samuelpoiraud/robot/_Hard/2014_IHM/led_boutons_ihm.JPG

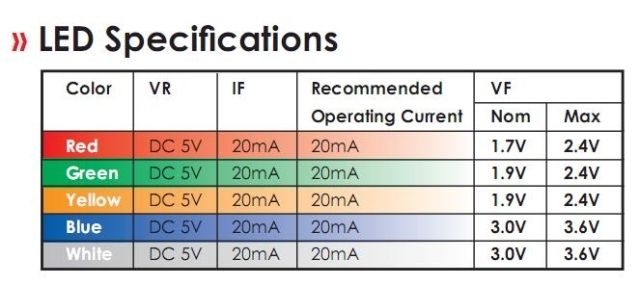
_Hard/2014_IHM/led_boutons_ihm.JPG
