samuelpoiraud/robot/_Hard/2011-2012/2012_CARTES_PDF/EMETTEUR_IR_US.PDF

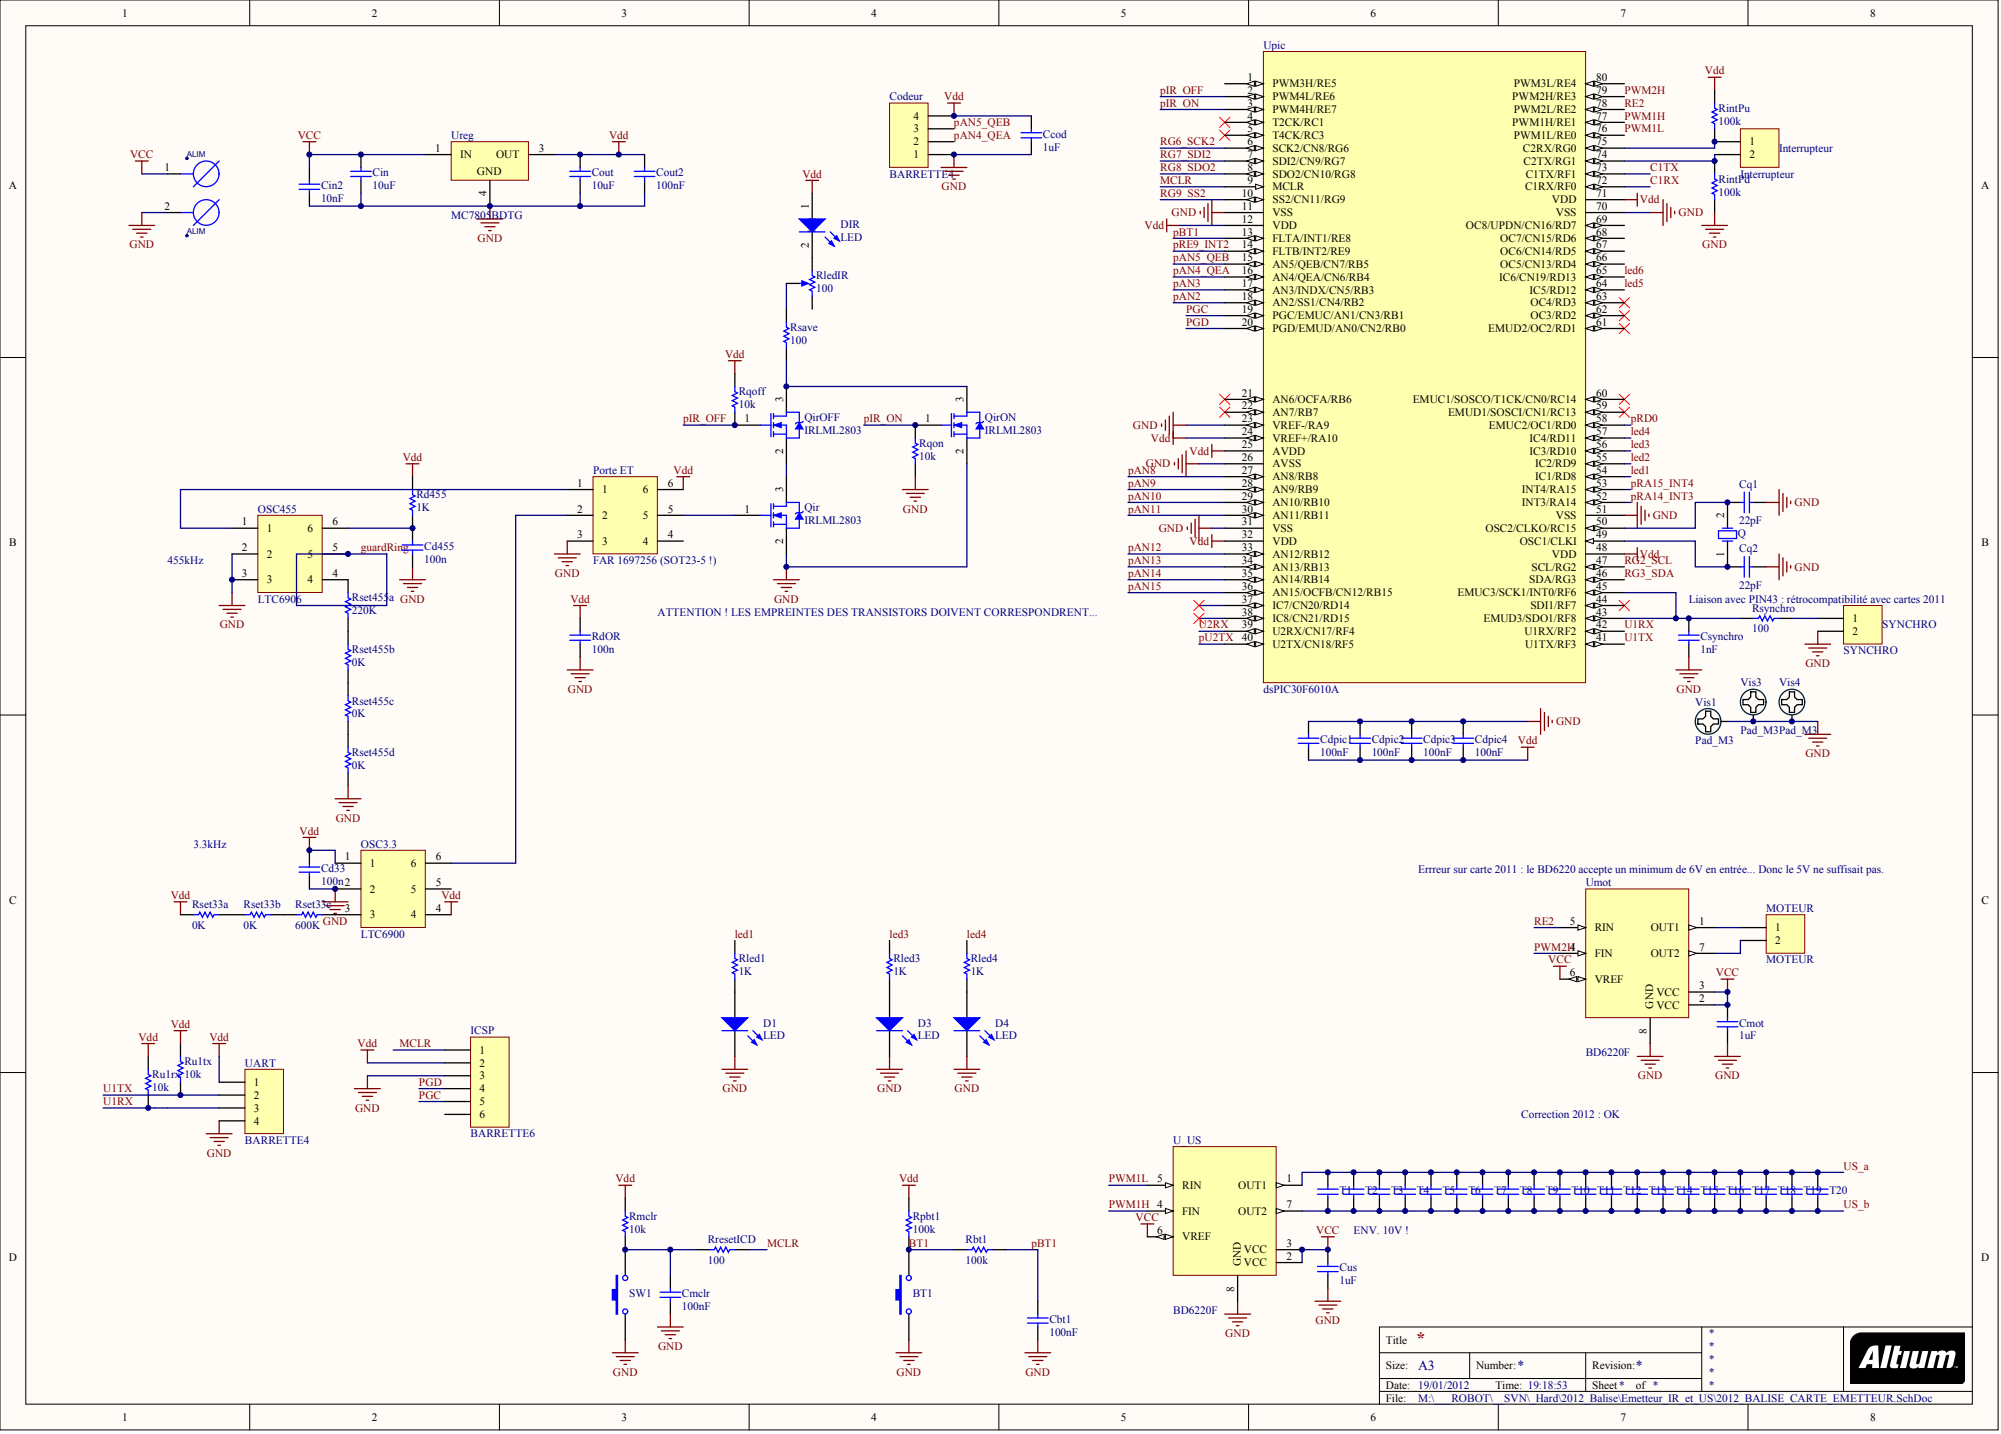
[picture p11: page 1]

Liaison avec PIN43 : rétrocompatibilité avec cartes 2011

ATTENTION ! LES EMPREINTES DES TRANSISTORS DOIVENT CORRESPONDRENT...

Errreur sur carte 2011 : le BD6220 accepte un minimum de 6V en entrée... Donc le 5V ne suffisait pas.

* Title | * * * * *

A3 Size: | * Number: | * Revision:

Date: 19/01/2012 Time: 19:18:53 | | Sheet * of *

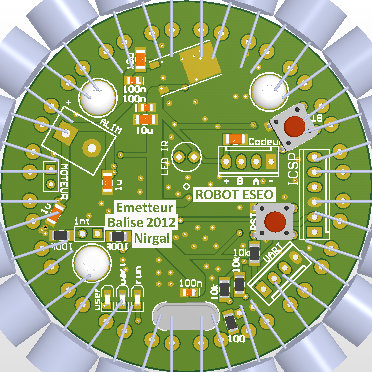
[picture p12: figure]
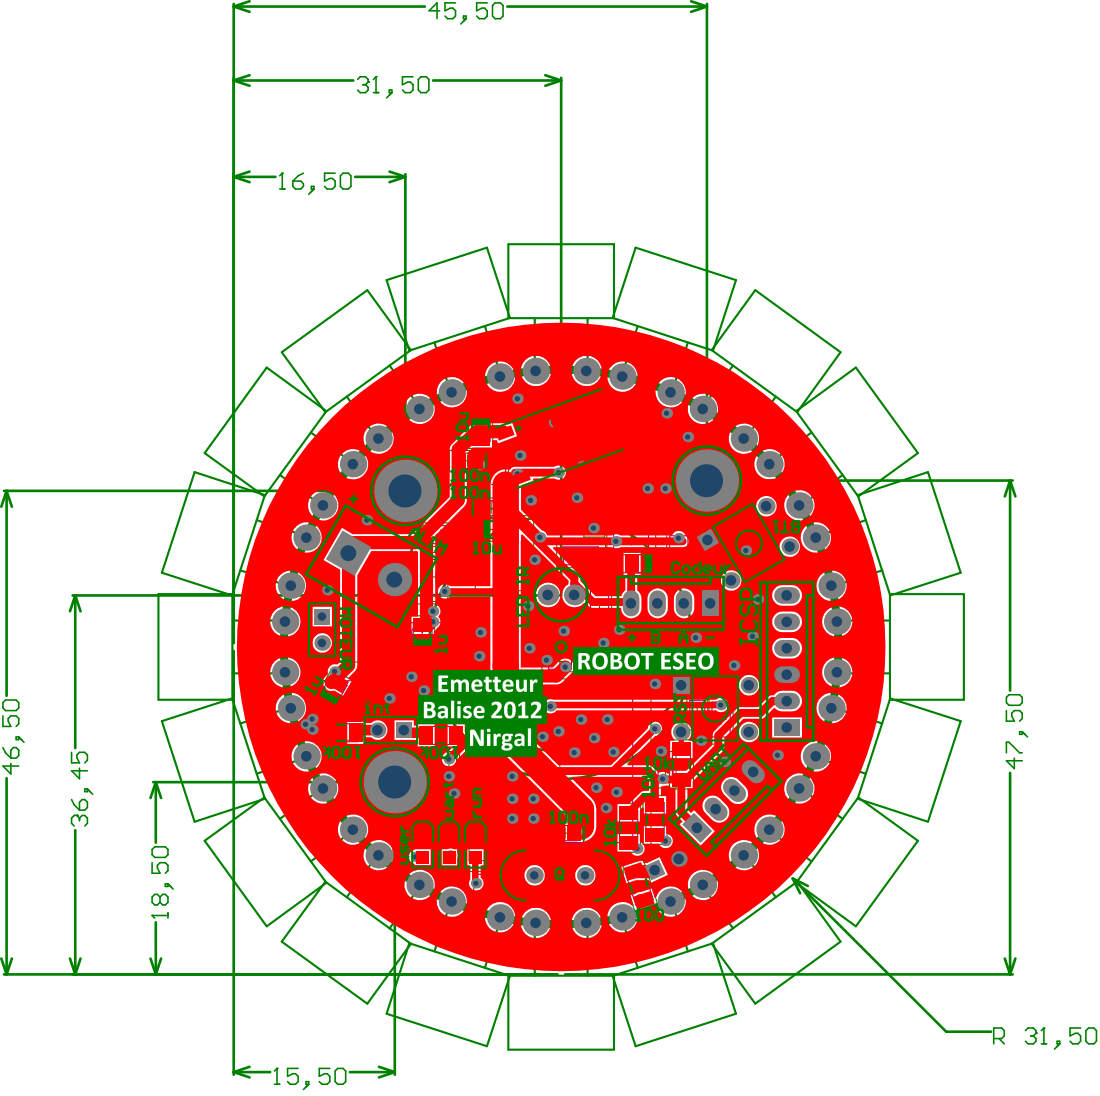
[picture p13: page 3]

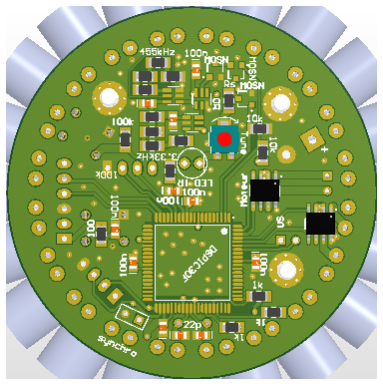
[picture p14: figure]
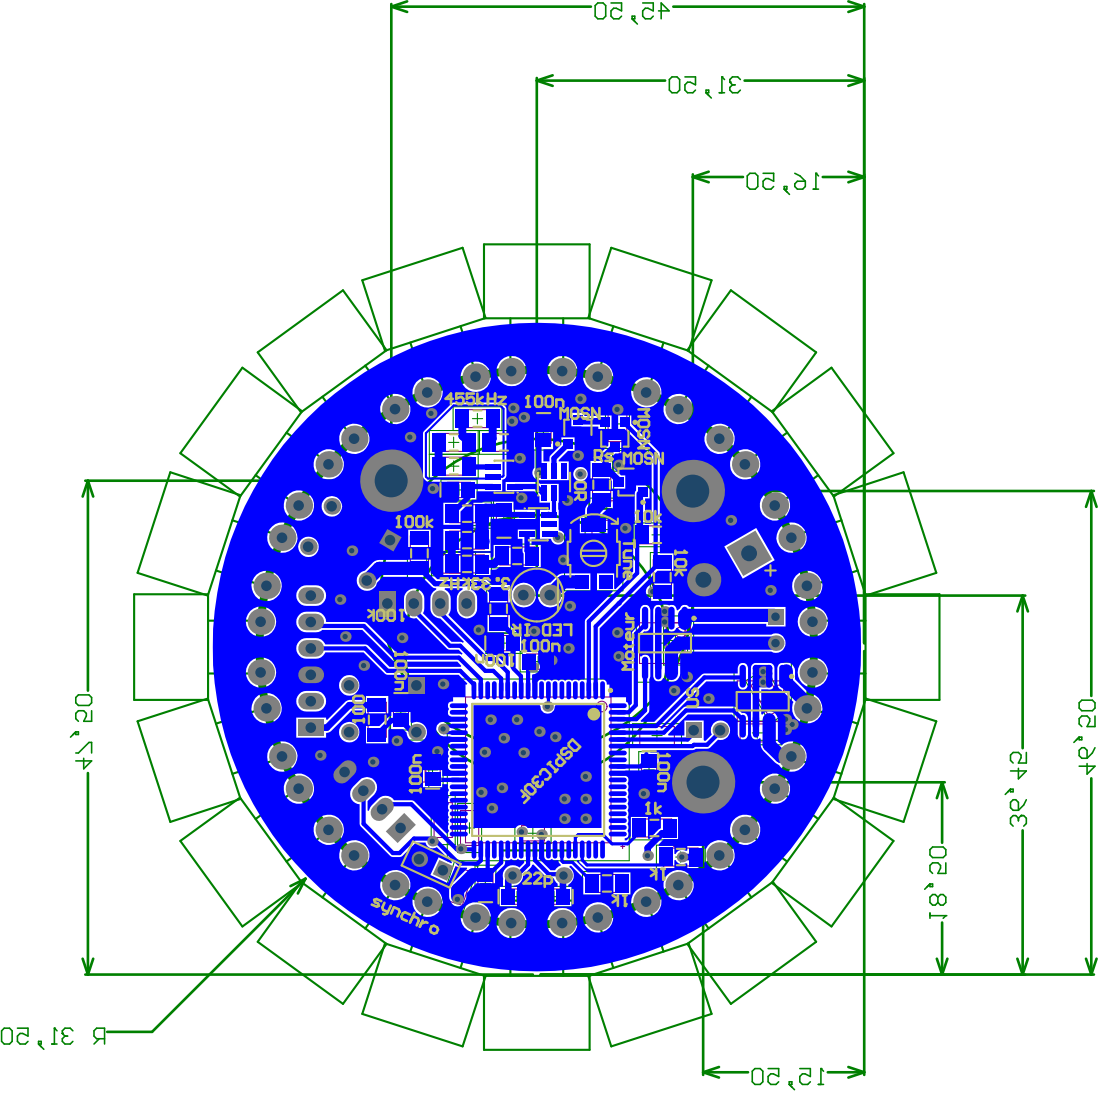
[picture p15: page 5]

Designator | Description | Comment | VALUE | Footprint | Quantity
ALIM | | ALIM | | BORNIER2 | 1
BT1, SW1 | Switch tactil 6mm x 6mm Vertical | SW_Pushbutton_6x6 mm_Vertical | | Switch 6x6 Vertical | 2
Cbt1, Cdpic1, Cdpic2, Cdpic3, Cdpic4, Cmclr, Cout2 | Capacitor | 100nF | | C0805_N | 7
Ccod, Cmot, Cus | Capacitor | 1uF | | C1206_N | 3
Cd33, Cd455, RdORCapacitor | | 100n | | C0805_N | 3
Cin, Cout | Capacitor | 10uF | | C1206_N | 2
Cin2 | Capacitor | 10nF | | C0805_N | 1
Codeur, UART | Header, 4-Pin | BARRETTE4 | | HE14_4 | 2
Cq1, Cq2 | Capacitor | 22pF | | C0805_N | 2
Csynchro | Capacitor | 1nF | | C0805_N | 1
D1, D3, D4 | Typical LED | LED | | LED_0805 | 3
DIR | Typical RED, GREEN, YELLOW, AMBER GaAs LED | LED | | LED5 | 1
ICSP | Header, 6-Pin | BARRETTE6 | | HE14_6 | 1
Interrupteur | Header, 2-Pin | Interrupteur | | HEADER2 | 1
MOTEUR | Header, 2-Pin | MOTEUR | | HEADER2 | 1
OSC3.3 | Header, 3-Pin, Dual row | LTC6900 | | SOT23-6 | 1
OSC455 | Header, 3-Pin, Dual row | LTC6906 | | SOT23-6 | 1
Porte ET | Header, 3-Pin, Dual row | FAR 1697256 (SOT23-5 !) | | SOT23-6 | 1
Q | Crystal Oscillator | QU | | HC49US | 1
Qir, QirOFF, QirON | HEXFET Power MOSFET | IRLML2803 | | SOT-23 | 3

Rbt1, RintPd, RintPu,

Q | Crystal Oscillator | QU | HC49US | 1
Qir, QirOFF, QirON | HEXFET Power MOSFET | IRLML2803 | SOT-23 | 3
Rbt1, RintPd, RintPu, Rpbt1 | Resistor | 100k | R1206_N | 4
Rd455, Rled1, Rled3, Rled4 | Resistor | 1K | R1206_N | 4
RledIR | Trimmer monotour, Bourns,serie 3314P | 100 | Trimmer_Bourns_331 4G | 1
Rmclr, Rqoff, Rqon, Ru1rx, Ru1tx | Resistor | 10k | R1206_N | 5
RresetICD, Rsave, Rsynchro | Resistor | 100 | R1206_N | 3
Rset33a, Rset33b, Rset455b, Rset455c, Rset455d | Resistor | 0K | R1206_N | 5
Rset33c | Resistor | 600K | R1206_N | 1
Rset455a | Resistor | 220K | R1206_N | 1
SYNCHRO | Header, 2-Pin | SYNCHRO | HEADER2 | 1
T1, T2, T3, T4, T5, T6, T7, T8, T9, T10, T11, T12, T13, T14, T15, T16, T17, T18, T19, T20 | Capacitor | 40kHz | MA40S4R/S Transducteur US - 3D haut de carte | 20
Upic | High-Performance, 16-bit Digital Signal Controllers | dsPIC30F6010A | TQFP80_N | 1
Ureg | Three-Terminal Positive Voltage Regulator | MC7805BDTG | 369A-13 | 1
U_US, Umot | H Bridge - 2A | BD6220F | SO8_N | 2
Vis1, Vis3, Vis4 | Vis M3 X6mm_TORXPad_M 3 | | M3x6mm | 3
