samuelpoiraud/robot/1_Propulsion/Documentation/UnivAngers_JDA_small.pdf

## Moulifal & Teflex : vainqueurs d’Eurobot 2013

Vincent Cueille¹,3

, Philippe Lucidarme¹,2,3
et toute l’equipe ´

1,3

1
IUT d’Angers, 4 boulevard Lavoisier, 49016 Angers - France 2LISA, Universite d’Angers, 62 avenue Notre Dame du Lac, 49000 Angers - France ´ 3Robot Campus, 36 rue Georges Crousil, 49000 Angers - France

philippe.lucidarme@univ-angers.fr

## Resume´

La coupe de France de robotique est une competition qualificative pour la finale internationale ´
Eurobot. Une particularite de ce concours r ´ | eside dans le fait que le r ´ | eglement change chaque ann ` | ee´
pour faciliter l’acces` a de nouvelles ` | equipes. Pour honorer les vingt ans de la coupe de France, ´
le theme 2013 ` | etait ”Happy Birthday”. Chaque ´ | equipe pouvait concevoir un ou deux robots qui ´
devaient eteindre des bougies, ouvrir des cadeaux, mettre des cerises sur le g ´ | ateau et construire ˆ
des pyramides de verres symbolisees respectivement par : des balles de tennis, des planchettes ´ | a`
basculer, des balles de ping-pong et des cylindres en plastique. Ce document illustre les capacites´
des deux robots conc¸us et fabriques par les ´ | etudiants de l’Universit ´ | e d’Angers : capacit ´ | es de ´
localisation et relocalisation (Filtre de Kalman etendu), capacit ´ | es de d ´ | eplacement (planification de ´
trajectoire par graphe de visibilite), capacit ´ | es strat ´ | egiques (choix de la meilleure action ´ | a r ` ealiser ´
en fonction du contexte) et capacites de coordination (collaboration entre les robots). ´

Mots-cles´ : robotique, Eurobot, filtres de Kalman etendus, localisation ´

## 1 Introduction

La coupe de France de robotique est une competition qualificative pour la finale internationale Eu- ´
robot. Nee en 1993 sous le nom de coupe E=m6, en lien avec l’ ´ | emission pr ´ | esent ´ | ee par Mac Lesguy, ´
elle devient tres vite une des plus prestigieuses comp ` | etitions de robotique en France et ´ | a l’ ` etranger. ´
Une particularite de ce concours est que le r ´ | eglement change chaque ann ` | ee pour permettre l’acc ´ | es`
a de nouvelles ` | equipes. Pour honorer les vingt ans de la comp ´ | etition, le th ´ | eme 2013 ` | etait ”Happy ´
Birthday”, chaque equipe pouvait concevoir un ou deux robots autonomes qui devaient r ´ | ealiser ´
differentes actions impos ´ | ees autour du th ´ | eme de l’anniversaire. L’universit ` | e d’Angers s’est en- ´
gagee dans cette comp ´ | etition au travers d’activit ´ | es propos ´ | ees dans le cadre du club robotique ´
(Robot Campus - association loi 1901 ). Bien qu’il s’agisse d’un projet pedagogique et dont la ´
vocation premiere n’est pas orient ` | ee vers la recherche, notre ´ | equipe est toujours soucieuse de pro- ´
poser des technologies innovantes. Convaincus de la necessit ´ | e de localiser les robots de fac¸on ´
absolue sur le terrain, nous avons mis en oeuvre un systeme de localisation par filtre de Kalman `
etendu. Notre objectif ´ | etait non seulement de prouver la faisabilit ´ | e d’un tel syst ´ | eme tout en respec- `
tant les contraintes imposees par le r ´ | eglement, mais aussi et surtout, de montrer que ce syst ´ | eme `
pouvait etre comp ˆ | etitif. ´
Le papier sera structure de la fac¸on suivante : la premi ´ | ere partie expliquera bri ` | evement le r ` | eglement ´
2013 et detaillera les points qui concernent la localisation. La seconde partie pr ´ | | | | esentera les ´
techniques utilisees classiquement pour la localisation au travers d’un historique technique de ´
la competition. Nous exposerons ensuite l’architecture des robots avant de d ´ | etailler notre syst ´ | eme `
de localisation.

## 2 Eurobot 2013

Pour feter les 20 ans de la coupe de France de robotique, le r ˆ | eglement de l’ ´ | edition 2013 est ´ | elabor ´ | e´
autour du theme ` | ”joyeux anniversaire”. Les matchs de 90 secondes se deroulent sur une aire de ´
jeu de 3x2m sur laquelle deux robots s’affrontent simultanement (figure 1). La comp ´ | etition se ´
deroule dans un esprit amical et sportif et les ´ | equipes d’arbitrage sont tr ´ | es attach ` | ees au respect de ´
l’adversaire; toute action visant a nuire au robot adverse est p ` | enalis ´ | ee. Il est notamment interdit de ´
percuter ou de bloquer l’adversaire. Chaque equipe peut concevoir un ou deux robots autonomes; ´
un robot principal dont le perim ´ | etre peut atteindre jusqu’ ` | a 1,4m et un robot secondaire avec un `
perim ´ | etre maximal de 0.8m pendant le match. Chaque robot se voit attribu ` | e une couleur (rouge ou ´
bleue) avant le debut du match qui d ´ | efiniera son c ´ | otˆ e de d ´ | epart et les ´ | elements de jeu avec lesquels ´
il devra interagir. Ces deux robots doivent se coordonner pour realiser un certain nombre d’actions ´ tout en evitant l’adversaire. ´

### 2.1 Actions

L’el´ ement principal du terrain est un g ´ | ateau de 0,5m de rayon. Sur ce dernier se trouvent 20 ˆ
bougies symbolisees par des balles de tennis mont ´ | ees sur des cylindres en PVC que les robots ´
doivent eteindre en enfonc¸ant la balle dans un tube. Chaque bougie rapporte 4 points ´ | a son ` | equipe. ´
Sur la longueur opposee au g ´ | ateau se trouvent des planches articul ˆ | ees que les robots doivent faire ´
basculer et qui symbolisent des cadeaux (4 points chacun). Les bougies et les cadeaux sont colores´ (rouges ou bleus) et seule l’equipe qui s’est vue attribuer leur couleur peut interagir avec ces ´ el´ ements. En revanche, au milieu du terrain se trouvent 12 verres et ces derniers appartiennent ´ aux deux equipes qui doivent en ramener un maximum dans leur camp. La position initiale des ´ verres est fixe et connue. Chaque verre rapporte 4 points mais un bonus important est accorde aux ´
equipes qui r ´ | eussissent ´ | a empiler les verres puisque le deuxi ` | eme verre de la pile compte double, le `
troisieme triple et ainsi de suite. La derni ` | ere action consiste ` | a ramasser des cerises, symbolis ` | ees ´
par des balles de ping-pong situees dans des assiettes et ´ | a les lancer dans un r ` | eceptacle situ ´ | e en ´
haut du gateau. Chaque cerise rapporte 2 points, mais le score des cerises peut ˆ | etre divis ˆ | e par deux ´
si l’equipe concern ´ | ee a lanc ´ | e une cerise de couleur noire dans son r ´ | eceptacle. A la fin du match un ´
bonus est accorde aux ´ | equipes qui r ´ | eussissent ´ | a gonfler un ballon dans les 10 secondes qui suivent `
la fin de l’epreuve. ´

### 2.2 Balises

Chaque annee les ´ | equipes sont autoris ´ | ees ´ | a placer des balises sur le terrain. La fabrication des `
balises est laissee au soin des ´ | equipes et il existe deux types de balises: fixes et adverses. ´
- Les balises fixes se placent sur des supports situes sur la largeur du terrain. Chaque ´ | equipe ´
peut placer au plus trois balises fixes : deux aux coins delimitant son aire de d ´ | epart et une ´
situee au milieu de la largeur de la zone adverse. Les balises doivent ´ | etre autonomes et ˆ
les dimensions ne doivent pas depasser un parall ´ | el´ epip ´ | ede de 80x80x160mm. Dans l’esprit `
des redacteurs du r ´ | eglement, ces balises servent ´ | a localiser les robots mais il arrive que leur `
utilisation soit detourn ´ | ee de fac¸on ing ´ | enieuse. ´
- Les balises adverses se trouvent sur les robots de l’equipe oppos ´ | ee. En effet, chaque robot ´
doit etre ˆ | equip ´ | e d’un support de balise situ ´ | e´ a 0,43m du sol qui sert ` | a placer le syst ` | eme `
conc¸u par l’equipe adverse. Chaque balise doit tenir dans un cube de 80mm de c ´ | otˆ e et ne ´
doit pas contenir d’el´ ements pouvant nuire au bon fonctionnement du robot sur lequel elle ´ est placee. ´

Cette presentation succinte du r ´ | eglement n’est pas exhaustive, pour plus de d ´ | etails le lecteur ´
est invite´ a se r ` | ef´ erer ´ | a [1]. `

## 3 Etat de l’art des systemes de localisation `

3.1 Systemes odom ` | etriques ´
Depuis 20 ans, la localisation est une des preoccupations majeures pour la plupart des ´ | equipes. Les ´
premieres ann ` | ees, la localisation n’ ´ | etait pas crutiale car les organisateurs pr ´ | evoyaient des ´ | el´ ements ´
aidant les robots a se situer sur la table, typiquement une ligne peinte sur le terrain. En 1997, le `
reglement a ` | evolu ´ | e et est apparue l’aire de jeu de 3x2m telle que nous la connaissons aujourd’hui ´
(figure 1).

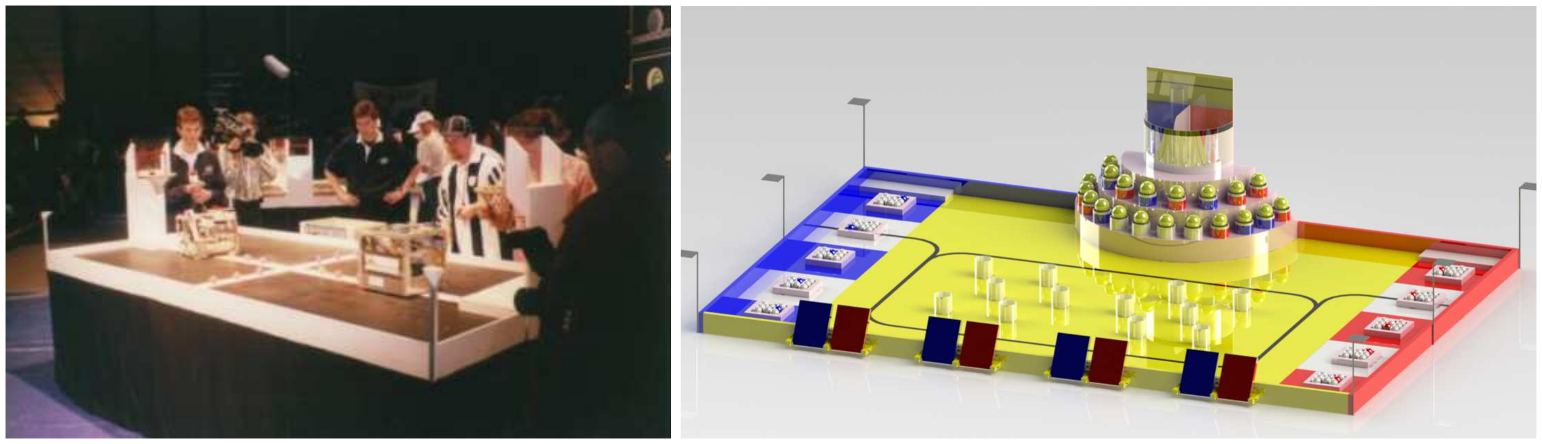
[picture p48: figure]

Figure 1: Aire de jeu de la coupe de France de robotique 1997 (a gauche, photo: Fribotte) et 2013 ` (a droite). `

De cette evolution est n ´ | ee l’importance de localiser pr ´ | ecis ´ | ement les robots. Les ´ | equipes ont ´
alors commence´ a utiliser des codeurs incr ` | ementaux mont ´ | es sur les arbres moteurs. En 1998, ´
l’equipe de l’IUT de Ville d’Avray optimise et exploite ´ | a la perfection ce syst ` | eme avec un robot `
particulierement rapide. En remportant haut la main cette ` | edition, ils apportent la preuve que la lo- ´
calisation est un el´ ement de performance d ´ | ecisif. L’utilisation de l’odom ´ | etrie va se g ´ | en´ eraliser les ´
annees suivantes au sein de la comp ´ | etition. Toutefois, la limitation principale de ce syst ´ | eme reste `
la derive et pour pallier ´ | a ce probl ` | eme, les robots se recallent sur les bordures pendant les matchs. `
Un deuxieme probl ` | eme inh ` | erent sont les glissements de roues lors de collisions entre robots qui ´
peuvent amener des erreurs de localisation. En 2001, l’equipe Minitech innove en utilisant pour ´
la premiere fois des roues incr ` | ementales ind ´ | ependantes des roues motrices. La figure 2 montre ´
un exemple de mise en oeuvre par l’equipe ´ | µART (Micro Alsace Robot Team). Sans resoudre les ´
problemes de d ` | erive inh ´ | erents ´ | a l’odom ` | etrie, ce syst ´ | eme permet de r ` | eduire de fac¸on significative ´
l’erreur de positionnement et immunise davantage la localisation vis a vis des collisions. Bien `
que les equipes aient fortement optimis ´ | e les syst ´ | emes odom ` | etriques, cette solution seule apparait ´
fragile vis a vis des al ` | eas qui peuvent survenir en cours de match. Aujourd’hui encore, il arrive ´
frequemment que des robots se perdent sur le terrain et, sans syst ´ | eme de localisation globale, ces `
robots n’ont aucune chance de se relocaliser.

### 3.2 Balises

En 1997, avec l’apparition de l’aire de jeu contemporaine, des supports de balises ont egalement ´
et´ e introduits dans le r ´ | eglement (visibles sur la figure 1). Beaucoup d’ ` | equipes ont tent ´ | e d’utiliser ´
ces supports pour localiser leurs robots, mais assez peu de systemes ont ` | et´ e finalis ´ | es. La difficult ´ | e´
principale reside dans la conception des balises et la fusion de donn ´ | ees avec l’odom ´ | etrie. Rares ´

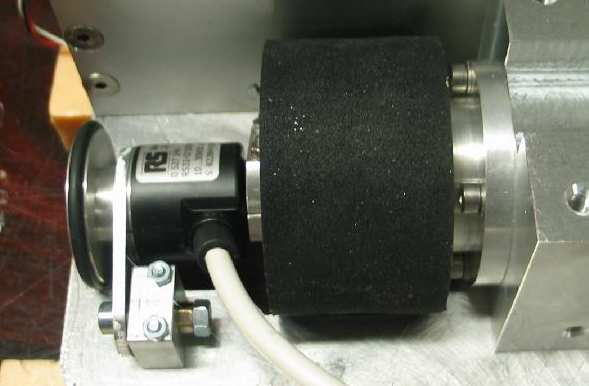
[picture p49: figure]

Figure 2: roue motrice associee´ a une roue incr ` | ementale ind ´ | ependante (photo: ´ | µart).
sont les equipes ayant r ´ | eussit ´ | a mettre au point les deux approches de fac¸on performante ([2] et `
[3]).

## 4 Architecture

Le reglement permet l’utilisation d’un ou deux robots mais augmenter le nombre de robots est ´
un avantage strategique et un gage de fiabilit ´ | e. Notre ´ | equipe a donc fabriqu ´ | e deux robots de ´
tailles differentes conform ´ | ement au r ´ | eglement. Le robot principal et le robot secondaire ont ` | et´ e´
respectivement baptises Moulifal et Teflex, un clin d’oeil aux c ´ | el´ ebres marques d’ ´ | electrom ´ | enager. ´
Les robots sont construits sur la base de chassis en aluminium conc¸us et fabriqu ˆ | es´ a l’universit ` | e´
d’Angers (figure 3). Le chassis ˆ | a roues diff ` | erentielles ne comporte pas de codeurs incr ´ | ementaux ´
independants et est motoris ´ | e gr ´ | ace ˆ | a deux ensembles codeurs, moteurs cc et r ` | educteurs. ´

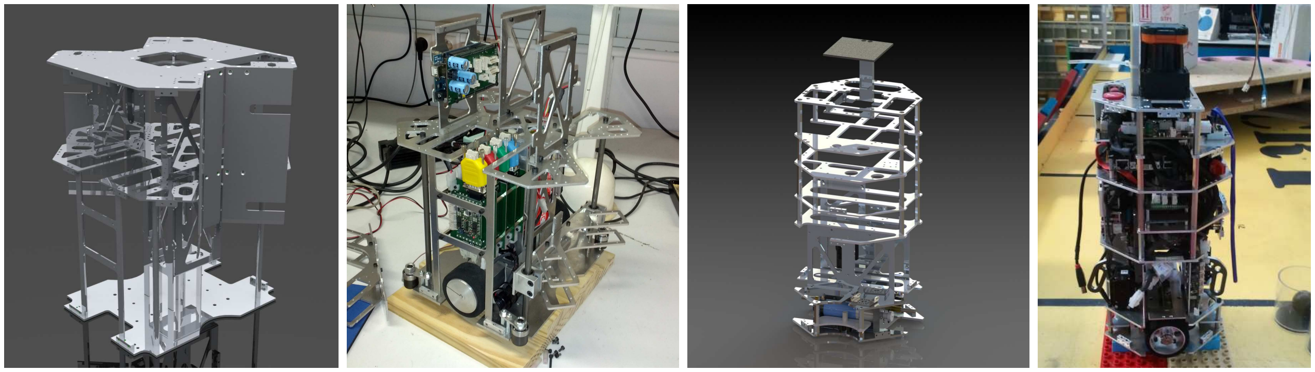
[picture p50: figure]

Figure 3: CAO des chassis et robots en cours d’assemblage (robot principal a gauche et robot ` secondaire a droite). `

Sur les cinq actions proposees par le r ´ | eglement, quatre peuvent ` | etre r ˆ | ealis ´ | ees par les robots : ´
empilage des verres, cadeaux, bougies et gonflage du ballon. Le lancer de balles de ping-pong a
et´ e jug ´ | e peu rentable vis ´ | a vis de la complexit ` | e et de l’encombrement d’un syst ´ | eme de ramassage, `
de tri et de tir.

### 4.1 Empilage des verres

Le robot principal possede deux pinces mont ` | ees sur des ascenseurs verticaux ( ´ | a l’avant et ` | a`
l’arriere) qui permettent de saisir les verres et de les monter dans un compartiment de maintien ` grace ˆ a deux volets. La figure 4 illustre la saisie et l’empilage des verres. `

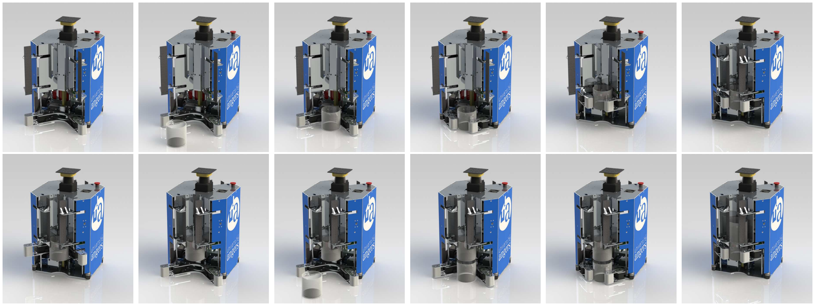
[picture p51: figure]

Figure 4: sequence de ramassage et empilage des verres. ´

### 4.2 Bougies et cadeaux

Le robot principal est equip ´ | e d’un bras ´ | a trois degr ` | es de libert ´ | e (figure 5) qui permet d’ ´ | eteindre les ´
bougies avec pour organe terminal un capteur de couleur. La sequence d’extinction est constitu ´ | ee´
de deux phases : une premiere phase durant laquelle le robot vient v ` | erifier la couleur de la bougie ´
et une seconde phase d’appui. Le bras peut egalement servir ´ | a l’ouverture des cadeaux. `

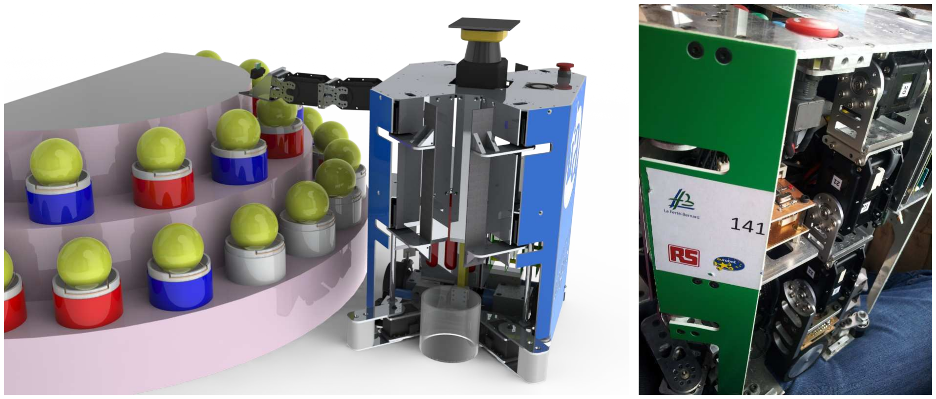
[picture p52: figure]

Figure 5: CAO du bras en action (a gauche) et vue de d ` | etail du bras rang ´ | e dans le robot ( ´ | a droite). `

### 4.3 Robot secondaire et communication

Afin de minimiser les temps de developpement, l’architecture du robot secondaire est fortement ´
inspiree de celle du robot principal. Etant donn ´ | e le faible encombrement autoris ´ | e par le r ´ | eglement, `
le robot secondaire n’est conc¸u que pour 3 actions. La principale est l’ouverture des cadeaux
grace ˆ | a un bras ` | a un degr ` | e de libert ´ | e. Le robot poss ´ | ede ` | egalement deux doigts, situ ´ | es´ a l’avant `
et a l’arri ` | ere, permettant la saisie d’un verre chacun. Enfin, une pompe ` | a palettes est utilis ` | ee´
pour gonfler le ballon en fin de match. Les deux robots communiquent via des modules XBee (protocole ZigBee IEEE 802.15.4). Les informations echang ´ ees sont : horodatage de la trame, ´

position courante du robot, identifiant de la strategie, couleur jou ´ | ee et ´ | etat des diff ´ | erentes actions ´
(cadeaux, bougies, etc).

### 4.4 Localisation et detection de l’adversaire ´

Sur chaque robot est monte un LIDAR Hokuyo UTM-30LX qui permet de d ´ | etecter la position des ´
balises a une fr ` | equence de 40Hz. Ces LIDAR renvoient aux PC l’angle, la distance et l’intensit ´ | e´
lumineuse. Les balises sont consituees d’un tube en PVC de 80mm de diam ´ | etre envelopp ` | e dans ´
une bande retro-r ´ | efl´ echissante. Cela permet en partie de faciliter la d ´ | etection des balises gr ´ | ace ˆ | a`
une intensite rec¸ue ´ | elev ´ | ee et de diminuer grandement le risque de fausses reconnaissances. La ´
detection et localisation de l’adversaire se fait ´ | egalement par le biais des LIDAR. La d ´ | etection de ´
l’adversaire a une double utilite : ´
- Elle permet, en amont des deplacements, de planifier une trajectoire libre de collision. La ´
planification est realis ´ | ee gr ´ | ace ˆ | a un graphe de visibilit ` | e introduit par T. Ozano-Perez and ´
M.A. Wesley en 1979 [7]. Un exemple de planification est present ´ | e sur la figure 6. Les ´
obstacles incluent des el´ ements fixes (g ´ | ateau, bordures et buffets) et mobiles (piles de verres, ˆ
robots adverses et robot secondaire). Il est a noter que les obstacles ins ` | er´ es dans le graphe ´
sont dilates du rayon du cercle englobant la projection verticale du robot afin de garantir ´ la faisabilite de la trajectoire. Une limitation de cette approche est l’absence d’adaptation ´ de la planification aux obstacles mobiles. Si un autre robot venait a croiser la trajectoire `
pendant le deplacement cette derni ´ | ere ne serait pas r ` | eajust ´ | ee, d’o ´ | u l’utilit ` | e d’une d ´ | etection ´
secondaire.
- Les robots sont equip ´ | es de capteurs de proximit ´ | e ultrasons plac ´ | es´ a l’avant et ` | a l’arri ` | ere. `
Ces capteurs permettent de detecter localement la pr ´ | | esence d’un obstacle et de stopper un ´
deplacement en cas de collision imminente. Une fois le robot ´ | a l’arr ` | et, une nouvelle trajec- ˆ
toire prenant en compte les modifications de l’environnement est planifiee. ´

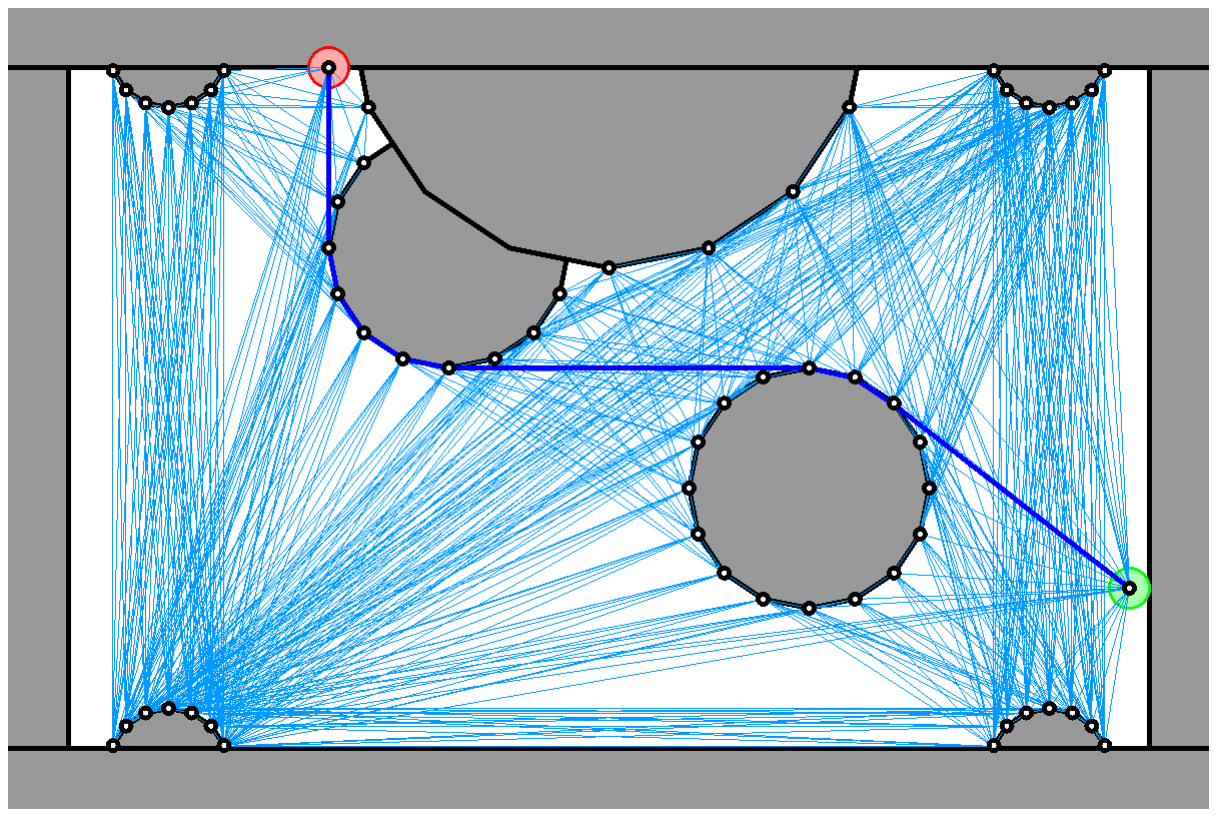
[picture p53: figure]

Figure 6: exemple de graphe de visibilite et trajectoire planifi ´ | ee associ ´ | ee. ´

### 4.5 Vue d’ensemble de l’architecture

L’el´ ement principal du robot est un PC embarqu ´ | e (processeur Atom Z530 1.6GHz ) qui g ´ | ere la `
localisation et les actions de haut niveau. Il dialogue via USB avec des cartes Arduino Mega (processeur ATmega 2560) qui pilotent les asservissements et les actions de plus bas niveau (gestion des ascenseurs, des bras, des commandes moteurs, etc). Les dialogues de bas niveaux se font via
differents bus (I ´ | 2C, RS232 et RS485). L’architecture est synthetis ´ ee sur la figure 7 et le tableau 1 ´
rassemble les ref´ erences des principaux ´ | el´ ements constitutifs de chaque robot. ´

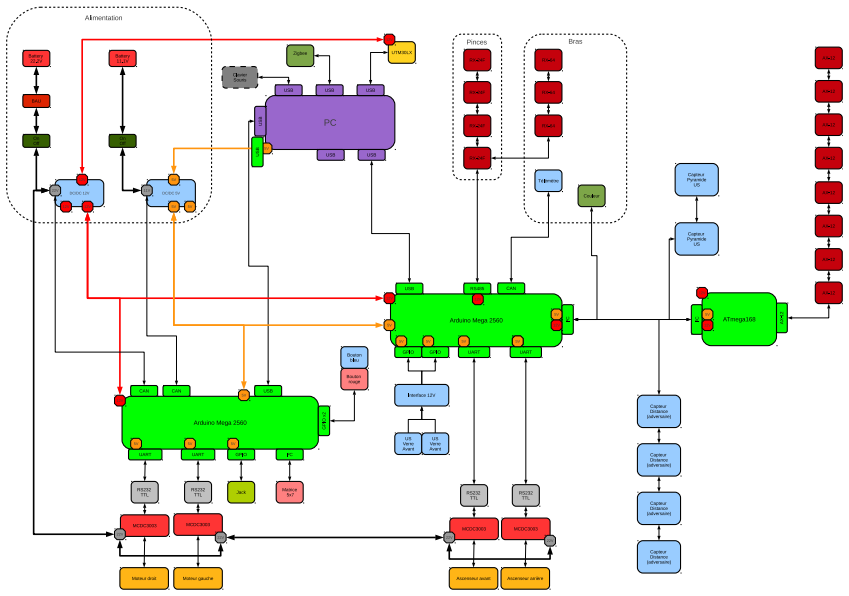
[picture p54: figure]

Figure 7: vue gen´ erale de l’architecture du robot Moulifal. ´

| Moulifal | Teflex
Moteur | Faulhaber 2657 012 CR | Faulhaber 2657 012 CR
Codeur | Faulhaber IE2-1024 | Faulhaber IE2-1024
Reducteur ´ | Faulhaber26/1S 14:1 | Faulhaber26/1S 3,71:1 + 3,57:1
PC embarque´ | Kontron pITX-SP | Kontron pITX-SP
Processeur principal | Intel Atom Z530 1.6GHz | Intel Atom Z530 1.6GHz
Systeme d’exploitation ` | Ubuntu minimal 12.04 LTS | Ubuntu minimal 12.04 LTS
Processeurs annexes | ATmega 2560 (x2) | ATmega 2560
Localisation | LIDAR Hokuyo UTM-30LX | LIDAR Hokuyo UTM-30LX
Batteries puissance | Robbe LiPo 6S 3300mAh | Robbe LiPo 6S 3300mAh
Batteries electronique ´ | Robbe LiPo 3S 3200mAh | Robbe LiPo 6S 3200mAh
Detecteur d’obstacles ´ | Robot-Electronics SRF235 (x4) | Robot-Electronics SRF235 (x2)
Detection des verres ´ | Schneider XXV18B1PAL2 | Schneider XXV18B1PAL2
Motorisation du bras | Dynamixel RX-64 (x3) | Dynamixel RX-64(x1)
Capteur de couleur | Hamamatsu (S6986) | -
Motorisation de la pince | Dynamixel RX-24F (x4) | -
Motorisation des volets | Dynamixel AX-12+ (x8) | -
Motorisation des doigts | - | Dynamixel RX-64(x2)
Gonflage du ballon | - | Pompe Thomas G12/07-N LC2
Table 1: specification des ´ | el´ ements constitutifs de chaque robots. ´

### 4.6 Architecture logicielle

L’ensemble des logiciels ont et´ e d ´ evelopp ´ | es sous Qt-Creator, y compris la programmation des ´
differents microcontr ´ | oleurs (ATmega168 et ATmega2560). Pour ces derniers un template Qt a ˆ | et´ e´
cre´e et s’appuie sur les librairies AVR-GCC et Arduino. L’application du PC est mono-processus ´
et composee de diff ´ | erentes machines ´ | a` etats qui supervisent les actions du robot. Il est ´ | a noter qu’au `
demarage du robot, le programme effectue une v ´ | erification de l’ensemble des ´ | el´ ements mat ´ | eriels ´
et logiciels (actionneurs, capteurs, bus de communication, espace memoire, etc). Si une erreur est ´
detect ´ | ee, l’op ´ | erateur en est inform ´ | e via un afficheur ´ | a LEDs et peut stopper l’initialisation du robot `

ou forcer le demarrage en acquitant l’erreur. Cette pr ´ | ecaution s’av ´ | ere ` | etre d’une double utilit ˆ | e.´
Bien sur elle permet de d ˆ | etecter une ´ | eventuelle d ´ | efaillance pendant la phase de pr ´ | eparation du ´
robot tout en evitant les erreurs de manipulation (typiquement un mauvais positionnement initial ´
du robot). Cette detection d’erreur permet ´ | egalement de diagnostiquer, en amont de la comp ´ | etition, ´
les problemes r ` | ecurrents qui sont g ´ | en´ eralement r ´ | ev´ elateurs d’un bug ou d’un d ´ | efaut mat ´ | eriel. ´

## 5 Filtre de Kalman etendu ´

L’innovation principale de ce projet reside dans l’utilisation d’un filtre de Kalman ´ | etendu pour lo- ´
caliser le robot. Le lecteur entendra evidemment le qualificatif novateur au sens de la comp ´ | etition ´
(exception faite de [4]) et non de l’etat de l’art puisque ce principe a ´ | et´ e propos ´ | e´ a la communaut ` | e´
il y a maintenant quelques dizaines d’annees ([5] et [6]). Cette section pr ´ | esente l’impl ´ | ementation ´
du filtre tel qu’il a et´ e utilis ´ | e pendant la comp ´ | etition. ´

### 5.1 Hypotheses et notations `

Voici les hypotheses et notations utilis ` | ees: ´
- Les parametres suivants sont suppos ` | es connus (ou estim ´ | es) et constants: ´ | e est la distance
entre le centre de chaque roue, rl est le rayon de la roue gauche, rr est le rayon de la roue droite et x

j
et y

j
sont les coordonnees de la balise ´ | j.
- La position initiale du robot est connue et notee´ X0.
- Le deplacement angulaire de chaque roue est mesurable. L’ ´ | equation 1 d ´ | efinie ´ | ∆qi
, le
deplacement angulaire ´ | elementaire de chaque roue. ´

∆qi =

∆qli
∆qri
(1)

ou:`

– ∆qli est le deplacement ´ | el´ ementaire de la roue gauche entre les instants ´ | i et i − 1,
– ∆qri est le deplacement ´ | el´ ementaire de la roue droite entre les instants ´ | i et i − 1.
- L’incertitude liee aux d ´ | eplacements du robot est suppos ´ | ee connue et constante. Elle est ´
definie par la matrice de covariance ´ | ΣU .

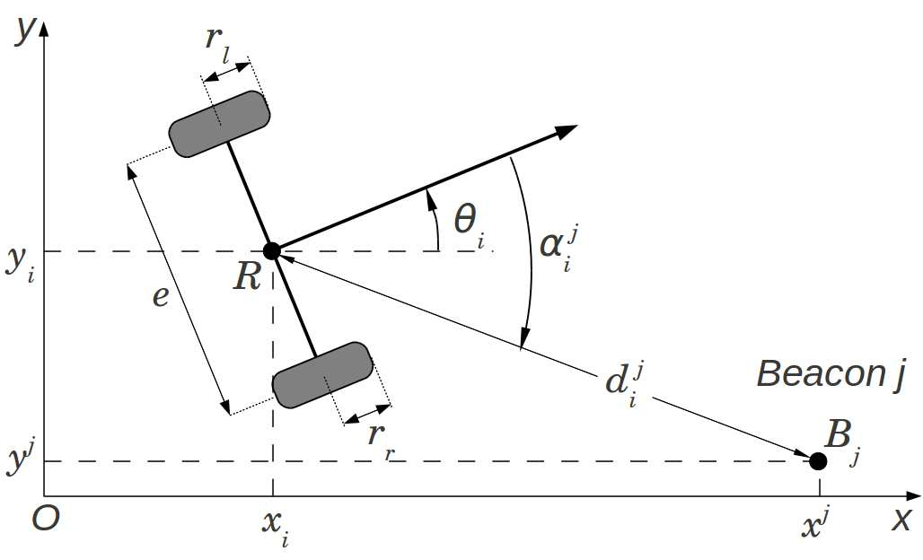
[picture p55: figure]

Figure 8: Modele du robot. `

- Le LIDAR permet d’obtenir d

j
et α

j qui sont respectivement la distance et l’angle relatifs a`
la balise j. L’incertitude liee´ a ces mesures est suppos ` | ee connue et constante. La matrice de ´
covariance associee est not ´ | ee´ Σ

b

### 5.2 Algorithme

L’etat du syst ´ | eme ` | a l’instant ` | i est donne par ´ | Xi =

xi
yi
θi

ou:`

- xi et yi sont les coordonnees cart ´ | esiennes du robot dans le r ´ | ef´ erentiel global centr ´ | e en ´ | O,
- θi est l’orientation du robot par rapport a l’axe x. `
L’algorithme 1 presente une vue d’ensemble de l’impl ´ | ementation du filtre. L’id ´ | ee ma ´ | ˆıtresse est la
mise a jour de l’ ` | etat du robot ´ | X grace ˆ | a l’odom ` | etrie (ligne 3) et du maintien de l’incertitude (ma- ´
trice de covariance P, etape 4) avant la prise en compte ´ | eventuelle des balises. Initialement, les ´
balises etaient consid ´ | er´ ees s ´ | equentiellement et individuellement, mais cette approche rendait dif- ´
ficile le reglage des matrices de covariance et induisait des oscillations dans l’ ´ | etat du robot. Nous ´
avons finalement concaten´ e les balises dans un unique vecteur, solution qui offre de meilleures ´
performances. Les etapes 5, 6, 7, 8 et 9 servent ´ | a la prise en compte de l’information li ` | ee aux ´
balises. L’etape 5 calcule l’innovation, c’est ´ | a dire la diff ` | erence entre l’information mesur ´ | ee et ´
l’information esper´ ee. L’ ´ | etape 6 calcule la covariance associ ´ | ee´ a l’innovation afin d’en d ` | eterminer ´
le gain de Kalman (etape 7). Le gain est une matrice (assimilable ´ | a un coefficient proportionnel `
dans le cas scalaire) permettant la fusion de donnees entre l’odom ´ | etrie et les balises. Finalement, ´
l’etat du robot et son incertitude associ ´ | ee sont mis ´ | a jour gr ` | ace au gain de Kalman pr ˆ | ec´ edemment ´
calcule ( ´ etapes 8 et 9). ´

Algorithm 1 Filtre de Kalman etendu ´
Require: ∆qi
, d

j
i

, α

j
i

, X0
1: X ← initial pose (X0).
2: for each time step i do
3: | Predict robot pose X via odometry
4: | Predict pose uncertainty P
5: | Compute innovation v for beacons
6: | Compute the innovation covariance S
7: | Compute the Kalman gain K
8: | Update state X with beacon j
9: | Update pose uncertainty P
10: end for

## 6 Conclusion et perspectives

L’objectif principal de notre projet etait de d ´ | emontrer la faisabilit ´ | e et la performance du syst ´ | eme `
de localisation ; objectif atteint puisque Moulifal et Teflex se sont hisses´ a la premi ` | ere place de la `
competition en r ´ | ealisant le doubl ´ | e national et international. Cette r ´ | eussite prouve donc que cette ´
solution est concurrentielle malgre sa jeunesse dans la comp ´ | etition. Elle pr ´ | esente bien s ´ | ur des ˆ
limitations tout en ouvrant un champ de persective interessant pour les ann ´ | ees futures. ´
La premiere limitation de ce syst ` | eme est le co ` | ut, la performance est fortement li ˆ | ee´ a la vitesse `
d’acquisition des balises qui impose des systemes on ` | ereux. La d ´ | emocratisation des LIDAR avec ´
l’apparition de systemes ` | a bas co ` | ut (robot aspirateur Neato) pourrait permettre la g ˆ | en´ eralisation ´
de ces systemes. `
La seconde limitation est la detection des balises, bien que ce point n’est pas ´ | et´ e abord ´ | e dans ce ´

document, il est essentiel au bon fonctionnement du filtre. Une balise peut etre masqu ˆ | ee ou mal ´
detect ´ | ee et une confusion avec le syst ´ | eme adverse est malheureusement possible. L’utilisation `
d’un test de coherence bas ´ | e sur la distance de Mahalanobis semble ´ | etre une piste int ˆ | eressante pour ´
diminuer le risque de fausse detection. ´
L’eventualit ´ | e d’un masquage prolong ´ | e des balises doit ´ | etre pris en compte et la d ˆ | erive du robot ´
peut etre diminu ˆ | ee en utilisant des codeurs incr ´ | ementaux ind ´ | ependants comme expos ´ | e dans l’ ´ | etat ´
de l’art, solution que nous n’avons pas retenue pour des raisons d’encombrement. Nous lui avons
pref´ er´ e un syst ´ | eme de relocalisation global qui, en cas de masquage prolong ` | e, force la position ´
du robot par triangulation des que les trois balises sont ` | a nouveau visibles. Ce syst ` | eme a ` | et´ e´
progamme peu de temps avant la comp ´ | etition et m ´ | eriterait diverses am ´ | eliorations. ´
La solution ultime reste l’utilisation d’un algoritmhe de SLAM (Simultaneous Localization and Mapping) qui permettrait de s’affranchir des balises en utilisant l’environnement naturel du robot.
L’universite d’Angers poss ´ | ede depuis 2011 la propri ` | et´ e intellectuelle d’un tel algorithme baptis ´ | e´
Slam-O-matic (cf. [8] pour plus de details). La tentation ´ | etait grande de l’utiliser d’autant qu’il ´
s’etait illustr ´ | e l’ann ´ | ee pr ´ | ec´ edente lors d’une autre comp ´ | etition (d ´ | efi CAROTTE). Le choix de ne ´
pas l’implementer est d ´ | uˆ a l’environnement fortement changeant de la comp ` | etition (arbitres qui ´
se deplacent autour de l’aire de jeu, autres robots mobiles et mouvements de foule). Au cours ´
des 22 matchs officiels que nous avons realis ´ | es, nous avons enregistr ´ | e toutes les donn ´ | ees brutes ´
des capteurs, dont les donnees LIDAR. Il nous est dor ´ | enavant ais ´ | e de simuler le comportement ´
de Slam-O-matic sur la base de donnees r ´ | eelles. Si le r ´ | esultat est concluant cette approche sera ´
peut-etre la cl ˆ | e d’une future victoire... ´

## References

[1] National Organizing Committees of the Eurobot, “Rules 2013 Eurobot”, http://www.planetesciences.org/robot/data/file/RulesEurbot2013.pdf, 2012.
[2] V. Durst, D. Hagel, J. Vander, M. Blaich, O. Bittel, “Designing an Omni-Directional Infrared Sensor and Beacon System for the Eurobot Competition”, Research and Education in Robotics - EUROBOT 2011, Communications in Computer and Information Science, Volume 161, pp 102-113, 2011.
[3] D. Obdrzalek, “Small autonomous robot localization system”, Research and Development (SCOReD), IEEE Student Conference on, pp 461-463, 2009.
[4] O. Bittel and M. Blaich, “Mobile Robot Localization Using Beacons and the Kalman Filter Technique for the Eurobot Competition”, Eurobot Conference’11, pp. 55-67, 2011.
[5] R. Chatila and J.-P Laumond, “Position Referencing and Consistent World Modeling for Mobile Robots”, in Proceedings of the IEEE International Conference on Robotics and Automation (ICRA), pp. 168-143, 1985.
[6] P. Bonnifait and G. Garcia, “Design and experimental validation of an odometric and goniometric localization system for outdoor robot vehicles”, IEEE Transactions on Robotics and Automation, Volume 14, Issue: 4, pp. 541-548, 1998.
[7] T. Ozano-Perez and M.A. Wesley, “An Algorithm for Planning Collision-Free Paths Among Polyhedral Obstacles”, Communications of ACM, Vol. 22, No.10, pp. 560-571, 1979.
[8] P. Lucidarme et S. Lagrange, “Slam-O-matic : SLAM algorithm based on global search of local minima”, Brevet FR1155625 depos ´ e le 24 juin 2011. ´
