samuelpoiraud/robot/_Hard/2015_CNC/draft2.pdf

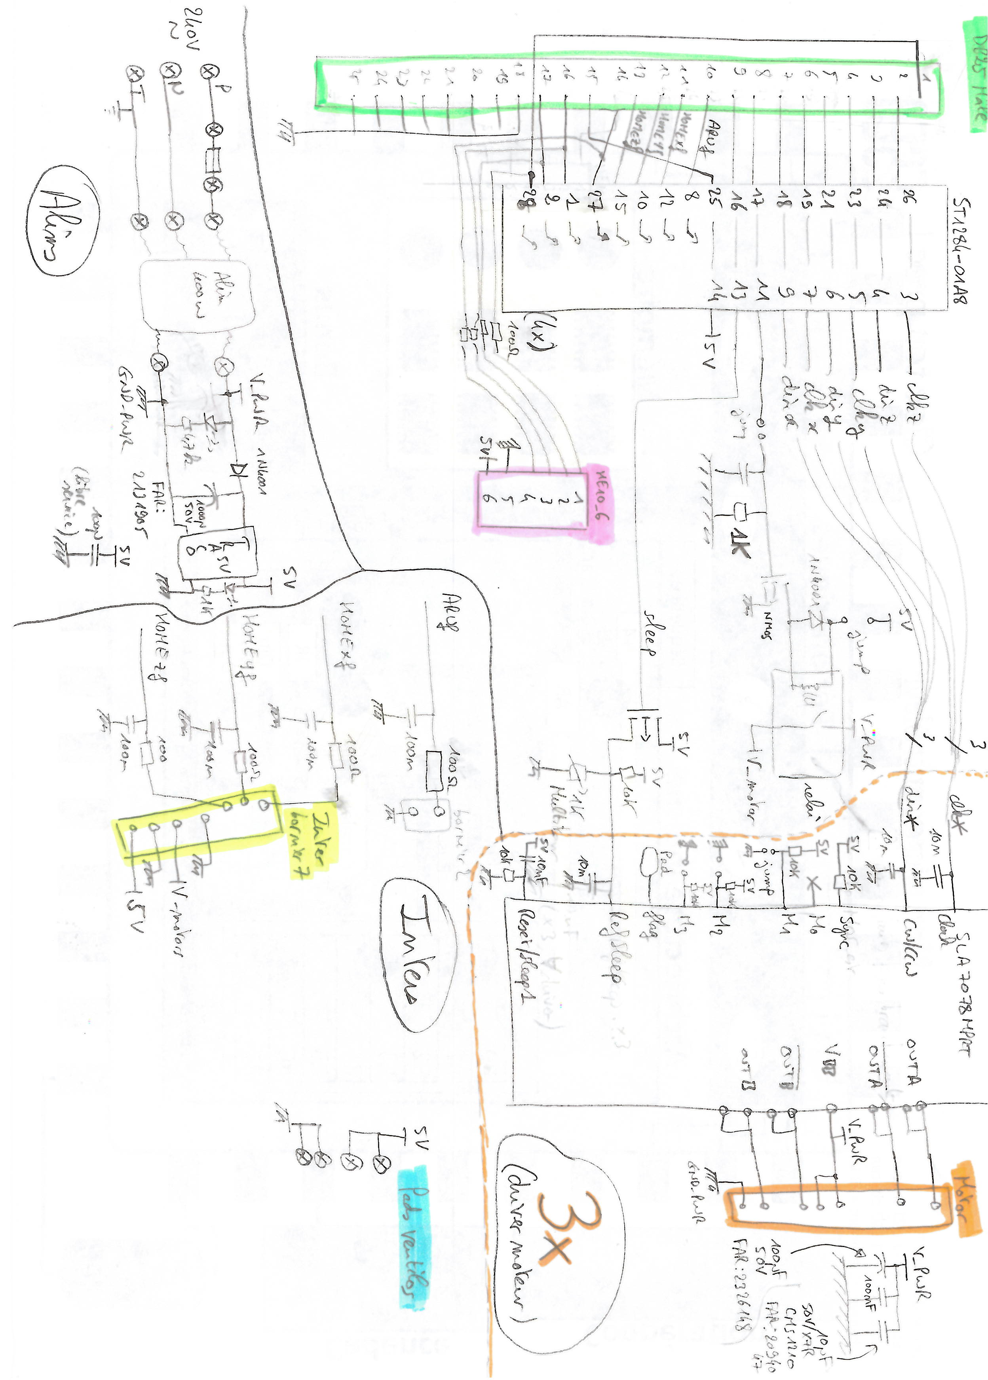
[picture p56: page 1]
