samuelpoiraud/robot/_Hard/2015_CNC/draft.pdf

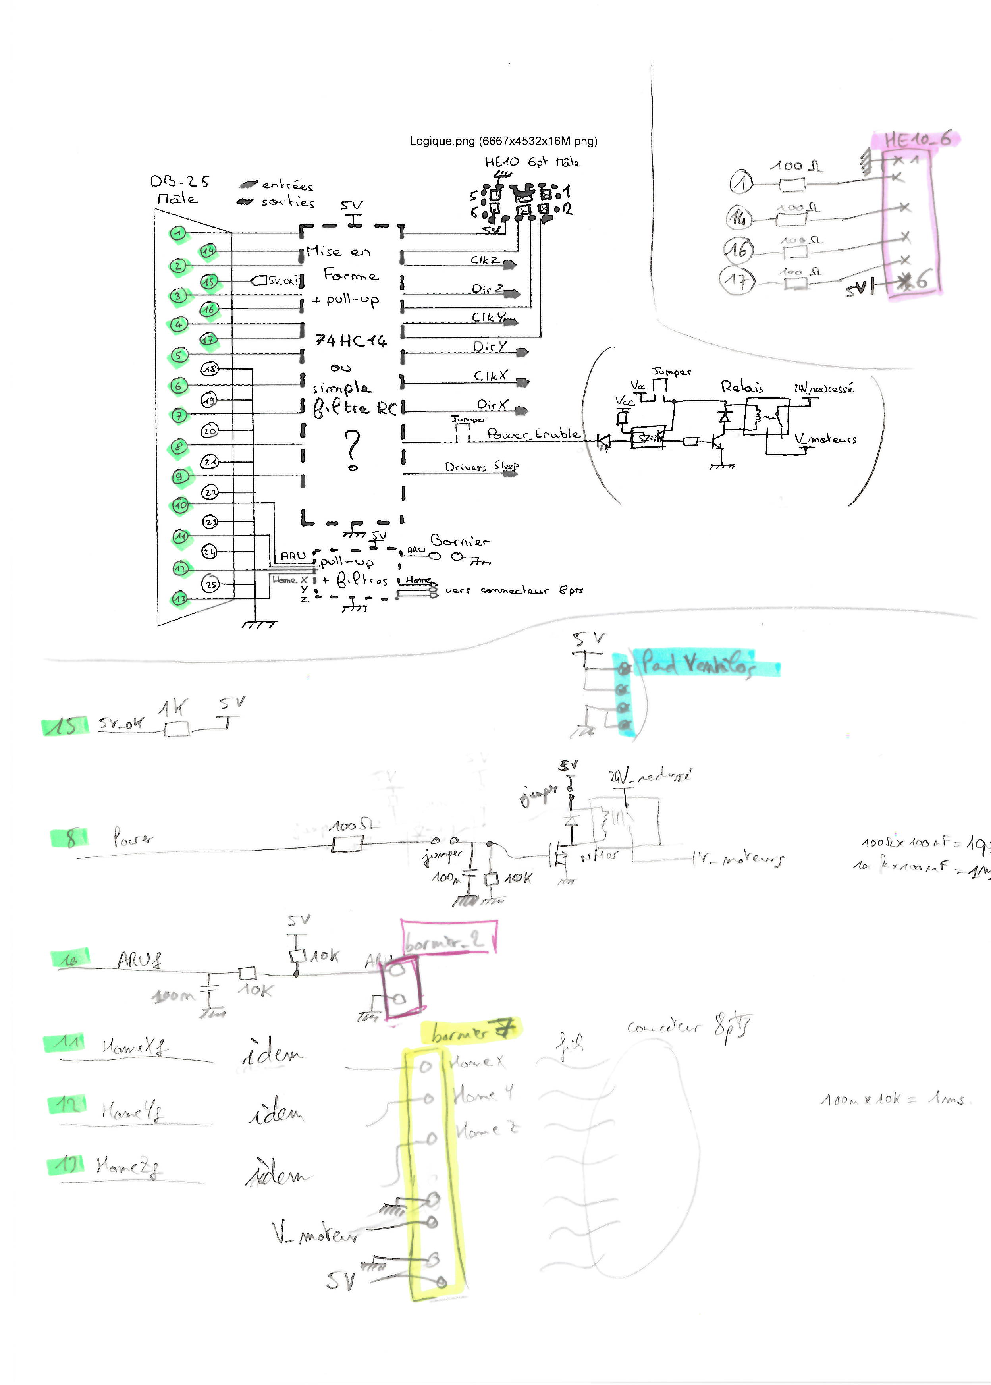
[picture p57: page 1]
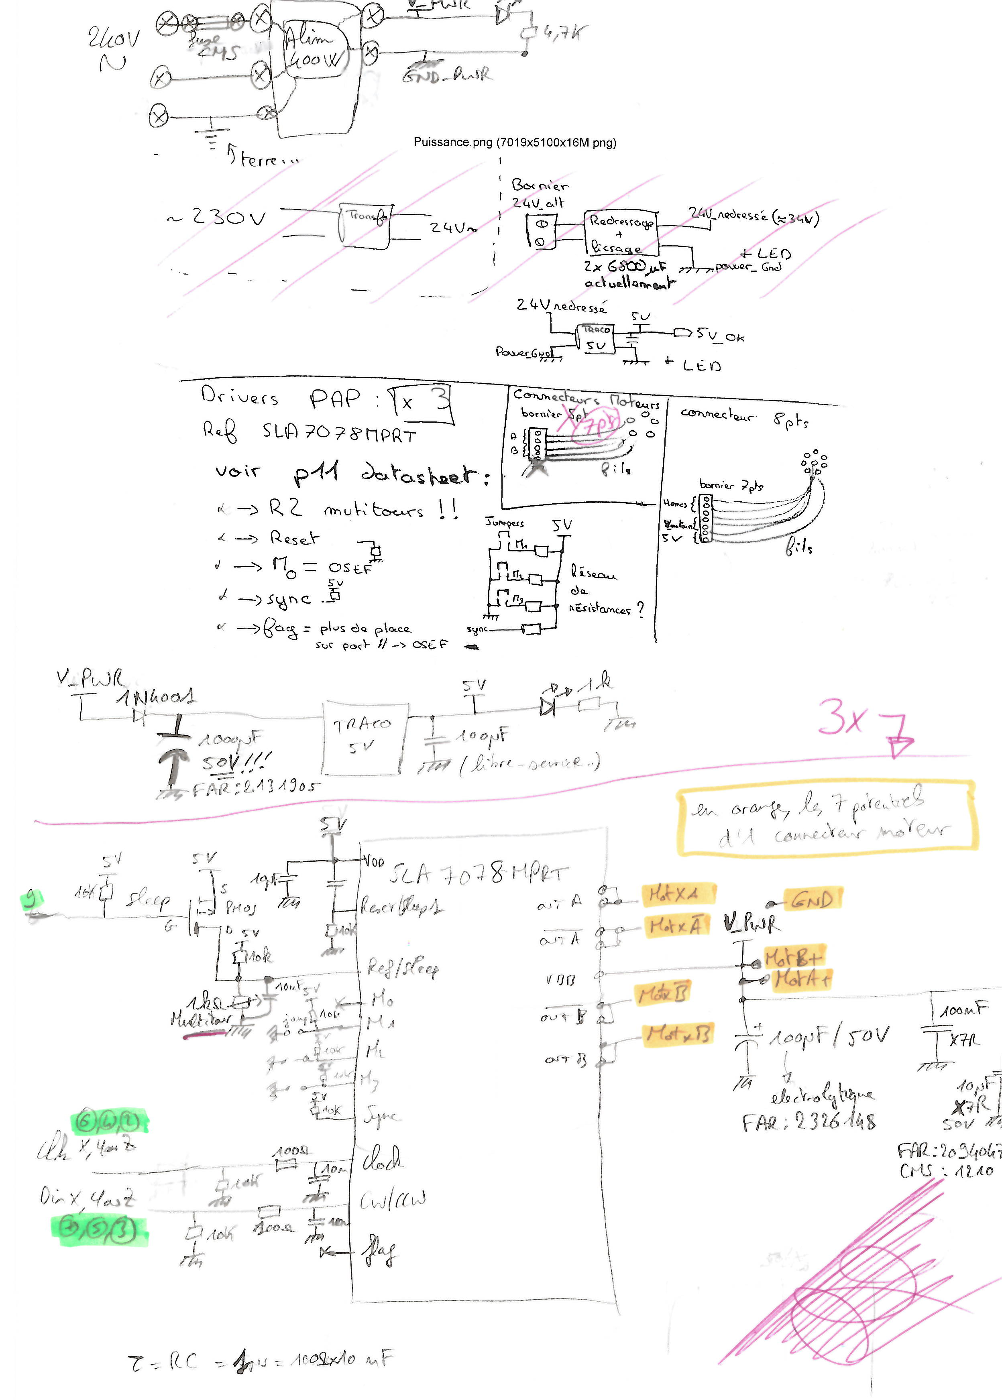
[picture p58: page 2]
