samuelpoiraud/robot/2_Strategie/Coquillages.png

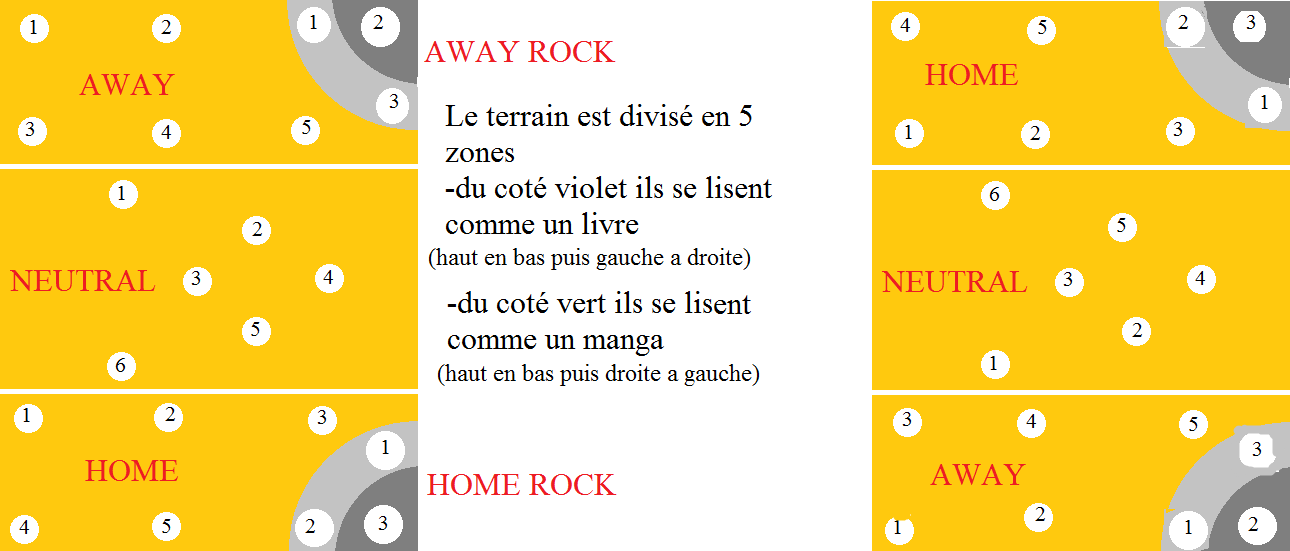
2_Strategie/Coquillages.png
