samuelpoiraud/robot/_Hard/2014_BallLauncher/SIMU.jpg

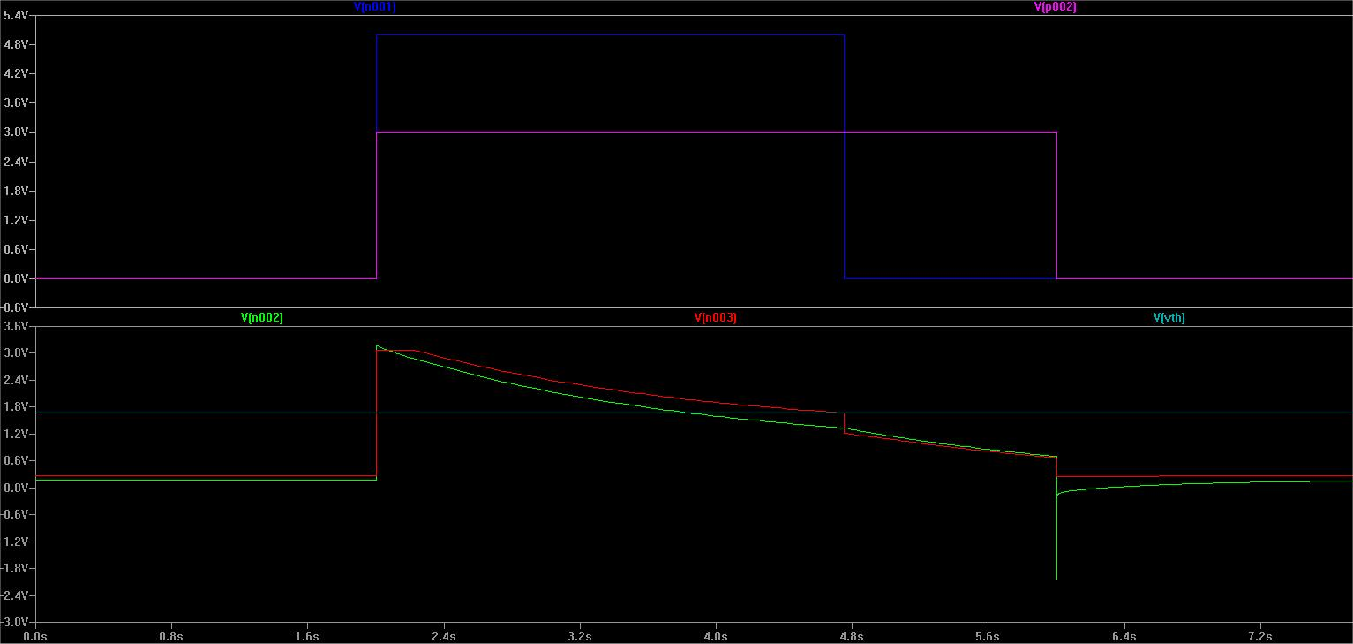
_Hard/2014_BallLauncher/SIMU.jpg
