samuelpoiraud/robot/_Hard/2014_IHM/boutons_ihm.JPG

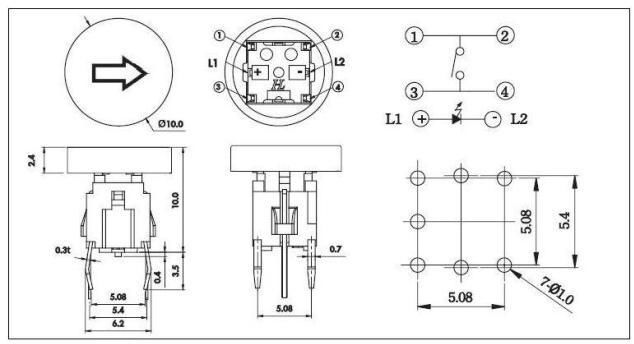
_Hard/2014_IHM/boutons_ihm.JPG
