samuelpoiraud/robot/_Hard/2017_IHM/LCD.jpg

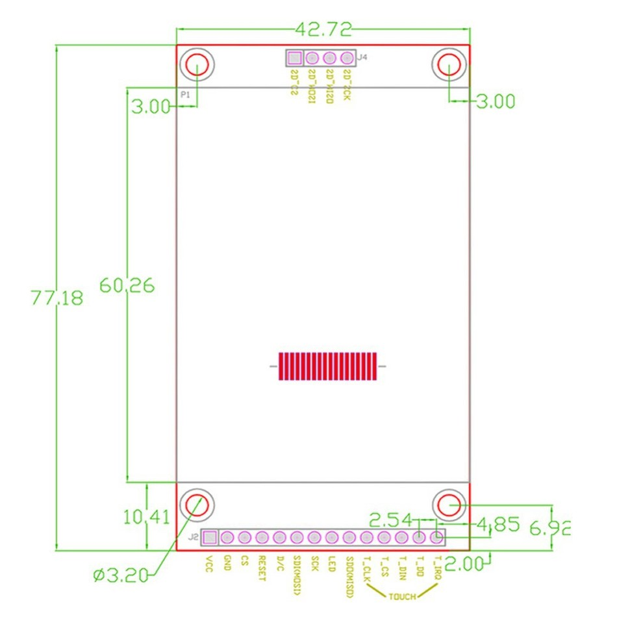
_Hard/2017_IHM/LCD.jpg
