samuelpoiraud/robot/STM32/pin_usages.xls

Sheet: 2015
Ce classeur est obsolète, RDV ICI :https://docs.google.com/spreadsheets/d/1XdfCNjssUiVZVjnLfN5fO102capX2MqjzbaMX7ZN5aw/edit
En rouge les sorties non changeable (en dur sur la stm32f4discovery), gris = changeable mais faut faire gaffe … |  |  |  |  |  |  |  |  |  | Format : x.pin = périph x, broche « pin »
Pin | I/O | Fonction | Periph sur la carte stm32f4discovery | Usage CHOISI | PROPULSION | ACTIONNEUR | STRATEGIE 2015 | IHM | BeaconEye | TIMER | UART | SPI | I2C | I2S | USB_HS | USB_FS | ADC | DAC | DCMI | ETH | CAN | FSMC | SDIO | Other
PA0 | I | GPIO | BTN.USER | BP 0 | BP Calibration |  | BP Run Match | BP Selftest | BP | 2.CH1 2.ETR 5.CH1 8.ETR | 2.CTS 4.TX |  |  |  |  |  | 123.IN0 |  |  | MII_CRS |  |  |  | WKUP
PA1 | I | QEI2 Pin B |  | Codeur2B | Codeur G pin B | Codeur2B |  | BP Calibration | BP laser | 2.CH2 5.CH2 | 2.RTS 4.RX |  |  |  |  |  | 123.IN1 |  |  | RMII_REF_CLK MII_RX_CLK
PA2 | O | UART2.TX |  | UART2 (xbee..) | U2TX | MAX485dif(RFU) | Xbee |  | Xbee | 2.CH3 5.CH3 9.CH1 | 2.TX |  |  |  |  |  | 123.IN2 |  |  | MDIO
PA3 | I | UART2.RX |  | UART2 (xbee..) | U2RX | MAX485dif(RFU) | Xbee | BP PrintMatch | Xbee | 2.CH4 5.CH4 9.CH2 | 2.RX |  |  |  | ULPI_D0 |  | 123.IN3 |  |  | MII_COL
PA4 | I | I2S | CS43L22.LRCK/AIN1x | (divers) | - | - | - | BP0 |  |  | 2.CK | 1.NSS 3.NSS |  | 3.WS | SOF |  | 12.IN4 | 1.OUT | HSYNC
PA5 | O | SPI | LIS302DL.SCL/SPC | (divers) | (LIS302DL) | MAX485dif(RFU) | Xbee reset / RF Reset | Mesure 12V Hokuyo | Xbee reset / RF Reset | 2.CH1 2.ETR 8.CHIN |  | 1.SCK |  |  | ULPI_CK |  | 12.IN5 | 2.OUT
PA6 | O | SPI | LIS302DL.SDO | (divers) | (LIS302DL) |  | RF Config | Mesure 24V psce |  | 1.BKIN 3.CH1 8.BKIN 13.CH1 |  | 1.MISO |  |  |  |  | 12.IN6 |  | PIXCLK
PA7 | I | SPI | LIS302DL.SDA/SDI/SDO | (divers) | (LIS302DL) | (ADC7) SW présence Filet |  | BP1 |  | 1.CH1N 3.CH2 8.CH1N 14.CH1 |  | 1.MOSI |  |  |  |  | 12.IN7 |  |  | MII_RX_DV RMII_CRC_DV
PA8 | O |  |  | Sens1 |  | Sens1 |  |  | Mosfet Lasers | 1.CH1 | 1.CK |  | 3.SCL |  |  | SOF |  |  |  |  |  |  |  | MCO1
PA9 | I | USB | USB.LED.GREEN / USB.VBUS | - | HOKUYO | - | CLE USB | BP2 | USB_VBUS | 1.CH2 | 1.TX |  | 3.SMBA |  |  | VBUS |  |  | D0
PA10 | I | USB | USB.ID | - | HOKUYO | - | CLE USB | BP3 | USB_ID | 1.CH3 | 1.RX |  |  |  |  | ID |  |  | D1
PA11 | I | USB | USB.DM | - | HOKUYO | - | CLE USB | BP4 | USB_DM | 1.CH4 | 1.CTS |  |  |  |  | DM |  |  |  |  | 1.RX
PA12 | I | USB | USB.DP | - | HOKUYO | - | CLE USB | BP5 | USB_DP | 1.ETR | 1.RTS |  |  |  |  | DP |  |  |  |  | 1.TX
PA13 |  | SWD | SWD.SWDIO | - | Port programmation |  |  | SWD.IO |  |  |  |  |  |  |  |  |  |  |  |  |  |  |  | SWDIO
PA14 |  | SWD | SWD.SWCLK | - |  |  |  | SWD.CLK |  |  |  |  |  |  |  |  |  |  |  |  |  |  |  | SWCLK
PA15 | I | QEI2 Pin A |  | Codeur2A | Codeur G pin A | Codeur2A |  |  |  | 2.CH1 2.ETR |  | 1.NSS 3.NSS |  | 3.WS |  |  |  |  |  |  |  |  |  | JTDI
PB0 | I |  |  | ADC 8 | (courant moteur G) | ADC 8 - fin course vérin sorti | Mesure 24V | SW LCD | ADC RFU | 1.CH2N 3.CH3 8.CH2N |  |  |  |  | ULPI_D1 |  | 12.IN8 |  |  | MII_RXD2
PB1 | I |  |  | ADC 9 | (courant moteur D) | ADC 9 - fin course vérin entré | Capteur | BP ok | ADC RFU | 1.CH3N 3.CH4 8.CH3N |  |  |  |  | ULPI_D2 INTN |  | 12.IN9 |  |  | MII_RXD3
PB2 | I |  |  | IT Externe | - | IT Externe.. |  | BP +
PB3 |  | SWD | SWD.SWO | - | Port programmation |  |  | SWD.SWO |  | 2.CH2 |  | 1.SCK 3.SCK |  | 3.CK |  |  |  |  |  |  |  |  |  | JTDO TRACESWO
PB4 | I | QEI1 Pin A |  | Codeur1A | Codeur D pin A | Codeur1A | Capteur TOR | BP - |  | 3.CH1 |  | 1.MISO 3.MISO |  | 3ext.SD |  |  |  |  |  |  |  |  |  | NJTRST
PB5 | I | QEI1 Pin B |  | Codeur1B | Codeur D pin B | Codeur1B | Capteur TOR | BP Set |  | 3.CH2 |  | 1.MOSI 3.MOSI | 1.SMBA | 3.SD | ULPI_D7 |  |  |  | D10 | PPS_OUT | 2.RX
PB6 | O | UART1.TX | CS43L22.SCL | UART1_TX | U1TX | U1TX | U1TX | U1TX | U1TX | 4.CH1 | 1.TX |  | 1.SCL |  |  | INTN |  |  | D5 |  | 2.TX
PB7 | I | UART1.RX |  | UART1_RX | U1RX | U1RX | U1RX | U1RX | U1RX | 4.CH2 | 1.RX |  | 1.SDA |  |  |  |  |  | VSYNC |  |  | NL
PB8 | O | I2C_SCL |  | I2C_SCL | I_AM_READY | I_AM_READY |  | I_AM_READY | LCD_I2C_SCL | 4.CH3 10.CH1 |  |  | 1.SCL |  |  | SCL |  |  | D6 | MII_TXD3 | 1.RX |  | D4
PB9 | O | I2C_SDA | CS43L22.SDA | I2C_SDA |  | BallLauncher1 | LCD RESET | LCD RESET | LCD_I2C_SDA | 4.CH4 11.CH1 |  | 2.NSS | 1.SDA | 2.WS |  | SDA |  |  | D7 |  | 1.TX |  | D5
PB10 | O | GPIO ? | MP45DT02.CLK | I2C2_SCL |  | BallLauncher2 | I2C RTC LCD | I2C LCD |  | 2.CH3 | 3.TX | 2.SCK | 2.SCL | 2.CK | ULPI_D3 SCL |  |  |  |  | MII_RX_ER
PB11 | O |  |  | I2C2_SDA |  | MAX485_Sens | I2C RTC LCD | I2C LCD |  | 2.CH4 | 3.RX |  | 2.SDA |  | ULPI_D4 SDA |  |  |  |  | MII_TX_EN RMII_TX_EN
PB12 | O |  |  | SPI2_CS | (évo possible: GYRO) | BallLauncher3 | SD | SPI |  | 1.BKIN | 3.CK | 2.NSS | 2.SMBA | 2.WS | ULPI_D5 ID |  |  |  |  | MII_TXD0 RMII_TXD0 | 2.RX
PB13 | O |  |  | SPI2_SCK | (évo possible: GYRO) | BallLauncher4 | SD | SPI |  | 1.CH1N | 3.CTS | 2.SCK |  | 2.CK | ULPI_D6 VBUS |  |  |  |  | MII_TXD1 RMII_TXD1 | 2.TX
PB14 | O |  |  | SPI2_MISO | (évo possible: GYRO) | BallLauncher5 | SD | SPI |  | 1.CH2N 8.CH2N 12.CH1 | 3.RTS | 2.MISO |  | 2ext.SD | DM
PB15 | O |  |  | SPI2_MOSI | (évo possible : GYRO) | BallLauncher6 | SD | SPI |  | 1.CH3N 8.CH3N 12.CH2 |  | 2.MOSI |  | 2.SD | DP
PC0 | I |  | USB.POWERON | - | - | - | - | Mesure 24V perm |  |  |  |  |  |  | ULPI_STP |  | 123.IN10
PC1 | I |  |  | ADC 11 | Capteurs C1 | ADC 11 - potar hauteur bras | Capteur | SW16 |  |  |  |  |  |  |  |  | 123.IN11 |  |  | MDC
PC2 | I |  |  | ADC 12 | Capteurs C2 | ADC 12 | Capteur | SW17 |  |  |  | 2.MISO |  | 2ext.SD | ULPI_DIR |  | 123.IN12 |  |  | MII_TXD2
PC3 | I | GPIO | MP45DT02.DOUT/AIN4x | (ADC 13) si néc. | (Capteurs C3) |  | Capteur | SW18 |  |  |  | 2.MOSI |  | 2.SD | ULPI_NXT |  | 123.IN13 |  |  | MII_TX_CLK
PC4 | I | GPIO |  | ADC 14 | Capteurs C4 | ADC 14 - hauteur bras (courant) | Capteur | BP RFU |  |  |  |  |  |  |  |  | 12.IN14 |  |  | MII_RXD0 RMII_RXD0
PC5 | I | GPIO |  | ADC 15 | Capteurs C5 | ADC 15 - POMPE (courant) |  | SW2 | SW COLOR |  |  |  |  |  |  |  | 12.IN15 |  |  | MII_RXD1 RMII_RXD1
PC6 | O | PWM1 |  | PWM1 |  | PWM1 - P_updown / G_Pompe |  | LED ok | LED COLOR Green | 3.CH1 8.CH1 | 6.TX |  |  | 2.MCK |  |  |  |  | D0 |  |  |  | D6
PC7 | O | I2S | CS43L22.MCLK | PWM2 |  | PWM2 - P_Labium / G_updown |  | LED set | LED COLOR Red | 3.CH2 8.CH2 | 6.RX |  |  | 3.MCK |  |  |  |  | D1 |  |  |  | D7
PC8 | O | PWM3 |  | PWM3 | Moteur Droite | PWM3 - P_Pompe_Arm | synchro balise | LED + | LED COLOR Blue | 3.CH3 8.CH3 | 6.CK |  |  |  |  |  |  |  | D2 |  |  |  | D0
PC9 | O | PWM4 |  | PWM4 | Moteur Gauche | PWM4 - P_Pompe_Small_Arm | buzzer | LED - | Buzzer | 3.CH4 8.CH4 |  |  | 3.SDA | 2.CKIN |  |  |  |  | D3 |  |  |  | D1 | MCO2
PC10 | O | I2S | CS43L22.SCLK | Sens2 |  | Sens2 |  |  | LED0 |  | 3.TX 4.TX | 3.SCK |  | 3.CK |  |  |  |  | D8 |  |  |  | D2
PC11 | O |  |  | Sens3 | Sens Moteur D | Sens3 |  |  | LED1 |  | 3.RX 4.RX | 3.MISO |  | 3ext.SD |  |  |  |  | D4 |  |  |  | D3
PC12 | O | I2S | CS43L22.SDIN | Sens4 | Sens Moteur G | Sens4 |  |  | LED2 |  | 3.CK 5.TX | 3.MOSI |  | 3.SD |  |  |  |  | D9 |  |  |  | CK
PC13 | I |  |  | WHO_AM_I | WHO_AM_I | WHO_AM_I | WHO_AM_I | WHO_AM_I | LCD_INT |  |  |  |  |  |  |  |  |  |  |  |  |  |  | RTC_AF1
PC14 |  |  | OSC32_IN (optionnal) | - |  |  |  |  |  |  |  |  |  |  |  |  |  |  |  |  |  |  |  | OSC32_IN
PC15 |  |  | OSC32_OUT (optionnal) | - |  |  |  |  |  |  |  |  |  |  |  |  |  |  |  |  |  |  |  | OSC32_OUT
PD0 | I |  |  | CAN_RX | CAN_RX | CAN_RX | CAN_RX | CAN_RX | LCD_D2 |  |  |  |  |  |  |  |  |  |  |  | 1.RX | D2
PD1 | O |  |  | CAN_TX | CAN_TX | CAN_TX | CAN_TX | CAN_TX | LCD_D3 |  |  |  |  |  |  |  |  |  |  |  | 1.TX | D3
PD2 | O |  |  | OUTPUT_divers |  | TOR - gache libération filet |  | LED COLOR Green |  | 3.ETR | 5.RX |  |  |  |  |  |  |  | D11 |  |  |  | CMD
PD3 | O |  |  | OUTPUT_divers |  | TOR |  | LED COLOR Red | LCD_RESET |  | 2.CTS |  |  |  |  |  |  |  |  |  |  | CLK
PD4 | O | GPIO | CS43L22.RESET | - | - | - |  | LED COLOR Blue | LCD_RD |  | 2.RTS |  |  |  |  |  |  |  |  |  |  | NOE
PD5 | O | USB | USB.LED.RED / USB.OVERCURRENT | - | - | - | - |  | LCD_WR |  | 2.TX |  |  |  |  |  |  |  |  |  |  | NWE
PD6 | I | GPIO |  | INTPUT_divers | Capteurs TOR D6 | (RFU) |  | SW COLOR |  |  | 2.RX |  |  |  |  |  |  |  |  |  |  | NWAIT
PD7 | I | GPIO |  | INTPUT_divers | Capteurs TOR D7 | (RFU) |  | BIROUTE | LCD_CS |  | 2.CK |  |  |  |  |  |  |  |  |  |  | NE1 NCE2
PD8 | O | GPIO |  | UART3_TX |  | MAX485_TX | COM RF TX |  | LCD_D13 |  | 3.TX |  |  |  |  |  |  |  |  |  |  | D13
PD9 | I | GPIO |  | UART3_RX |  | MAX485_RX | COM RF RX | (rfu) | LCD_D14 |  | 3.RX |  |  |  |  |  |  |  |  |  |  | D14
PD10 | O | GPIO |  | LED ERROR | LED ERROR | LED ERROR | LED ERROR | LED0 | LCD_D15 |  | 3.CK |  |  |  |  |  |  |  |  |  |  | D15
PD11 | O | GPIO |  | LED Selftest | LED SELFTEST | LED SELFTEST | LED SELFTEST | LED1 |  |  | 3.CTS |  |  |  |  |  |  |  |  |  |  | A16
PD12 | O | GPIO | LED.GREEN | LED RUN | LED RUN | LED RUN | LED RUN | LED2 |  | 4.CH1 | 3.RTS |  |  |  |  |  |  |  |  |  |  | A17
PD13 | O | GPIO | LED.ORANGE | LED CAN | LED CAN | LED CAN | LED CAN | LED3 |  | 4.CH2 |  |  |  |  |  |  |  |  |  |  |  | A18
PD14 | O | GPIO | LED.RED | LED UART | LED UART | LED UART | LED UART | LED4 | LCD_D0 | 4.CH3 |  |  |  |  |  |  |  |  |  |  |  | D0
PD15 | O | GPIO | LED.BLUE | LED USER | LED_USER | LED_USER | LED_USER | LED5 | LCD_D1 | 4.CH4 |  |  |  |  |  |  |  |  |  |  |  | D13
PE0 | I | GPIO | LIS302DL.INT1 | - | (LIS302DL) | - | - | SW0 |  | 4.ETR |  |  |  |  |  |  |  |  | D2 |  |  | NBL0
PE1 | I | GPIO | LIS302DL.INT2 | - | (LIS302DL) | - | - | SW1 |  |  |  |  |  |  |  |  |  |  | D3 |  |  | NBL1
PE2 | O | GPIO | LIS302DL.CS_I2C/SPI | - | Port programmation (optionnel?) |  |  |  |  |  |  |  |  |  |  |  |  |  |  | MII_TXD3 |  | A23 |  | TRACECLK
PE3 |  |  |  | - |  |  |  | SW3 | LCD_DC |  |  |  |  |  |  |  |  |  |  |  |  | A19 |  | TRACED0
PE4 |  |  |  | - |  |  |  | SW4 |  |  |  |  |  |  |  |  |  |  | D4 |  |  | A20 |  | TRACED1
PE5 | I |  |  | (QEI3A) |  |  |  | SW5 |  | 9.CH1 |  |  |  |  |  |  |  |  | D6 |  |  | A21 |  | TRACED2
PE6 | I |  |  | (QEI3B) |  |  |  | SW6 |  | 9.CH2 |  |  |  |  |  |  |  |  | D7 |  |  | A22 |  | TRACED3
PE7 | I | GPIO |  |  | RFU |  |  | SW7 | LCD_D4 | 1.ETR |  |  |  |  |  |  |  |  |  |  |  | D4
PE8 | I | GPIO |  |  | RFU |  | ACT_IS_READY | SW8 | LCD_D5 | 1.CH1N |  |  |  |  |  |  |  |  |  |  |  | D5
PE9 | I | GPIO |  |  | RFU |  | PROP_IS_READY | SW9 | LCD_D6 | 1.CH1 |  |  |  |  |  |  |  |  |  |  |  | D6
PE10 | I | GPIO |  |  | RFU | servo 0 | IHM_IS_READY | SW10 | LCD_D7 | 1.CH2N |  |  |  |  |  |  |  |  |  |  |  | D7
PE11 | I | GPIO |  |  | RFU | servo 1 |  | SW11 | LCD_D8 | 1.CH2 |  |  |  |  |  |  |  |  |  |  |  | D8
PE12 | I | GPIO |  |  |  | servo 2 |  | SW12 | LCD_D9 | 1.CH3N |  |  |  |  |  |  |  |  |  |  |  | D9
PE13 | I | GPIO |  |  |  | servo 3 |  | SW13 | LCD_D10 | 1.CH3 |  |  |  |  |  |  |  |  |  |  |  | D10
PE14 | I | GPIO |  |  |  | servo 4 |  | SW14 | LCD_D11 | 1.CH4 |  |  |  |  |  |  |  |  |  |  |  | D11
PE15 | I | GPIO |  |  |  | servo 5 |  | SW15 | LCD_D12 | 1.BKIN |  |  |  |  |  |  |  |  |  |  |  | D12
PH0 |  | OSC | OSC_IN | - | Oscillateur Quartz |  |  |  |  |  |  |  |  |  |  |  |  |  |  |  |  |  |  | OSC_IN
PH1 |  | OSC | OSC_OUT | - |  |  |  |  |  |  |  |  |  |  |  |  |  |  |  |  |  |  |  | OSC_OUT
 |  |  |  |  |  |  | GND
 |  |  |  |  |  |  | GND
 |  |  |  |  |  |  | 5V
 |  |  |  |  |  |  | 3V_Strat
 |  |  |  |  |  |  | BACKUP1
 |  |  |  |  |  | En Bleu : vers capteurs/act | En jaune : vers carte LCD
 |  |  |  |  |  |  | Connecteur 20 HE10 (nappe)
 |  |  |  |  |  | En Vert : vers carte balllauncher
 |  |  |  |  |  |  | En couleur comme ca
 |  |  |  |  |  |  | Connecteur 16 HE10 (nappe)
 |  |  |  |  |  |  | vers RF/Xbee/Balise
 |  |  |  |  |  |  | 5V (pr balise)
 |  |  |  |  |  |  | 3V (pr RF et Xbee)
 |  |  |  |  |  |  | GND
 |  |  |  |  |  |  | GND

Sheet: 2014
En rouge les sorties non changeable (en dur sur la stm32f4discovery), gris = changeable mais faut faire gaffe … |  |  |  |  |  |  |  | Format : x.pin = périph x, broche « pin »
Pin | I/O | Fonction | Periph sur la carte stm32f4discovery | Usage CHOISI | PROPULSION | ACTIONNEUR | STRATEGIE 2014 | TIMER | UART | SPI | I2C | I2S | USB_HS | USB_FS | ADC | DAC | DCMI | ETH | CAN | FSMC | SDIO | Other
PA0 | I | GPIO | BTN.USER | BP 0 | BP Calibration |  | BP Run Match | 2.CH1 2.ETR 5.CH1 8.ETR | 2.CTS 4.TX |  |  |  |  |  | 123.IN0 |  |  | MII_CRS |  |  |  | WKUP
PA1 | I | QEI2 Pin B |  | Codeur2B | Codeur G pin B | Codeur2B | SW Debug | 2.CH2 5.CH2 | 2.RTS 4.RX |  |  |  |  |  | 123.IN1 |  |  | RMII_REF_CLK MII_RX_CLK
PA2 | O | UART2.TX |  | UART2 (xbee..) | U2TX | MAX485dif(RFU) | Xbee/BT/U2TX | 2.CH3 5.CH3 9.CH1 | 2.TX |  |  |  |  |  | 123.IN2 |  |  | MDIO
PA3 | I | UART2.RX |  | UART2 (xbee..) | U2RX | MAX485dif(RFU) | Xbee/BT/U2RX | 2.CH4 5.CH4 9.CH2 | 2.RX |  |  |  | ULPI_D0 |  | 123.IN3 |  |  | MII_COL
PA4 | I | I2S | CS43L22.LRCK/AIN1x | (divers) | - | - | - |  | 2.CK | 1.NSS 3.NSS |  | 3.WS | SOF |  | 12.IN4 | 1.OUT | HSYNC
PA5 | O | SPI | LIS302DL.SCL/SPC | (divers) | (LIS302DL) | MAX485dif(RFU) | Xbee reset / RF Reset | 2.CH1 2.ETR 8.CHIN |  | 1.SCK |  |  | ULPI_CK |  | 12.IN5 | 2.OUT
PA6 | O | SPI | LIS302DL.SDO | (divers) | (LIS302DL) |  | RF Config | 1.BKIN 3.CH1 8.BKIN 13.CH1 |  | 1.MISO |  |  |  |  | 12.IN6 |  | PIXCLK
PA7 | I | SPI | LIS302DL.SDA/SDI/SDO | (divers) | (LIS302DL) | (ADC7) SW présence Filet | SW Verbose | 1.CH1N 3.CH2 8.CH1N 14.CH1 |  | 1.MOSI |  |  |  |  | 12.IN7 |  |  | MII_RX_DV RMII_CRC_DV
PA8 | O |  |  | Sens1 |  | Sens1 | LED_IHM_SET | 1.CH1 | 1.CK |  | 3.SCL |  |  | SOF |  |  |  |  |  |  |  | MCO1
PA9 | I | USB | USB.LED.GREEN / USB.VBUS | - | HOKUYO | - | CLE USB | 1.CH2 | 1.TX |  | 3.SMBA |  |  | VBUS |  |  | D0
PA10 | I | USB | USB.ID | - | HOKUYO | - | CLE USB | 1.CH3 | 1.RX |  |  |  |  | ID |  |  | D1
PA11 | I | USB | USB.DM | - | HOKUYO | - | CLE USB | 1.CH4 | 1.CTS |  |  |  |  | DM |  |  |  |  | 1.RX
PA12 | I | USB | USB.DP | - | HOKUYO | - | CLE USB | 1.ETR | 1.RTS |  |  |  |  | DP |  |  |  |  | 1.TX
PA13 |  | SWD | SWD.SWDIO | - | Port programmation |  |  |  |  |  |  |  |  |  |  |  |  |  |  |  |  | SWDIO
PA14 |  | SWD | SWD.SWCLK | - |  |  |  |  |  |  |  |  |  |  |  |  |  |  |  |  |  | SWCLK
PA15 | I | QEI2 Pin A |  | Codeur2A | Codeur G pin A | Codeur2A | BP Print Match | 2.CH1 2.ETR |  | 1.NSS 3.NSS |  | 3.WS |  |  |  |  |  |  |  |  |  | JTDI
PB0 | I |  |  | ADC 8 | (courant moteur G) | ADC 8 - fin course vérin sorti | Mesure 24V | 1.CH2N 3.CH3 8.CH2N |  |  |  |  | ULPI_D1 |  | 12.IN8 |  |  | MII_RXD2
PB1 | I |  |  | ADC 9 | (courant moteur D) | ADC 9 - fin course vérin entré | Capteur : SW Fresque 3 | 1.CH3N 3.CH4 8.CH3N |  |  |  |  | ULPI_D2 INTN |  | 12.IN9 |  |  | MII_RXD3
PB2 | I |  |  | IT Externe | - | IT Externe.. | Surveillance Alim
PB3 |  | SWD | SWD.SWO | - | Port programmation |  |  | 2.CH2 |  | 1.SCK 3.SCK |  | 3.CK |  |  |  |  |  |  |  |  |  | JTDO TRACESWO
PB4 | I | QEI1 Pin A |  | Codeur1A | Codeur D pin A | Codeur1A | SW Xbee ON/OFF | 3.CH1 |  | 1.MISO 3.MISO |  | 3ext.SD |  |  |  |  |  |  |  |  |  | NJTRST
PB5 | I | QEI1 Pin B |  | Codeur1B | Codeur D pin B | Codeur1B | SW Save ON/OFF | 3.CH2 |  | 1.MOSI 3.MOSI | 1.SMBA | 3.SD | ULPI_D7 |  |  |  | D10 | PPS_OUT | 2.RX
PB6 | O | UART1.TX | CS43L22.SCL | UART1_TX | U1TX | U1TX | U1TX | 4.CH1 | 1.TX |  | 1.SCL |  |  | INTN |  |  | D5 |  | 2.TX
PB7 | I | UART1.RX |  | UART1_RX | U1RX | U1RX | U1RX | 4.CH2 | 1.RX |  | 1.SDA |  |  |  |  |  | VSYNC |  |  | NL
PB8 | O | I2C_SCL |  | I2C_SCL |  |  |  | 4.CH3 10.CH1 |  |  | 1.SCL |  |  | SCL |  |  | D6 | MII_TXD3 | 1.RX |  | D4
PB9 | O | I2C_SDA | CS43L22.SDA | I2C_SDA |  | BallLauncher1 | LCD RESET | 4.CH4 11.CH1 |  | 2.NSS | 1.SDA | 2.WS |  | SDA |  |  | D7 |  | 1.TX |  | D5
PB10 | O | GPIO ? | MP45DT02.CLK | I2C2_SCL |  | BallLauncher2 | I2C RTC LCD | 2.CH3 | 3.TX | 2.SCK | 2.SCL | 2.CK | ULPI_D3 SCL |  |  |  |  | MII_RX_ER
PB11 | O |  |  | I2C2_SDA |  | MAX485_Sens | I2C RTC LCD | 2.CH4 | 3.RX |  | 2.SDA |  | ULPI_D4 SDA |  |  |  |  | MII_TX_EN RMII_TX_EN
PB12 | O |  |  | SPI2_CS | (évo possible: GYRO) | BallLauncher3 | SD | 1.BKIN | 3.CK | 2.NSS | 2.SMBA | 2.WS | ULPI_D5 ID |  |  |  |  | MII_TXD0 RMII_TXD0 | 2.RX
PB13 | O |  |  | SPI2_SCK | (évo possible: GYRO) | BallLauncher4 | SD | 1.CH1N | 3.CTS | 2.SCK |  | 2.CK | ULPI_D6 VBUS |  |  |  |  | MII_TXD1 RMII_TXD1 | 2.TX
PB14 | O |  |  | SPI2_MISO | (évo possible: GYRO) | BallLauncher5 | SD | 1.CH2N 8.CH2N 12.CH1 | 3.RTS | 2.MISO |  | 2ext.SD | DM
PB15 | O |  |  | SPI2_MOSI | (évo possible : GYRO) | BallLauncher6 | SD | 1.CH3N 8.CH3N 12.CH2 |  | 2.MOSI |  | 2.SD | DP
PC0 | O |  | USB.POWERON | - | - | - | - |  |  |  |  |  | ULPI_STP |  | 123.IN10
PC1 | I |  |  | ADC 11 | Capteurs DT10 sol | ADC 11 - potar hauteur bras | Capteur : SW Fresque 1 |  |  |  |  |  |  |  | 123.IN11 |  |  | MDC
PC2 | I |  |  | ADC 12 | Capteurs DTx0 nv1 | ADC 12 | Capteur : SW Fresque 2 |  |  | 2.MISO |  | 2ext.SD | ULPI_DIR |  | 123.IN12 |  |  | MII_TXD2
PC3 | I | GPIO | MP45DT02.DOUT/AIN4x | (ADC 13) si néc. | (Capteurs pr scan) |  | (ADC 13) - Présence feu WT100 |  |  | 2.MOSI |  | 2.SD | ULPI_NXT |  | 123.IN13 |  |  | MII_TX_CLK
PC4 | I | GPIO |  | ADC 14 | Capteurs DT10 nv2 | ADC 14 - hauteur bras (courant) | Capteur laser torche |  |  |  |  |  |  |  | 12.IN14 |  |  | MII_RXD0 RMII_RXD0
PC5 | I | GPIO |  | ADC 15 |  | ADC 15 - POMPE (courant) | BP SET |  |  |  |  |  |  |  | 12.IN15 |  |  | MII_RXD1 RMII_RXD1
PC6 | O | PWM1 |  | PWM1 |  | PWM1 - P_updown / G_Pompe | LED_Beacon_1_G | 3.CH1 8.CH1 | 6.TX |  |  | 2.MCK |  |  |  |  | D0 |  |  |  | D6
PC7 | O | I2S | CS43L22.MCLK | PWM2 |  | PWM2 - P_Labium / G_updown | LED_Beacon_1_R | 3.CH2 8.CH2 | 6.RX |  |  | 3.MCK |  |  |  |  | D1 |  |  |  | D7
PC8 | O | PWM3 |  | PWM3 | Moteur Droite | PWM3 - P_Pompe_Arm | synchro balise | 3.CH3 8.CH3 | 6.CK |  |  |  |  |  |  |  | D2 |  |  |  | D0
PC9 | O | PWM4 |  | PWM4 | Moteur Gauche | PWM4 - P_Pompe_Small_Arm | buzzer | 3.CH4 8.CH4 |  |  | 3.SDA | 2.CKIN |  |  |  |  | D3 |  |  |  | D1 | MCO2
PC10 | O | I2S | CS43L22.SCLK | Sens2 |  | Sens2 | LED_IHM_OK |  | 3.TX 4.TX | 3.SCK |  | 3.CK |  |  |  |  | D8 |  |  |  | D2
PC11 | O |  |  | Sens3 | Sens Moteur D | Sens3 | LED_IHM_+ |  | 3.RX 4.RX | 3.MISO |  | 3ext.SD |  |  |  |  | D4 |  |  |  | D3
PC12 | O | I2S | CS43L22.SDIN | Sens4 | Sens Moteur G | Sens4 | LED_IHM_- |  | 3.CK 5.TX | 3.MOSI |  | 3.SD |  |  |  |  | D9 |  |  |  | CK
PC13 | I |  |  | WHO_AM_I | WHO_AM_I | WHO_AM_I | WHO_AM_I |  |  |  |  |  |  |  |  |  |  |  |  |  |  | RTC_AF1
PC14 |  |  | OSC32_IN (optionnal) | - |  |  |  |  |  |  |  |  |  |  |  |  |  |  |  |  |  | OSC32_IN
PC15 |  |  | OSC32_OUT (optionnal) | - |  |  |  |  |  |  |  |  |  |  |  |  |  |  |  |  |  | OSC32_OUT
PD0 | I |  |  | CAN_RX | CAN_RX | CAN_RX | CAN_RX |  |  |  |  |  |  |  |  |  |  |  | 1.RX | D2
PD1 | O |  |  | CAN_TX | CAN_TX | CAN_TX | CAN_TX |  |  |  |  |  |  |  |  |  |  |  | 1.TX | D3
PD2 | O |  |  | OUTPUT_divers |  | TOR - gache libération filet | LED COLOR Green | 3.ETR | 5.RX |  |  |  |  |  |  |  | D11 |  |  |  | CMD
PD3 | O |  |  | OUTPUT_divers |  | TOR | LED COLOR Red |  | 2.CTS |  |  |  |  |  |  |  |  |  |  | CLK
PD4 | O | GPIO | CS43L22.RESET | - | - | - | LED COLOR Blue |  | 2.RTS |  |  |  |  |  |  |  |  |  |  | NOE
PD5 | O | USB | USB.LED.RED / USB.OVERCURRENT | - | - | - | - |  | 2.TX |  |  |  |  |  |  |  |  |  |  | NWE
PD6 | I | GPIO |  | INTPUT_divers |  | (RFU) | SW COLOR |  | 2.RX |  |  |  |  |  |  |  |  |  |  | NWAIT
PD7 | I | GPIO |  | INTPUT_divers |  | (RFU) | Biroute |  | 2.CK |  |  |  |  |  |  |  |  |  |  | NE1 NCE2
PD8 | O | GPIO |  | UART3_TX |  | MAX485_TX | COM RF TX |  | 3.TX |  |  |  |  |  |  |  |  |  |  | D13
PD9 | I | GPIO |  | UART3_RX |  | MAX485_RX | COM RF RX |  | 3.RX |  |  |  |  |  |  |  |  |  |  | D14
PD10 | O | GPIO |  | LED ERROR | LED ERROR | LED ERROR | LED ERROR |  | 3.CK |  |  |  |  |  |  |  |  |  |  | D15
PD11 | O | GPIO |  | LED Selftest | LED SELFTEST | LED SELFTEST | LED SELFTEST |  | 3.CTS |  |  |  |  |  |  |  |  |  |  | A16
PD12 | O | GPIO | LED.GREEN | LED RUN | LED RUN | LED RUN | LED RUN | 4.CH1 | 3.RTS |  |  |  |  |  |  |  |  |  |  | A17
PD13 | O | GPIO | LED.ORANGE | LED CAN | LED CAN | LED CAN | LED CAN | 4.CH2 |  |  |  |  |  |  |  |  |  |  |  | A18
PD14 | O | GPIO | LED.RED | LED UART | LED UART | LED UART | LED UART | 4.CH3 |  |  |  |  |  |  |  |  |  |  |  | D0
PD15 | O | GPIO | LED.BLUE | LED USER | LED_USER | LED_USER | LED_USER | 4.CH4 |  |  |  |  |  |  |  |  |  |  |  | D13
PE0 | I | GPIO | LIS302DL.INT1 | - | (LIS302DL) | - | - | 4.ETR |  |  |  |  |  |  |  |  | D2 |  |  | NBL0
PE1 | I | GPIO | LIS302DL.INT2 | - | (LIS302DL) | - | - |  |  |  |  |  |  |  |  |  | D3 |  |  | NBL1
PE2 | O | GPIO | LIS302DL.CS_I2C/SPI | - | Port programmation (optionnel?) |  |  |  |  |  |  |  |  |  |  |  |  | MII_TXD3 |  | A23 |  | TRACECLK
PE3 |  |  |  | - |  |  |  |  |  |  |  |  |  |  |  |  |  |  |  | A19 |  | TRACED0
PE4 |  |  |  | - |  |  |  |  |  |  |  |  |  |  |  |  | D4 |  |  | A20 |  | TRACED1
PE5 | I |  |  | (QEI3A) |  |  |  | 9.CH1 |  |  |  |  |  |  |  |  | D6 |  |  | A21 |  | TRACED2
PE6 | I |  |  | (QEI3B) |  |  |  | 9.CH2 |  |  |  |  |  |  |  |  | D7 |  |  | A22 |  | TRACED3
PE7 | I | GPIO |  | SWITCH 0 | SW 0 - RFU | SW divers | SW LCD | 1.ETR |  |  |  |  |  |  |  |  |  |  |  | D4
PE8 | I | GPIO |  | SWITCH 1 | SW 1 - RFU | SW divers | SW EVIT | 1.CH1N |  |  |  |  |  |  |  |  |  |  |  | D5
PE9 | I | GPIO |  | SWITCH 2 | SW 2 - RFU | SW divers | SW STRAT | 1.CH1 |  |  |  |  |  |  |  |  |  |  |  | D6
PE10 | I | GPIO |  | SWITCH 3 |  | SW divers | SW STRAT | 1.CH2N |  |  |  |  |  |  |  |  |  |  |  | D7
PE11 | I | GPIO |  | SWITCH 4 |  | SW divers | SW STRAT | 1.CH2 |  |  |  |  |  |  |  |  |  |  |  | D8
PE12 | I | GPIO |  | BP 1 | BP Calibration | BP Test ACT | BP Selftest | 1.CH3N |  |  |  |  |  |  |  |  |  |  |  | D9
PE13 | I | GPIO |  | BP 2 |  | BP Test ACT | BP MenuLCD OK | 1.CH3 |  |  |  |  |  |  |  |  |  |  |  | D10
PE14 | I | GPIO |  | BP 3 |  | BP Test ACT | BP Menu LCD + | 1.CH4 |  |  |  |  |  |  |  |  |  |  |  | D11
PE15 | I | GPIO |  | BP 4 |  | BP Test ACT | BP Menu LCD - | 1.BKIN |  |  |  |  |  |  |  |  |  |  |  | D12
PH0 |  | OSC | OSC_IN | - | Oscillateur Quartz |  |  |  |  |  |  |  |  |  |  |  |  |  |  |  |  | OSC_IN
PH1 |  | OSC | OSC_OUT | - |  |  |  |  |  |  |  |  |  |  |  |  |  |  |  |  |  | OSC_OUT
 |  |  |  |  |  |  | GND
 |  |  |  |  |  |  | GND
 |  |  |  |  |  |  | 5V
 |  |  |  |  |  |  | 3V_Strat
 |  |  |  |  |  |  | BACKUP1
 |  |  |  |  |  | En Bleu : vers capteurs/act | En jaune : vers carte LCD
 |  |  |  |  |  |  | Connecteur 20 HE10 (nappe)
 |  |  |  |  |  | En Vert : vers carte balllauncher
 |  |  |  |  |  |  | En couleur comme ca
 |  |  |  |  |  |  | Connecteur 16 HE10 (nappe)
 |  |  |  |  |  |  | vers RF/Xbee/Balise
 |  |  |  |  |  |  | 5V (pr balise)
 |  |  |  |  |  |  | 3V (pr RF et Xbee)
 |  |  |  |  |  |  | GND
 |  |  |  |  |  |  | GND

Sheet: SELFTEST
Carte | Fonctionnalités | Nom du test | Vérifié pendant le selftest | Nécessite vérification utilisateur | Description | Test codé
PROPULSION | Switchs | PROP_SWITCHS |  | Commuter tout les SW | printf de l'état des switchs à chaque changement | 100%
 | BP bleu… | PROP_BP_SELFTEST |  | Appui sur BP bleu de la carte | déclenche le selftest de la propulsion | 100%
 | BP Calibration | PROP_BP_CALIBRATION |  | Appui sur Bouton Calibration | déclenche la calibration | 100%
 | LEDs | PROP_LEDS | X | Regarder les leds pdt selftest | toutes les leds clignotent ponctuellement pendant le selftest, selon leur rôle… | 100%
 | Codeurs, Moteurs | PROP_ASSERV | X |  | Une trajectoire simple suffit à prouver que les moteurs et les roues codeuses sont correctement reliés. | 100%
 | Hokuyo | PROP_HOKUYO | X |  | vérification qu'on obtient bien des infos du capteur | 90%
 | WHO_AM_I | PROP_WHO_AM_I | X |  | printf de who am i et renvoi au selftest pr vérif cohérence | 100%
ACTIONNEUR | SWITCHS / BP | ACT_SWITCHS_BP |  | Commuter tout les SW | printf de l'état des switchs à chaque changement | 0%
 | LEDs | ACT_LEDS | X | Regarder les leds pdt selftest | clignotent pendant le selftest | 0%
 | Balllauncher | ACT_BALLLAUNCHER |  | Lors d'un match, vérifier lancements des balles | Vérification faite en match.. Aucun autre moyen simple. | 0%
 | Bus 485 | ACT_AX12 | X |  | pilotage de tout les AX12 + compte rendu -> strat | 0%
 | Bus 485 diff | ACT_RX24 | X |  | pilotage de tout les RX24 + compte rendu -> strat | 0%
 | Moteurs… | ACT_MOTORS | X |  | Selon le robot, test de tout les actionneurs asservis / de la pompe dans les deux sens | 0%
 | WHO_AM_I | ACT_WHO_AM_I | X |  | printf de who am i et renvoi au selftest pr vérif cohérence | 100%
 | Capteurs | ACT_SENSORS | X |  | Se poser la question pour chaque robot.. Certains capteurs peuvent êtres stimulés par un mouvement du bras ??? | 0%
STRATEGIE | BP Run Match | STR_BP_RUN_MATCH |  | Appuyer sur bouton run match | le match se lance | 100%
 | SW + Leds Color | STR_COLOR |  | Actionner le switch color | vérifier impact sur les leds color | 100%
 | SW Debug | STR_SWITCHS |  | Actionner tout les switchs + vérifier fonctionnalités logicielles associées | printf de chaque changement de switch + bien vérifier le comportement de chaque fonctionnalités logicielle associée | 100%
 | SW Verbose |  |  |  |  | 100%
 | SW Xbee |  |  |  |  | 100%
 | SW Save |  |  |  |  | 100%
 | SW LCD |  |  |  |  | 100%
 | SW Evit |  |  |  |  | 100%
 | SW STRAT 1,2,3 |  |  |  |  | 100%
 | BP Selftest | STR_SELFTEST |  | Appuyez sur selftest | Le selftest se lance sur appui… | 100%
 | LCD, Leds/BP IHM | STR_BP_IHM |  | Appuyer sur les boutons IHM | Navigation dans le menu OK… Clignotement des leds pendant les appuis | 90%
 | LEDs Strategie | STR_LEDS | X | Regarder les leds pdt selftest | LEDs clignotent pendant le selftest | 100%
 | CAN | STR_CAN | X |  | ping/pong sur les cartes act et prop | 100%
 | SD Card | STR_SD | X |  | Ecriture d'un fichier selftest.txt. | 100%
 | RTC | STR_RTC | X | Vérifier date et heure | printf de l'état de la com' avec la RTC + rémontée au selftest en cas d'erreur d'accès | 100%
 | BP Print Match | STR_PRINT_MATCH |  | Appui sur Bouton Print Match | vérifier que le match est dépilé | 100%
 | Xbee | STR_XBEE |  | Allumer robot ami | En présence du robot ami, avant le début du match, la led color ne clignote plus… | 100%
 | RF + LED Beacon | STR_RF |  | Vérifier LED_Beacon_1_G quand tous les robots et toutes les balises sont allumées | LED BEACON rouge / vert sur FDP, vert quand le robot reçoit les paquets RF de tous les autres modules (autre robot + 2 balises émettrices). Le code selftest peut savoir lui même si c'est ok ou pas | 90%
 | Buzzer | STR_BUZZER | X | Vérifier le buzzer pendant le selftest | 4 bips au début, N bips à la fin, N étant le nombre d'erreurs rencontrées ! | 100%
 | Mesure 24V | STR_MEASURE24 | X | Vérifier l'état de la batterie | Afficher le résultat de la mesure 24V + remontée au selftest si trop faible | 100%
 | Who am I | STR_WHO_AM_I | X | Vérifier le who am i | Afficher le who am i + vérifier cohérence avec autres cartes | 100%
 | Biroute | STR_BIROUTE | X | Lancer un match avec Biroute | Vérifier que la biroute est présente. | 100%
 | Synchro balise | STR_BEACON | X | Regarder led beacon | Vérifier le retour de la carte balise | 0%

Sheet: FILTRES
Pin | ACTIONNEUR | Rsérie | Cplle | RpUp | RpDwn
PA0 |  |  |  |  |  | Non inscrit sur le FdP
PA1 | Codeur2B | 1k | 100p | - | -
PA2 | MAX485dif(RFU) | - | - | - | -
PA3 | MAX485dif(RFU) | - | - | - | -
PA4 | - | - | - | - | -
PA5 | MAX485dif(RFU) | - | - | - | -
PA6 |  | - | - | - | -
PA7 | (ADC7) SW présence Filet | cf commentaire onglet pins_usages
PA8 | Sens1 | - | - | - | -
PA9 | - | - | - | - | -
PA10 | - | - | - | - | -
PA11 | - | - | - | - | -
PA12 | - | - | - | - | -
PA13 |  | - | - | - | -
PA14 |  | - | - | - | -
PA15 | Codeur2A | 1k | 100p | - | -
PB0 | ADC 8 - fin course vérin sorti | 10k | 100n | 10k | -
PB1 | ADC 9 - fin course vérin entré | 10k | 100n | 10k | -
PB2 | IT Externe.. | - | - | - | -
PB3 |  | - | - | - | -
PB4 | Codeur1A | 1k | 100p | - | -
PB5 | Codeur1B | 1k | 100p | - | -
PB6 | U1TX | - | - | - | -
PB7 | U1RX | - | - | - | -
PB8 |  | - | - | - | -
PB9 | BallLauncher1 | - | - | - | 10k
PB10 | BallLauncher2 | - | - | - | 10k
PB11 | MAX485_Sens | - | - | - | -
PB12 | BallLauncher3 | - | - | - | 10k
PB13 | BallLauncher4 | - | - | - | 10k
PB14 | BallLauncher5 | - | - | - | 10k
PB15 | BallLauncher6 | - | - | - | 10k
PC0 | - | - | - | - | -
PC1 | ADC 11 - potar hauteur bras | 100 | 10n | - | -
PC2 | ADC 12
PC3 | (ADC 13) - Présence feu WT100 | 10k | 100n | - | 150
PC4 | ADC 14 - hauteur bras (courant) | 10k | 100n | - | -
PC5 | ADC 15 - POMPE (courant) | 10k | 100n | - | -
PC6 | PWM1 - P_updown / G_Pompe | - | - | - | -
PC7 | PWM2 - P_Labium / G_updown | - | - | - | -
PC8 | PWM3 - P_Pompe_Arm | - | - | - | -
PC9 | PWM4 - P_Pompe_Small_Arm | - | - | - | -
PC10 | Sens2 | - | - | - | -
PC11 | Sens3 | - | - | - | -
PC12 | Sens4 | - | - | - | -
PC13 | WHO_AM_I | - | - | 10 | 10
PC14 |  | - | - | - | -
PC15 |  | - | - | - | -
PD0 | CAN_RX | - | - | - | -
PD1 | CAN_TX | - | - | - | -
PD2 | TOR - gache libération filet | - | - | - | -
PD3 | TOR | - | - | - | -
PD4 | - | - | - | - | -
PD5 | - | - | - | - | -
PD6 | (RFU) | - | - | - | -
PD7 | (RFU) | - | - | - | -
PD8 | MAX485_TX | - | - | - | -
PD9 | MAX485_RX | - | - | - | -
PD10 | LED ERROR | - | - | - | -
PD11 | LED SELFTEST | - | - | - | -
PD12 | LED RUN | - | - | - | -
PD13 | LED CAN | - | - | - | -
PD14 | LED UART | - | - | - | -
PD15 | LED_USER | - | - | - | -
PE0 | - | - | - | - | -
PE1 | - | - | - | - | -
PE2 |  | - | - | - | -
PE3 |  | - | - | - | -
PE4 |  | - | - | - | -
PE5 |  | - | - | - | -
PE6 |  | - | - | - | -
PE7 | SW divers | 1k | 100n | 100k | -
PE8 | SW divers | 1k | 100n | 100k | -
PE9 | SW divers | 1k | 100n | 100k | -
PE10 | SW divers | 1k | 100n | 100k | -
PE11 | SW divers | 1k | 100n | 100k | -
PE12 | BP Test ACT | 1k | 100n | 100k | -
PE13 | BP Test ACT | 1k | 100n | 100k | -
PE14 | BP Test ACT | 1k | 100n | 100k | -
PE15 | BP Test ACT | 1k | 100n | 100k | -
PH0 |  | - | - | - | -
PH1 |  | - | - | - | -
