samuelpoiraud/robot/1_Propulsion/Convertisseur d'unité de propulsion.xlsx

Vert valeur à compléter
Bleue valeur automatique
Section | Description | Valeur | Unité
Codeur | Diamètre de la roue codeuse | 60 | mm
 | Nombre d'impulsion par tour | 1024 | pulse/tr
 | Distance entre les roues codeuses | 124 | mm
 | Résolution du codeur (quadrature) | 4096 | pulse/tr
 | Précision | 0.046 | mm
 | Odométrie coefficient translation | 0x0BC7 | mm.16.4096/impulsion/5ms
 | Odométrie coefficient rotation | 0x00018526 | rad.16.4096.1024/impulsions/5ms
Moteur | Vitesse nominal moteur | 9690 | tr/min
 | Couple nominal | 30.4 | mNm
 | Courant nominal | 1.5 | A
 | Couple de démarrage | 325 | mNm
 | Courant de démarrage | 15.6 | A
 | Constante de couple | 20.8 | mNm/A
 | Constante de vitesse | 460 | tr/min/V
 | Pente vitesse couple | 34 | tr/min/mNm
Réducteur | Réduction | 19
 | Vitesse maximum nominal | 8000 | tr/min
 | Vitesse maximum intermitente | 12000 | tr/min
 | Couple permanent max admissible | 2.25 | Nm
Vitesse & Couple | Accélération | 192 | mm.4096/5ms/5ms
 | Vitesse (Strat) | 244 | mm.4096/128/5ms
 | Vitesse (Prop) | 31232 | mm.4096/5ms
 | Diamètre roue | 72 | mm
 | Masse robot | 15 | Kg
 | Réduction moteur | 19
 | Vitesse robot | 1.525 | m/s
 | Accélération robot | 1.875 | m/s²
 | VitesseAngulaireRoue | 404.5188137 | tr/min
 | VitesseAngulaireMoteur | 7685.85746 | tr/min
 | Force moteur | 28.125 | N
 | Couple par roue | 0.5062 | Nm
 | Couple par moteur | 0.0266 | Nm
