samuelpoiraud/robot/_Hard/_PORTS.xls

Sheet: 2013_Tiny_Krusty
CARTE | SUP |  |  |  |  |  | STRAT |  |  |  |  |  | ACT |  |  |  |  |  | PROP |  |  |  |  |  | BALISE MERE
PORT | I/O | Rsérie | Cplle | Rtir | Krusty | Tiny | I/O | Rsérie | Cplle | Rtir | Krusty | Tiny | I/O | Rsérie | Cplle | Rtir | Krusty | Tiny | I/O | Rsérie | Cplle | Rtir | Krusty | Tiny | I/O | Rsérie | Cplle | Rtir | Usage
RD0 ou IC8 | - |  |  |  | - |  | - |  |  |  | X |  | O |  |  |  | - | - | - |  |  |  | - |  | - |  |  |  | -
RA15_INT3 | O | 100 | - | - | Reset Xbee |  | - | - | - | - | X |  | I |  |  |  | - | - | - | - | - | - | - |  | I | 100 | 100n | - | IR B3
RA14_INT4 | - | - | - | - | - |  | - | - | - | - | X |  | I |  |  |  | - | - | - | - | - | - | - |  | I |  |  | - | -
RG2_SCL | IO |  |  | - | SCL I2C RTC |  | - |  |  | - | X |  | - |  |  | - | - | - | - |  |  | - | - |  | O |  |  | - | ResetXBee
RG3_SDA | IO |  |  | - | SDA I2C RTC |  | - |  |  | - | X |  | - |  |  | - | - | - | - |  |  | - | - |  | - |  |  | - | -
RE0 | I |  |  |  | Xbee ON/OFF |  | - |  |  |  | choix Strat (haut = 0 !) (inter de gauche) |  | O |  |  |  | sens 1 - ascenseur G | sens 1 - (réserve bras) | O |  |  |  | Sens1 |  | O |  |  |  | Synchro1
PWM1H/RE1 | I |  |  |  | eeprom on/off |  | - |  |  |  | choix Strat (haut = 0 !) (inter du milieu) |  | O |  |  |  | pwm1 - ascenseur G | pwm1 - (réserve bras) | O |  |  |  | PWM1 |  | I |  |  |  | -
RE2 | - |  |  |  | - |  | - |  |  |  | choix Strat (haut = 0 !) (inter de droite) |  | O |  |  |  | sens2 - ascenseur D | - | O |  |  |  | Sens2 |  | O |  |  |  | Synchro2
PWM2H/RE3 | - |  |  |  | - |  | - |  |  |  | Evitement (off = 0, on = 1) |  | O |  |  |  | pwm2 - ascenseur D | - | O |  |  |  | PWM2 |  | I |  |  |  | -
RE4 | - |  |  |  | - | - | - |  |  |  | Couleur (bleu = 0, rouge = 1) |  | O |  |  |  | sens3 - rotat° assiette | - | I |  |  |  | - |  | O |  |  |  | Synchro3
PWM3H/RE5 | I |  |  |  | 10k vers GND | 10k vers RE7 | I |  |  |  | 10k vers GND | 10k vers RE7 | O |  |  |  | pwm3 - rotat° assiette | - | I |  |  |  | 10k vers GND | 10k vers RE7 | I |  |  |  | -
RE6 | - |  |  |  | - |  | - |  |  |  | ??? Inter horizontal du bas… (0 à gauche) |  | O |  |  |  | sens4 - lanceur | - | I |  |  |  | - |  | O |  |  |  | Synchro4
PWM4H/RE7 | O |  |  |  | - | 10k vers RE5 | O |  |  |  | - | 10k vers RE5 | O |  |  |  | pwm4 - lanceur | - | O |  |  |  | - | 10k vers RE5 | I |  |  |  | -
RG6_SCK2 | O |  |  |  | SCK SPI EEPROM |  | O |  |  |  | Leds bleu |  | - |  |  |  | (TOR1) réserve pr lanceur si utilisation du bras qui irait sur PWM4 ! | TOR1 : Gonfleur | O |  |  |  | CPLD_RESET |  | O |  |  |  | Led prés. BM
RG7_SDI2 | I |  |  |  | SDI SPI EEPROM |  | O |  |  |  | Leds rouge |  | - |  |  |  | X |  | O |  |  |  | CPLD_COM1 |  | O |  |  |  | Led prés B1
RG8_SDO2 | O |  |  |  | SDO SPI EEPROM |  | I |  |  |  | Biroute |  | O |  |  |  | MAX485_sens |  | O |  |  |  | CPLD_COM2 |  | O |  |  |  | Led prés B2
RG9_SS2 | O |  |  |  | SS SPI EEPROM |  | - |  |  |  | X |  | O |  |  |  | RemoteServo |  | O |  |  |  | CPLD_COM3 |  | O |  |  |  | Led BatLow
RE8_INT1 | O | 100 | - | - | WP eeprom |  | - | - | - | - | X | X | I | 10k | 10nF | 100k | 5V effet Hall lanceur | 24V color tt DIG Red | I | 10k | 1nF | 100k | Codeur 1 A |  | I | 100 | 100n | - | IR B1
RE9_INT2 | O | 100 | - | - | hold eeprom |  | - | - | - | - | X | X | I | 10k | 10nF | 100k | 5V barrière laser | 24V color tt DIG Blue | I | 10k | 1nF | 100k | Codeur 1 B |  | I | 100 | 100n | - | IR B2
RB5_QEB | O | 100 | - | - | led prop ko |  | I | 10k | 100n | 100k | 24V : verre G WT100 |  | I |  |  |  |  |  | I | 10k | 1nF | 100k | Codeur 2 A |  | I | - | - | - | -
RB4_QEA | O | 100 | - | - | led prop ok |  | I | - | - | - | X | X | I |  |  |  |  |  | I | 10k | 1nF | 100k | Codeur 2 B |  | I | - | - | - | -
RB3 | - | - | - | - | - |  | I | 10k | 100n | 100k | 24V : verre D WT100 |  | I | 10k | 100nF | - | 5V potar asc G | (potar bras haut) | I | 10k | 1uF | - | SondeCrt1 |  | I | - | - | - | -
RB2 | - | - | - | - | - |  | I | - | - | - | X | X | I | 10k | 100nF | - | 5V potar asc D | 24V tritronic + ANA | I | 10k | 1uF | - | SondeCrt2 |  | I | 10k | 1uF | - | MesureVBat
RB15 | O | 100 | - | - | led act ok |  | I | 10k | 100n | 100k | 24V DT10 verres à distance | (réserve 24V DT10) | I | - | - | - | X | X | I | 100 | 1nF | 100k | CPLD_OUT_0 |  | I | - | - | - | -
RB14 | O | 100 | - | - | led act ko |  | I | - | - | - | X | X | I | - | - | - | X | X | I | 100 | 1nF | 100k | CPLD_OUT_1 |  | I | - | - | - | -
RB13 | O | 100 | - | - | led strat ok |  | I | 10k | 100n | 100k | 24V DT50 cadeau + bougies | (réserve 24V DT10) | I | 10k | 100nF | 100k | CS84-N3612 : Q3 | tritronics color ANA Red | I | 100 | 1nF | 100k | CPLD_OUT_2 |  | I | - | - | - | -
RB12 | O | 100 | - | - | led strat ko |  | I | - | - | - | X | X | I | 10k | 100nF | 100k | CS84-N3612 : Q2 | tritronics color ANA Blue | I | 100 | 1nF | 100k | CPLD_OUT_3 |  | I | - | - | - | -
RB11 | O | 100 | - | - | led balise ok |  | I | - | - | - | X | X | I | - | - | - | X | X | I | 100 | 1nF | 100k | CPLD_OUT_4 |  | I | - | - | - | -
RB10 | O | 100 | - | - | led balise ko |  | I | - | - | - | X | X | I | - | - | - | X | X | I | 100 | 1nF | 100k | CPLD_OUT_5 |  | I | - | - | - | -
RB9 | O | 100 | - | - | led robot ok |  | I | - | - | - | I/O |  | I | 10k | 100nF | - | 5V potar rotat° assiette | Sick color Blue | I | 100 | 1nF | 100k | CPLD_OUT_6 |  | I | - | - | - | -
RB8 | O | 100 | - | - | led robot ko |  | I | - | - | - | X | X | I | 10k | 100nF | 100k | CS84-N3612 : Q1 + 24V | 24V Sick color Red | I | 100 | 1nF | 100k | CPLD_OUT_7 |  | I | - | - | - | -
RU2RX | I |  |  | - | U2R/Xbee/BT |  | I |  |  | - | UART2RX |  | I |  |  | - | MAX485_RX | MAX485_RX |  |  |  | - | - |  |  |  |  | 100k | Xbee
RU2TX | O |  |  | - | U2T/Xbee/BT |  | O |  |  | - | UART2TX |  | O |  |  | - | MAX485_TX | MAX485_TX |  |  |  | - | - |  |  |  |  | 100k | Xbee
RG0 (IT1) | I |  |  |  |  | VERBOSE U1 | I |  |  |  |  |  | I |  |  |  |  |  | I |  |  |  |  |  | I
RG1 (IT2) | I |  |  |  |  | DEBUG | I |  |  |  |  |  | I |  |  |  |  |  | I |  |  |  |  |  | I
RD4 (BP1) | I | 100k | 100n | 100k |  | run selftest | I | 100k | 100n | 100k | run calibration |  | I | 100k | 100n | 100k | vidage cerises | bras bas posit° haute/bougie | I | 100k | 100n | 100k |  | run calibration | I | 100k | 100n | 100k
RD5 (BP2) | I | 100k | 100n | 100k |  | send match | I | 100k | 100n | 100k | run match |  | I | 100k | 100n | 100k | préhension assiette | verre G | I | 100k | 100n | 100k |  |  | I | 100k | 100n | 100k
RD6 (BP3) | I | 100k | 100n | 100k |  |  | I | 100k | 100n | 100k |  |  | I | 100k | 100n | 100k | test ascenseur G | verre D | I | 100k | 100n | 100k |  |  | I | 100k | 100n | 100k
RD7 (BP4) | I | 100k | 100n | 100k |  |  | I | 100k | 100n | 100k |  |  | I | 100k | 100n | 100k | test ascenseur D | gonfleur 10sec (ON/OFF) | I | 100k | 100n | 100k |  |  | I | 100k | 100n | 100k
RD8 (LED RUN) | O | 1k |  |  |  |  | O | 1k |  |  |  |  | O | 1k |  |  |  |  | O | 1k |  |  |  |  | O | 1k
RD9 (LED CAN) | O | 1k |  |  |  | can rx | O | 1k |  |  |  | can rx | O | 1k |  |  |  | can rx | O | 1k |  |  |  | can rx | O | 1k
RD10 (LED UART) | O | 1k |  |  |  | uart rx | O | 1k |  |  |  | uart rx | O | 1k |  |  |  | uart rx | O | 1k |  |  |  | uart rx | O | 1k
RD11 (LED USER) | O | 1k |  |  |  |  | O | 1k |  |  |  |  | O | 1k |  |  |  |  | O | 1k |  |  |  |  | O | 1k
RD12 (LED USER2) | O | 1k |  |  |  |  | O | 1k |  |  |  |  | O | 1k |  |  |  |  | O | 1k |  |  |  |  | O | 1k
RD13 (LED ERROR) | O | 1k |  |  |  |  | O | 1k |  |  |  |  | O | 1k |  |  |  |  | O | 1k |  |  |  |  | O | 1k
 |  |  |  |  |  |  |  |  |  |  | Disponible sur FDP
 |  |  |  |  |  |  |  |  |  |  | carte Actioneur
 |  |  |  |  |  |  |  |  |  |  | 4 moteurs
 |  |  |  |  |  |  |  |  |  |  | 2 codeurs
 |  |  |  |  |  |  |  |  |  |  | 1 pilotage servos
 |  |  |  |  |  |  |  |  |  |  | 4 ports I/O (24V ou 5V) |  |  | Tritronics CW-2 (config NPN, xyY)
 |  |  |  |  |  |  |  |  |  |  | 1 sortie TOR 24V |  |  | couleur fil |  |  | signal capteur | Port du dsPIC
 |  |  |  |  |  |  |  |  |  |  | 1 port input capture |  |  | Black |  |  | CH1 (Rouge numérique) | RE8_INT1 (pullup 100k sur la carte)
 |  |  |  |  |  |  |  |  |  |  |  |  |  | White |  |  | CH2 (Bleu numérique) | RE9_INT2 (pullup 100k sur la carte)
 |  |  |  |  |  |  |  |  |  |  |  |  |  | Red/White |  |  | Analog x (rouge) | RB13 (pas de tirage, sortie 0-5V)
 |  |  |  |  |  |  |  |  |  |  | carte Stratégie |  |  | Green/white |  |  | Analog y (vert) | RB12 (pas de tirage, sortie 0-5V)
 |  |  |  |  |  |  |  |  |  |  | 1 UART2 |  |  | Blue/white |  |  | Analog Y (VERT) | RB2 (pas de tirage, sortie 0-5V)
 |  |  |  |  |  |  |  |  |  |  | 5 ports I/O (24V ou 5V) |  |  | Brown |  |  | 24V
 |  |  |  |  |  |  |  |  |  |  |  |  |  | Blue |  |  | 0V
 |  |  |  |  |  |  |  |  |  |  |  |  |  | SICK CS84-N3612 (config NPN, Q1, Q2, Q3)
 |  |  |  |  |  |  |  |  |  |  |  |  |  | couleur fil |  |  | signal capteur | Port du dsPIC
 |  |  |  |  |  |  |  |  |  |  |  |  |  | 2 – Marron |  |  | 24V | 24V
 |  |  |  |  |  |  |  |  |  |  |  |  |  | 3 – Vert |  |  | Q1 | RB8 (pull up 100k, tirage)
 |  |  |  |  |  |  |  |  |  |  |  |  |  | 4 – Blanc |  |  | Q2 | RB12 (pull up)
 |  |  |  |  |  |  |  |  |  |  |  |  |  | 6 – Noir |  |  | Q3 | RB13 (pull up)
 |  |  |  |  |  |  |  |  |  |  |  |  |  | 7 – Bleu |  |  | 0V | GND

Sheet: 2012_Shark
CARTE | SUP |  |  |  |  | ACT |  |  |  |  | STRAT |  |  |  |  | PROP |  |  |  |  | BALISE MERE
PORT | I/O | Rsérie | Cplle | Rtir | Usage | I/O | Rsérie | Cplle | Rtir | Usage | I/O | Rsérie | Cplle | Rtir | Usage | I/O | Rsérie | Cplle | Rtir | Usage | I/O | Rsérie | Cplle | Rtir | Usage
RD0 | - |  |  |  | - | O |  |  |  | I/O | - |  |  |  | - | - |  |  |  | - | - |  |  |  | -
RA15_INT3 | - | - | - | - | - | I | 100k | 100nF | 100k | SW_ASC_ARR | - | - | - | - | - | - | - | - | - | - | I | 100 | 100n | - | IR B3
RA14_INT4 | - | - | - | - | - | I | 100k | 100nF | 100k | SW_ASC_AV | - | - | - | - | - | - | - | - | - | - | I |  |  | - | -
RG2_SCL | - |  |  | - | - | - |  |  | - | - | - |  |  | - | - | - |  |  | - | - | O |  |  | - | ResetXBee
RG3_SDA | - |  |  | - | - | - |  |  | - | - | - |  |  | - | - | - |  |  | - | - | - |  |  | - | -
RE0 | - |  |  |  | - | O |  |  |  | Sens1 | - |  |  |  | - | O |  |  |  | Sens1 | O |  |  |  | Synchro1
PWM1H/RE1 | - |  |  |  | - | O |  |  |  | PWM1 | - |  |  |  | - | O |  |  |  | PWM1 | I |  |  |  | -
RE2 | - |  |  |  | - | O |  |  |  | Sens2 | - |  |  |  | - | O |  |  |  | Sens2 | O |  |  |  | Synchro2
PWM2H/RE3 | - |  |  |  | - | O |  |  |  | PWM2 | - |  |  |  | - | O |  |  |  | PWM2 | I |  |  |  | -
RE4 | - |  |  |  | - | O |  |  |  | Sens3 | - |  |  |  | - | I |  |  |  | - | O |  |  |  | Synchro3
PWM3H/RE5 | - |  |  |  | - | O |  |  |  | PWM3 | - |  |  |  | - | I |  |  |  | - | I |  |  |  | -
RE6 | - |  |  |  | - | O |  |  |  | Sens4 | - |  |  |  | - | I |  |  |  | - | O |  |  |  | Synchro4
PWM4H/RE7 | - |  |  |  | - | O |  |  |  | PWM4 | - |  |  |  | - | I |  |  |  | - | I |  |  |  | -
RG6_SCK2 | - |  |  |  | - | - |  |  |  | tor1 | O |  |  |  | Leds bleu | O |  |  |  | CPLD_RESET | O |  |  |  | Led prés. BM
RG7_SDI2 | - |  |  |  | - | - |  |  |  | tor2 | O |  |  |  | Leds rouge | O |  |  |  | CPLD_COM1 | O |  |  |  | Led prés B1
RG8_SDO2 | - |  |  |  | - | O |  |  |  | MAX485_sens | I |  |  |  | Biroute | O |  |  |  | CPLD_COM2 | O |  |  |  | Led prés B2
RG9_SS2 | - |  |  |  | - | O |  |  |  | RemoteServo | - |  |  |  | - | O |  |  |  | CPLD_COM3 | O |  |  |  | Led BatLow
RE8_INT1 | O | 100 | - | - | WP eeprom | I | 10k | 1nF | 100k | COD_ASC_AV_A | - | - | - | - | - | I | 10k | 1nF | 100k | C1A | I | 100 | 100n | - | IR B1
RE9_INT2 | O | 100 | - | - | hold eeprom | I | 10k | 1nF | 100k | COD_ASC_AV_B | - | - | - | - | - | I | 10k | 1nF | 100k | C1B | I | 100 | 100n | - | IR B2
RB5_QEB | O | 100 | - | - | led prop ko | I | 10k | 1nF | 100k | COD_ASC_ARR_B | I | 10k | 100n | 100k | Sick DT50 G | I | 10k | 1nF | 100k | C2A | I | - | - | - | -
RB4_QEA | O | 100 | - | - | led prop ok | I | 10k | 1nF | 100k | COD_ASC_ARR_A | I | 10k | 100n | 100k | Sick DT50 D | I | 10k | 1nF | 100k | C2B | I | - | - | - | -
RB3 | - | - | - | - | - | I | 100k | 100nF | 100k | SW_PINCE_ARR | I | 10k | 100n | 100k | Sick DT10 | I | 10k | 1uF | - | SondeCrt1 | I | - | - | - | -
RB2 | - | - | - | - | - | I | 100k | 100nF | 100k | SW_PINCE_AV | I | 10k | 100n | 100k | Sick DT10 | I | 10k | 1uF | - | SondeCrt2 | I | 10k | 1uF | - | MesureVBat
RB15 | O | 100 | - | - | led act ok | I | 100k | 100nF | 100k | SHARP_ARR_D | I | TODO | TODO | TODO | I/O | I | 100 | 1nF | 100k | CPLD_OUT_0 | I | - | - | - | -
RB14 | O | 100 | - | - | led act ko | I | 100k | 100nF | 100k | SHARP_ARR_G | I | TODO | TODO | TODO | I/O | I | 100 | 1nF | 100k | CPLD_OUT_1 | I | - | - | - | -
RB13 | O | 100 | - | - | led strat ok | I | 100k | 100nF | 100k | SONDE_PINCE_AV | I | TODO | TODO | TODO | I/O | I | 100 | 1nF | 100k | CPLD_OUT_2 | I | - | - | - | -
RB12 | O | 100 | - | - | led strat ko | I | 100k | 100nF | 100k | SONDE_PINCE_ARR | I | TODO | TODO | TODO | I/O | I | 100 | 1nF | 100k | CPLD_OUT_3 | I | - | - | - | -
RB11 | O | 100 | - | - | led balise ok | I | 100k | 100nF | 100k | SHARP_AV_G | I | TODO | TODO | TODO | I/O | I | 100 | 1nF | 100k | CPLD_OUT_4 | I | - | - | - | -
RB10 | O | 100 | - | - | led balise ko | I | 100k | 100nF | 100k | SHARP_AV_D | I | TODO | TODO | TODO | I/O | I | 100 | 1nF | 100k | CPLD_OUT_5 | I | - | - | - | -
RB9 | O | 100 | - | - | led robot ok | I | 10k | 100nF | 100k | POTAR_AV | I | TODO | TODO | TODO | I/O | I | 100 | 1nF | 100k | CPLD_OUT_6 | I | - | - | - | -
RB8 | O | 100 | - | - | led robot ko | I | 10k | 100nF | 100k | POTAR_ARR | I | TODO | TODO | TODO | I/O | I | 100 | 1nF | 100k | CPLD_OUT_7 | I | - | - | - | -
RU2RX | I |  |  | - | UART2RX | I |  |  | - | MAX485_RX | I |  |  | - | UART2RX |  |  |  | - | - |  |  |  | 100k | Xbee
RU2TX | O |  |  | - | UART2TX | O |  |  | - | MAX485_TX | O |  |  | - | UART2TX |  |  |  | - | - |  |  |  | 100k | Xbee

Sheet: 2011_CheckNorris
CARTE | SUP |  |  |  |  | ACT |  |  |  |  | STRAT |  |  |  |  | PROP
PORT | I/O | Rsérie | Cplle | Rtir | Usage | I/O | Rsérie | Cplle | Rtir | Usage | I/O | Rsérie | Cplle | Rtir | Usage | I/O | Rsérie | Cplle | Rtir | Usage
RD0 | - |  |  |  | - | O |  |  |  | I/O | - |  |  |  | - | - |  |  |  | -
RA15_INT3 | - | - | - | - | - | I | 100k | 100nF | 100k | SW_ASC_ARR | - | - | - | - | - | - | - | - | - | -
RA14_INT4 | - | - | - | - | - | I | 100k | 100nF | 100k | SW_ASC_AV | - | - | - | - | - | - | - | - | - | -
RG2_SCL | - |  |  | - | - | - |  |  | - | - | - |  |  | - | - | - |  |  | - | -
RG3_SDA | - |  |  | - | - | - |  |  | - | - | - |  |  | - | - | - |  |  | - | -
RE0 | - |  |  |  | - | O |  |  |  | Sens1 | - |  |  |  | - | O |  |  |  | Sens1
PWM1H/RE1 | - |  |  |  | - | O |  |  |  | PWM1 | - |  |  |  | - | O |  |  |  | PWM1
RE2 | - |  |  |  | - | O |  |  |  | Sens2 | - |  |  |  | - | O |  |  |  | Sens2
PWM2H/RE3 | - |  |  |  | - | O |  |  |  | PWM2 | - |  |  |  | - | O |  |  |  | PWM2
RE4 | - |  |  |  | - | O |  |  |  | Sens3 | - |  |  |  | - | I |  |  |  | -
PWM3H/RE5 | - |  |  |  | - | O |  |  |  | PWM3 | - |  |  |  | - | I |  |  |  | -
RE6 | - |  |  |  | - | O |  |  |  | Sens4 | - |  |  |  | - | I |  |  |  | -
PWM4H/RE7 | - |  |  |  | - | O |  |  |  | PWM4 | - |  |  |  | - | I |  |  |  | -
RG6_SCK2 | - |  |  |  | - | - |  |  |  | tor1 | O |  |  |  | Leds bleu | O |  |  |  | CPLD_RESET
RG7_SDI2 | - |  |  |  | - | - |  |  |  | tor2 | O |  |  |  | Leds rouge | O |  |  |  | CPLD_COM1
RG8_SDO2 | - |  |  |  | - | O |  |  |  | MAX485_sens | I |  |  |  | Biroute | O |  |  |  | CPLD_COM2
RG9_SS2 | - |  |  |  | - | O |  |  |  | RemoteServo | - |  |  |  | - | O |  |  |  | CPLD_COM3
RE8_INT1 | O | 100 | - | - | WP eeprom | I | 10k | 1nF | 100k | COD_ASC_AV_A | - | - | - | - | - | I | 10k | 1nF | 100k | C1A
RE9_INT2 | O | 100 | - | - | hold eeprom | I | 10k | 1nF | 100k | COD_ASC_AV_B | - | - | - | - | - | I | 10k | 1nF | 100k | C1B
RB5_QEB | O | 100 | - | - | led prop ko | I | 10k | 1nF | 100k | COD_ASC_ARR_B | I | 10k | 100n | 100k | Sick DT50 G | I | 10k | 1nF | 100k | C2A
RB4_QEA | O | 100 | - | - | led prop ok | I | 10k | 1nF | 100k | COD_ASC_ARR_A | I | 10k | 100n | 100k | Sick DT50 D | I | 10k | 1nF | 100k | C2B
RB3 | - | - | - | - | - | I | 100k | 100nF | 100k | SW_PINCE_ARR | I | 10k | 100n | 100k | Sick DT10 | I | 10k | 1uF | - | SondeCrt1
RB2 | - | - | - | - | - | I | 100k | 100nF | 100k | SW_PINCE_AV | I | 10k | 100n | 100k | Sick DT10 | I | 10k | 1uF | - | SondeCrt2
RB15 | O | 100 | - | - | led act ok | I | 100k | 100nF | 100k | SHARP_ARR_D | I | TODO | TODO | TODO | I/O | I | 100 | 1nF | 100k | CPLD_OUT_0
RB14 | O | 100 | - | - | led act ko | I | 100k | 100nF | 100k | SHARP_ARR_G | I | TODO | TODO | TODO | I/O | I | 100 | 1nF | 100k | CPLD_OUT_1
RB13 | O | 100 | - | - | led strat ok | I | 100k | 100nF | 100k | SONDE_PINCE_AV | I | TODO | TODO | TODO | I/O | I | 100 | 1nF | 100k | CPLD_OUT_2
RB12 | O | 100 | - | - | led strat ko | I | 100k | 100nF | 100k | SONDE_PINCE_ARR | I | TODO | TODO | TODO | I/O | I | 100 | 1nF | 100k | CPLD_OUT_3
RB11 | O | 100 | - | - | led balise ok | I | 100k | 100nF | 100k | SHARP_AV_G | I | TODO | TODO | TODO | I/O | I | 100 | 1nF | 100k | CPLD_OUT_4
RB10 | O | 100 | - | - | led balise ko | I | 100k | 100nF | 100k | SHARP_AV_D | I | TODO | TODO | TODO | I/O | I | 100 | 1nF | 100k | CPLD_OUT_5
RB9 | O | 100 | - | - | led robot ok | I | 10k | 100nF | 100k | POTAR_AV | I | TODO | TODO | TODO | I/O | I | 100 | 1nF | 100k | CPLD_OUT_6
RB8 | O | 100 | - | - | led robot ko | I | 10k | 100nF | 100k | POTAR_ARR | I | TODO | TODO | TODO | I/O | I | 100 | 1nF | 100k | CPLD_OUT_7
RU2RX | I |  |  | - | UART2RX | I |  |  | - | MAX485_RX | I |  |  | - | UART2RX |  |  |  | - | -
RU2TX | O |  |  | - | UART2TX | O |  |  | - | MAX485_TX | O |  |  | - | UART2TX |  |  |  | - | -
