samuelpoiraud/robot/_Hard/2012_Balise/Emetteur_IR_et_US/transducteur.STEP

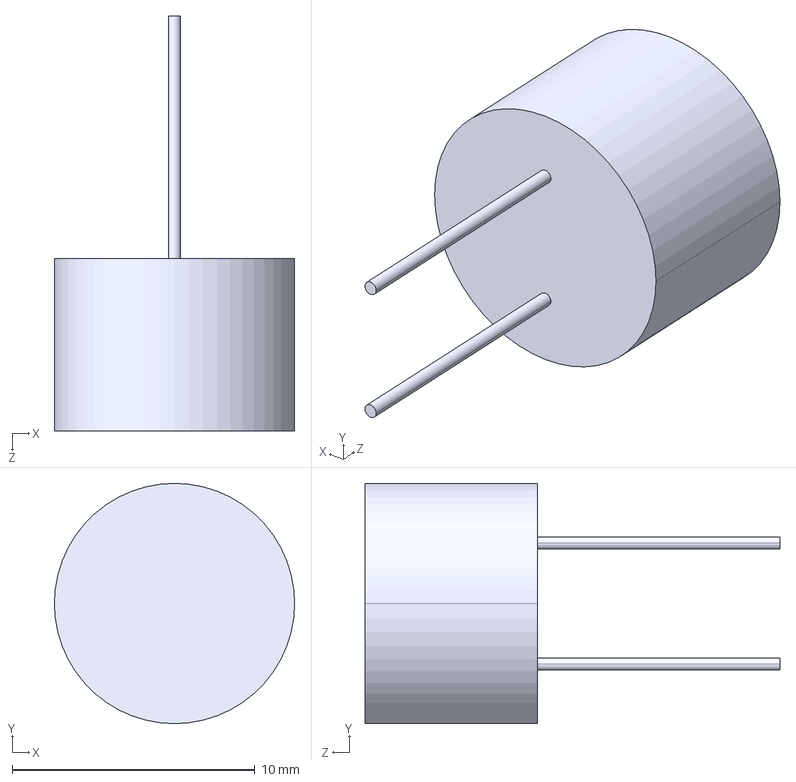
[picture p63: CAD file, 2013-01-31]
_Hard/2012_Balise/Emetteur_IR_et_US/transducteur.STEP
9.90 x 9.90 x 17.1 mm
