samuelpoiraud/robot/_Hard/2015_AX12DUPLICATOR/2015_AX12DUPLICATOR.step

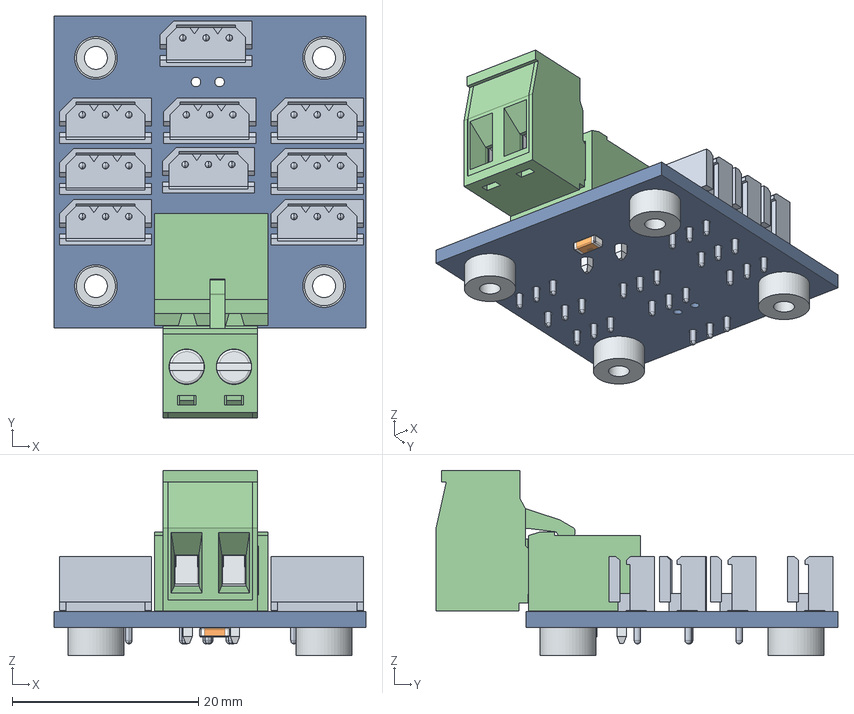
[picture p64: CAD file, 2016-11-25]
_Hard/2015_AX12DUPLICATOR/2015_AX12DUPLICATOR.step
33.5 x 43.2 x 19.9 mm
Board
WURTH_entretoises_cms_9774030360 x 4
1206_SMD_Capacitor
6913405000xx_CAGE x 2
6913405000xx_PIN x 2
6913405000xx_VISSE x 2
691340500002_CAPOT
6913135100xx_PIN x 2
Molex_Male_AX12 x 9
