samuelpoiraud/robot/_Hard/2016_Beacon/Pack 7.2V - 800mAh.STEP

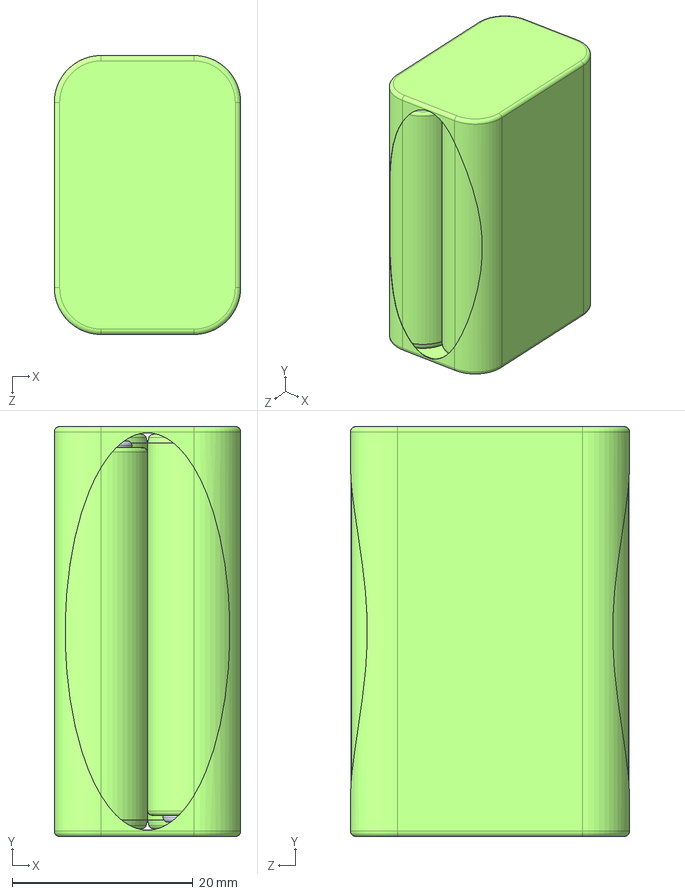
[picture p65: CAD file, 2015-06-17]
_Hard/2016_Beacon/Pack 7.2V - 800mAh.STEP
20.7 x 45.4 x 30.9 mm
Elément seul x 6
Gaine
