samuelpoiraud/robot/_Hard/2017_CHECK UP LED/2017_CHECK UP LED.step

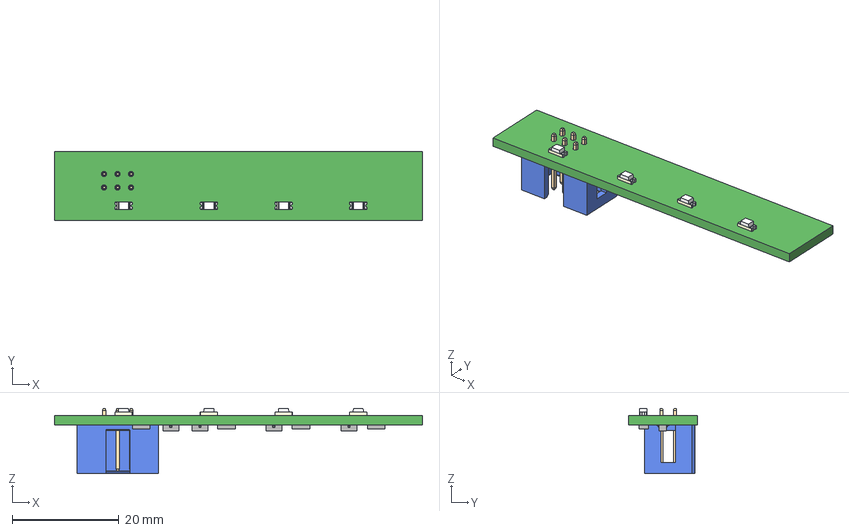
[picture p66: CAD file, 2016-12-15]
_Hard/2017_CHECK UP LED/2017_CHECK UP LED.step
69.0 x 13.0 x 12.2 mm
Board
R1206_2 x 4
Extruded x 8
LED1206CLAIRE x 4
SW3dPS-3-lead_sot23-3 x 4
he10-6_male_droit_bas_profil
