samuelpoiraud/robot/_Hard/_Libraries_Docs/Librairies_Altium_ROBOT/STEP/PontEnH_VNH5180A-E.STEP

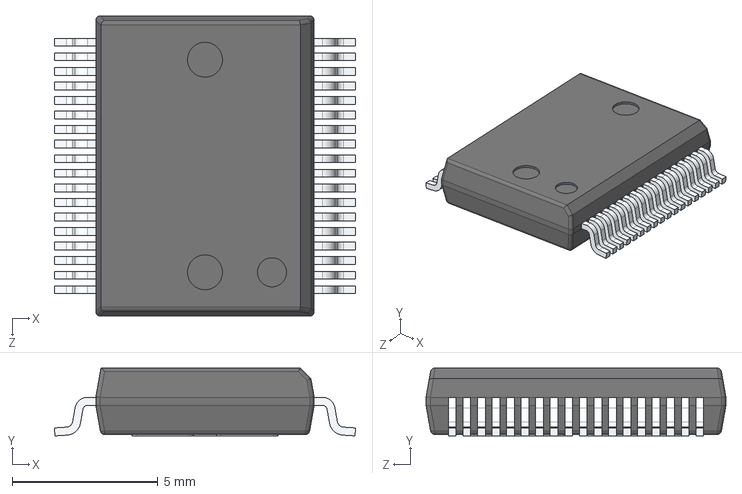
[picture p67: CAD file, 2017-01-10]
_Hard/_Libraries_Docs/Librairies_Altium_ROBOT/STEP/PontEnH_VNH5180A-E.STEP
10.3 x 2.33 x 10.3 mm
