samuelpoiraud/robot/_Hard/2016_Beacon/Moteur + Codeur.STEP

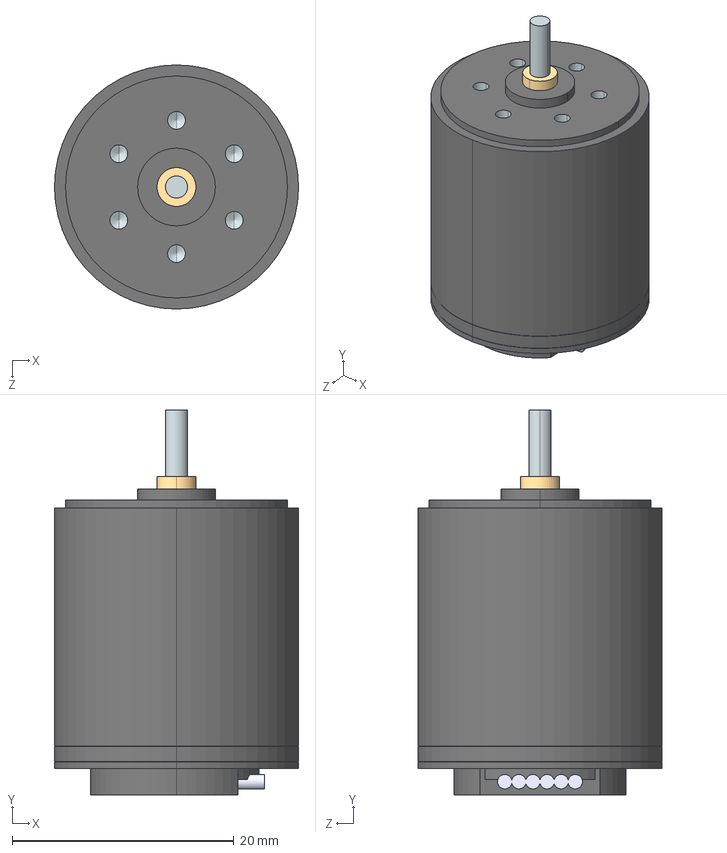
[picture p68: CAD file, 2015-06-03]
_Hard/2016_Beacon/Moteur + Codeur.STEP
22.0 x 34.7 x 22.0 mm
Moteur_2224USR
Codeur_IE2-64
