samuelpoiraud/robot/_Hard/_Libraries_Docs/Librairies_Altium_ROBOT/STEP/2.4_TFT_TOUCH.STEP

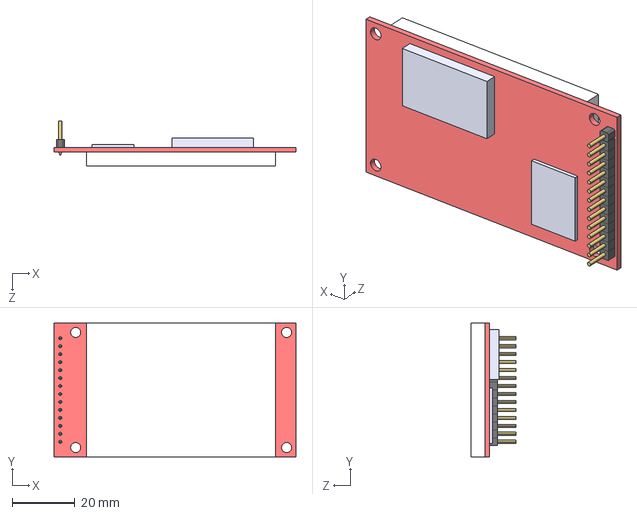
[picture p69: CAD file, 2016-09-12]
_Hard/_Libraries_Docs/Librairies_Altium_ROBOT/STEP/2.4_TFT_TOUCH.STEP
77.2 x 42.7 x 14.5 mm
