samuelpoiraud/robot/_Hard/_Libraries_Docs/Librairies_Altium_ROBOT/STEP/TO-247H.STEP

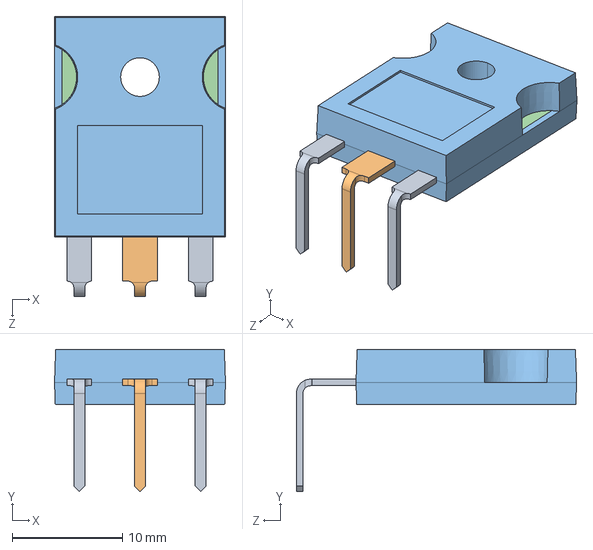
[picture p70: CAD file, 2015-11-04]
_Hard/_Libraries_Docs/Librairies_Altium_ROBOT/STEP/TO-247H.STEP
15.5 x 12.9 x 25.4 mm
