samuelpoiraud/robot/_Hard/_Libraries_Docs/Librairies_Altium_ROBOT/STEP/Radiocrafts_433MHz.STEP

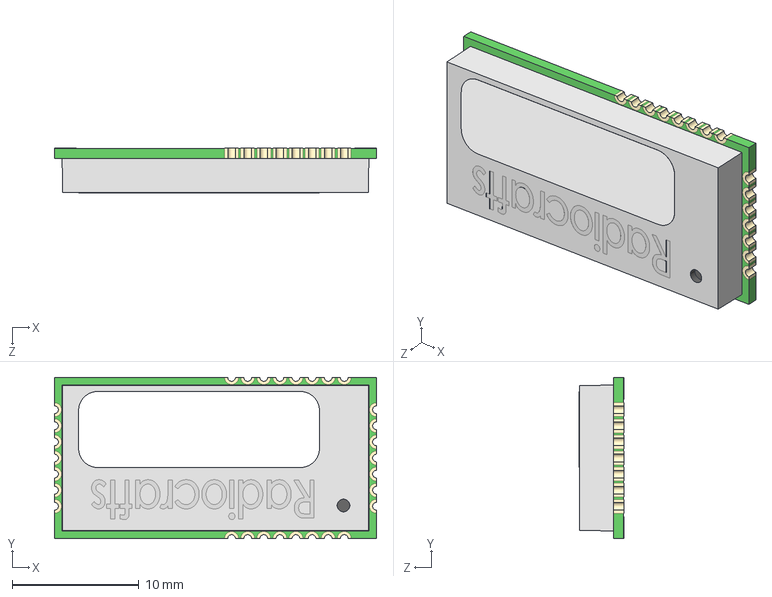
[picture p71: CAD file, 2015-06-18]
_Hard/_Libraries_Docs/Librairies_Altium_ROBOT/STEP/Radiocrafts_433MHz.STEP
25.4 x 12.7 x 3.51 mm
