samuelpoiraud/robot/_Hard/_Libraries_Docs/Librairies_Altium_ROBOT/STEP/WURTH_entretoises_cms_10mm_9774100360.stp

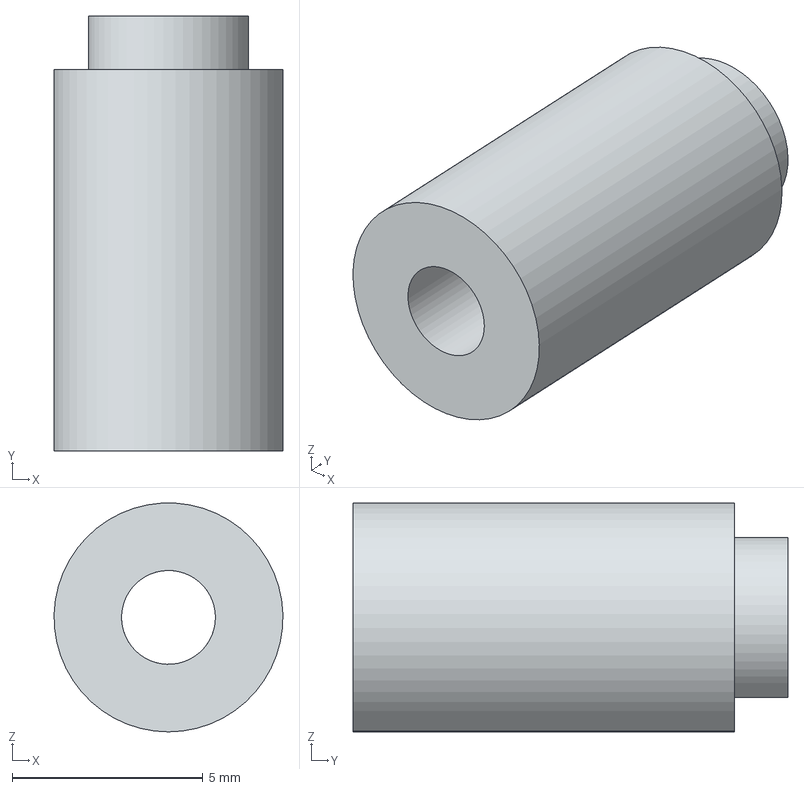
[picture p72: CAD file, 2015-06-15]
_Hard/_Libraries_Docs/Librairies_Altium_ROBOT/STEP/WURTH_entretoises_cms_10mm_9774100360.stp
6.00 x 11.4 x 5.99 mm
