samuelpoiraud/robot/_Hard/_Libraries_Docs/Librairies_Altium_ROBOT/STEP/Caps.STEP

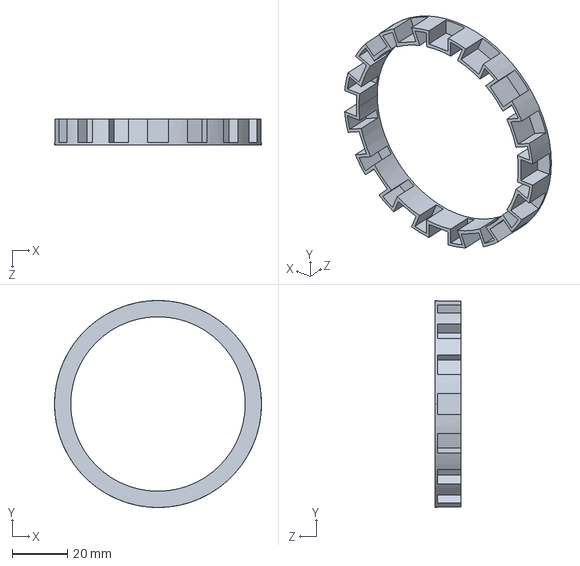
[picture p73: CAD file, 2015-06-15]
_Hard/_Libraries_Docs/Librairies_Altium_ROBOT/STEP/Caps.STEP
75.0 x 75.0 x 9.30 mm
