samuelpoiraud/robot/_Hard/_Libraries_Docs/Librairies_Altium_ROBOT/STEP/Antenne_433MHz.STEP

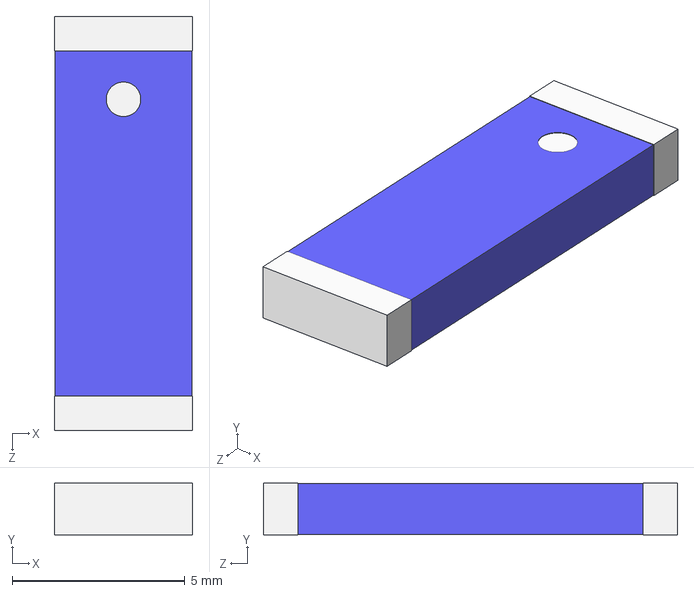
[picture p74: CAD file, 2015-06-15]
_Hard/_Libraries_Docs/Librairies_Altium_ROBOT/STEP/Antenne_433MHz.STEP
4.00 x 1.50 x 12.0 mm
