samuelpoiraud/robot/_Hard/_Libraries_Docs/Librairies_Altium_ROBOT/STEP/TSOP.STEP

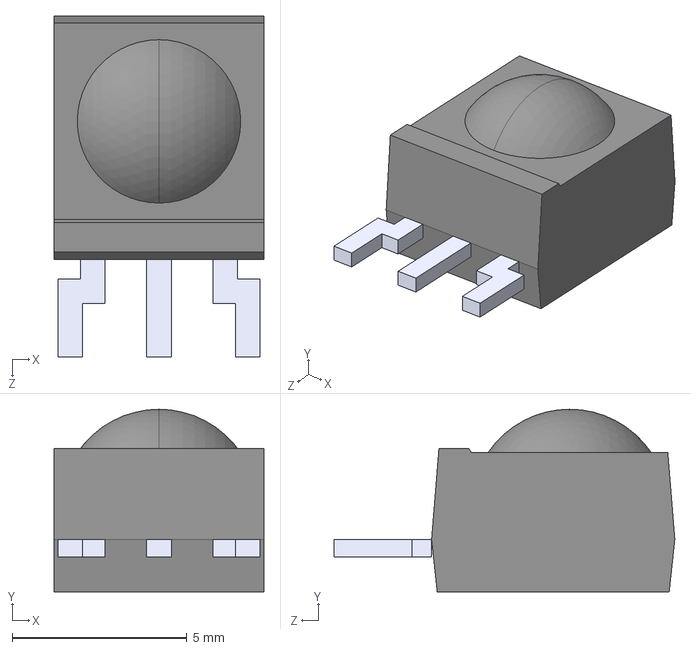
[picture p75: CAD file, 2015-06-04]
_Hard/_Libraries_Docs/Librairies_Altium_ROBOT/STEP/TSOP.STEP
6.00 x 5.22 x 9.73 mm
