samuelpoiraud/robot/_Hard/_Libraries_Docs/Librairies_Altium_ROBOT/STEP/WURTH_LED_side_view_WL-SMSW_1204.stp

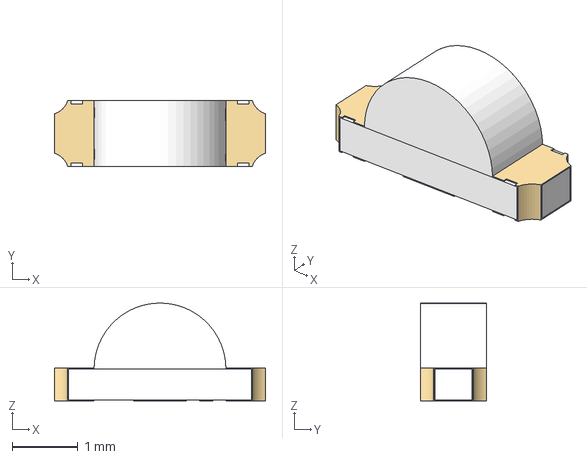
[picture p76: CAD file, 2015-05-26]
_Hard/_Libraries_Docs/Librairies_Altium_ROBOT/STEP/WURTH_LED_side_view_WL-SMSW_1204.stp
3.20 x 1.00 x 1.48 mm
