samuelpoiraud/robot/_Hard/_Libraries_Docs/Librairies_Altium_ROBOT/STEP/WURTH_DB25_male_618025231221.stp

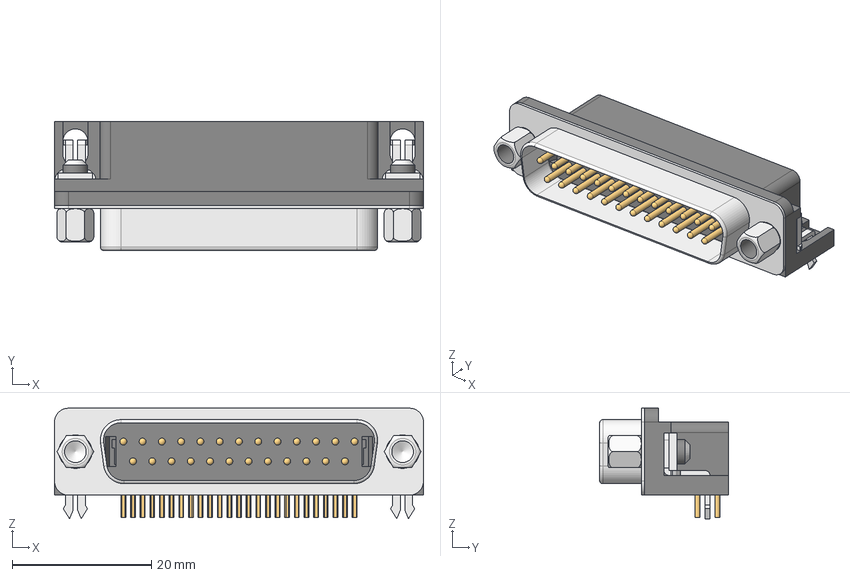
[picture p77: CAD file, 2015-05-26]
_Hard/_Libraries_Docs/Librairies_Altium_ROBOT/STEP/WURTH_DB25_male_618025231221.stp
53.0 x 18.5 x 15.9 mm
6180xx2xxx21_PIN_COURTE x 12
6180xx2xxx21_PIN_LONGUE x 13
6180xx2xxx21_CLIP x 2
6180xx231221_SERRAGE x 2
6180252xxx21 x 2
6180252xx221_ARRIERE
6180xx2xx221_VISSE x 2
