samuelpoiraud/robot/_Hard/_Libraries_Docs/Librairies_Altium_ROBOT/STEP/WURTH_DB25_femelle_618025231121.stp

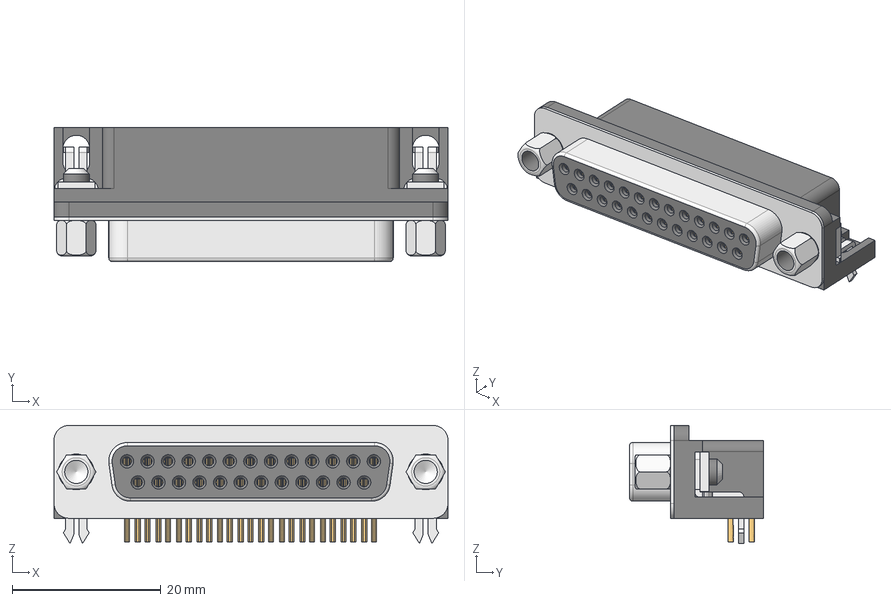
[picture p78: CAD file, 2015-05-26]
_Hard/_Libraries_Docs/Librairies_Altium_ROBOT/STEP/WURTH_DB25_femelle_618025231121.stp
53.0 x 18.1 x 15.9 mm
6180xx2xxx21_CLIP x 2
6180xx231221_SERRAGE x 2
6180xx2xx221_VISSE x 2
6180xx2xxx21_PIN _COURTE x 12
6180xx2xxx21_PIN _LONGUE x 13
6180252xxx21 x 2
6180252xx221_ARRIERE
