samuelpoiraud/robot/_Hard/_Libraries_Docs/Librairies_Altium_ROBOT/STEP/WURTH_8V_male_3.5mm_691321100008.stp

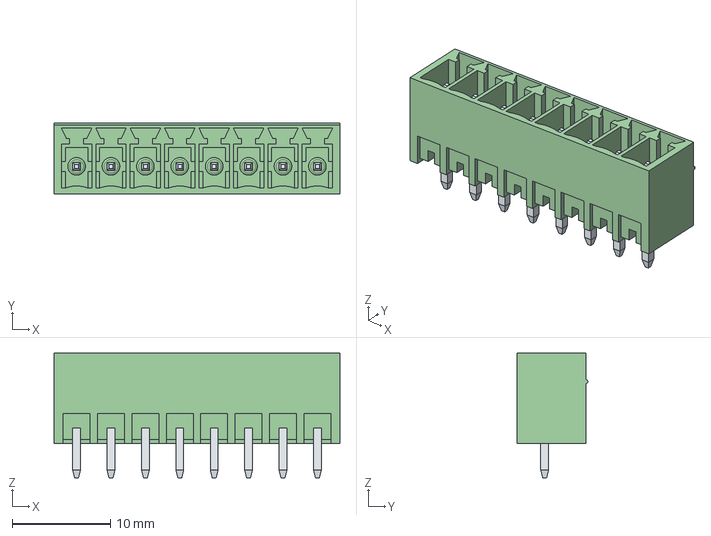
[picture p79: CAD file, 2014-10-07]
_Hard/_Libraries_Docs/Librairies_Altium_ROBOT/STEP/WURTH_8V_male_3.5mm_691321100008.stp
29.1 x 7.20 x 12.7 mm
6913211000xx_PIN x 8
