samuelpoiraud/robot/_Hard/_Libraries_Docs/Librairies_Altium_ROBOT/STEP/WURTH_8V_femelle_3.5mm_691363110008.stp

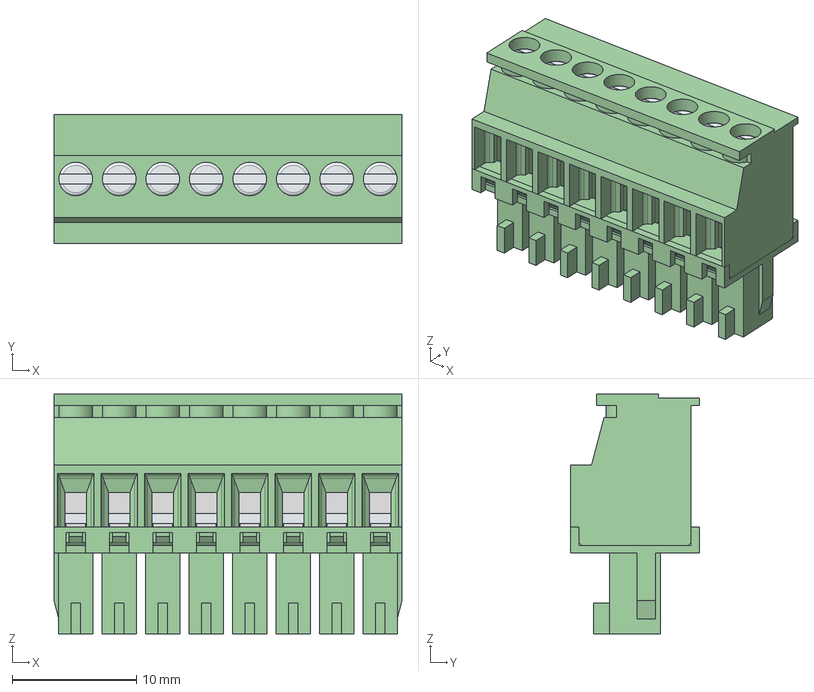
[picture p80: CAD file, 2014-10-07]
_Hard/_Libraries_Docs/Librairies_Altium_ROBOT/STEP/WURTH_8V_femelle_3.5mm_691363110008.stp
28.0 x 10.4 x 19.3 mm
6913631100xx_Cage x 8
6913631100xx_VIS x 8
6913631100xx x 8
691367110008_Bas
