samuelpoiraud/robot/_Hard/_Libraries_Docs/Librairies_Altium_ROBOT/STEP/WURTH_8V_male_3.5mm_coude_691322110008.stp

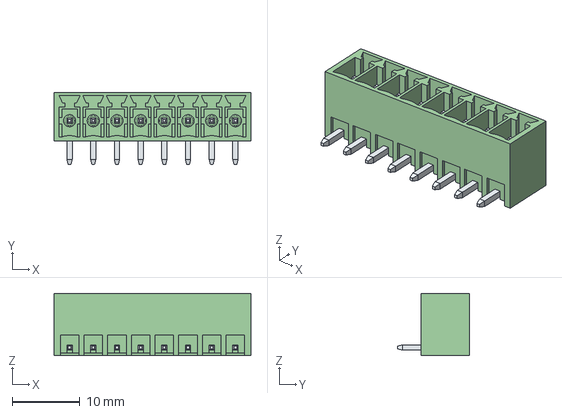
[picture p81: CAD file, 2014-10-07]
_Hard/_Libraries_Docs/Librairies_Altium_ROBOT/STEP/WURTH_8V_male_3.5mm_coude_691322110008.stp
29.1 x 10.7 x 9.20 mm
6913221100xx_PIN x 8
