samuelpoiraud/robot/_Hard/_Libraries_Docs/Librairies_Altium_ROBOT/STEP/USB_micro_coudé.STEP

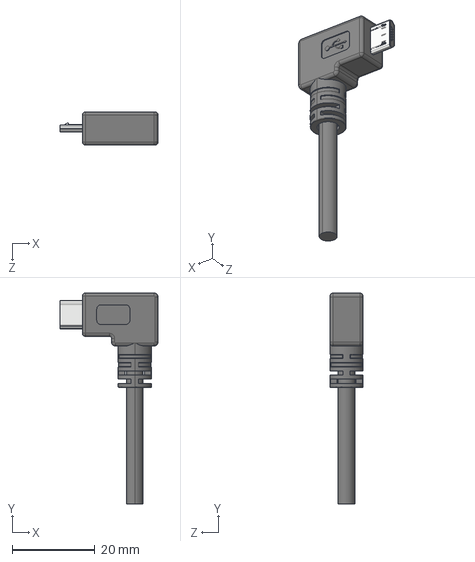
[picture p82: CAD file, 2014-09-21]
_Hard/_Libraries_Docs/Librairies_Altium_ROBOT/STEP/USB_micro_coudé.STEP
23.7 x 50.9 x 8.00 mm
