samuelpoiraud/robot/_Hard/_Libraries_Docs/Librairies_Altium_ROBOT/STEP/USB3105-30-A_revE.STEP

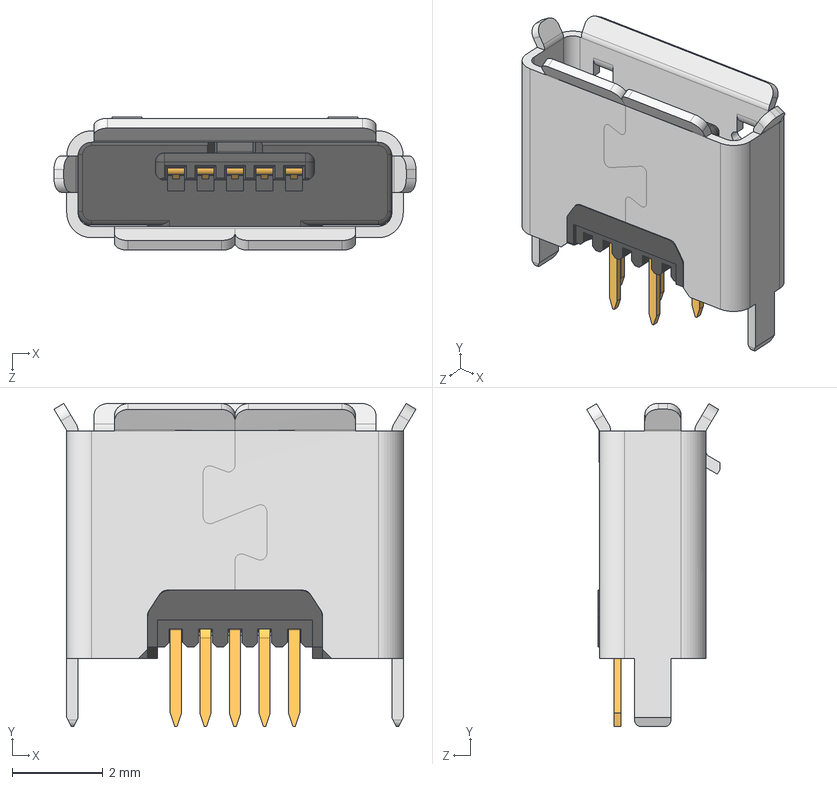
[picture p84: CAD file, 2014-09-21]
_Hard/_Libraries_Docs/Librairies_Altium_ROBOT/STEP/USB3105-30-A_revE.STEP
7.96 x 7.11 x 2.94 mm
HSG-1_A_DFKGJ
MICRO_TER
MICRO_TER_1
MICRO_TER_2
MICRO_TER_L
MICRO_TER_L_1
MICRO_USB_SHELL_A1_A_DFKGJ
