samuelpoiraud/robot/_Hard/_Libraries_Docs/Librairies_Altium_ROBOT/STEP/WURTH_3V_femelle_3.5mm_691363110003.stp

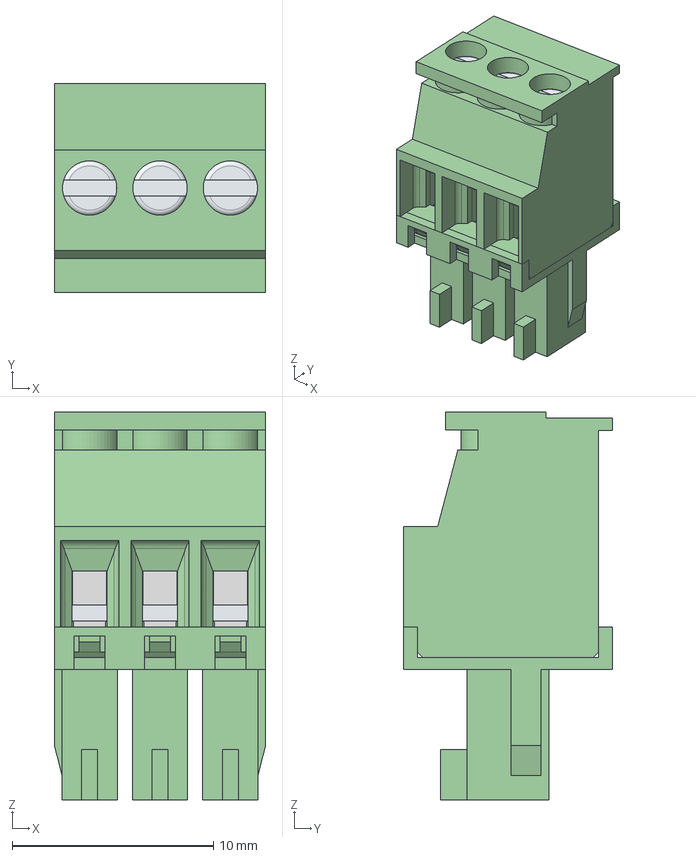
[picture p85: CAD file, 2014-09-21]
_Hard/_Libraries_Docs/Librairies_Altium_ROBOT/STEP/WURTH_3V_femelle_3.5mm_691363110003.stp
10.5 x 10.4 x 19.3 mm
6913631100xx_Cage x 3
6913631100xx_VIS x 3
6913631100xx x 3
691367110003_Bas
