samuelpoiraud/robot/_Hard/_Libraries_Docs/Librairies_Altium_ROBOT/STEP/WURTH_4V_male_3.5mm_691321100004.stp

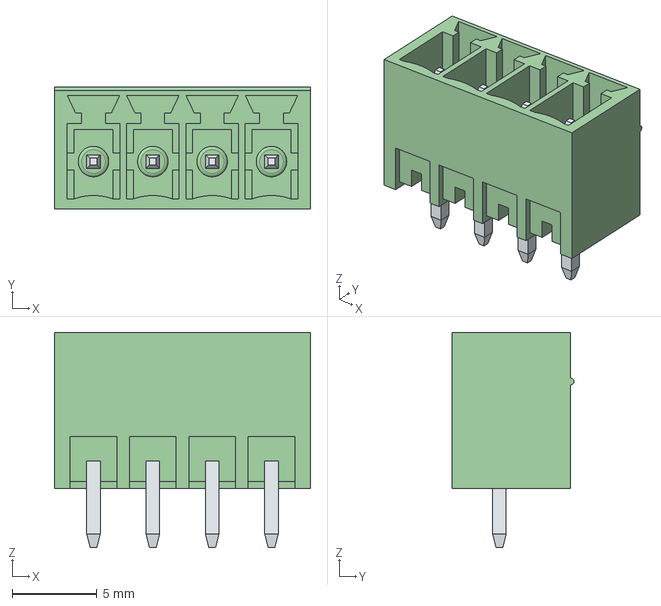
[picture p86: CAD file, 2014-09-21]
_Hard/_Libraries_Docs/Librairies_Altium_ROBOT/STEP/WURTH_4V_male_3.5mm_691321100004.stp
15.1 x 7.20 x 12.7 mm
6913211000xx_PIN x 4
