samuelpoiraud/robot/_Hard/_Libraries_Docs/Librairies_Altium_ROBOT/STEP/WURTH_2V_male_5.08mm_691311500102.stp

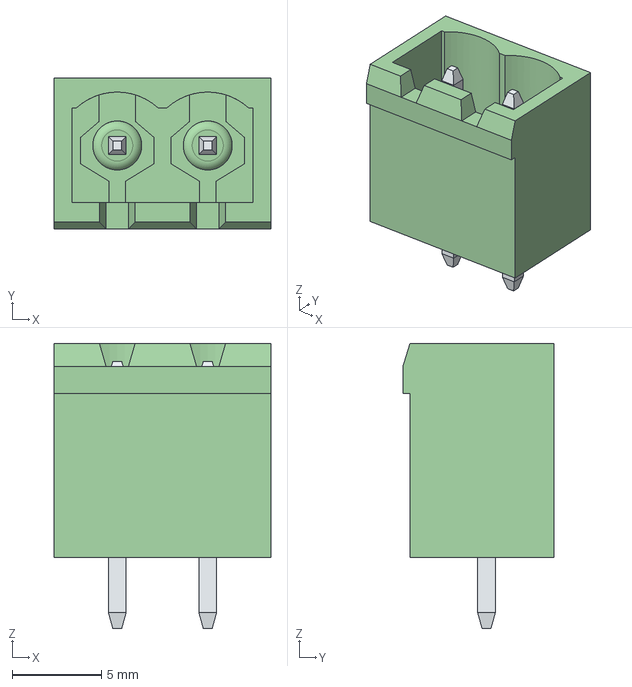
[picture p87: CAD file, 2014-09-21]
_Hard/_Libraries_Docs/Librairies_Altium_ROBOT/STEP/WURTH_2V_male_5.08mm_691311500102.stp
12.2 x 8.50 x 16.0 mm
6913115001xx_PIN x 2
