samuelpoiraud/robot/_Hard/_Libraries_Docs/Librairies_Altium_ROBOT/STEP/WURTH_4V_femelle_3.5mm_691363110004.stp

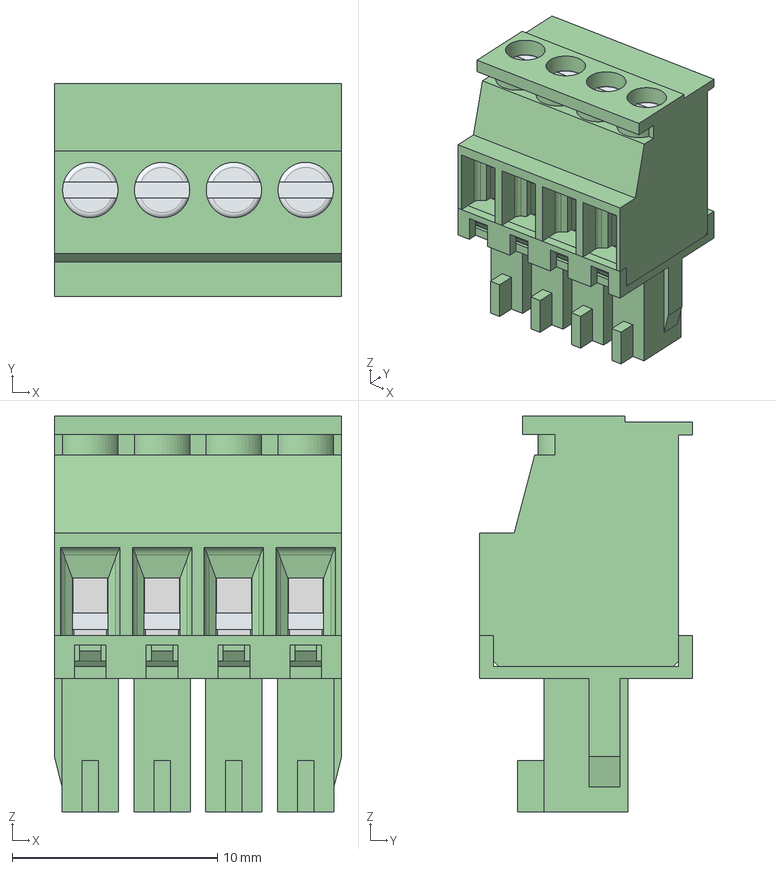
[picture p88: CAD file, 2014-09-21]
_Hard/_Libraries_Docs/Librairies_Altium_ROBOT/STEP/WURTH_4V_femelle_3.5mm_691363110004.stp
14.0 x 10.4 x 19.3 mm
6913631100xx_Cage x 4
6913631100xx_VIS x 4
6913631100xx x 4
691367110004_Bas
