samuelpoiraud/robot/_Hard/_Libraries_Docs/Librairies_Altium_ROBOT/STEP/WURTH_2V_femelle_5.08mm_691352510002.stp

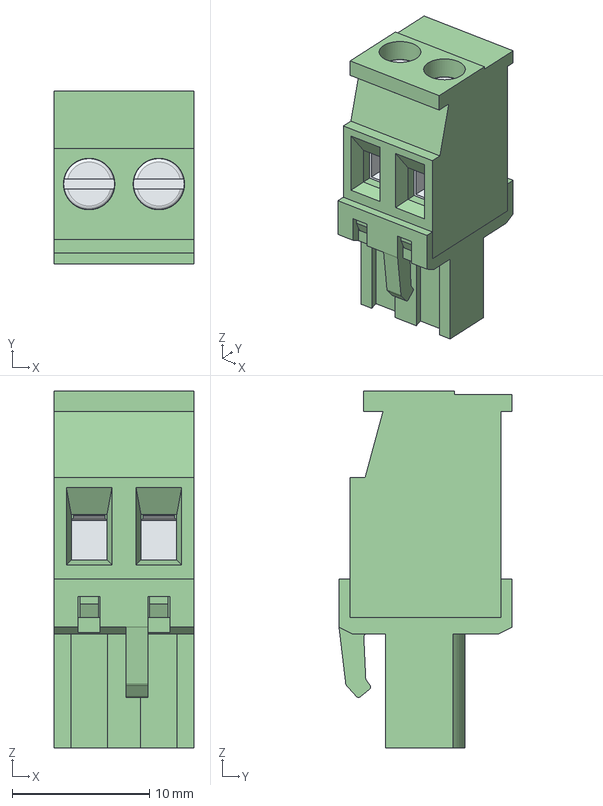
[picture p89: CAD file, 2014-09-21]
_Hard/_Libraries_Docs/Librairies_Altium_ROBOT/STEP/WURTH_2V_femelle_5.08mm_691352510002.stp
10.2 x 12.6 x 26.0 mm
6913525100xx_CAGE x 2
6913525100xx x 2
691343510002_BAS
6913525100xx_VIS x 2
