samuelpoiraud/robot/_Hard/_Libraries_Docs/Librairies_Altium_ROBOT/STEP/WURTH_6V_male_3.5mm_691322110006.stp

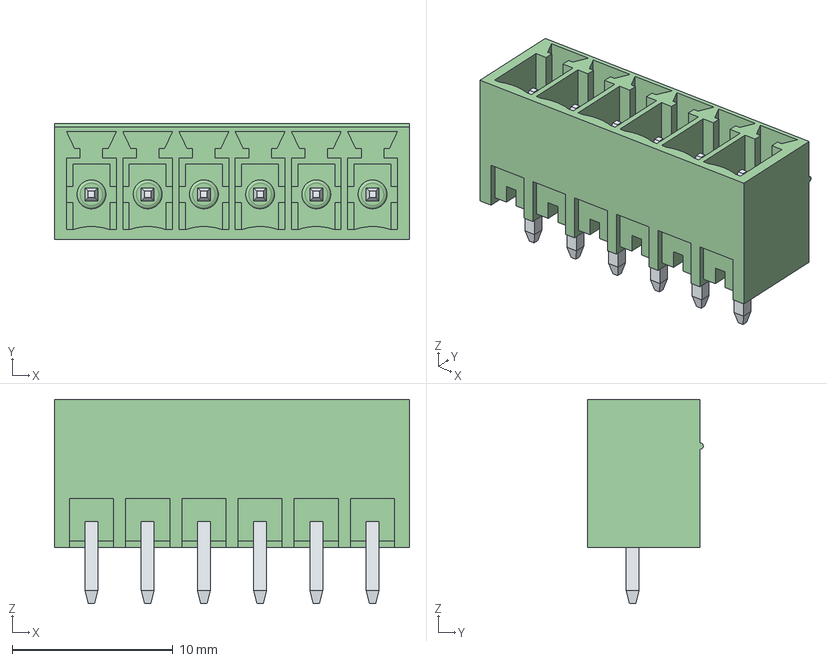
[picture p90: CAD file, 2014-09-21]
_Hard/_Libraries_Docs/Librairies_Altium_ROBOT/STEP/WURTH_6V_male_3.5mm_691322110006.stp
22.1 x 7.20 x 12.7 mm
6913211000xx_PIN x 6
