samuelpoiraud/robot/_Hard/_Libraries_Docs/Librairies_Altium_ROBOT/STEP/WURTH_2V_femelle_3.5mm_691363110002.stp

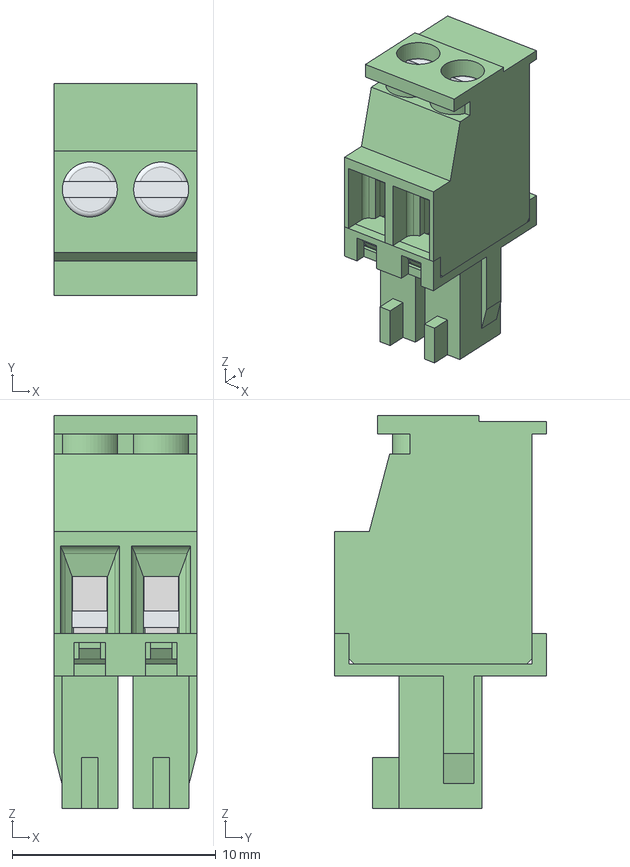
[picture p91: CAD file, 2014-09-21]
_Hard/_Libraries_Docs/Librairies_Altium_ROBOT/STEP/WURTH_2V_femelle_3.5mm_691363110002.stp
7.00 x 10.4 x 19.3 mm
6913631100xx_Cage x 2
6913631100xx_VIS x 2
6913631100xx x 2
691367110002_Bas
