samuelpoiraud/robot/_Hard/_Libraries_Docs/Librairies_Altium_ROBOT/STEP/WURTH_entretoises_cms_9774030360.stp

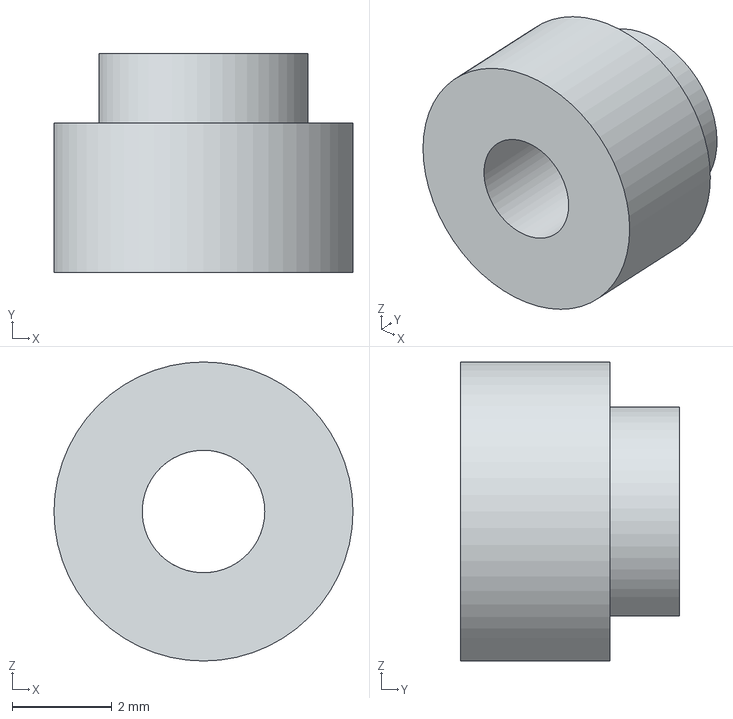
[picture p92: CAD file, 2014-09-21]
_Hard/_Libraries_Docs/Librairies_Altium_ROBOT/STEP/WURTH_entretoises_cms_9774030360.stp
6.00 x 4.40 x 6.00 mm
