samuelpoiraud/robot/_Hard/_Libraries_Docs/Librairies_Altium_ROBOT/STEP/WURTH_6V_femelle_3.5mm_691363110006.stp

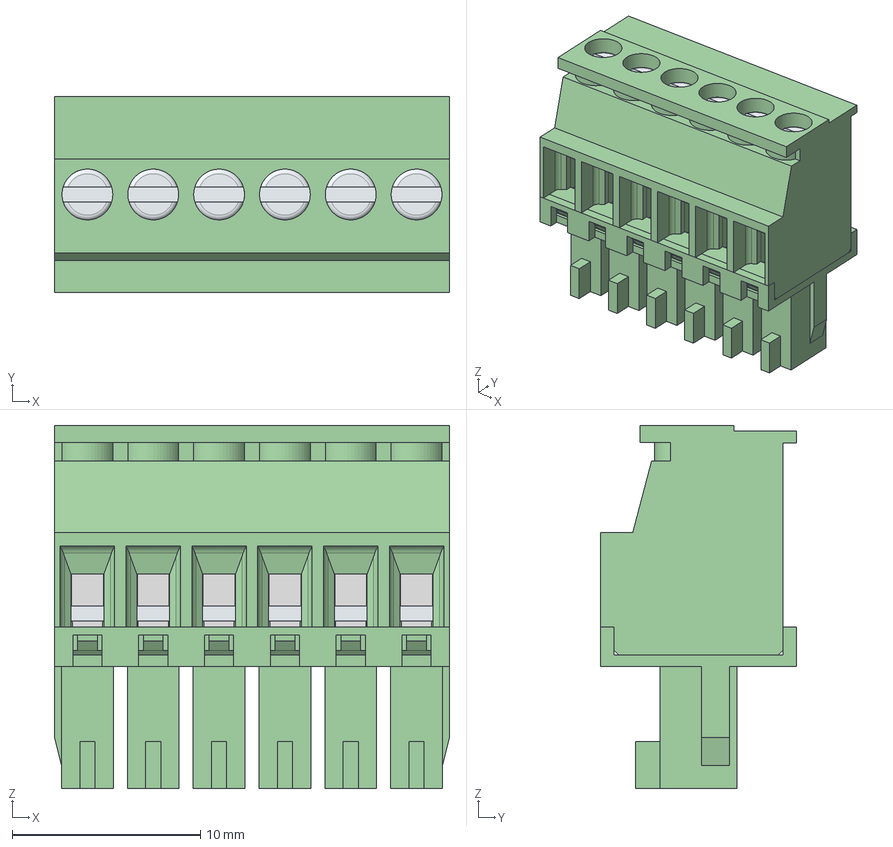
[picture p93: CAD file, 2014-09-21]
_Hard/_Libraries_Docs/Librairies_Altium_ROBOT/STEP/WURTH_6V_femelle_3.5mm_691363110006.stp
21.0 x 10.4 x 19.3 mm
6913631100xx_Cage x 6
6913631100xx_VIS x 6
6913631100xx x 6
691367110006_Bas
