samuelpoiraud/robot/_Hard/_Libraries_Docs/Librairies_Altium_ROBOT/STEP/WURTH_3V_male_3.5mm_691321100003.stp

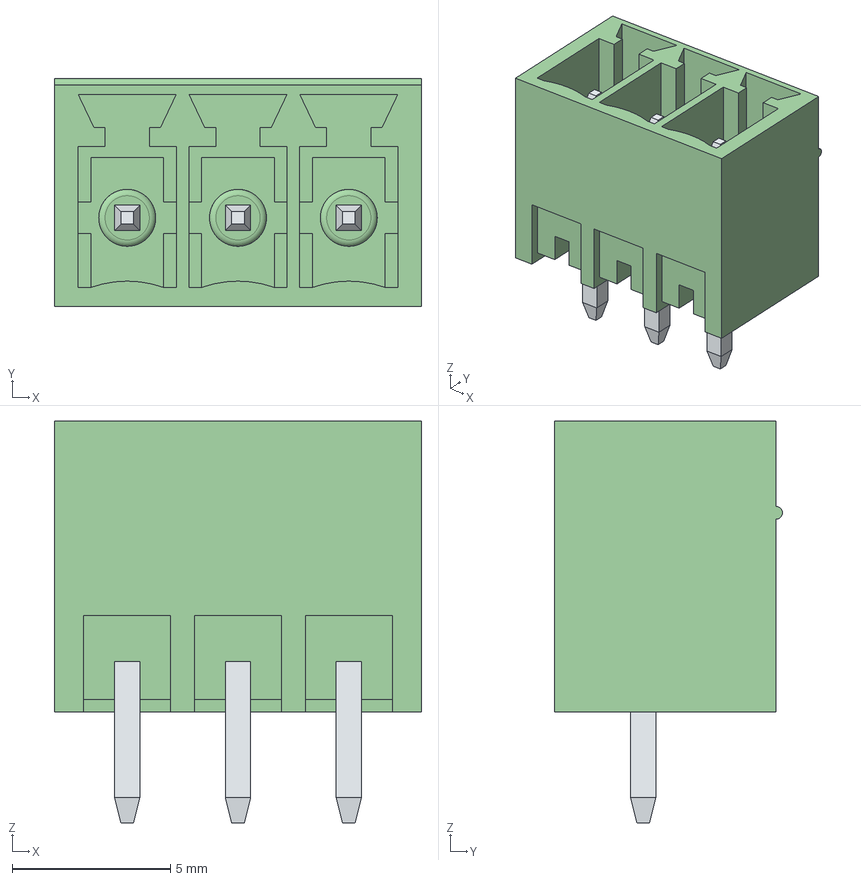
[picture p94: CAD file, 2014-09-21]
_Hard/_Libraries_Docs/Librairies_Altium_ROBOT/STEP/WURTH_3V_male_3.5mm_691321100003.stp
11.6 x 7.20 x 12.7 mm
6913211000xx_PIN x 3
