samuelpoiraud/robot/_Hard/_Libraries_Docs/Librairies_Altium_ROBOT/STEP/WURTH_5V_male_3.5mm_691321100005.stp

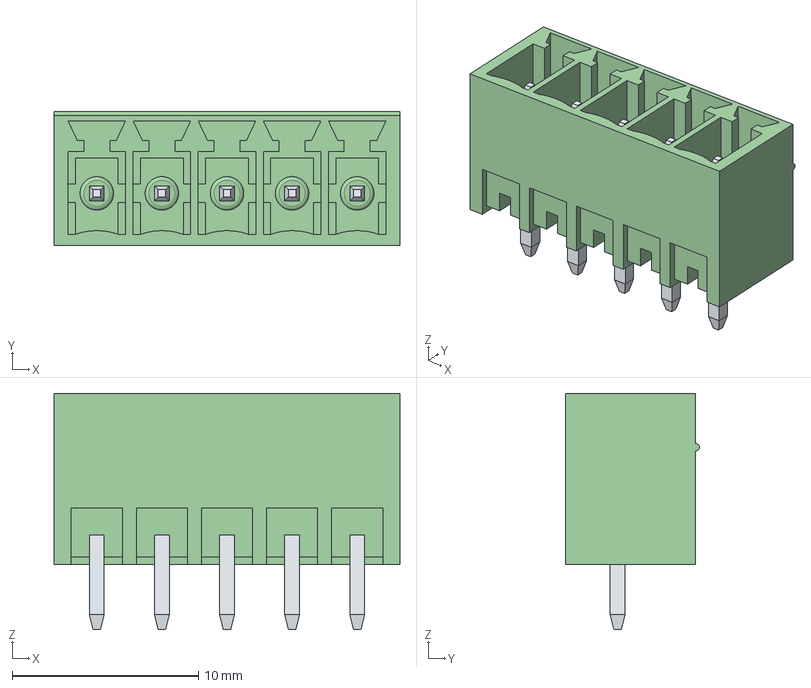
[picture p95: CAD file, 2014-07-23]
_Hard/_Libraries_Docs/Librairies_Altium_ROBOT/STEP/WURTH_5V_male_3.5mm_691321100005.stp
18.6 x 7.20 x 12.7 mm
6913211000xx_PIN x 5
