samuelpoiraud/robot/_Hard/_Libraries_Docs/Librairies_Altium_ROBOT/STEP/Fourche Optique Biroute OPB815WZ.STEP

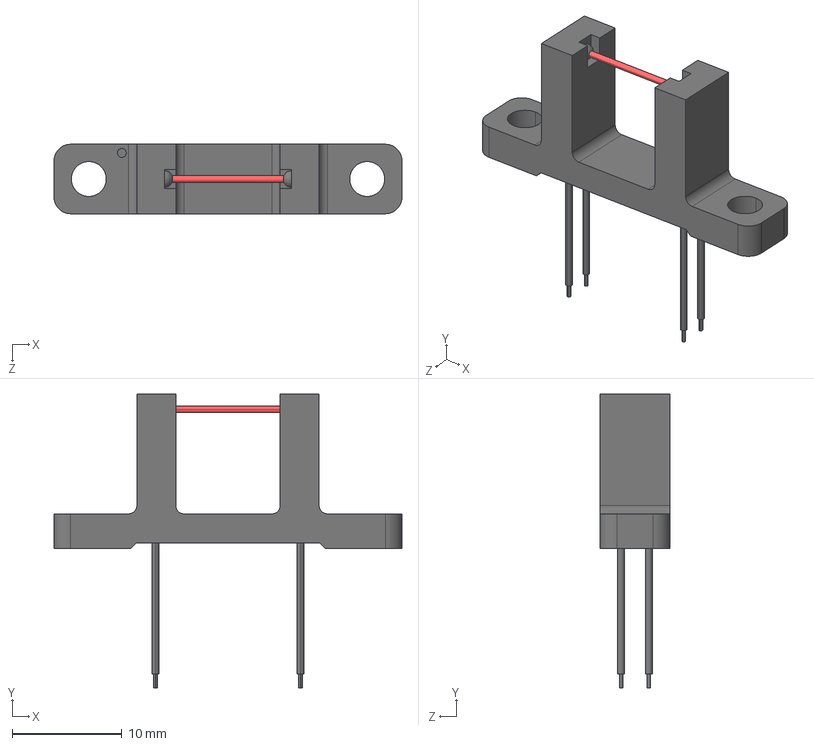
[picture p96: CAD file, 2014-07-23]
_Hard/_Libraries_Docs/Librairies_Altium_ROBOT/STEP/Fourche Optique Biroute OPB815WZ.STEP
31.8 x 26.8 x 6.35 mm
