samuelpoiraud/robot/_Hard/_Libraries_Docs/Librairies_Altium_ROBOT/STEP/WURTH_5V_femelle_cable_0_691361100005.stp

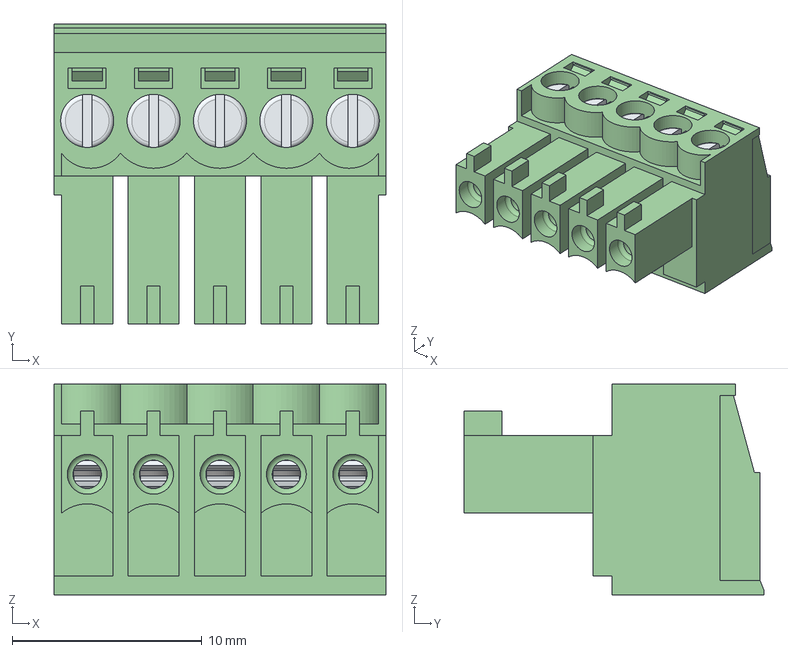
[picture p97: CAD file, 2014-07-23]
_Hard/_Libraries_Docs/Librairies_Altium_ROBOT/STEP/WURTH_5V_femelle_cable_0_691361100005.stp
17.5 x 15.8 x 11.1 mm
6913611000xx_CAGE x 5
6913611000xx_VIS x 5
6913611000xx_PIN x 5
691364100005_M
