samuelpoiraud/robot/_Hard/_Libraries_Docs/Librairies_Altium_ROBOT/STEP/WURTH_5V_femelle_cable_90_691363110005.stp

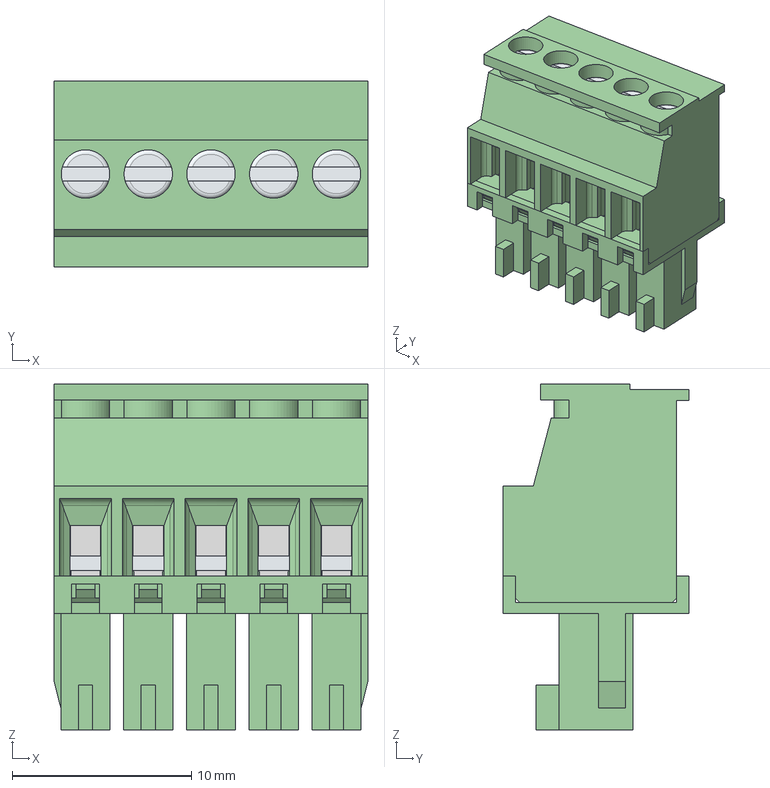
[picture p98: CAD file, 2014-07-23]
_Hard/_Libraries_Docs/Librairies_Altium_ROBOT/STEP/WURTH_5V_femelle_cable_90_691363110005.stp
17.5 x 10.4 x 19.3 mm
6913631100xx_Cage x 5
6913631100xx_VIS x 5
6913631100xx x 5
691367110005_Bas
