samuelpoiraud/robot/_Hard/_Libraries_Docs/Librairies_Altium_ROBOT/STEP/switch SPDT - 11x6x5.STEP

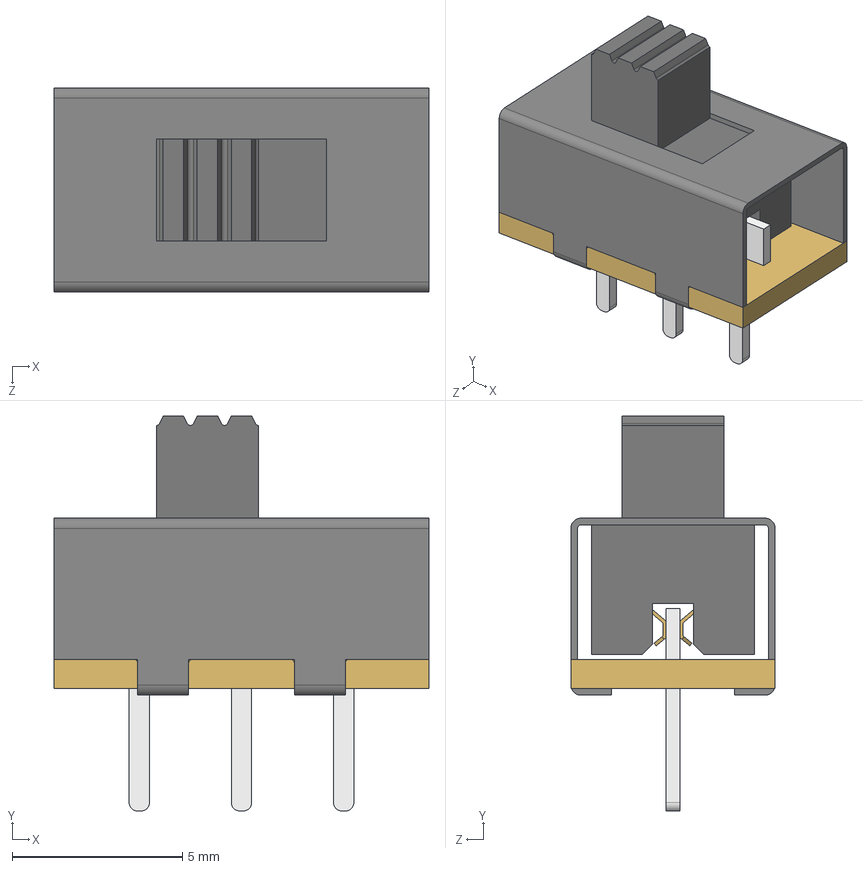
[picture p99: CAD file, 2014-07-22]
_Hard/_Libraries_Docs/Librairies_Altium_ROBOT/STEP/switch SPDT - 11x6x5.STEP
11.0 x 11.6 x 6.00 mm
Pin_1 x 3
slider_1
PCB_1
Metal_1
Contact_1
