samuelpoiraud/robot/_Hard/_Libraries_Docs/Librairies_Altium_ROBOT/STEP/Connecteur Chargeur.STEP

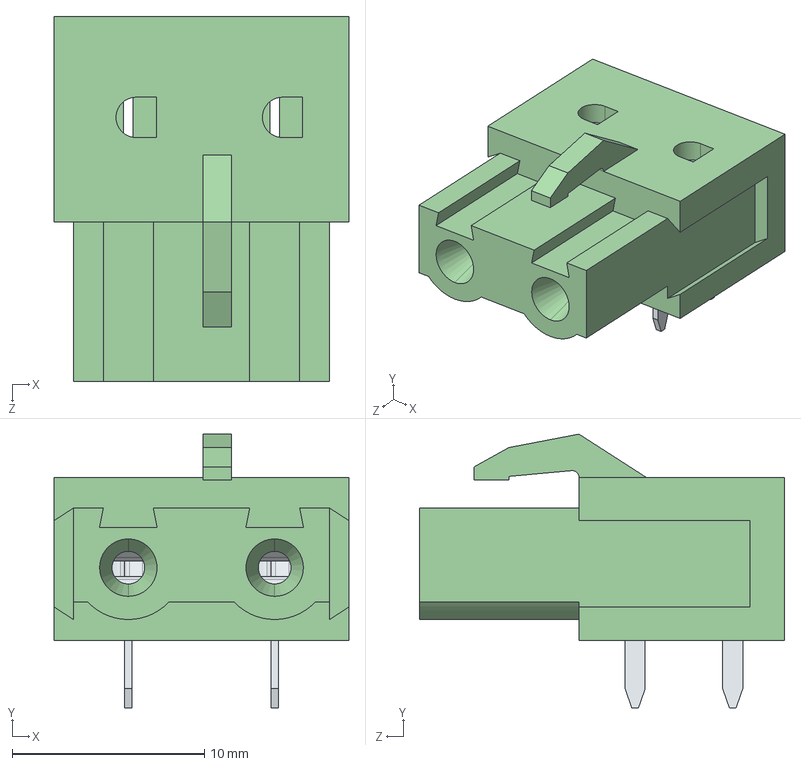
[picture p100: CAD file, 2014-07-15]
_Hard/_Libraries_Docs/Librairies_Altium_ROBOT/STEP/Connecteur Chargeur.STEP
15.3 x 14.2 x 19.0 mm
