samuelpoiraud/robot/_Hard/_Libraries_Docs/Librairies_Altium_ROBOT/STEP/Embase XLR.STEP

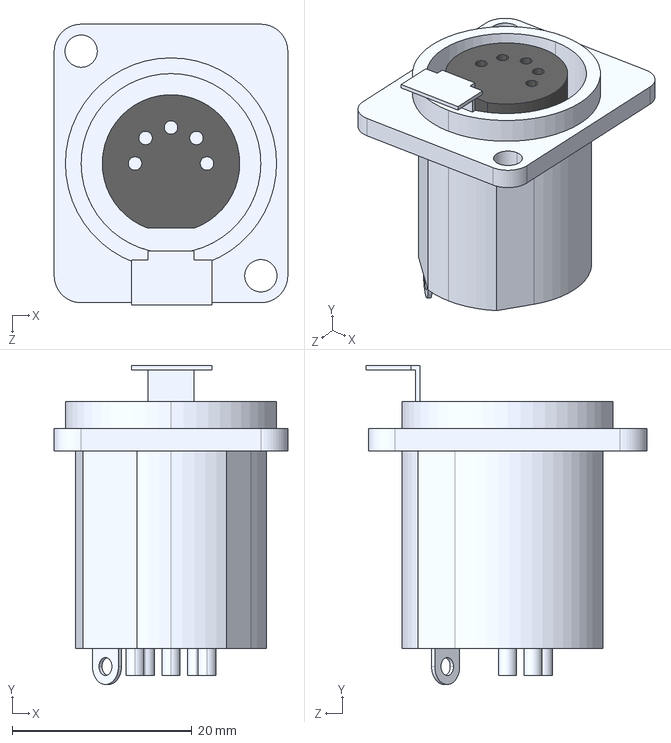
[picture p101: CAD file, 2014-07-15]
_Hard/_Libraries_Docs/Librairies_Altium_ROBOT/STEP/Embase XLR.STEP
26.0 x 35.5 x 31.2 mm
