samuelpoiraud/robot/_Hard/_Libraries_Docs/Librairies_Altium_ROBOT/STEP/WURTH_2V_7.62_MALE_COUDE.stp

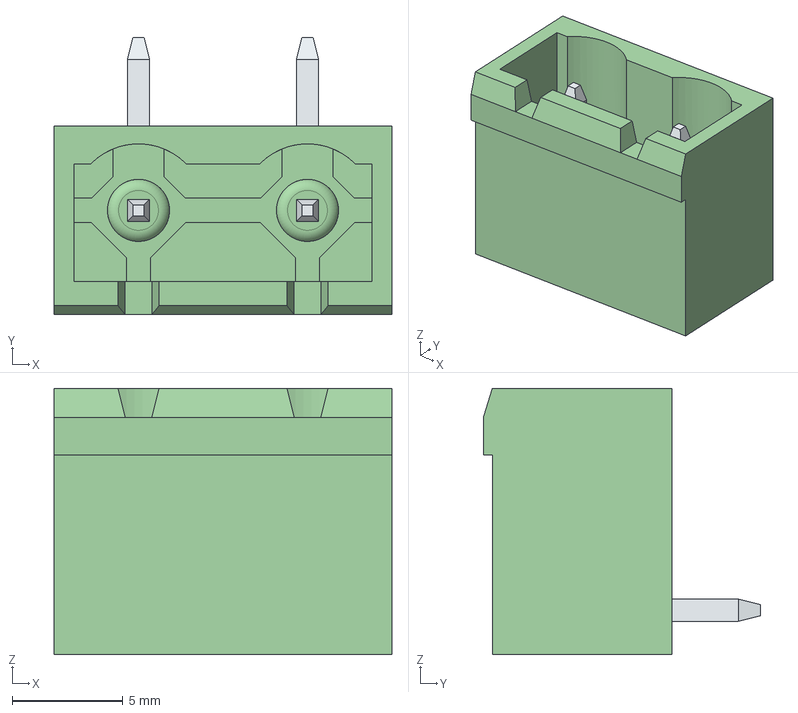
[picture p102: CAD file, 2014-07-15]
_Hard/_Libraries_Docs/Librairies_Altium_ROBOT/STEP/WURTH_2V_7.62_MALE_COUDE.stp
15.2 x 12.5 x 12.0 mm
6913134100xx_PIN x 2
