samuelpoiraud/robot/_Hard/_Libraries_Docs/Librairies_Altium_ROBOT/STEP/WURTH_2V_5.08_FEMALE_VERTICAL_691351500002.stp

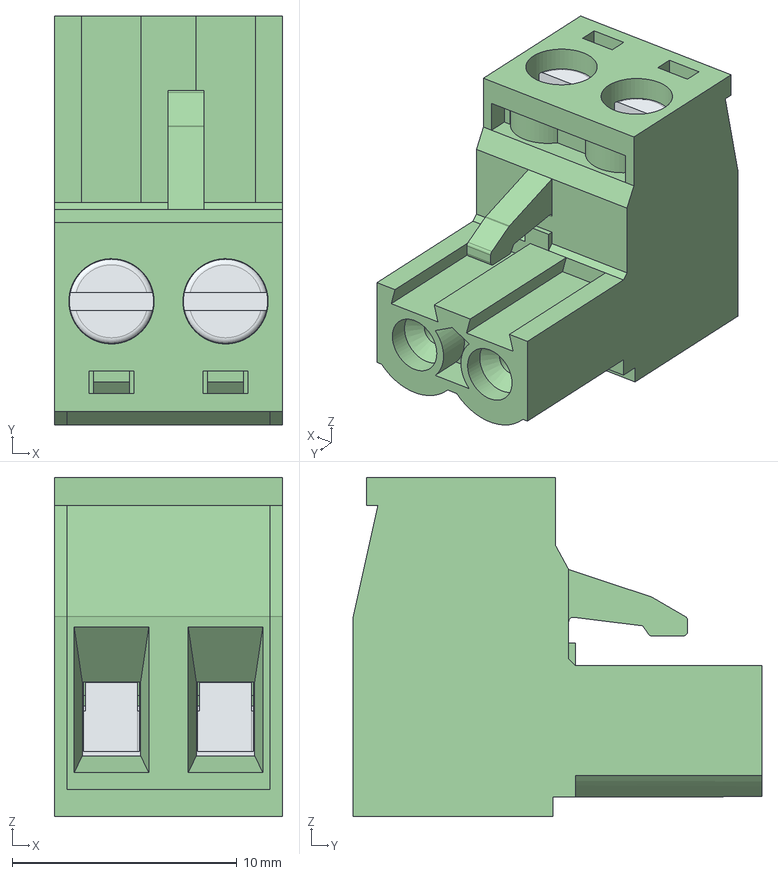
[picture p103: CAD file, 2014-07-15]
_Hard/_Libraries_Docs/Librairies_Altium_ROBOT/STEP/WURTH_2V_5.08_FEMALE_VERTICAL_691351500002.stp
10.2 x 18.2 x 15.1 mm
6913405000xx_CAGE x 2
6913405000xx_PIN x 2
6913405000xx_VISSE x 2
691340500002_CAPOT
