samuelpoiraud/robot/_Hard/_Libraries_Docs/Librairies_Altium_ROBOT/STEP/ARU.STEP

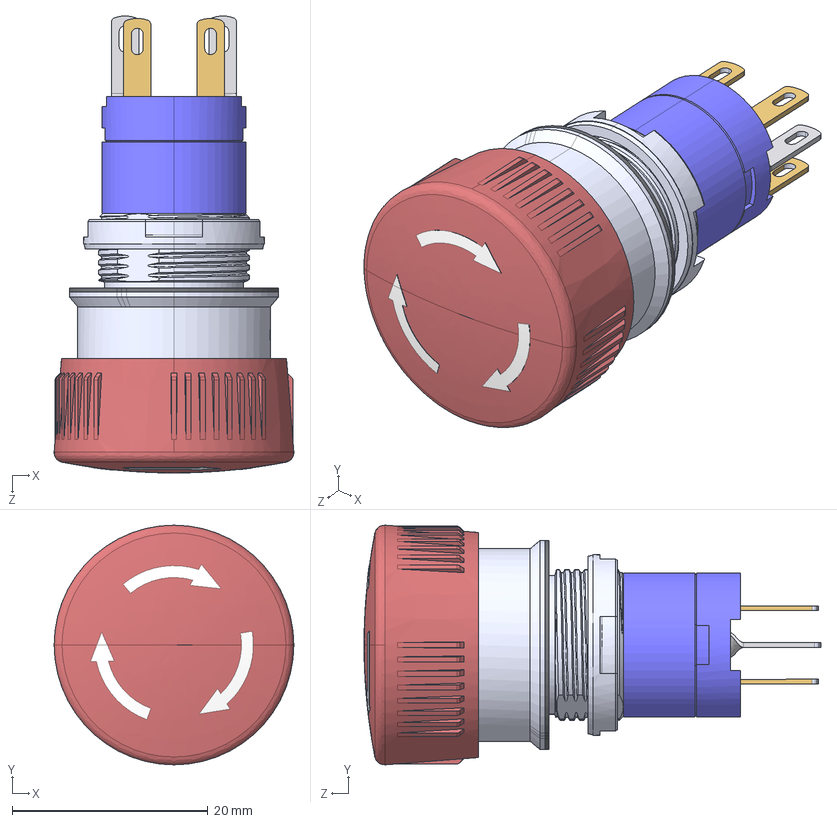
[picture p104: CAD file, 2014-07-15]
_Hard/_Libraries_Docs/Librairies_Altium_ROBOT/STEP/ARU.STEP
24.5 x 24.5 x 46.7 mm
Bouton Sécurité - Tiny
Ecrou
