samuelpoiraud/robot/_Hard/_Libraries_Docs/Librairies_Altium_ROBOT/STEP/Inter ON-OFF.STEP

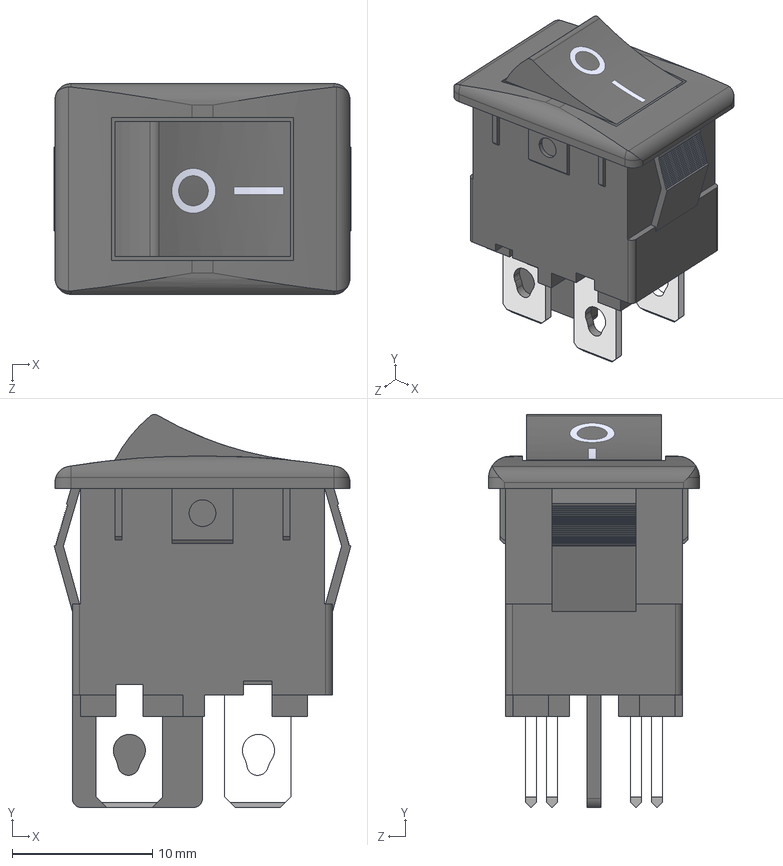
[picture p105: CAD file, 2014-07-15]
_Hard/_Libraries_Docs/Librairies_Altium_ROBOT/STEP/Inter ON-OFF.STEP
21.1 x 28.0 x 15.0 mm
