samuelpoiraud/robot/_Hard/_Libraries_Docs/Librairies_Altium_ROBOT/STEP/WURTH_2V_5.08_MALE_HORIZONTAL.stp

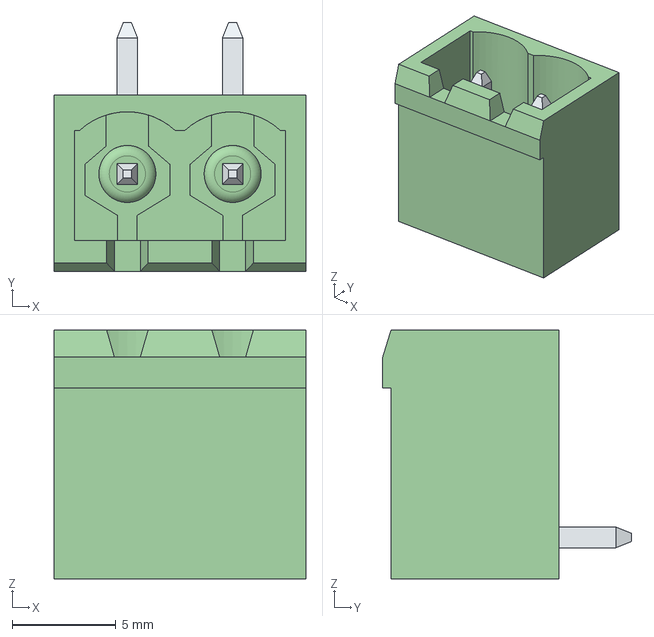
[picture p106: CAD file, 2014-07-15]
_Hard/_Libraries_Docs/Librairies_Altium_ROBOT/STEP/WURTH_2V_5.08_MALE_HORIZONTAL.stp
12.2 x 12.0 x 12.0 mm
6913135100xx_PIN x 2
