samuelpoiraud/robot/_Hard/_Libraries_Docs/Librairies_Altium_ROBOT/STEP/UTM-30LX.STEP

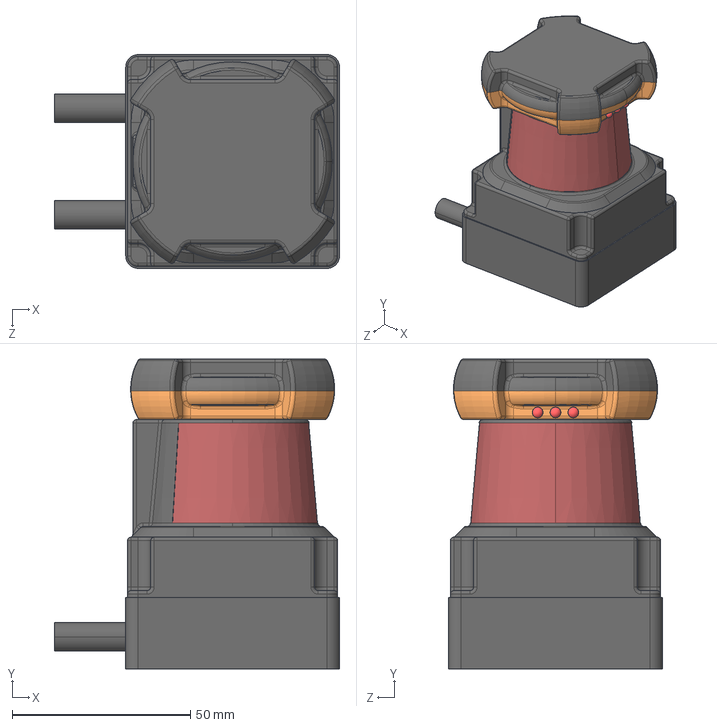
[picture p107: CAD file, 2014-07-15]
_Hard/_Libraries_Docs/Librairies_Altium_ROBOT/STEP/UTM-30LX.STEP
80.0 x 87.0 x 60.0 mm
