samuelpoiraud/robot/_Hard/_Libraries_Docs/Librairies_Altium_ROBOT/STEP/WURTH_BORNIER_VIS_2V_5.08.stp

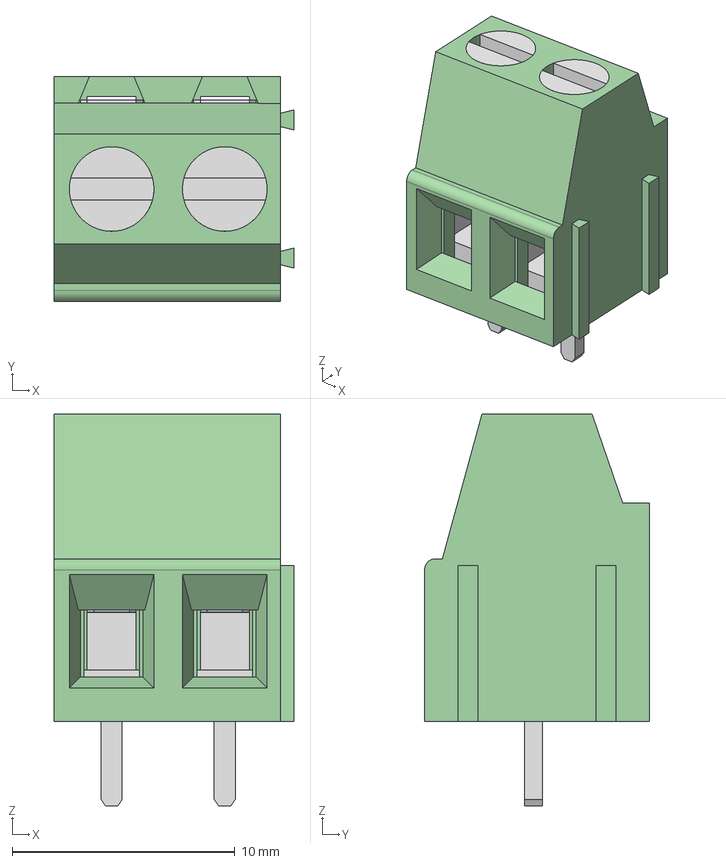
[picture p109: CAD file, 2014-07-02]
_Hard/_Libraries_Docs/Librairies_Altium_ROBOT/STEP/WURTH_BORNIER_VIS_2V_5.08.stp
10.8 x 10.1 x 17.6 mm
6912165100xx_MASS x 2
6912165100xx_PIN x 2
6912165100xx_VIS x 2
