samuelpoiraud/robot/_Hard/_Libraries_Docs/Librairies_Altium_ROBOT/STEP/WURTH_RJ12_HalfShieldedTabDown_615006143421.stp

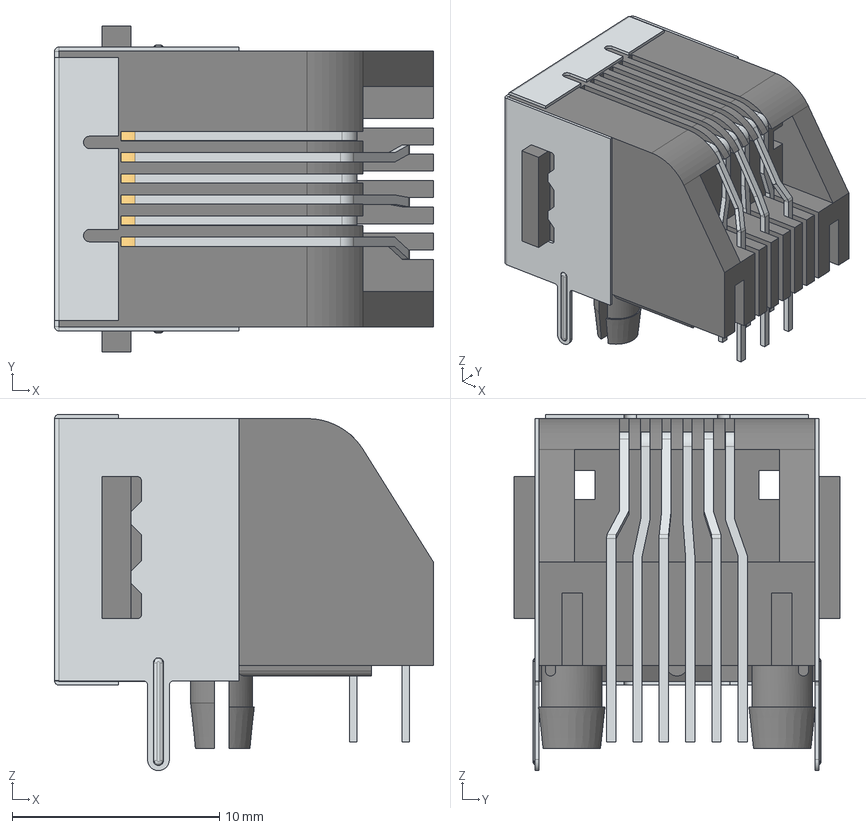
[picture p110: CAD file, 2014-07-02]
_Hard/_Libraries_Docs/Librairies_Altium_ROBOT/STEP/WURTH_RJ12_HalfShieldedTabDown_615006143421.stp
18.3 x 15.8 x 17.2 mm
houssing
Shielding
pin6
pin1
pin2
pin3
pin4
pin5
