samuelpoiraud/robot/_Hard/_Libraries_Docs/Librairies_Altium_ROBOT/STEP/WURTH_RJ12_0°_615006144121.stp

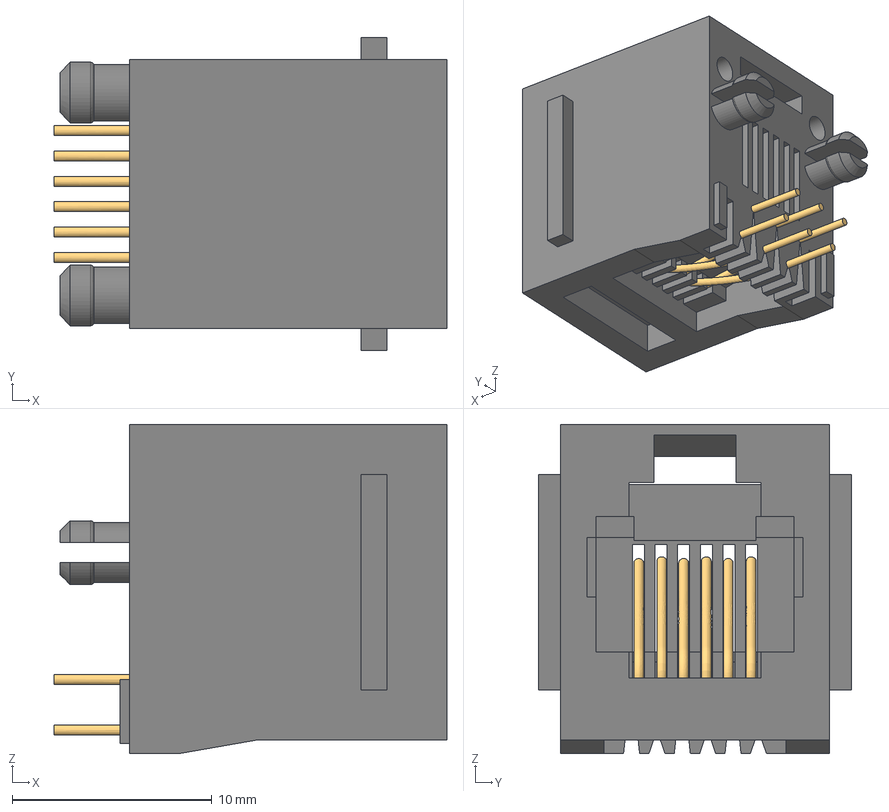
[picture p111: CAD file, 2014-07-02]
_Hard/_Libraries_Docs/Librairies_Altium_ROBOT/STEP/WURTH_RJ12_0°_615006144121.stp
19.7 x 15.7 x 16.5 mm
houssing
pin1
pin3
pin5
pin2
pin4
pin6
