samuelpoiraud/robot/_Hard/_Libraries_Docs/Librairies_Altium_ROBOT/STEP/PHOENIX_2V_7.62_FEMALE_FILS_691348400002.stp

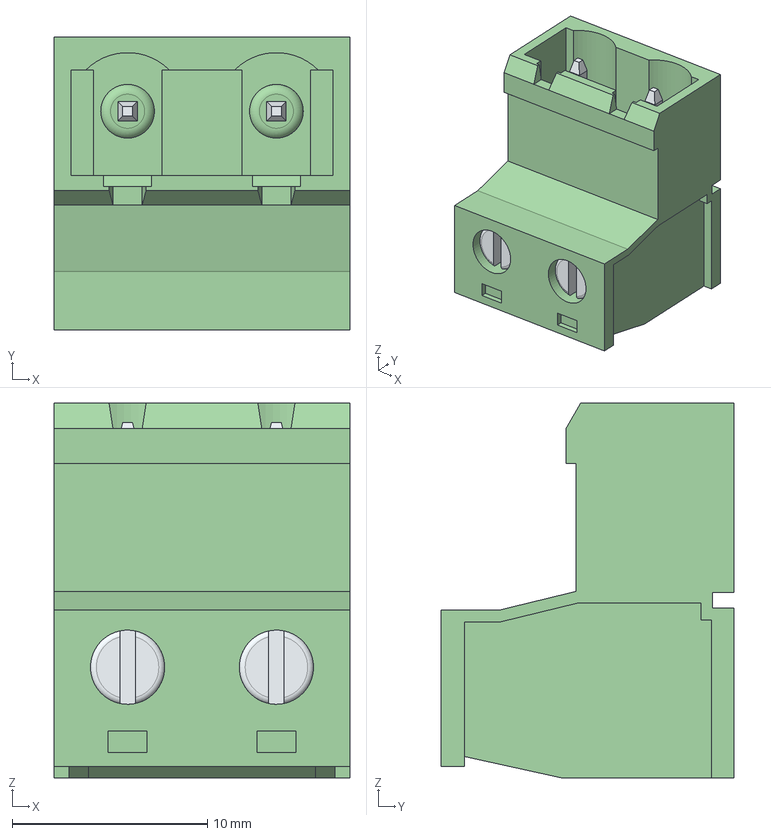
[picture p112: CAD file, 2013-12-03]
_Hard/_Libraries_Docs/Librairies_Altium_ROBOT/STEP/PHOENIX_2V_7.62_FEMALE_FILS_691348400002.stp
15.1 x 15.0 x 19.2 mm
691348400002_CAPOT
6913484000xx_PIN x 2
6913484000xx_CAGE x 2
6913484000xx_VISSE x 2
