samuelpoiraud/robot/_Hard/_Libraries_Docs/Librairies_Altium_ROBOT/STEP/7.62_reverse_gender_691307400002.stp

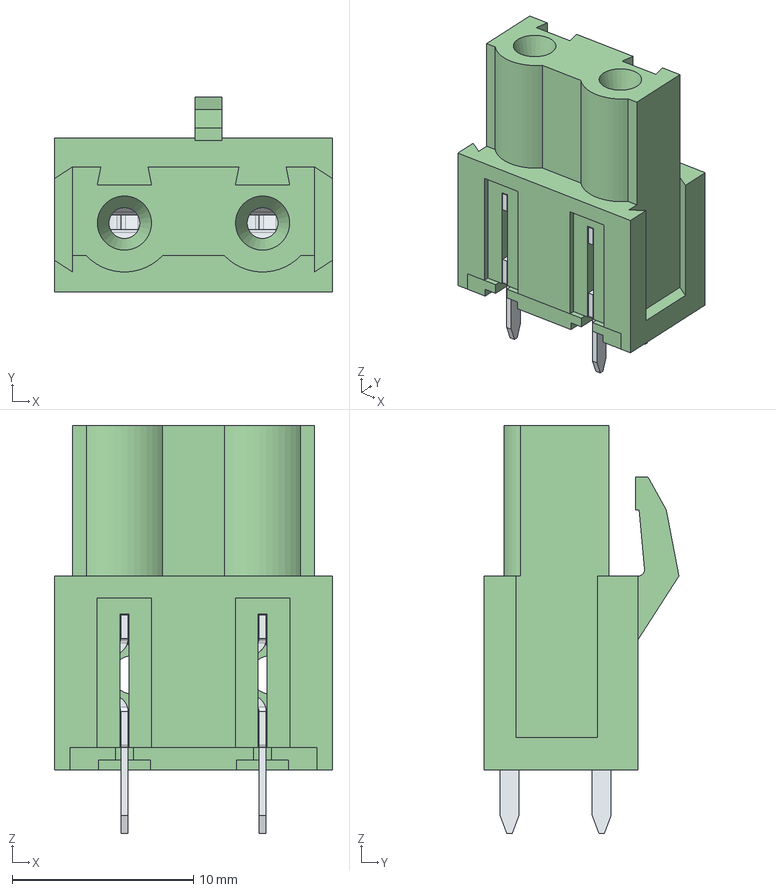
[picture p113: CAD file, 2013-12-03]
_Hard/_Libraries_Docs/Librairies_Altium_ROBOT/STEP/7.62_reverse_gender_691307400002.stp
15.3 x 10.8 x 22.5 mm
6913074000xx_PIN x 2
691309410002_CAPOT
