samuelpoiraud/robot/_Hard/_Libraries_Docs/Librairies_Altium_ROBOT/STEP/PHOENIX_2V_7.62_MALE_1728853.stp

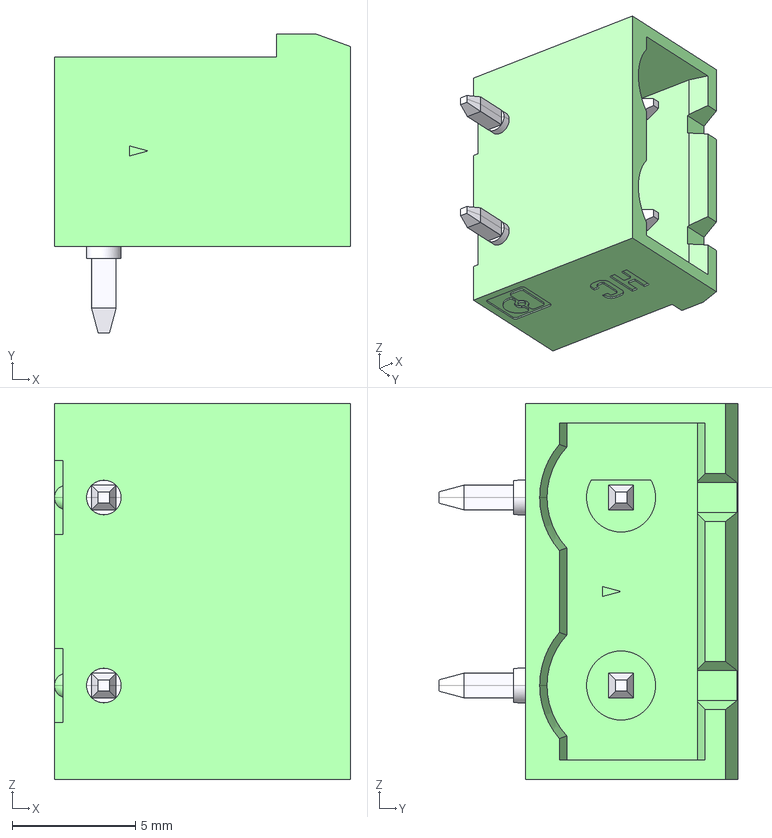
[picture p114: CAD file, 2013-12-03]
_Hard/_Libraries_Docs/Librairies_Altium_ROBOT/STEP/PHOENIX_2V_7.62_MALE_1728853.stp
12.0 x 12.1 x 15.2 mm
