samuelpoiraud/robot/_Hard/_Libraries_Docs/Librairies_Altium_ROBOT/STEP/PHOENIX_2V_7.62_FEMALE_691351400002.stp

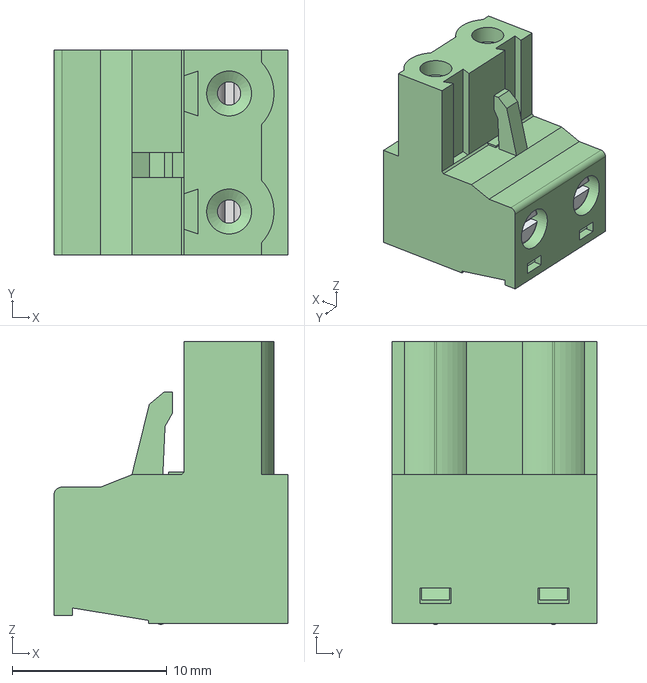
[picture p115: CAD file, 2013-12-03]
_Hard/_Libraries_Docs/Librairies_Altium_ROBOT/STEP/PHOENIX_2V_7.62_FEMALE_691351400002.stp
15.1 x 13.2 x 18.3 mm
