samuelpoiraud/robot/_Hard/_Libraries_Docs/Librairies_Altium_ROBOT/STEP/MOLEX_miniSD_header_5027740891.stp

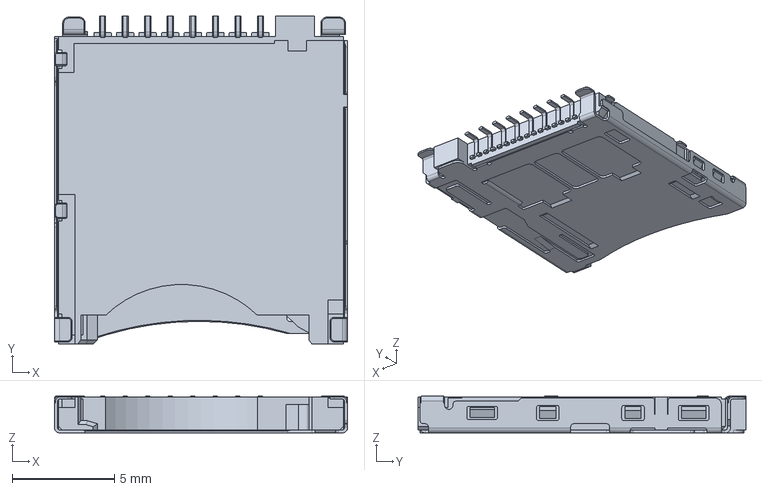
[picture p116: CAD file, 2013-11-04]
_Hard/_Libraries_Docs/Librairies_Altium_ROBOT/STEP/MOLEX_miniSD_header_5027740891.stp
14.3 x 16.0 x 1.80 mm
