samuelpoiraud/robot/_Hard/_Libraries_Docs/Librairies_Altium_ROBOT/STEP/PHOENIX_3V_3.81_FEMALE_1803581.stp

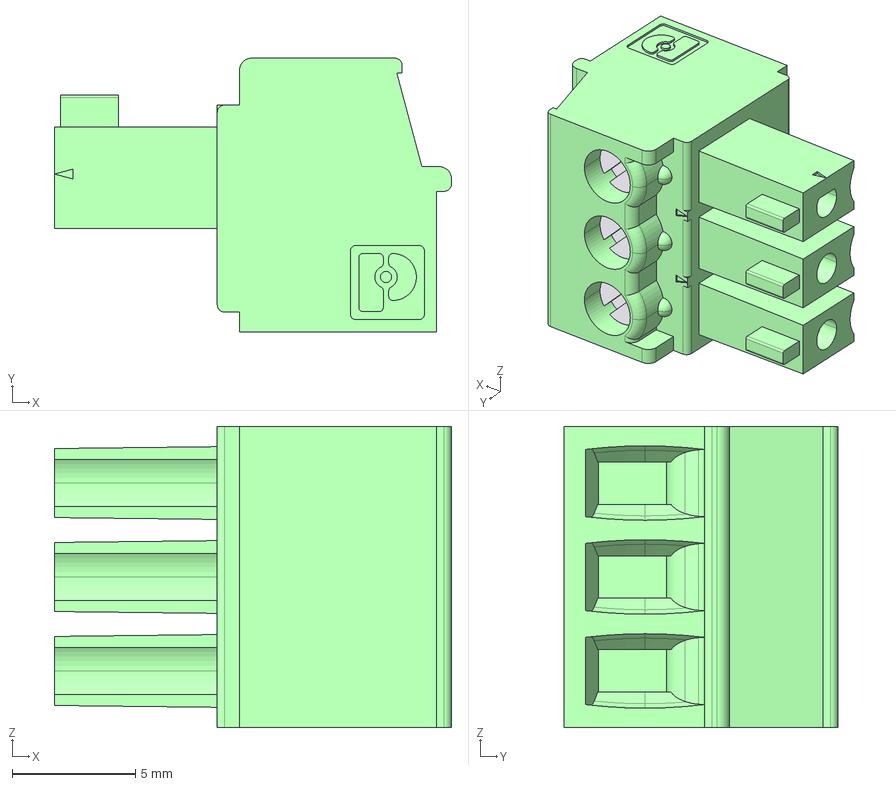
[picture p117: CAD file, 2013-11-04]
_Hard/_Libraries_Docs/Librairies_Altium_ROBOT/STEP/PHOENIX_3V_3.81_FEMALE_1803581.stp
16.1 x 11.1 x 12.2 mm
