samuelpoiraud/robot/_Hard/_Libraries_Docs/Librairies_Altium_ROBOT/STEP/PHOENIX_4V_3.81_FEMALE_1803594.stp

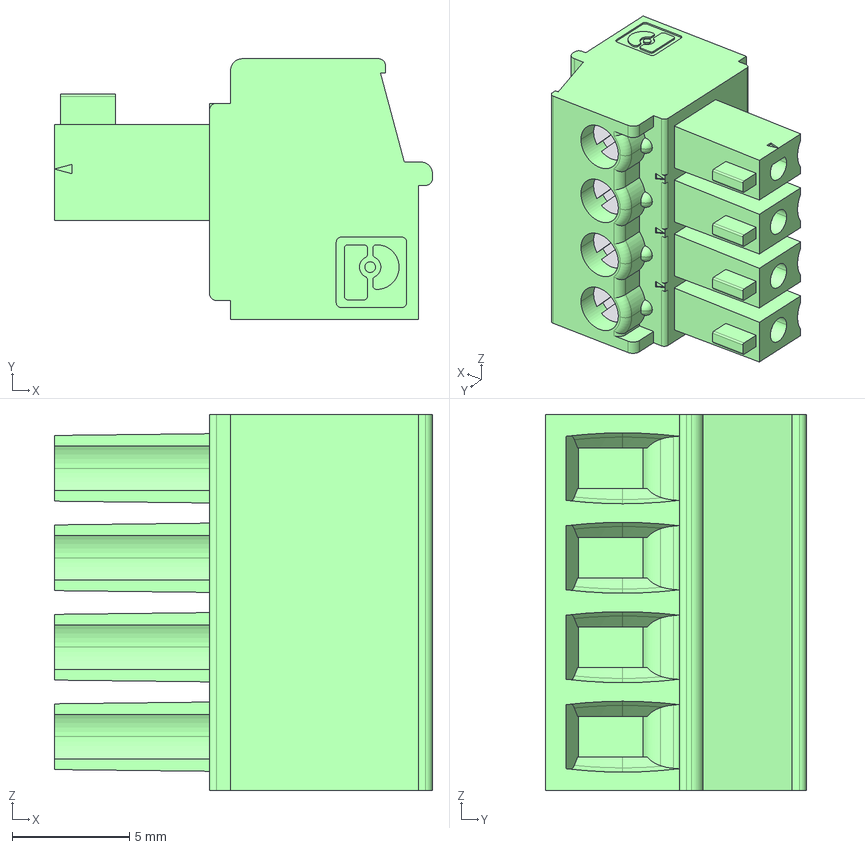
[picture p118: CAD file, 2013-11-04]
_Hard/_Libraries_Docs/Librairies_Altium_ROBOT/STEP/PHOENIX_4V_3.81_FEMALE_1803594.stp
16.1 x 11.1 x 16.0 mm
