samuelpoiraud/robot/_Hard/_Libraries_Docs/Librairies_Altium_ROBOT/STEP/PHOENIX_5V_3.81_FEMALE_1803604.stp

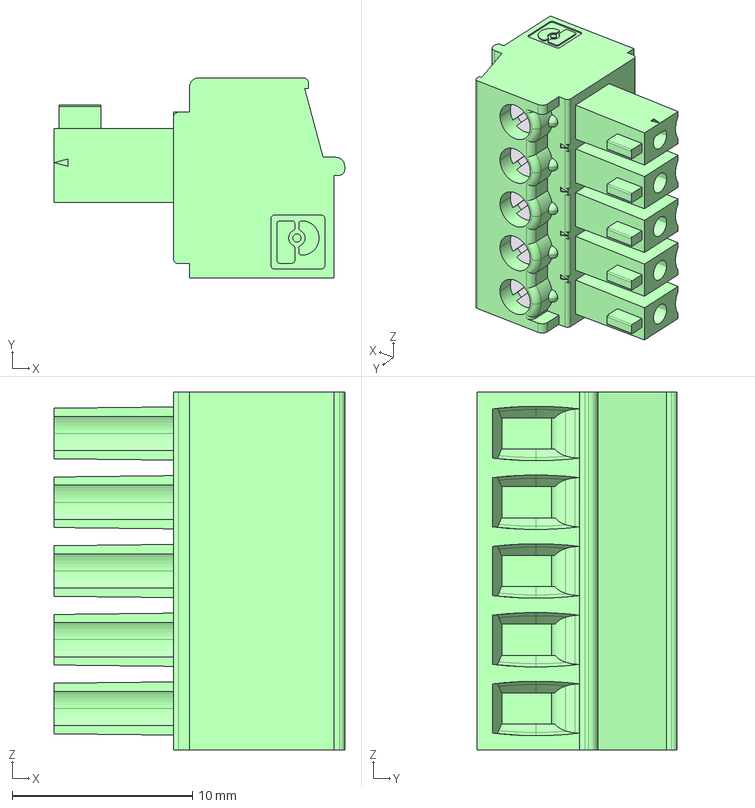
[picture p119: CAD file, 2013-11-04]
_Hard/_Libraries_Docs/Librairies_Altium_ROBOT/STEP/PHOENIX_5V_3.81_FEMALE_1803604.stp
16.1 x 11.1 x 19.8 mm
