samuelpoiraud/robot/_Hard/_Libraries_Docs/Librairies_Altium_ROBOT/STEP/PHOENIX_4V_3.81_MALE_1803442.stp

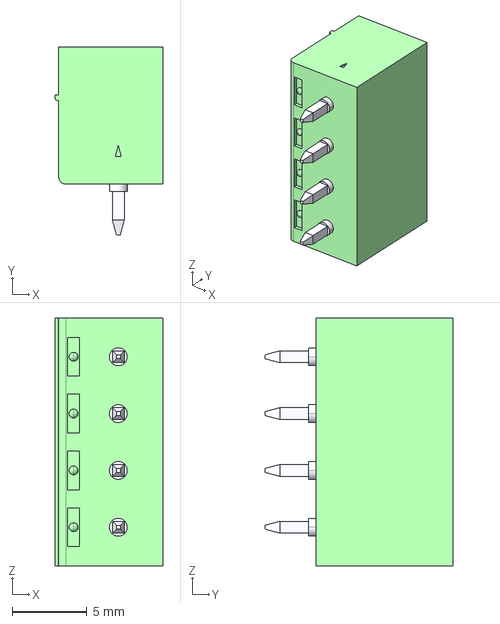
[picture p120: CAD file, 2013-11-04]
_Hard/_Libraries_Docs/Librairies_Altium_ROBOT/STEP/PHOENIX_4V_3.81_MALE_1803442.stp
7.25 x 12.6 x 16.6 mm
