samuelpoiraud/robot/_Hard/_Libraries_Docs/Librairies_Altium_ROBOT/STEP/PHOENIX_2V_5.08_MALE_1755736.stp

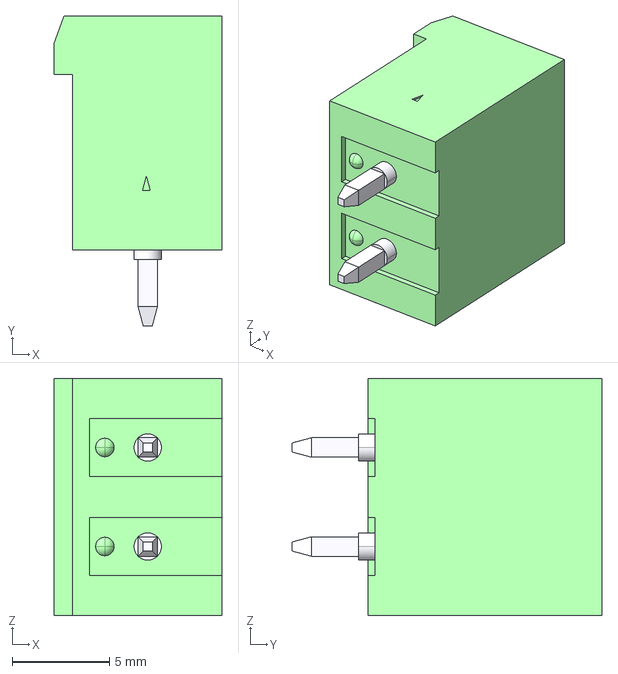
[picture p121: CAD file, 2013-11-04]
_Hard/_Libraries_Docs/Librairies_Altium_ROBOT/STEP/PHOENIX_2V_5.08_MALE_1755736.stp
8.60 x 15.9 x 12.2 mm
