samuelpoiraud/robot/_Hard/_Libraries_Docs/Librairies_Altium_ROBOT/STEP/PHOENIX_2V_5.08_FEMALE_1757019.stp

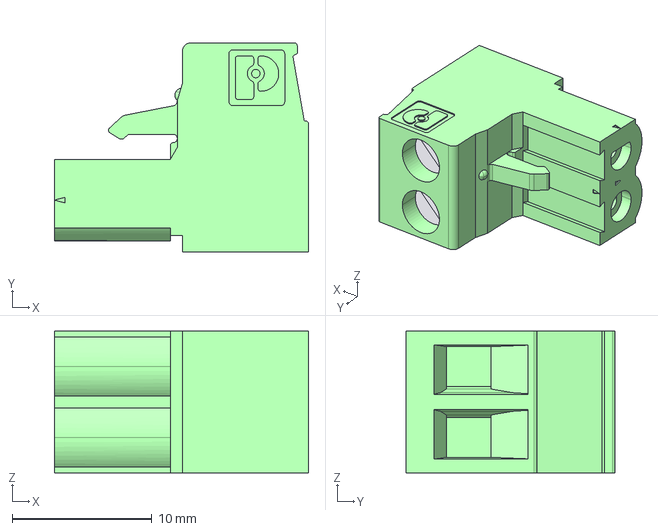
[picture p122: CAD file, 2013-11-04]
_Hard/_Libraries_Docs/Librairies_Altium_ROBOT/STEP/PHOENIX_2V_5.08_FEMALE_1757019.stp
18.2 x 15.0 x 10.2 mm
