samuelpoiraud/robot/_Hard/_Libraries_Docs/Librairies_Altium_ROBOT/STEP/PHOENIX_5V_3.81_MALE_1803455.stp

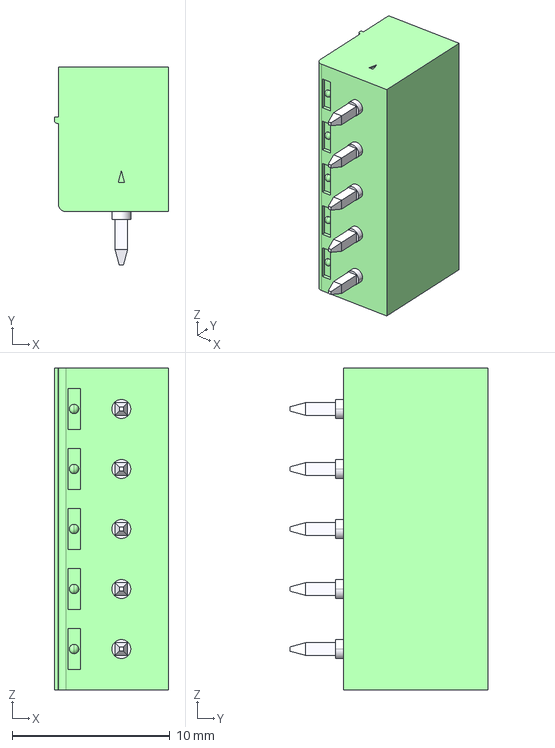
[picture p123: CAD file, 2013-11-04]
_Hard/_Libraries_Docs/Librairies_Altium_ROBOT/STEP/PHOENIX_5V_3.81_MALE_1803455.stp
7.25 x 12.6 x 20.4 mm
