samuelpoiraud/robot/_Hard/_Libraries_Docs/Librairies_Altium_ROBOT/STEP/PHOENIX_3V_3.81_MALE_1803439.stp

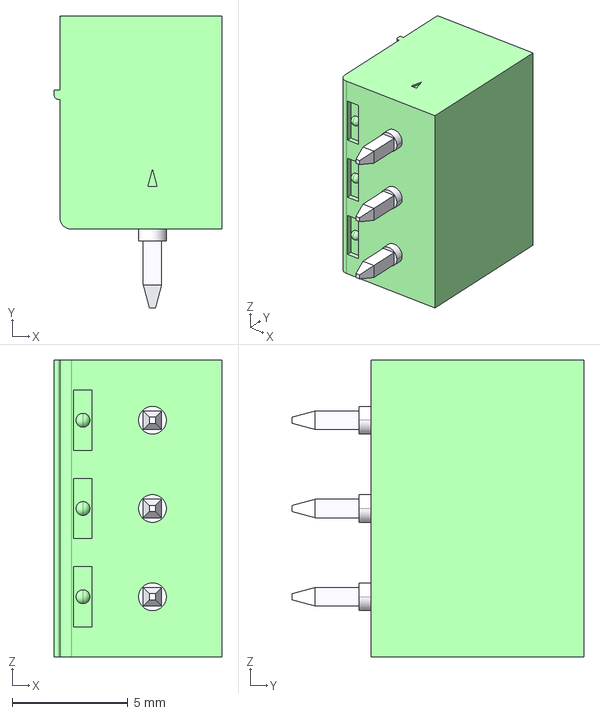
[picture p124: CAD file, 2013-11-04]
_Hard/_Libraries_Docs/Librairies_Altium_ROBOT/STEP/PHOENIX_3V_3.81_MALE_1803439.stp
7.25 x 12.6 x 12.8 mm
