samuelpoiraud/robot/_Hard/_Libraries_Docs/Librairies_Altium_ROBOT/STEP/LED_SMD.step

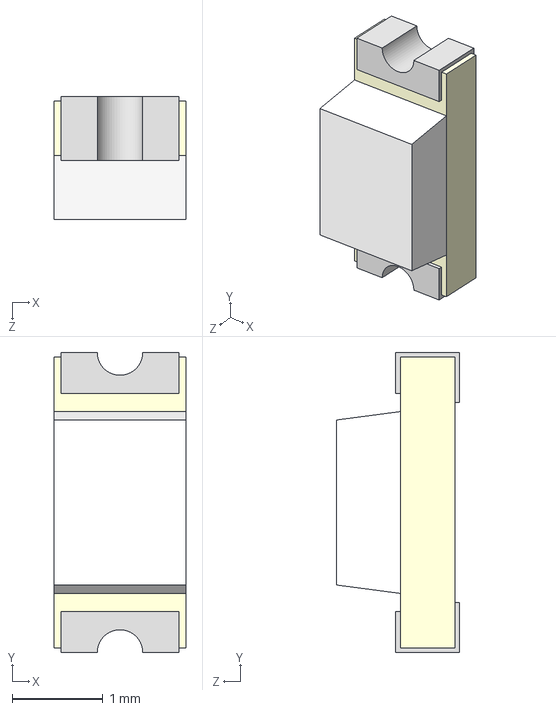
[picture p125: CAD file, 2013-01-31]
_Hard/_Libraries_Docs/Librairies_Altium_ROBOT/STEP/LED_SMD.step
1.45 x 3.30 x 1.35 mm
