samuelpoiraud/robot/_Hard/_Libraries_Docs/Librairies_Altium_ROBOT/STEP/Tantale.step

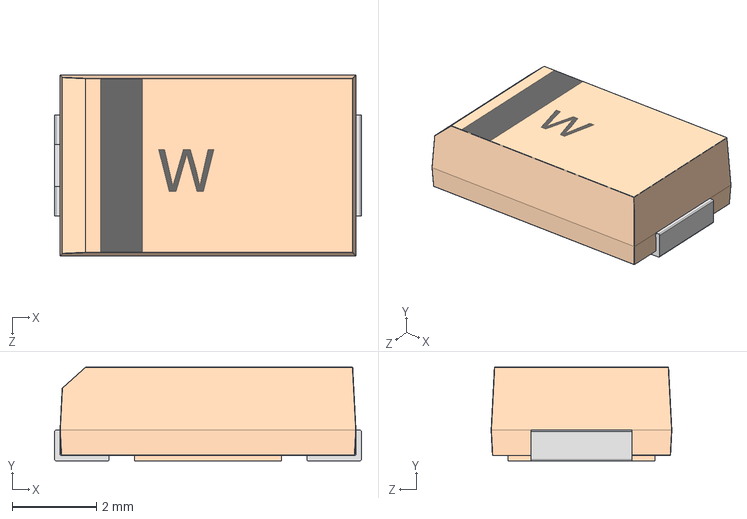
[picture p126: CAD file, 2013-01-31]
_Hard/_Libraries_Docs/Librairies_Altium_ROBOT/STEP/Tantale.step
7.30 x 2.23 x 4.30 mm
