samuelpoiraud/robot/_Hard/_Libraries_Docs/Librairies_Altium_ROBOT/STEP/0805 SMD Resistor.step

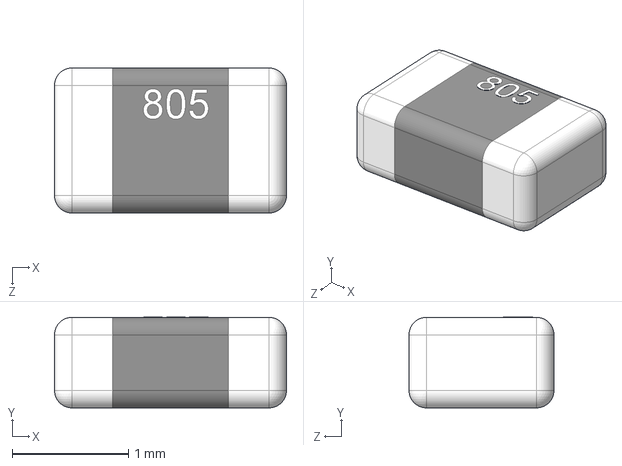
[picture p127: CAD file, 2013-01-31]
_Hard/_Libraries_Docs/Librairies_Altium_ROBOT/STEP/0805 SMD Resistor.step
2.00 x 0.782 x 1.25 mm
