samuelpoiraud/robot/_Hard/_Libraries_Docs/Librairies_Altium_ROBOT/STEP/Quartz_SMD.step

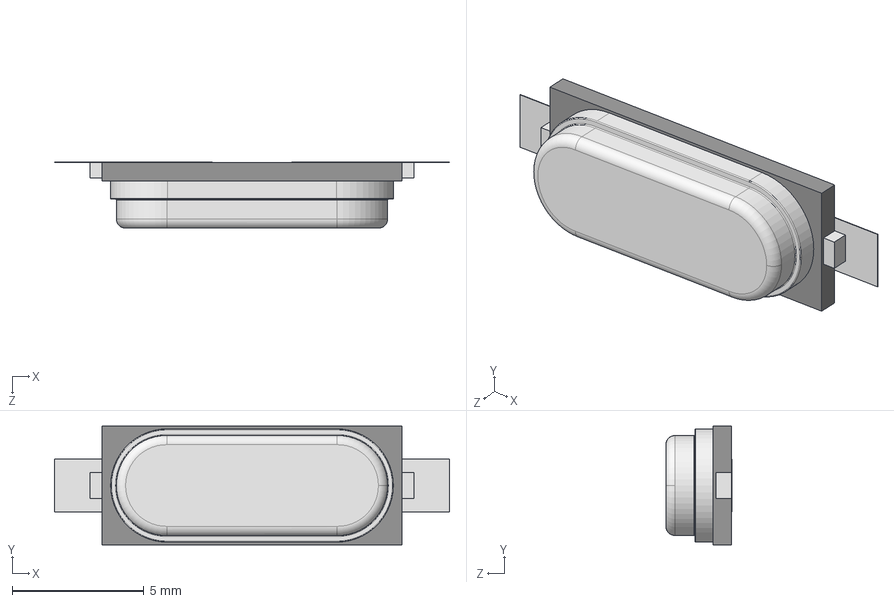
[picture p128: CAD file, 2013-01-31]
_Hard/_Libraries_Docs/Librairies_Altium_ROBOT/STEP/Quartz_SMD.step
15.0 x 4.50 x 2.52 mm
