samuelpoiraud/robot/_Hard/_Libraries_Docs/Librairies_Altium_ROBOT/STEP/TO263-3.STEP

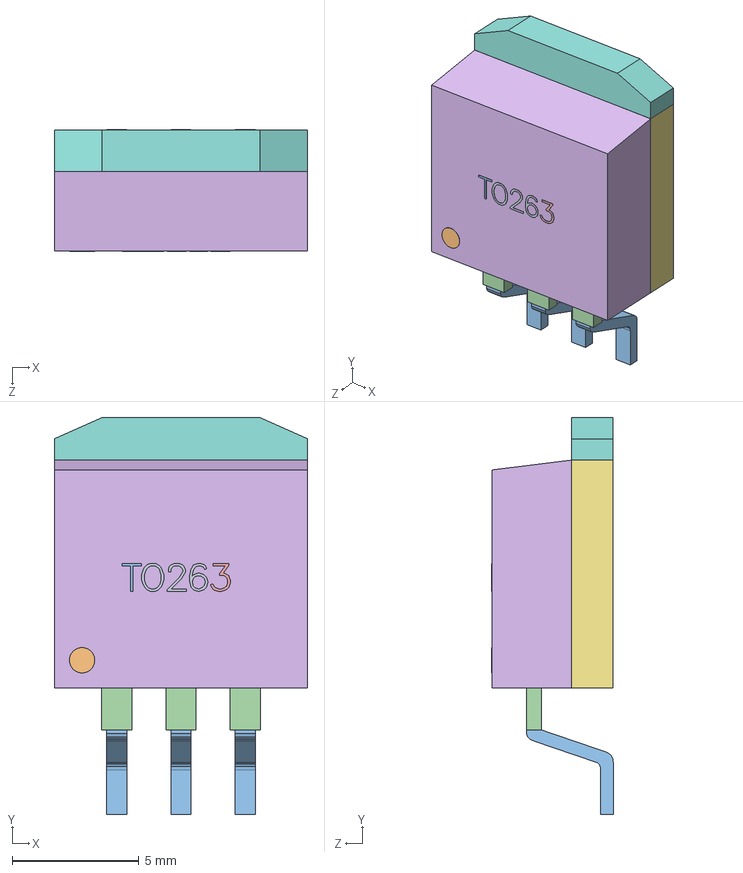
[picture p129: CAD file, 2013-01-31]
_Hard/_Libraries_Docs/Librairies_Altium_ROBOT/STEP/TO263-3.STEP
10.0 x 15.7 x 4.80 mm
SW3dPS-TO263-3_Board7
SW3dPS-TO263-3_Board6 x 3
SW3dPS-TO263-3_Extruded13 x 3
SW3dPS-TO263-3_Extruded19
SW3dPS-TO263-3_Extruded14 x 3
SW3dPS-TO263-3_Extruded17
SW3dPS-TO263-3_Board5
SW3dPS-TO263-3_Board8
SW3dPS-TO263-3_Extruded18
SW3dPS-TO263-3_Extruded15
SW3dPS-TO263-3_Extruded12
SW3dPS-TO263-3_Board9
SW3dPS-TO263-3_Extruded16
SW3dPS-TO263-3_Extruded10
SW3dPS-TO263-3_Cylinder1
SW3dPS-TO263-3_Extruded11
