samuelpoiraud/robot/_Hard/_Libraries_Docs/Librairies_Altium_ROBOT/STEP/Connecteur_HE10.STEP

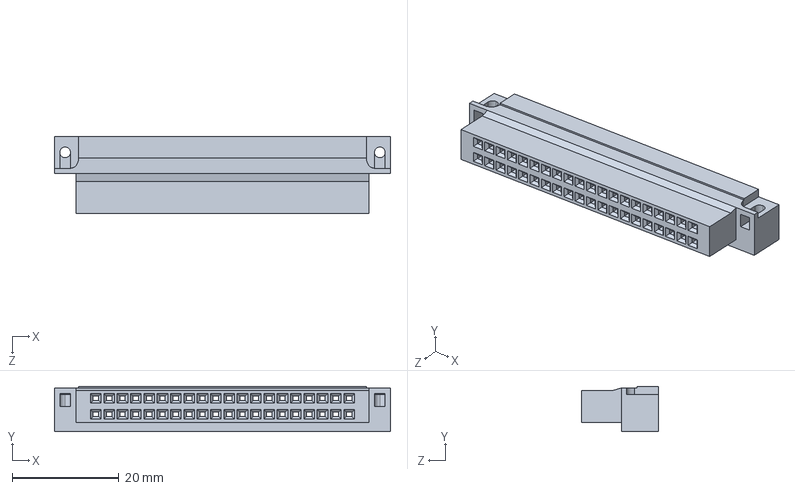
[picture p130: CAD file, 2013-01-31]
_Hard/_Libraries_Docs/Librairies_Altium_ROBOT/STEP/Connecteur_HE10.STEP
63.0 x 8.50 x 14.5 mm
