samuelpoiraud/robot/_Hard/_Libraries_Docs/Librairies_Altium_ROBOT/STEP/Relais.STEP

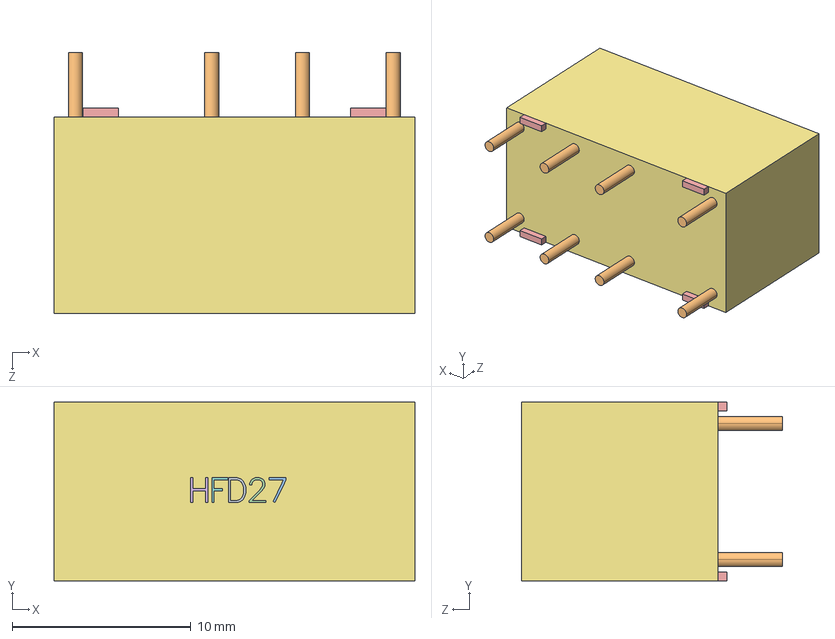
[picture p131: CAD file, 2013-01-31]
_Hard/_Libraries_Docs/Librairies_Altium_ROBOT/STEP/Relais.STEP
20.2 x 10.0 x 14.6 mm
SW3dPS-HFD27_Cylinder1 x 8
SW3dPS-HFD27_Extruded7
SW3dPS-HFD27_Extruded12
SW3dPS-HFD27_Extruded10 x 4
SW3dPS-HFD27_Extruded8
SW3dPS-HFD27_Extruded13
SW3dPS-HFD27_Extruded9
SW3dPS-HFD27_Extruded11
SW3dPS-HFD27_Board1
