samuelpoiraud/robot/_Hard/_Libraries_Docs/Librairies_Altium_ROBOT/STEP/Jumper_embase.step

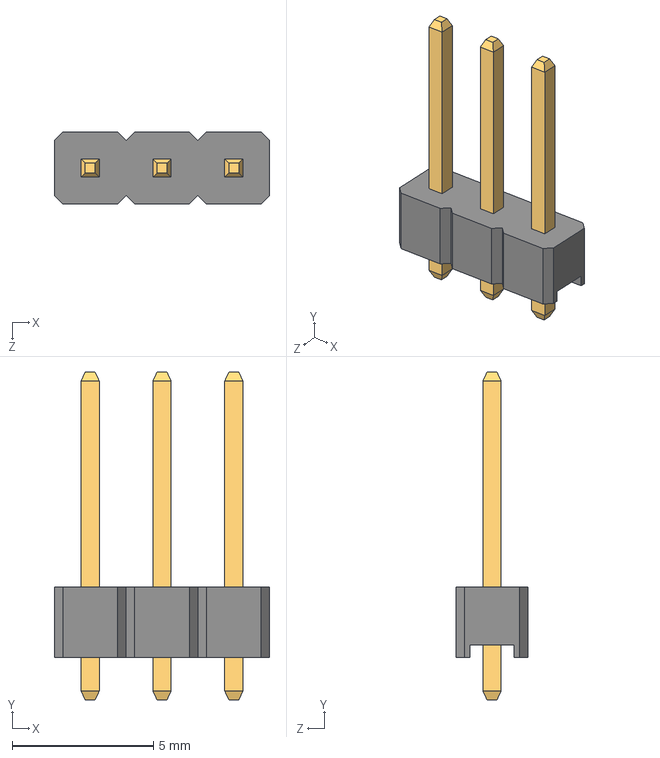
[picture p133: CAD file, 2013-01-31]
_Hard/_Libraries_Docs/Librairies_Altium_ROBOT/STEP/Jumper_embase.step
7.62 x 11.6 x 2.54 mm
