samuelpoiraud/robot/_Hard/_Libraries_Docs/Librairies_Altium_ROBOT/STEP/Tantalum_B.step

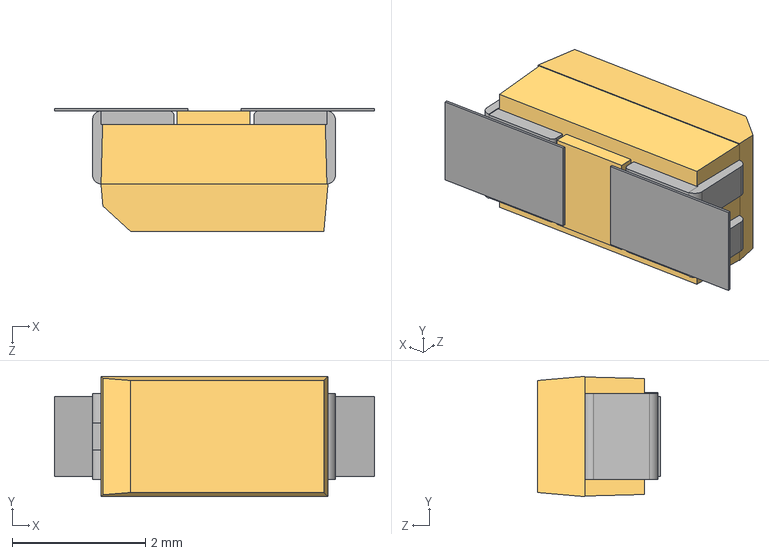
[picture p136: CAD file, 2013-01-31]
_Hard/_Libraries_Docs/Librairies_Altium_ROBOT/STEP/Tantalum_B.step
4.80 x 1.80 x 1.84 mm
