samuelpoiraud/robot/_Hard/_Libraries_Docs/Librairies_Altium_ROBOT/STEP/Connecteur_Alim_7V.STEP

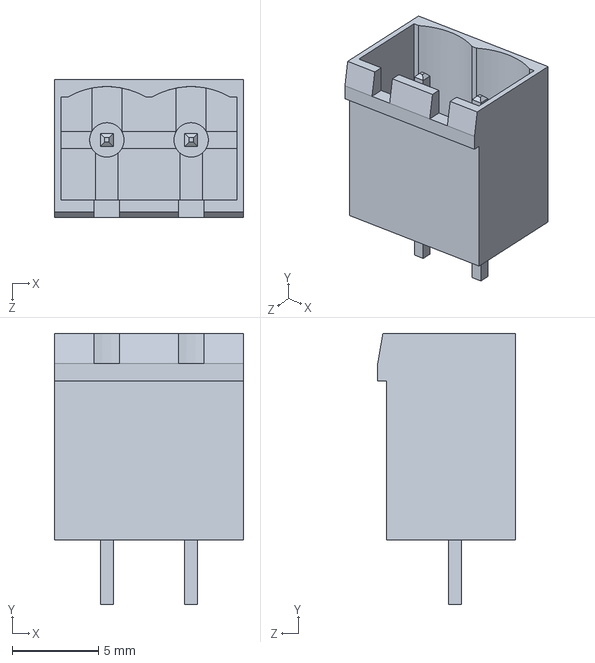
[picture p138: CAD file, 2013-01-31]
_Hard/_Libraries_Docs/Librairies_Altium_ROBOT/STEP/Connecteur_Alim_7V.STEP
11.0 x 15.8 x 8.00 mm
