samuelpoiraud/robot/_Hard/_Libraries_Docs/Librairies_Altium_ROBOT/STEP/USB_Mini_B_SMD.step

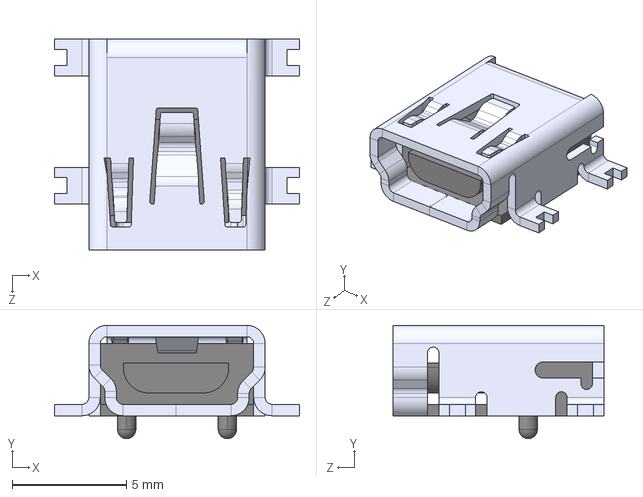
[picture p139: CAD file, 2013-01-31]
_Hard/_Libraries_Docs/Librairies_Altium_ROBOT/STEP/USB_Mini_B_SMD.step
10.7 x 4.95 x 9.20 mm
