samuelpoiraud/robot/_Hard/_Libraries_Docs/Librairies_Altium_ROBOT/STEP/SWITCH8.step

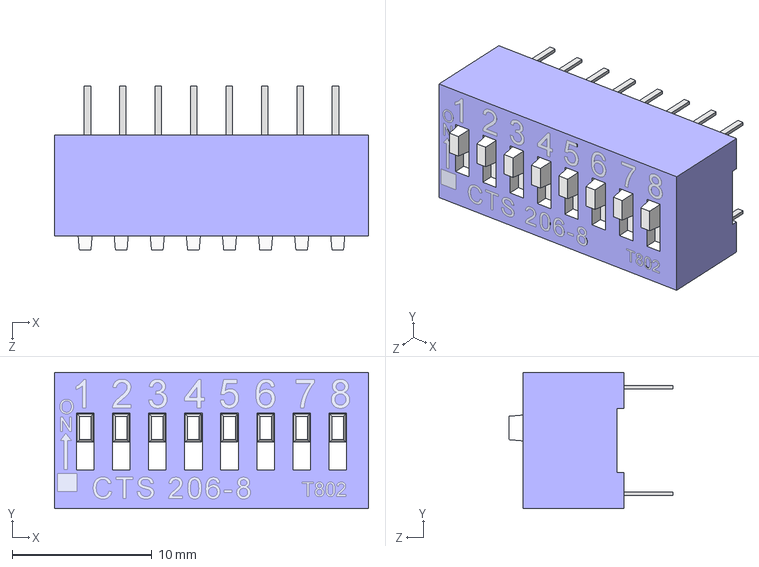
[picture p140: CAD file, 2013-01-31]
_Hard/_Libraries_Docs/Librairies_Altium_ROBOT/STEP/SWITCH8.step
22.5 x 9.78 x 11.8 mm
