samuelpoiraud/robot/_Hard/_Libraries_Docs/Librairies_Altium_ROBOT/STEP/diode_smd_rect.step

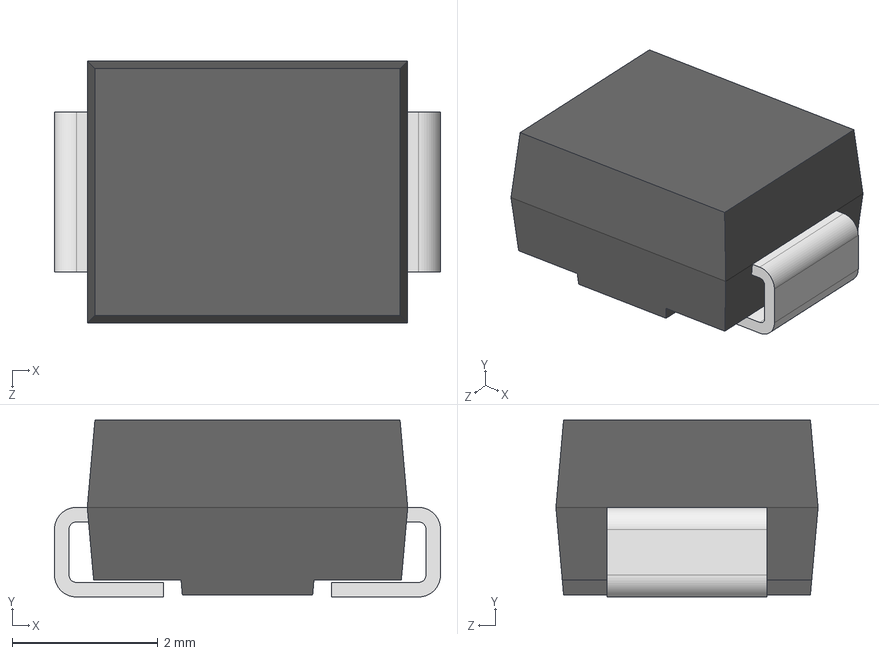
[picture p144: CAD file, 2013-01-31]
_Hard/_Libraries_Docs/Librairies_Altium_ROBOT/STEP/diode_smd_rect.step
5.30 x 2.43 x 3.60 mm
