samuelpoiraud/robot/_Hard/_Libraries_Docs/Librairies_Altium_ROBOT/STEP/1206 SMD Capacitor.step

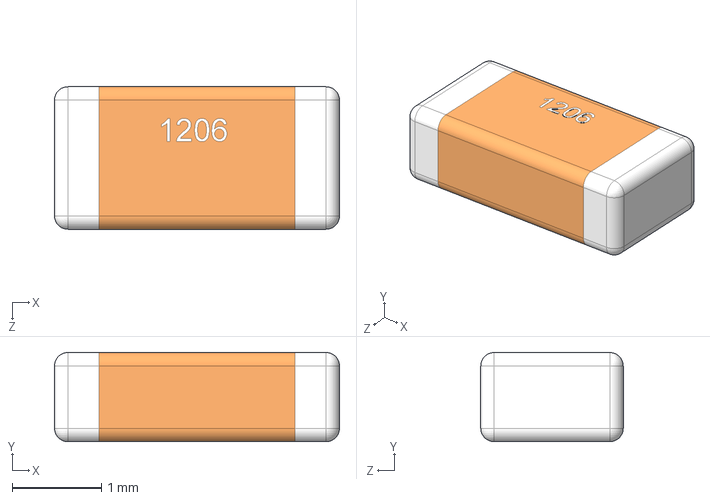
[picture p145: CAD file, 2013-01-31]
_Hard/_Libraries_Docs/Librairies_Altium_ROBOT/STEP/1206 SMD Capacitor.step
3.20 x 1.00 x 1.60 mm
