samuelpoiraud/robot/_Hard/_Libraries_Docs/Librairies_Altium_ROBOT/STEP/USB_Mini_B.step

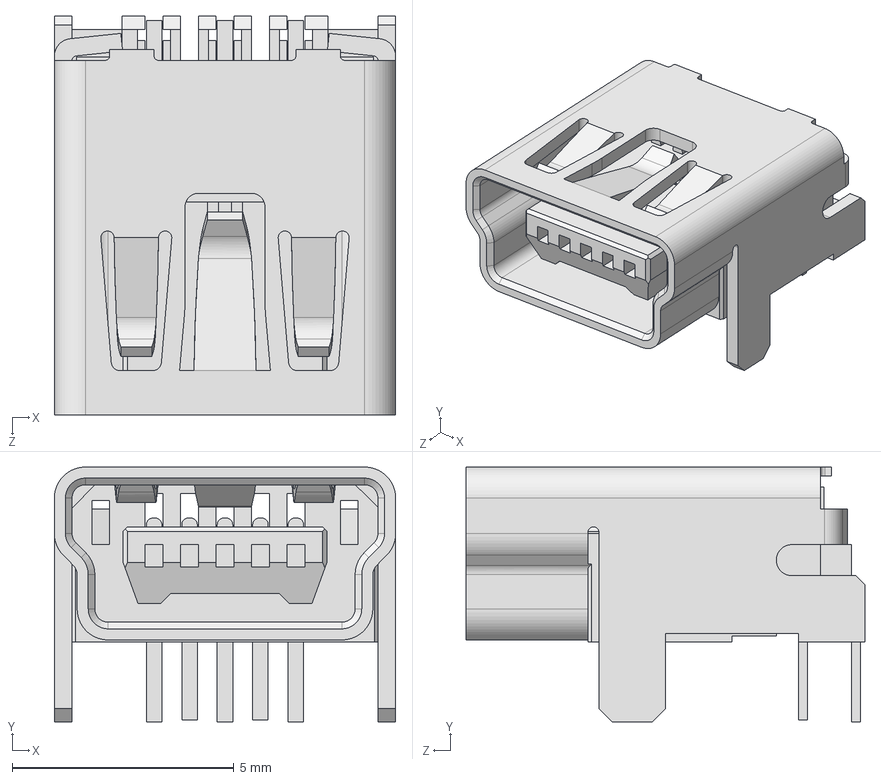
[picture p148: CAD file, 2013-01-31]
_Hard/_Libraries_Docs/Librairies_Altium_ROBOT/STEP/USB_Mini_B.step
7.70 x 5.75 x 9.00 mm
