samuelpoiraud/robot/_Hard/_Libraries_Docs/Librairies_Altium_ROBOT/STEP/Header_20_Box.step

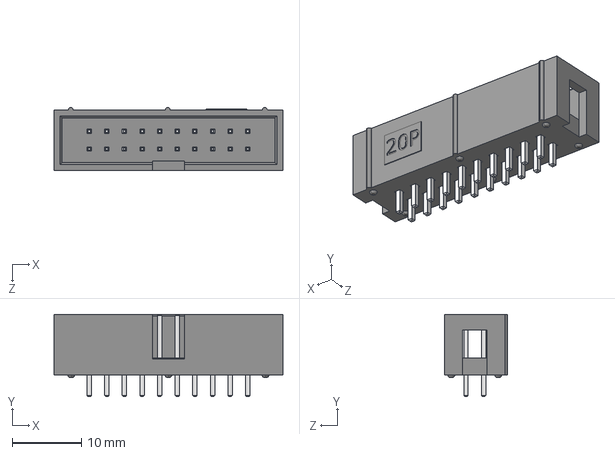
[picture p149: CAD file, 2013-01-31]
_Hard/_Libraries_Docs/Librairies_Altium_ROBOT/STEP/Header_20_Box.step
33.0 x 11.8 x 9.10 mm
