samuelpoiraud/robot/_Hard/_Libraries_Docs/Librairies_Altium_ROBOT/STEP/Touche_KSA.STEP

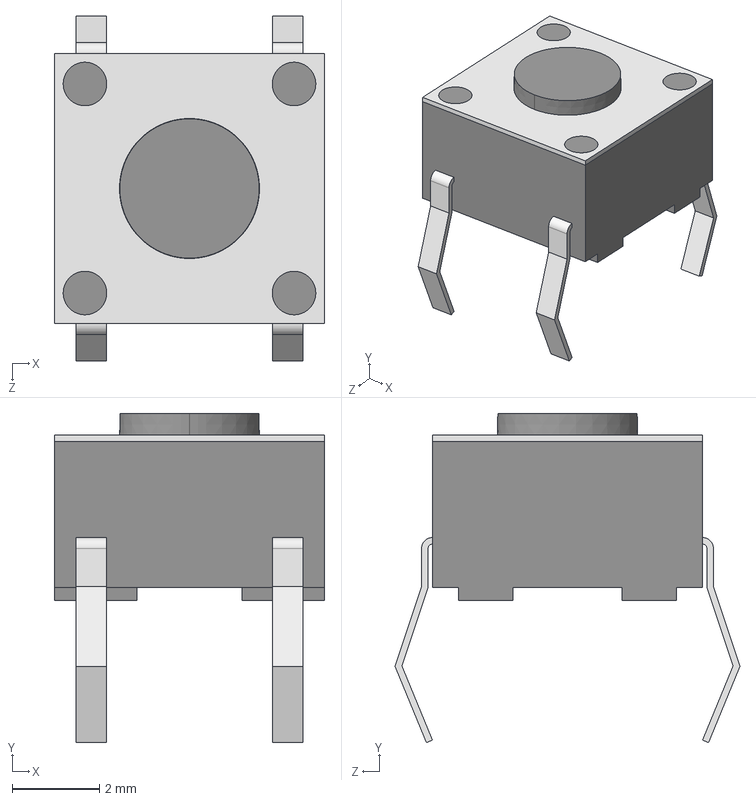
[picture p150: CAD file, 2013-01-31]
_Hard/_Libraries_Docs/Librairies_Altium_ROBOT/STEP/Touche_KSA.STEP
6.20 x 7.56 x 7.92 mm
