samuelpoiraud/robot/_Hard/_Libraries_Docs/Librairies_Altium_ROBOT/STEP/SMD_diode.step

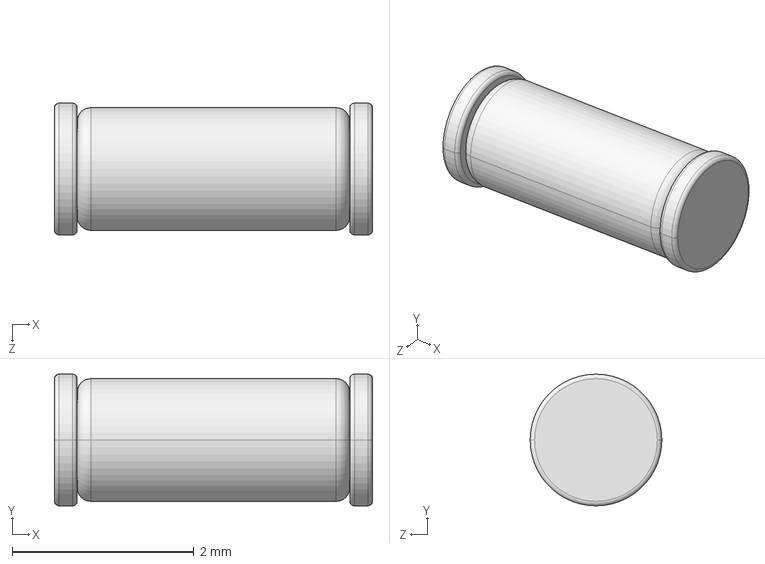
[picture p152: CAD file, 2013-01-31]
_Hard/_Libraries_Docs/Librairies_Altium_ROBOT/STEP/SMD_diode.step
3.50 x 1.45 x 1.45 mm
