samuelpoiraud/robot/_Hard/_Libraries_Docs/Librairies_Altium_ROBOT/STEP/DIPSWITCH2.step

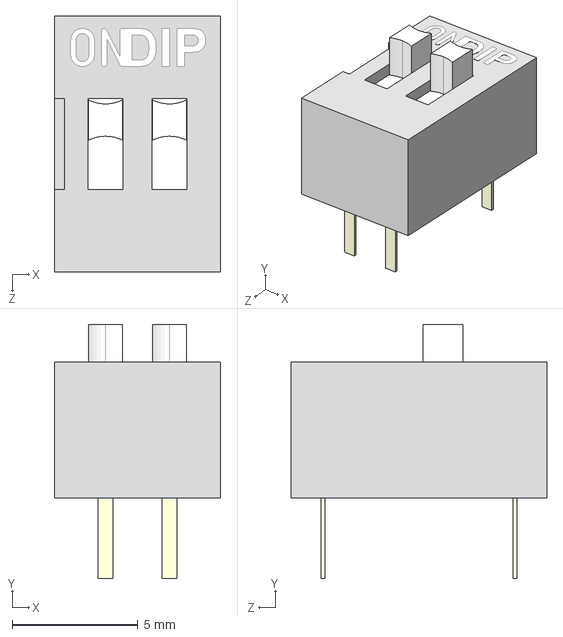
[picture p153: CAD file, 2013-01-31]
_Hard/_Libraries_Docs/Librairies_Altium_ROBOT/STEP/DIPSWITCH2.step
6.60 x 10.1 x 10.2 mm
