samuelpoiraud/robot/_Hard/_Libraries_Docs/Librairies_Altium_ROBOT/STEP/shielded_inductor.STEP

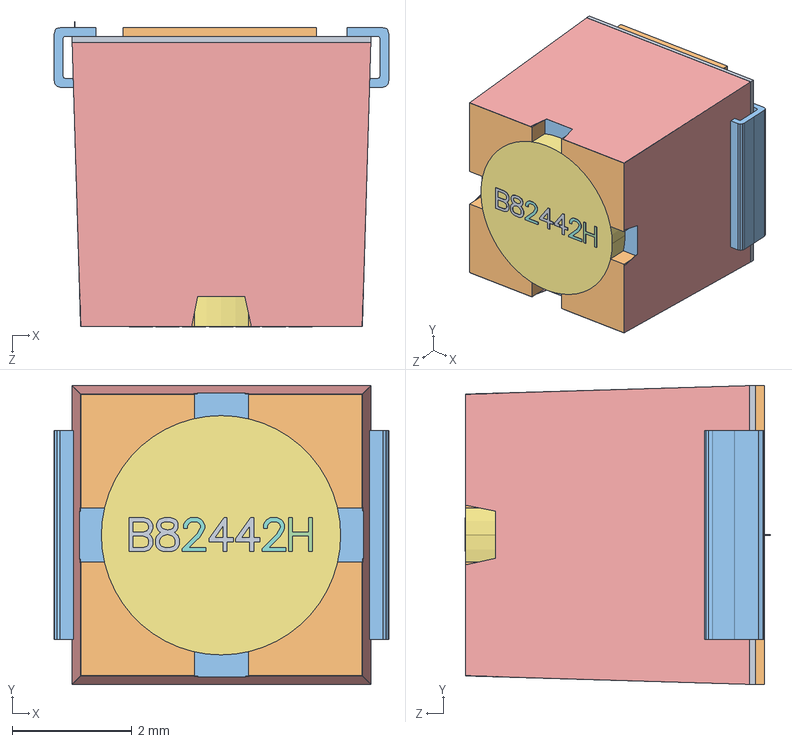
[picture p158: CAD file, 2013-01-31]
_Hard/_Libraries_Docs/Librairies_Altium_ROBOT/STEP/shielded_inductor.STEP
5.60 x 5.00 x 5.11 mm
SW3dPS-B82442H_Extruded17
SW3dPS-B82442H_Extruded14 x 4
SW3dPS-B82442H_Extruded19 x 2
SW3dPS-B82442H_Extruded21
SW3dPS-B82442H_Extruded20
SW3dPS-B82442H_Extruded15
SW3dPS-B82442H_Extruded16 x 4
SW3dPS-B82442H_Board3 x 4
SW3dPS-B82442H_Cylinder1
SW3dPS-B82442H_Extruded13 x 2
SW3dPS-B82442H_Extruded12
SW3dPS-B82442H_Extruded22
SW3dPS-B82442H_Board4
SW3dPS-B82442H_Extruded23
SW3dPS-B82442H_Extruded18
SW3dPS-B82442H_Board5
