samuelpoiraud/robot/_Hard/_Libraries_Docs/Librairies_Altium_ROBOT/STEP/Bouton poussoir.STEP

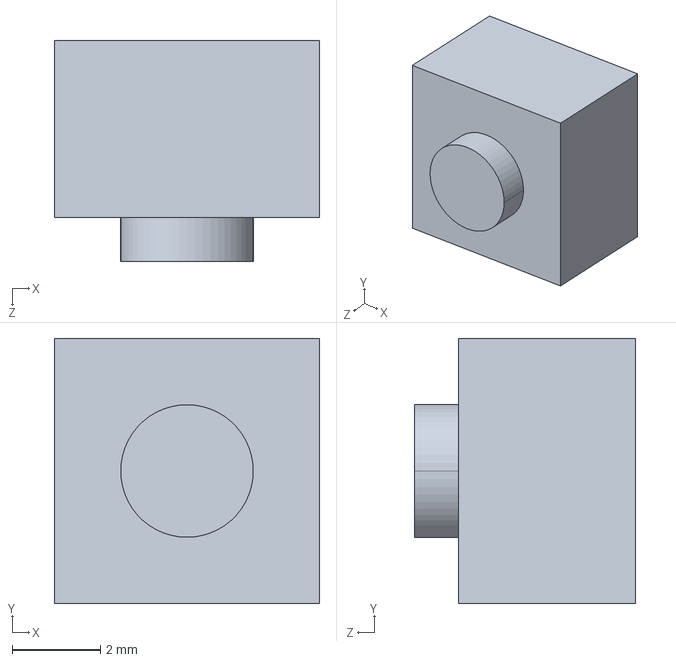
[picture p159: CAD file, 2013-01-31]
_Hard/_Libraries_Docs/Librairies_Altium_ROBOT/STEP/Bouton poussoir.STEP
6.00 x 6.00 x 5.00 mm
