samuelpoiraud/robot/_Hard/_Libraries_Docs/Librairies_Altium_ROBOT/STEP/SOT-23-6.step

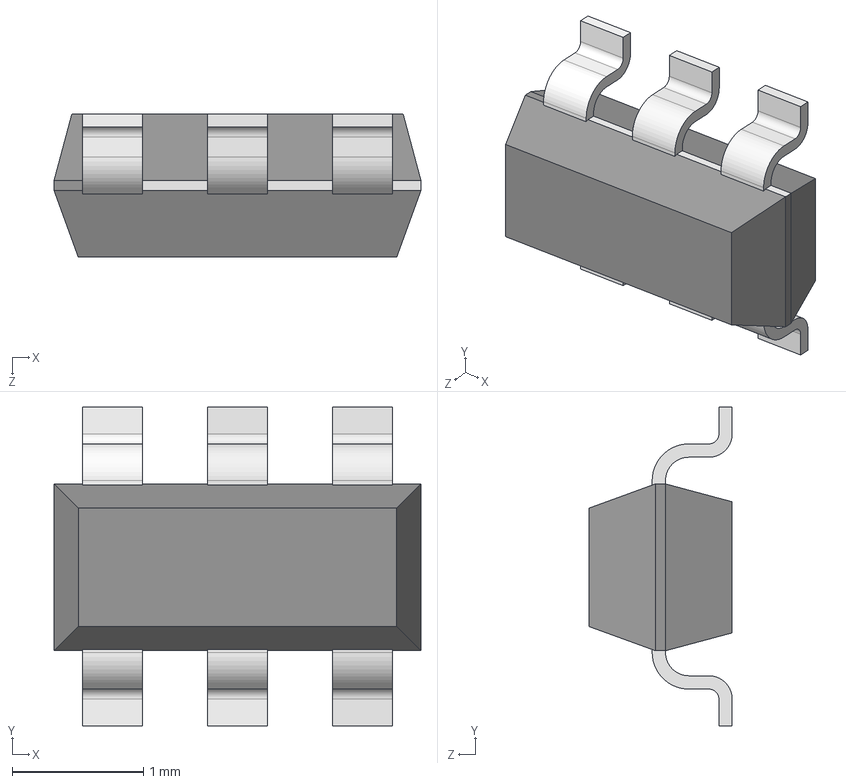
[picture p160: CAD file, 2013-01-31]
_Hard/_Libraries_Docs/Librairies_Altium_ROBOT/STEP/SOT-23-6.step
2.79 x 2.43 x 1.09 mm
