samuelpoiraud/robot/_Hard/_Libraries_Docs/Librairies_Altium_ROBOT/STEP/RJ12.STEP

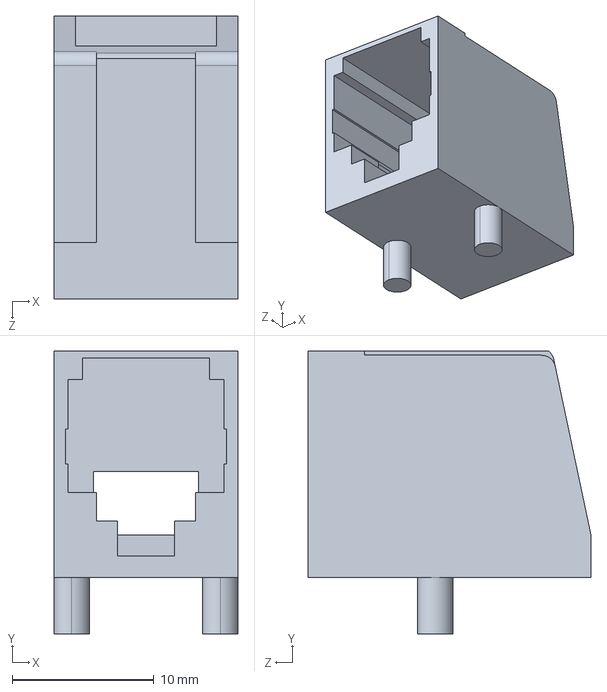
[picture p161: CAD file, 2013-01-31]
_Hard/_Libraries_Docs/Librairies_Altium_ROBOT/STEP/RJ12.STEP
13.0 x 20.0 x 20.0 mm
