samuelpoiraud/robot/(list of files, cad)

Other CAD files:
_Hard/_Libraries_Docs/Librairies_Altium_ROBOT/STEP/0805 SMD Capacitor.step
_Hard/_Libraries_Docs/Librairies_Altium_ROBOT/STEP/1206 SMD Resistor.step
_Hard/_Libraries_Docs/Librairies_Altium_ROBOT/STEP/TO-247H.SLDPRT
