samuelpoiraud/robot/_Hard/2017_IHM/2017_IHM.PDF

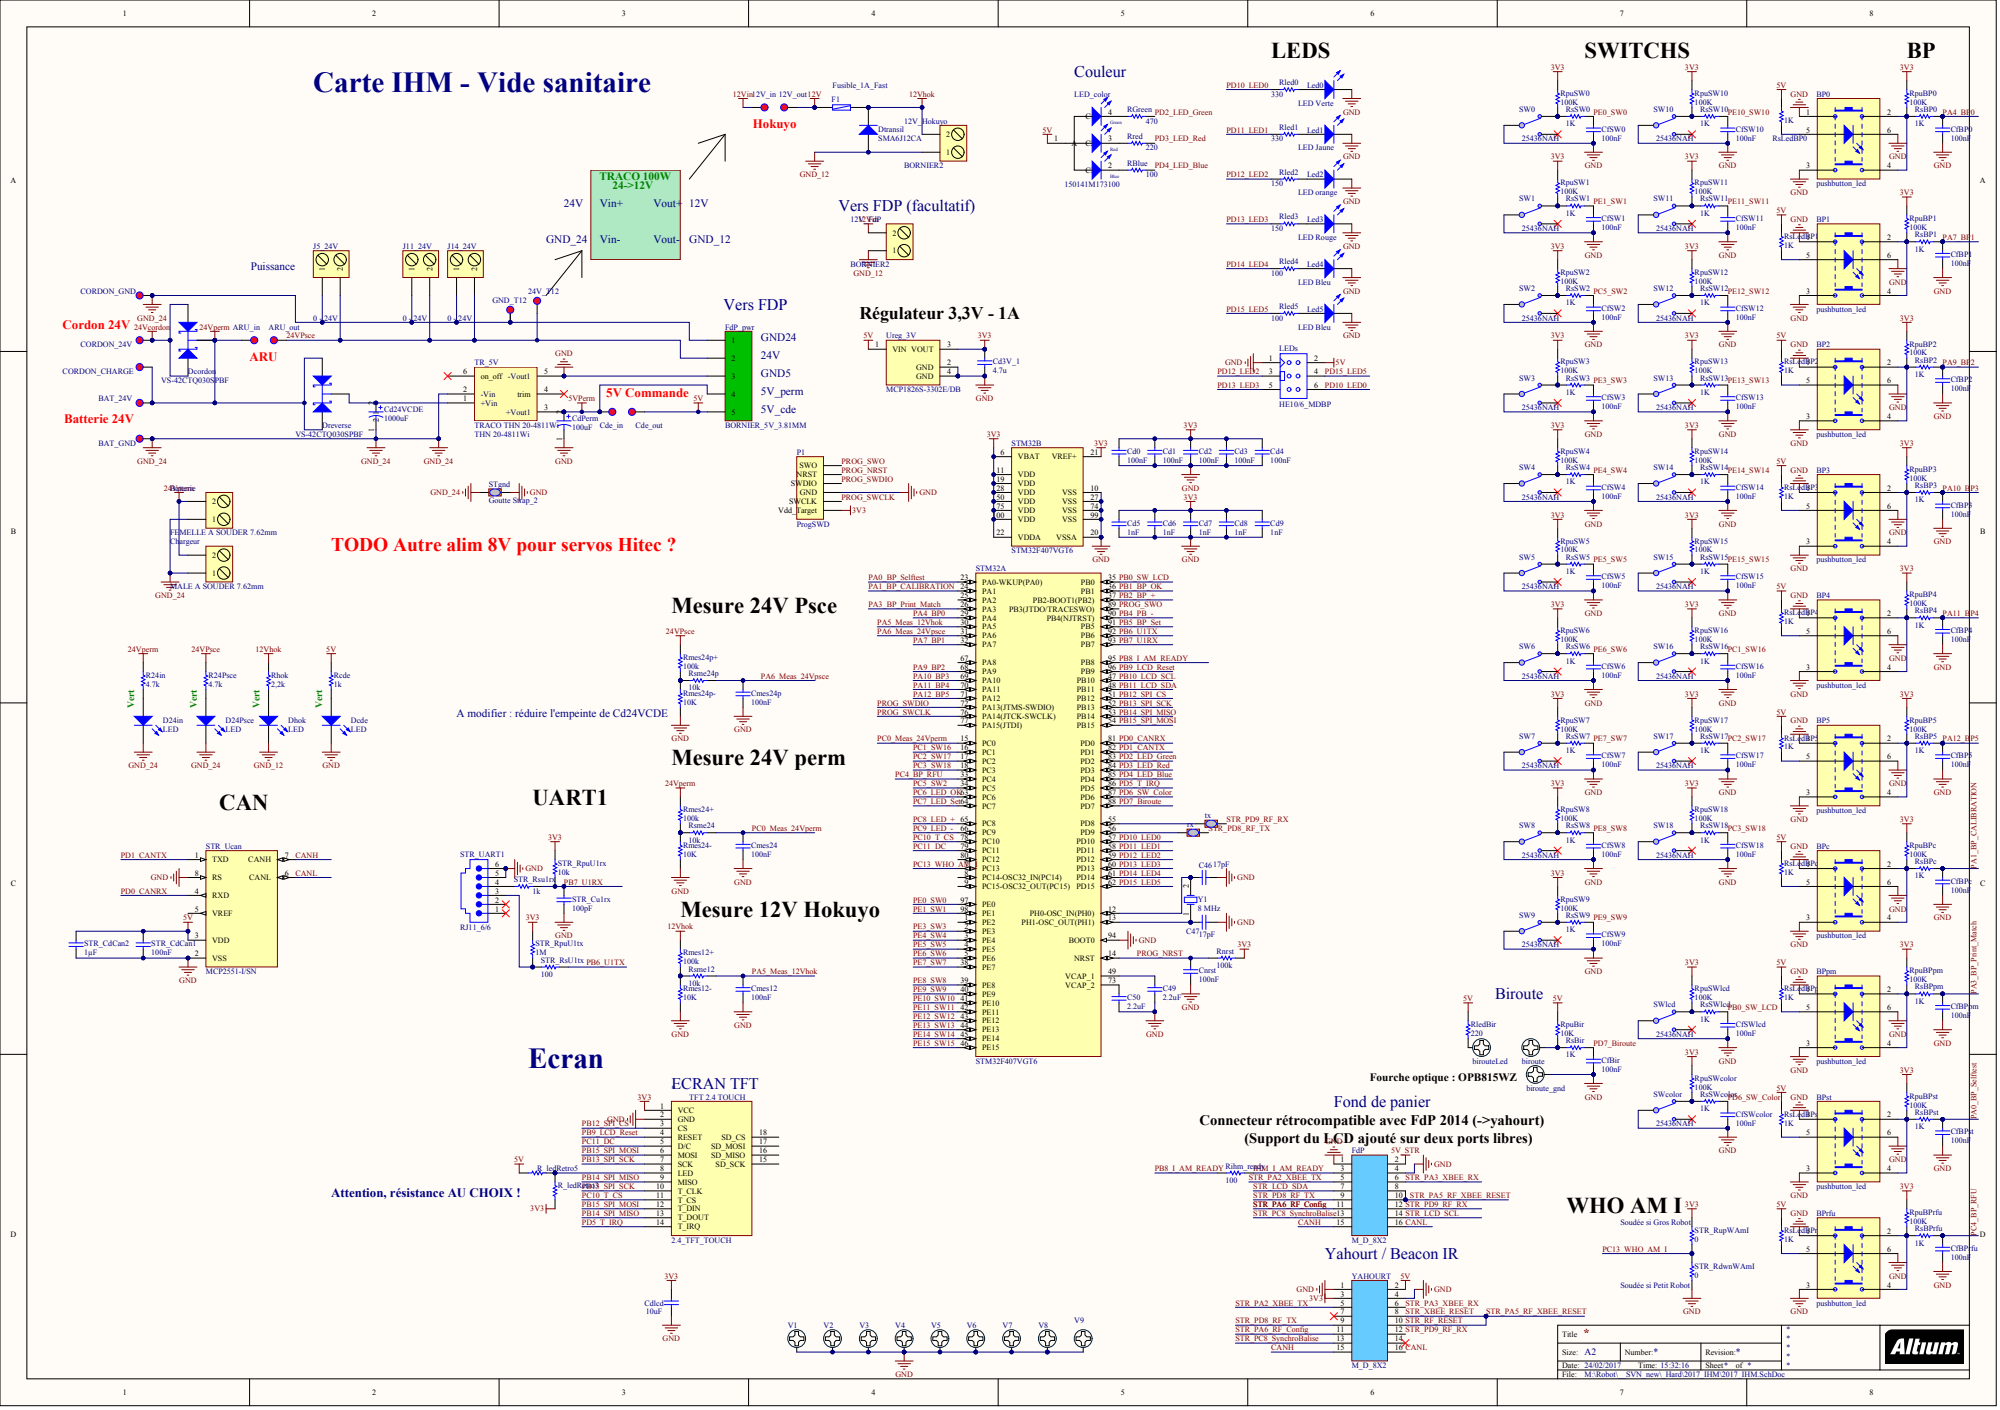
[picture p190: page 1]

Carte IHM - Vide sanitaire

TODO Autre alim 8V pour servos Hitec ?

A modifier : réduire l'empeinte de Cd24VCDE

Connecteur rétrocompatible avec FdP 2014 (->yahourt)

(Support du LCD ajouté sur deux ports libres)

Attention, résistance AU CHOIX !

Soudée si Gros Robot

Soudée si Petit Robot

Title * | * * * * *

Size: A2 | Number: * | Revision: *
Date: 24/02/2017 Time: 15:32:16 | | Sheet * of *

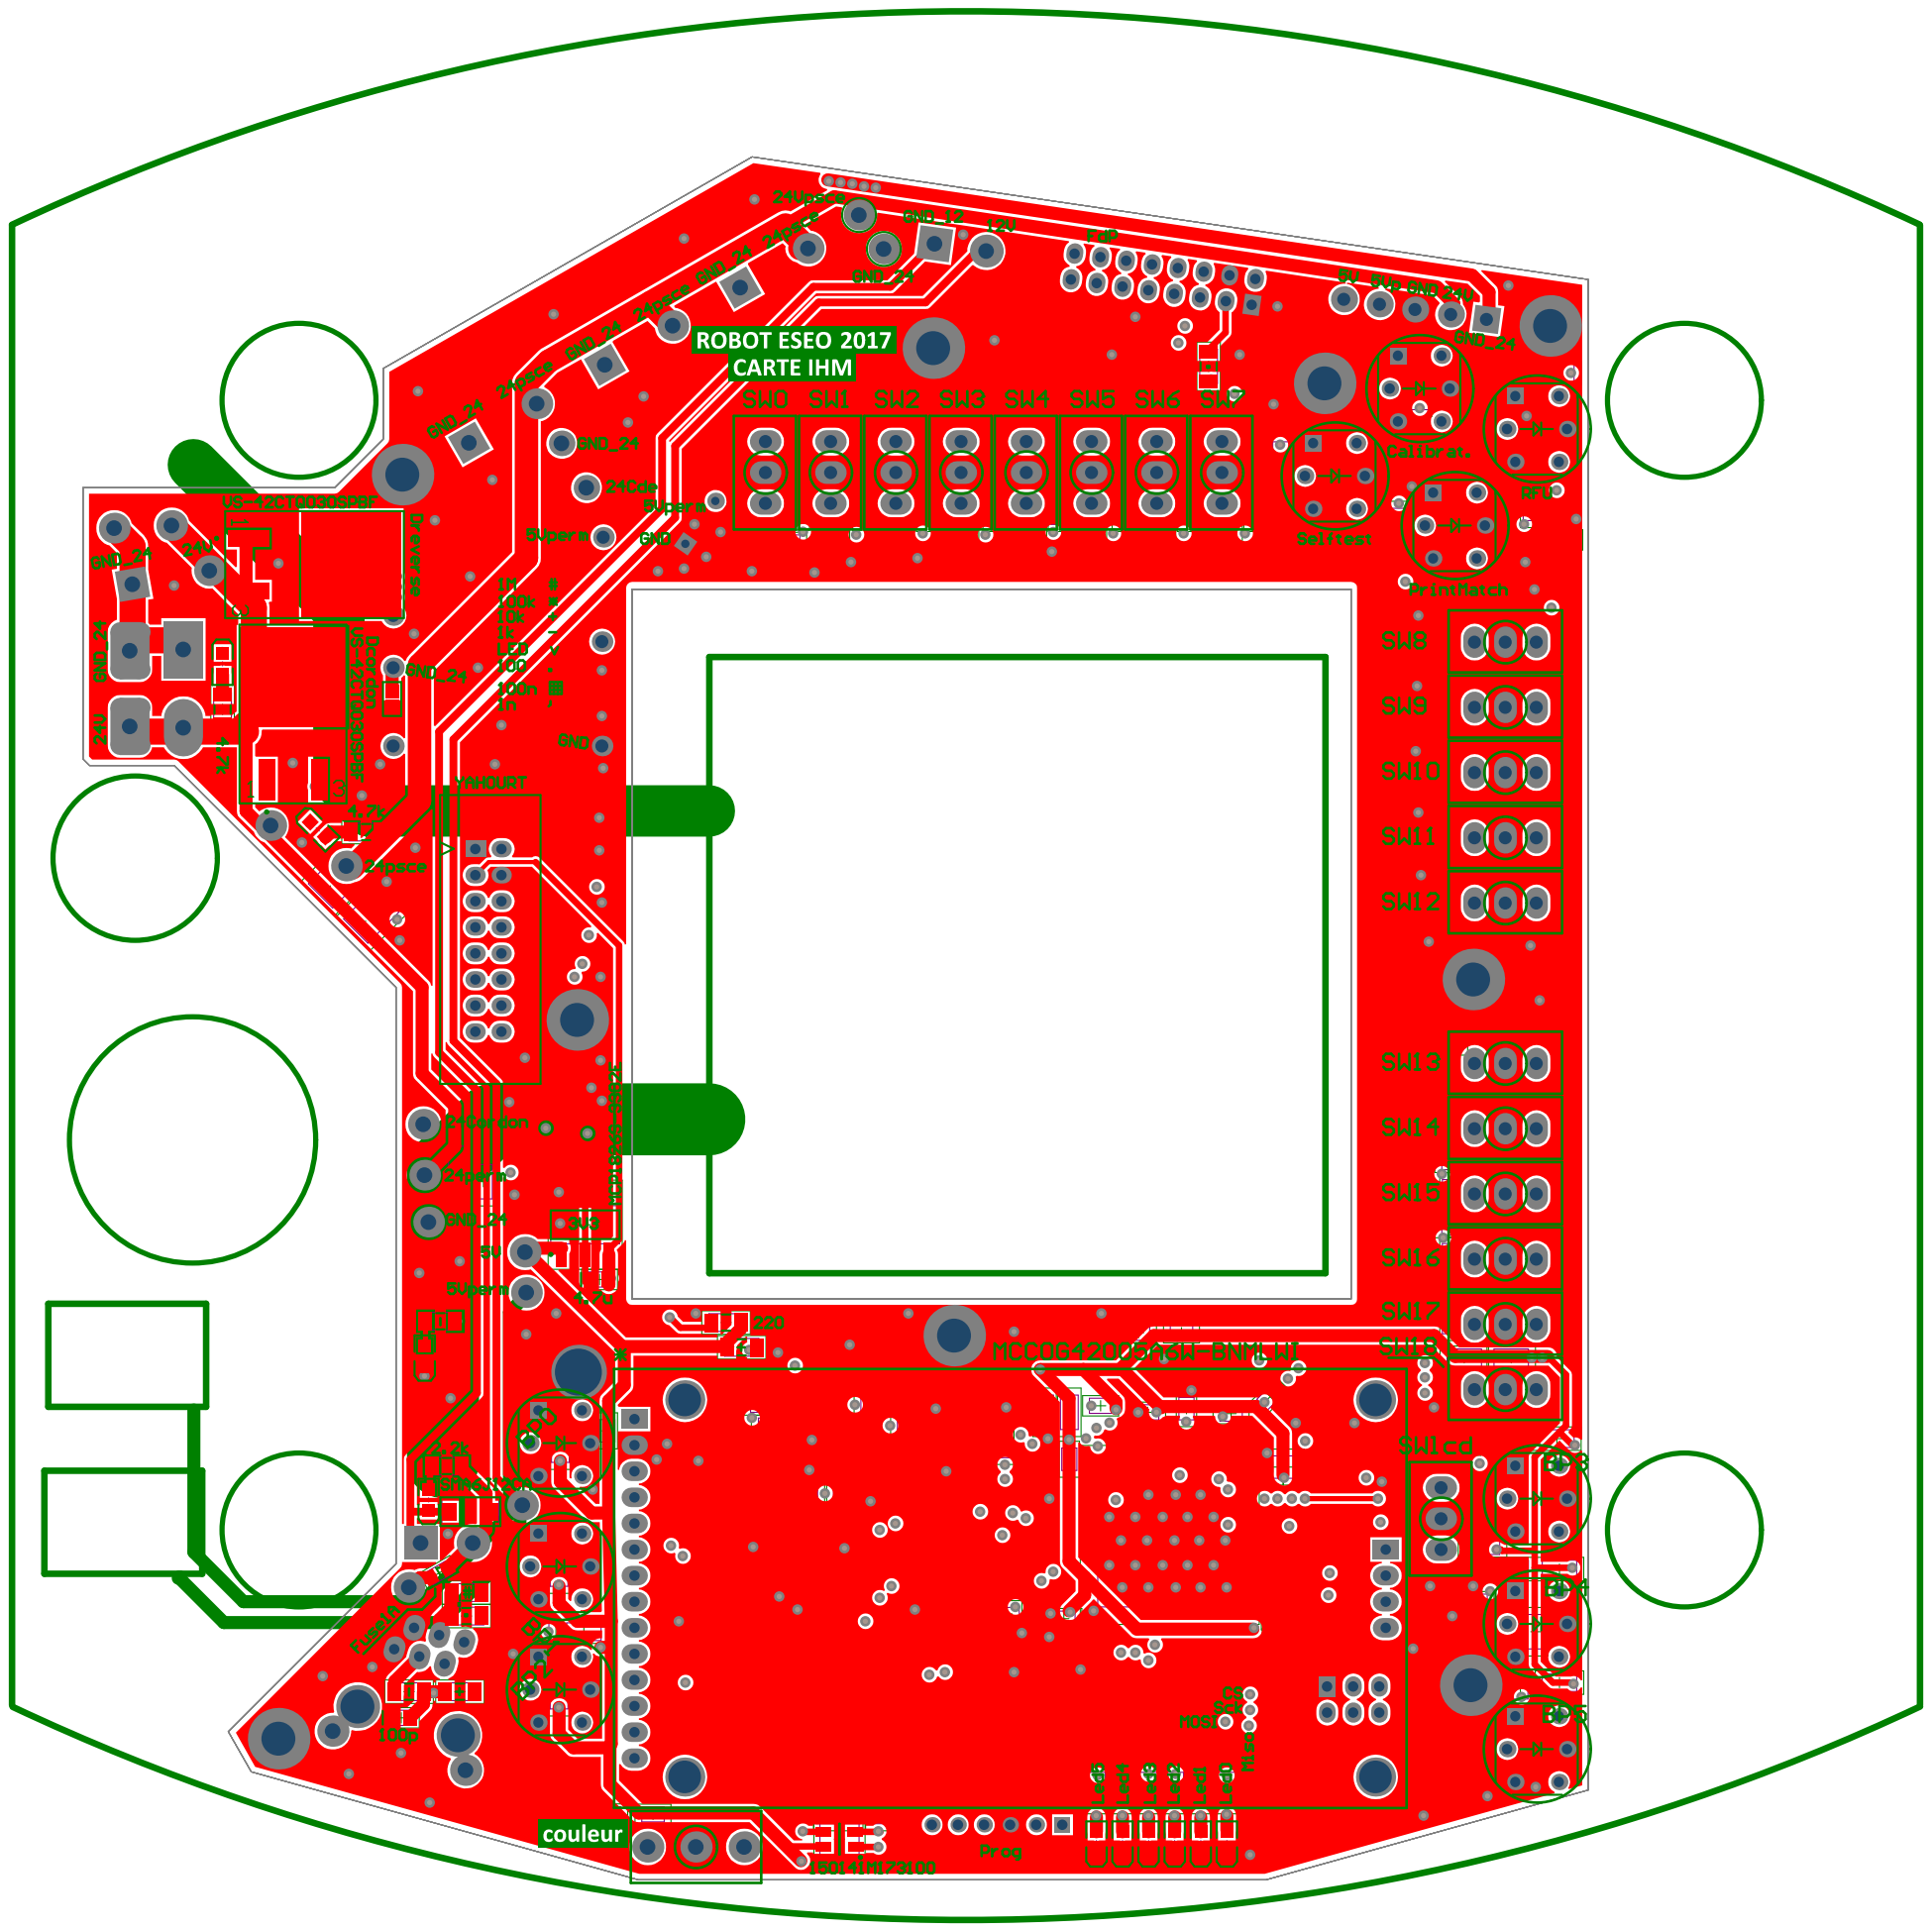
[picture p191: page 2]

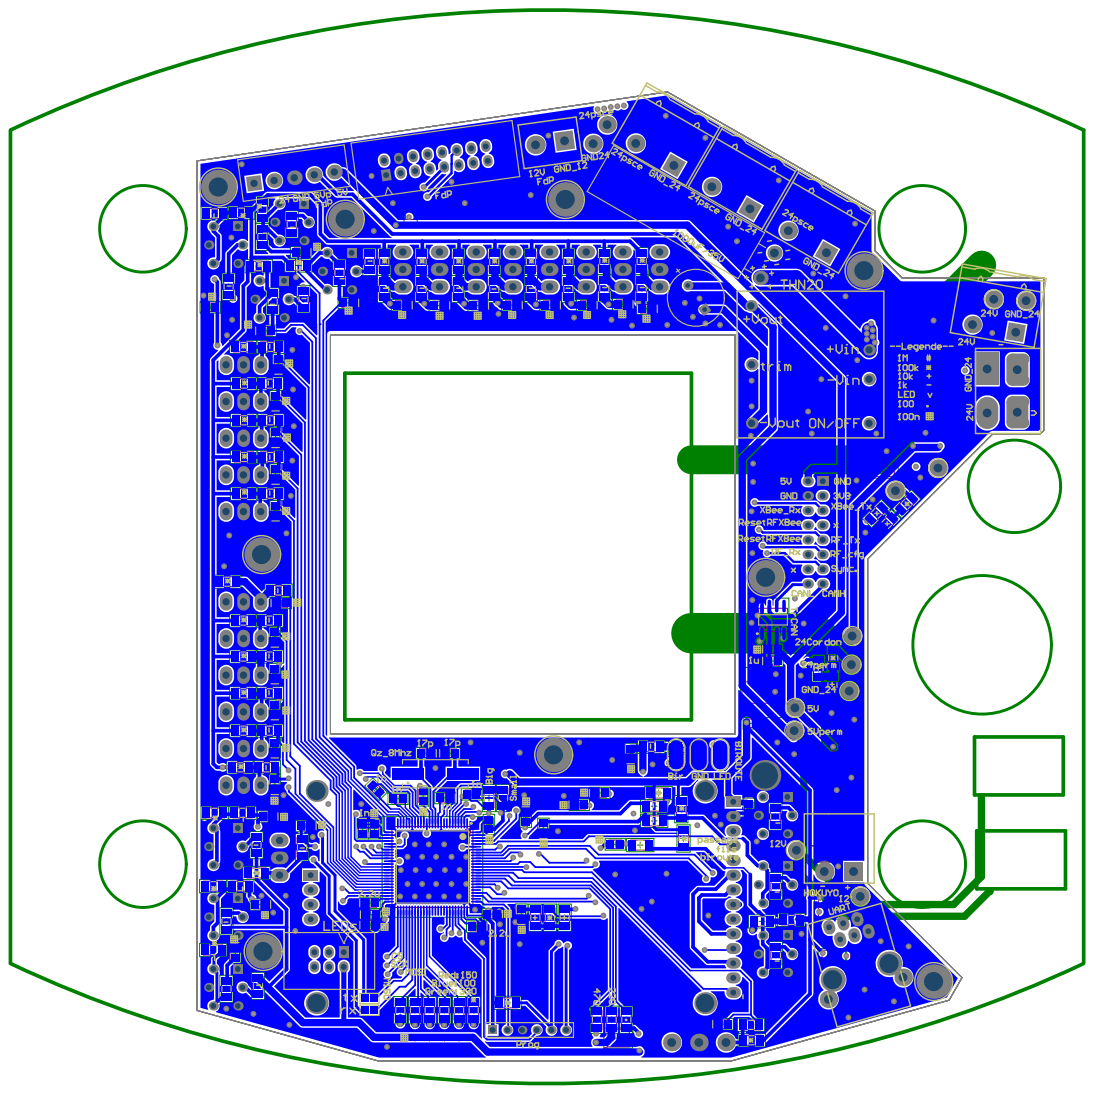
[picture p192: page 3]

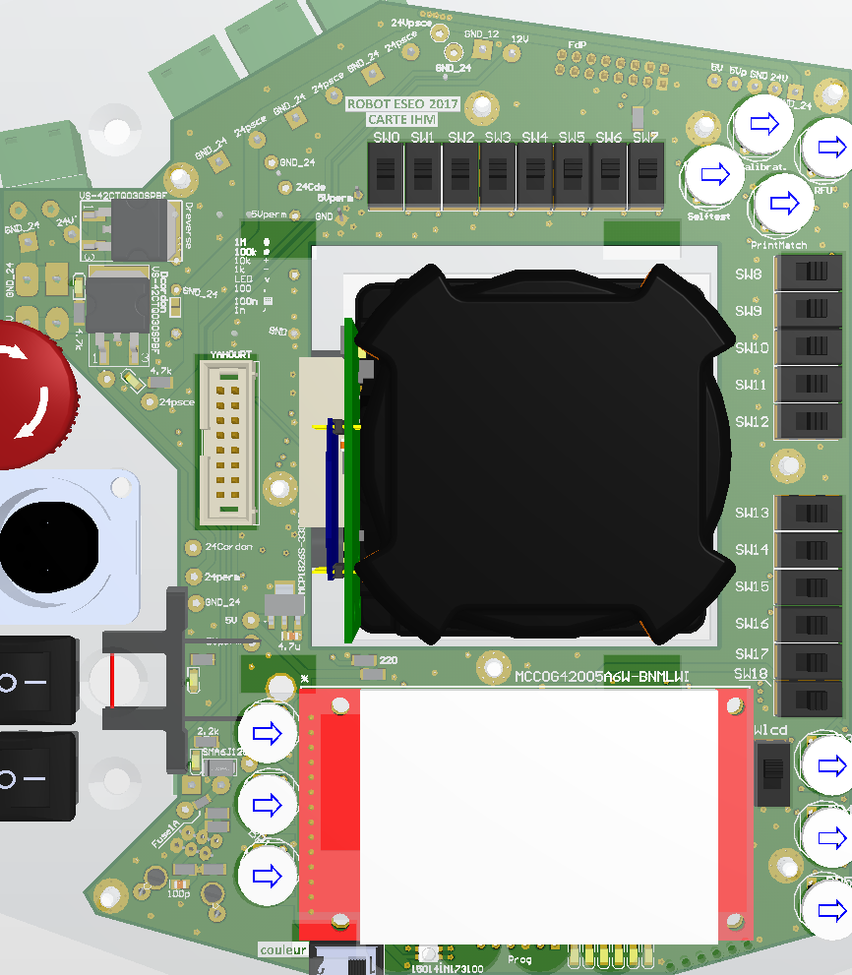
[picture p193: page 4]

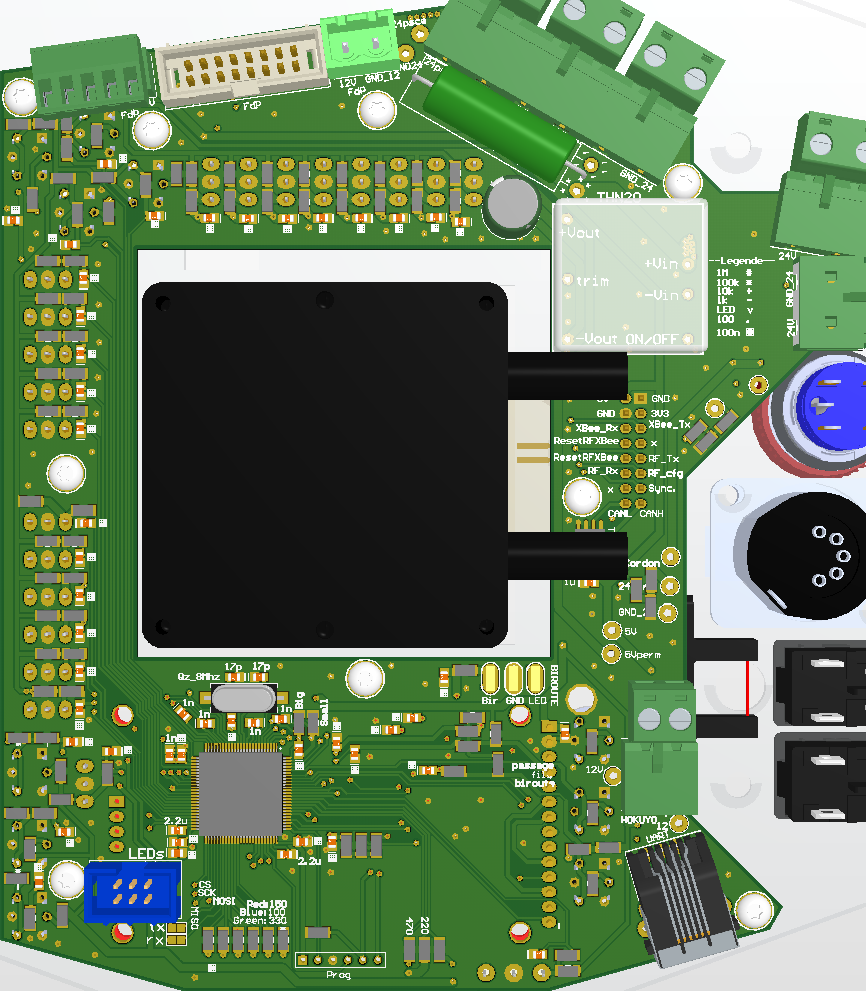
[picture p194: page 5]

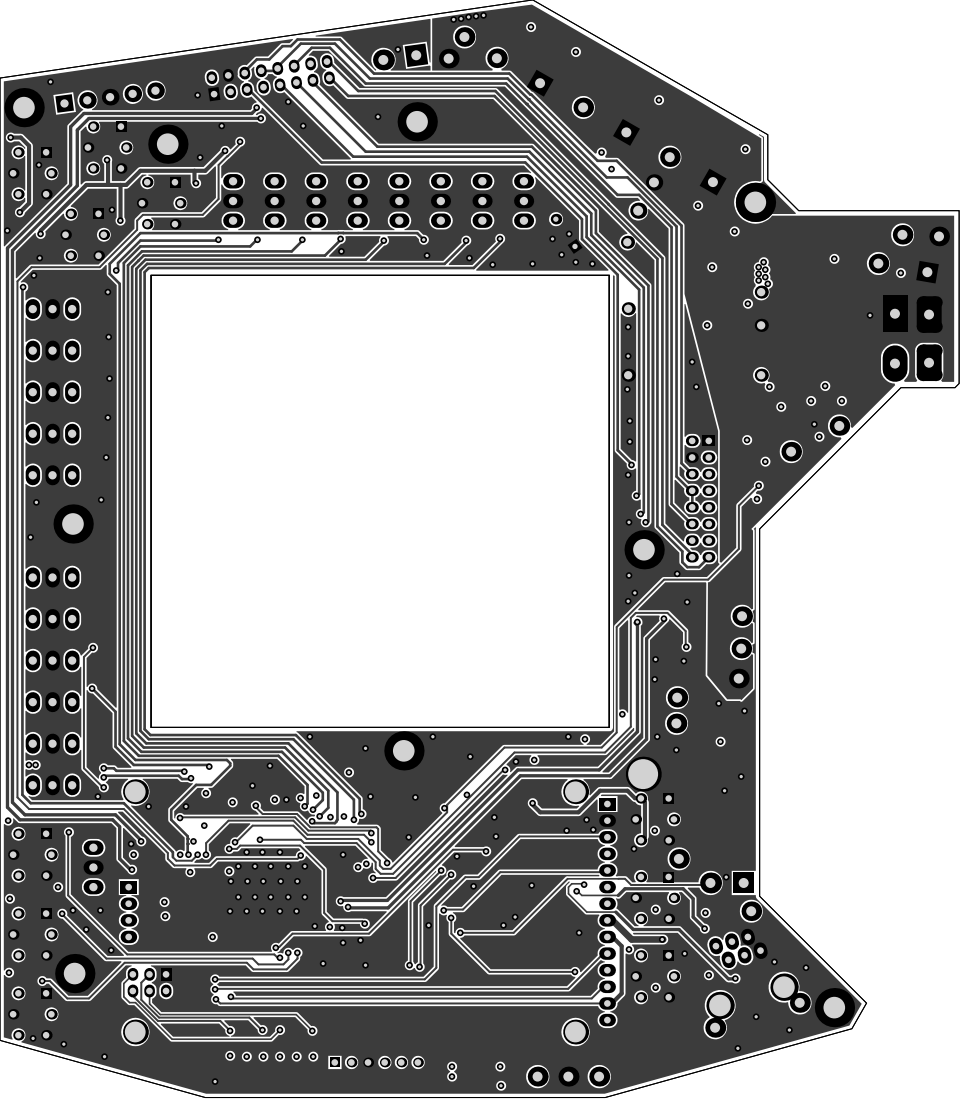
[picture p195: page 6]

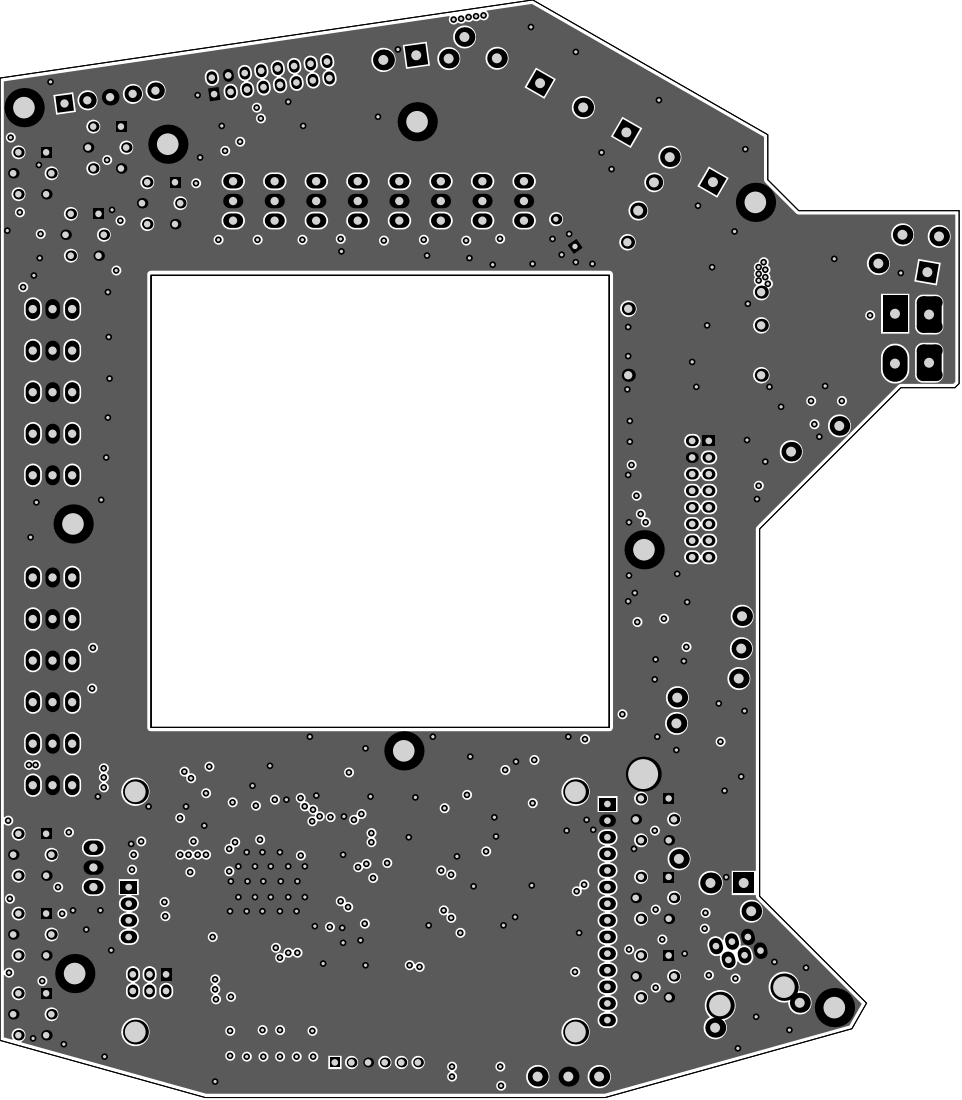
[picture p196: page 7]
