samuelpoiraud/robot/_Hard/2016_Beacon/2016_AdvBeacon.PDF

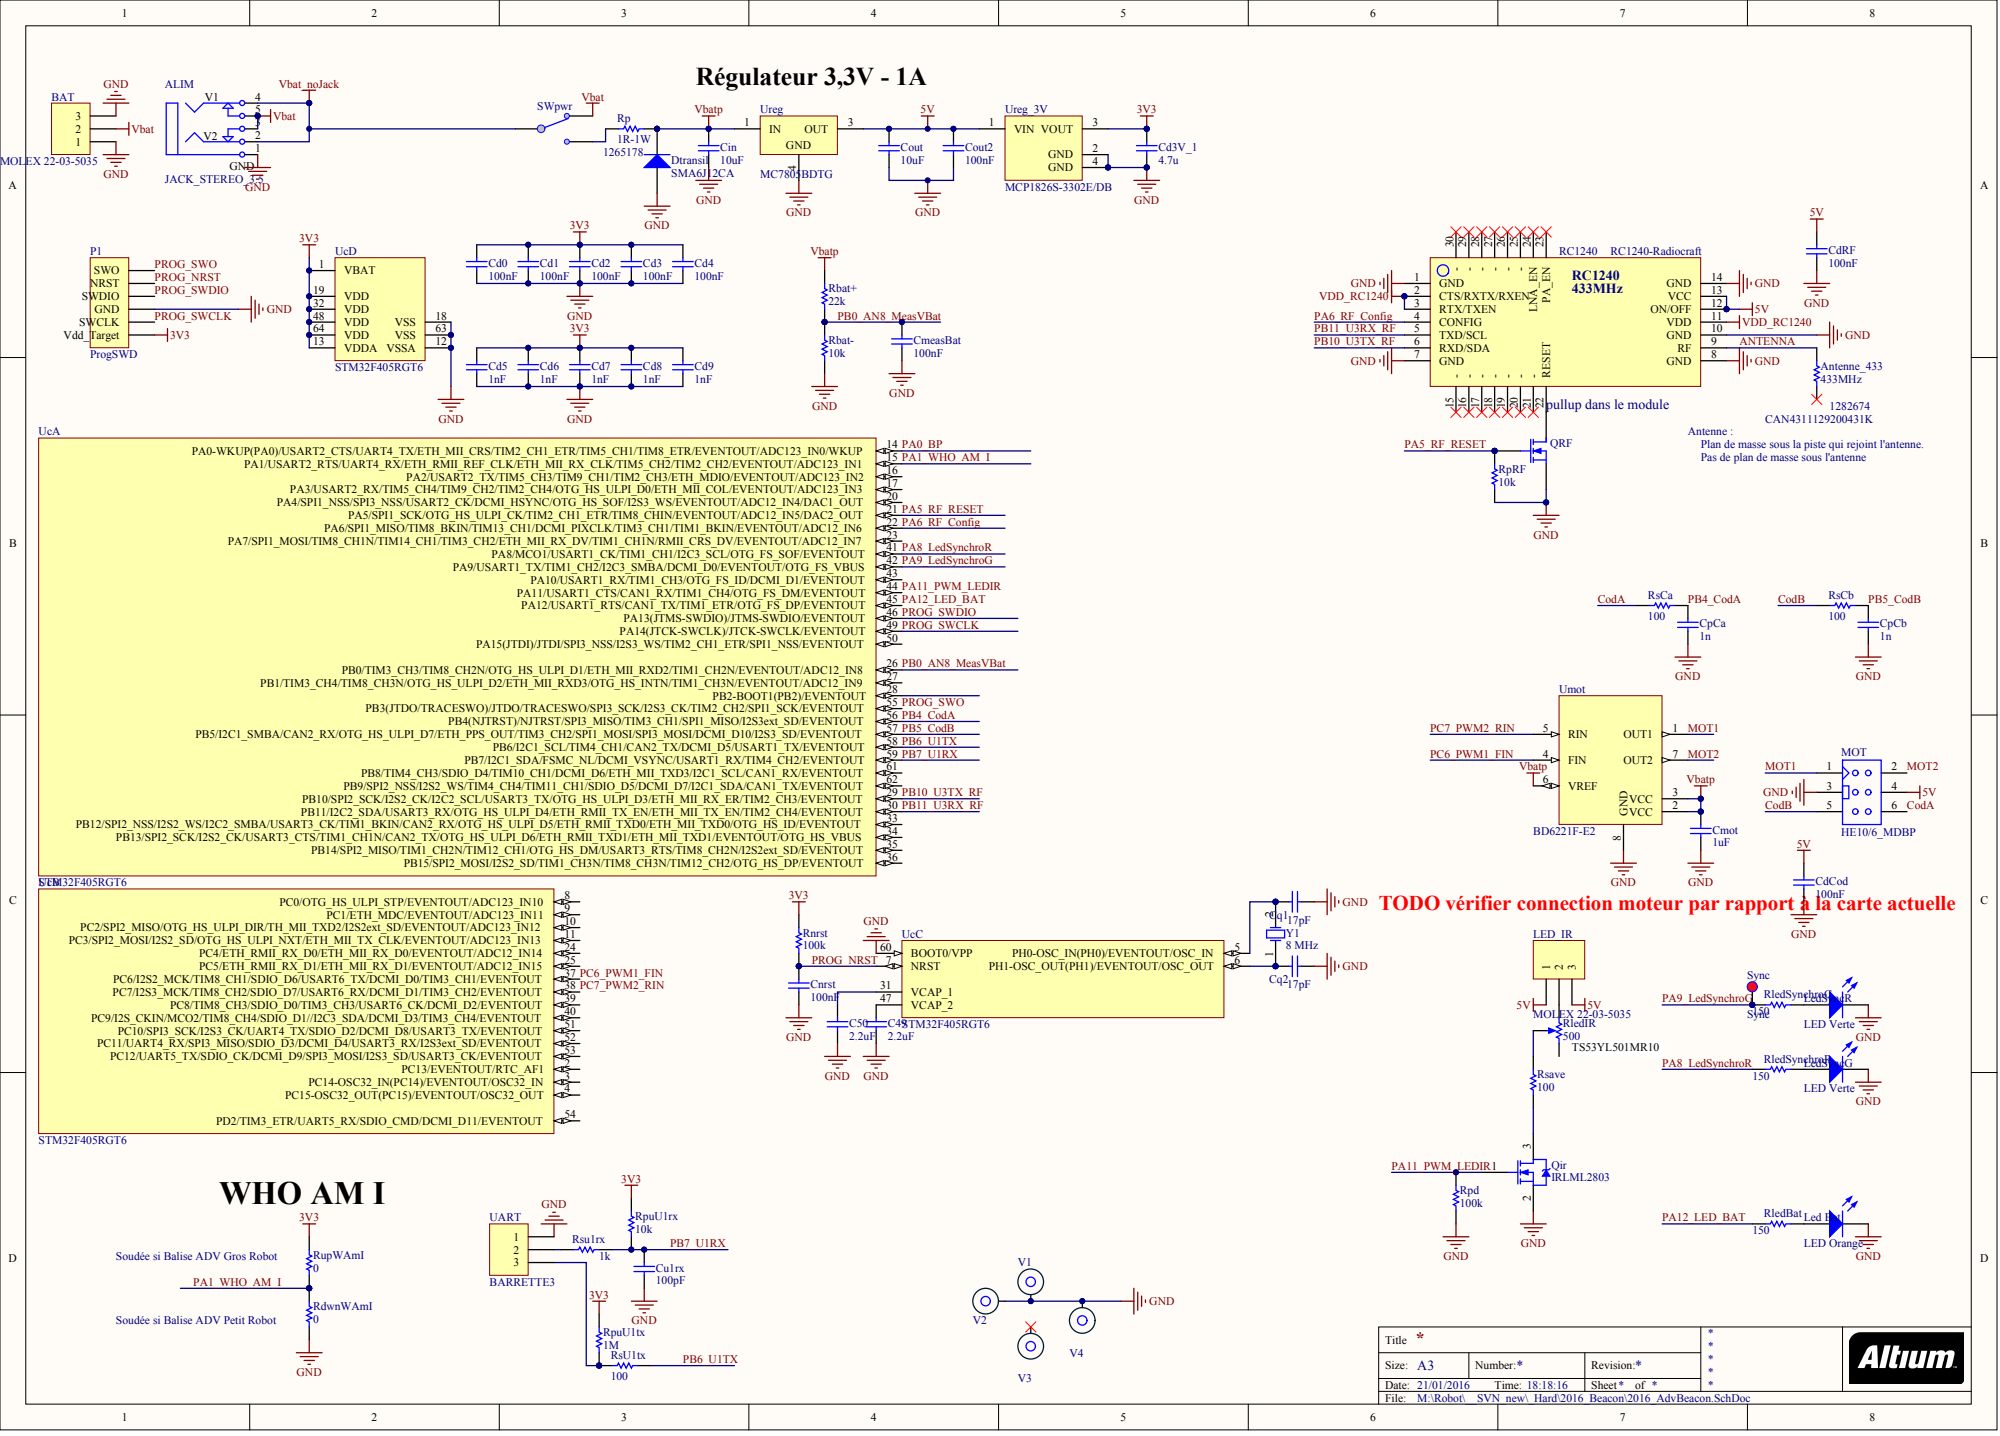
[picture p197: page 1]

pullup dans le module

Antenne :
Plan de masse sous la piste qui rejoint l'antenne.
Pas de plan de masse sous l'antenne

TODO vérifier connection moteur par rapport à la carte actuelle

LedSyncG LED Verte LedSyncR LED Verte

Led Bat LED Orang

Soudée si Balise ADV Gros Robot

Soudée si Balise ADV Petit Robot

Title * | **** *

Size: A3 | Number: * | Revision: *
Date: 21/01/2016 Time: 18:18:16 | | Sheet * of *

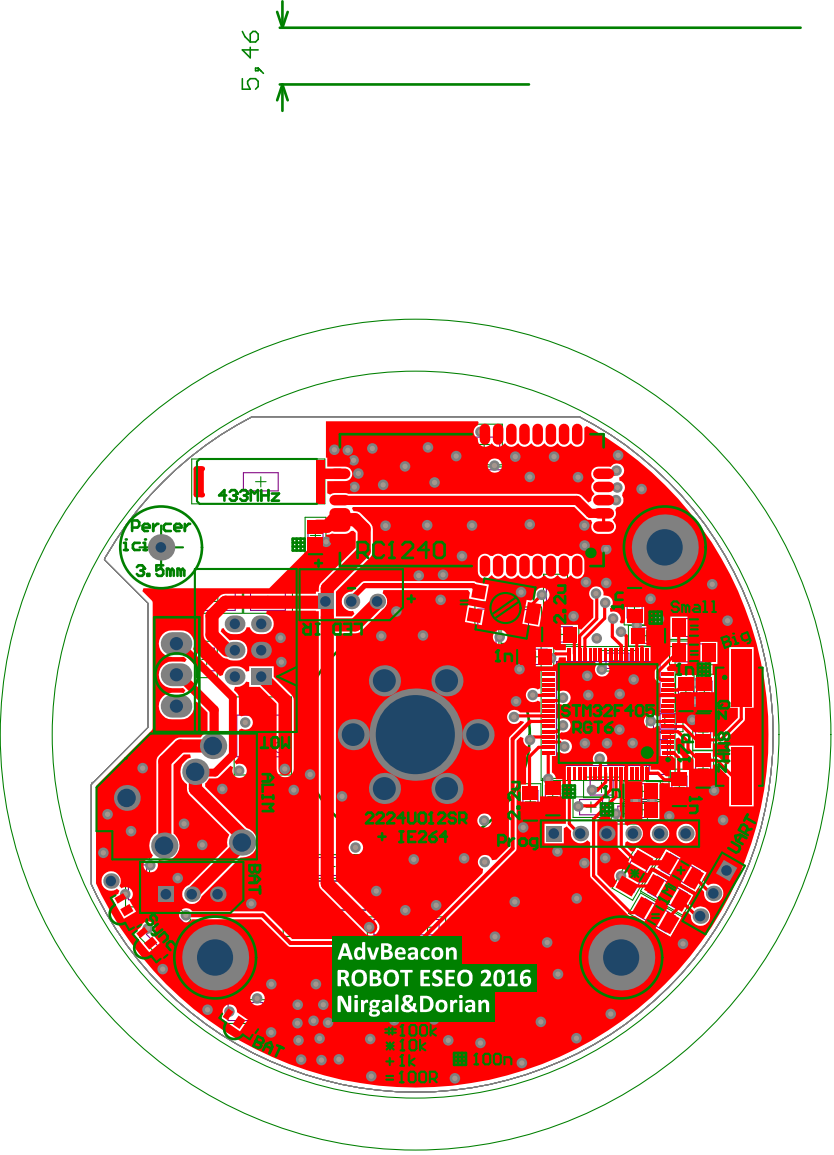
[picture p198: page 2]

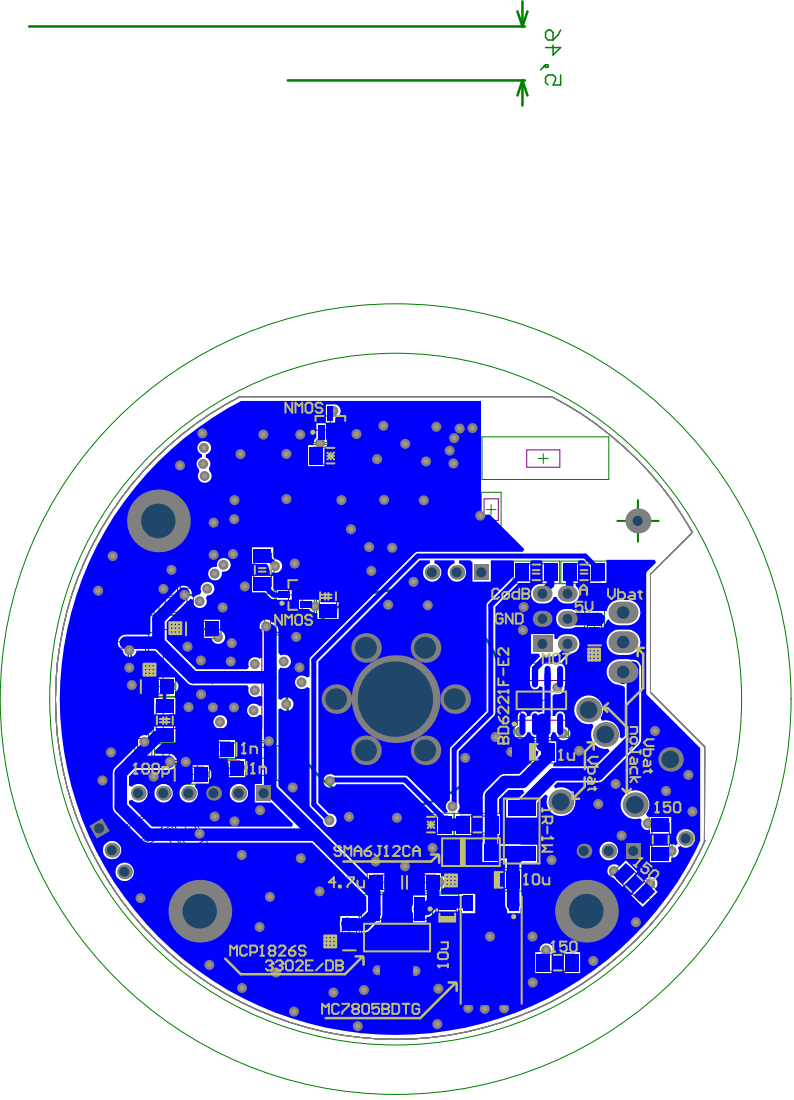
[picture p199: page 3]

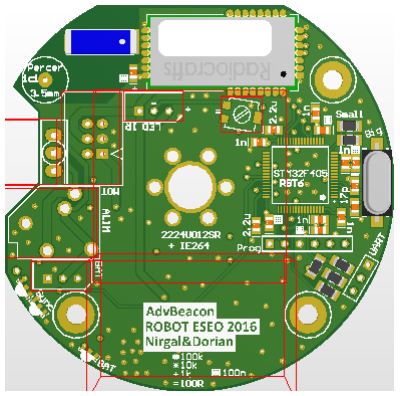
[picture p200: figure]

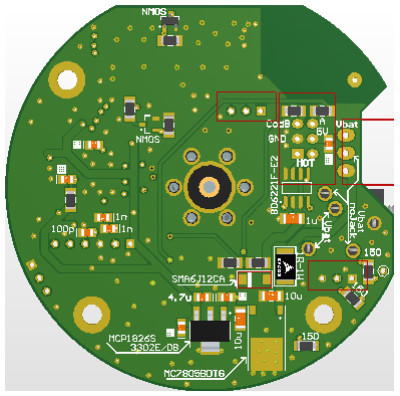
[picture p201: figure]
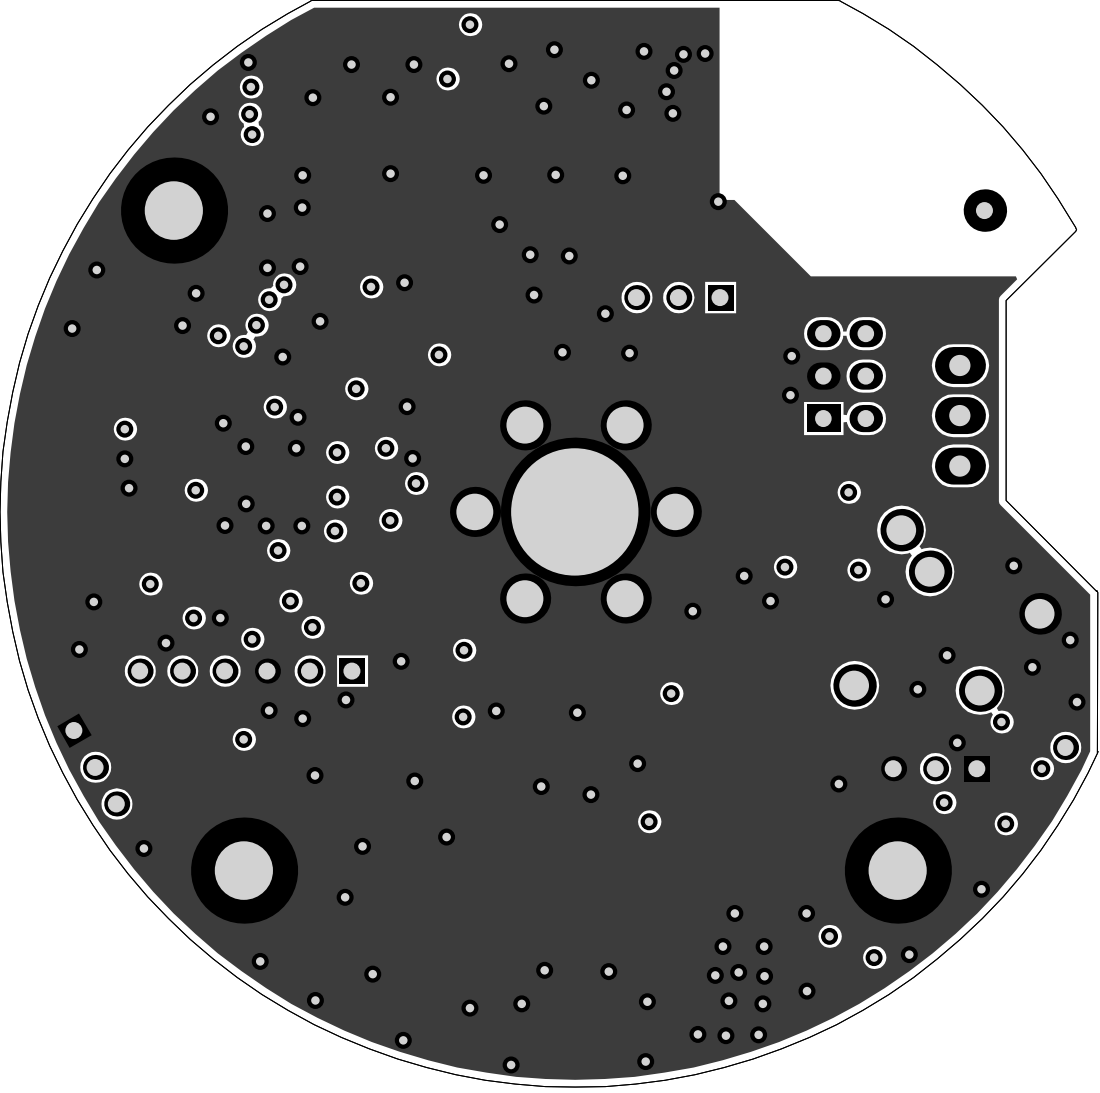
[picture p202: page 6]

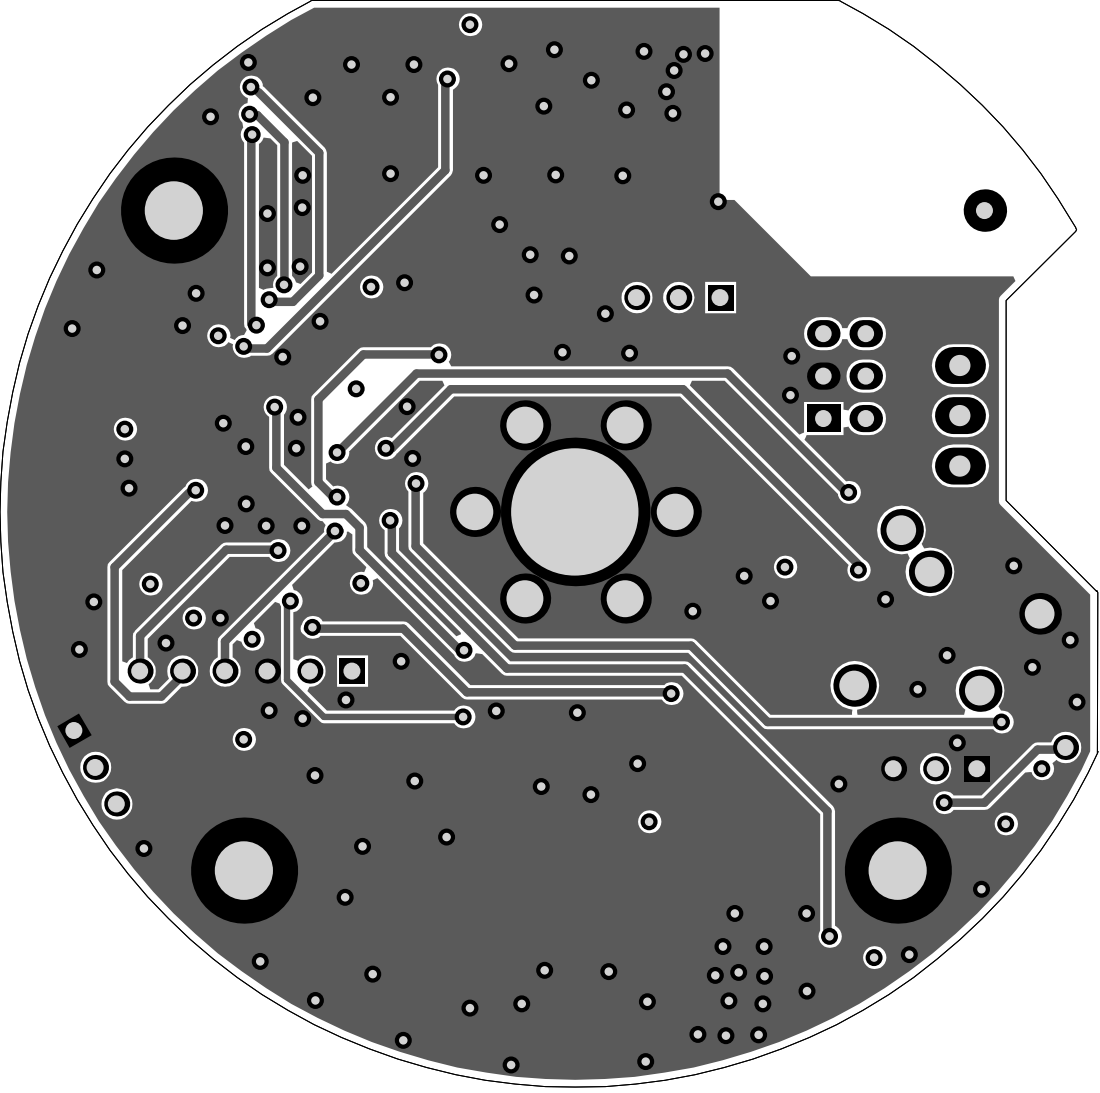
[picture p203: page 7]
