samuelpoiraud/robot/_Hard/2016_BeaconIR_YahourtPhone/2016_BeaconIR_YahourtPhone.PDF

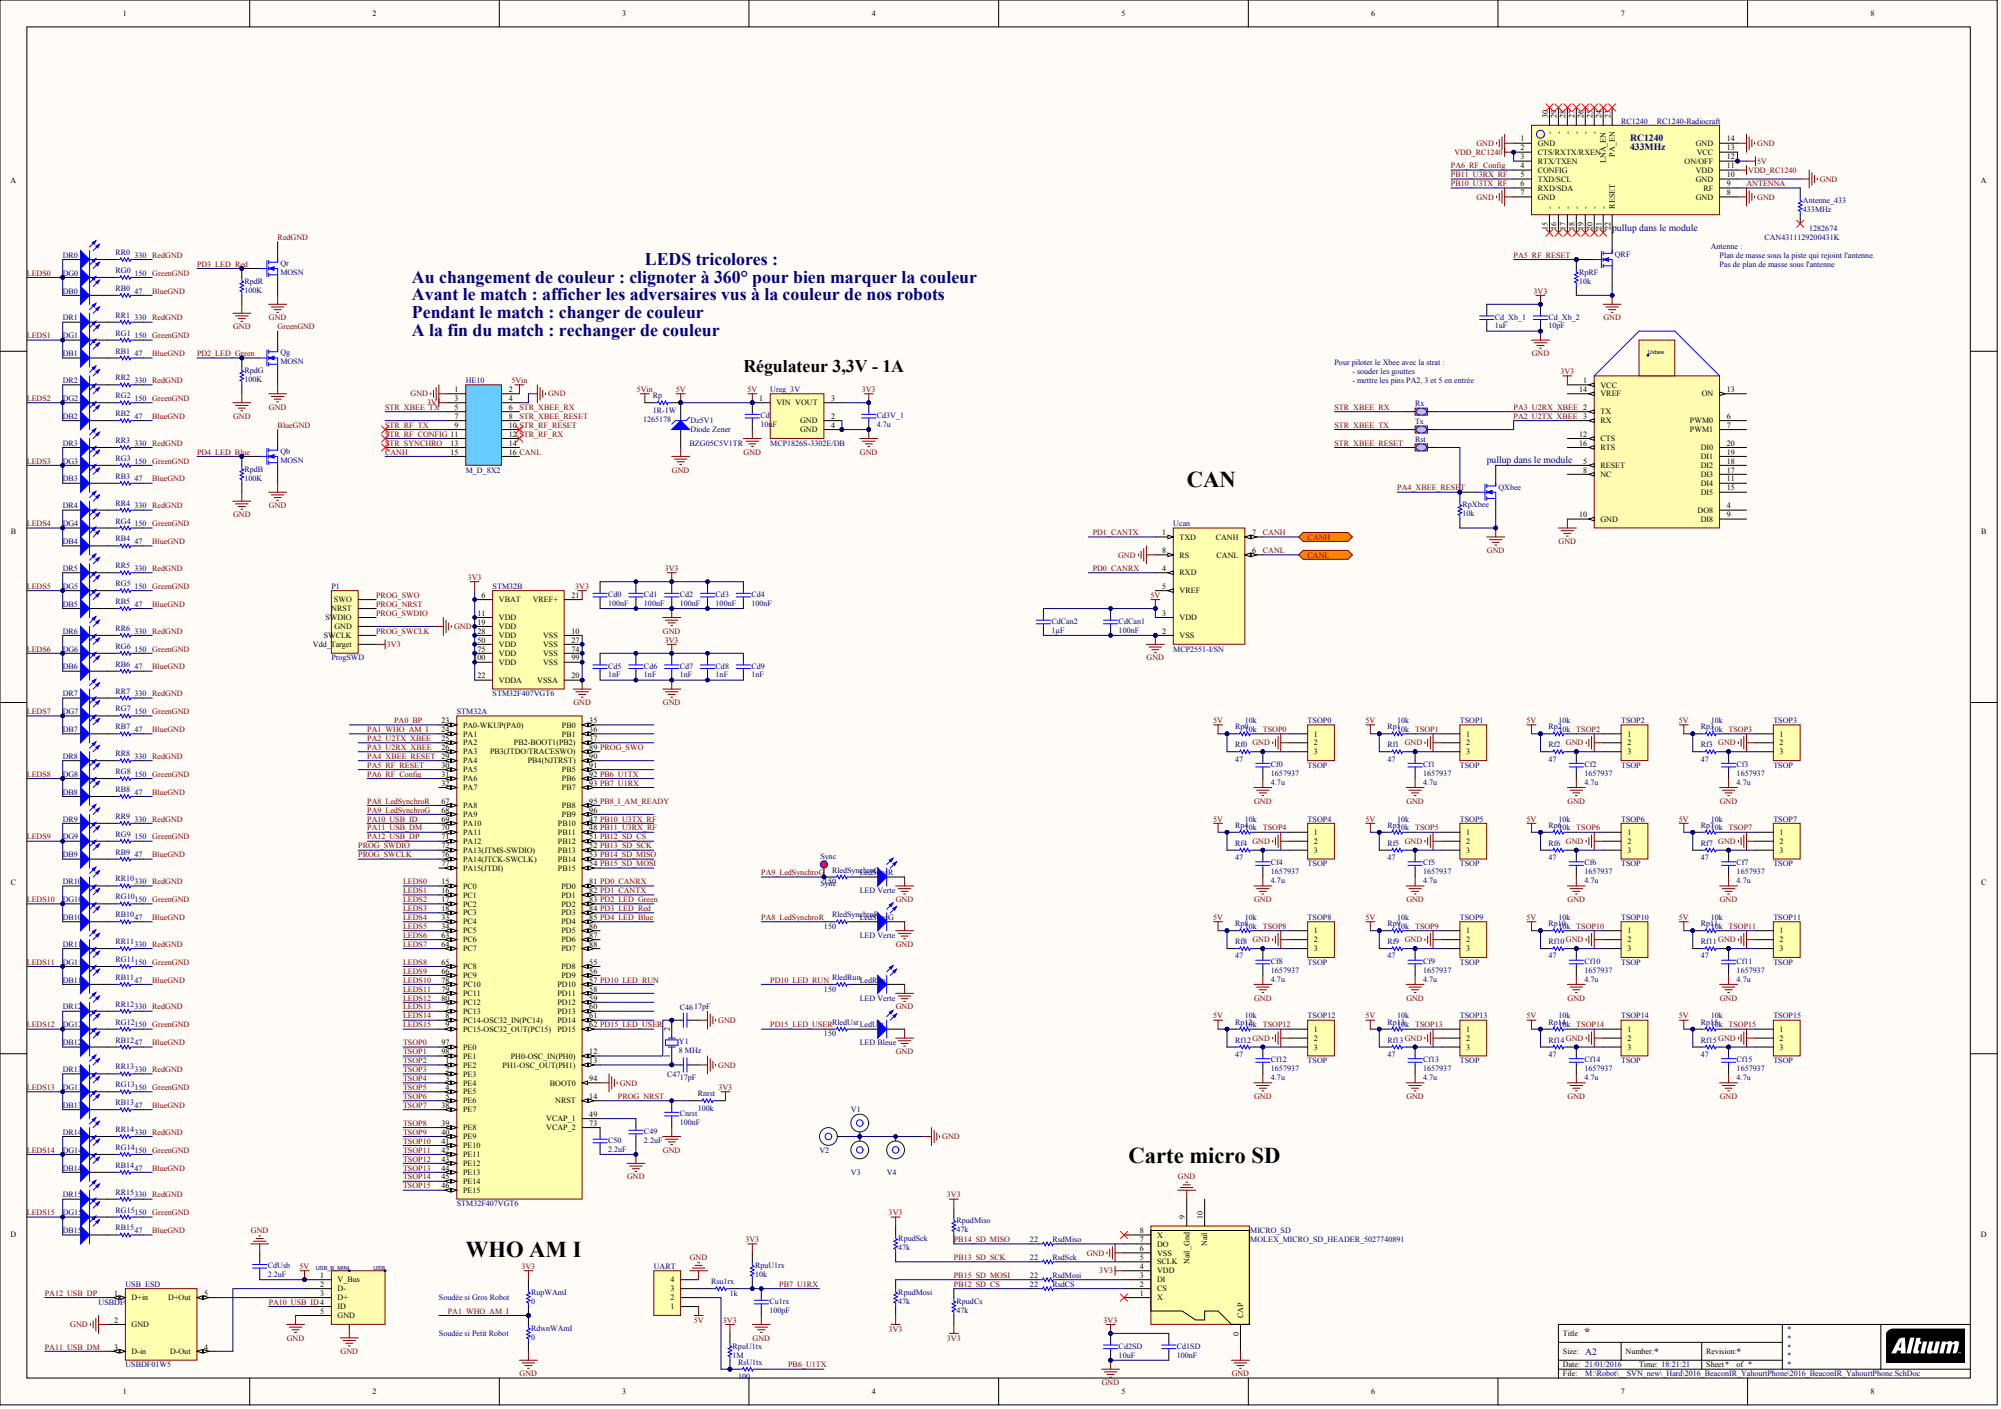
[picture p204: page 1]

pullup dans le module

Antenne :
Plan de masse sous la piste qui rejoint l'antenne.
Pas de plan de masse sous l'antenne

Au changement de couleur : clignoter à 360° pour bien marquer la couleur
Avant le match : afficher les adversaires vus à la couleur de nos robots
Pendant le match : changer de couleur
A la fin du match : rechanger de couleur

Pour piloter le Xbee avec la strat : - souder les gouttes - mettre les pins PA2, 3 et 5 en entrée

LedSyncG LED Verte LedSyncR LED Verte

Soudée si Gros Robot
PA1_WHO_AM_I

Soudée si Petit Robot

Title * | **** *

Size: A2 | Number: * | Revision: *
Date: 21/01/2016 Time: 18:21:21 | | Sheet * of *

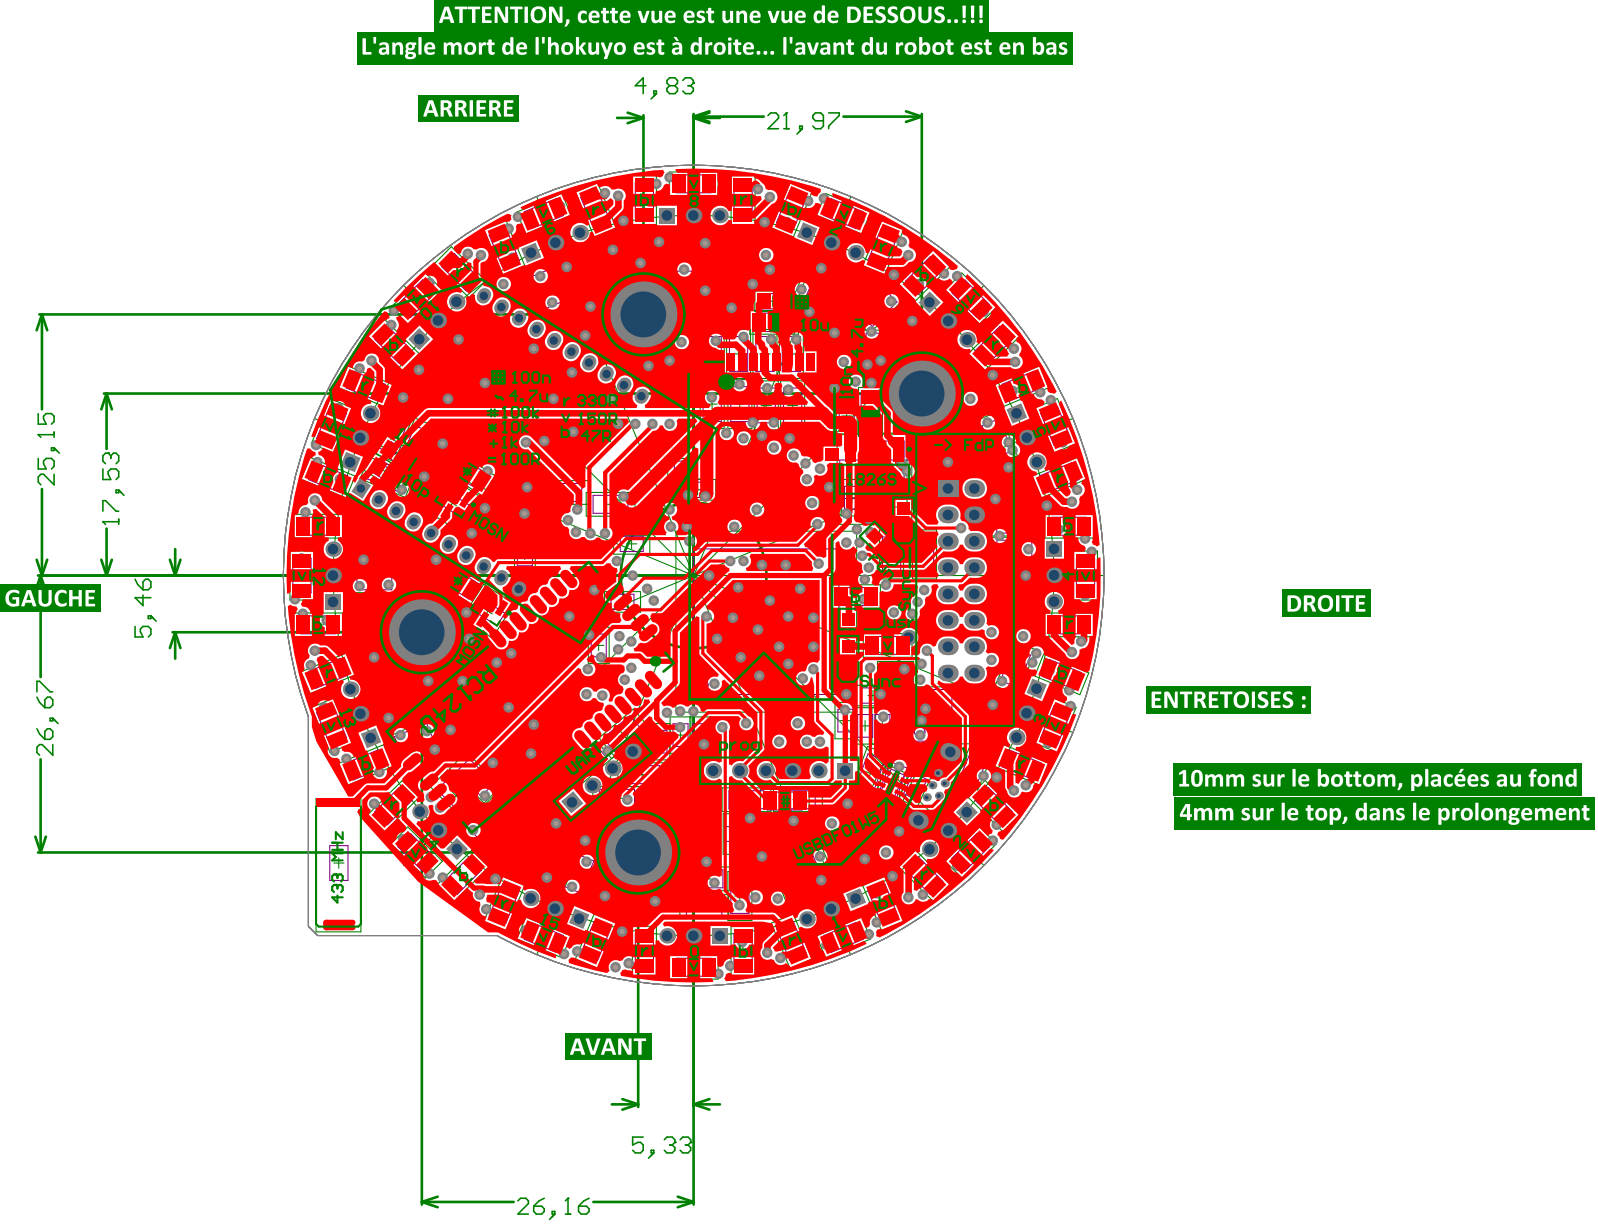
[picture p205: page 2]

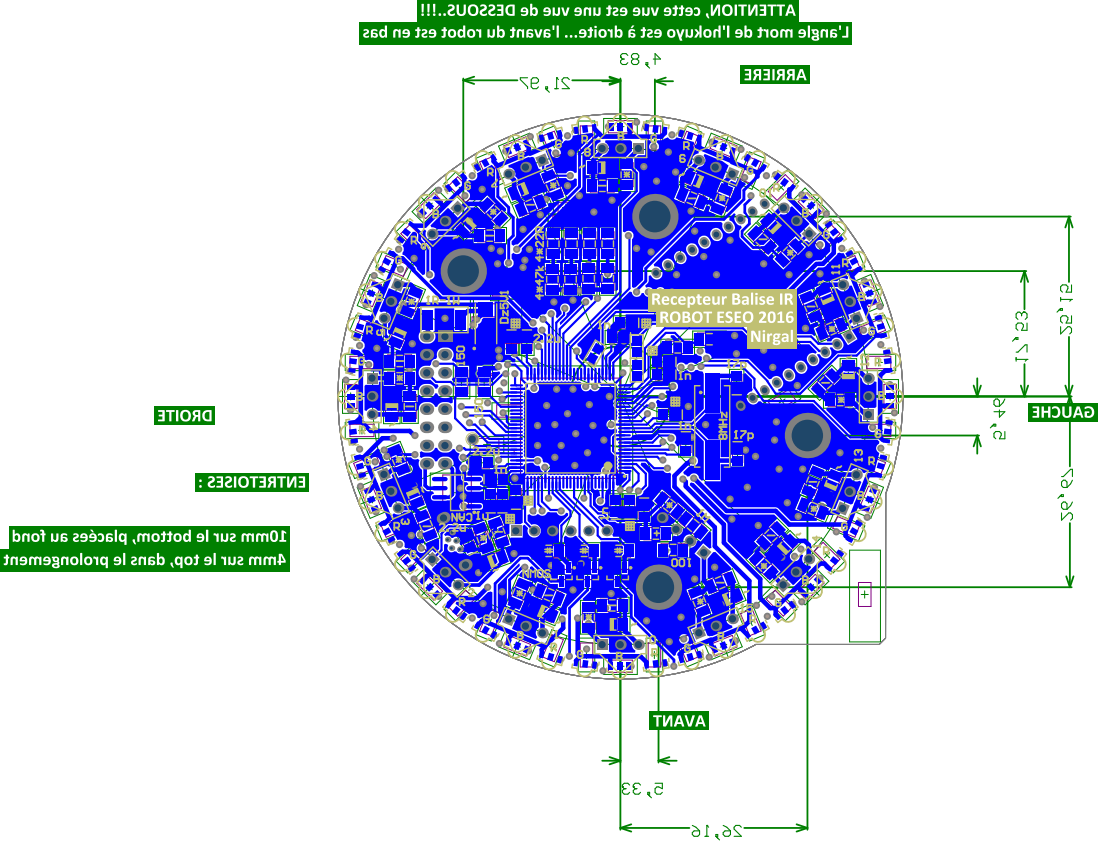
[picture p206: page 3]

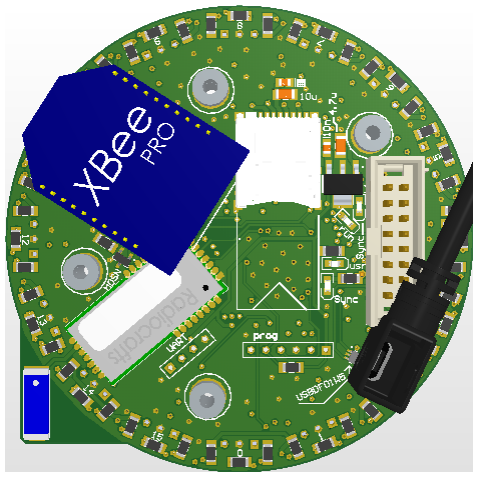
[picture p207: figure]

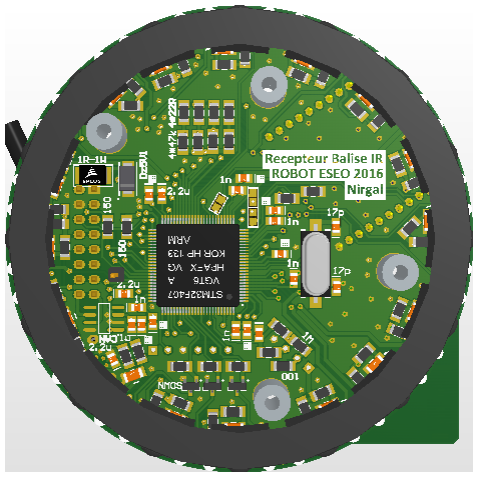
[picture p208: figure]
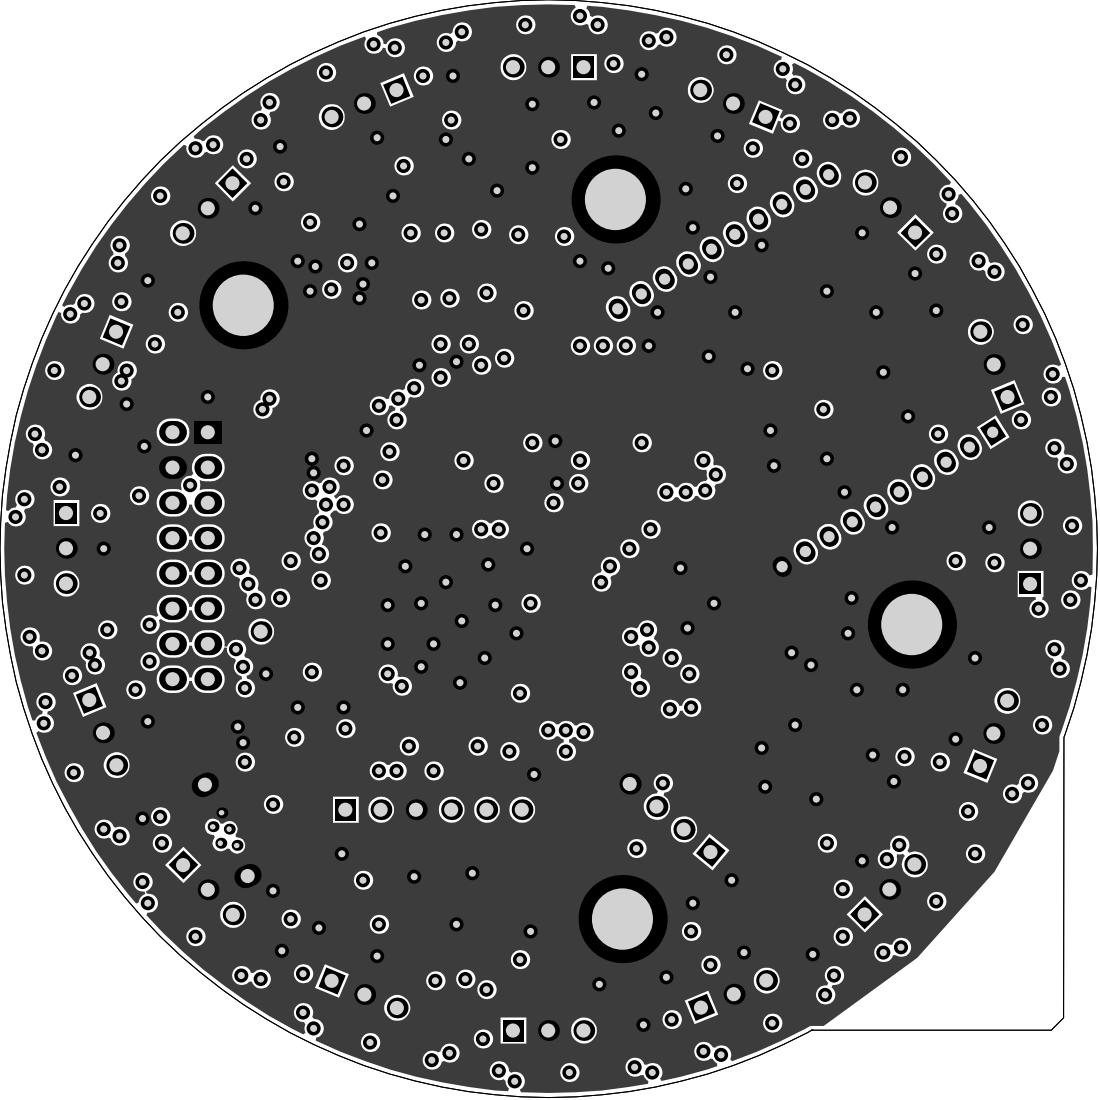
[picture p209: page 6]

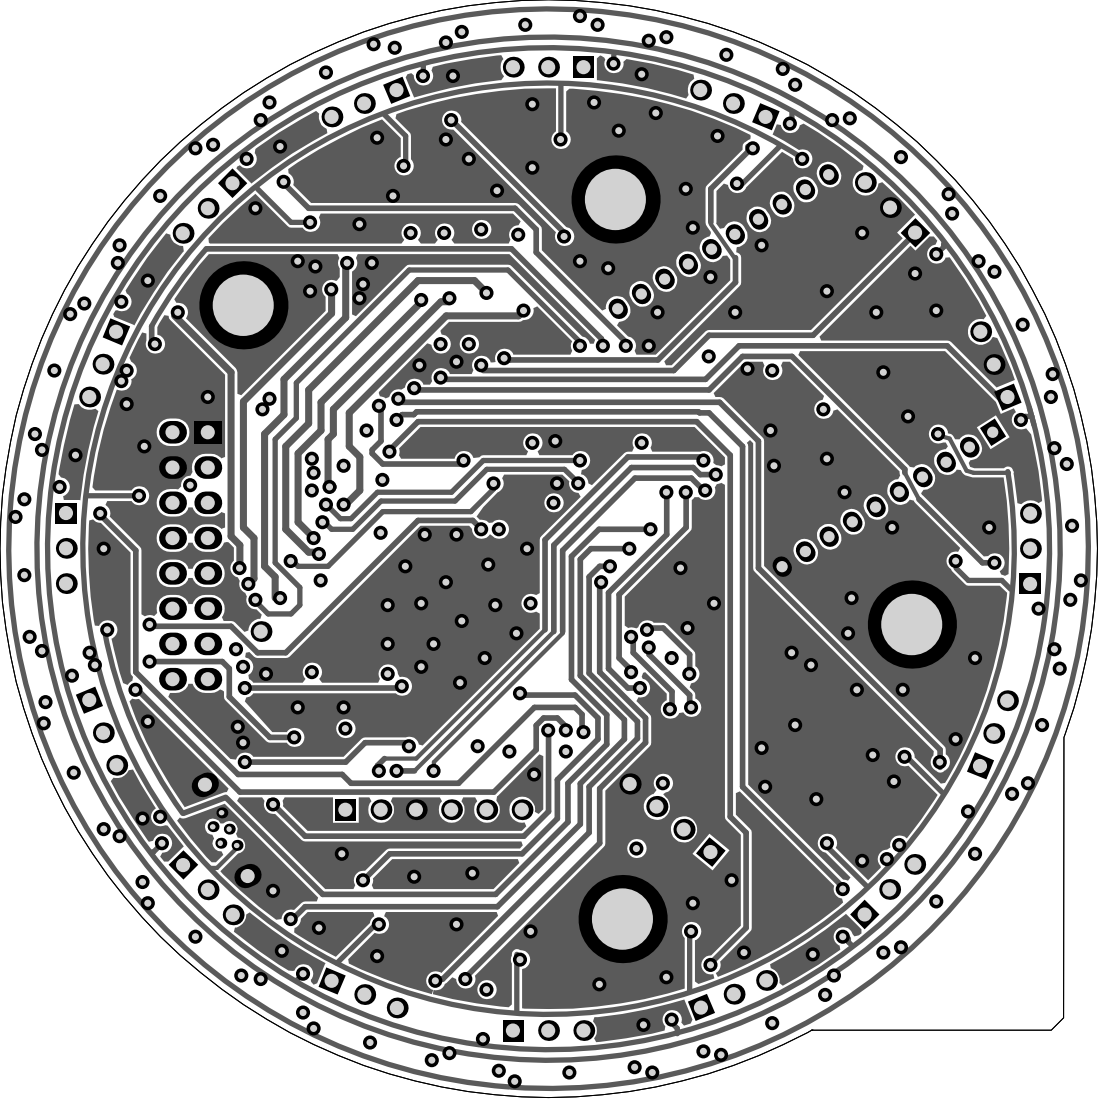
[picture p210: page 7]
