samuelpoiraud/robot/_Hard/2015_AlimBeaconEye/2015_AlimBeaconEye.PDF

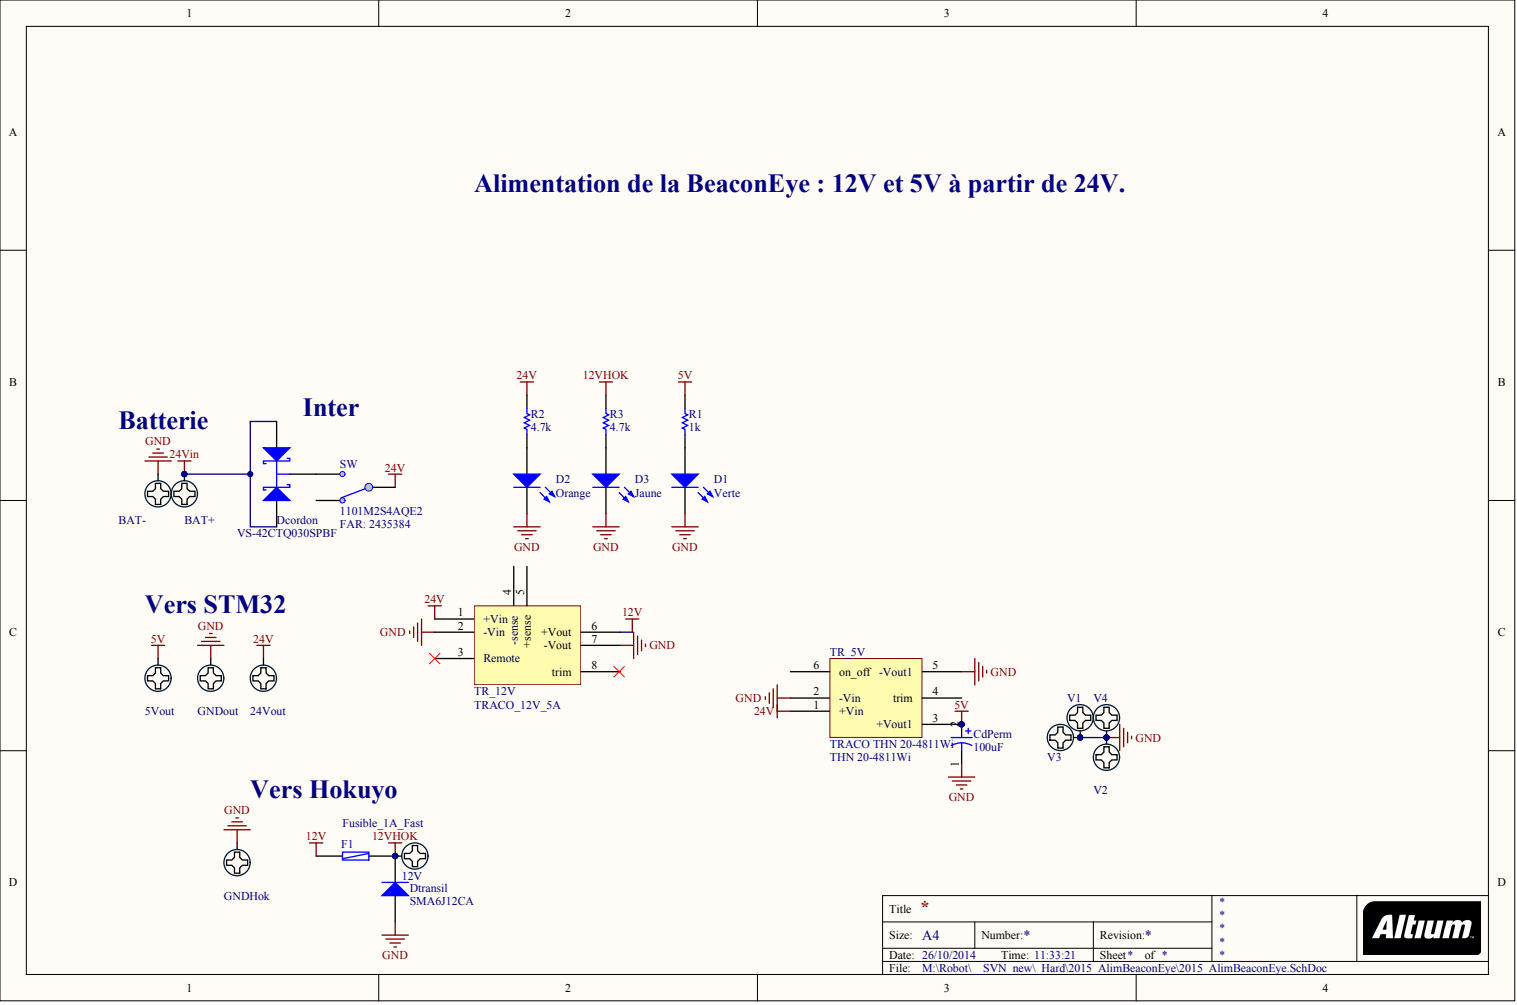
[picture p211: page 1]

Alimentation de la BeaconEye : 12V et 5V à partir de 24V.

* Title | * * * * *

Size: A4 | Number: * | Revision: *
Date: 26/10/2014 Time: 11:33:21 | | Sheet * of *

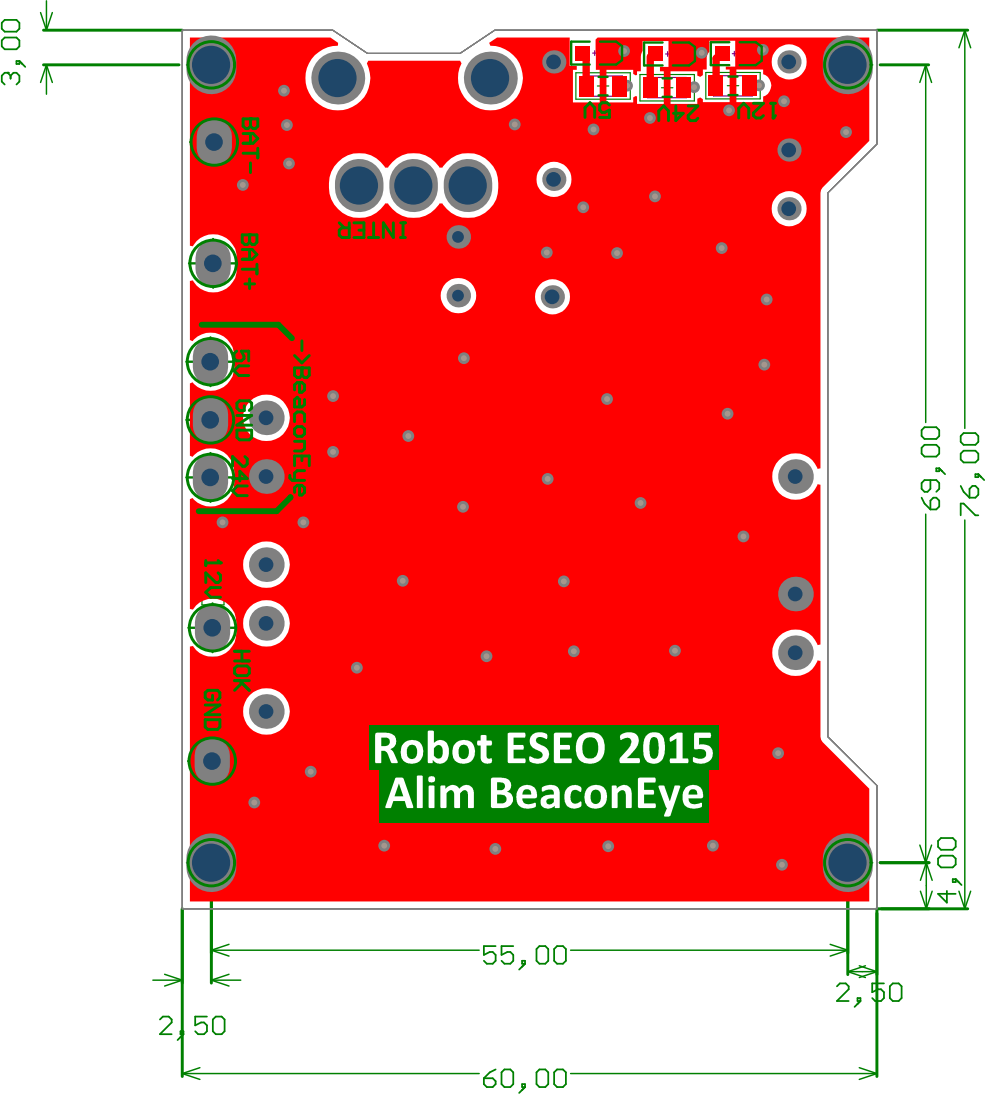
[picture p212: page 2]

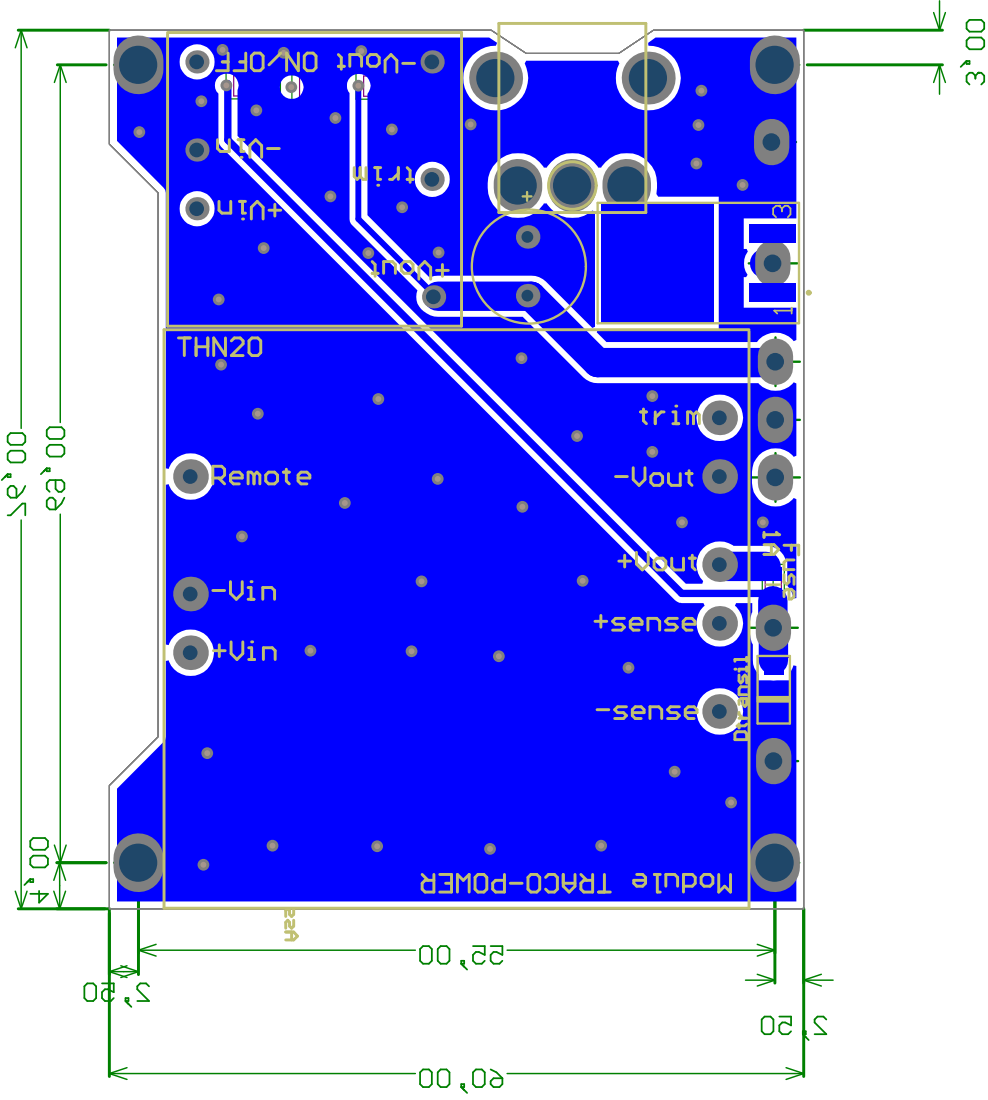
[picture p213: page 3]

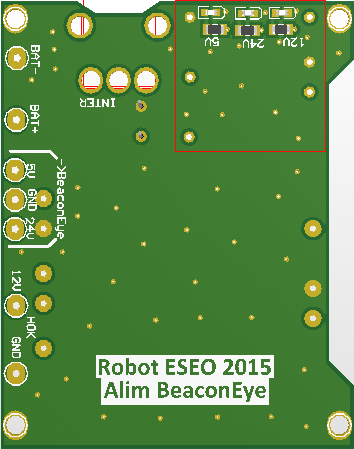
[picture p214: figure]

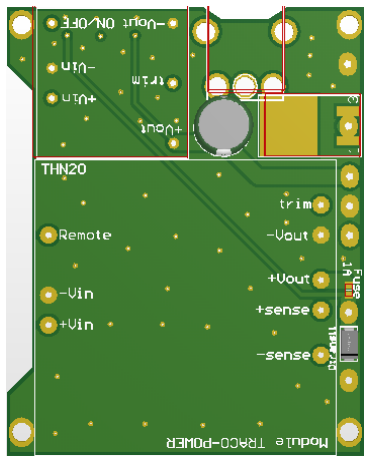
[picture p215: figure]
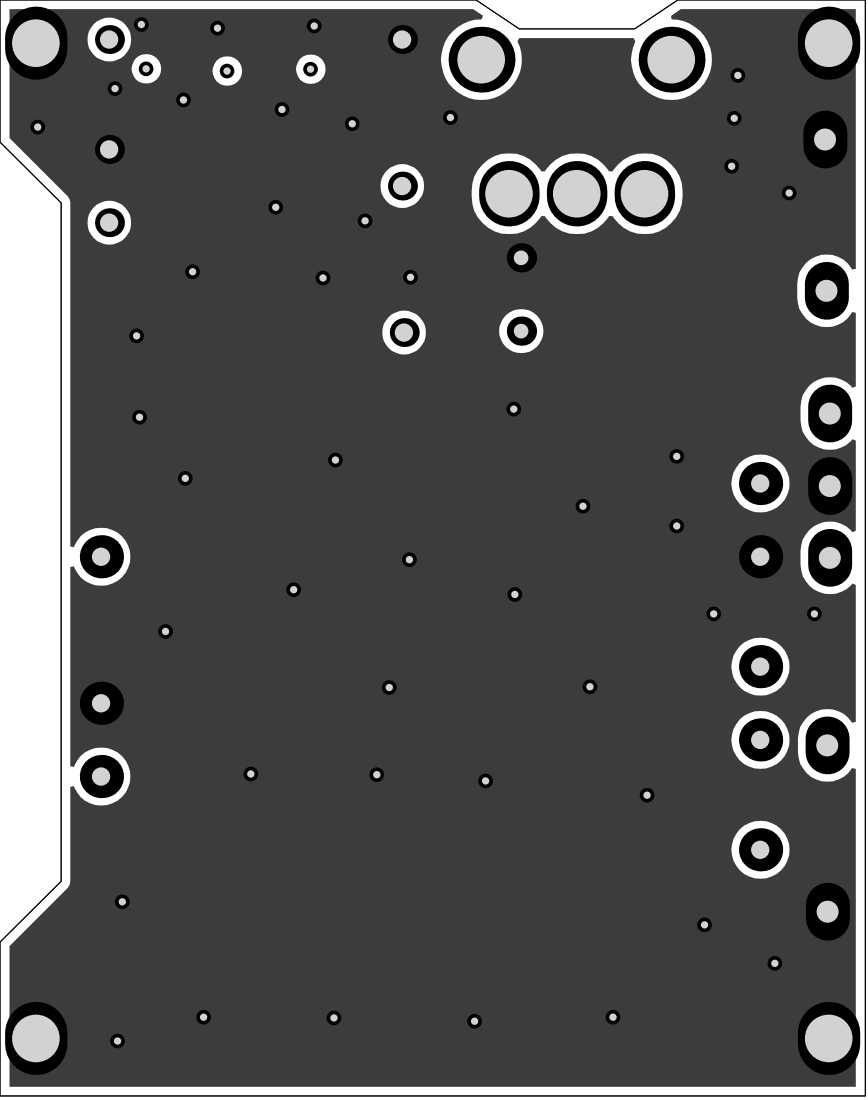
[picture p216: page 6]

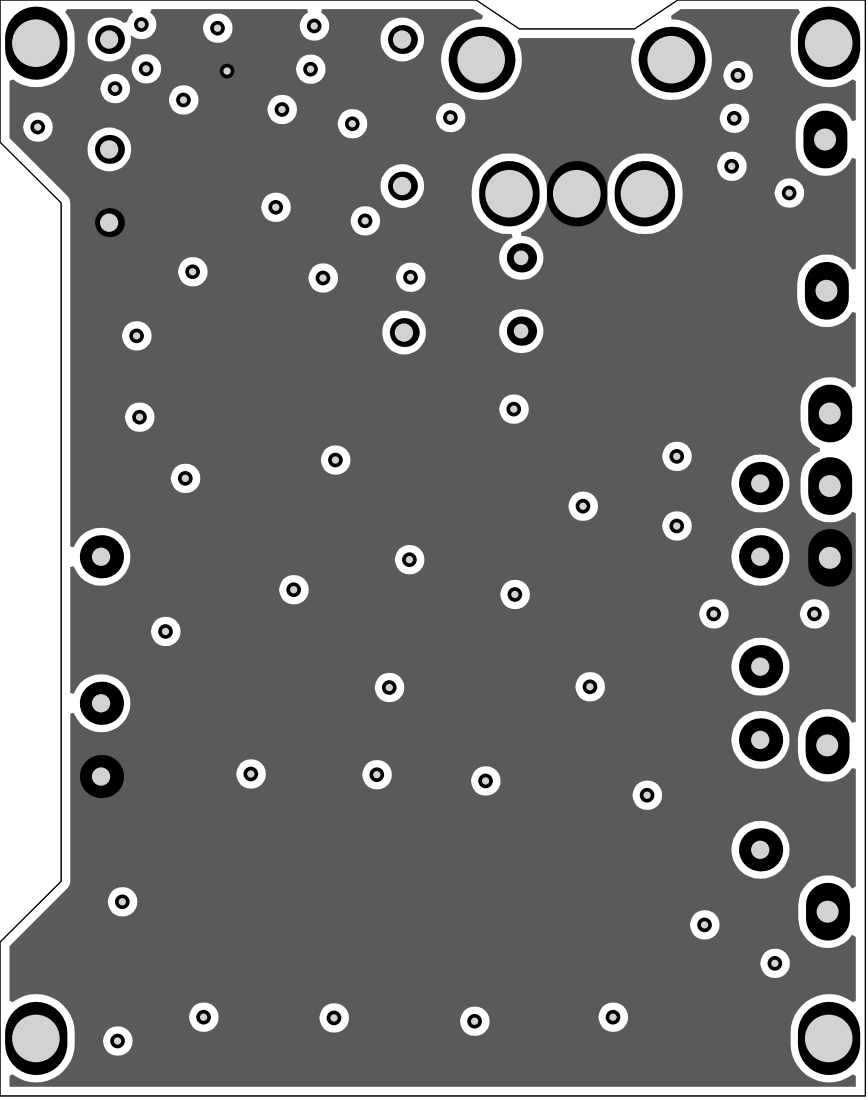
[picture p217: page 7]
