samuelpoiraud/robot/_Hard/2015_AX12DUPLICATOR/2015_AX12DUPLICATOR.PDF

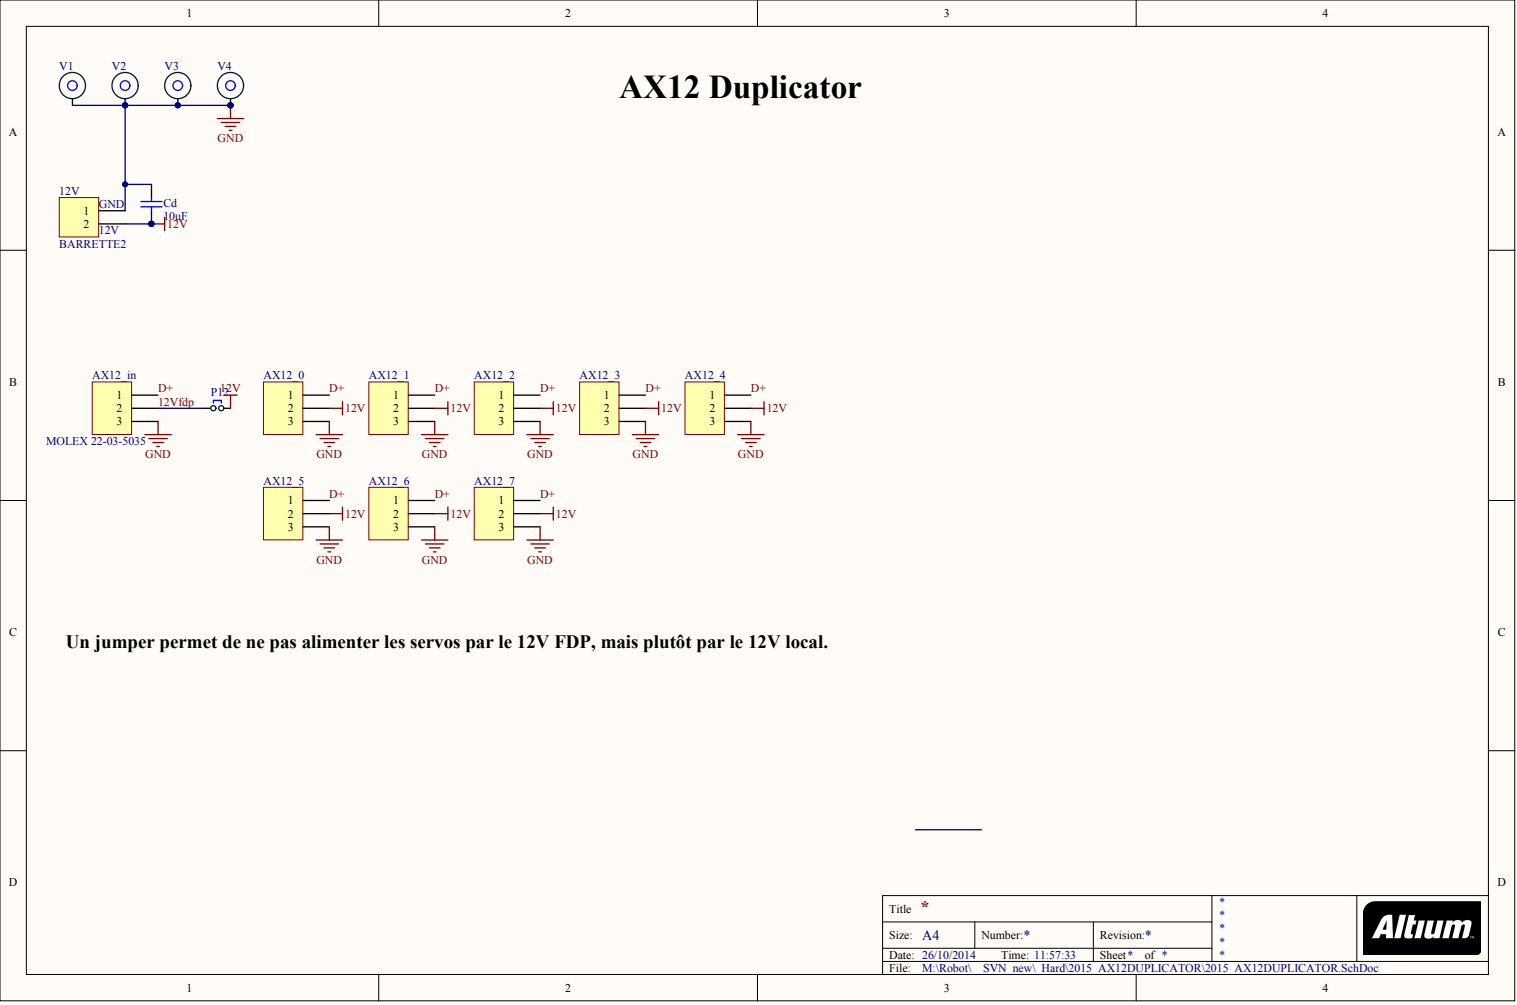
[picture p218: page 1]

Un jumper permet de ne pas alimenter les servos par le 12V FDP, mais plutôt par le 12V local.

* Title | * * * * *

Size: A4 | Number: * | Revision: *
Date: 26/10/2014 Time: 11:57:33 | | Sheet * of *

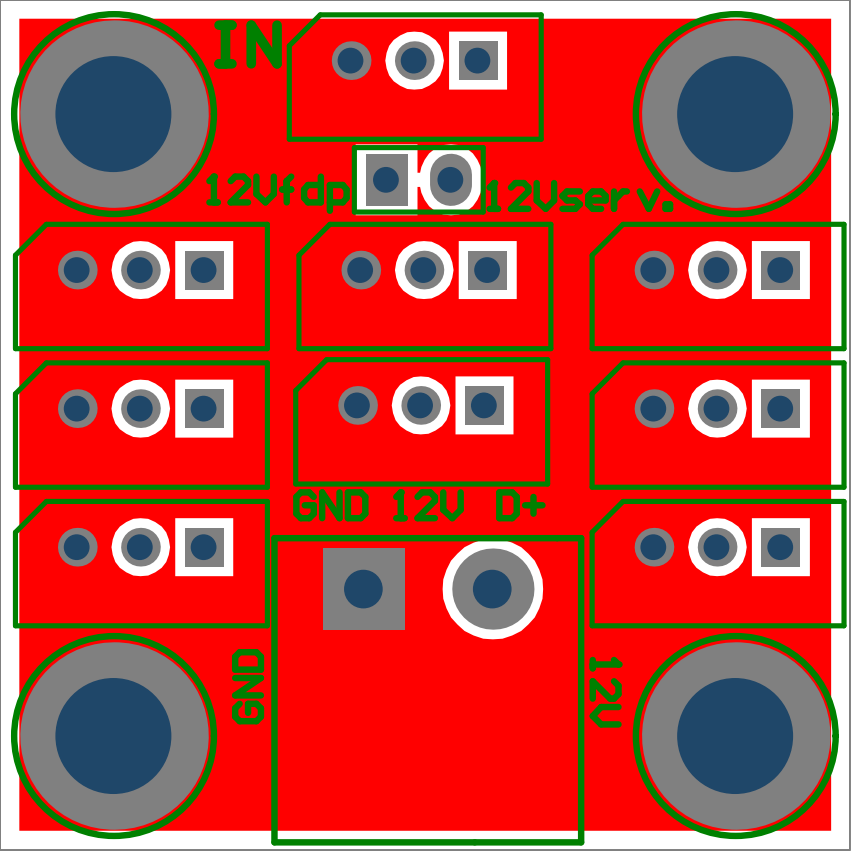
[picture p219: page 2]

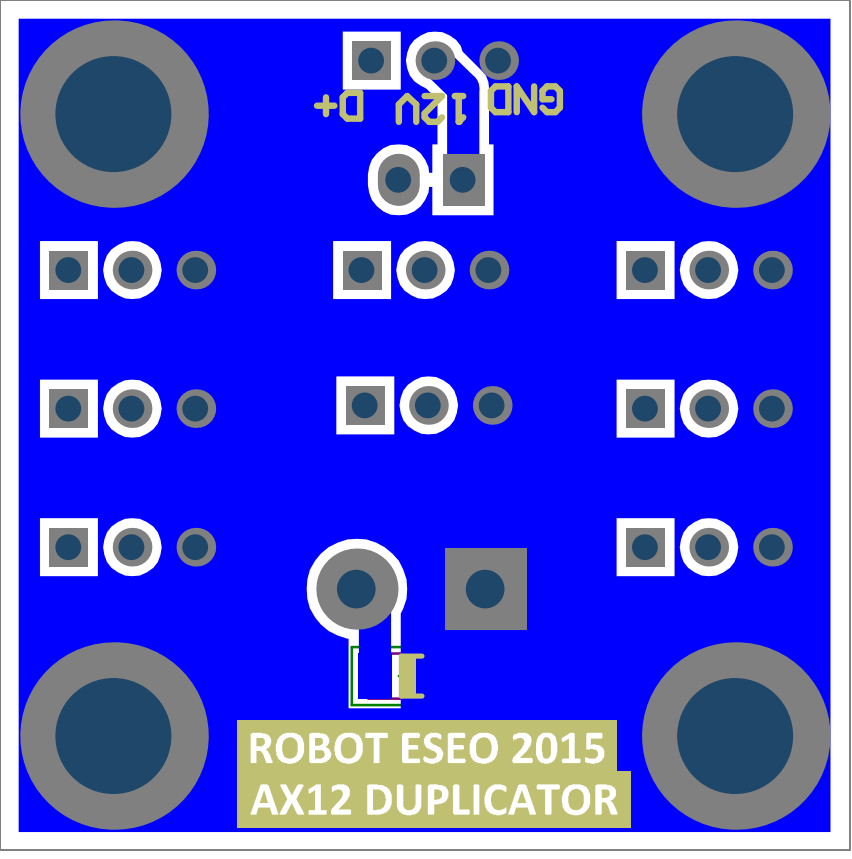
[picture p220: page 3]

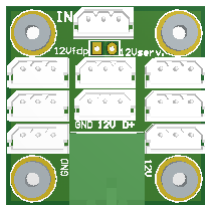
[picture p221: figure]

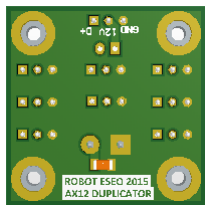
[picture p222: figure]
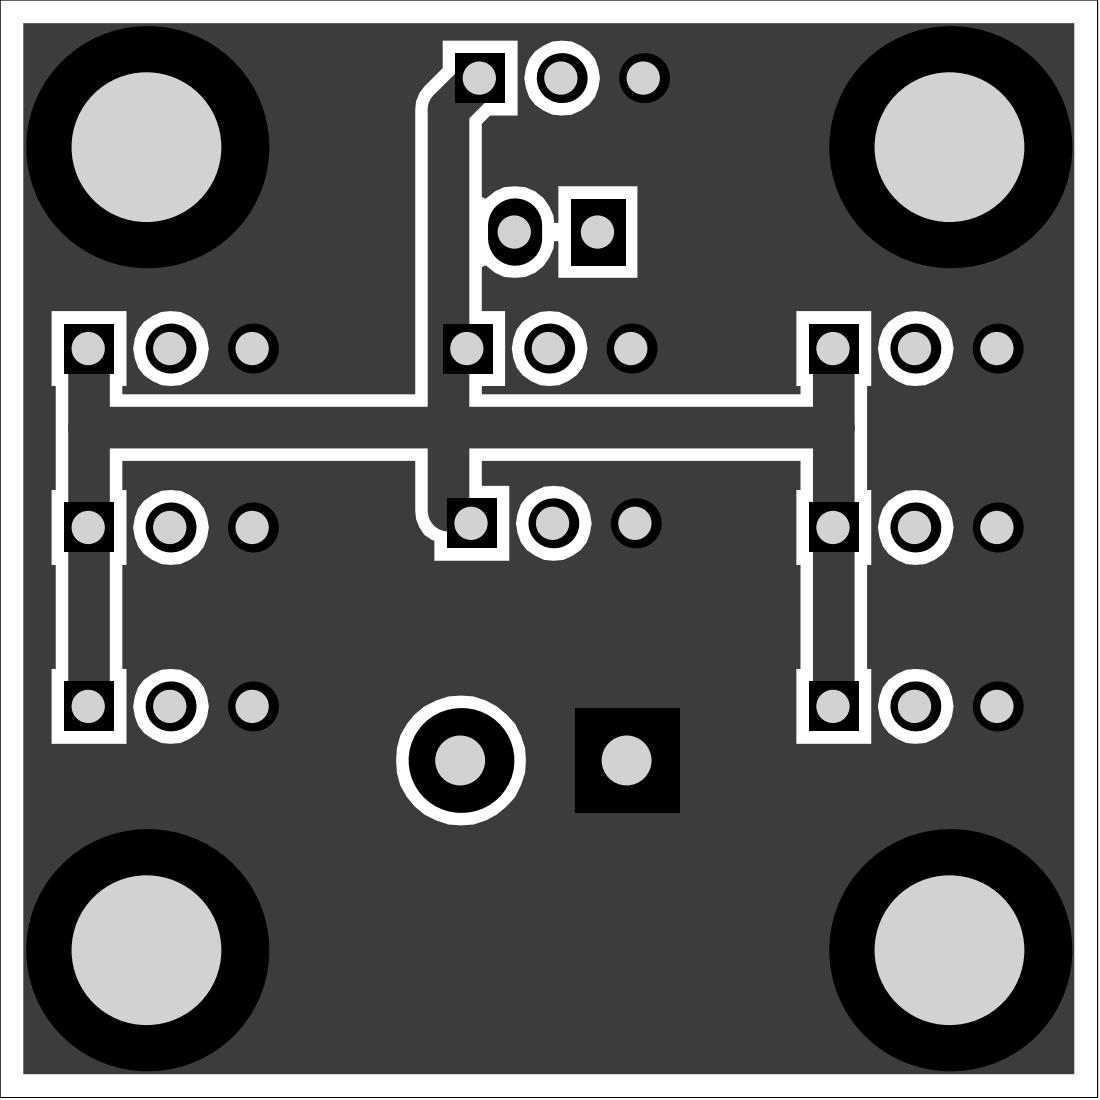
[picture p223: page 6]

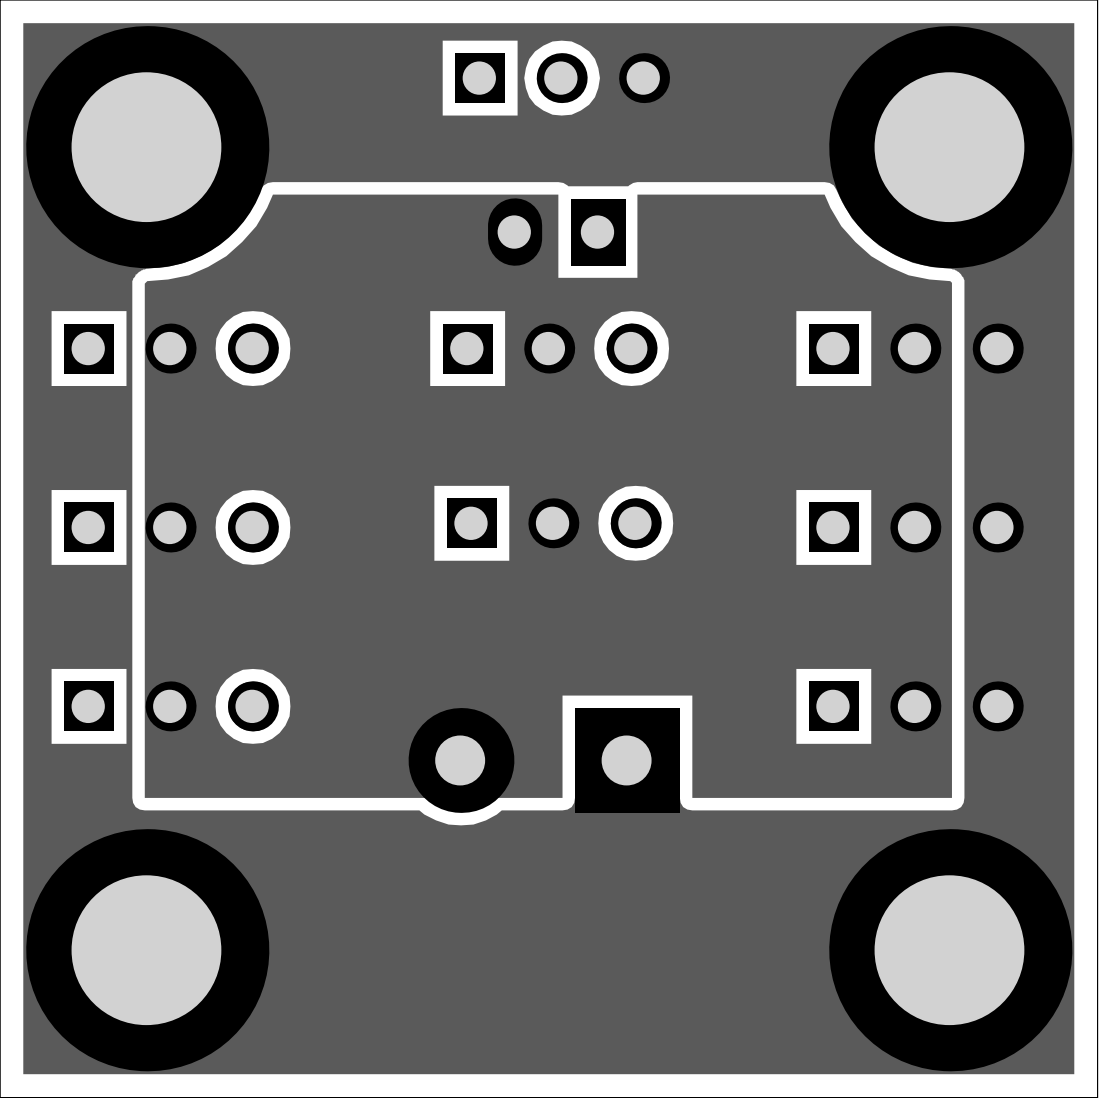
[picture p224: page 7]
