samuelpoiraud/robot/_Hard/2015_PerfServos/2015_PerfServos.PDF

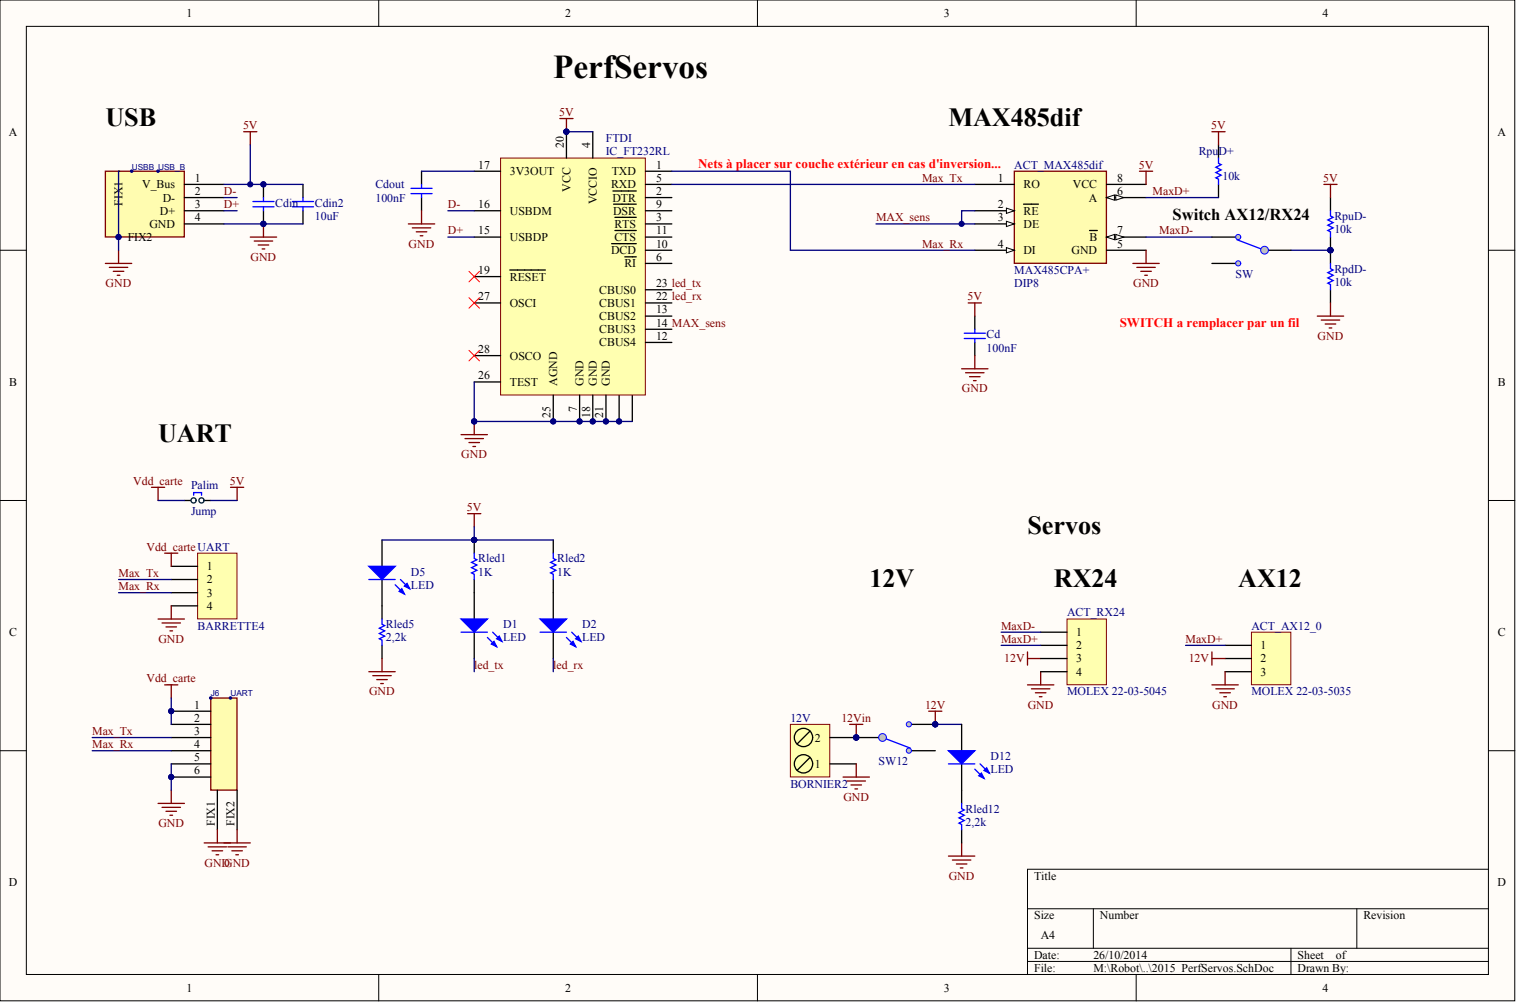
[picture p225: page 1]

Nets à placer sur couche extérieur en cas d'inversion...

SWITCH a remplacer par un fil

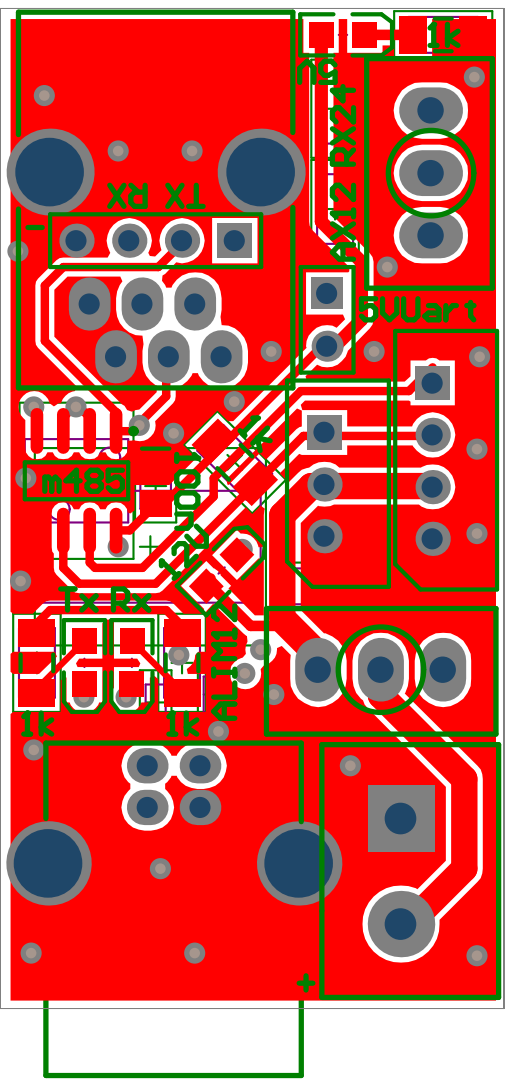
[picture p226: page 2]

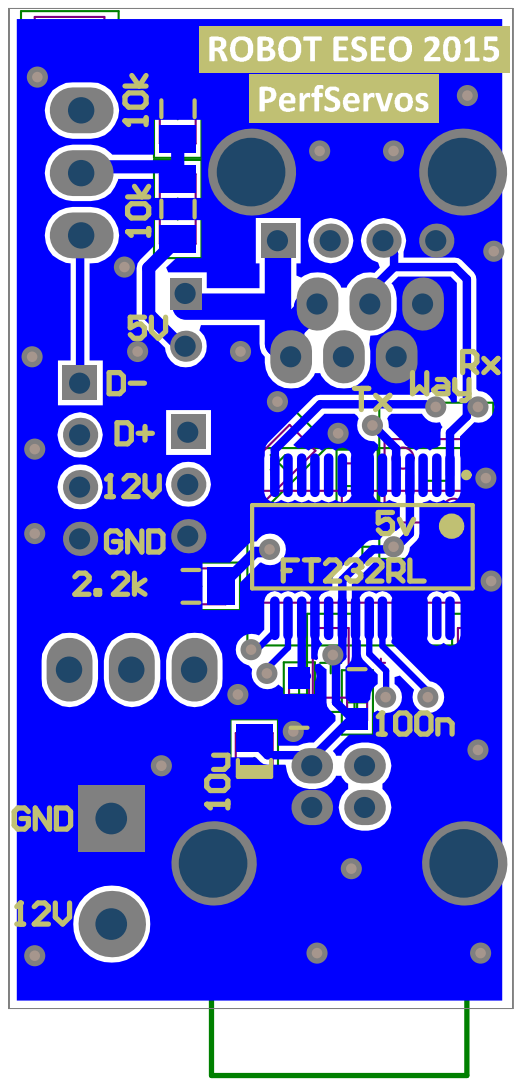
[picture p227: page 3]

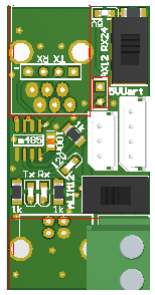
[picture p228: figure]

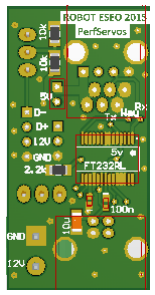
[picture p229: figure]
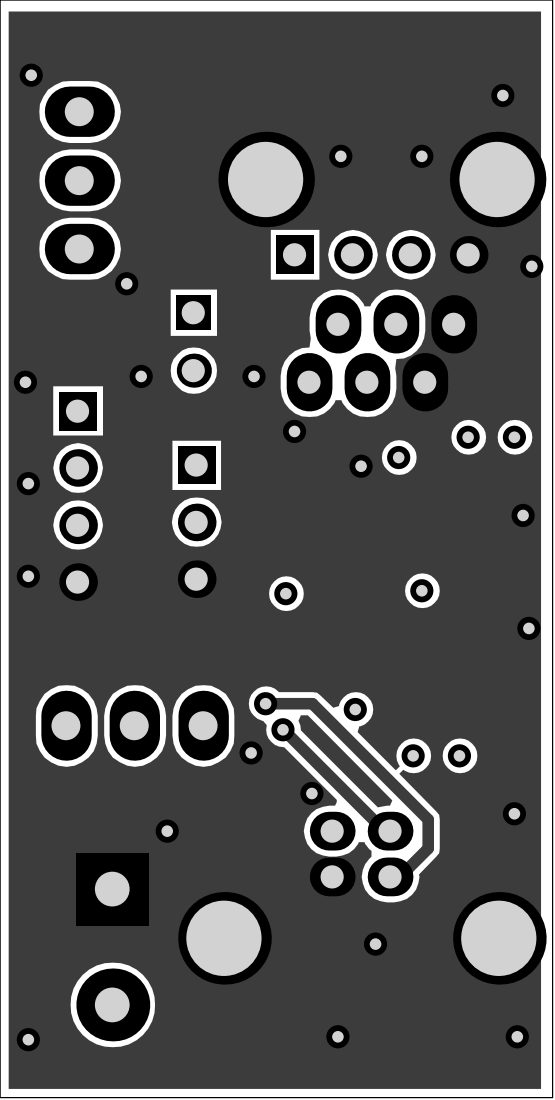
[picture p230: page 6]

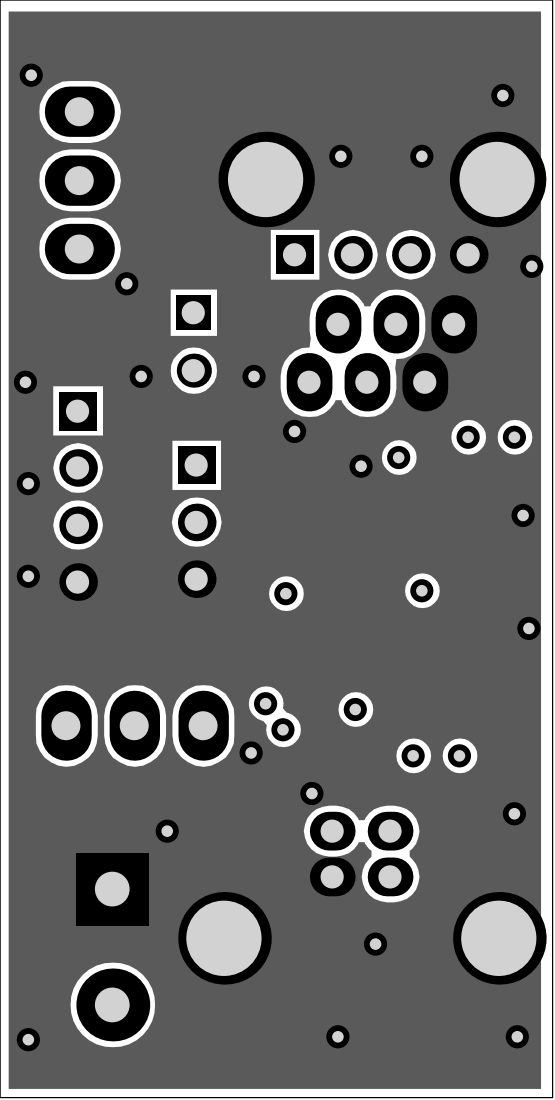
[picture p231: page 7]
