samuelpoiraud/robot/_Hard/2015_RX24DUPLICATOR/2015_Rx24Duplicator.PDF

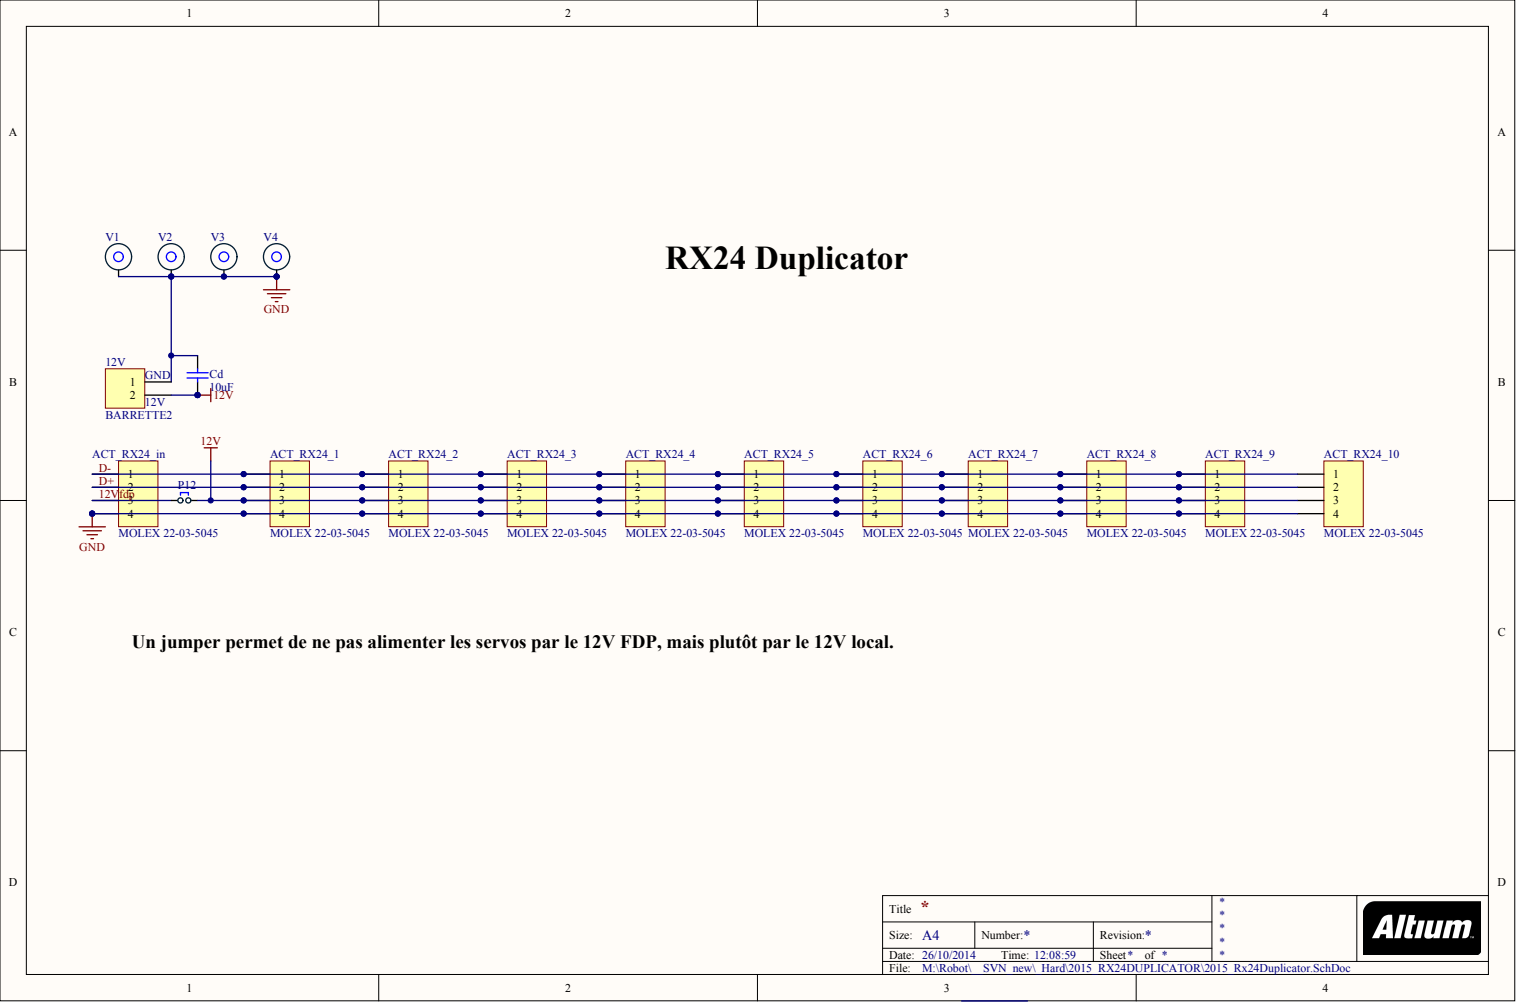
[picture p232: page 1]

3 4 | 3 4 | 3 4 | 3 4 | 3 4 | 3 4 | 3 4 | 3 4 | 3 4 | 3 4

Un jumper permet de ne pas alimenter les servos par le 12V FDP, mais plutôt par le 12V local.

* Title | * * * * *

Size: A4 | Number: * | Revision: *
Date: 26/10/2014 Time: 12:08:59 | | Sheet * of *

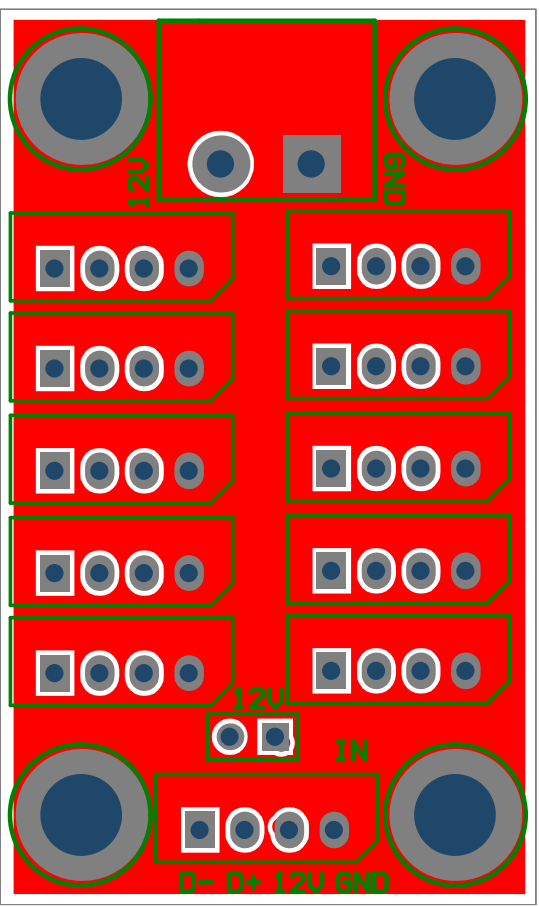
[picture p233: page 2]

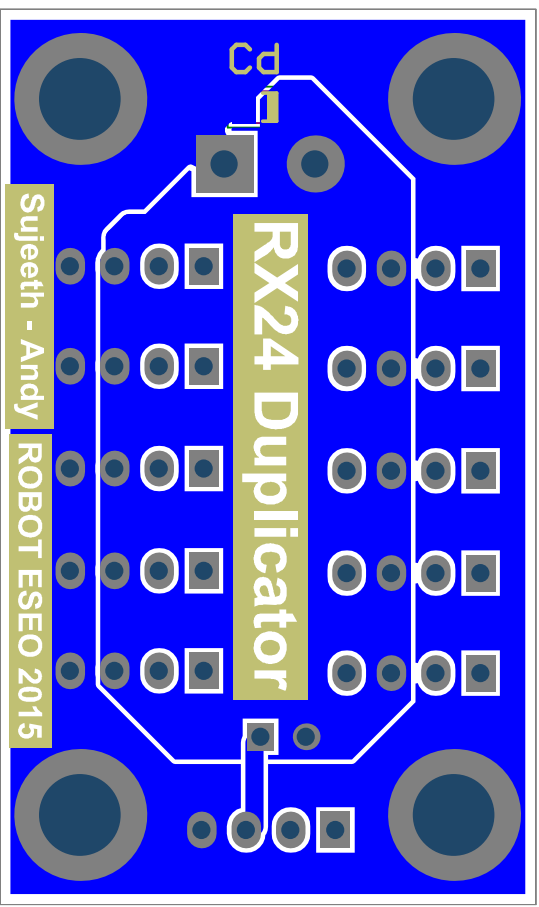
[picture p234: page 3]

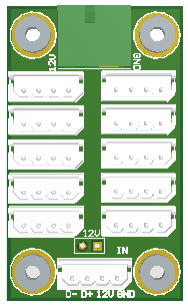
[picture p235: figure]

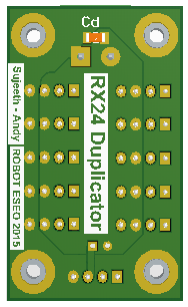
[picture p236: figure]
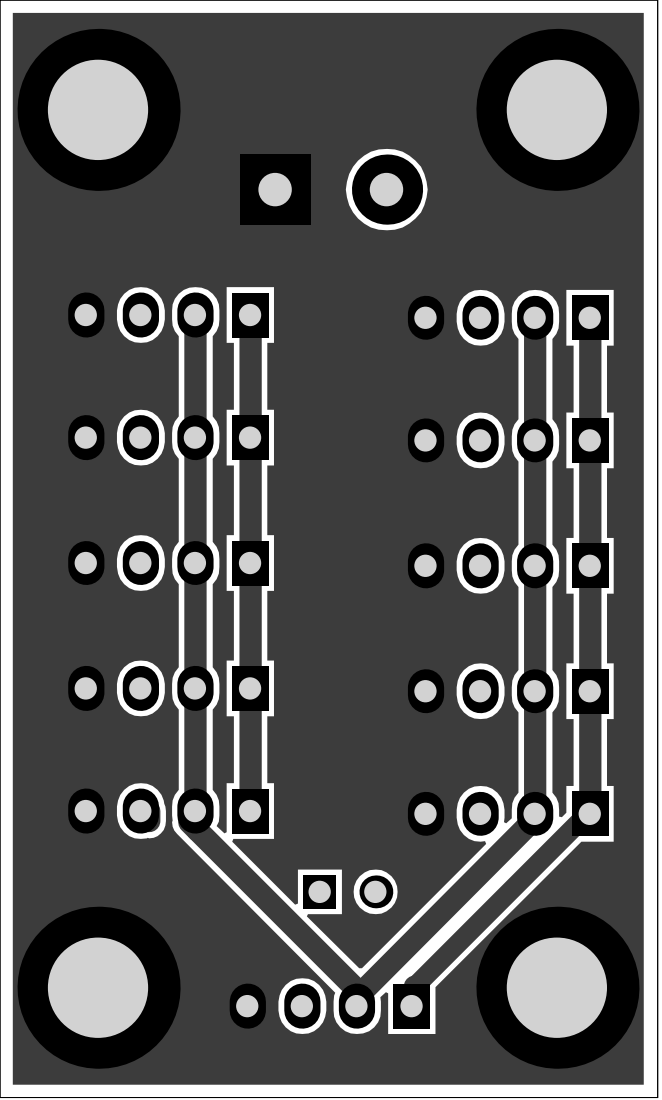
[picture p237: page 6]

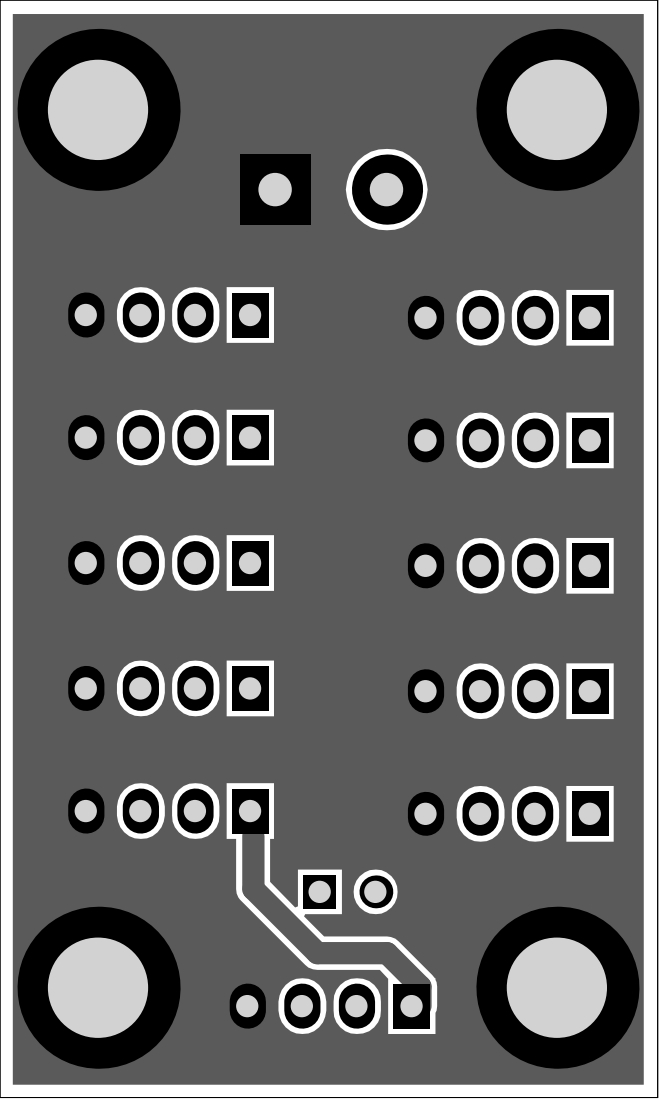
[picture p238: page 7]
