samuelpoiraud/robot/_Hard/2014_Balise/2014_Balise.pdf

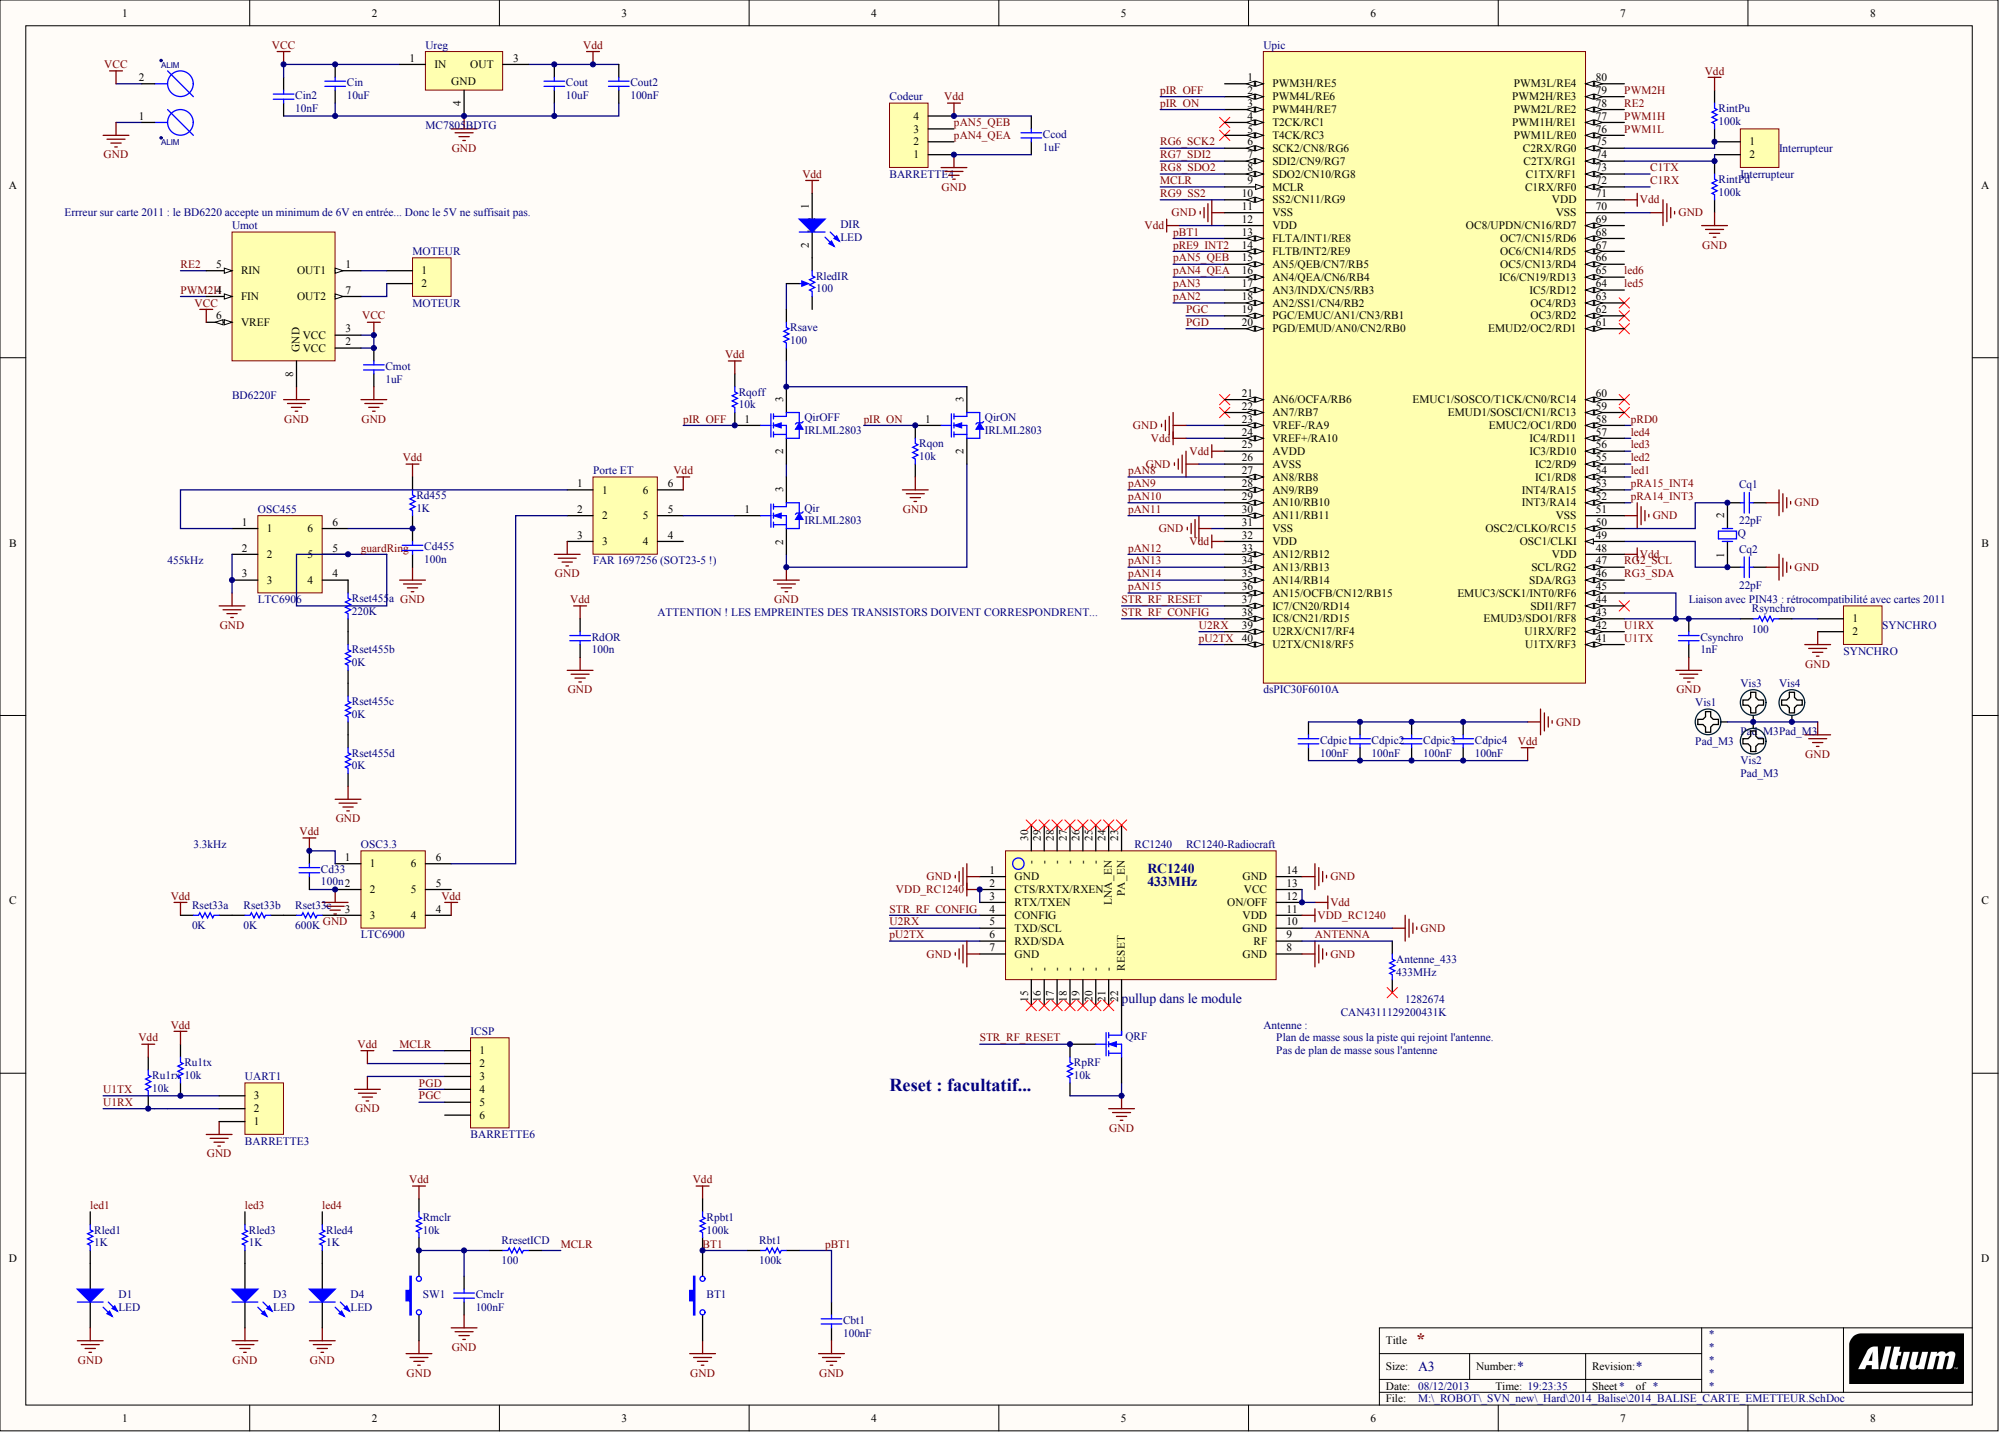
[picture p239: page 1]

Errreur sur carte 2011 : le BD6220 accepte un minimum de 6V en entrée... Donc le 5V ne suffisait pas.

Liaison avec PIN43 : rétrocompatibilité avec cartes 2011

ATTENTION ! LES EMPREINTES DES TRANSISTORS DOIVENT CORRESPONDRENT...

pullup dans le module

Antenne :
Plan de masse sous la piste qui rejoint l'antenne.
Pas de plan de masse sous l'antenne

* Title | * * * * *

Size: A3 | Number: * | Revision: *

Date: 08/12/2013 Time: 19:23:35 | | Sheet * of *

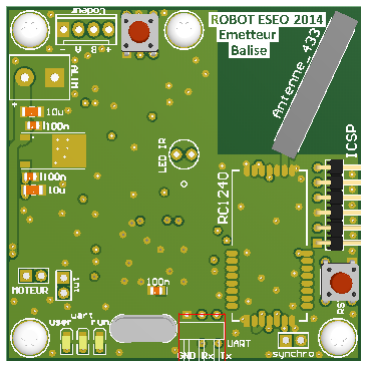
[picture p240: figure]
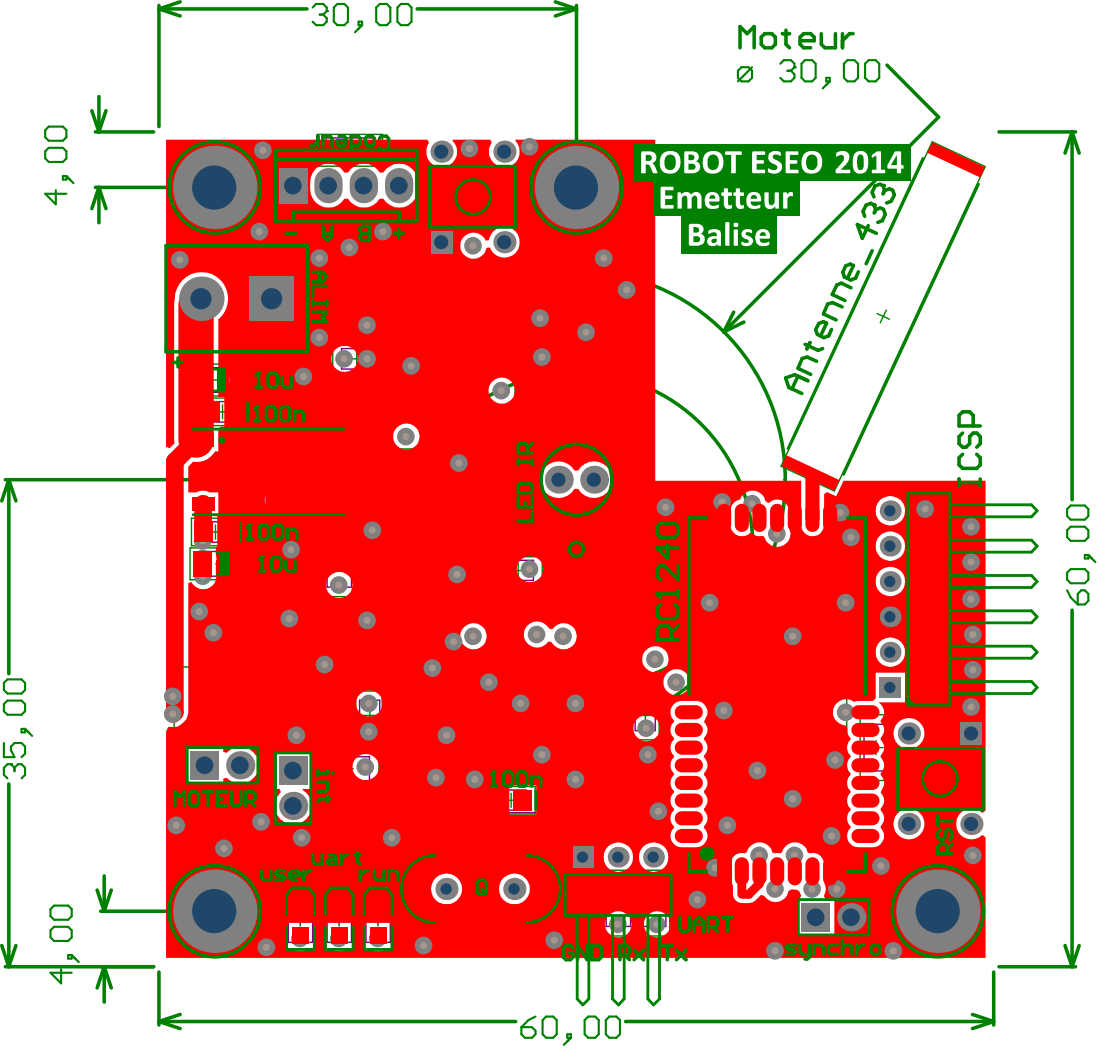
[picture p241: page 3]

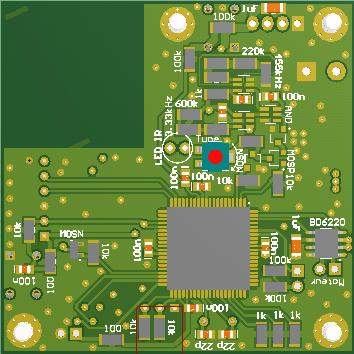
[picture p242: figure]
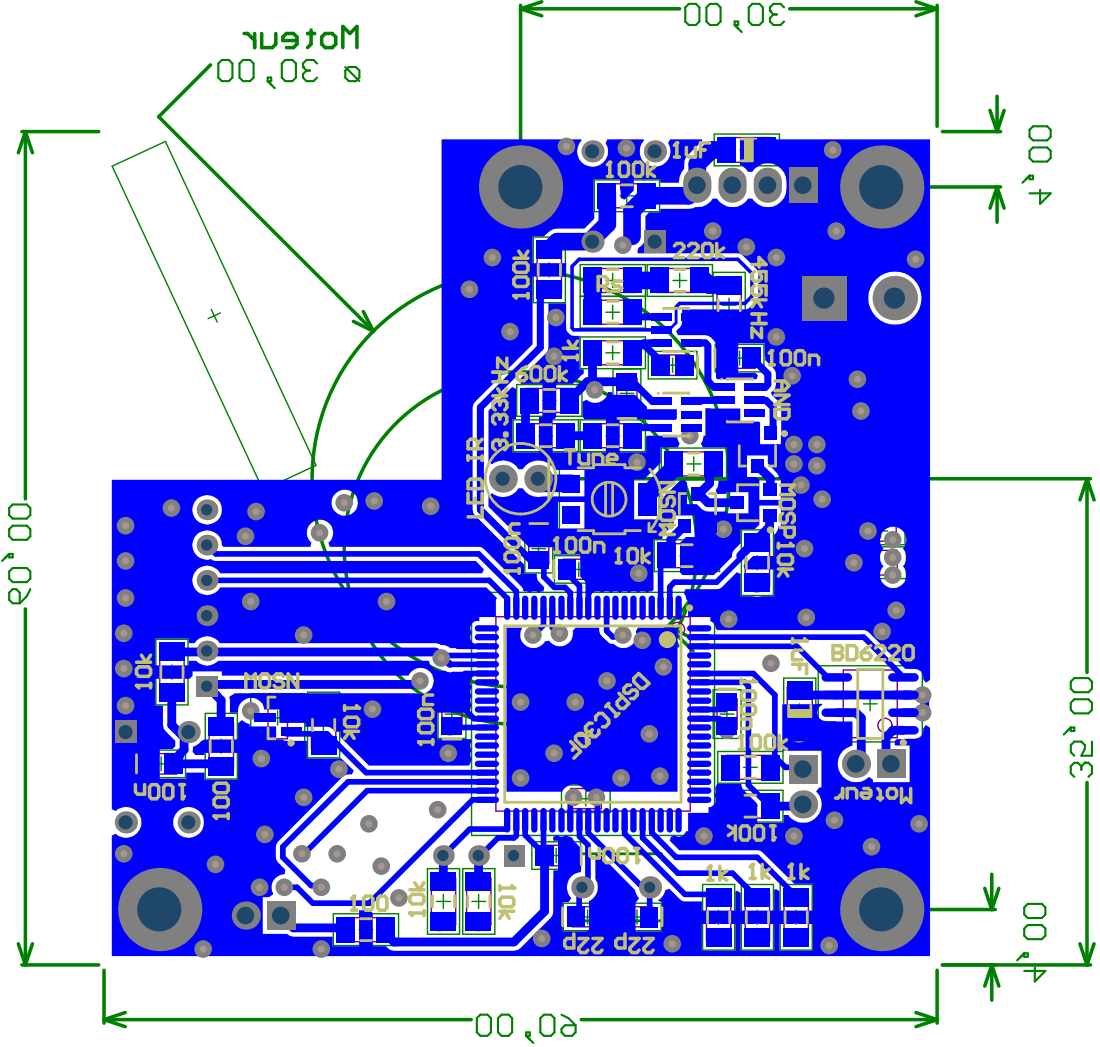
[picture p243: page 5]
