samuelpoiraud/robot/_Hard/2014_BallLauncher/2014_BallLauncher.pdf

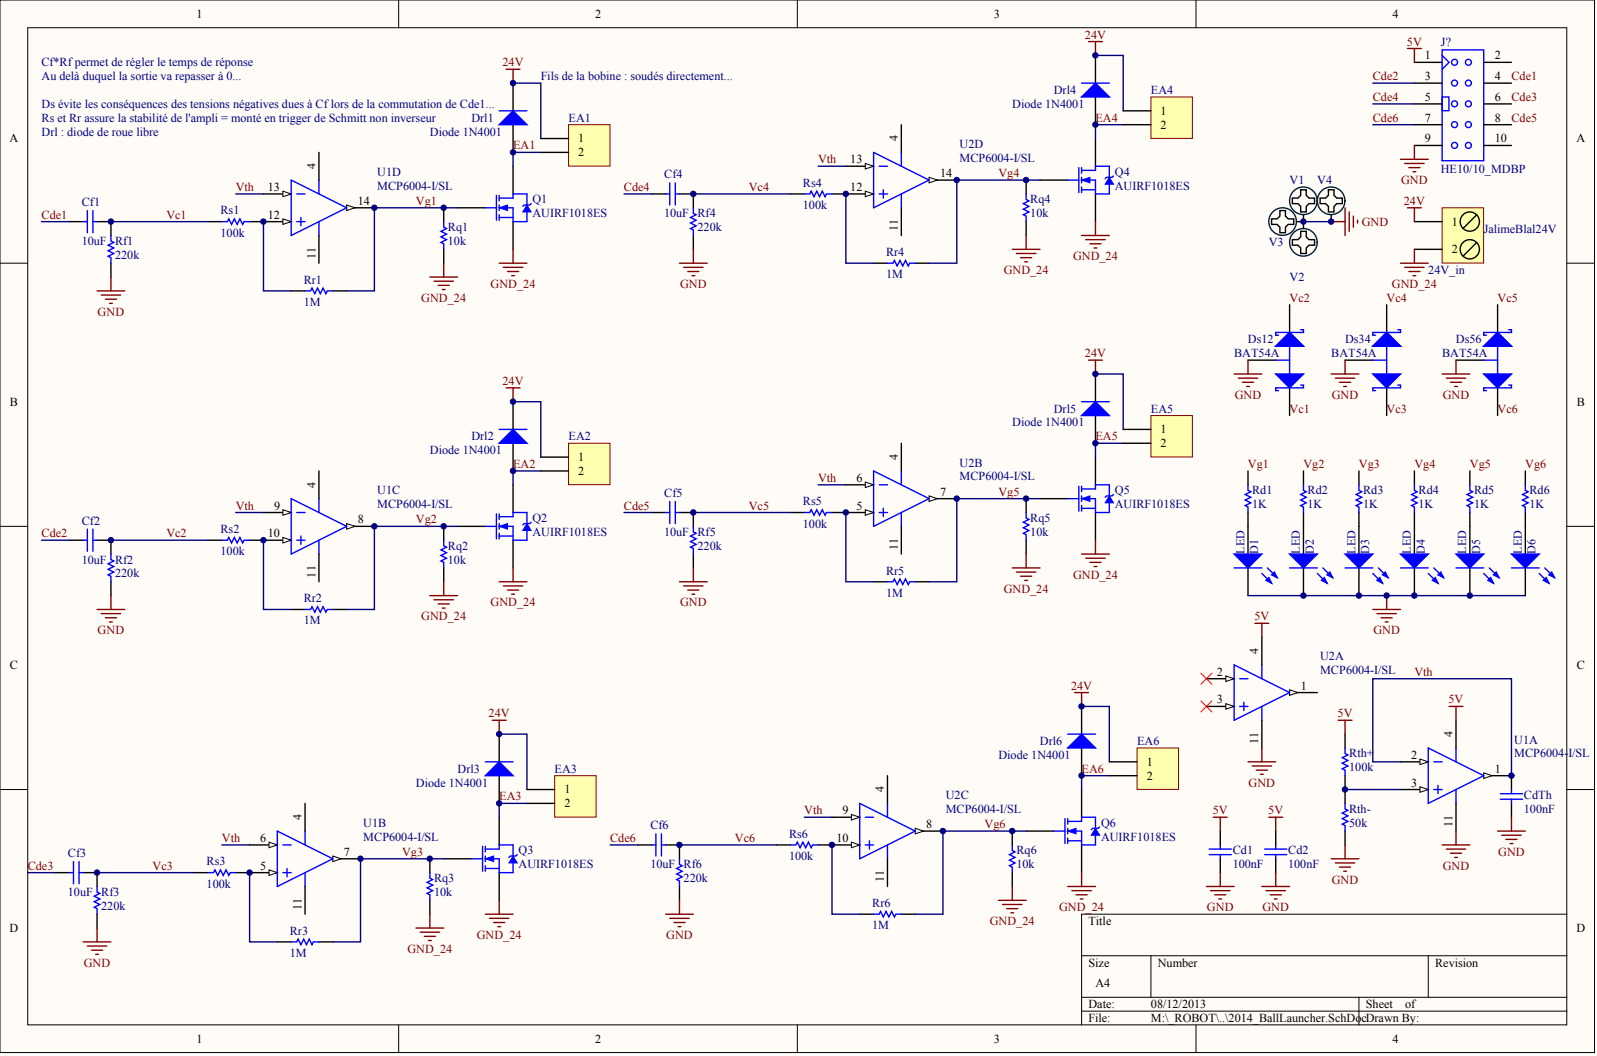
[picture p244: page 1]

Cf*Rf permet de régler le temps de réponse
Au delà duquel la sortie va repasser à 0...

Fils de la bobine : soudés directement...

Ds évite les conséquences des tensions négatives dues à Cf lors de la commutation de Cde1...
Rs et Rr assure la stabilité de l'ampli = monté en trigger de Schmitt non inverseur
Drl : diode de roue libre

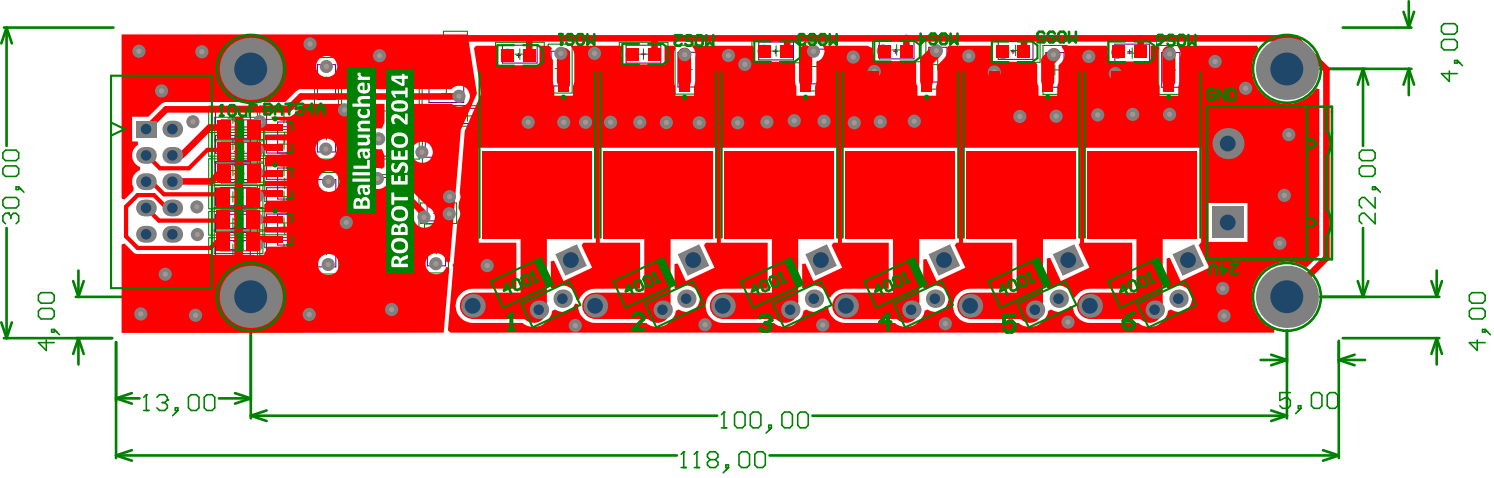
[picture p245: page 2]

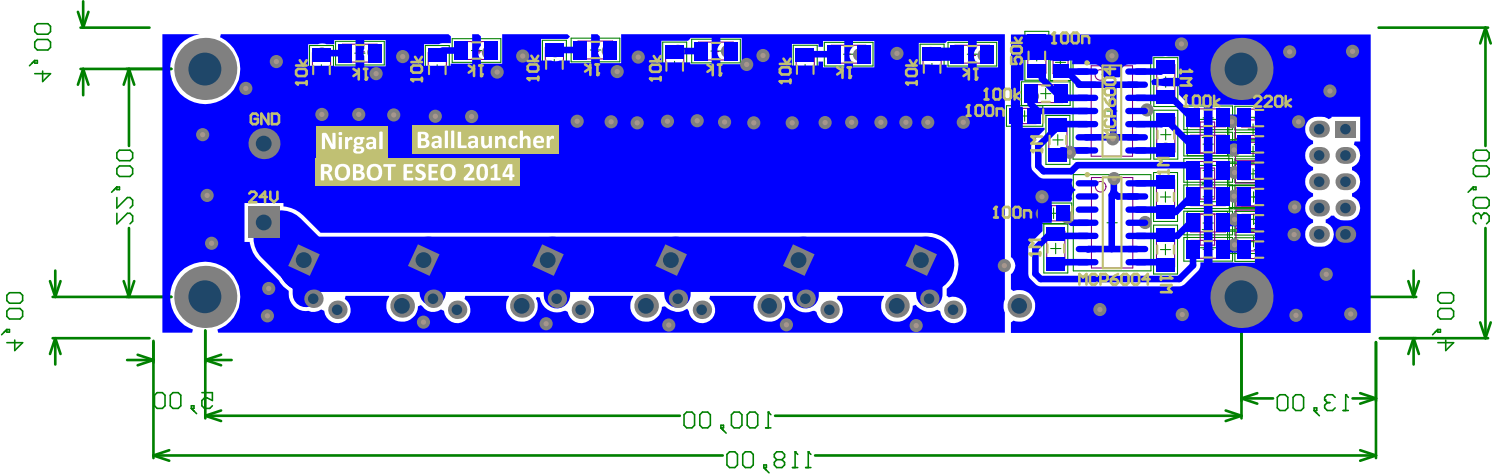
[picture p246: page 3]

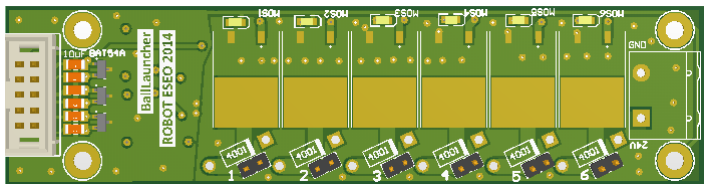
[picture p247: figure]

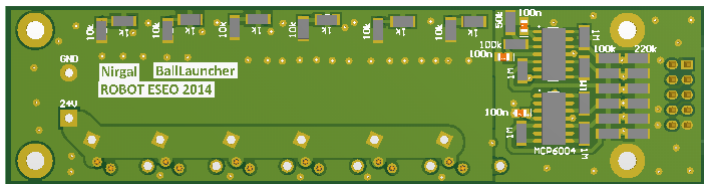
[picture p248: figure]
