samuelpoiraud/robot/_Hard/2014_ConnecteurChargeur/2014_ConnecteurChargeur.pdf

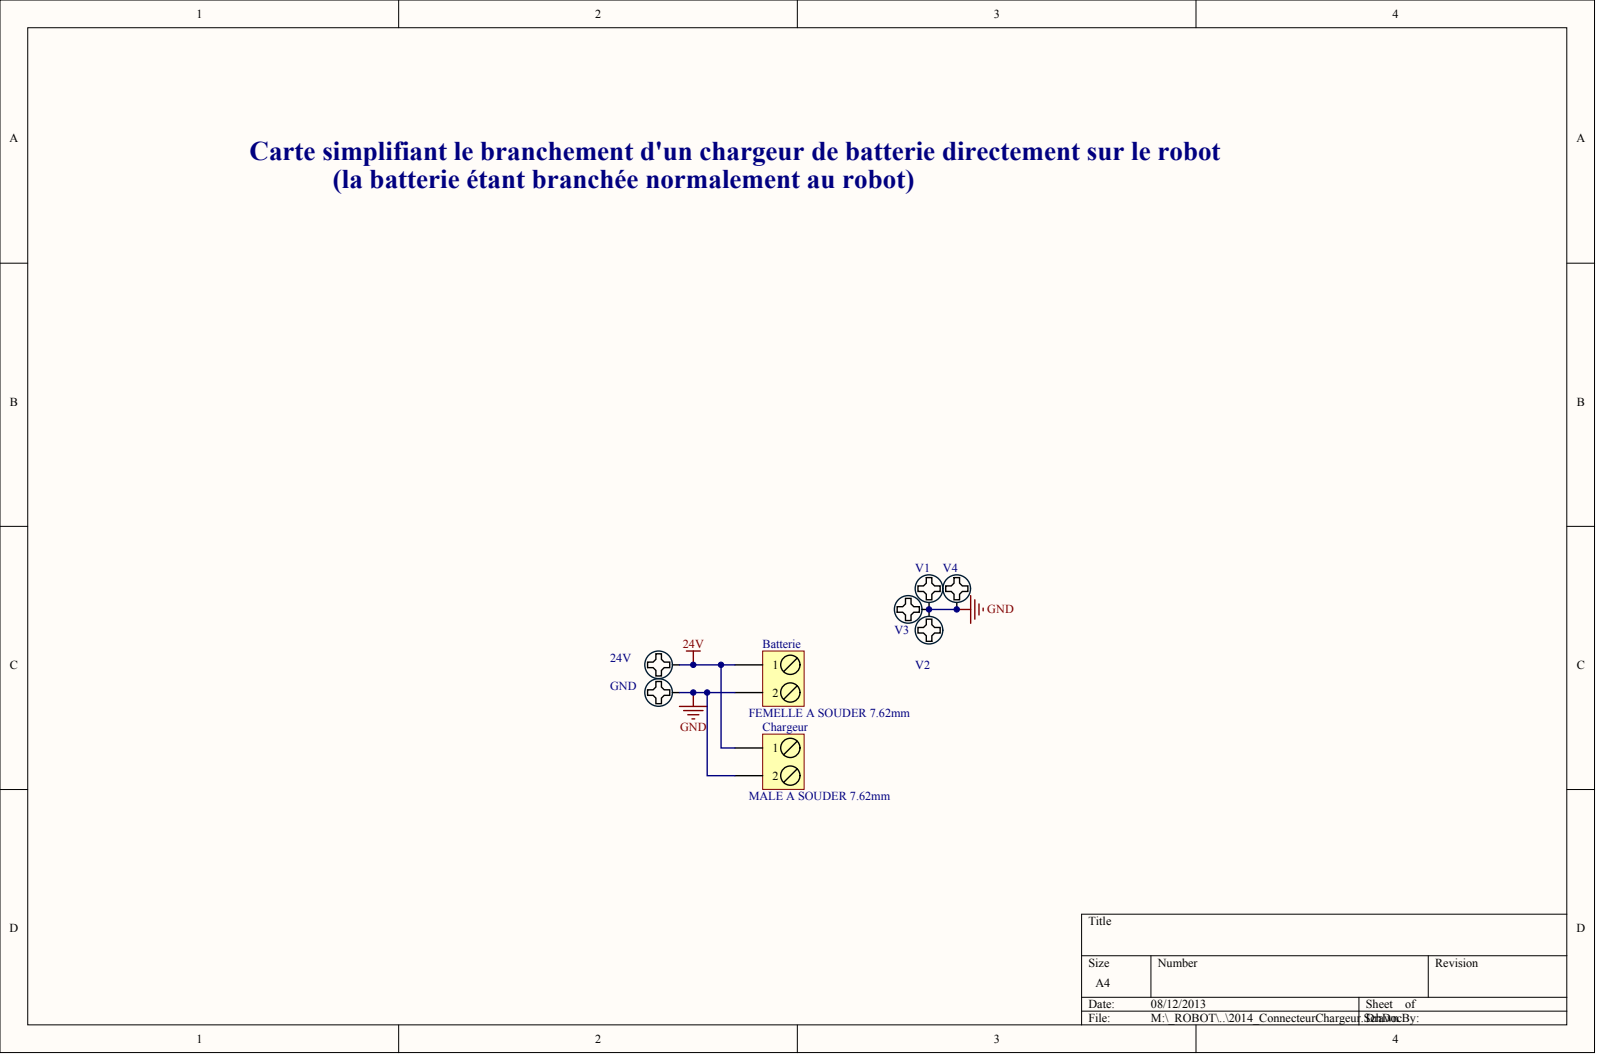
[picture p249: page 1]

Carte simplifiant le branchement d'un chargeur de batterie directement sur le robot

(la batterie étant branchée normalement au robot)

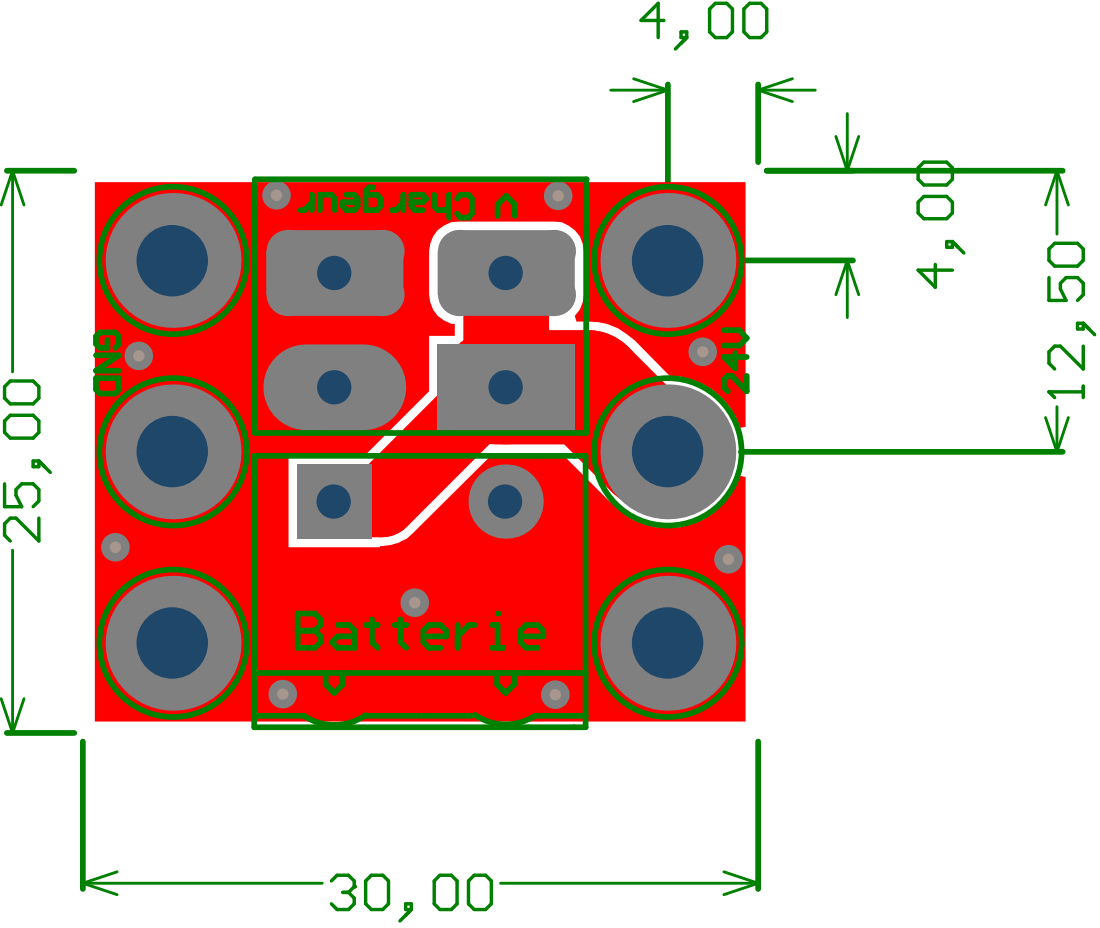
[picture p250: page 2]

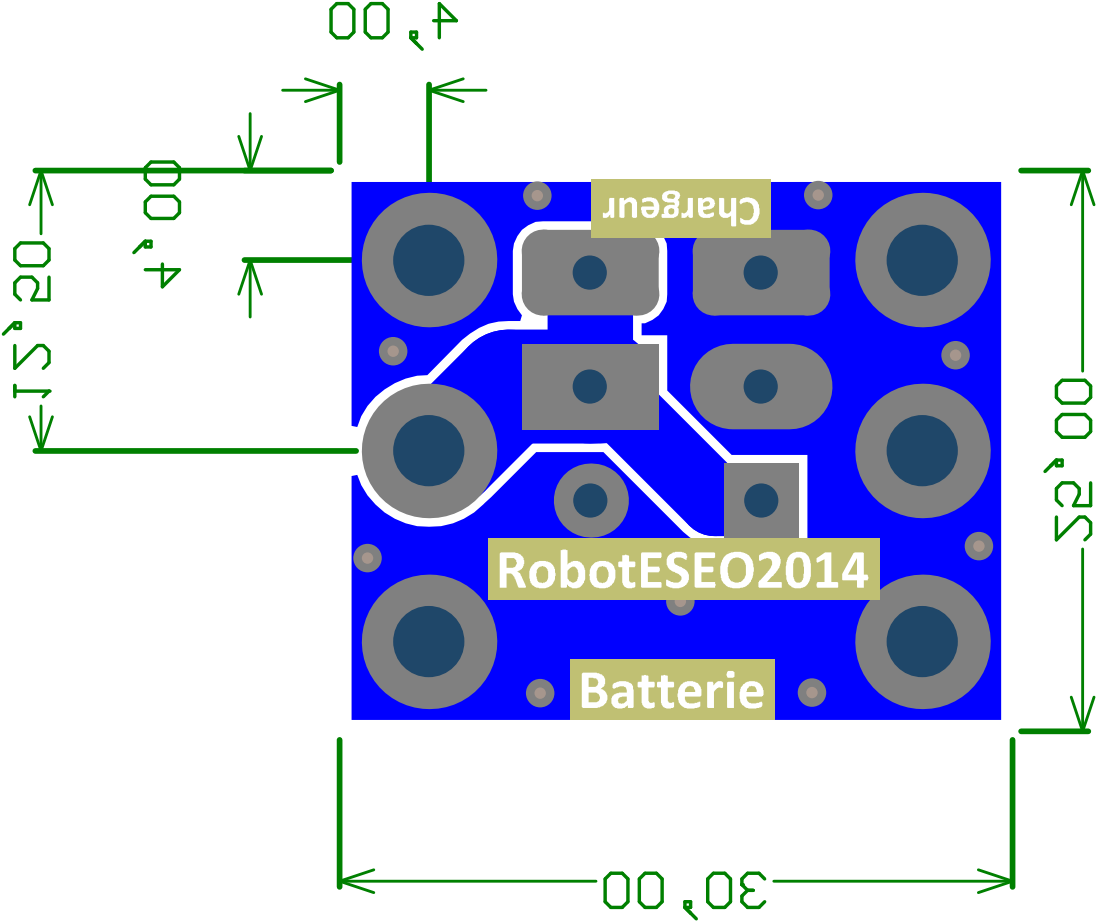
[picture p251: page 3]
