samuelpoiraud/robot/_Hard/2012_PerfUSB/2012_PerfUSB.PDF

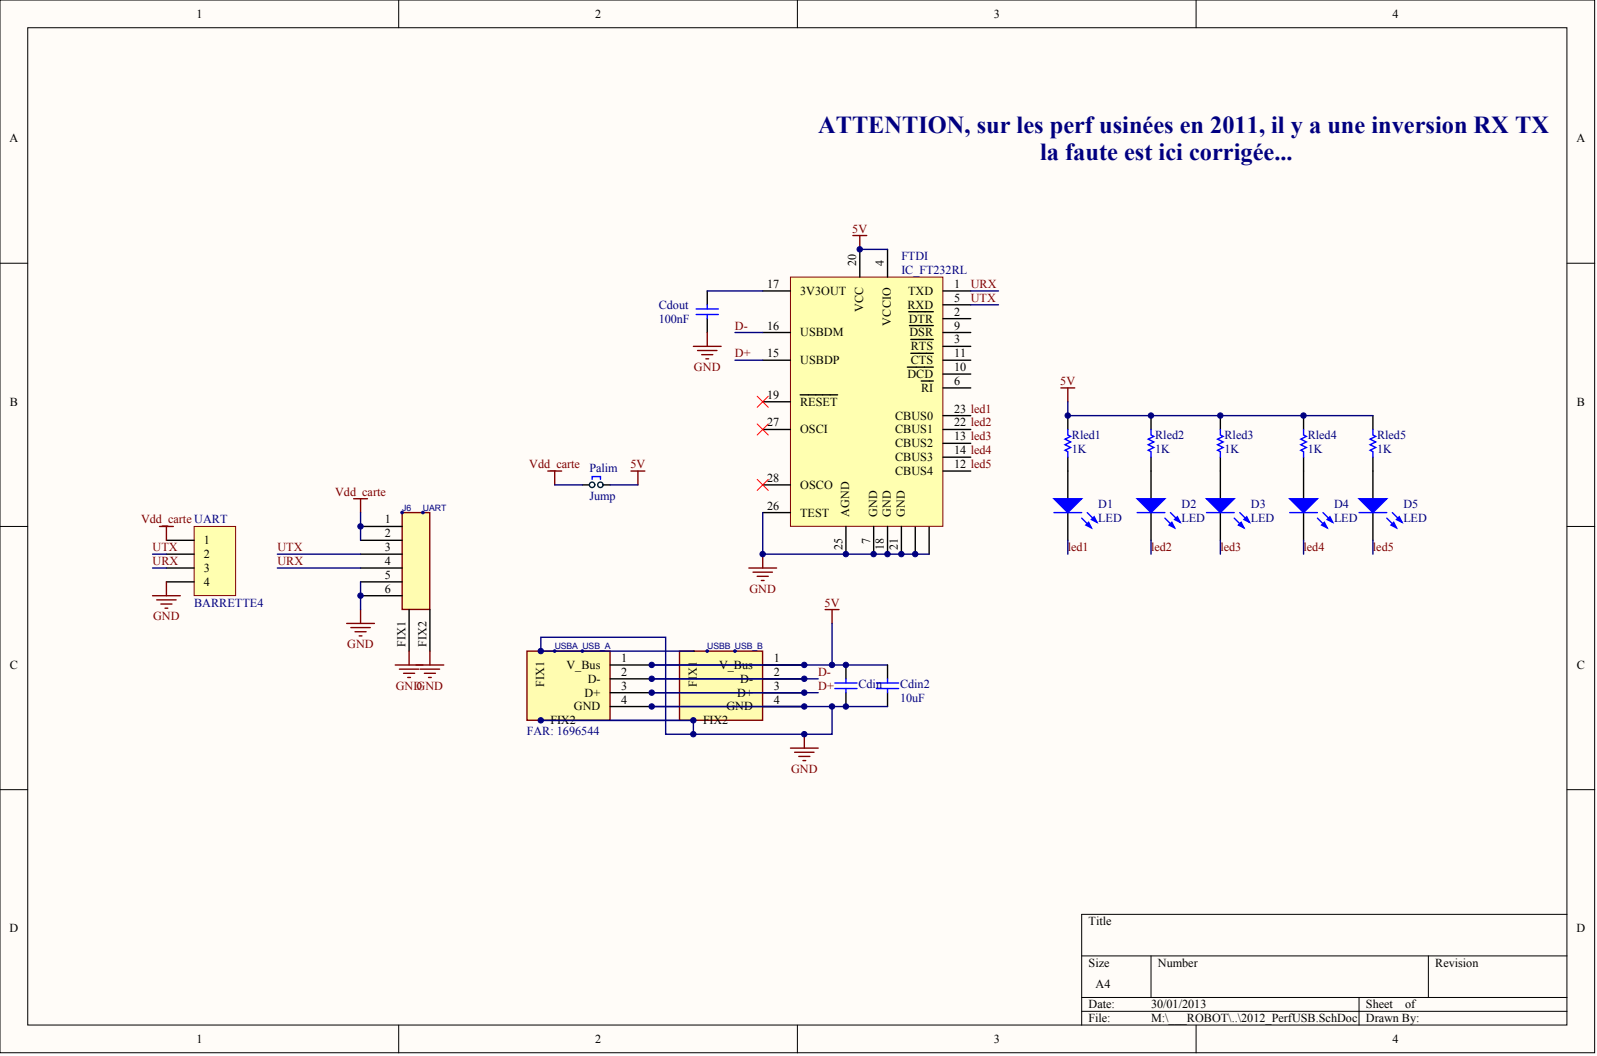
[picture p257: page 1]

ATTENTION, sur les perf usinées en 2011, il y a une inversion RX TX

la faute est ici corrigée...

V_Bus D-D+ GND | 1 | V_Bus

2 3 4 | D-D+ GND

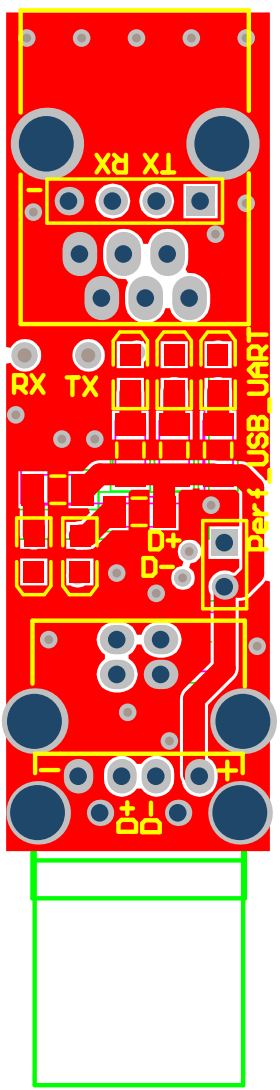
[picture p258: page 4]

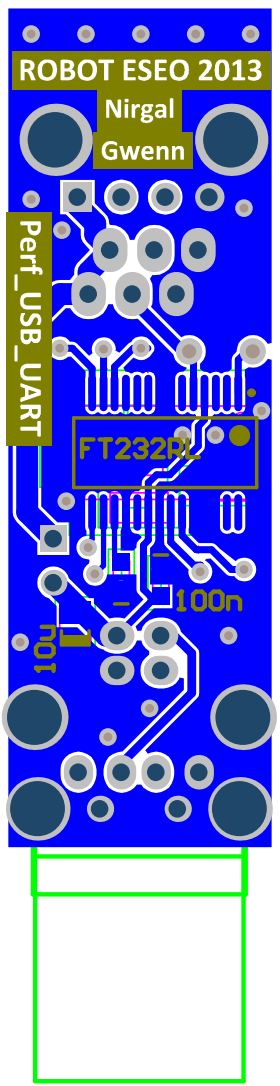
[picture p259: page 5]

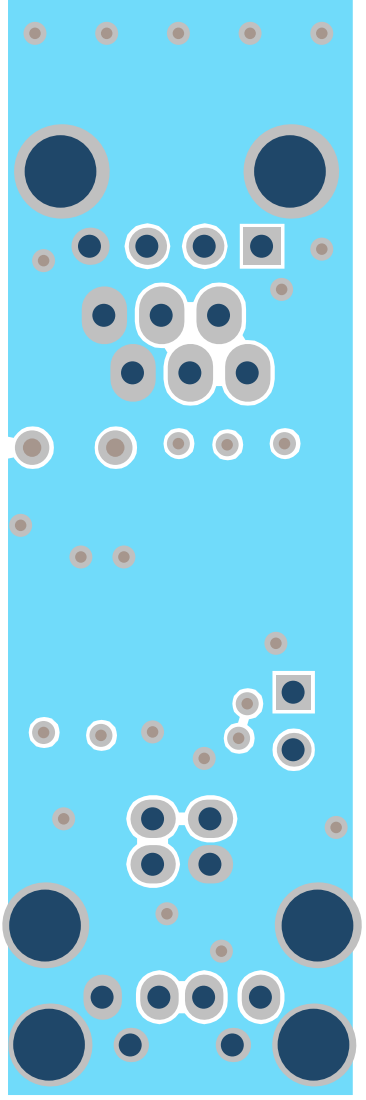
[picture p260: page 6]

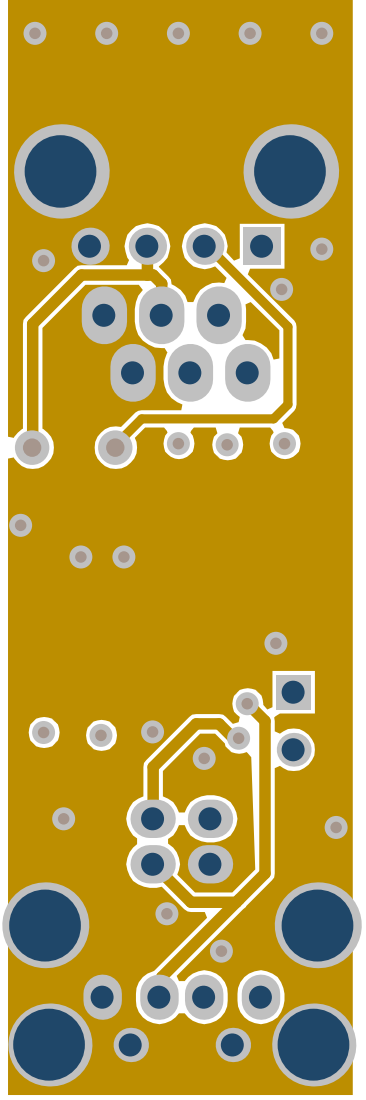
[picture p261: page 7]

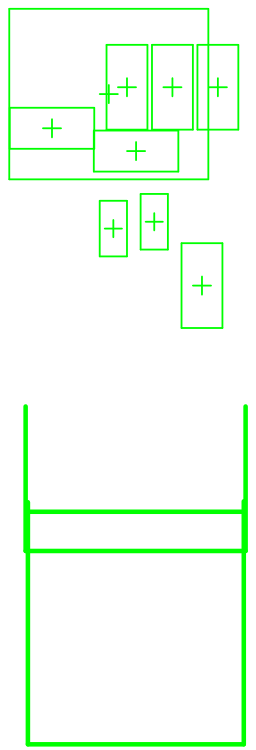
[picture p262: page 8]
