samuelpoiraud/robot/_Hard/2013_Carte_Factorisee/2013_CARTE_FACTORISEE.PDF

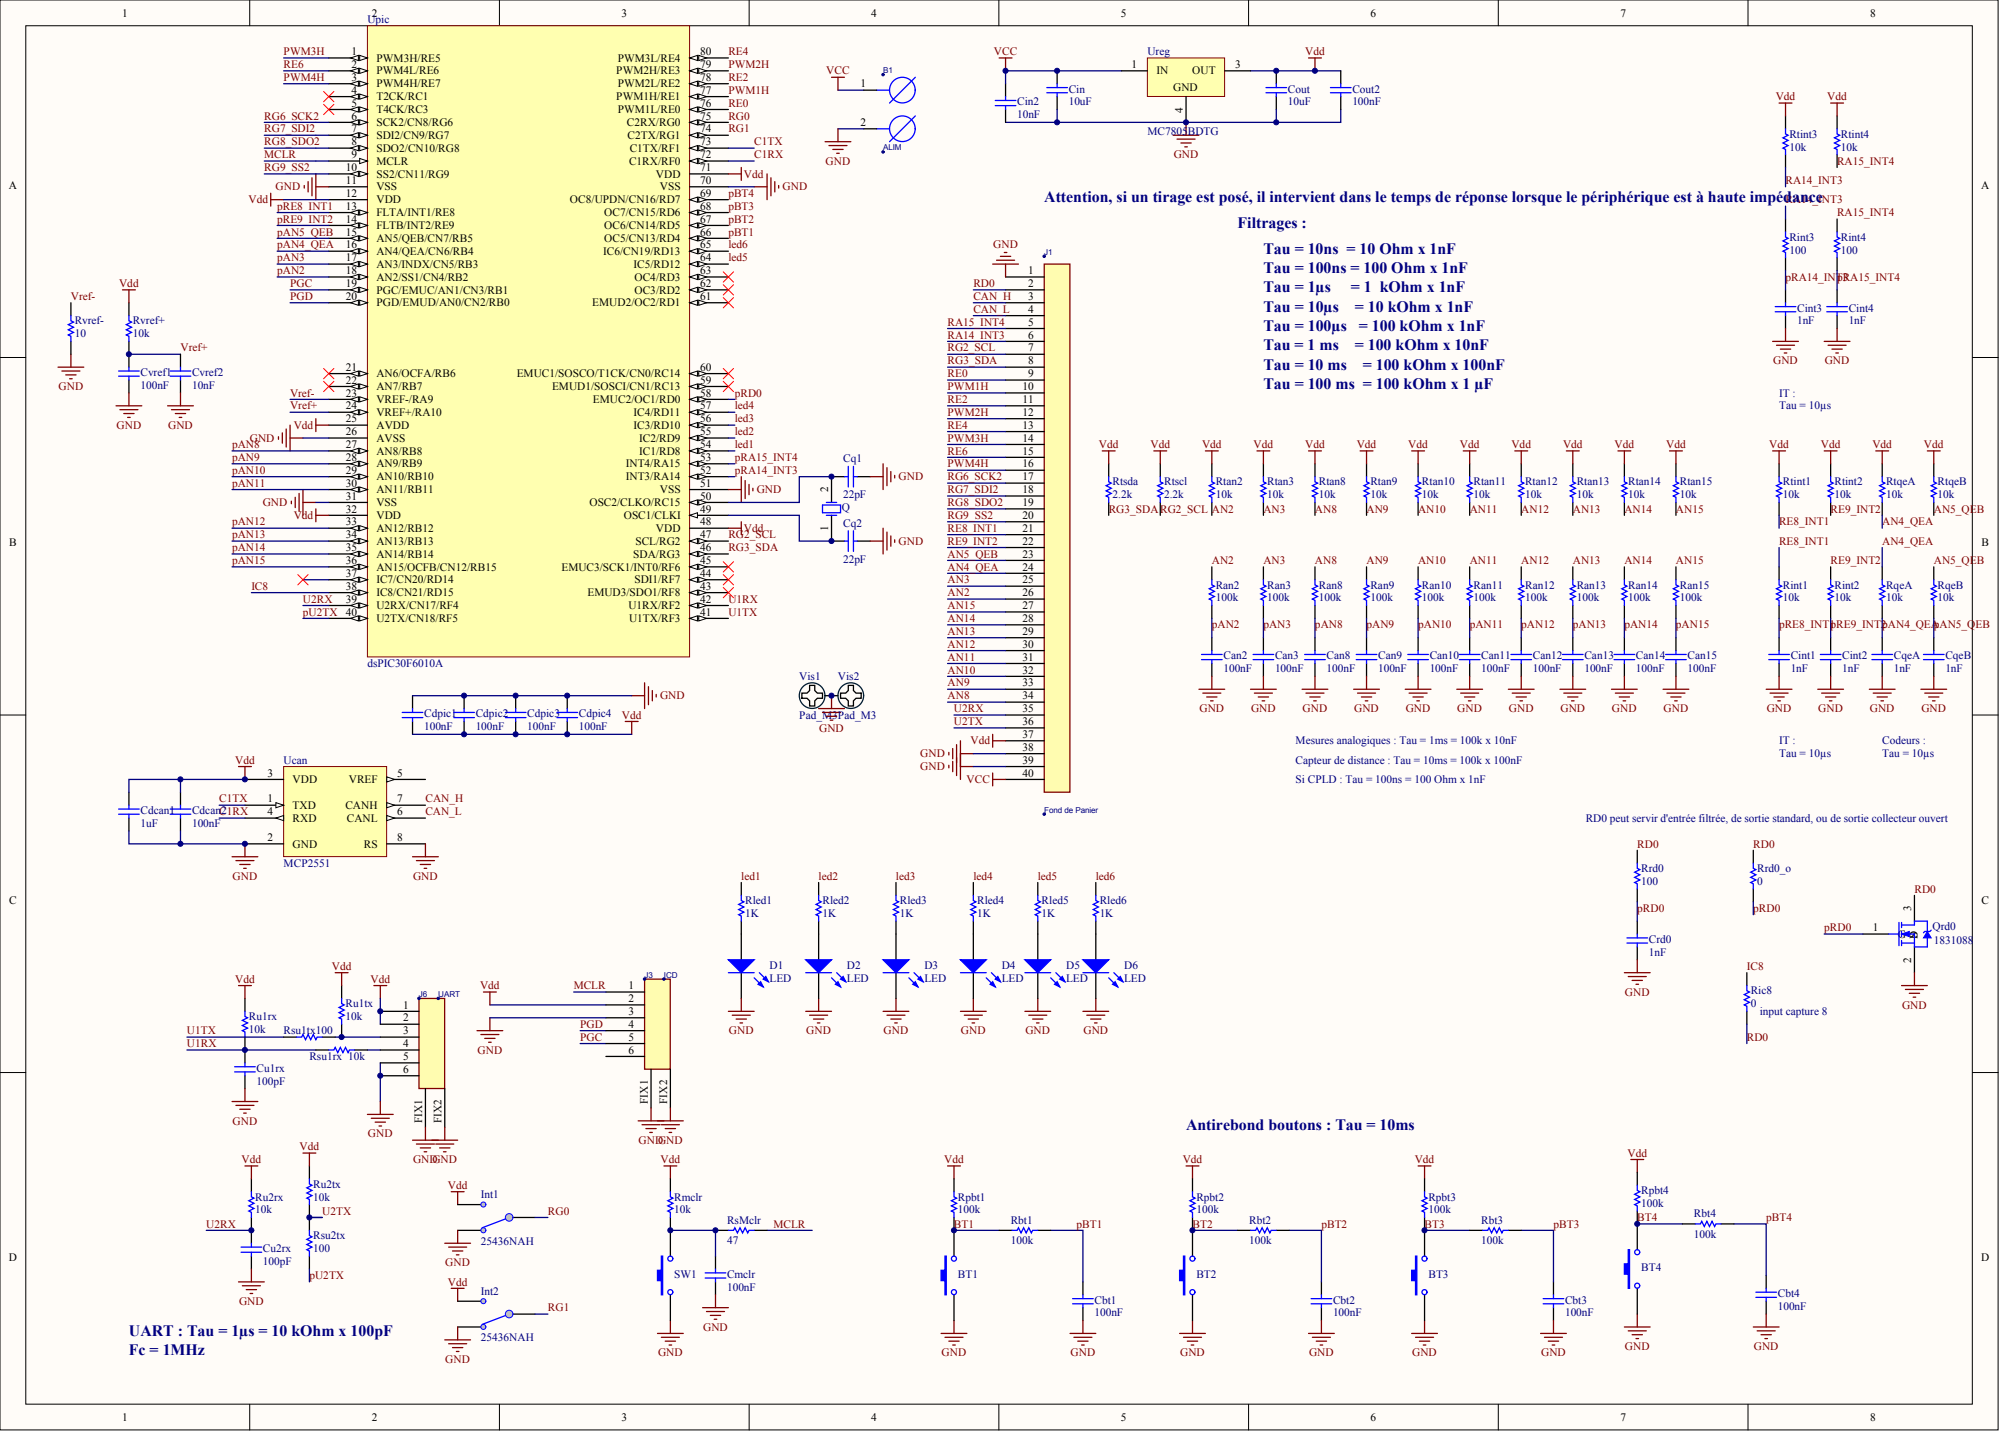
[picture p263: page 1]

Attention, si un tirage est posé, il intervient dans le temps de réponse lorsque le périphérique est à haute impédance

Filtrages :
Tau = 10ns = 10 Ohm x 1nF
Tau = 100ns = 100 Ohm x 1nF
Tau = 10µs = 10 kOhm x 1nF
Tau = 100µs = 100 kOhm x 1nF
Tau = 1 ms = 100 kOhm x 10nF
Tau = 10 ms = 100 kOhm x 100nF
Tau = 100 ms = 100 kOhm x 1 µF

Mesures analogiques : Tau = 1ms = 100k x 10nF
Capteur de distance : Tau = 10ms = 100k x 100nF
Si CPLD : Tau = 100ns = 100 Ohm x 1nF

RD0 peut servir d'entrée filtrée, de sortie standard, ou de sortie collecteur ouvert

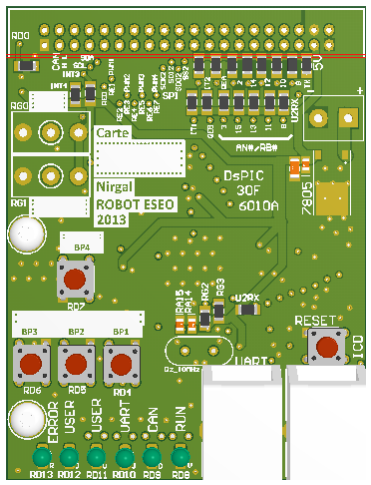
[picture p264: figure]

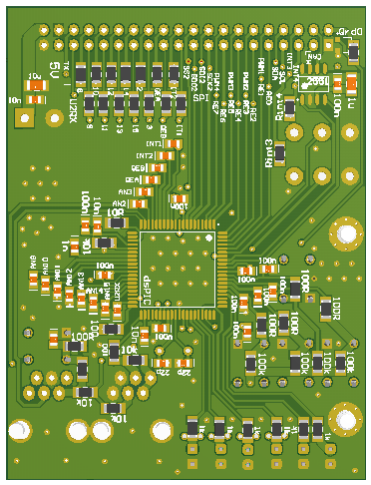
[picture p265: figure]
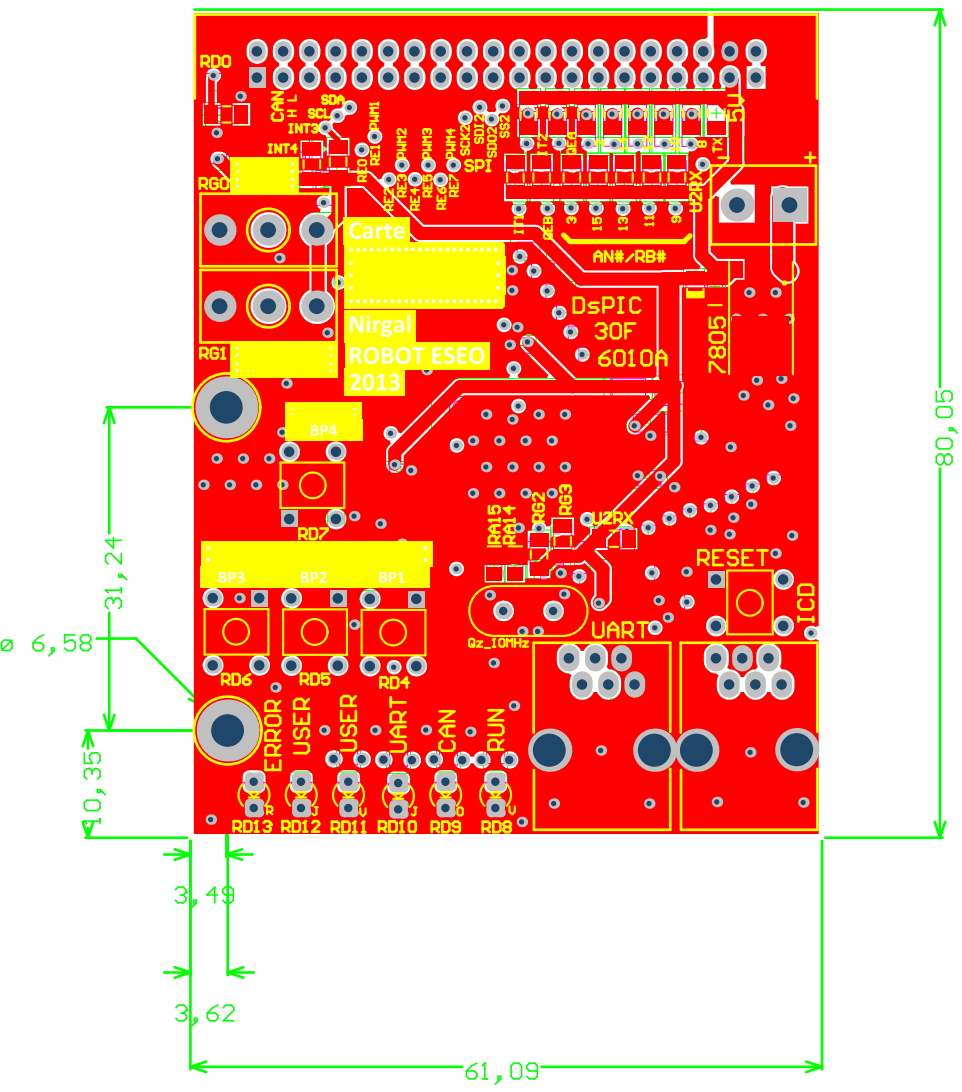
[picture p266: page 4]

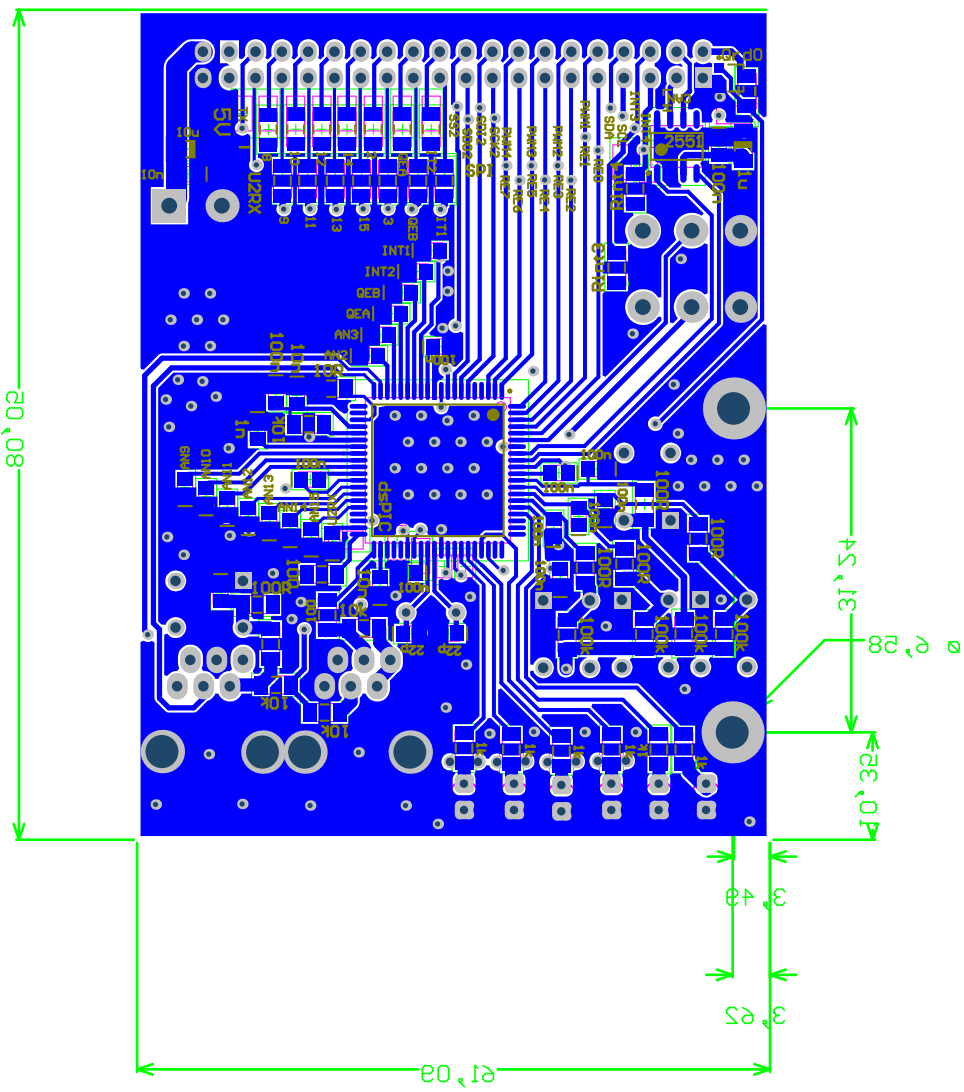
[picture p267: page 5]

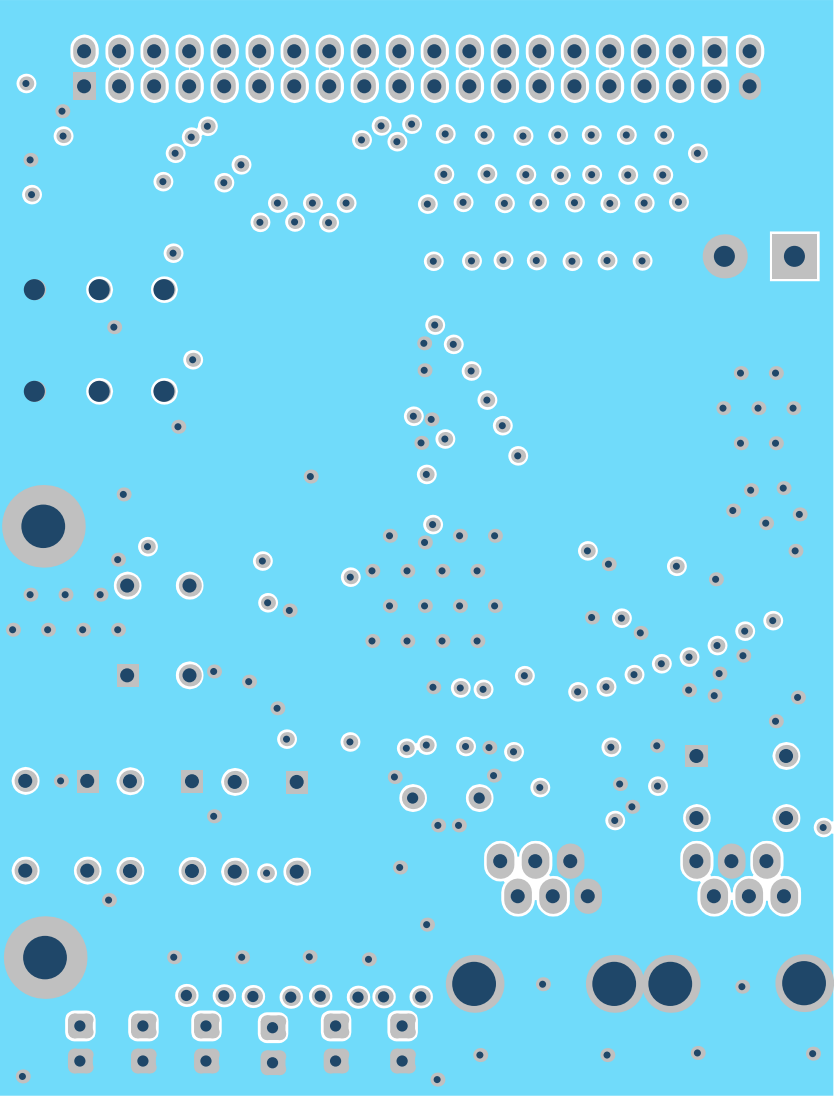
[picture p268: page 6]

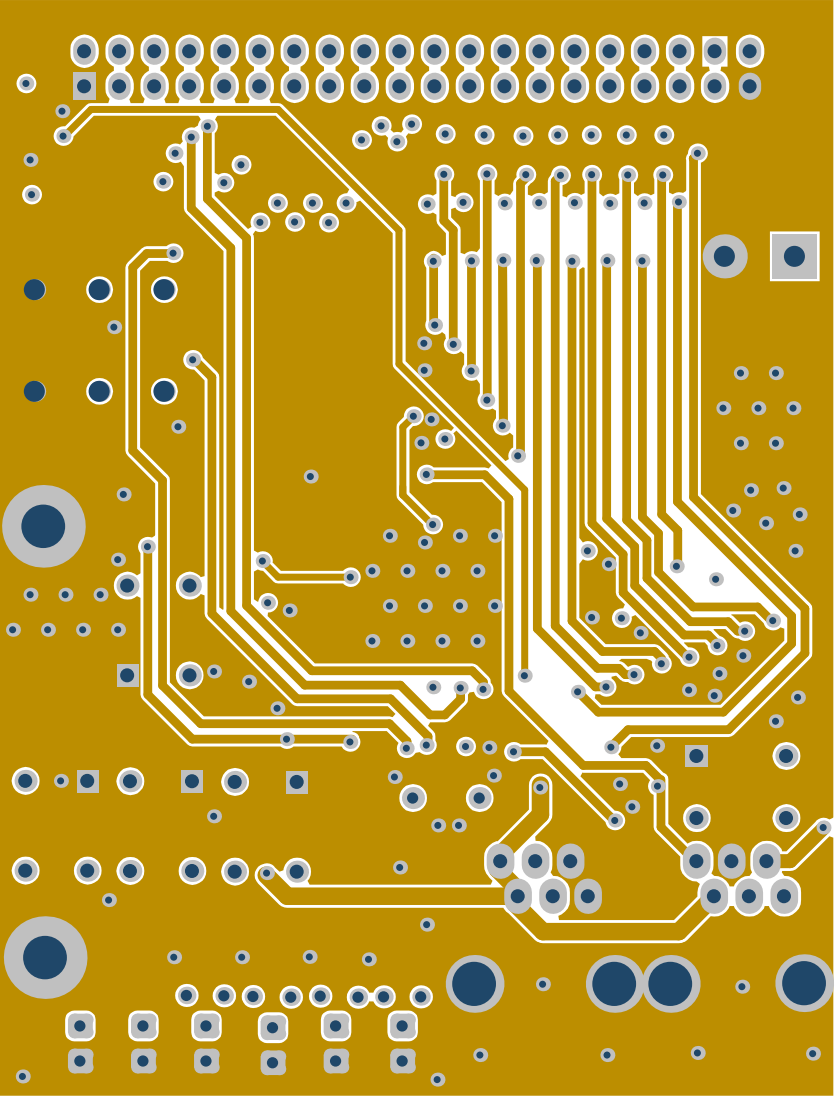
[picture p269: page 7]

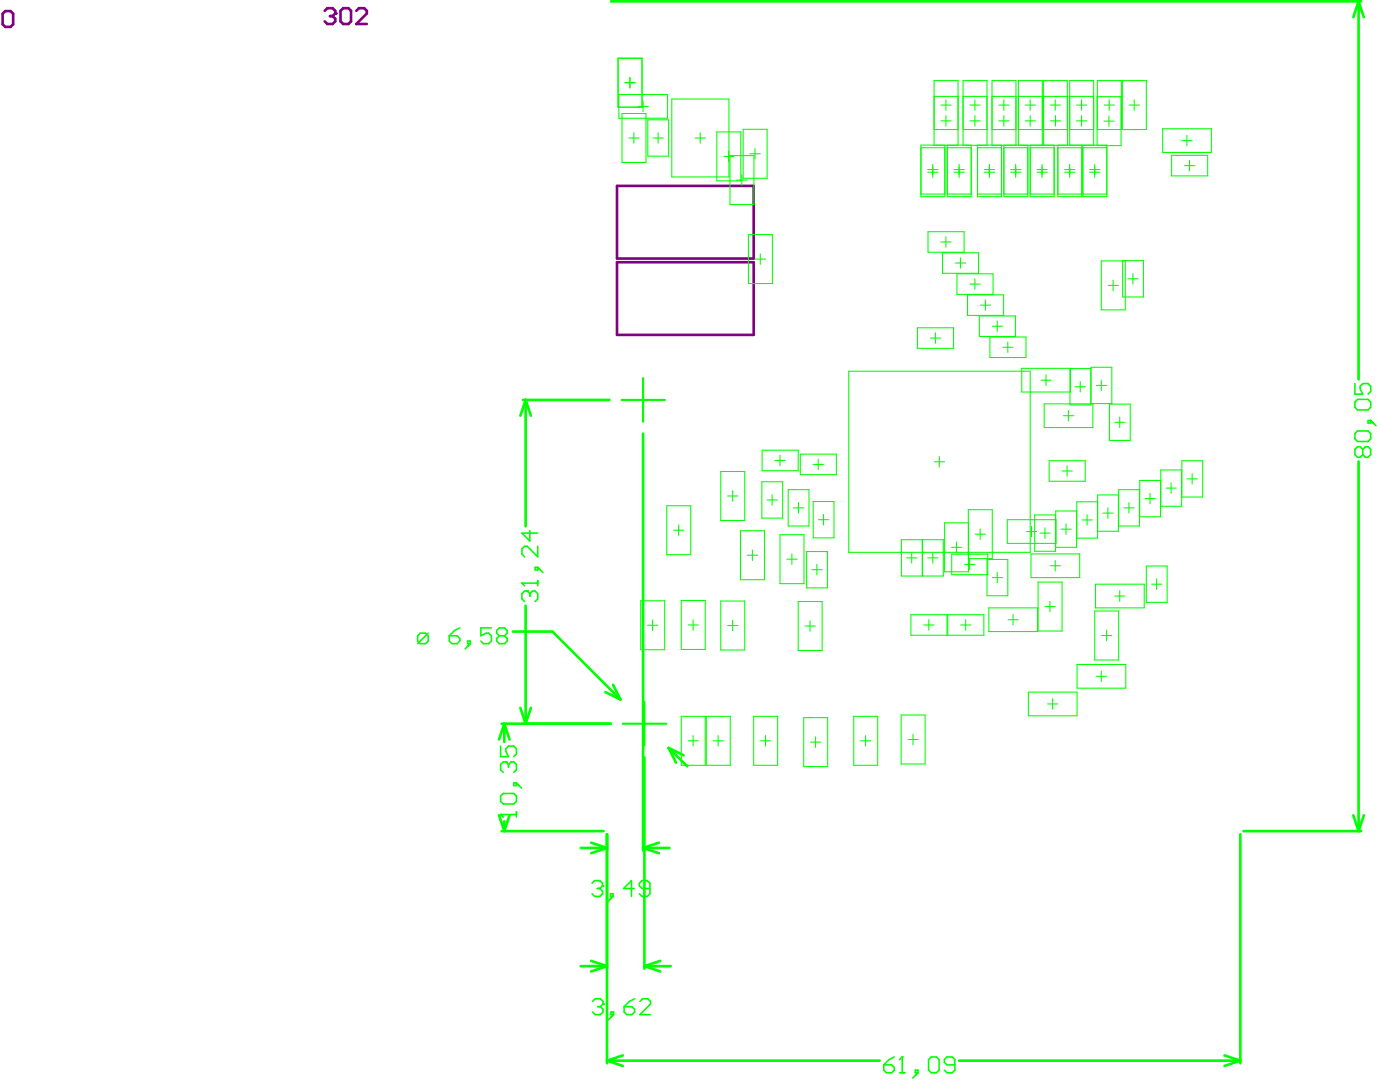
[picture p270: page 8]
