samuelpoiraud/robot/_Hard/2013_FDP_small/2013_FDP_v1.PDF

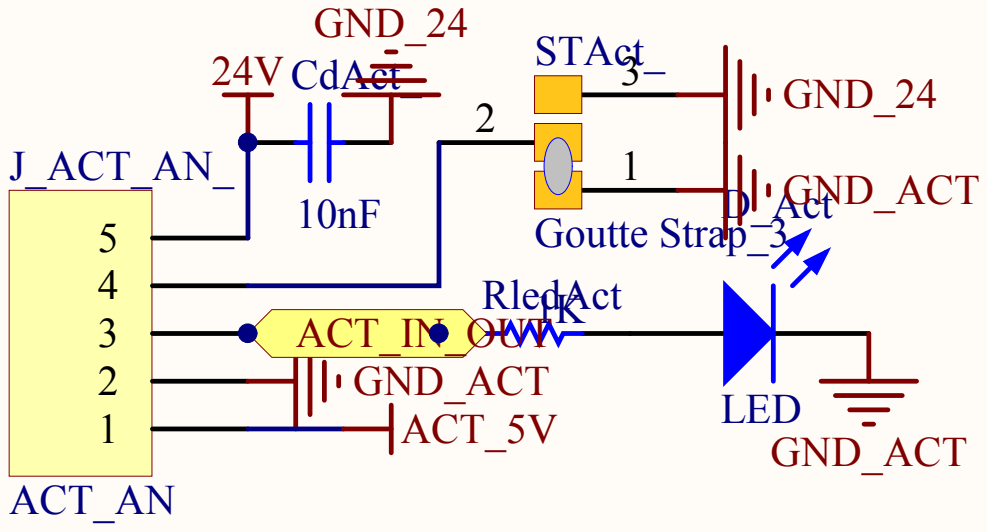
[picture p271: page 1]

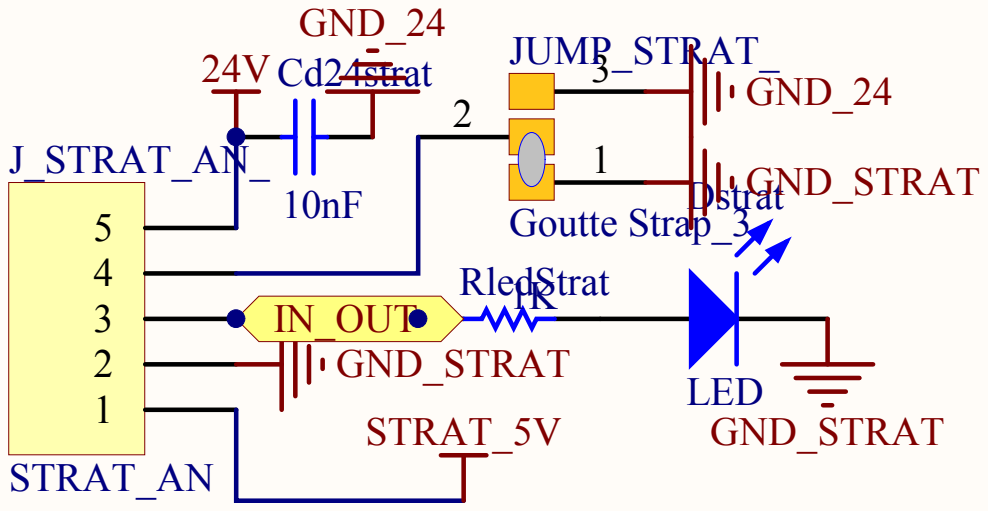
[picture p272: page 2]

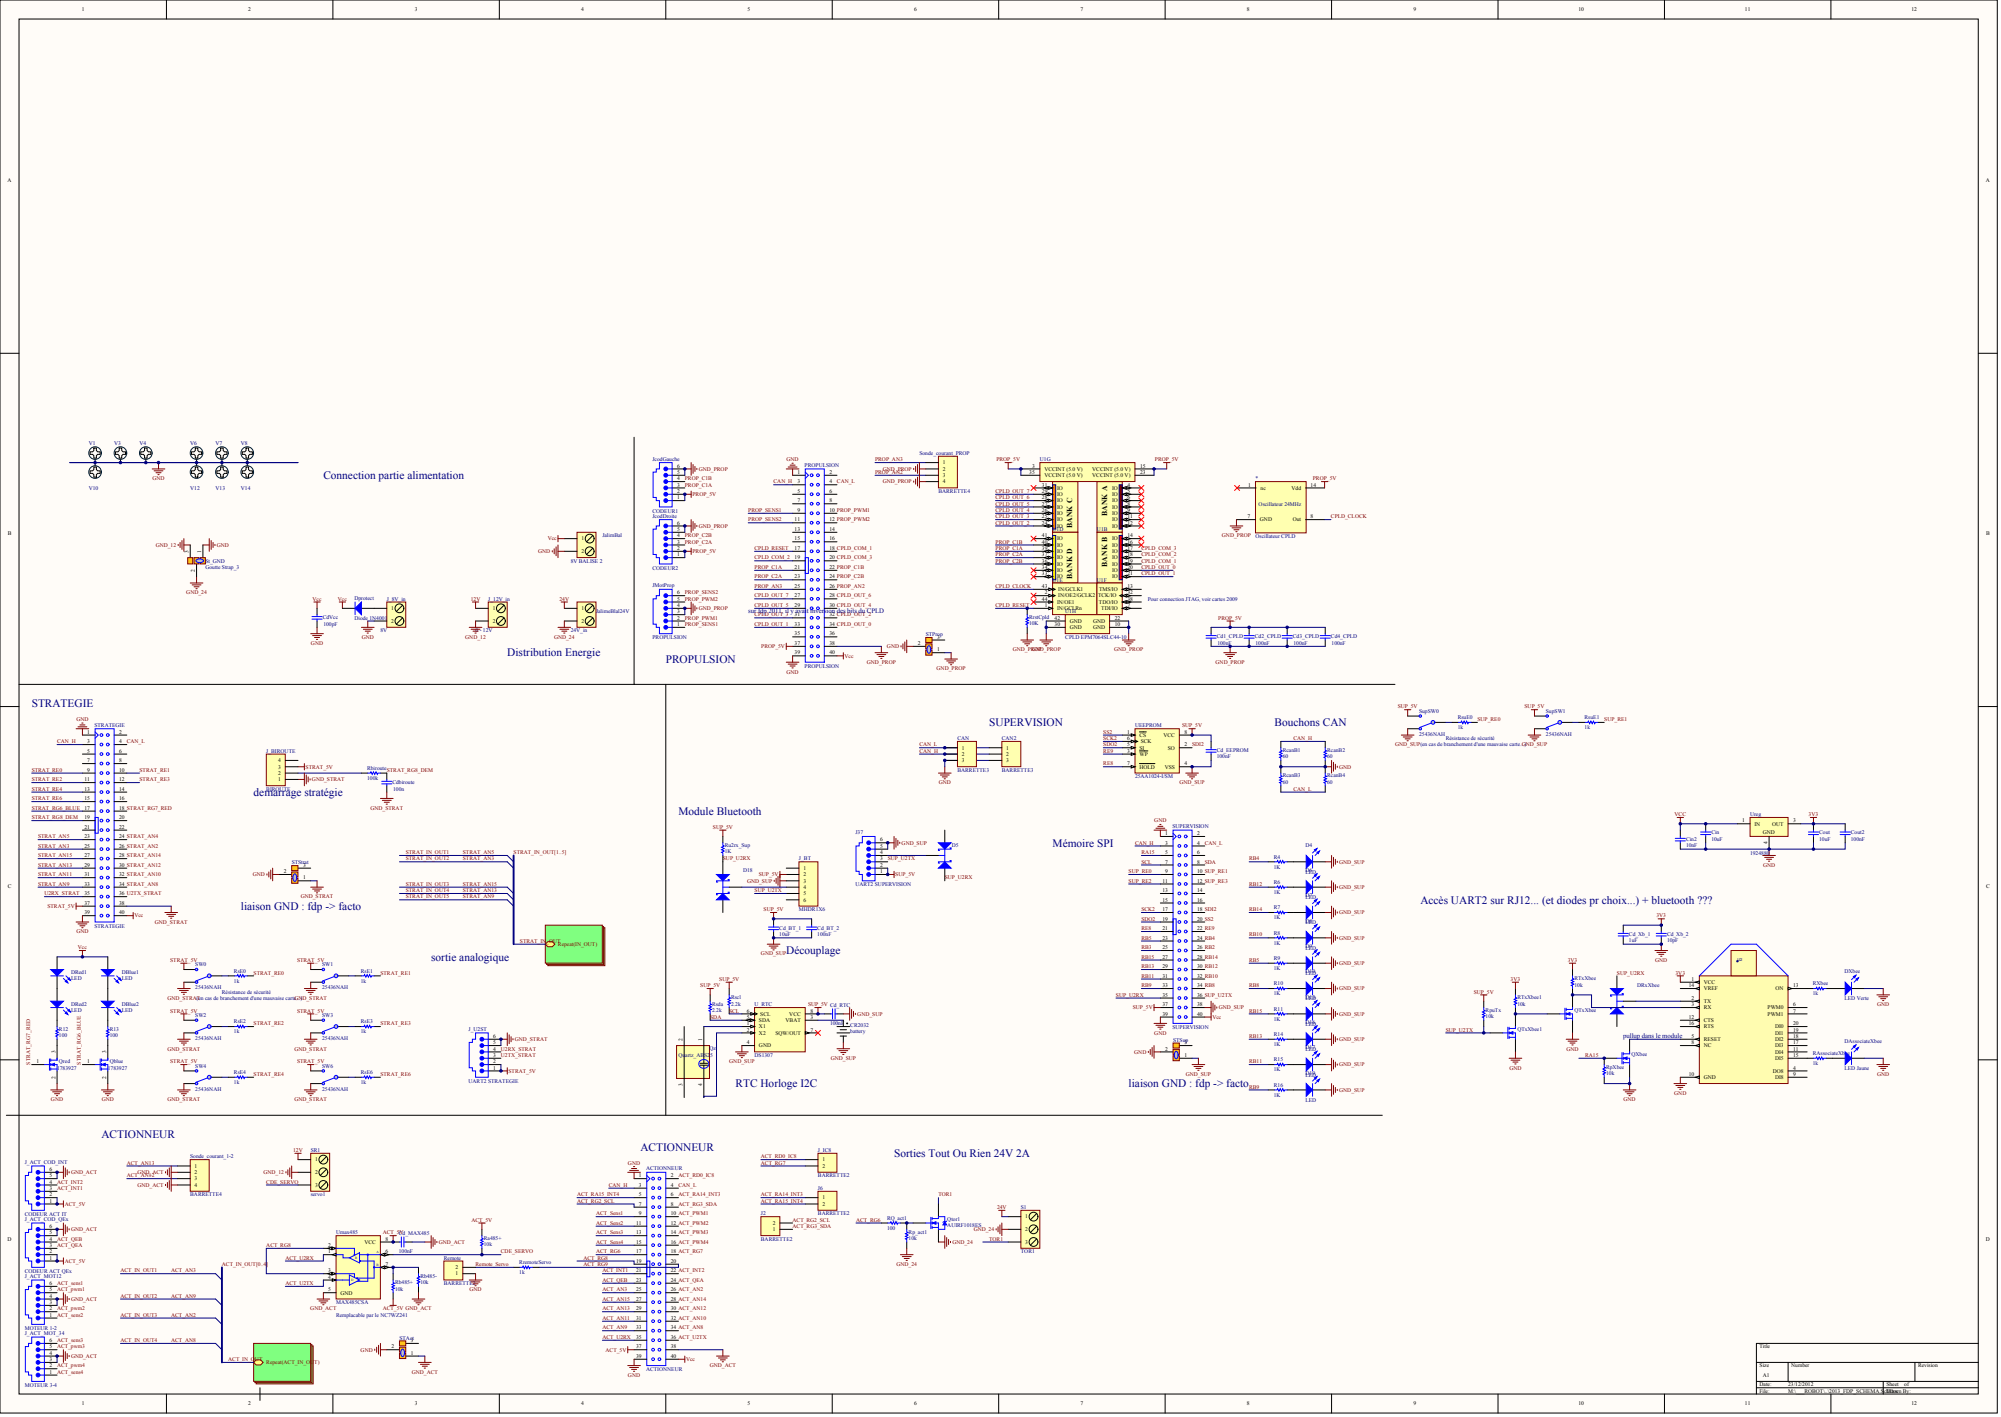
[picture p273: page 3]

Pour connection JTAG, voir cartes 2009

CPLD_OUT_5
CPLD_OUT_3 sur fdp 2011, il y avait inversion des bits du CPLD

(en cas de branchement d'une mauvaise carte...)

Accès UART2 sur RJ12... (et diodes pr choix...) + bluetooth ???

liaison GND : fdp -> facto

pullup dans le module

Sorties Tout Ou Rien 24V 2A

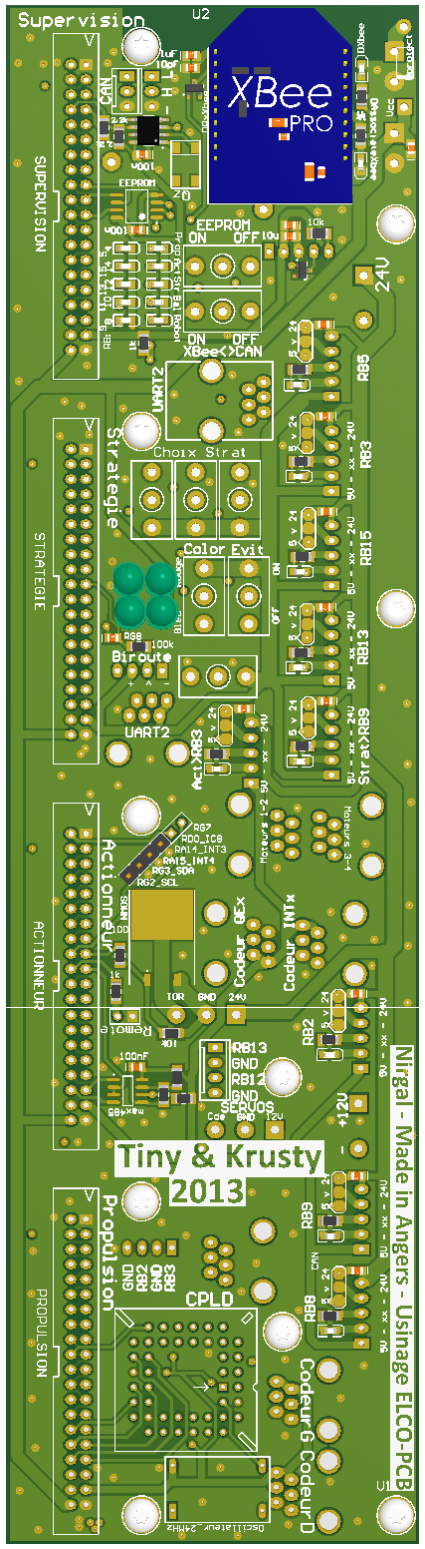
[picture p274: figure]

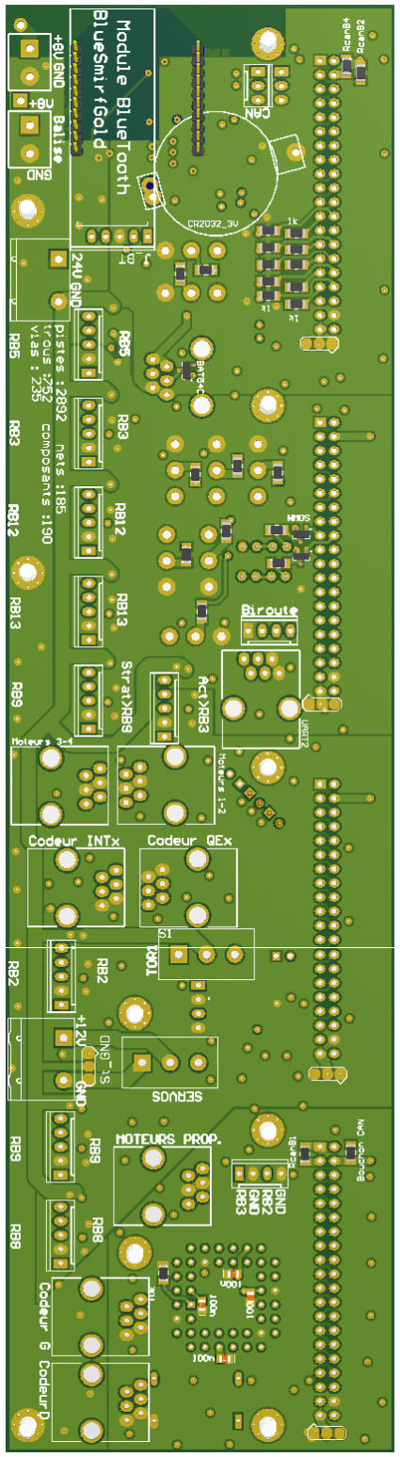
[picture p275: figure]
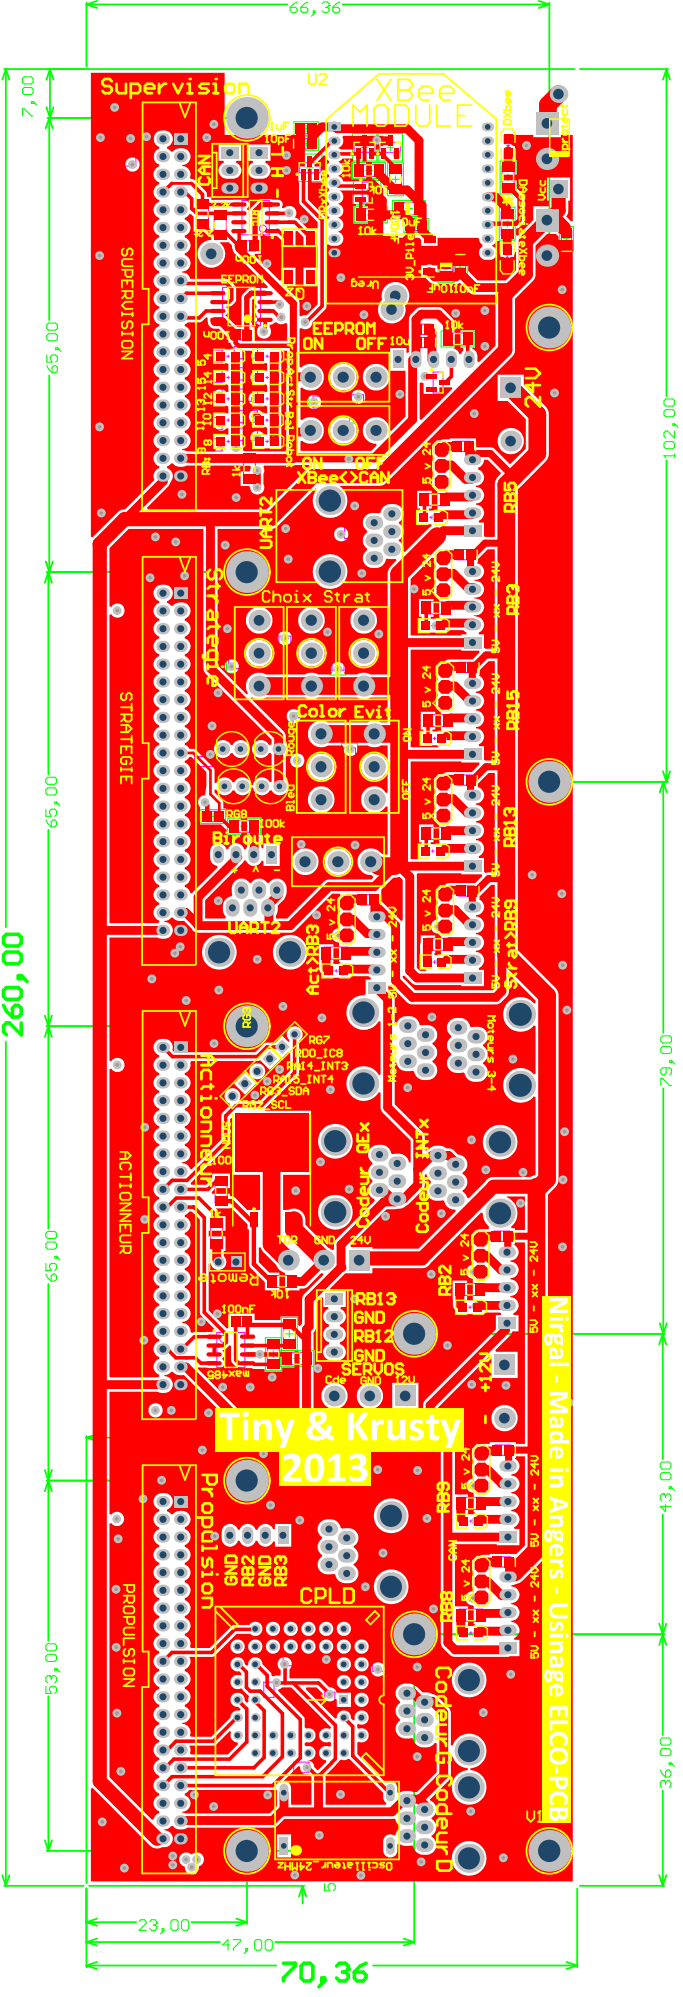
[picture p276: page 6]

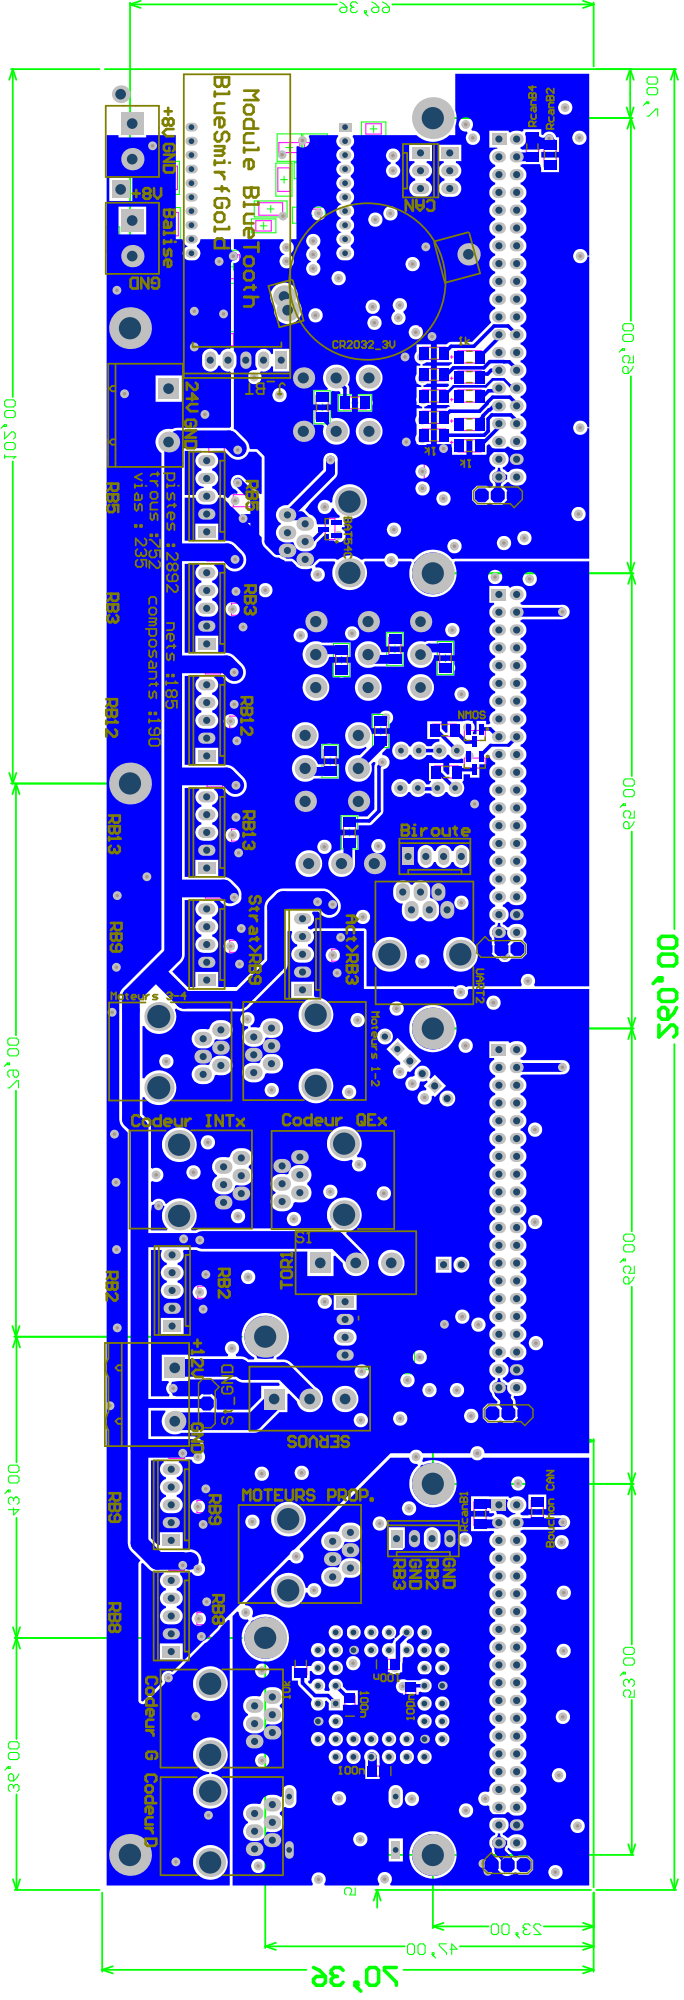
[picture p277: page 7]

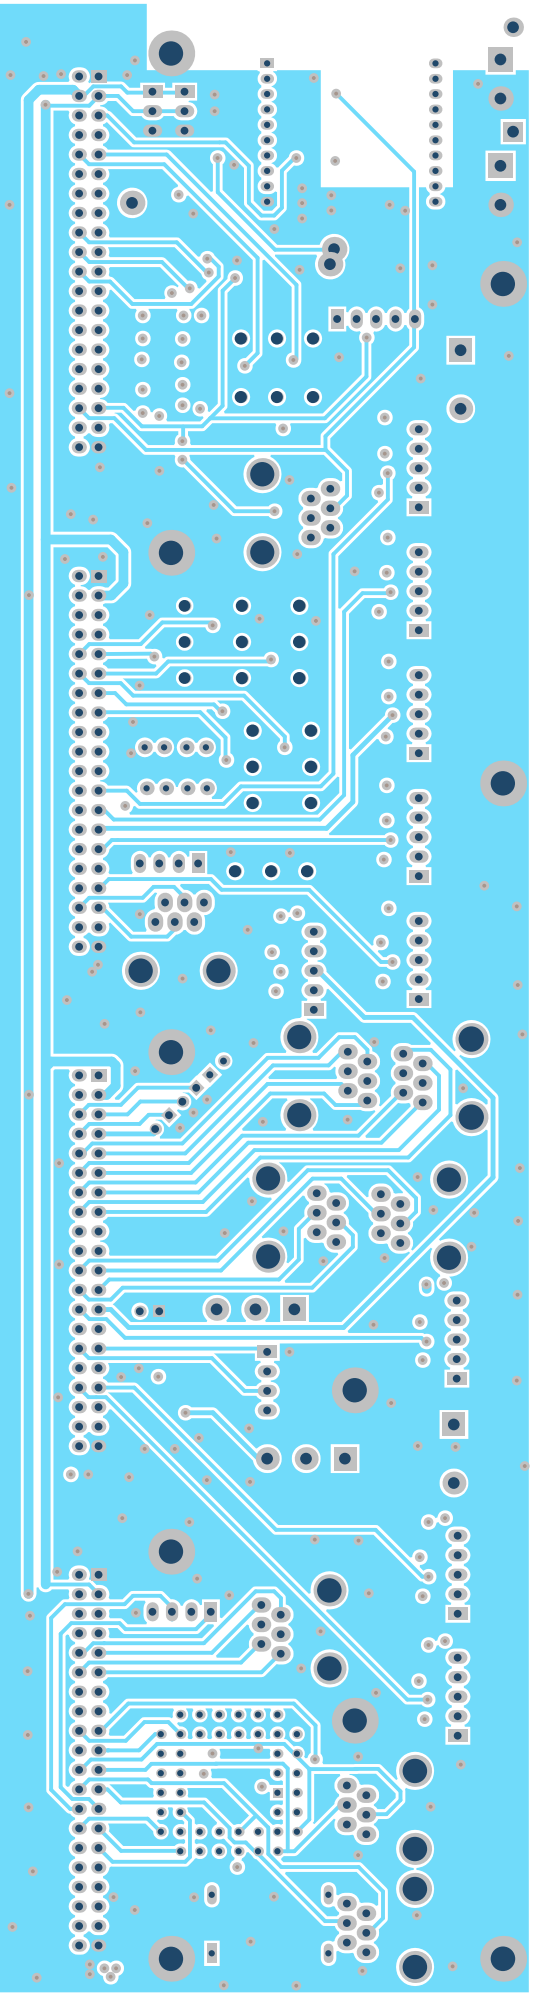
[picture p278: page 8]

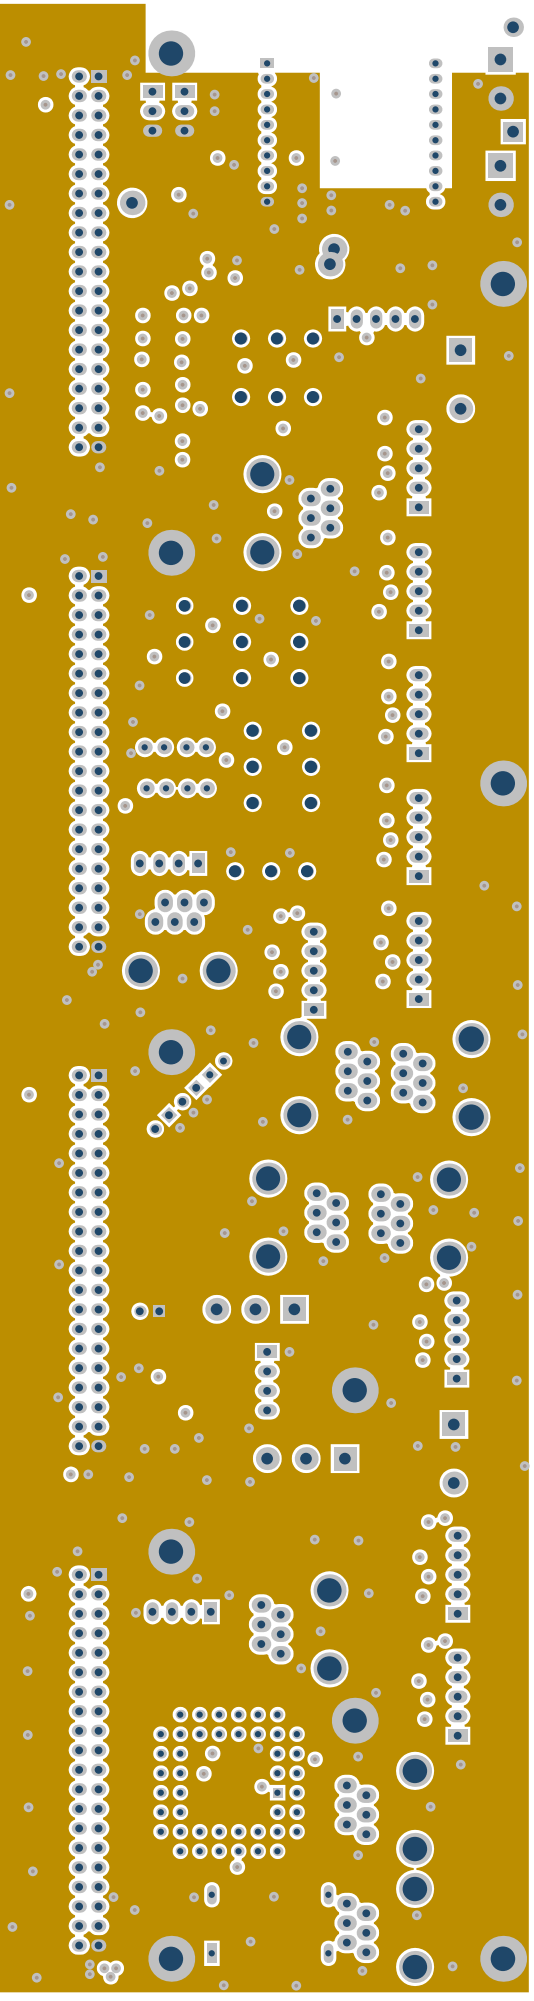
[picture p279: page 9]

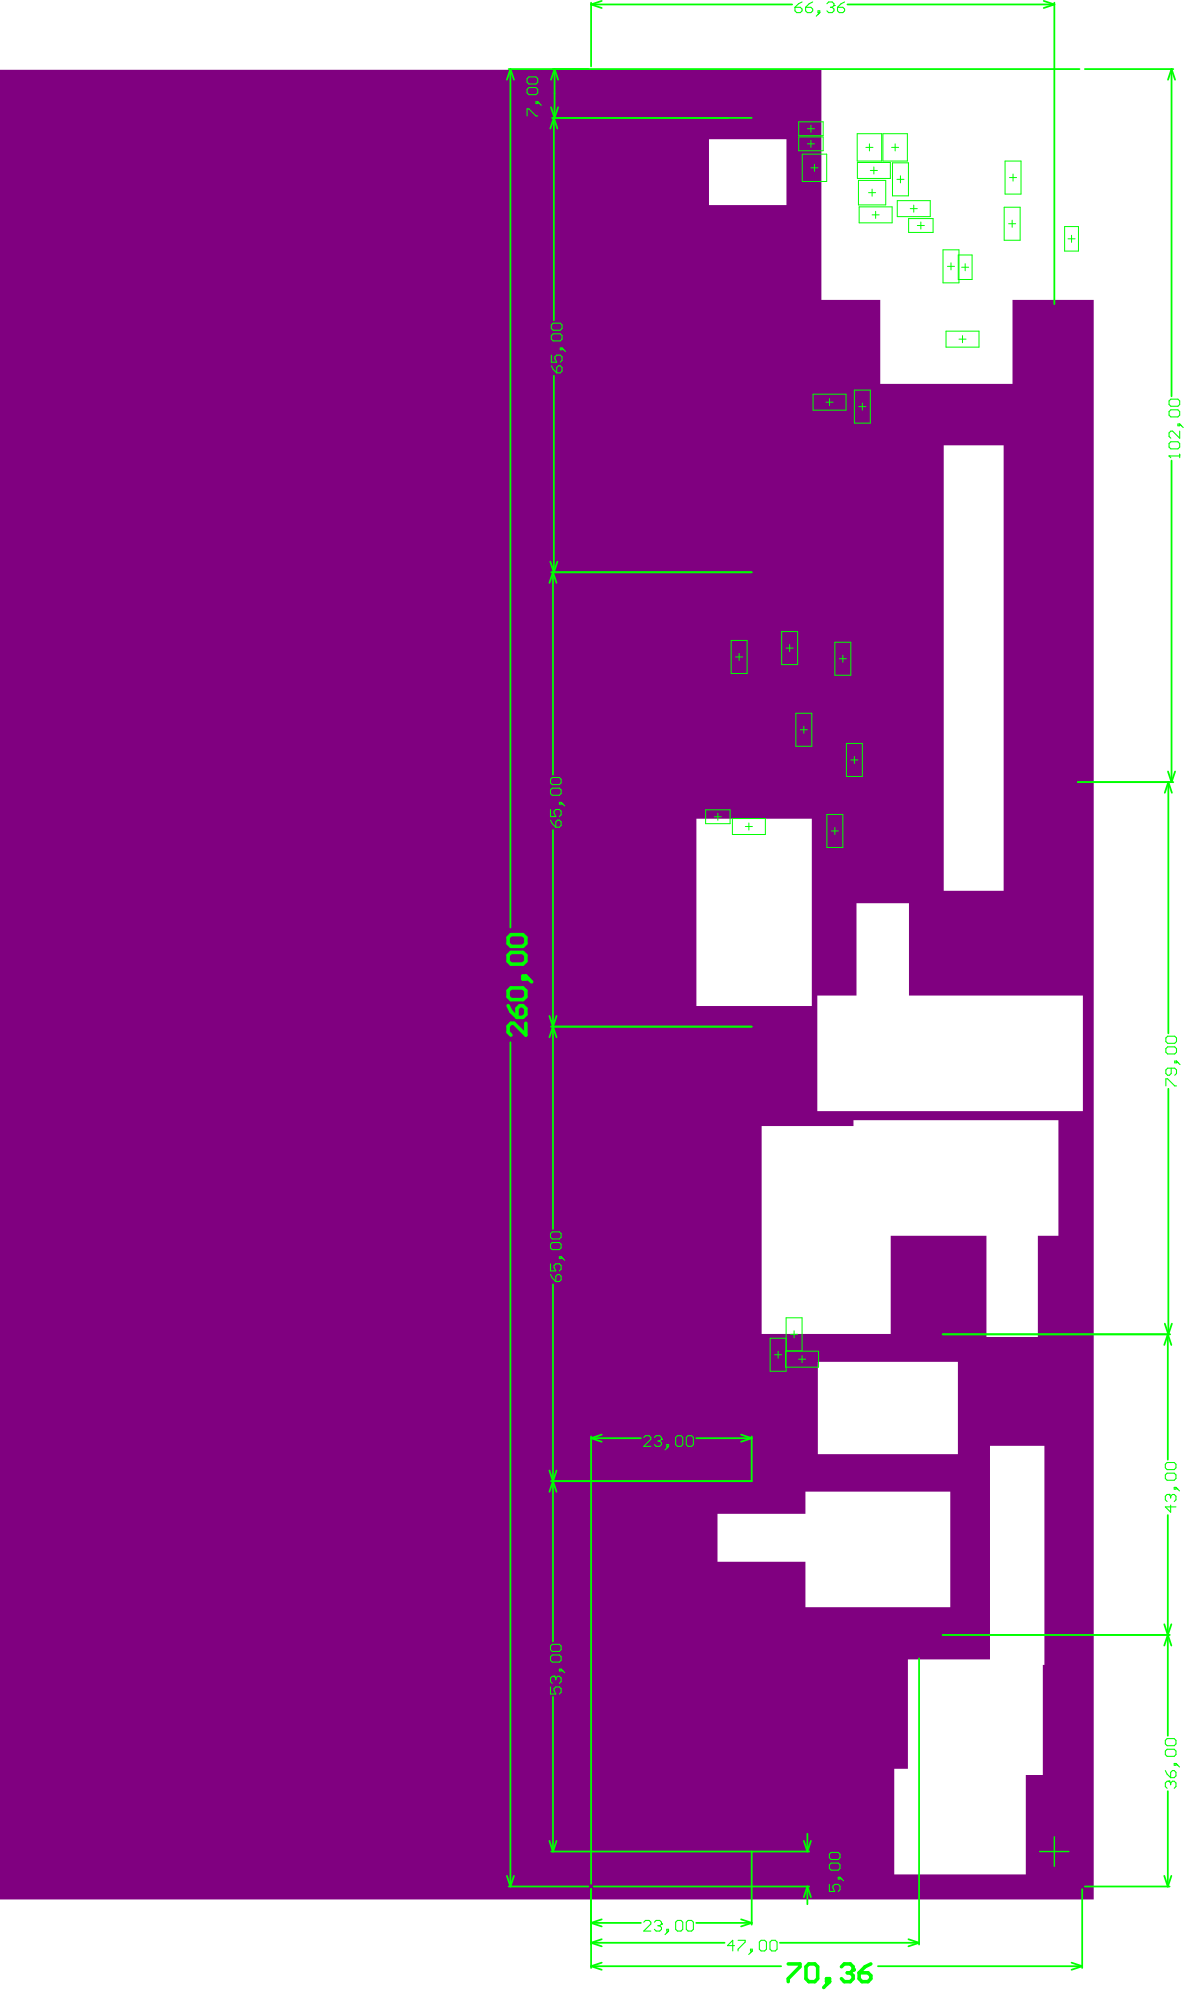
[picture p280: page 10]
