samuelpoiraud/robot/_Hard/2011-2012/2012_CARTES_PDF/BALISE_CONNECTIQUE_FILLE.PDF

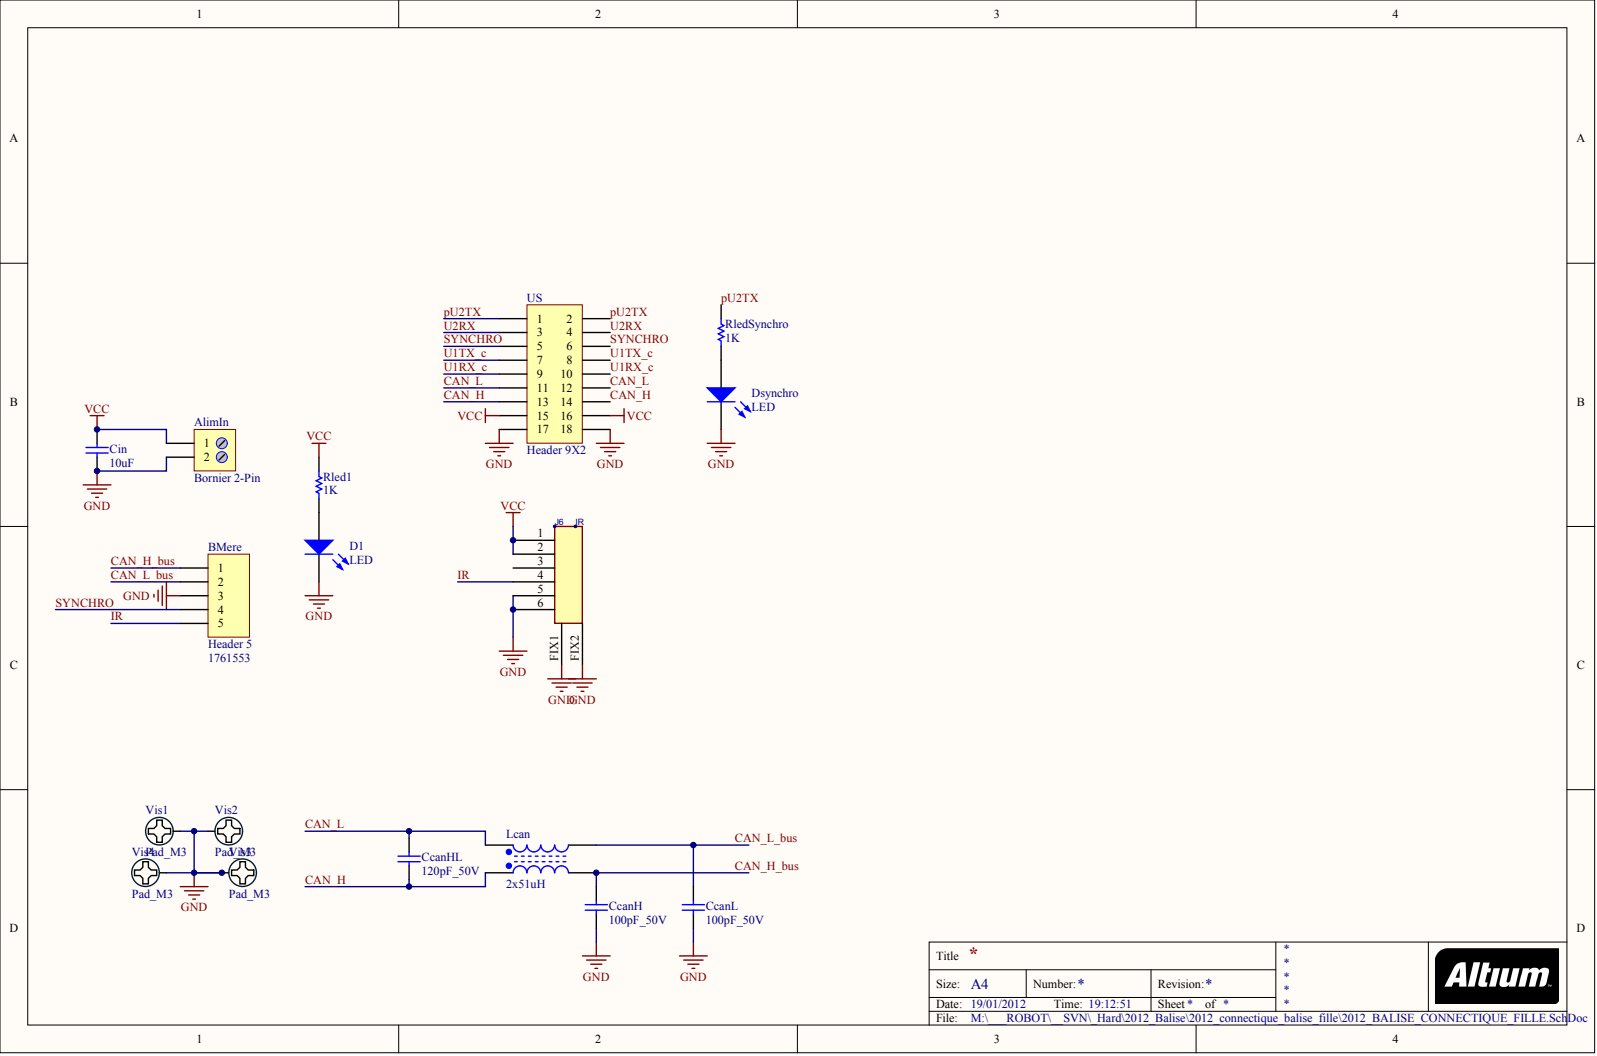
[picture p281: page 1]

* Title | * * * * *

Size: A4 | Number: * | Revision: *

Date: 19/01/2012 Time: 19:12:51 | | Sheet * of *

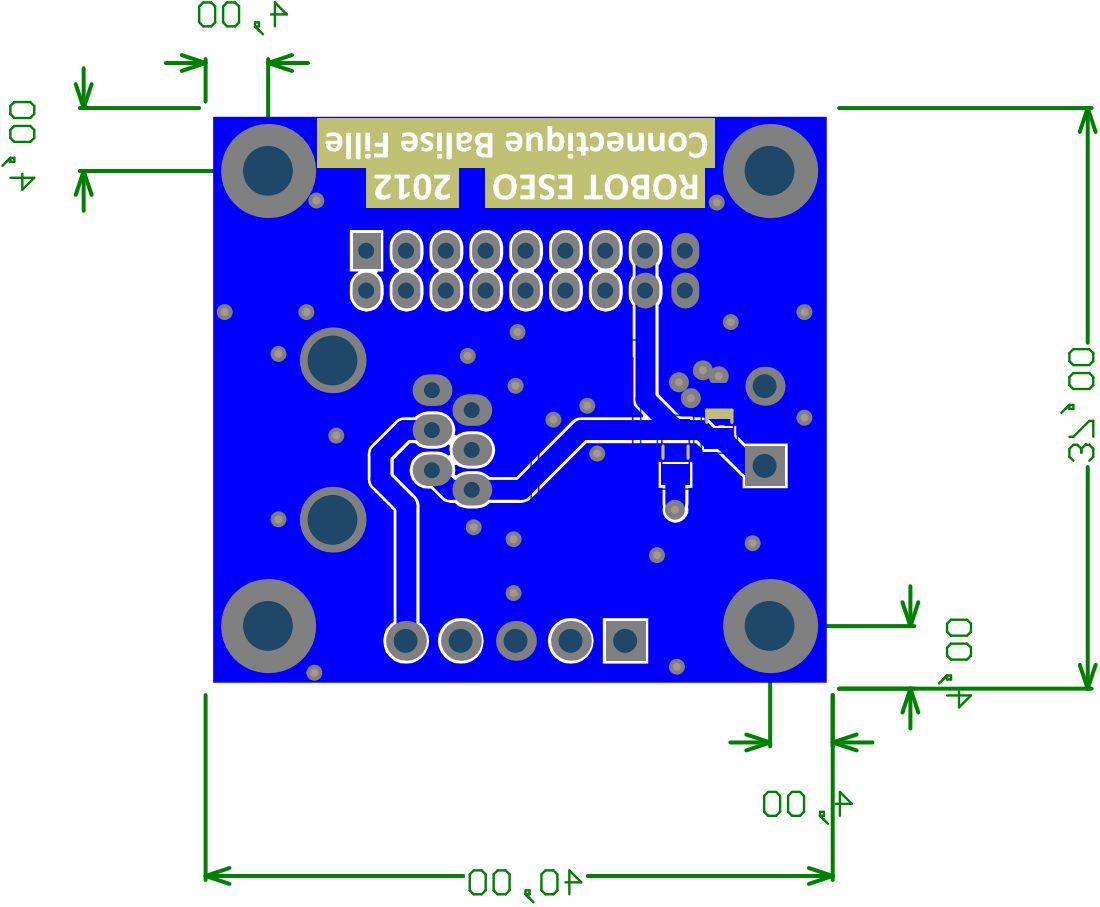
[picture p282: page 2]

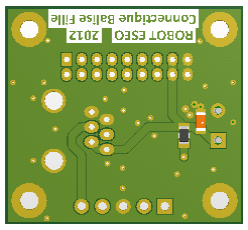
[picture p283: figure]
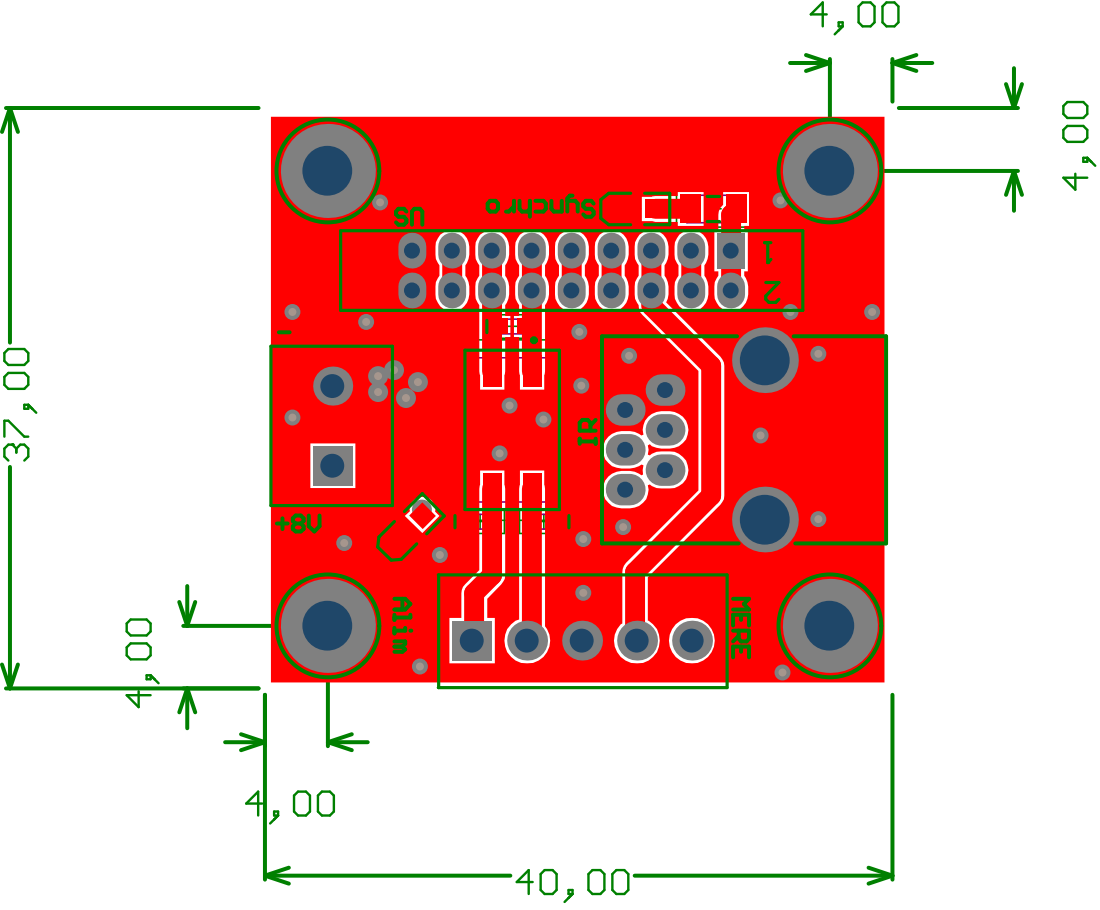
[picture p284: page 4]

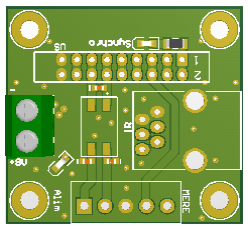
[picture p285: figure]

Designator | Description | Comment | Footprint | Quantity
AlimIn | Bornier 2-Pin | Bornier 2-Pin | Bornier_2_pas 5.08mm | 1
BMere | Header, 5-Pin | Header 5 | HDR1X5 | 1
CcanH, CcanL | Capacitor | 100pF_50V | C0603_N | 2
CcanHL | Capacitor | 120pF_50V | C0603_N | 1
Cin | Capacitor | 10uF | C1206_N | 1
D1, Dsynchro | Typical LED | LED | LED_0805 | 2
J6 | | IR | RJ11_6/6 | 1
Lcan | Self de mode commun, Wurth Elektronik, WE-SL2 | 2x51uH | Self de mode commun Wurth Elektronik WE-SL2 | 1
Rled1, RledSynchro Resistor | | 1K | R1206_N | 2
US | Header, 9-Pin, Dual row | Header 9X2 | HDR2X9 | 1
Vis1, Vis2, Vis3, Vis4Vis M3 X 6mm_TORXPad_M 3 | | | M3x6mm | 4
