samuelpoiraud/robot/_Hard/2011-2012/2012_CARTES_PDF/FOND_DE_PANIER.PDF

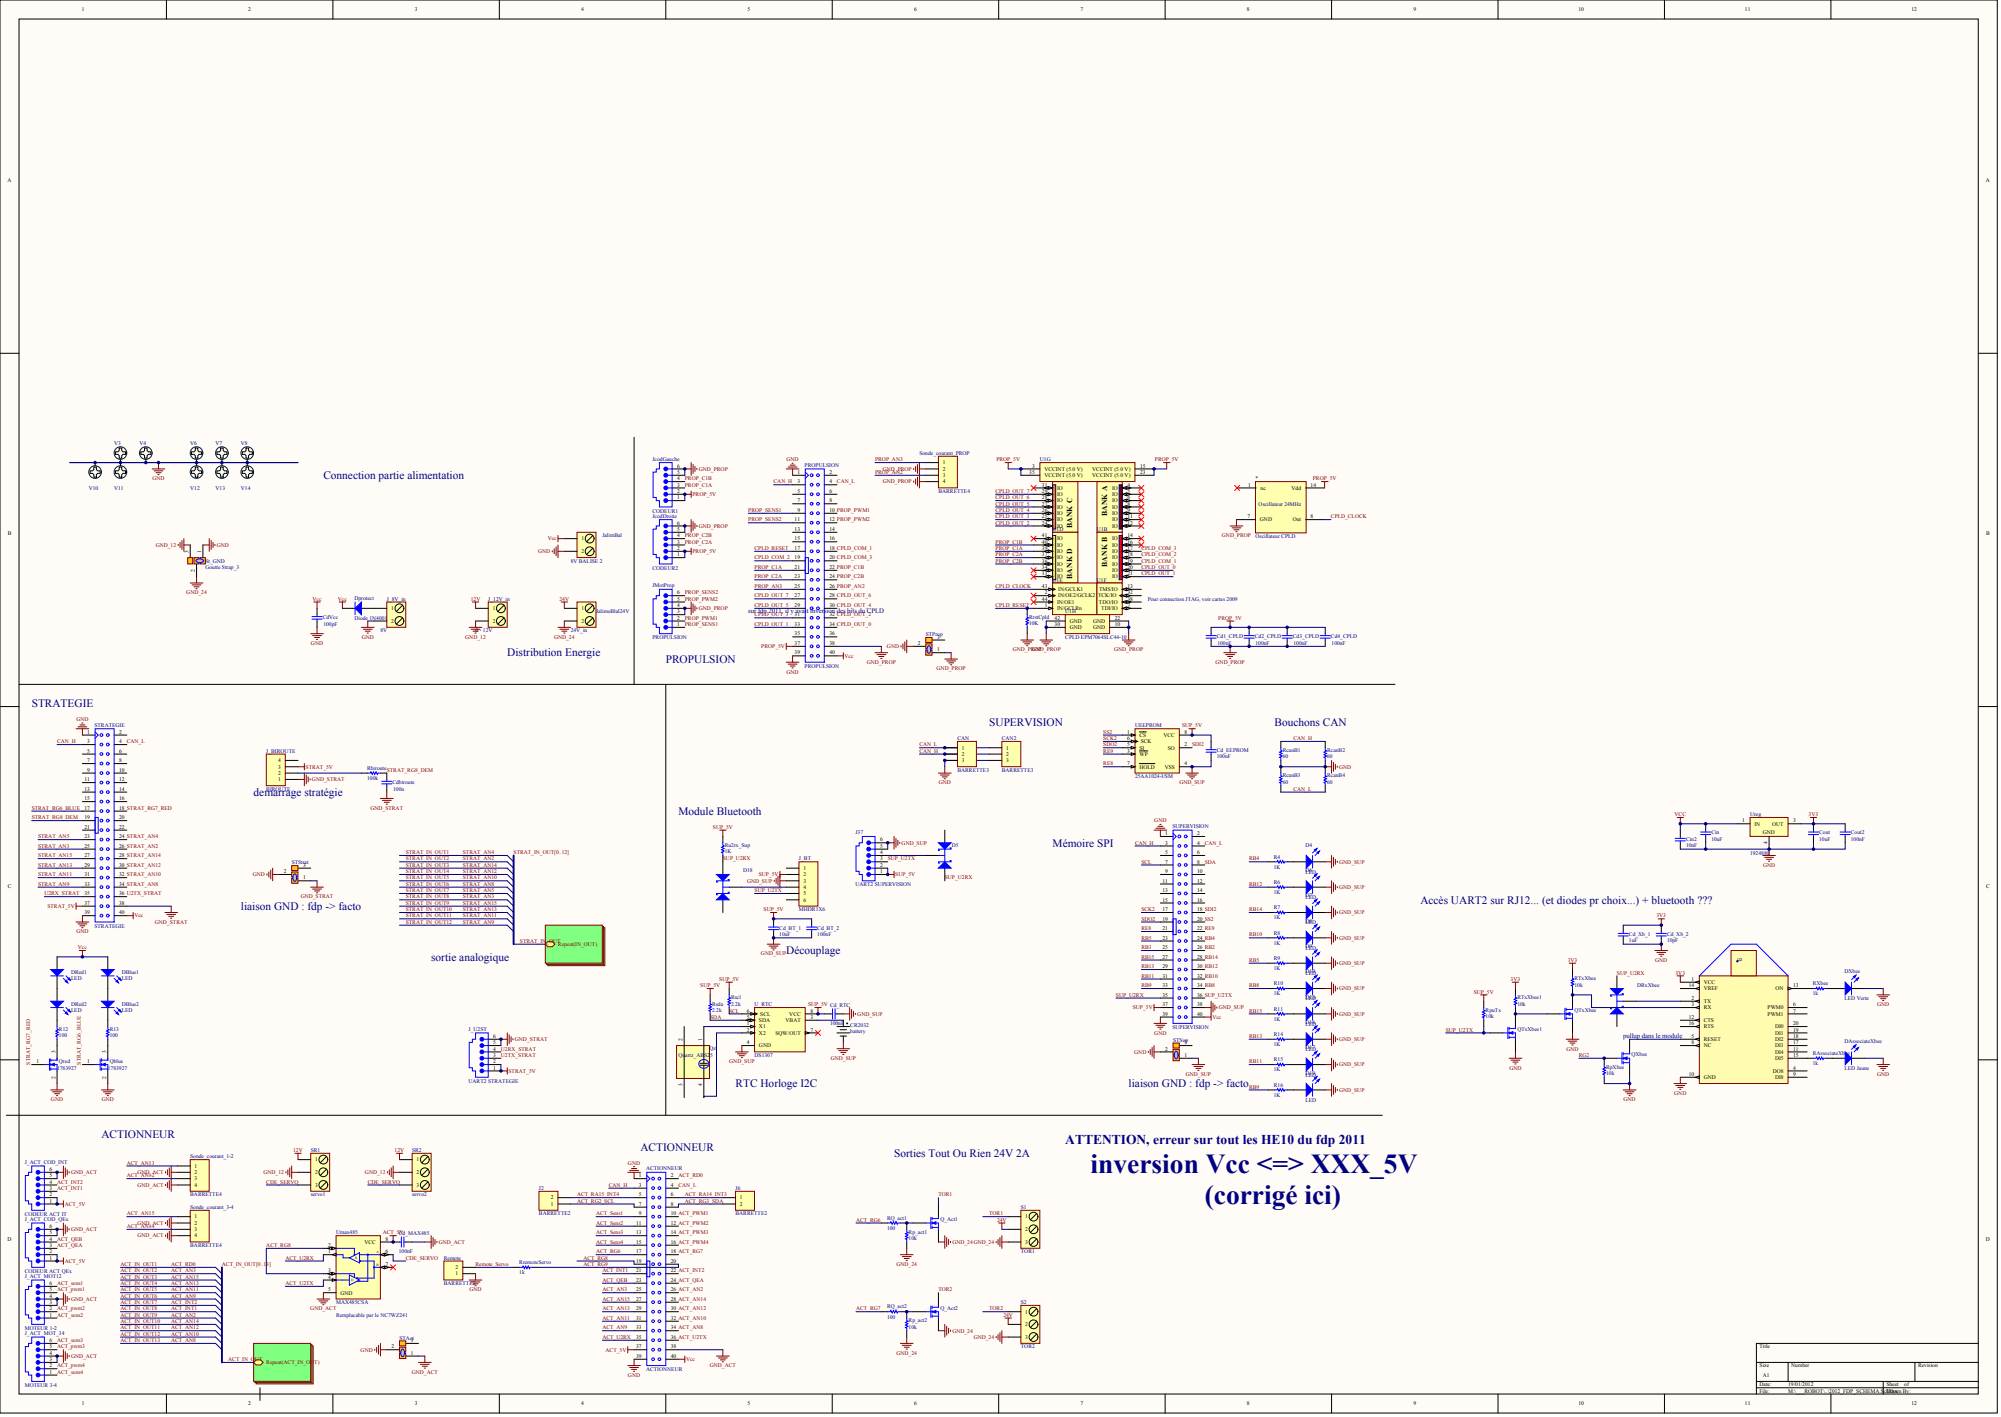
[picture p293: page 3]

Pour connection JTAG, voir cartes 2009

CPLD_OUT_5
CPLD_OUT_3 sur fdp 2011, il y avait inversion des bits du CPLD

Accès UART2 sur RJ12... (et diodes pr choix...) + bluetooth ???

liaison GND : fdp -> facto

pullup dans le module

ATTENTION, erreur sur tout les HE10 du fdp 2011
inversion Vcc <=> XXX_5V

Sorties Tout Ou Rien 24V 2A

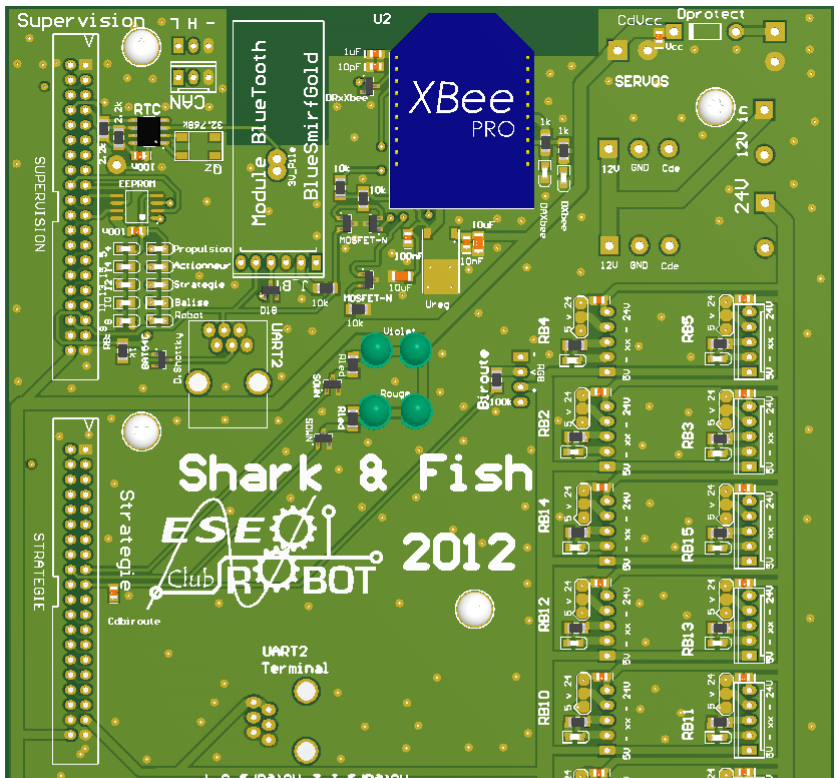
[picture p294: figure]

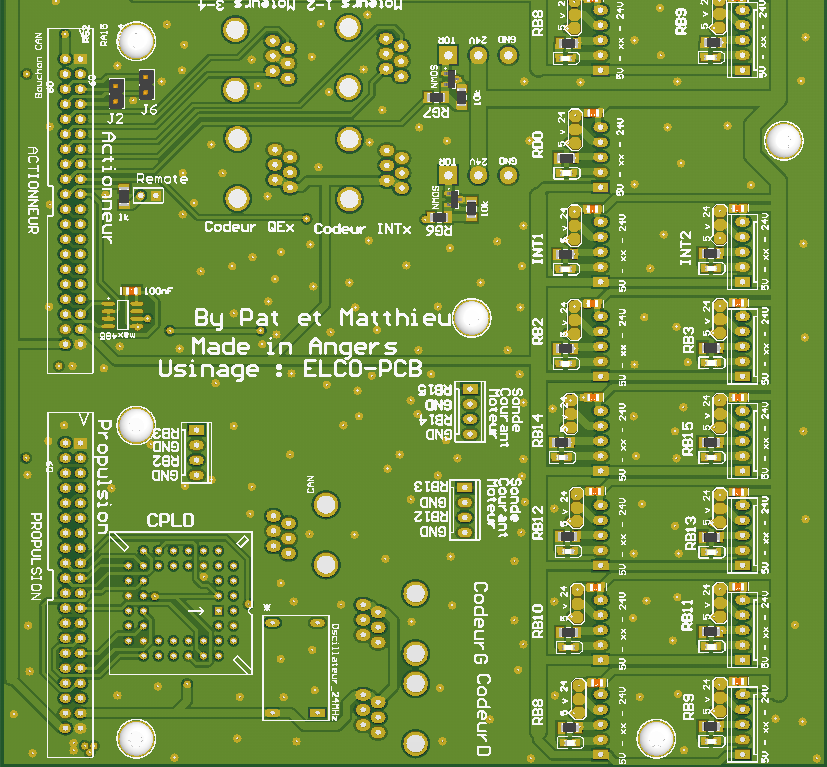
[picture p295: figure]
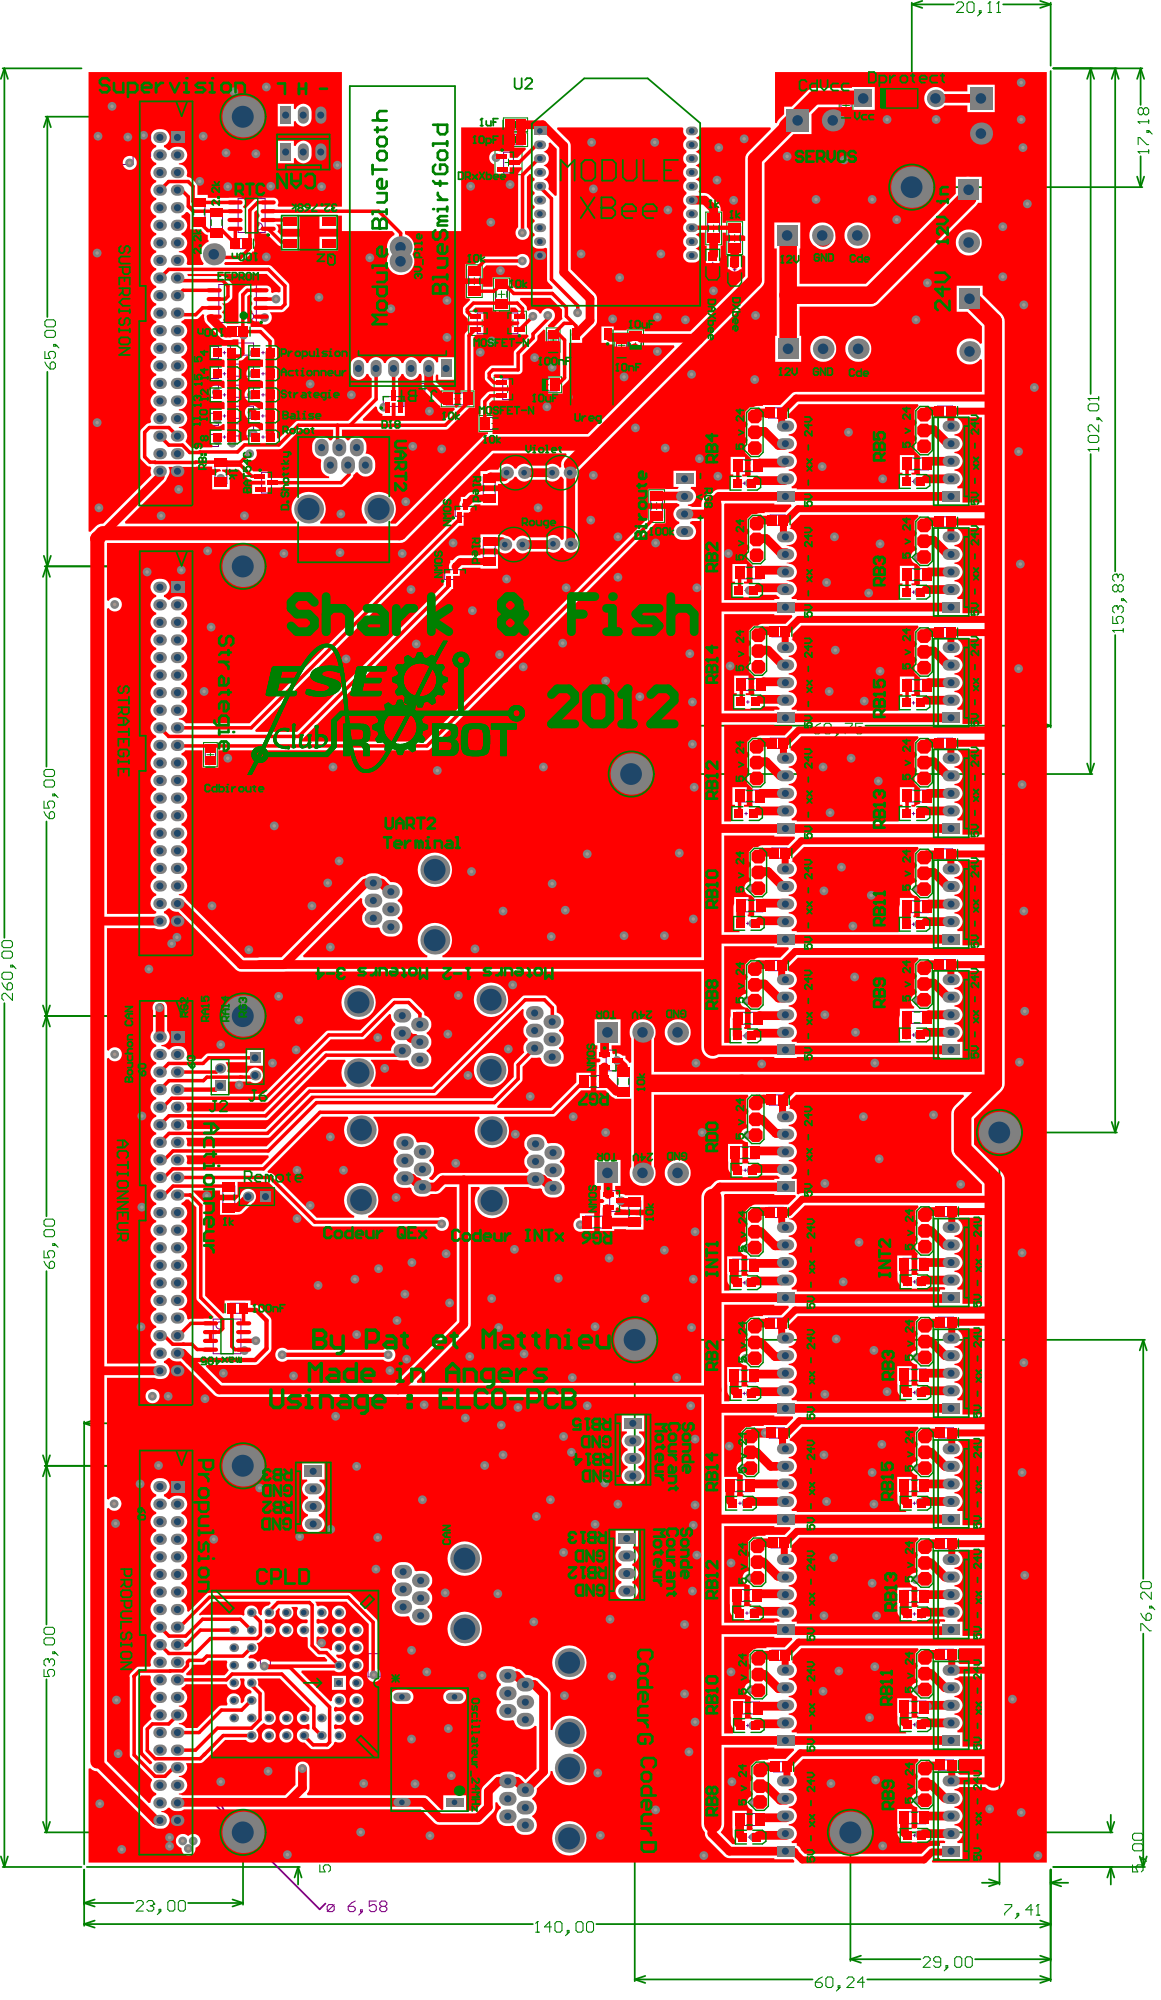
[picture p296: page 6]

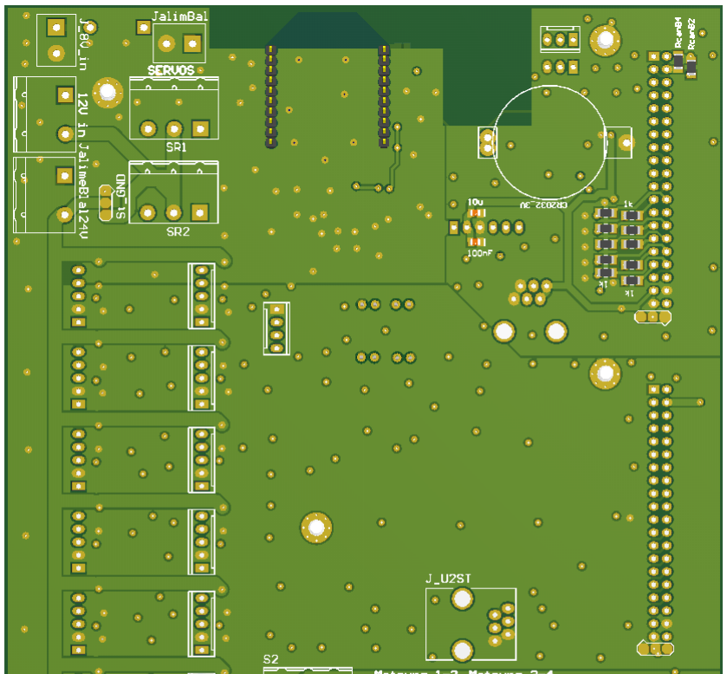
[picture p297: figure]

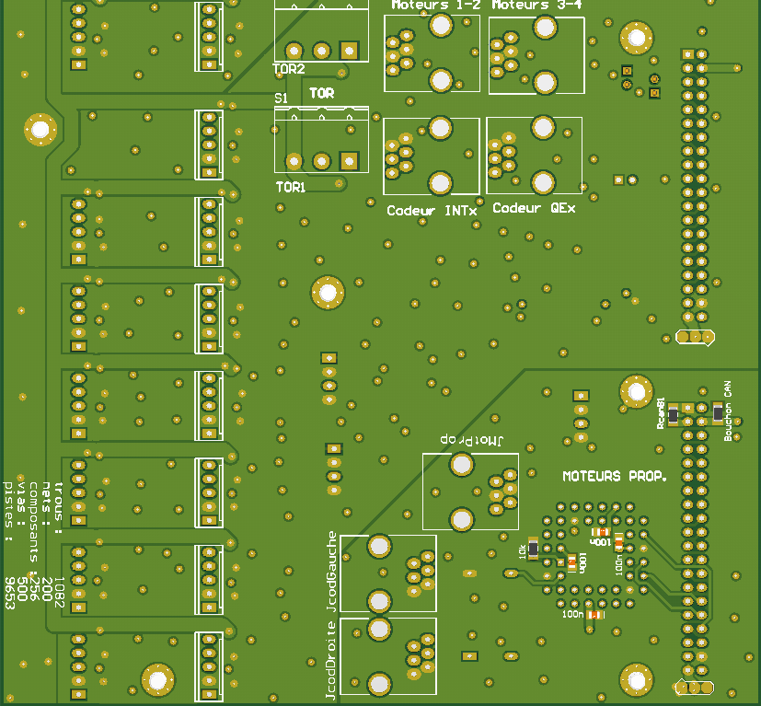
[picture p298: figure]
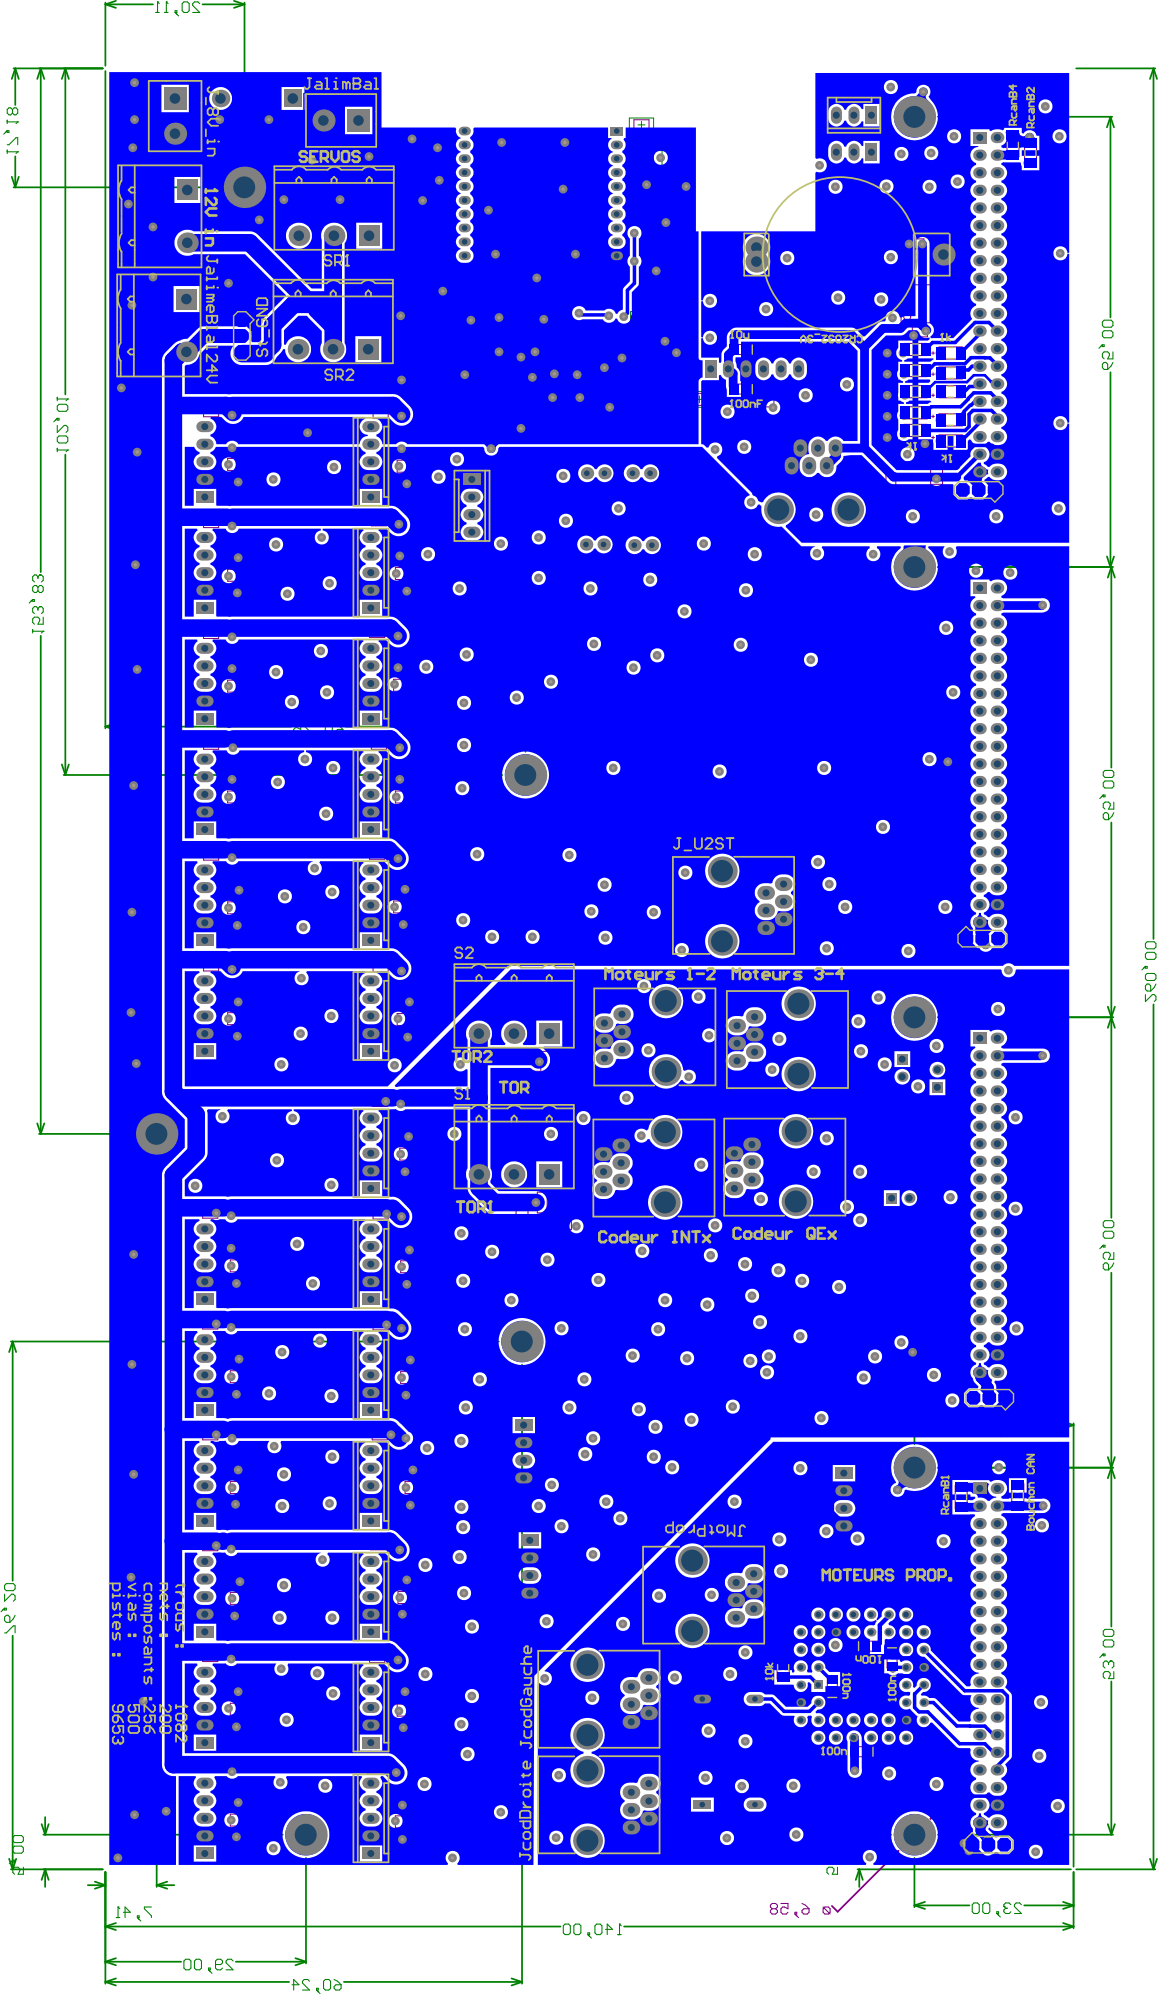
[picture p299: page 9]

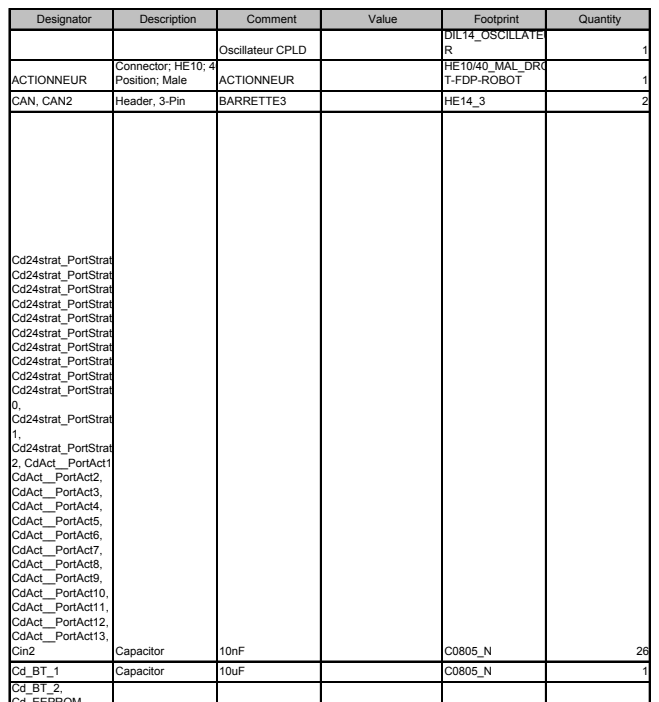
[picture p300: page 10]

Designator | Description | Comment | Value | Footprint | Quantity

Oscillateur CPLD | | DIL14_OSCILLATEU R | 1

ACTIONNEUR | Connector; HE10; 40 Position; Male | ACTIONNEUR | | HE10/40_MAL_DROI T-FDP-ROBOT | 1

CAN, CAN2 | Header, 3-Pin | BARRETTE3 | | HE14_3 | 2

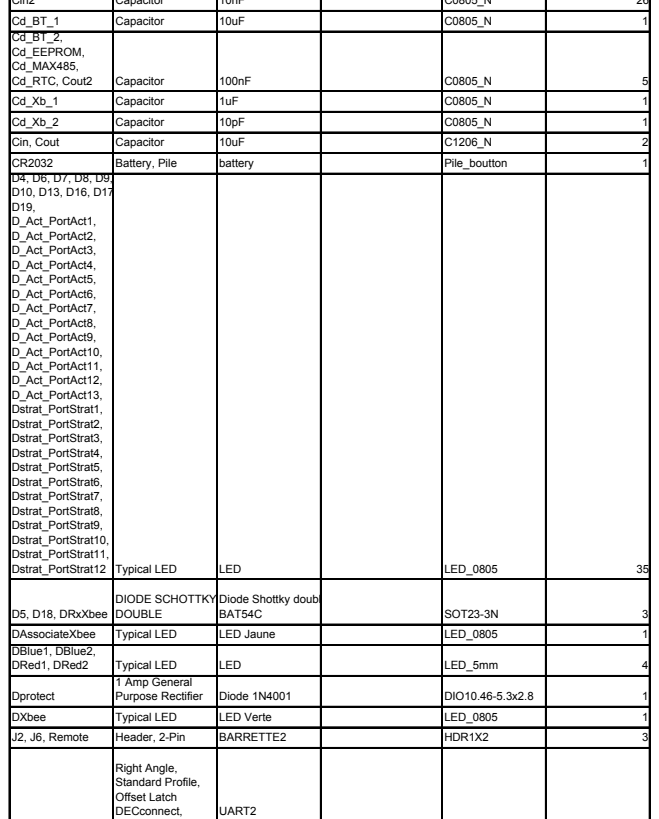
[picture p301: page 11]

Cd_BT_1 | Capacitor | 10uF | C0805_N | 1
Cd_BT_2, Cd_EEPROM, Cd_MAX485, Cd_RTC, Cout2 | Capacitor | 100nF | C0805_N | 5

Cd_Xb_1 | Capacitor | 1uF | C0805_N | 1
Cd_Xb_2 | Capacitor | 10pF | C0805_N | 1
Cin, Cout | Capacitor | 10uF | C1206_N | 2
CR2032 | Battery, Pile | battery | Pile_boutton | 1

D5, D18, DRxXbee | DIODE SCHOTTKY DOUBLE | Diode Shottky double BAT54C | SOT23-3N | 3

DAssociateXbee | Typical LED | LED Jaune | LED_0805 | 1
DBlue1, DBlue2, DRed1, DRed2 | Typical LED | LED | LED_5mm | 4

Dprotect | 1 Amp General Purpose Rectifier | Diode 1N4001 | DIO10.46-5.3x2.8 | 1

DXbee | Typical LED | LED Verte | LED_0805 | 1
J2, J6, Remote | Header, 2-Pin | BARRETTE2 | HDR1X2 | 3

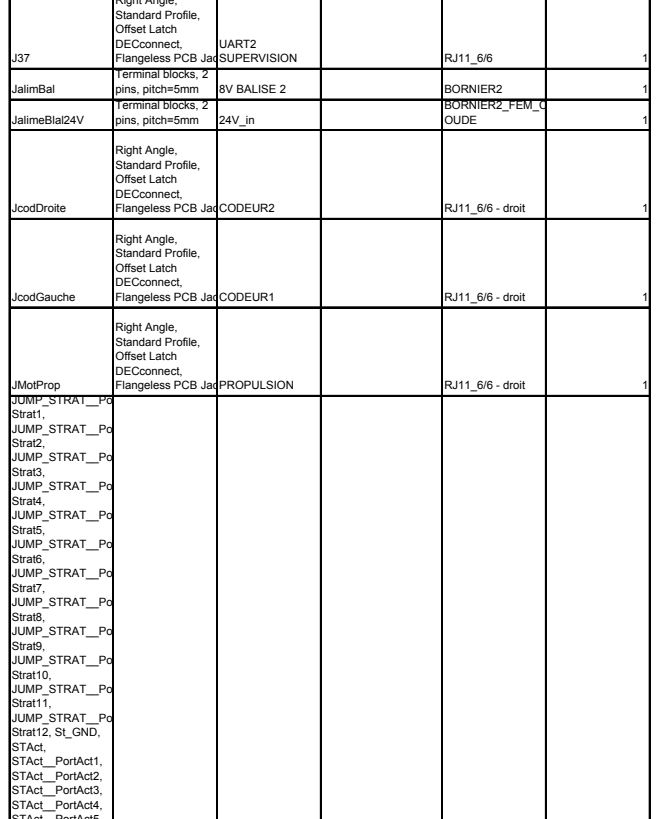
[picture p302: page 12]

JalimBal | Terminal blocks, 2 pins, pitch=5mm | 8V BALISE 2 | BORNIER2 | 1

JalimeBlal24V | Terminal blocks, 2 pins, pitch=5mm | 24V_in | BORNIER2_FEM_C OUDE | 1

JcodDroite | Right Angle, Standard Profile, Offset Latch DECconnect, Flangeless PCB JackCODEUR2 | | RJ11_6/6 - droit | 1

JcodGauche | Right Angle, Standard Profile, Offset Latch DECconnect, Flangeless PCB JackCODEUR1 | | RJ11_6/6 - droit | 1

JMotProp | Right Angle, Standard Profile, Offset Latch DECconnect, Flangeless PCB JackPROPULSION | | RJ11_6/6 - droit | 1

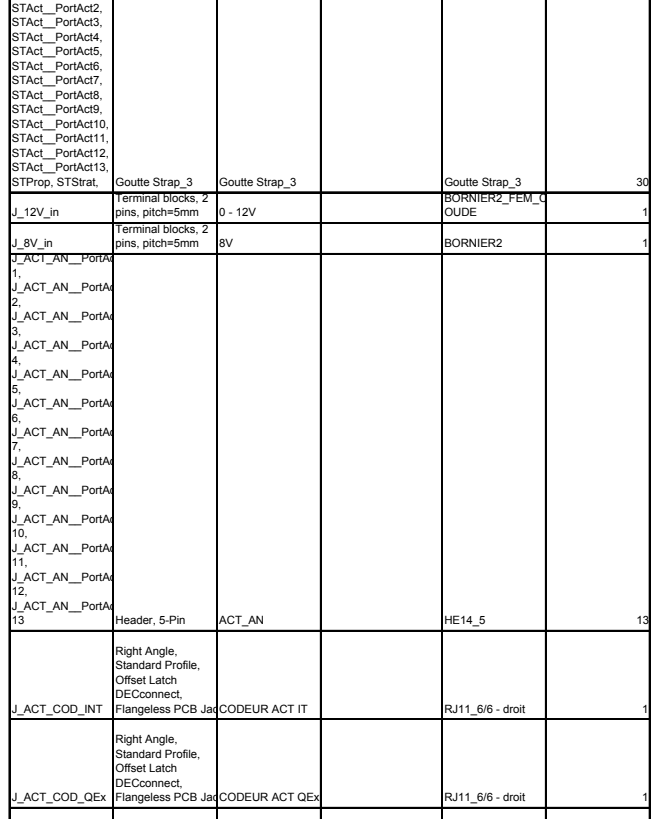
[picture p303: page 13]

J_12V_in | Terminal blocks, 2 pins, pitch=5mm | 0 - 12V | BORNIER2_FEM_C OUDE | 1

J_8V_in | Terminal blocks, 2 pins, pitch=5mm | 8V | BORNIER2 | 1

J_ACT_COD_INT | Right Angle, Standard Profile, Offset Latch DECconnect, Flangeless PCB JackCODEUR ACT IT | RJ11_6/6 - droit | 1

J_ACT_COD_QEx | Right Angle, Standard Profile, Offset Latch DECconnect, Flangeless PCB JackCODEUR ACT QEx | RJ11_6/6 - droit | 1

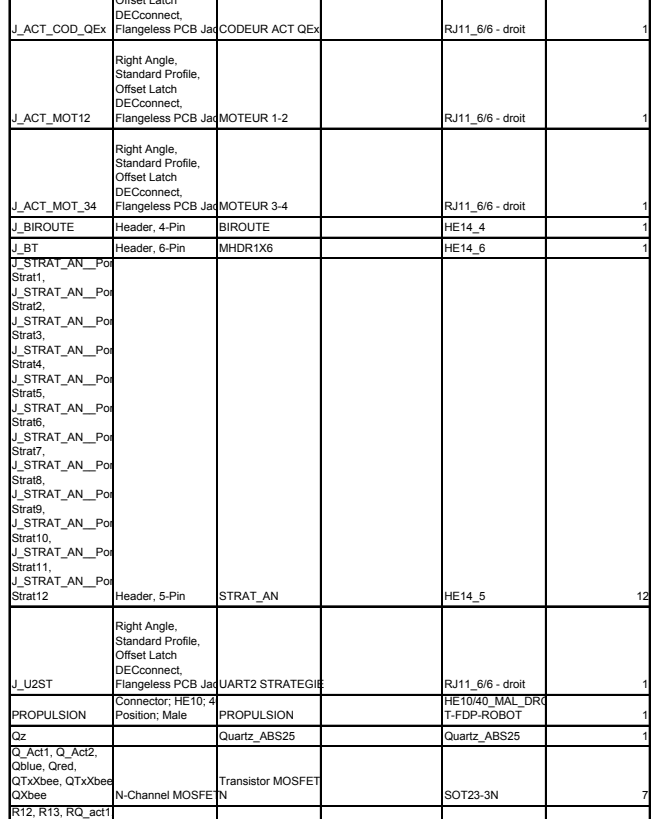
[picture p304: page 14]

J_ACT_MOT12 | Right Angle, Standard Profile, Offset Latch DECconnect, Flangeless PCB JackMOTEUR 1-2 | | RJ11_6/6 - droit | 1

J_ACT_MOT_34 | Right Angle, Standard Profile, Offset Latch DECconnect, Flangeless PCB JackMOTEUR 3-4 | | RJ11_6/6 - droit | 1

J_BIROUTE | Header, 4-Pin | BIROUTE | HE14_4 | 1
J_BT | Header, 6-Pin | MHDR1X6 | HE14_6 | 1

J_U2ST | Right Angle, Standard Profile, Offset Latch DECconnect, Flangeless PCB JackUART2 STRATEGIE | | RJ11_6/6 - droit | 1

PROPULSION | Connector; HE10; 40 Position; Male | PROPULSION | HE10/40_MAL_DROI T-FDP-ROBOT | 1

Qz | | Quartz_ABS25 | Quartz_ABS25 | 1
Q_Act1, Q_Act2, Qblue, Qred, QTxXbee, QTxXbee1, QXbee | N-Channel MOSFET | Transistor MOSFET-N | SOT23-3N | 7

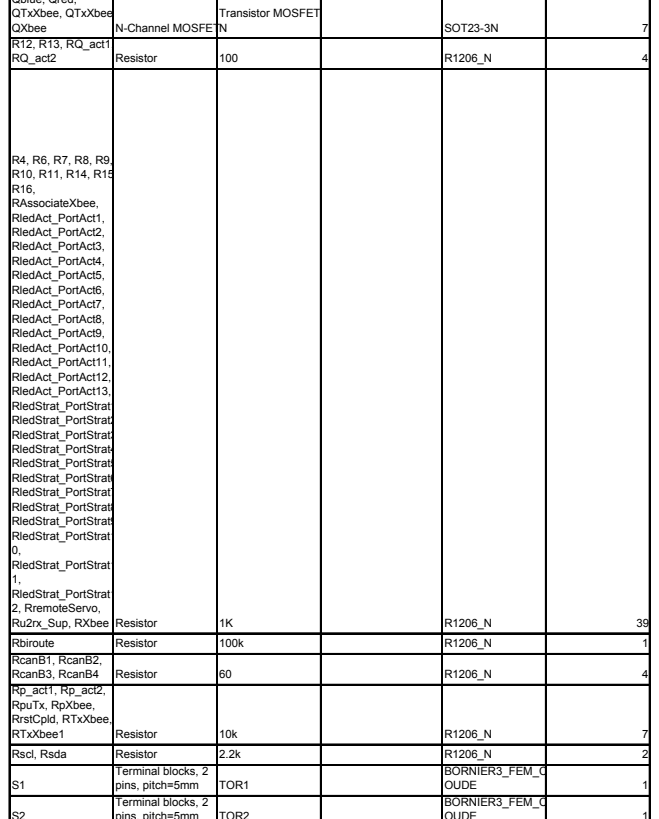
[picture p305: page 15]

Rbiroute | Resistor | 100k | R1206_N | 1
RcanB1, RcanB2, RcanB3, RcanB4 | Resistor | 60 | R1206_N | 4

Rp_act1, Rp_act2, RpuTx, RpXbee, RrstCpld, RTxXbee, RTxXbee1 | Resistor | 10k | R1206_N | 7

Rscl, Rsda | Resistor | 2.2k | R1206_N | 2
S1 | Terminal blocks, 2 pins, pitch=5mm | TOR1 | BORNIER3_FEM_C OUDE | 1

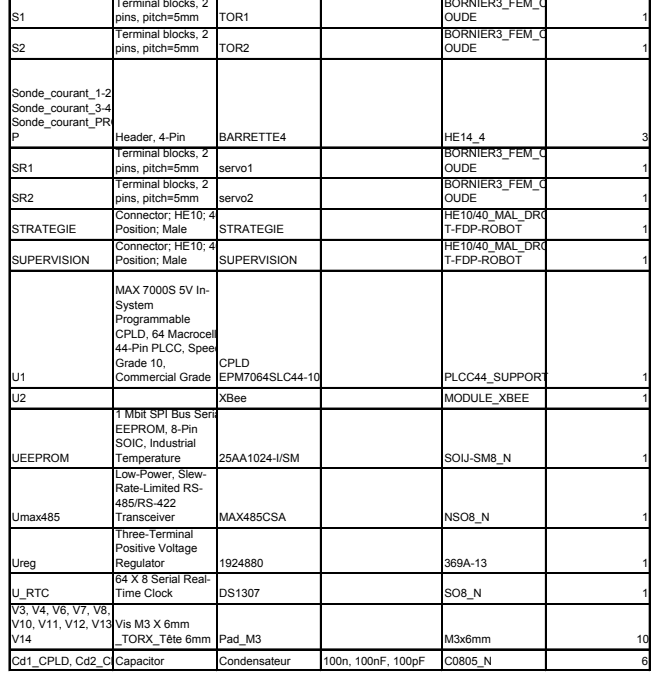
[picture p306: page 16]

S2 | Terminal blocks, 2 pins, pitch=5mm | TOR2 | | BORNIER3_FEM_C OUDE | 1

Sonde_courant_1-2, Sonde_courant_3-4, Sonde_courant_PRO P | Header, 4-Pin | BARRETTE4 | | HE14_4 | 3

SR1 | Terminal blocks, 2 pins, pitch=5mm | servo1 | | BORNIER3_FEM_C OUDE | 1

SR2 | Terminal blocks, 2 pins, pitch=5mm | servo2 | | BORNIER3_FEM_C OUDE | 1

STRATEGIE | Connector; HE10; 40 Position; Male | STRATEGIE | | HE10/40_MAL_DROI T-FDP-ROBOT | 1

SUPERVISION | Connector; HE10; 40 Position; Male | SUPERVISION | | HE10/40_MAL_DROI T-FDP-ROBOT | 1

U1 | MAX 7000S 5V In-System Programmable CPLD, 64 Macrocells, 44-Pin PLCC, Speed Grade 10, Commercial Grade | CPLD EPM7064SLC44-10 | | PLCC44_SUPPORT | 1

U2 | | XBee | | MODULE_XBEE | 1
UEEPROM | 1 Mbit SPI Bus Serial EEPROM, 8-Pin SOIC, Industrial Temperature | 25AA1024-I/SM | | SOIJ-SM8_N | 1

Umax485 | Low-Power, Slew-Rate-Limited RS-485/RS-422 Transceiver | MAX485CSA | | NSO8_N | 1

Ureg | Three-Terminal Positive Voltage Regulator | 1924880 | | 369A-13 | 1

U_RTC | 64 X 8 Serial Real-Time Clock | DS1307 | | SO8_N | 1

V3, V4, V6, V7, V8, V10, V11, V12, V13, V14 | Vis M3 X 6mm _TORX_Tête 6mm | Pad_M3 | | M3x6mm | 10

Cd1_CPLD, Cd2_CPLD, Cd3_CPLD, Cd4_CPLD, Cdbiroute, CdVcc Capacitor | | Condensateur | 100n, 100nF, 100pF | C0805_N | 6
