samuelpoiraud/robot/_Hard/2011-2012/2012_CARTES_PDF/PERF_USB.PDF

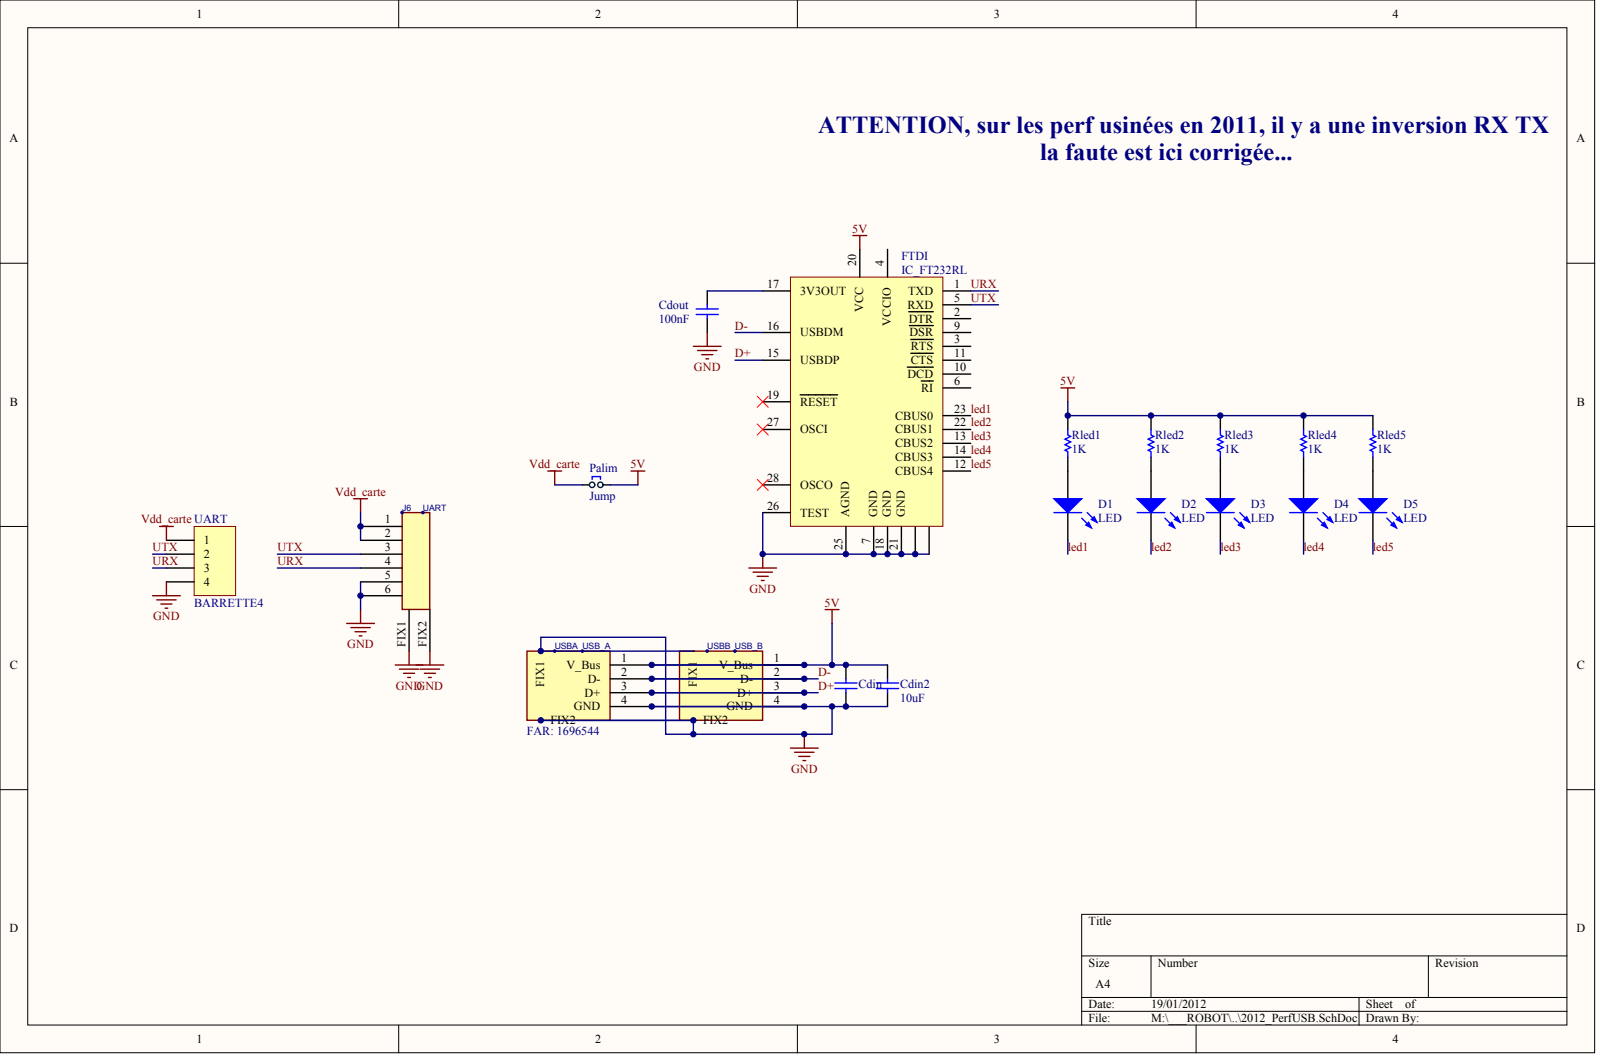
[picture p307: page 1]

ATTENTION, sur les perf usinées en 2011, il y a une inversion RX TX

la faute est ici corrigée...

V_Bus D-D+ GND | 1 | V_Bus

2 3 4 | D-D+ GND

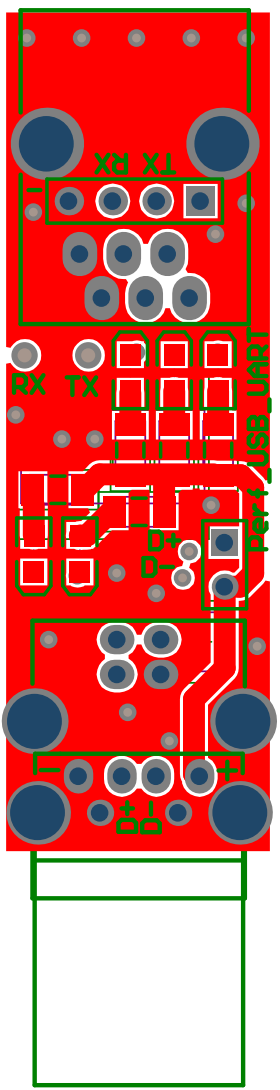
[picture p308: page 3]

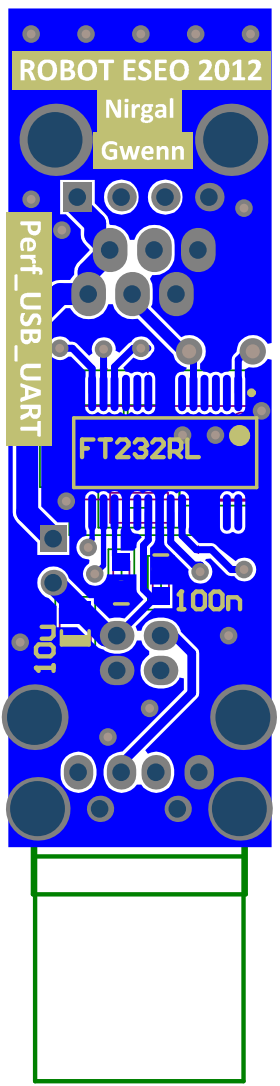
[picture p309: page 5]

Designator | Description | Comment | Footprint | Quantity
Cdin, Cdout | Capacitor | 100nF | C0603_N | 2
Cdin2 | Capacitor | 10uF | C1206_N | 1
D1, D2, D3, D4, D5 | Typical LED | LED | LED_0805 | 5
FTDI | FT232R USB UART IC_FT232RL | | SSOP28_N | 1
J6 | | UART | RJ11_6/6 | 1
Palim | Jumper SIP2.54 | Jump | HDR1X2 | 1
Rled1, Rled2, Rled3, Rled4, Rled5 | Resistor | 1K | R1206_N | 5
UART | Header, 4-Pin | BARRETTE4 | HDR1X4 | 1
USBA | FAR1696544 | USB_A | USB_A_COUDE -FAR1696544 | 1
USBB | | USB_B | USB_B_COUDE | 1
