samuelpoiraud/robot/_Hard/2011-2012/2012_CARTES_PDF/RECEPTEUR_IR.PDF

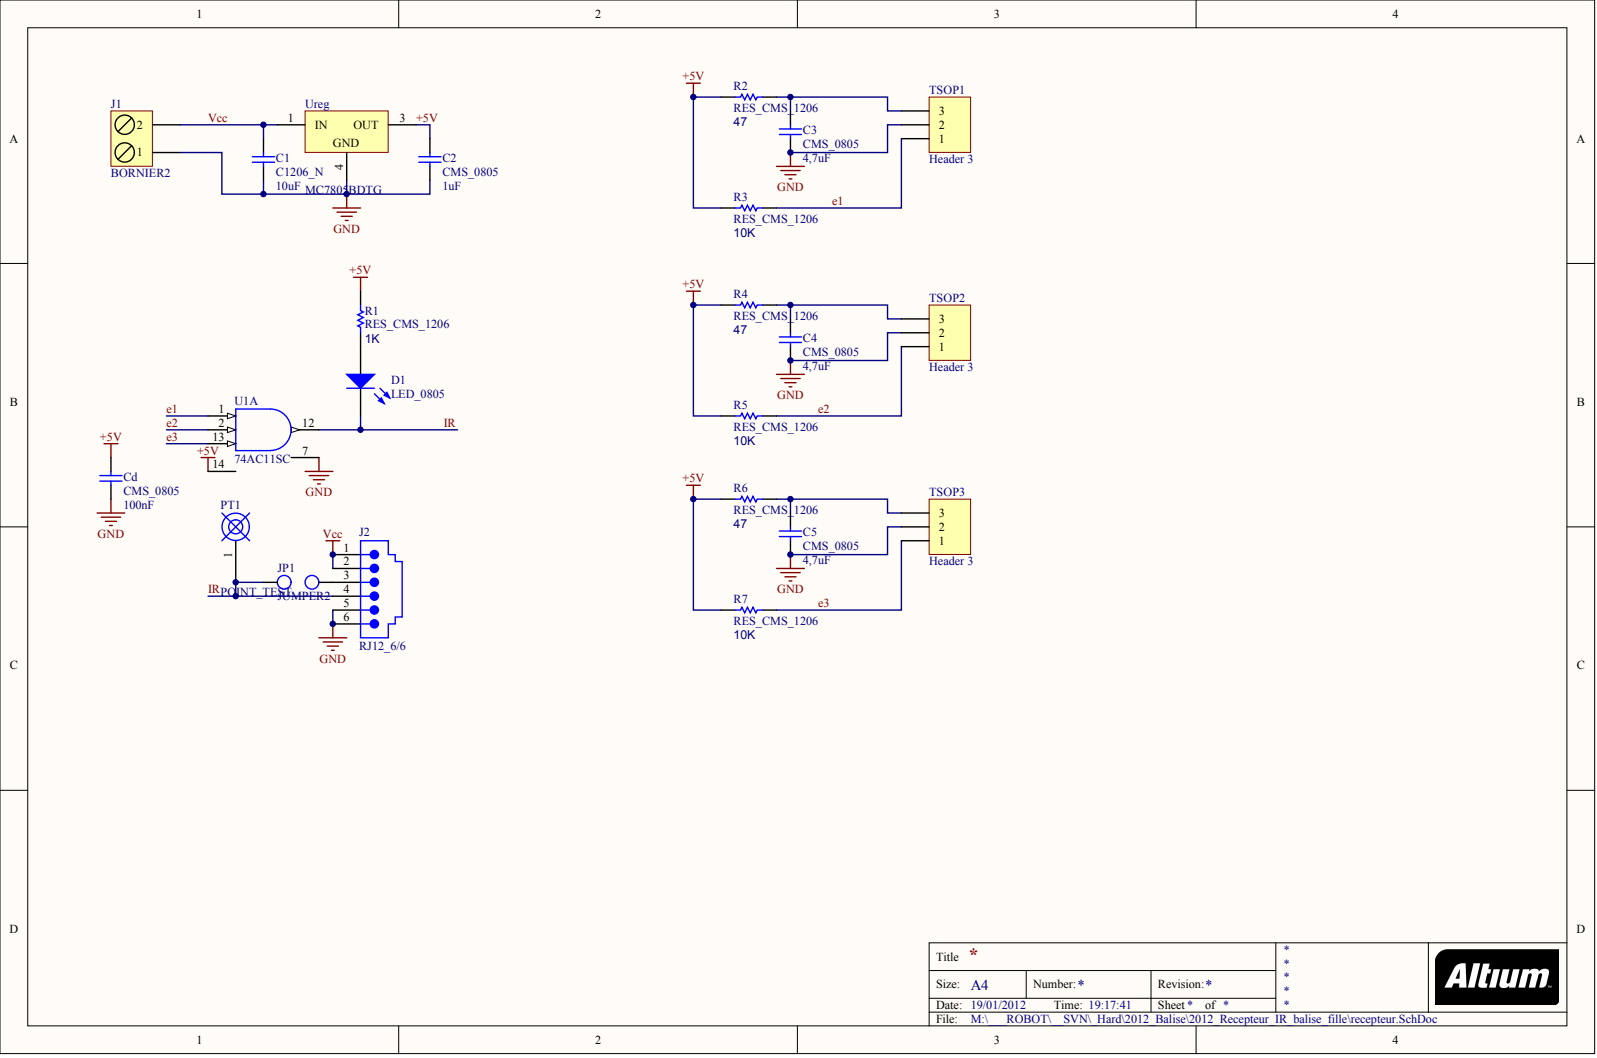
[picture p315: page 1]

C3
CMS_0805

C4

C5

* Title | **** *

Size: A 4 | Number: * | Revision: *

19/01/2012 Time: 19:17:41 | | Sheet * of *

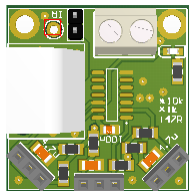
[picture p316: figure]
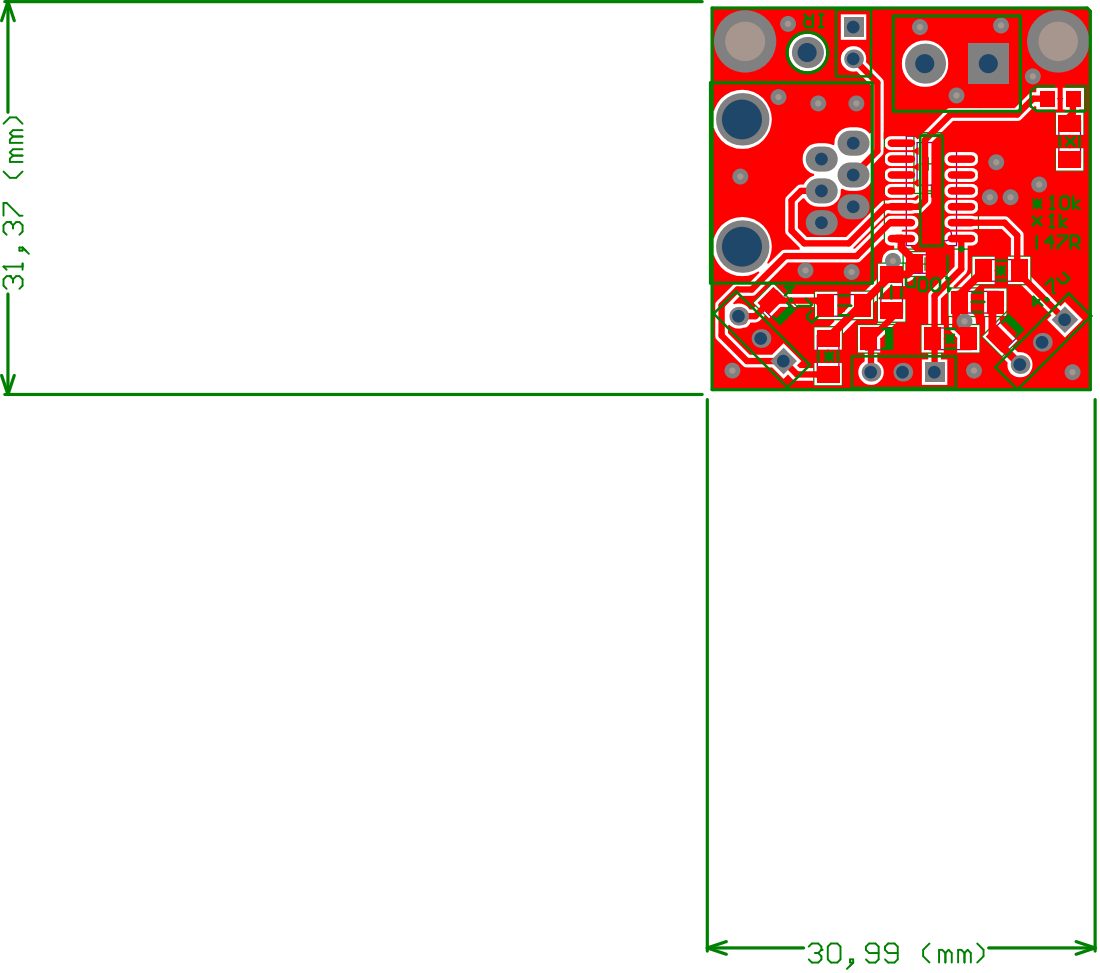
[picture p317: page 3]

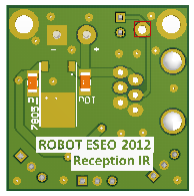
[picture p318: figure]
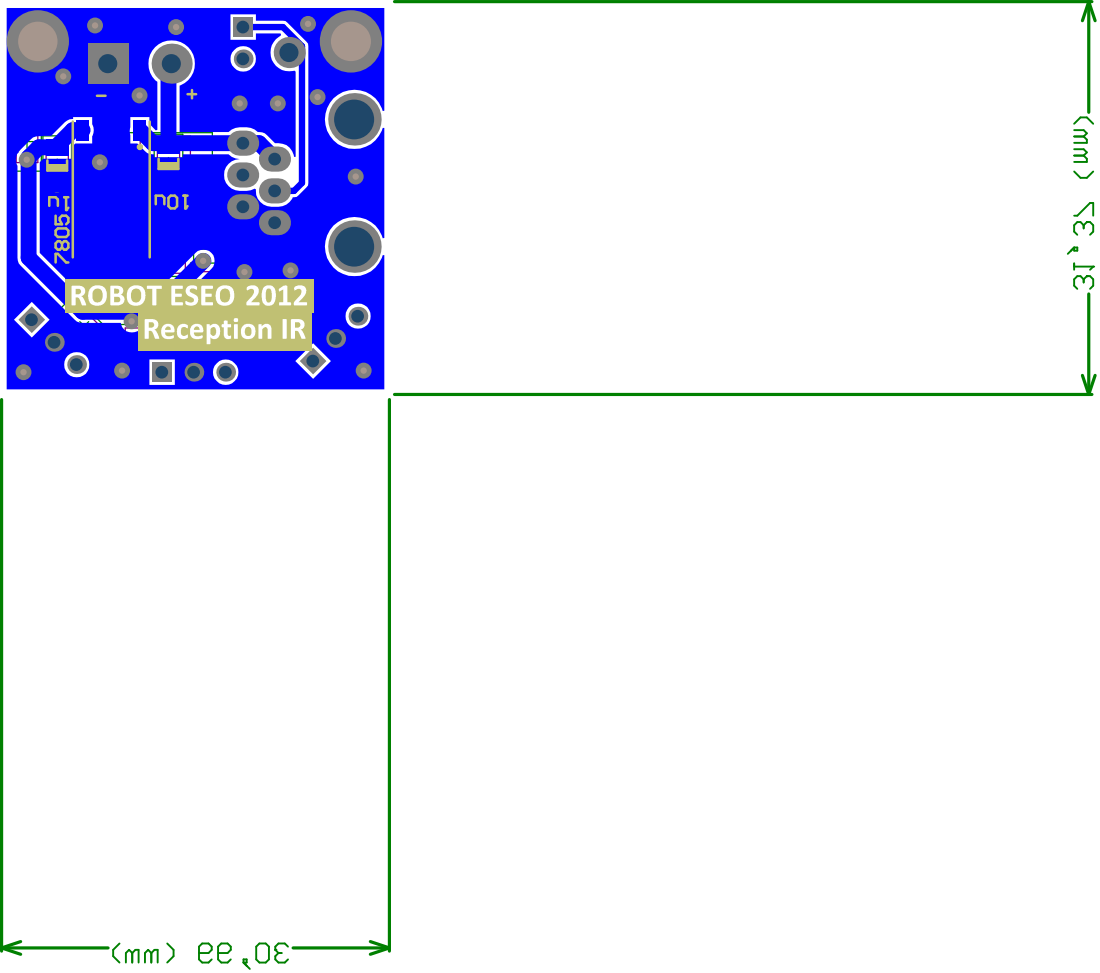
[picture p319: page 5]

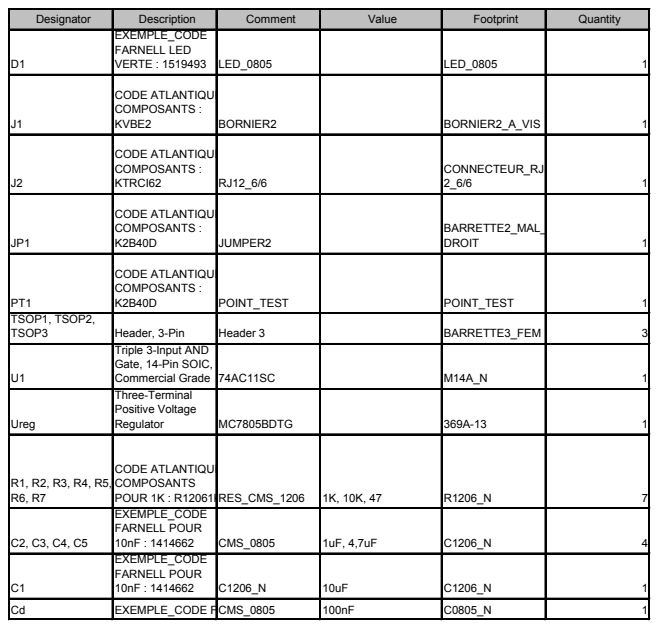
[picture p320: page 6]

Designator | Description | Comment | Value | Footprint | Quantity
D1 | EXEMPLE_CODE FARNELL LED VERTE : 1519493 | LED_0805 | | LED_0805 | 1

J1 | CODE ATLANTIQUE COMPOSANTS : KVBE2 | BORNIER2 | | BORNIER2_A_VIS | 1

J2 | CODE ATLANTIQUE COMPOSANTS : KTRCI62 | RJ12_6/6 | | CONNECTEUR_RJ1 2_6/6 | 1

JP1 | CODE ATLANTIQUE COMPOSANTS : K2B40D | JUMPER2 | | BARRETTE2_MAL_ DROIT | 1

PT1 | CODE ATLANTIQUE COMPOSANTS : K2B40D | POINT_TEST | | POINT_TEST | 1

TSOP1, TSOP2, TSOP3 | Header, 3-Pin | Header 3 | | BARRETTE3_FEM | 3

U1 | Triple 3-Input AND Gate, 14-Pin SOIC, Commercial Grade | 74AC11SC | | M14A_N | 1

Ureg | Three-Terminal Positive Voltage Regulator | MC7805BDTG | | 369A-13 | 1

R1, R2, R3, R4, R5, R6, R7 | CODE ATLANTIQUE COMPOSANTS POUR 1K : R12061KRES_CMS_1206 | | 1K, 10K, 47 | R1206_N | 7

C2, C3, C4, C5 | EXEMPLE_CODE FARNELL POUR 10nF : 1414662 | CMS_0805 | 1uF, 4,7uF | C1206_N | 4

C1 | EXEMPLE_CODE FARNELL POUR 10nF : 1414662 | C1206_N | 10uF | C1206_N | 1

Cd | EXEMPLE_CODE FARNELL POUR 10nF : 1414662 CMS_0805 | | 100nF | C0805_N | 1
