samuelpoiraud/robot/_Hard/2011-2012/2012_CARTES_PDF/RECEPTRICE_IR.PDF

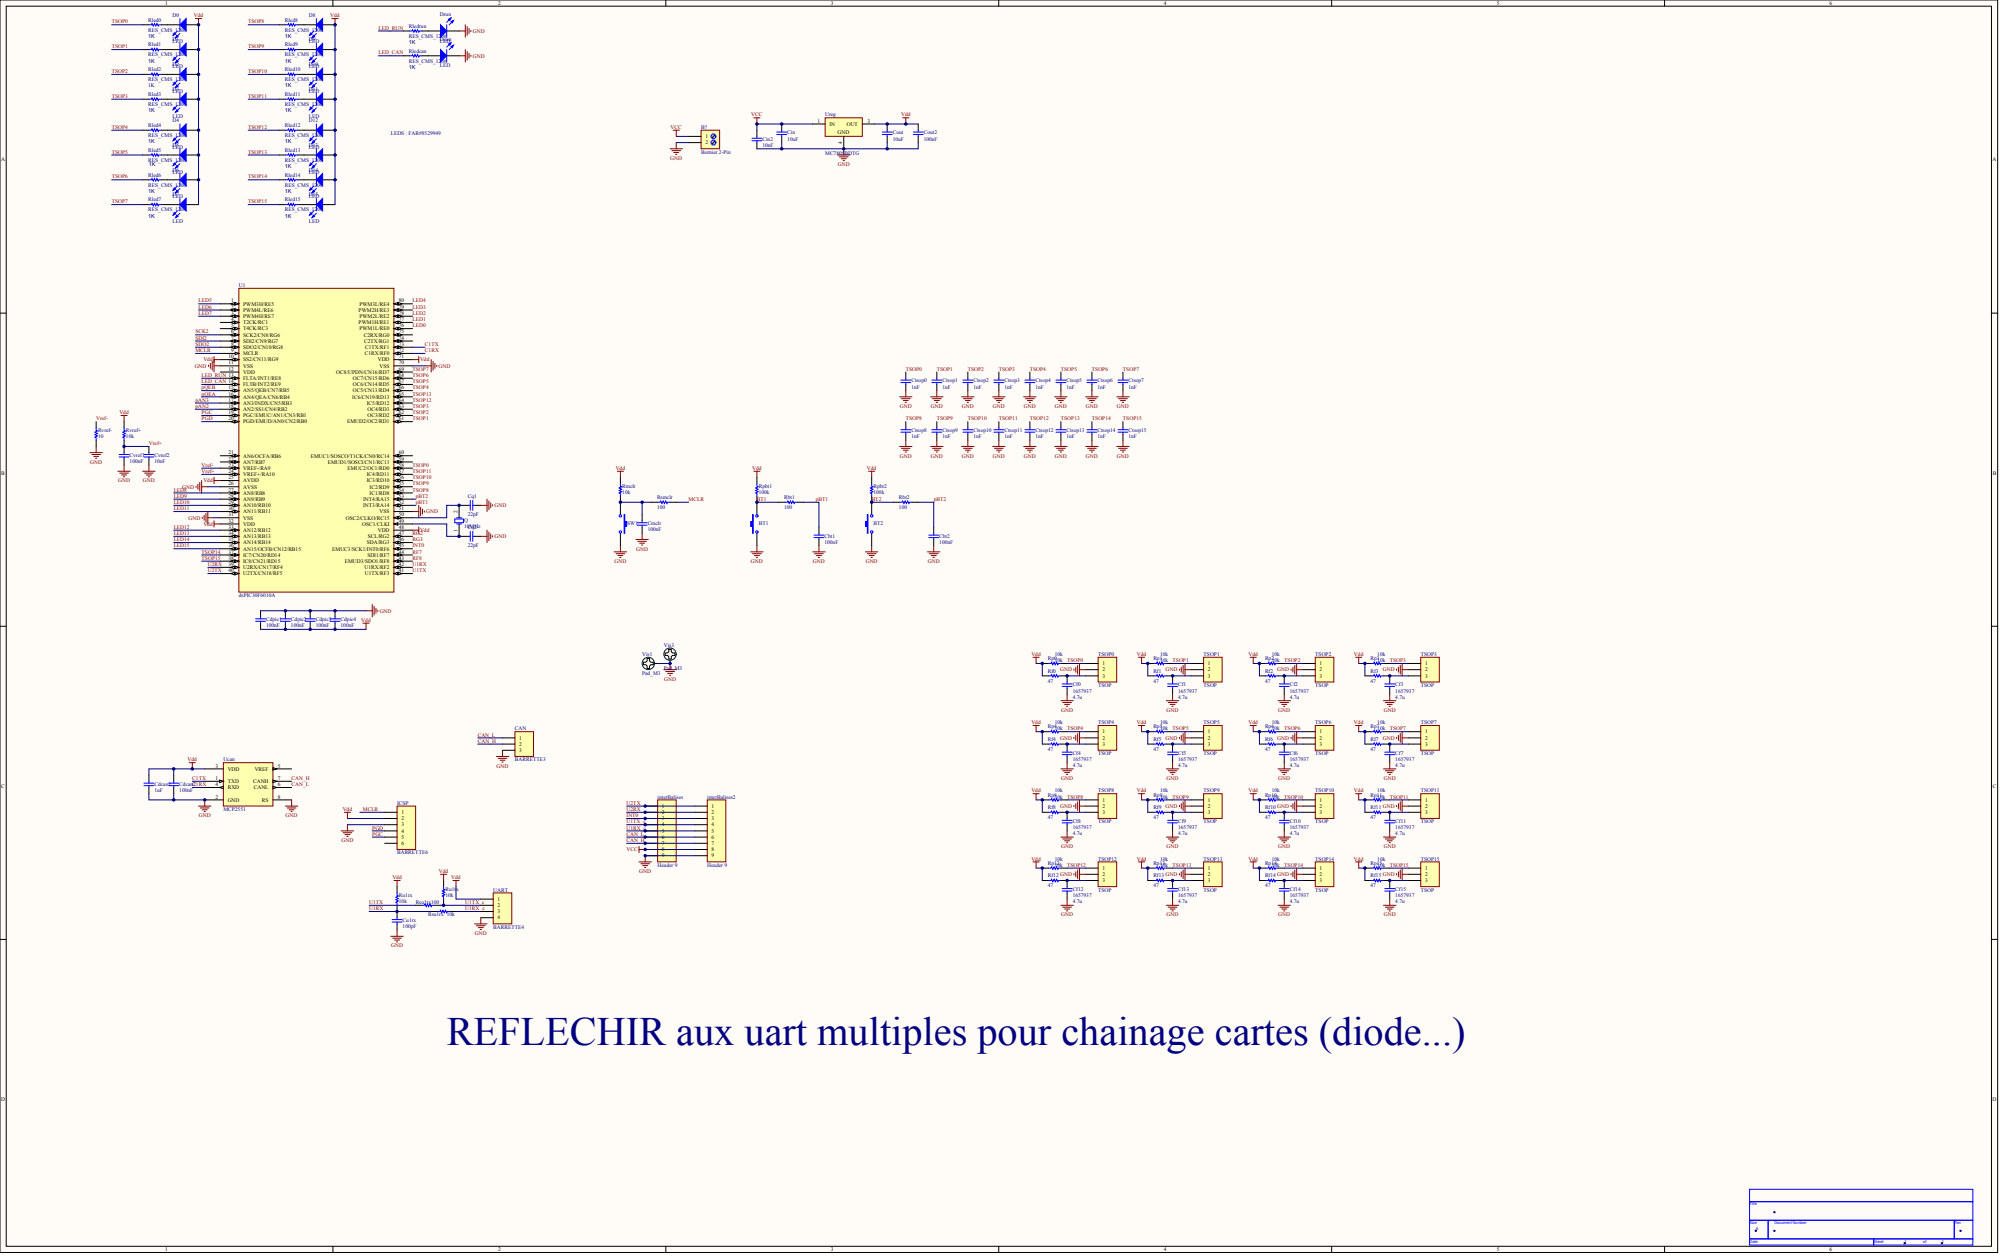
[picture p321: page 1]

VDD 32

REFLECHIR aux uart multiples pour chainage cartes (diode...)

Size A | Document Number | Rev

Date: | Sheet 1 of 1

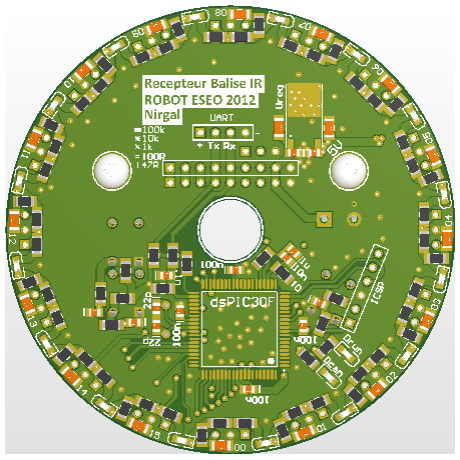
[picture p322: figure]
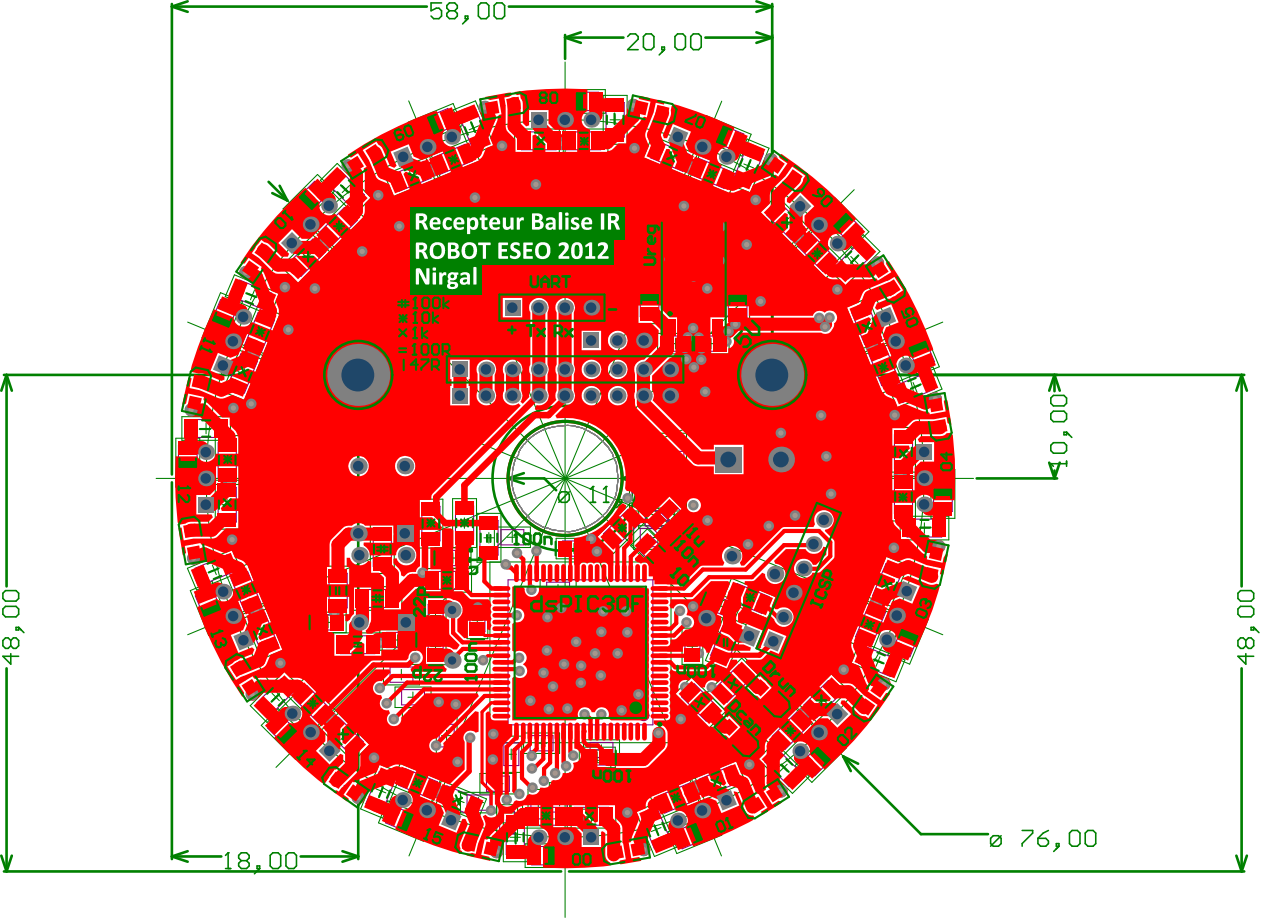
[picture p323: page 3]

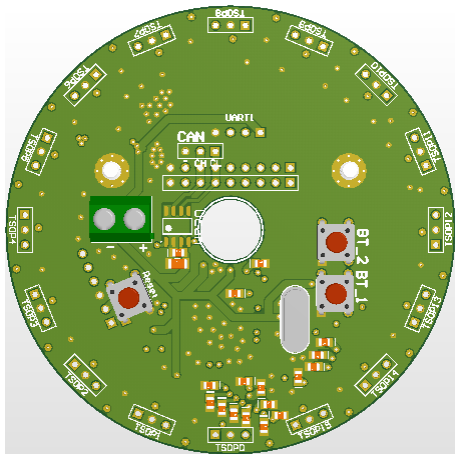
[picture p324: figure]
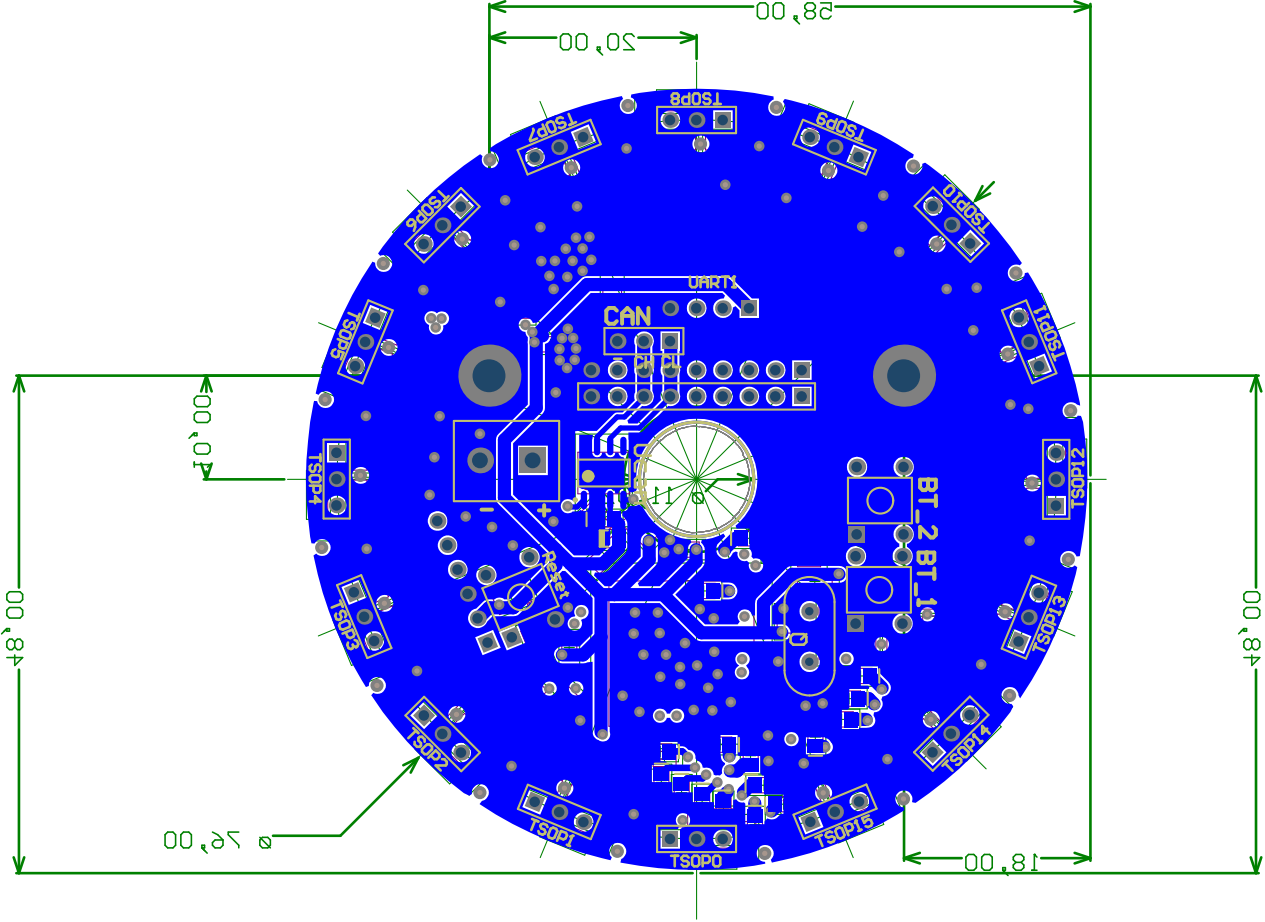
[picture p325: page 5]

Designator | Description | Comment | Value | Footprint | Quantity
B? | Bornier 2-Pin | Bornier 2-Pin | | Bornier_2 | 1
BT1, BT2, SW1 | Switch tactil 6mm x 6mm Vertical | SW_Pushbutton_6x6 mm_Vertical | | Switch 6x6 Vertical | 3
CAN | Header, 3-Pin | BARRETTE3 | | HDR1X3 | 1
Cbt1, Cbt2, Cdcan2, Cdpic1, Cdpic2, Cdpic3, Cdpic4, Cmclr, Cout2, Cvref1Capacitor | | 100nF | | C0805_N | 10
Cdcan1 | Capacitor | 1uF | | C1206_N | 1
Cin, Cout | Capacitor | 10uF | | C1206_N | 2
Cin2, Cvref2 | Capacitor | 10nF | | C0805_N | 2
Cq1, Cq2 | Capacitor | 22pF | | C0805_N | 2
Ctsop0, Ctsop1, Ctsop2, Ctsop3, Ctsop4, Ctsop5, Ctsop6, Ctsop7, Ctsop8, Ctsop9, Ctsop10, Ctsop11, Ctsop12, Ctsop13, Ctsop14, Ctsop15 | Capacitor | 1nF | | C0805_N | 16
Cu1rx | Capacitor | 100pF | | C0805_N | 1
D0, D1, D2, D3, D4, D5, D6, D7, D8, D9, D10, D11, D12, D13, D14, D15, Dcan, Drun | Typical LED | LED | | LED_0805 | 18
ICSP | Header, 6-Pin | BARRETTE6 | | HDR1X6 | 1
interBalises, interBalises2 | Header, 9-Pin | Header 9 | | HDR1X9 | 2
Q | Crystal Oscillator | 10MHz | | HC49US | 1
Rbt1, Rbt2, Rsmclr, Rsu1tx | Resistor | 100 | | R1206_N | 4

Rf0, Rf1, Rf2, Rf3,
Rf4, Rf5, Rf6, Rf7,
Rf8, Rf9, Rf10, Rf11,
Rf12, Rf13, Rf14,
Rf15 | Resistor | 47 | R1206_N | 16

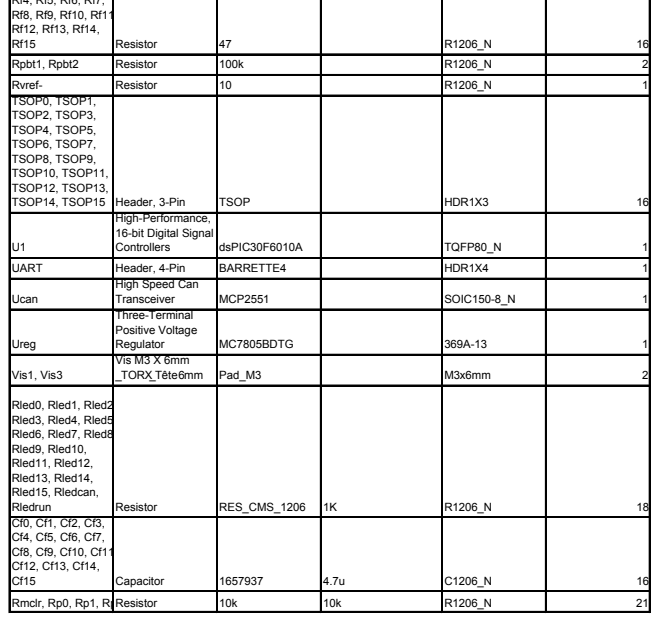
[picture p326: page 7]

Rpbt1, Rpbt2 | Resistor | 100k | | R1206_N | 2
Rvref- | Resistor | 10 | | R1206_N | 1
TSOP0, TSOP1, TSOP2, TSOP3, TSOP4, TSOP5, TSOP6, TSOP7, TSOP8, TSOP9, TSOP10, TSOP11, TSOP12, TSOP13, TSOP14, TSOP15 | Header, 3-Pin | TSOP | | HDR1X3 | 16

U1 | High-Performance, 16-bit Digital Signal Controllers | dsPIC30F6010A | | TQFP80_N | 1

UART | Header, 4-Pin | BARRETTE4 | | HDR1X4 | 1
Ucan | High Speed Can Transceiver | MCP2551 | | SOIC150-8_N | 1

Ureg | Three-Terminal Positive Voltage Regulator | MC7805BDTG | | 369A-13 | 1

Vis1, Vis3 | Vis M3 X 6mm _TORX_Tête 6mm | Pad_M3 | | M3x6mm | 2

Rled0, Rled1, Rled2, Rled3, Rled4, Rled5, Rled6, Rled7, Rled8, Rled9, Rled10, Rled11, Rled12, Rled13, Rled14, Rled15, Rledcan, Rledrun | Resistor | RES_CMS_1206 | 1K | R1206_N | 18

Cf0, Cf1, Cf2, Cf3, Cf4, Cf5, Cf6, Cf7, Cf8, Cf9, Cf10, Cf11, Cf12, Cf13, Cf14, Cf15 | Capacitor | 1657937 | 4.7u | C1206_N | 16

Rmclr, Rp0, Rp1, Rp2, Rp3, Rp4, Rp5, Rp6, Rp7, Rp8, Rp9, Rp10, Rp11, Rp12, Rp13, Rp14, Rp15, Rsu1rx Resistor | | 10k | 10k | R1206_N | 21
