samuelpoiraud/robot/_Hard/2013_fdp_banc_de_test/2013_fdp_banc_de_test_v1.PDF

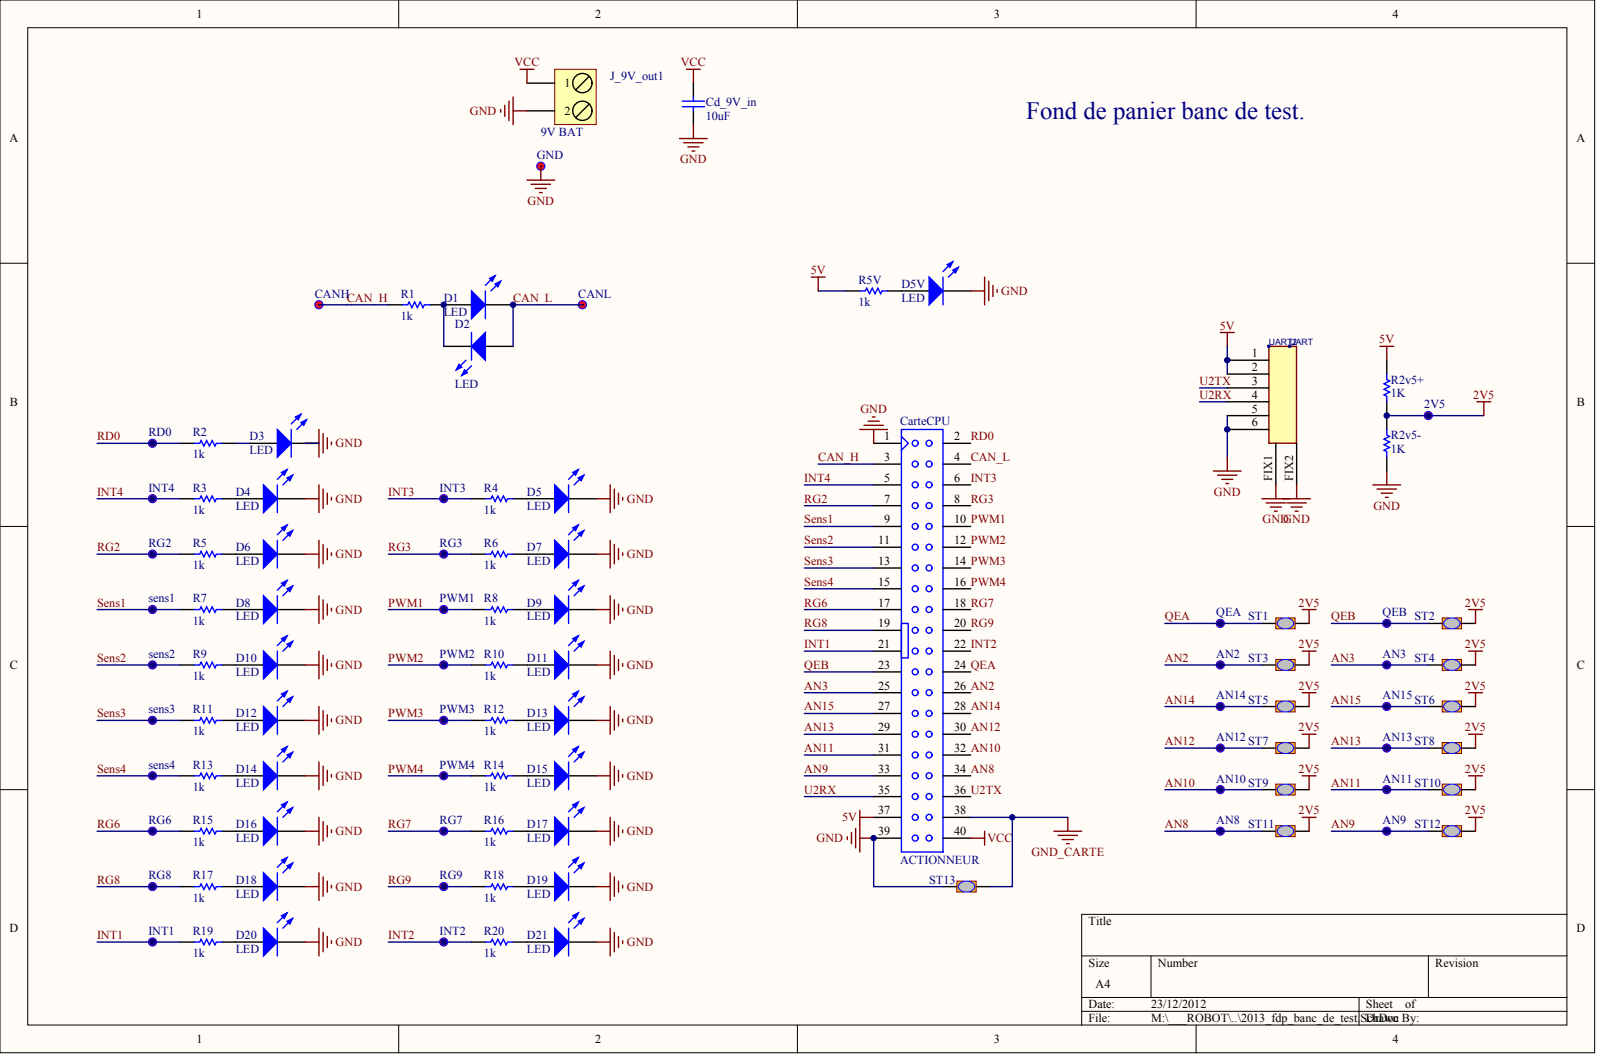
[picture p327: page 1]

Fond de panier banc de test.

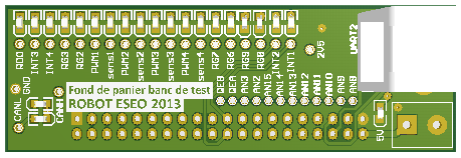
[picture p328: figure]

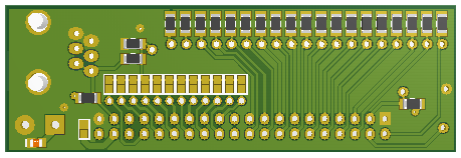
[picture p329: figure]
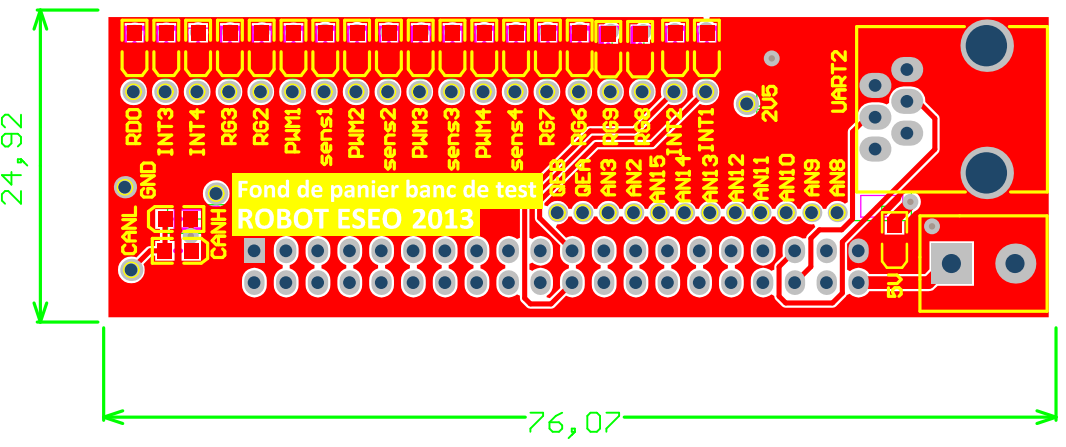
[picture p330: page 4]

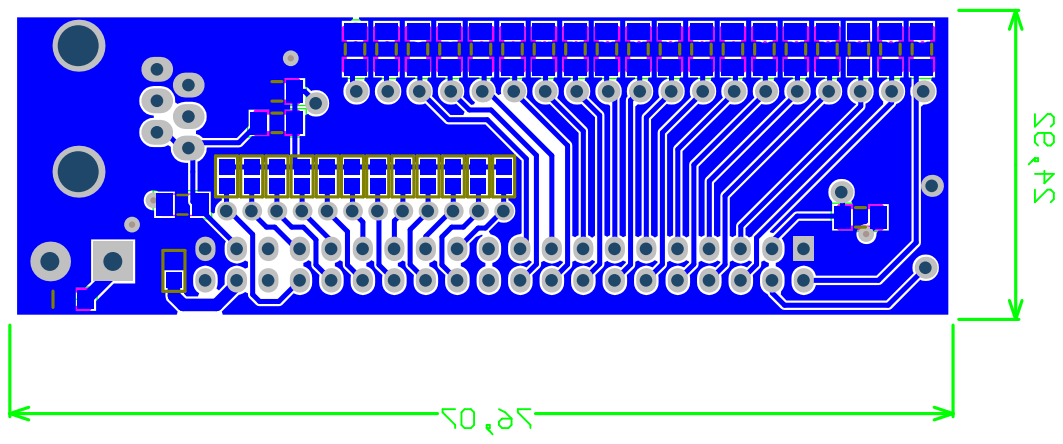
[picture p331: page 5]

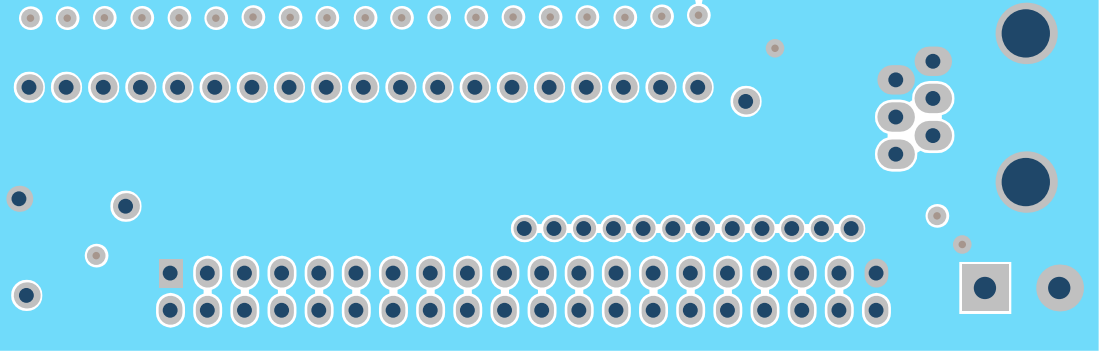
[picture p332: page 6]

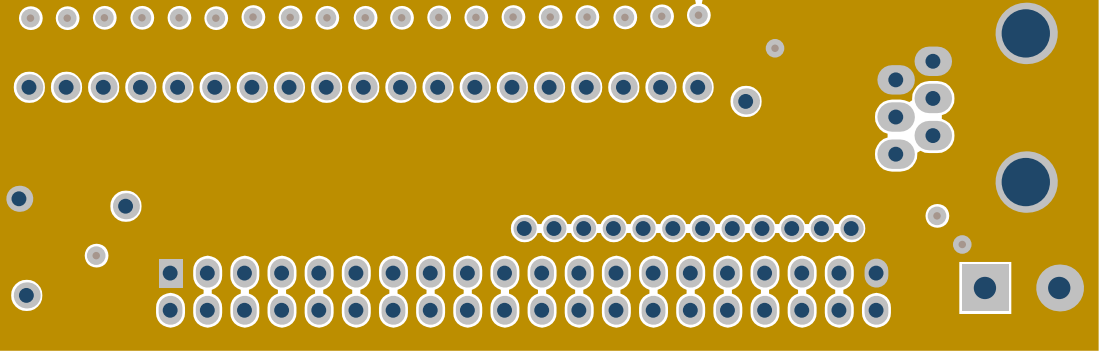
[picture p333: page 7]

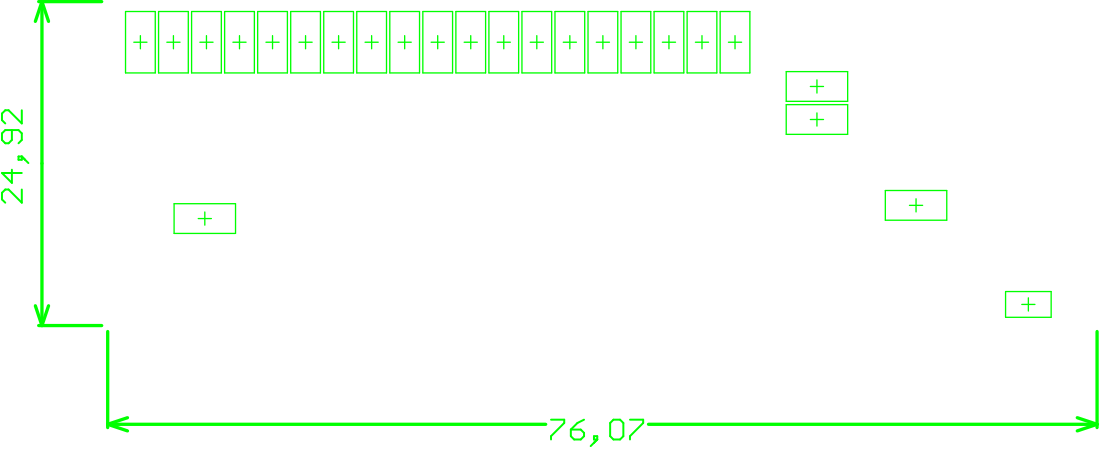
[picture p334: page 8]
