samuelpoiraud/robot/_Hard/2016_CNC_v2/2016_CNC_v2.PDF

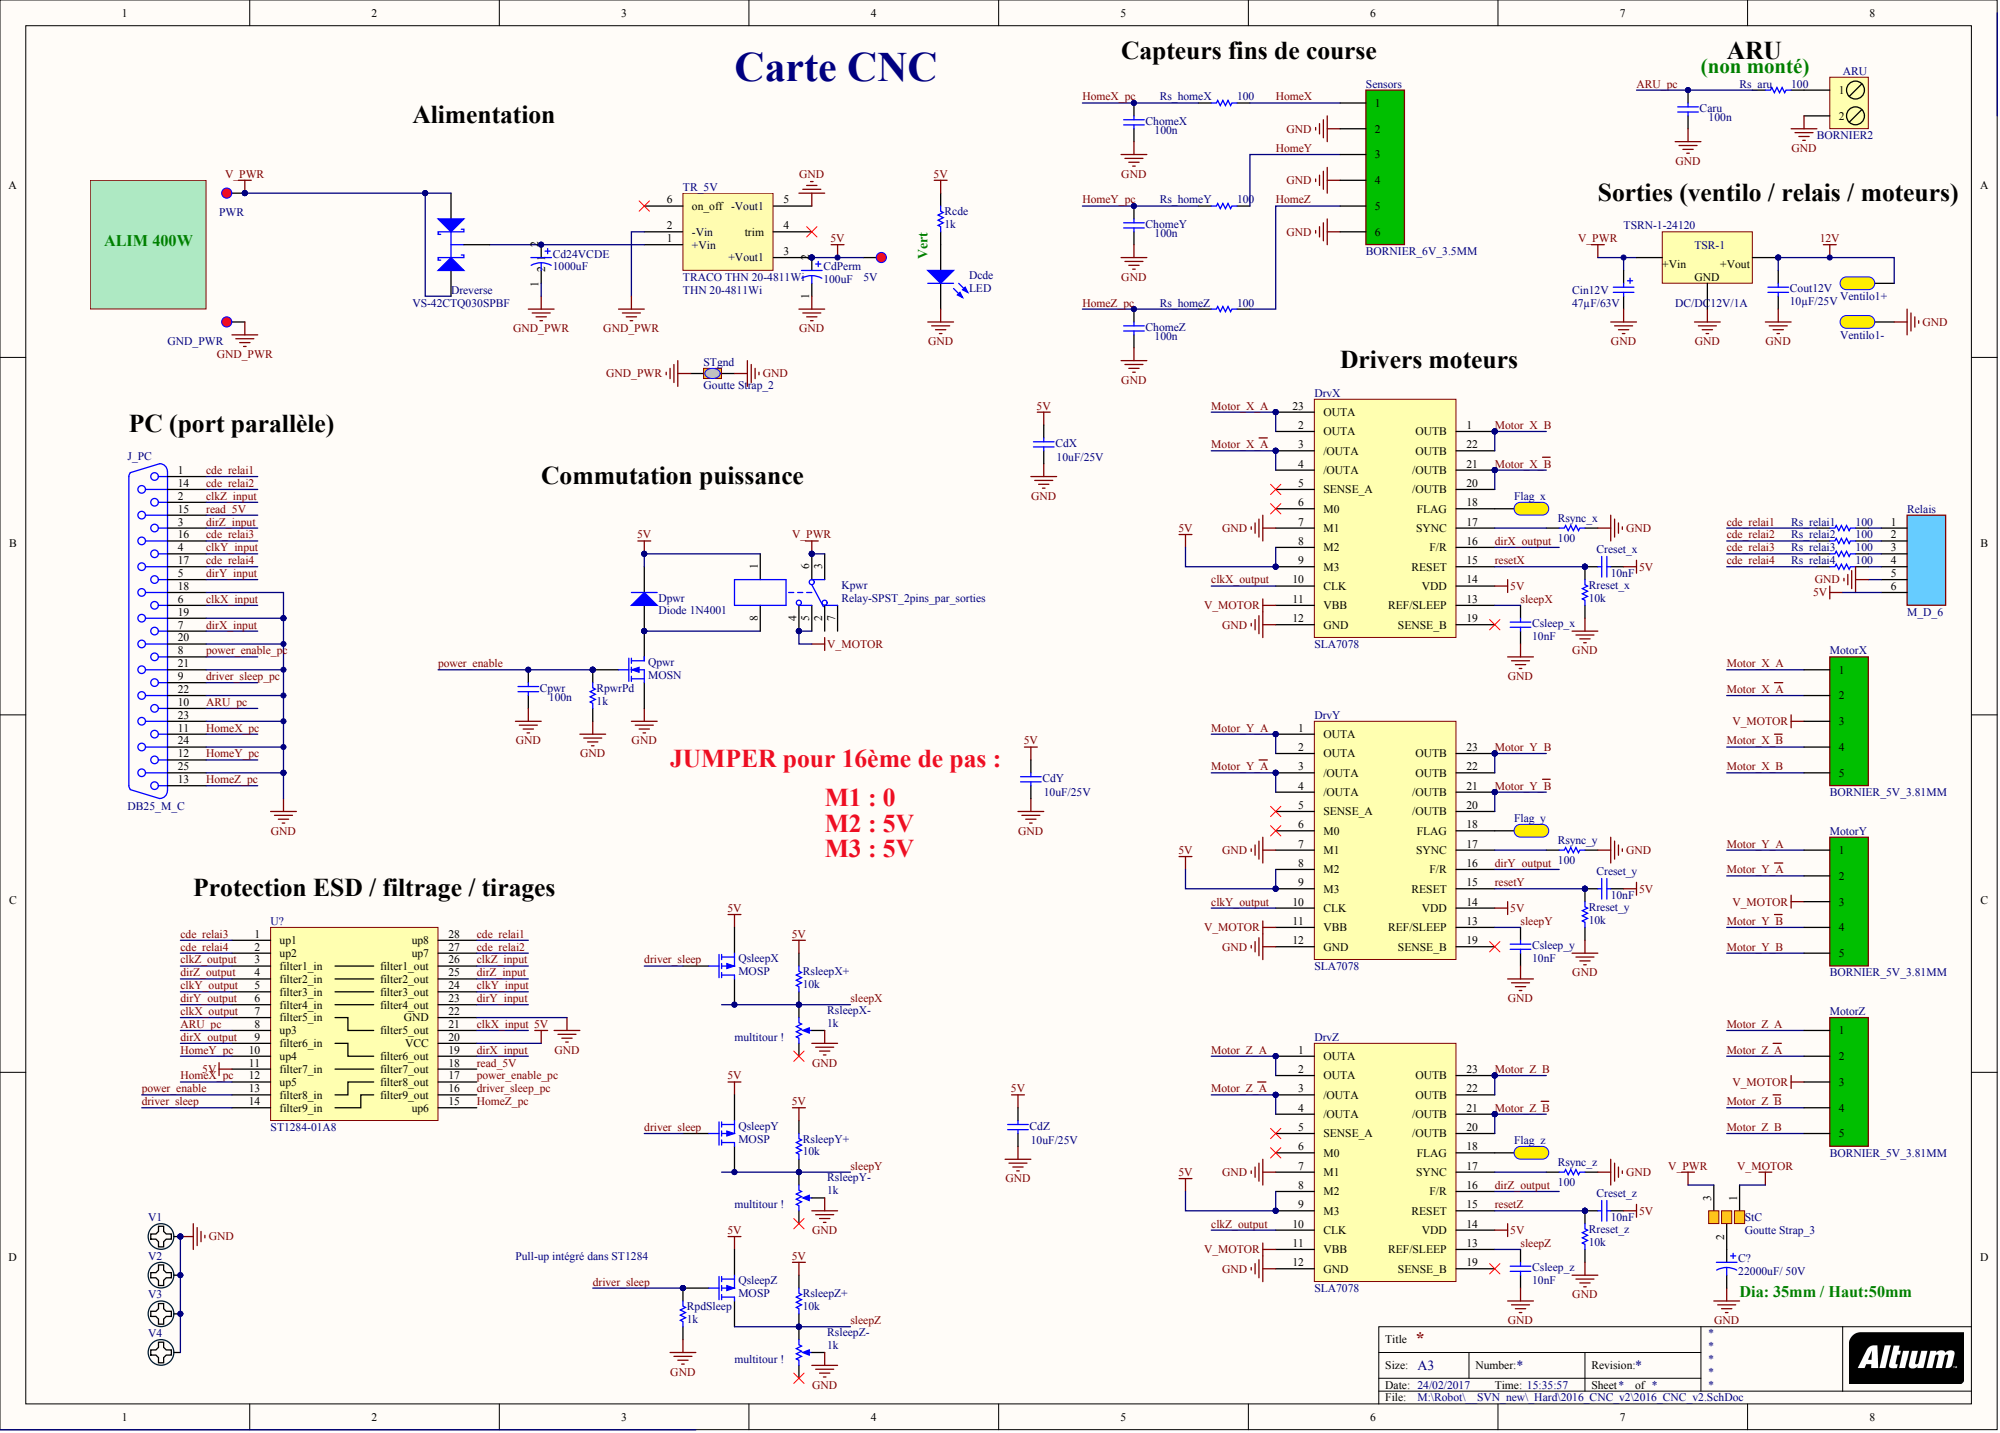
[picture p335: page 1]

Capteurs fins de course

Sorties (ventilo / relais / moteurs)

GND
JUMPER pour 16ème de pas :

Protection ESD / filtrage / tirages

Pull-up intégré dans ST1284

* Title | **** *

Size: A3 | Number: * | Revision: *
Date: 24/02/2017 Time: 15:35:57 | | Sheet * of *

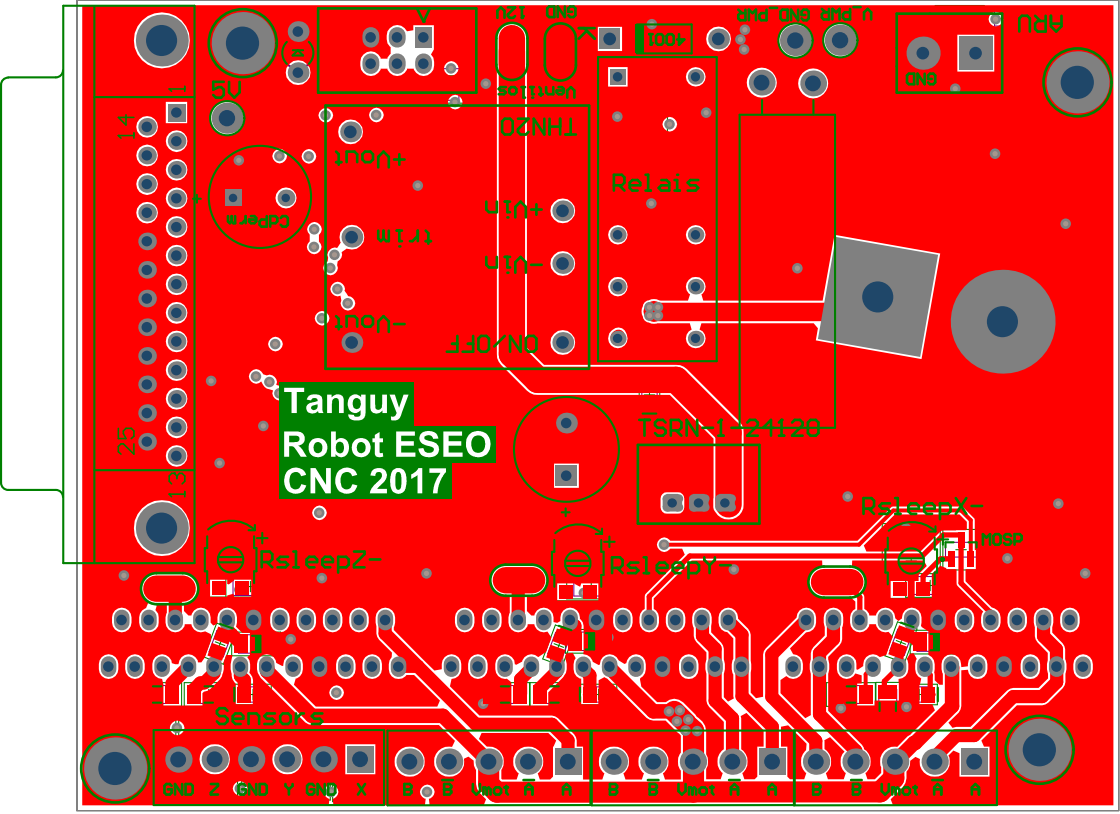
[picture p336: page 2]

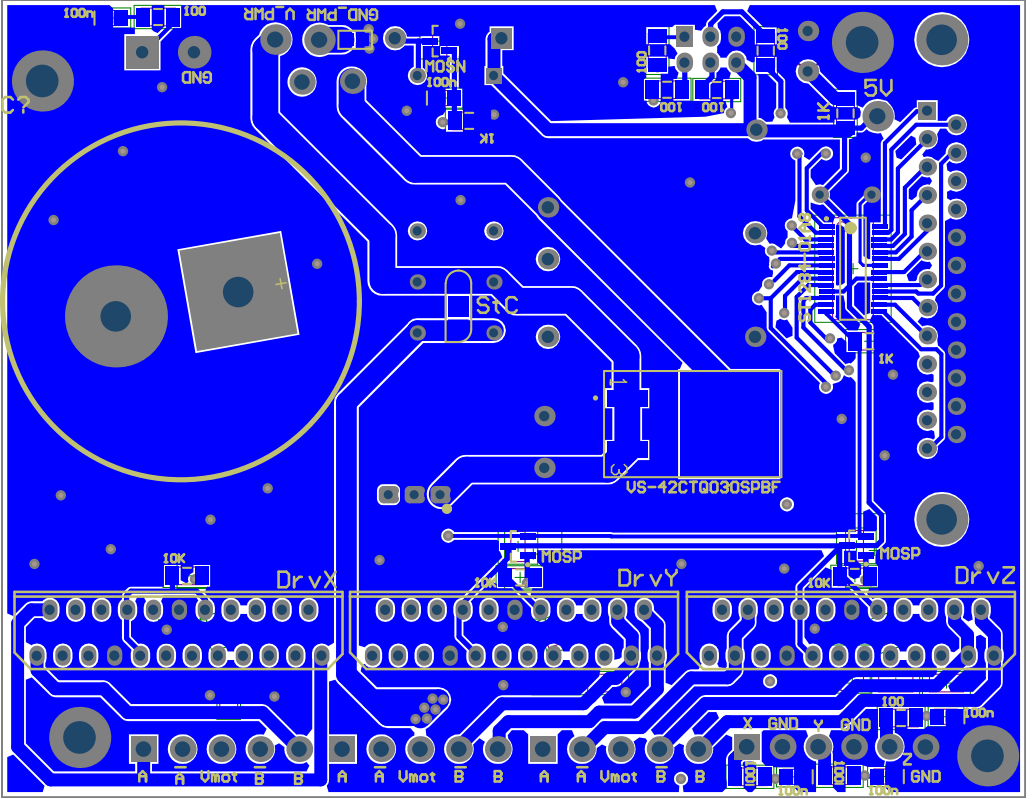
[picture p337: page 3]

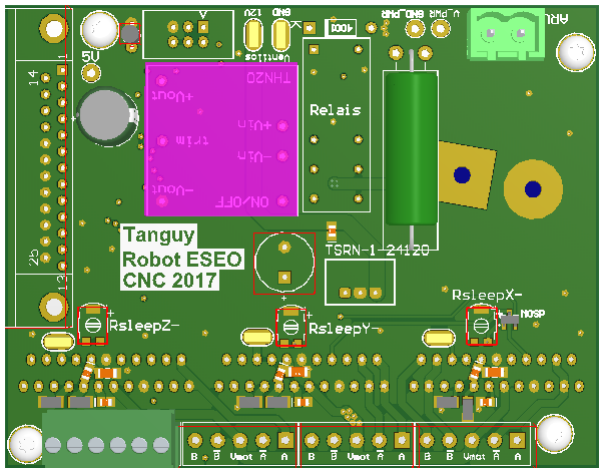
[picture p338: figure]

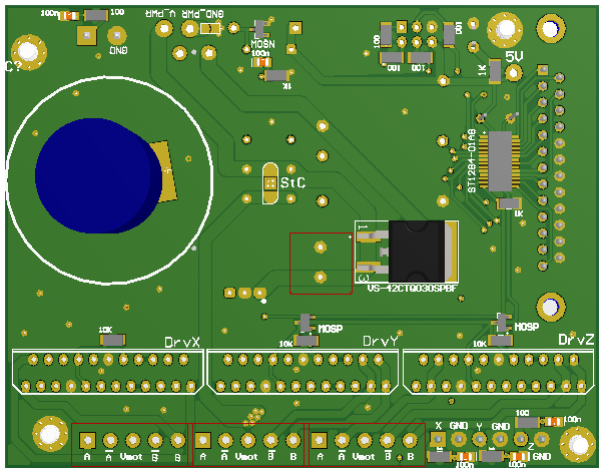
[picture p339: figure]
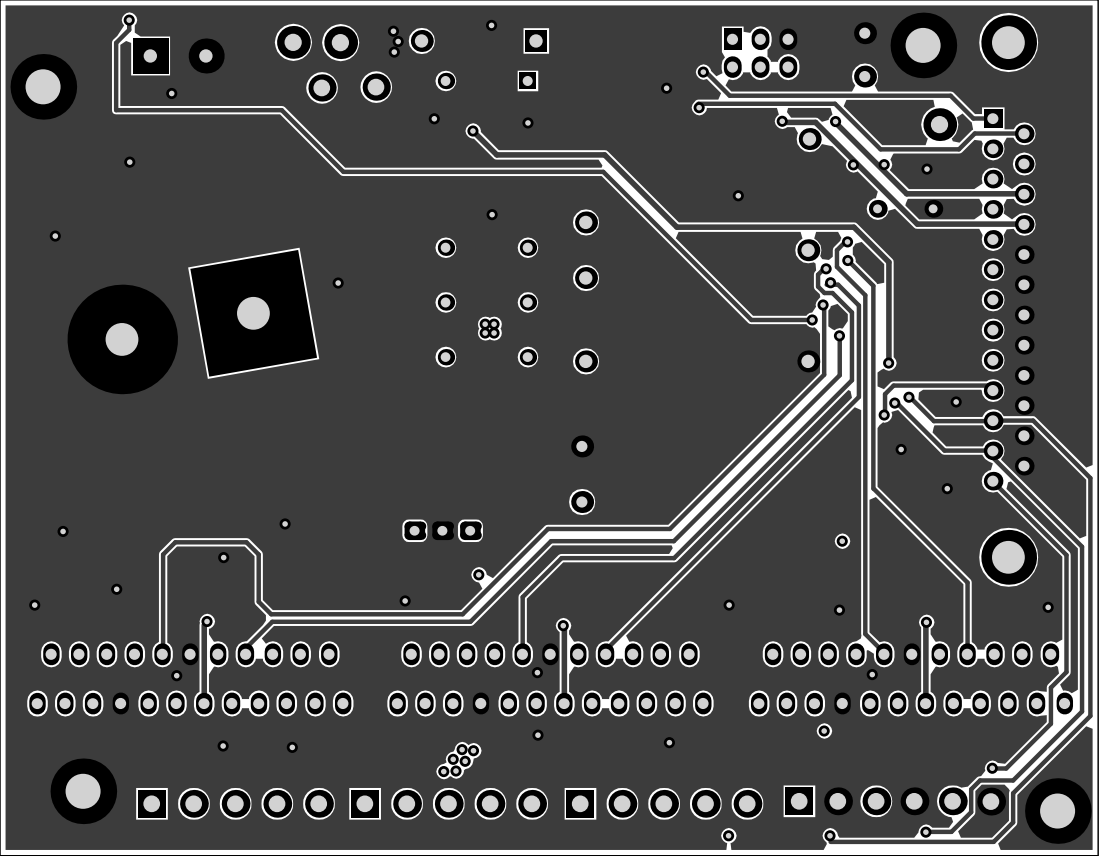
[picture p340: page 6]

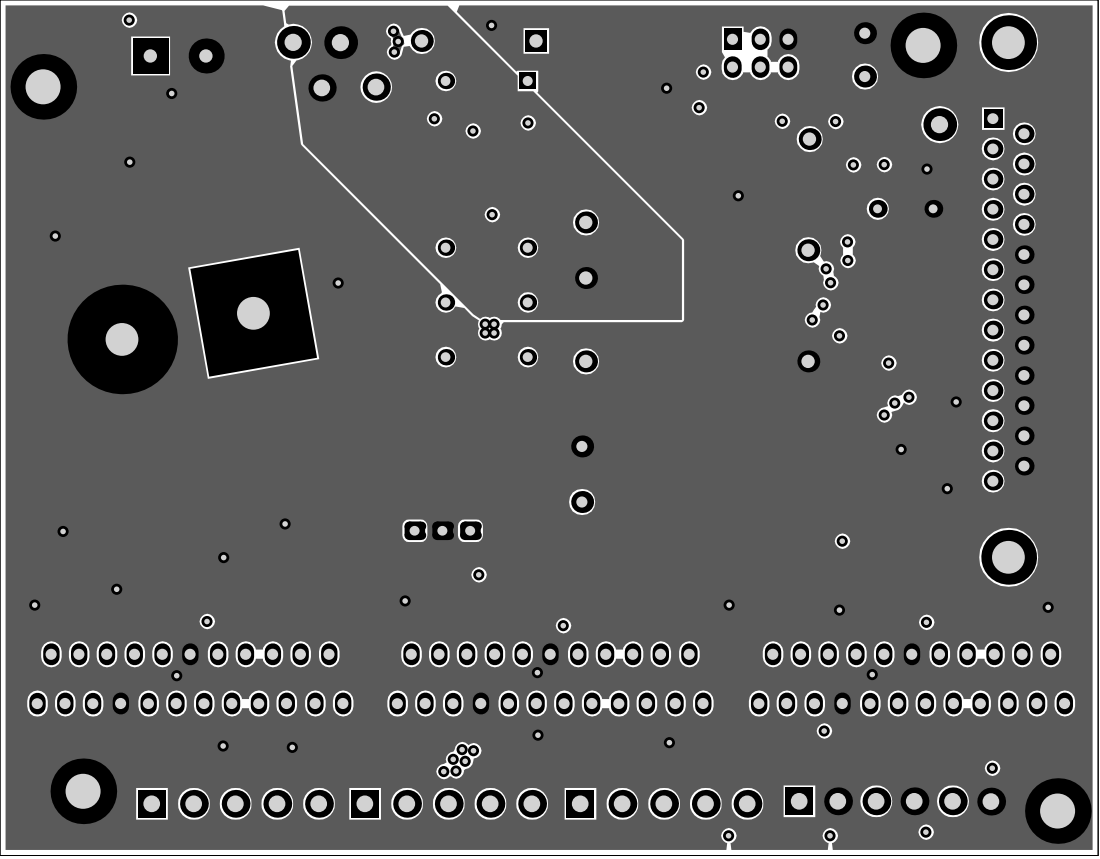
[picture p341: page 7]
