samuelpoiraud/robot/_Hard/2017_Carte Puissance/2017_CARTE_PUISSANCE.PDF

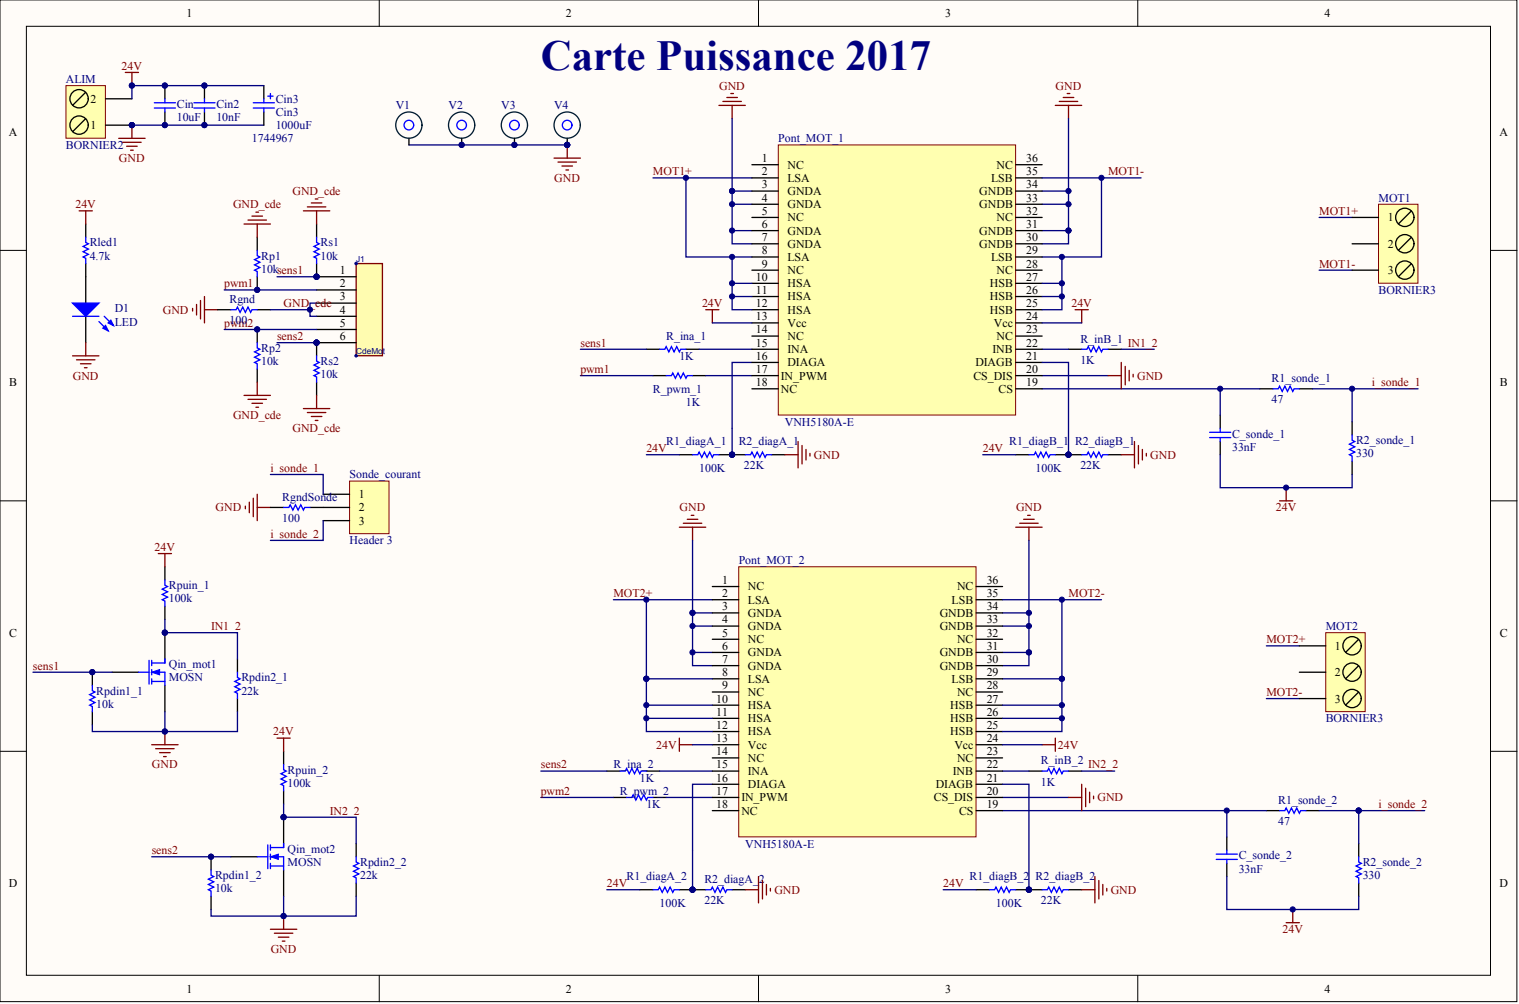
[picture p342: page 1]

HSA 11
HSA 12

IN_PWM 17 DIAGA 16

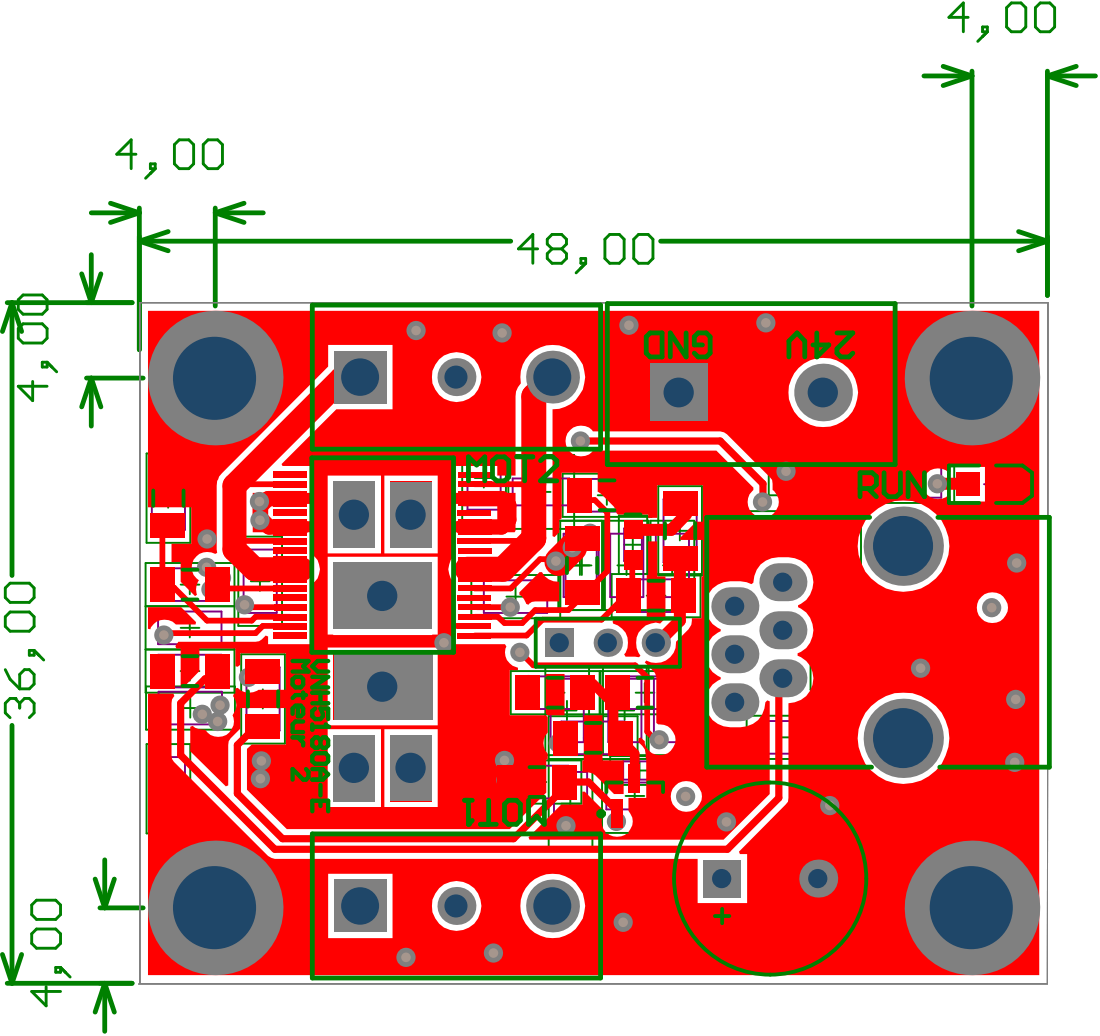
[picture p343: page 2]

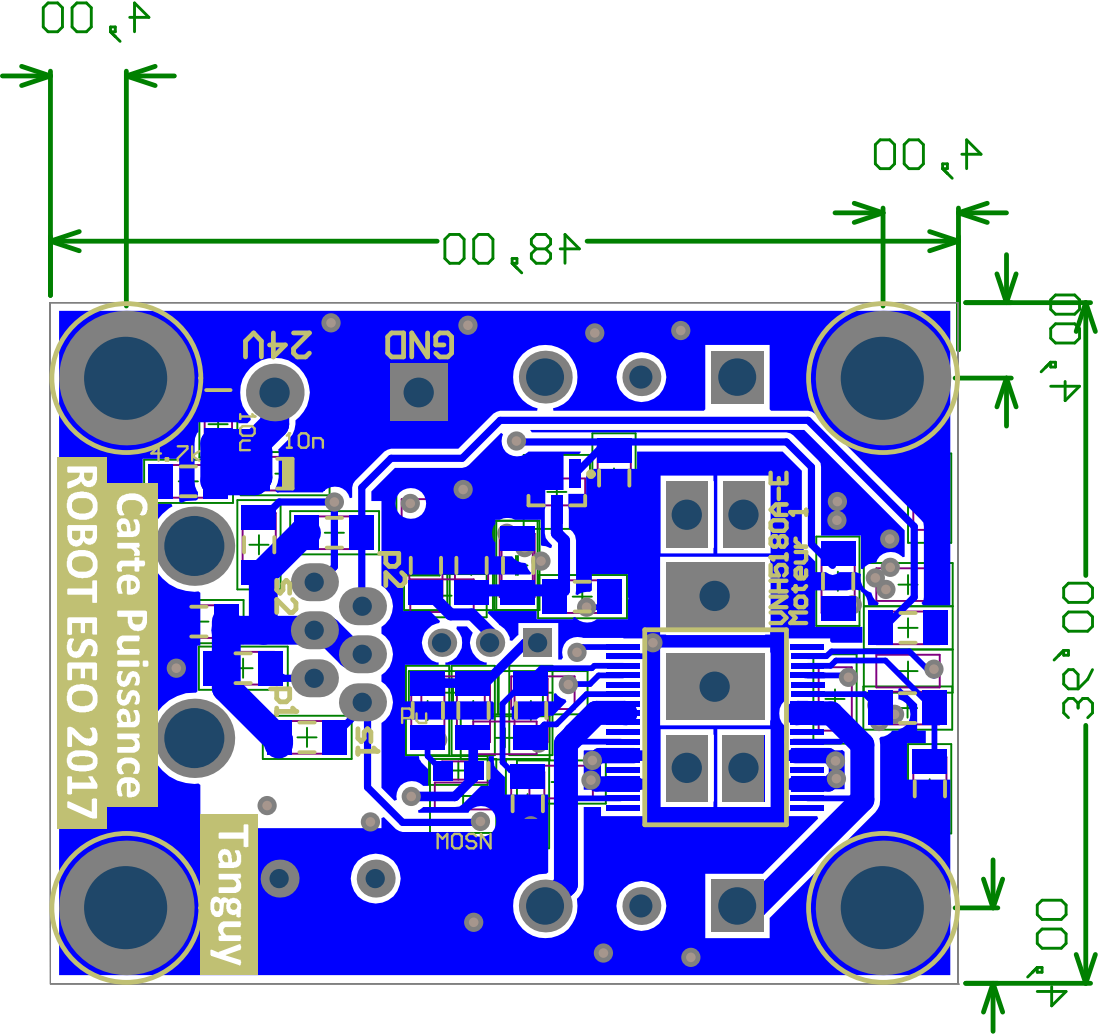
[picture p344: page 3]

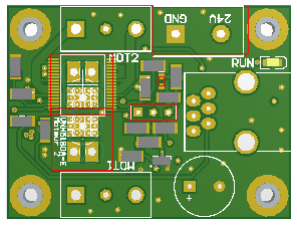
[picture p345: figure]

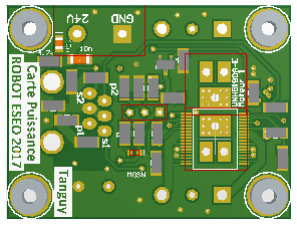
[picture p346: figure]
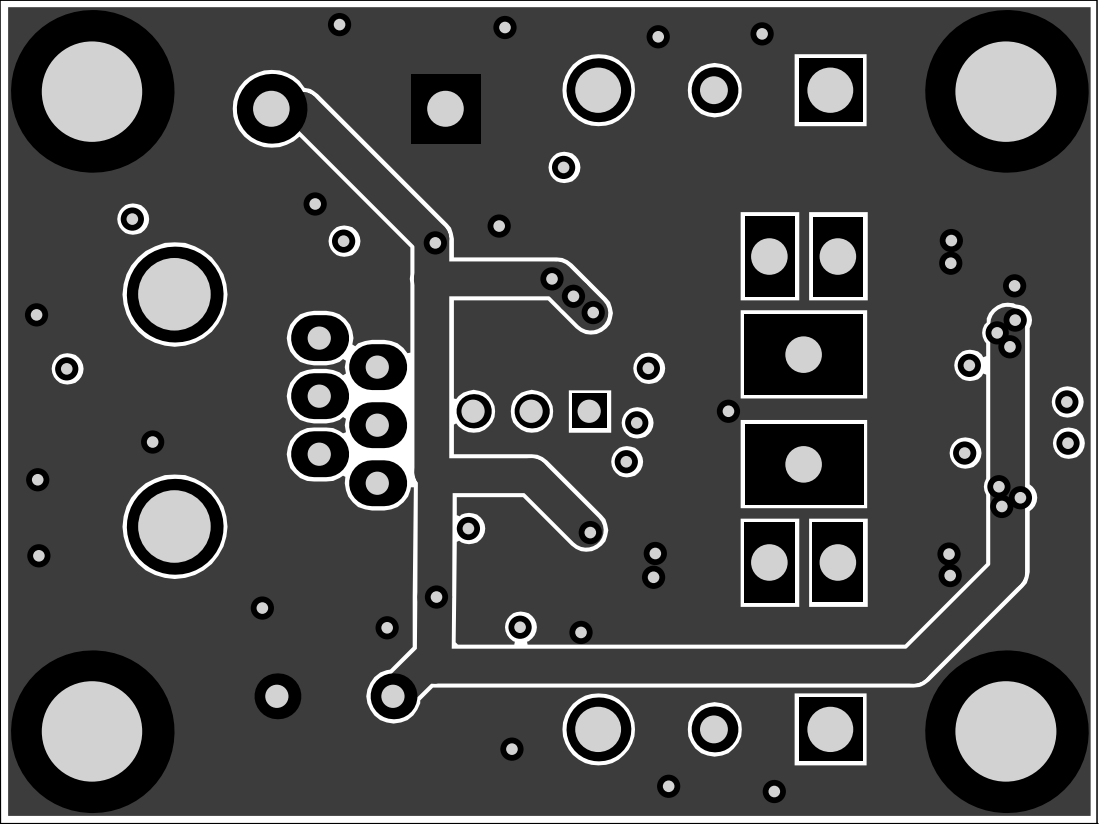
[picture p347: page 6]

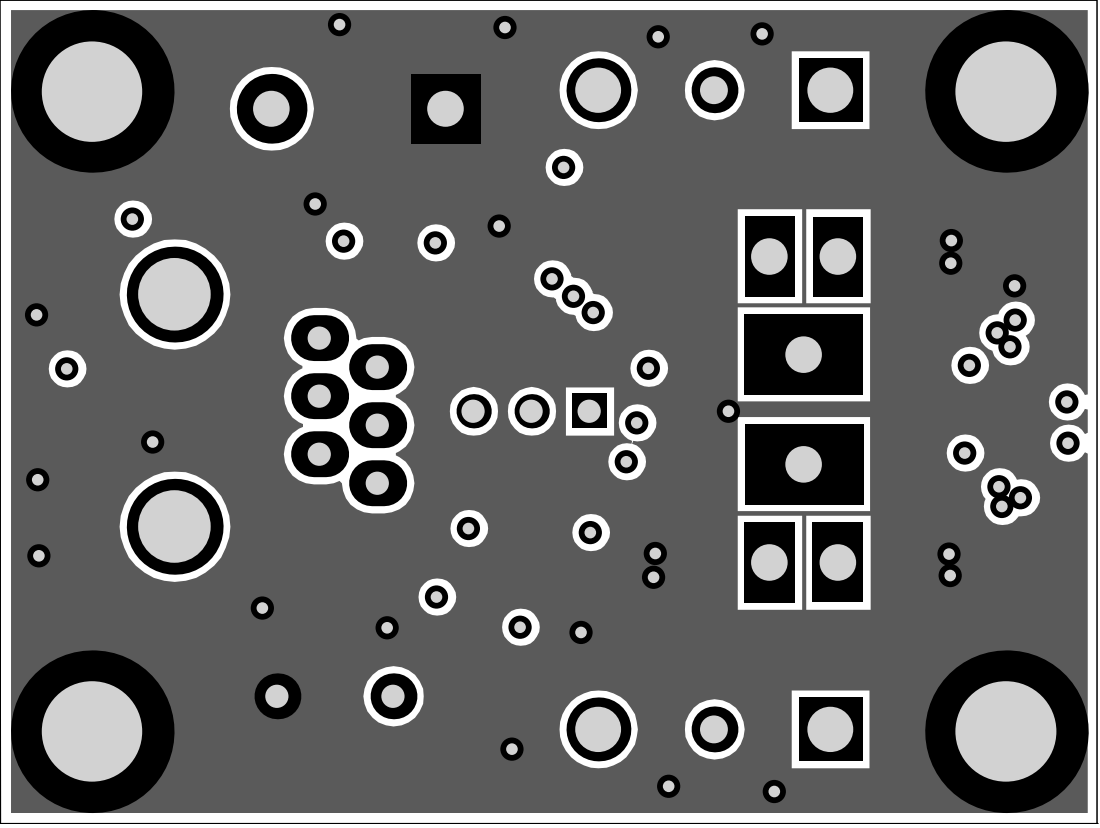
[picture p348: page 7]
