samuelpoiraud/robot/_Hard/2017_CARTE_4_MOSFET/2017_CARTE_4_MOFSET.PDF

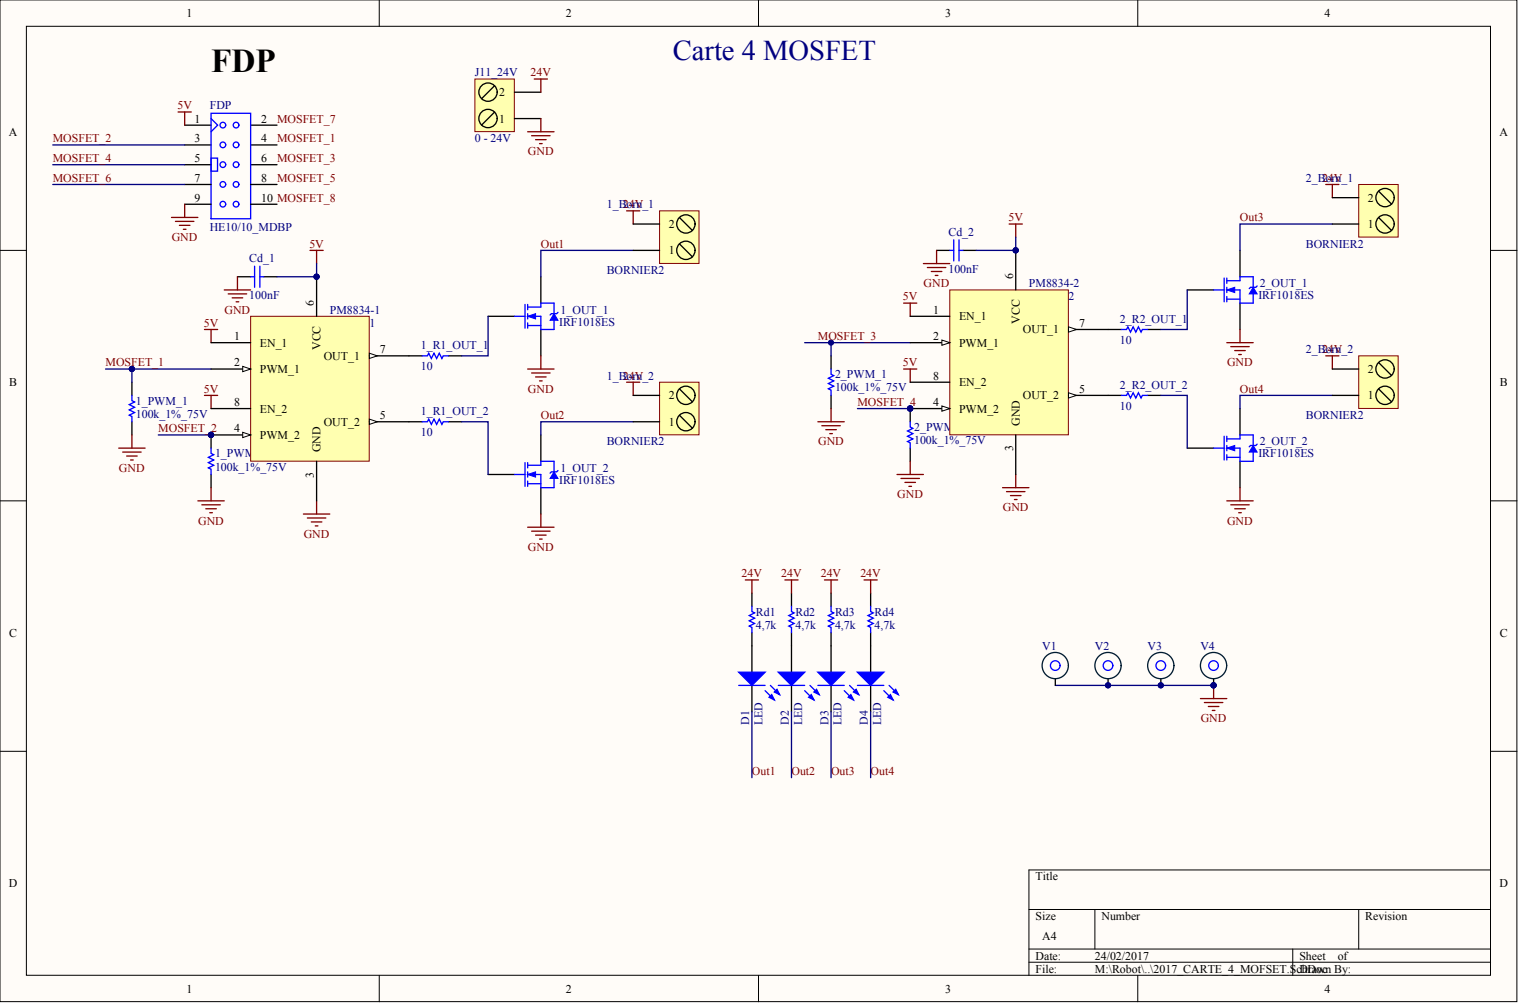
[picture p349: page 1]

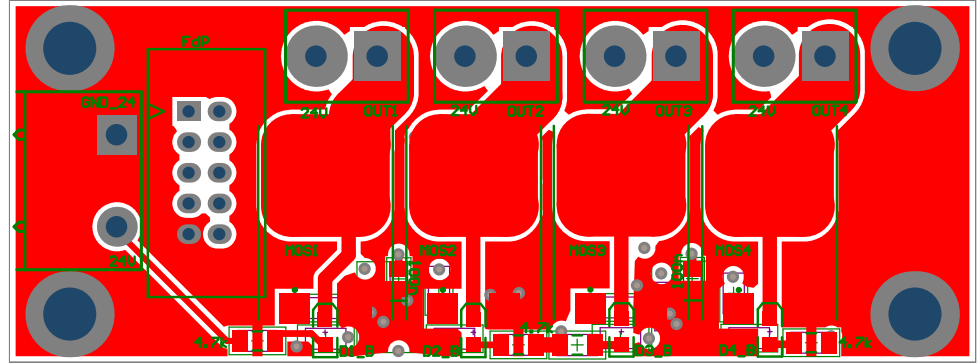
[picture p350: page 2]

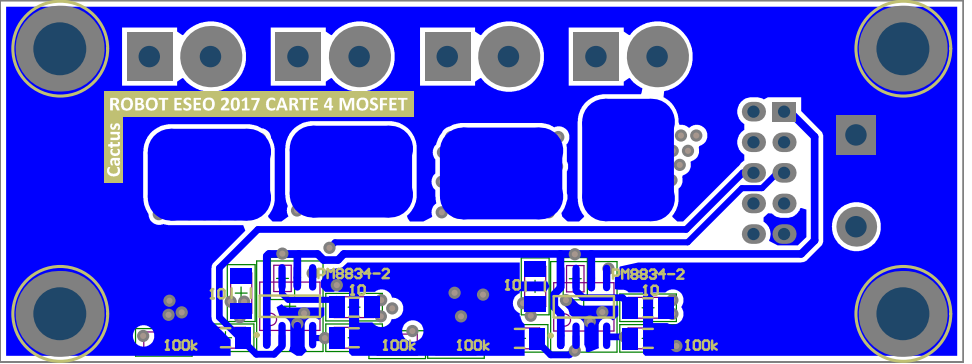
[picture p351: page 3]

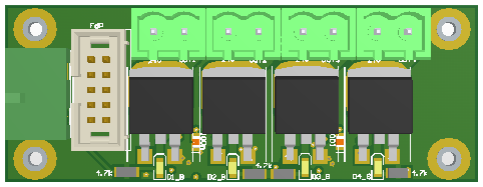
[picture p352: figure]

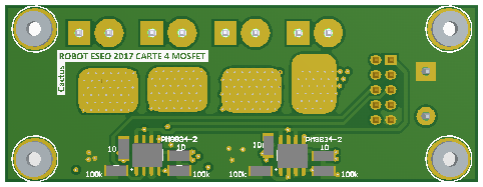
[picture p353: figure]
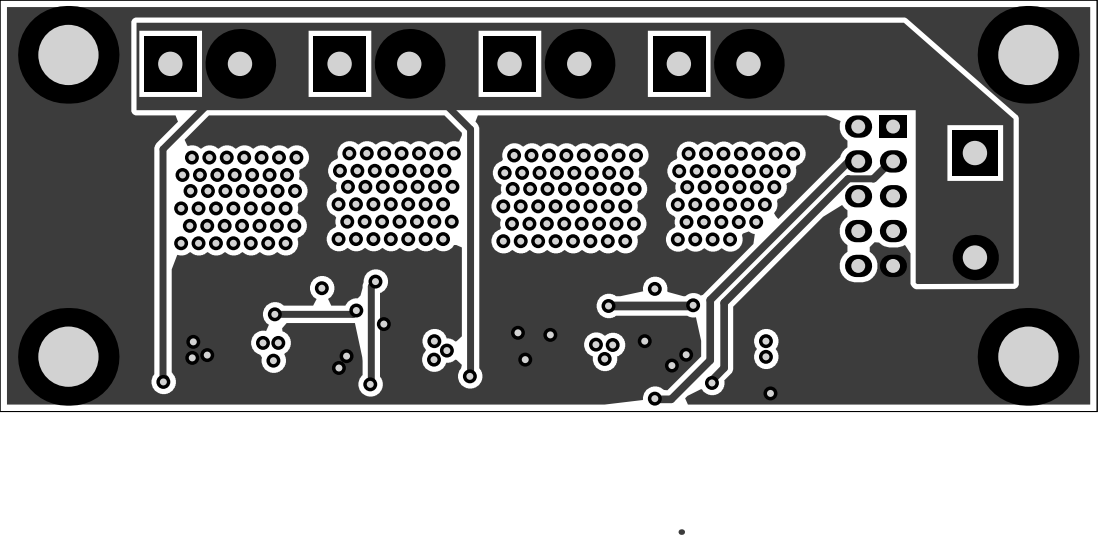
[picture p354: page 6]

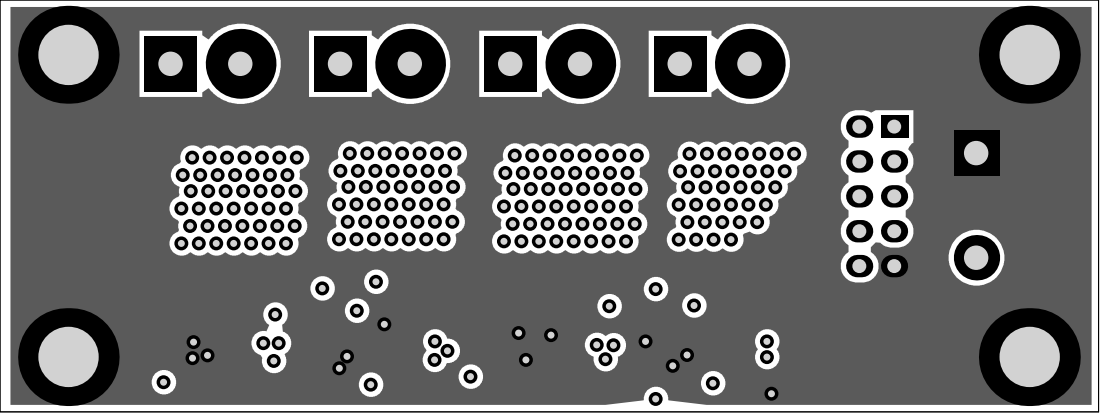
[picture p355: page 7]
