samuelpoiraud/robot/_Hard/2017_CARTE_MOSFET_Courant/2017_CARTE_MOFSET.PDF

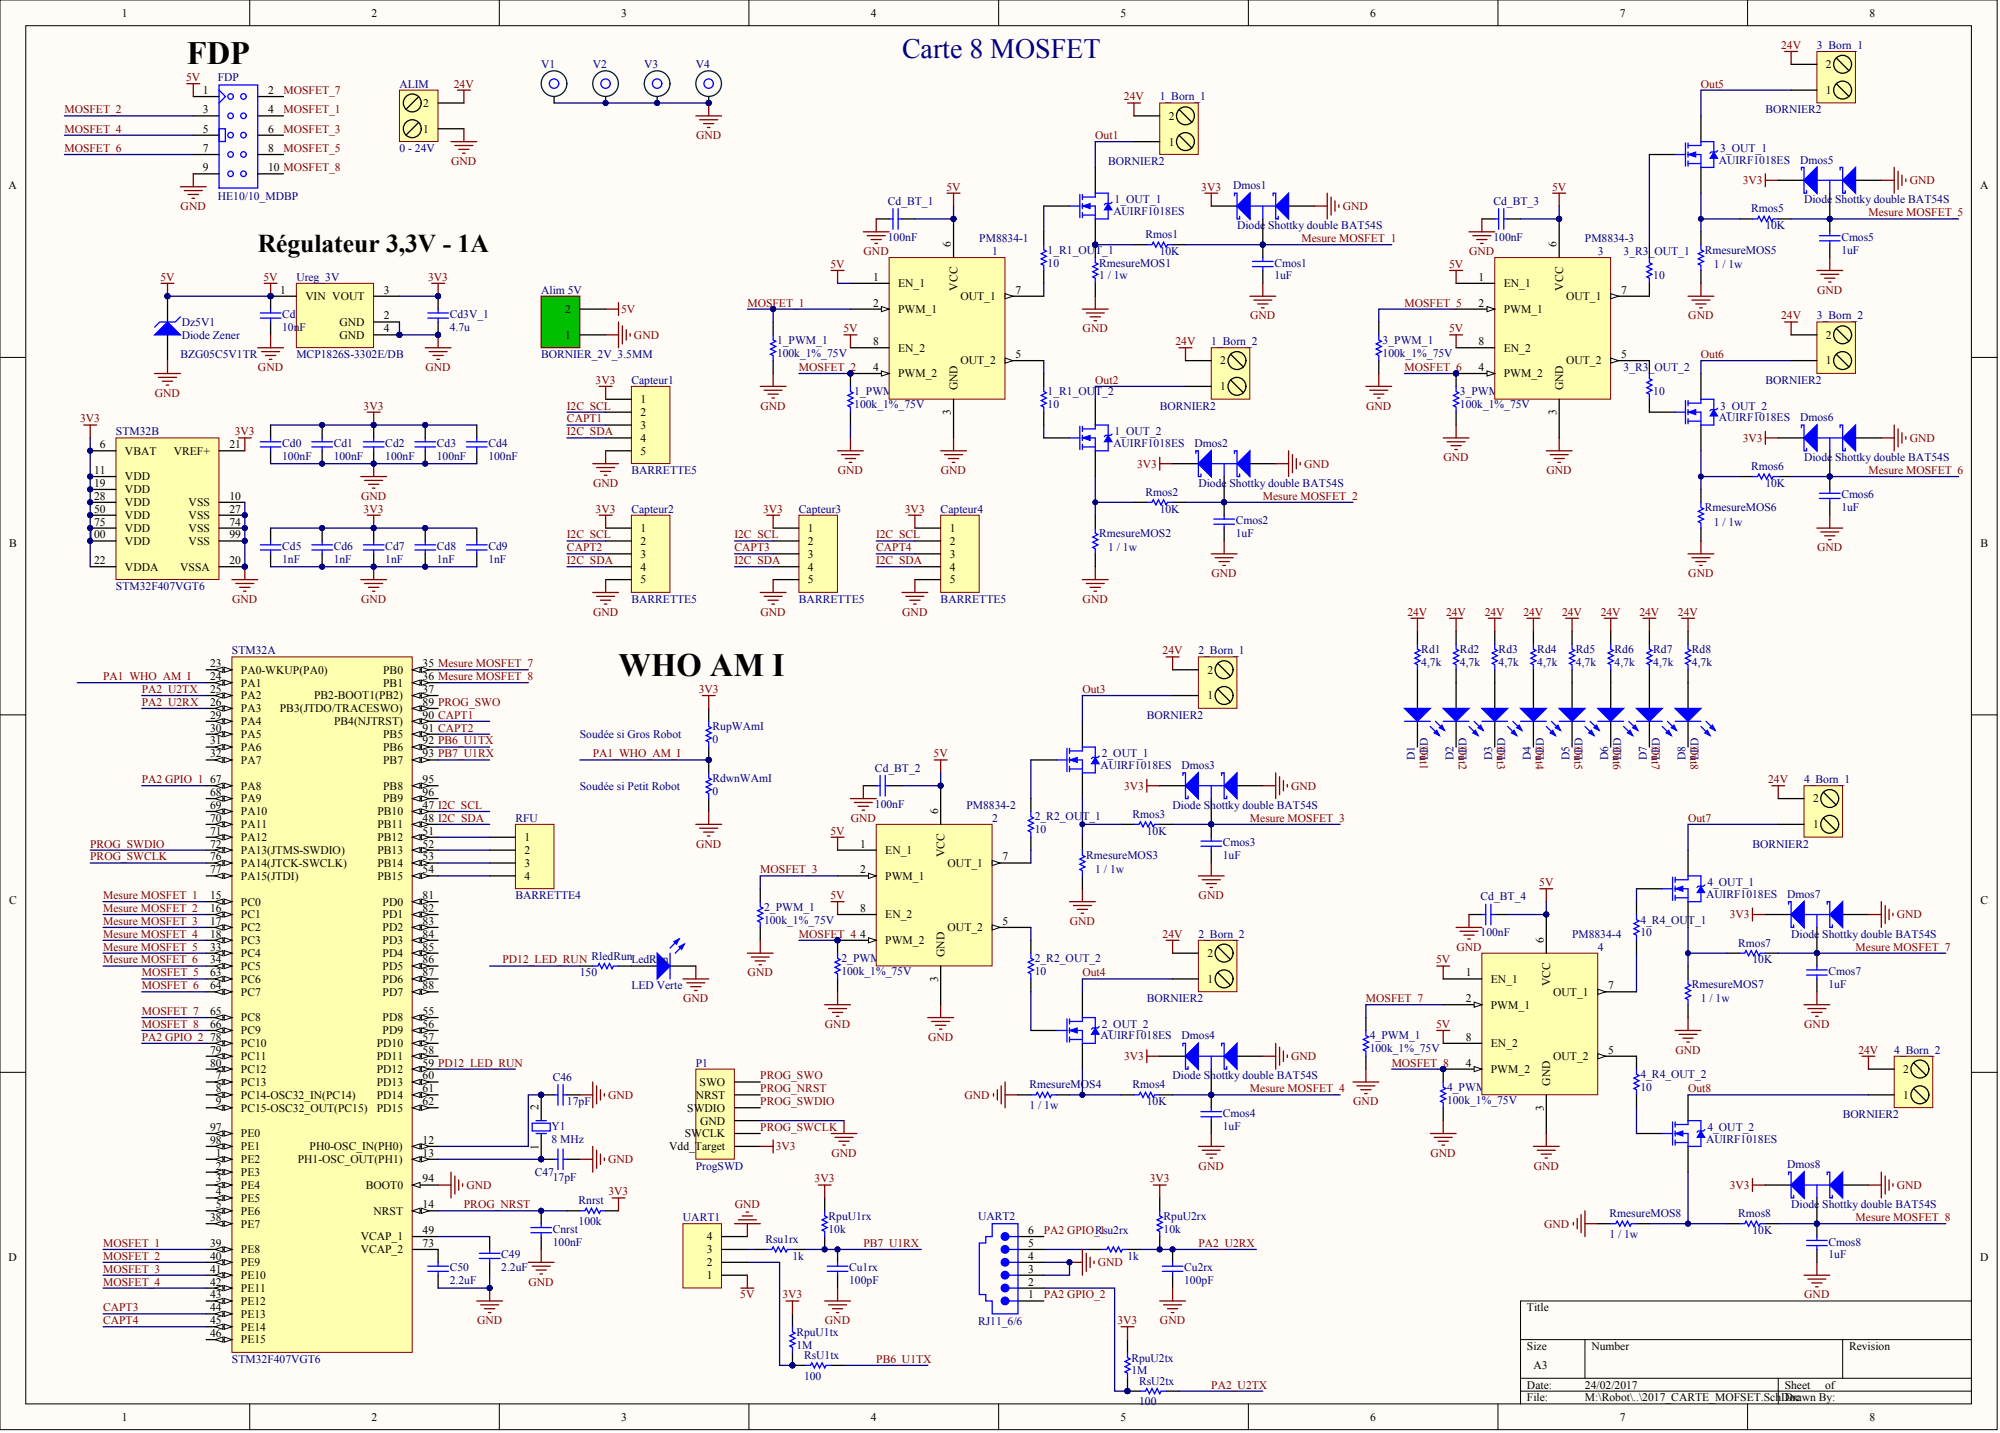
[picture p356: page 1]

Soudée si Gros Robot
PA1_WHO_AM_I

Soudée si Petit Robot

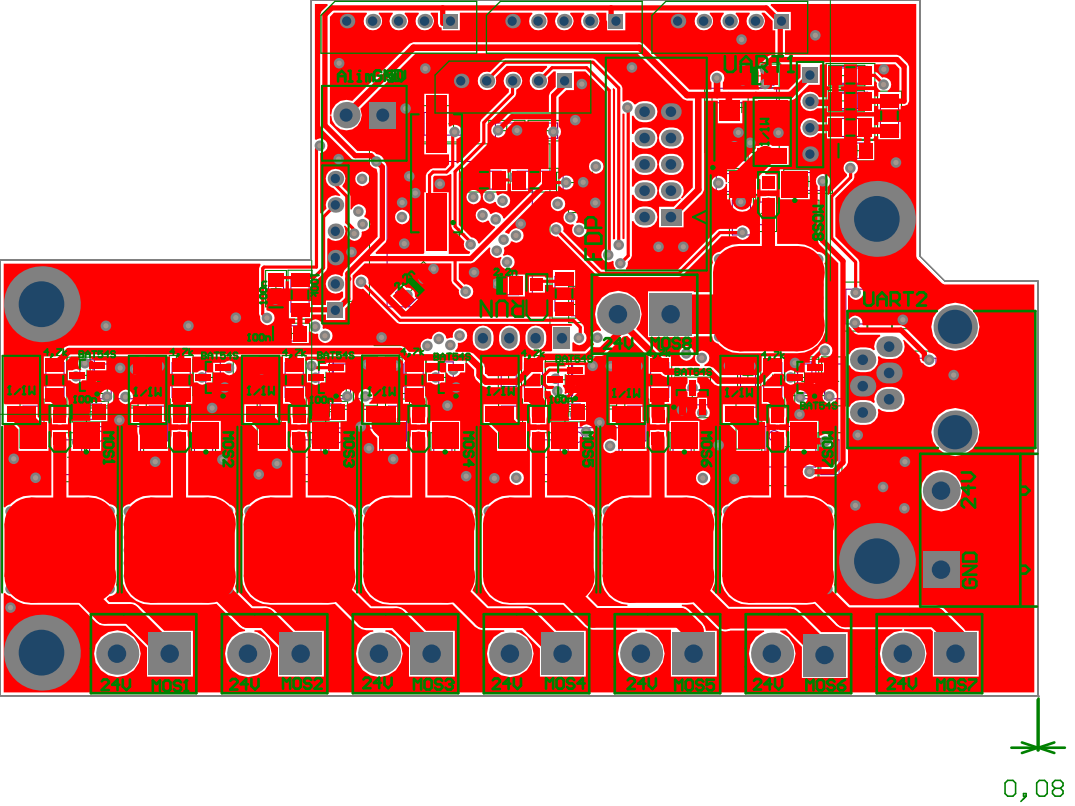
[picture p357: page 2]

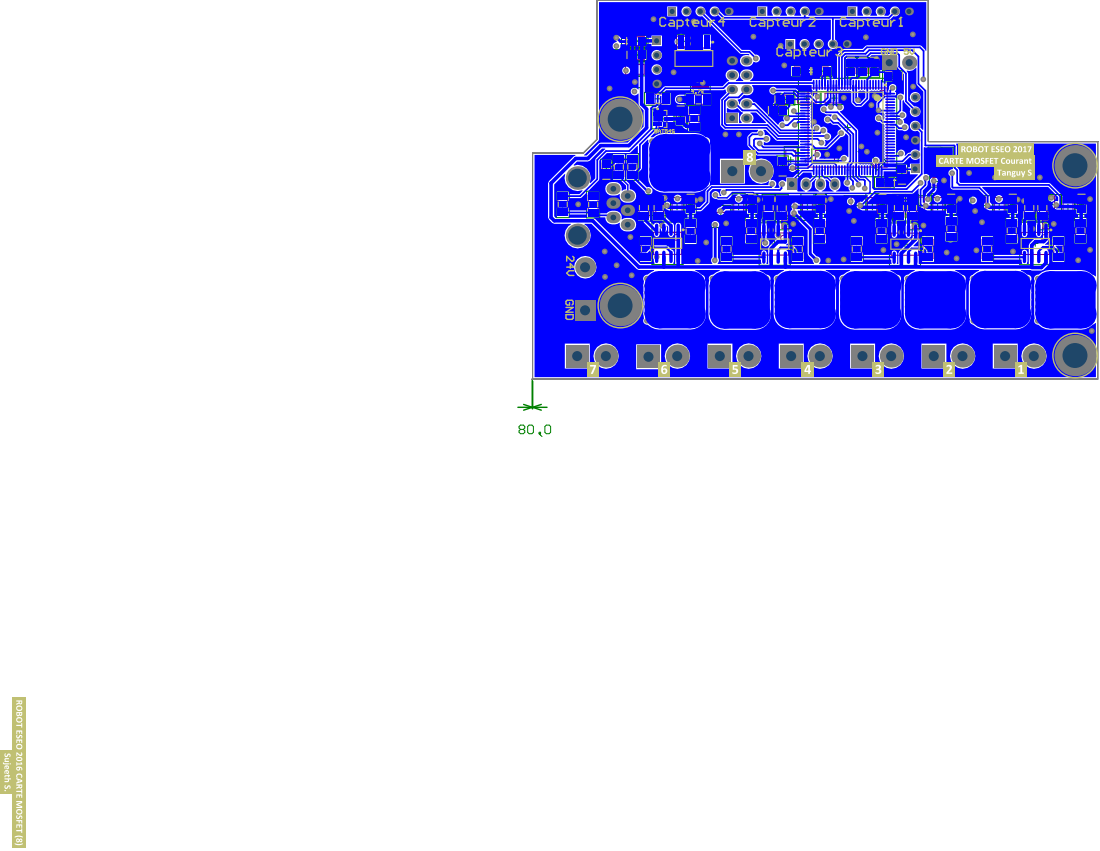
[picture p358: page 3]

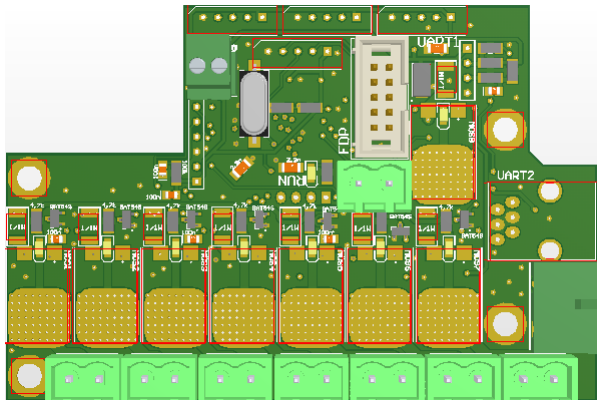
[picture p359: figure]

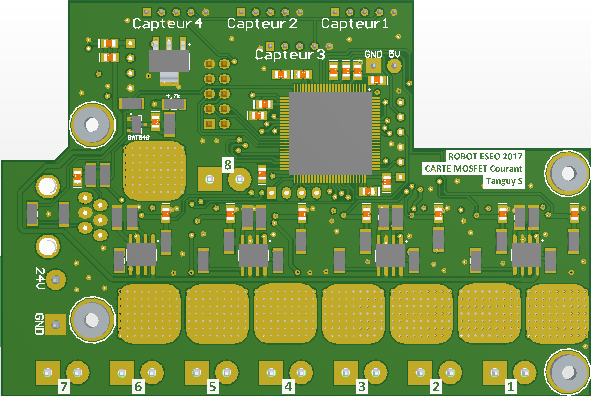
[picture p360: figure]
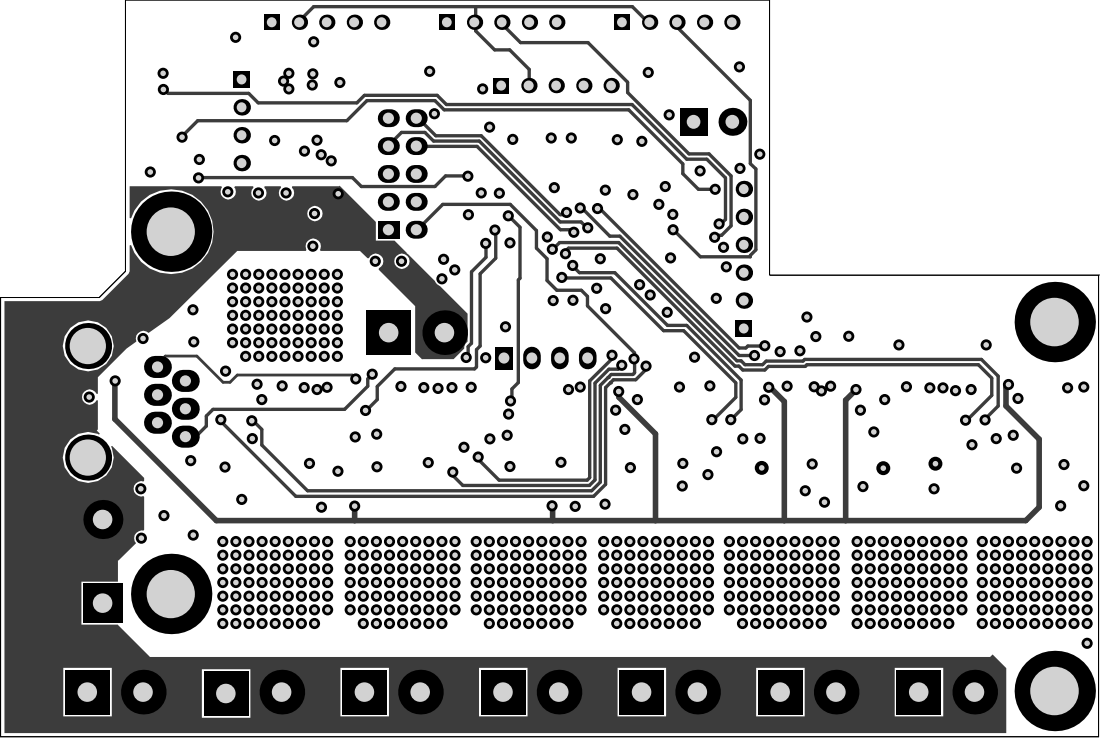
[picture p361: page 6]

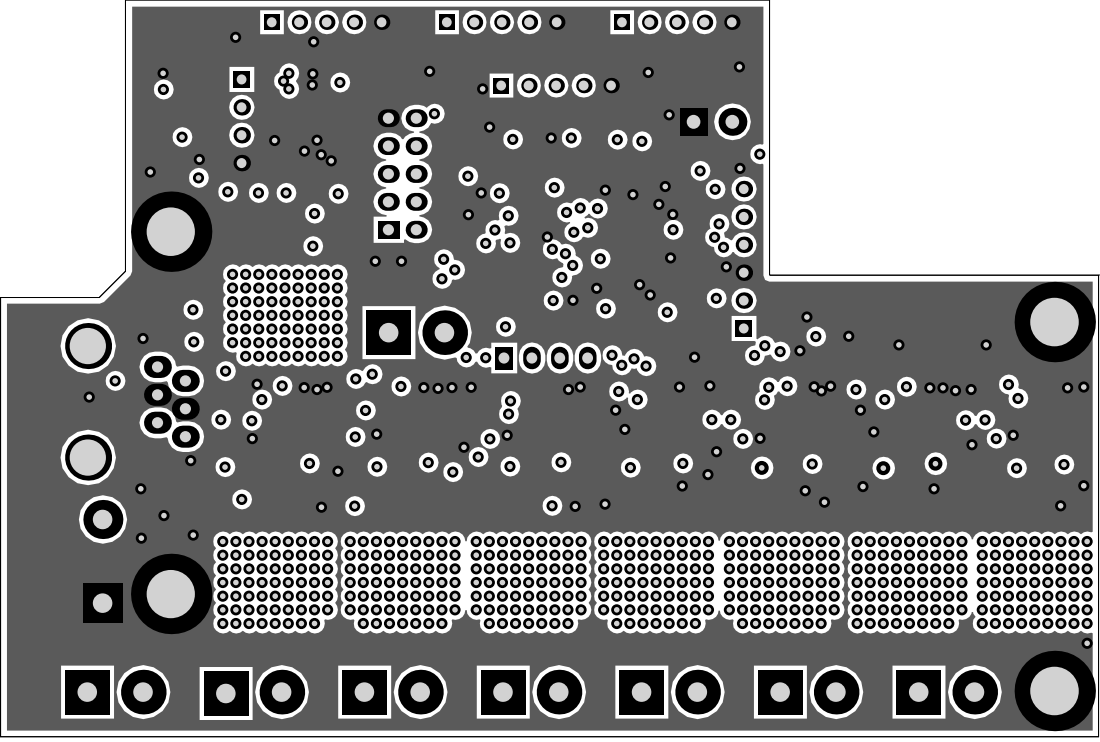
[picture p362: page 7]
