samuelpoiraud/robot/_Hard/2017_Carte_RUSH/2017_Carte_RUSH.PDF

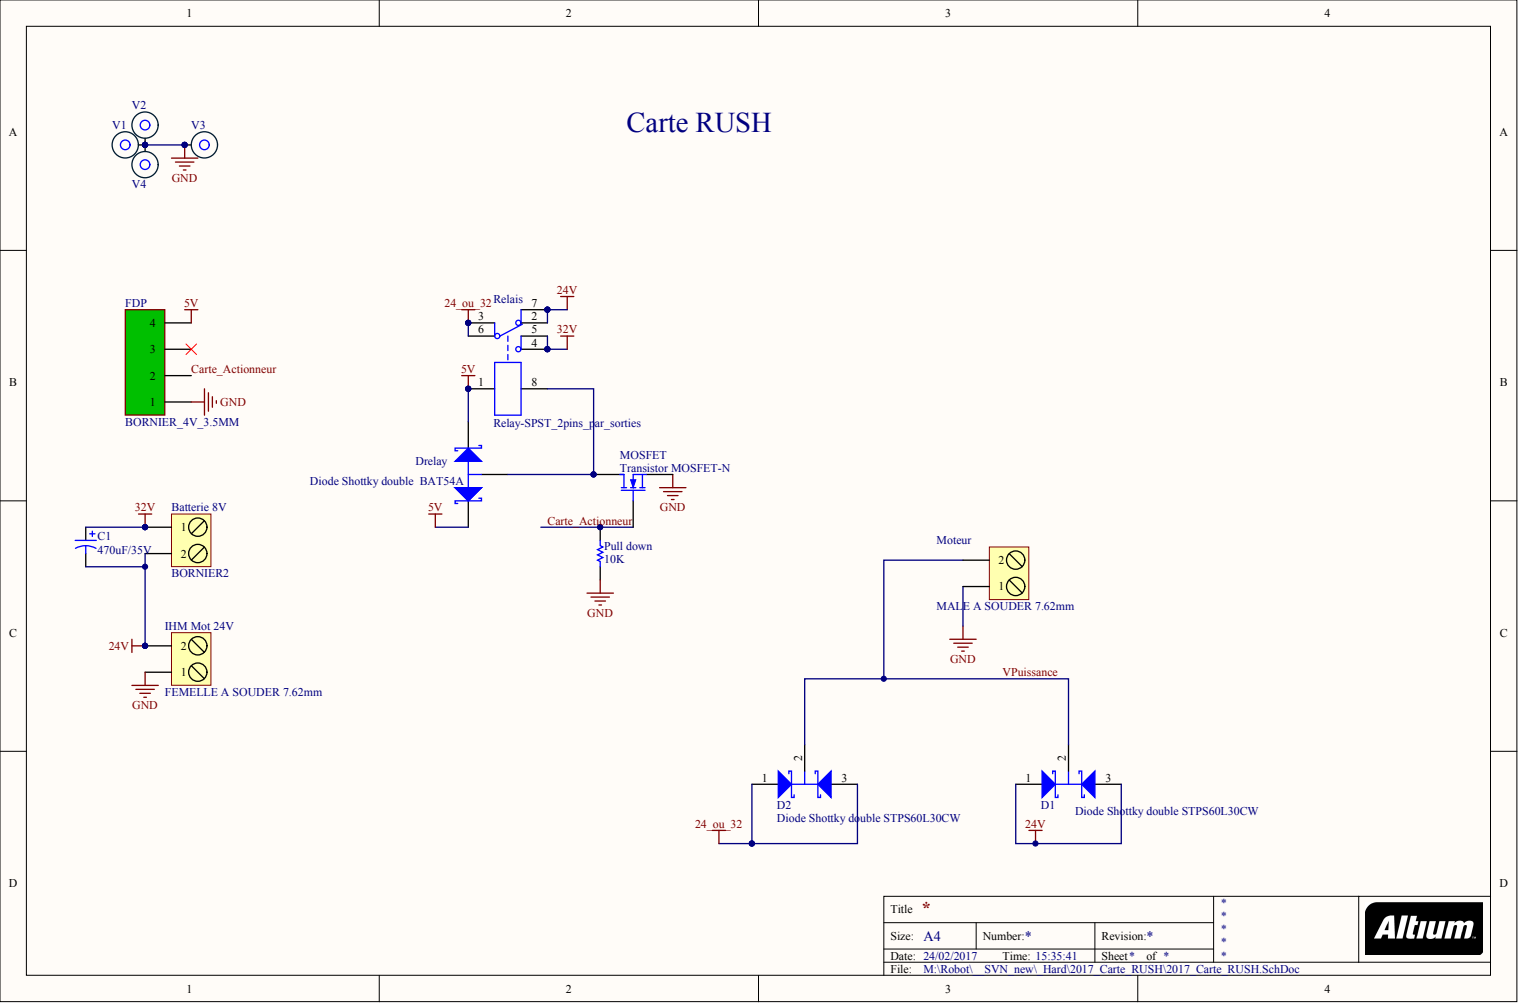
[picture p363: page 1]

* Title | * * * * *

Size: A4 | Number: * | Revision: *
Date: 24/02/2017 Time: 15:35:41 | | Sheet * of *

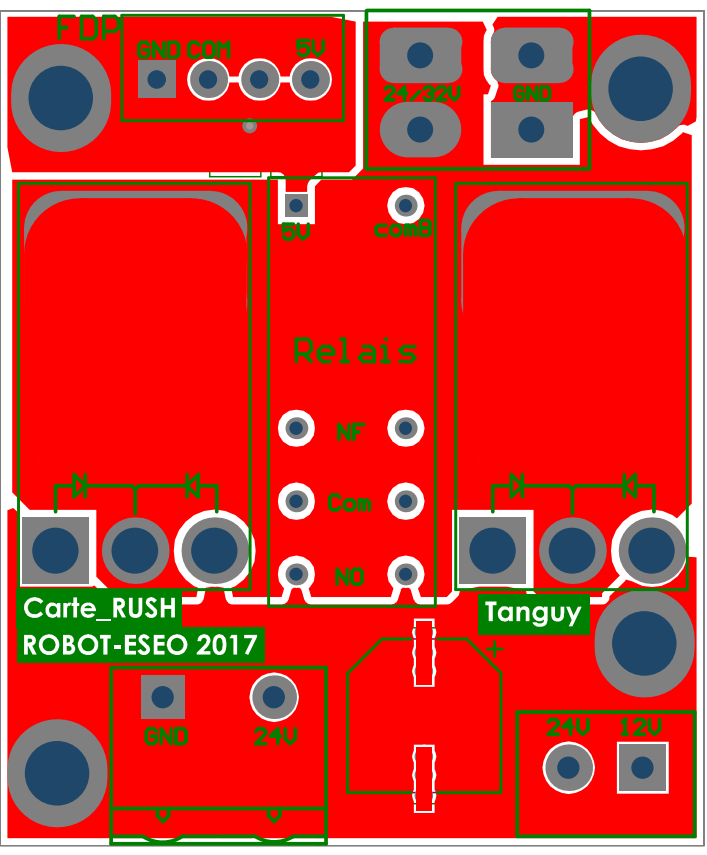
[picture p364: page 2]

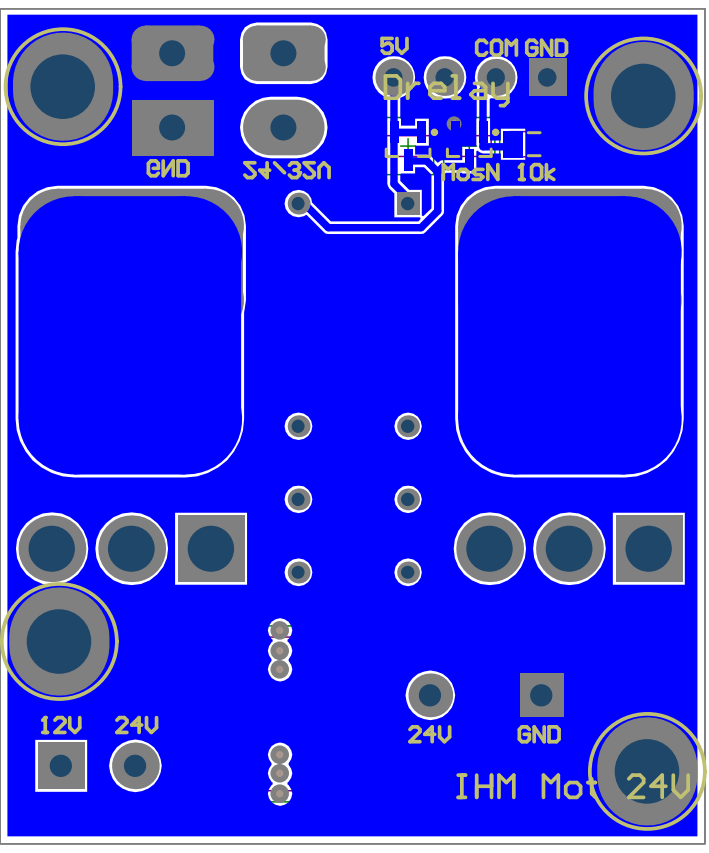
[picture p365: page 3]

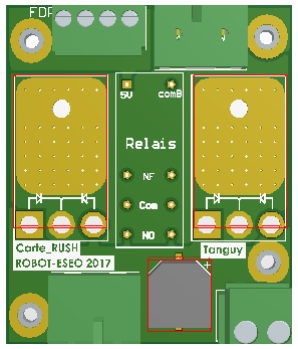
[picture p366: figure]

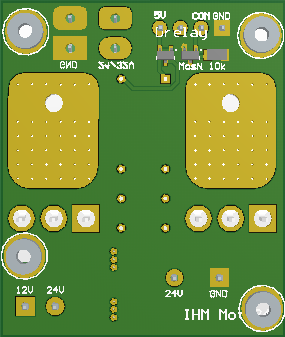
[picture p367: figure]
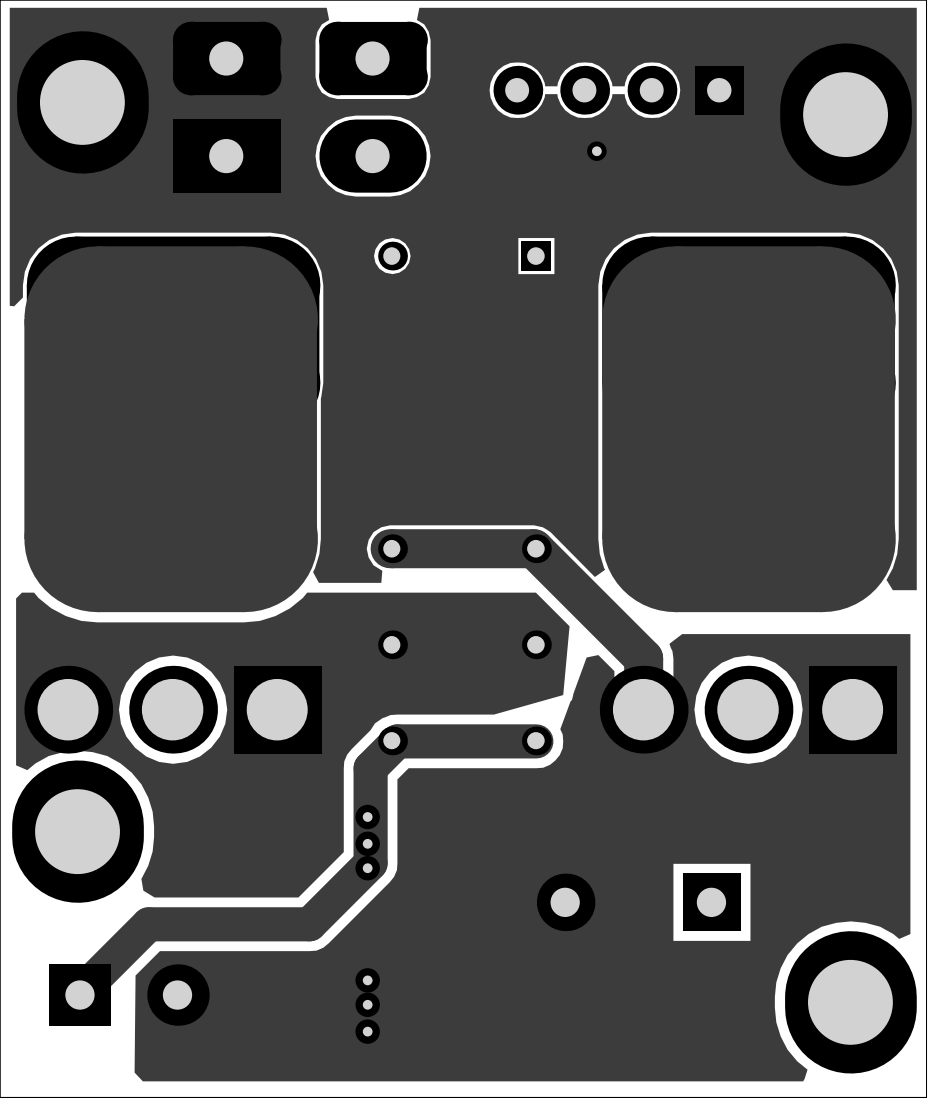
[picture p368: page 6]

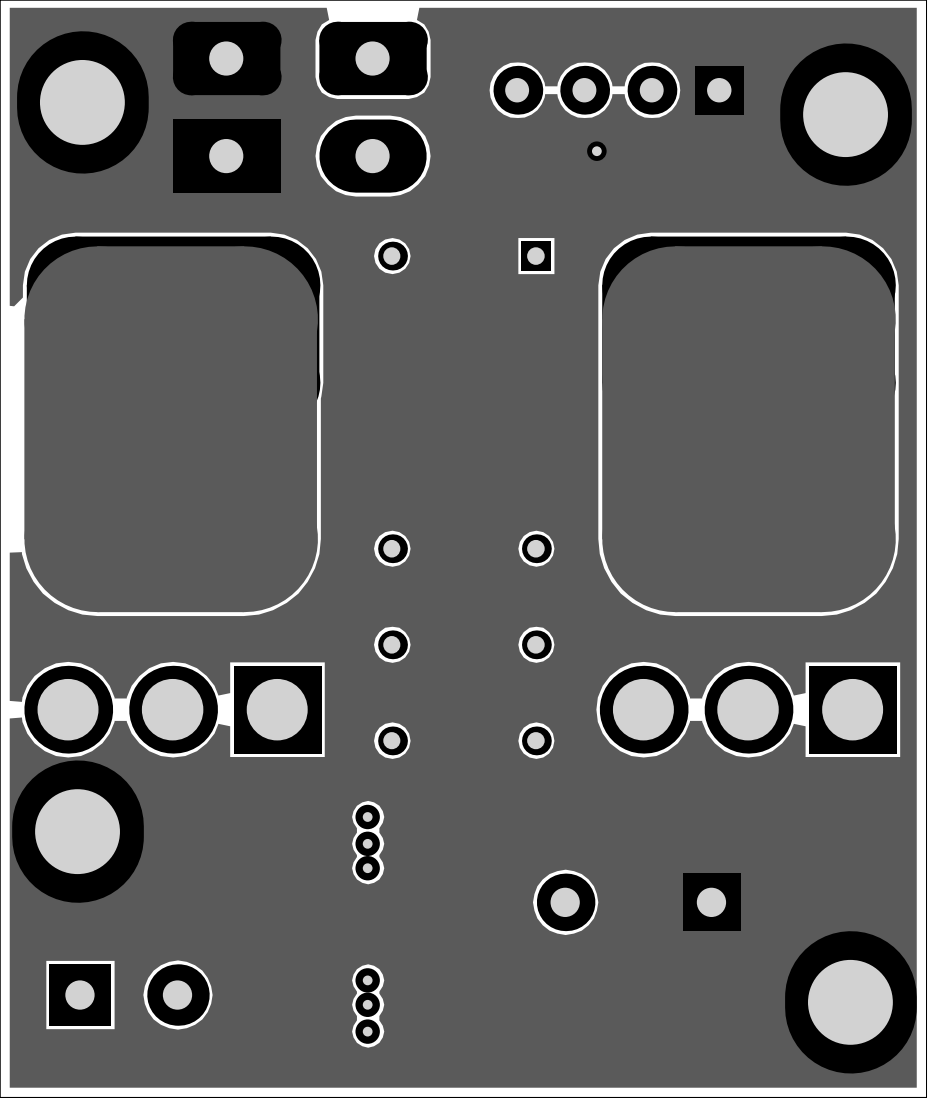
[picture p369: page 7]
