samuelpoiraud/robot/_Hard/2016_CARTE_4_MOSFET/2016_CARTE_4_MOFSET.PDF

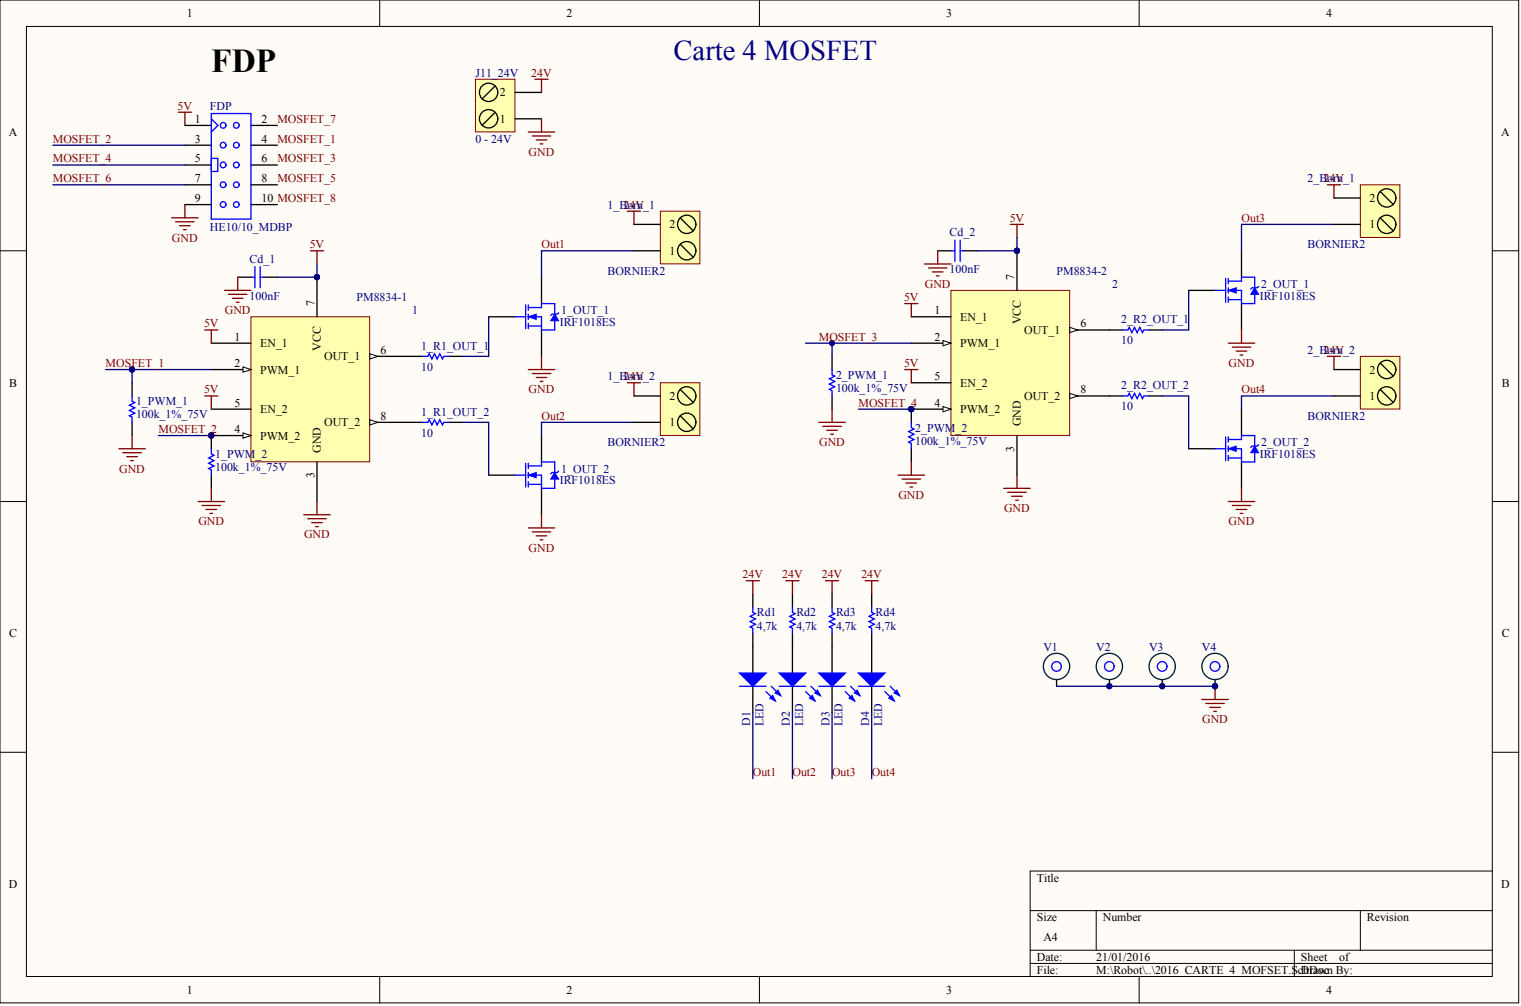
[picture p370: page 1]

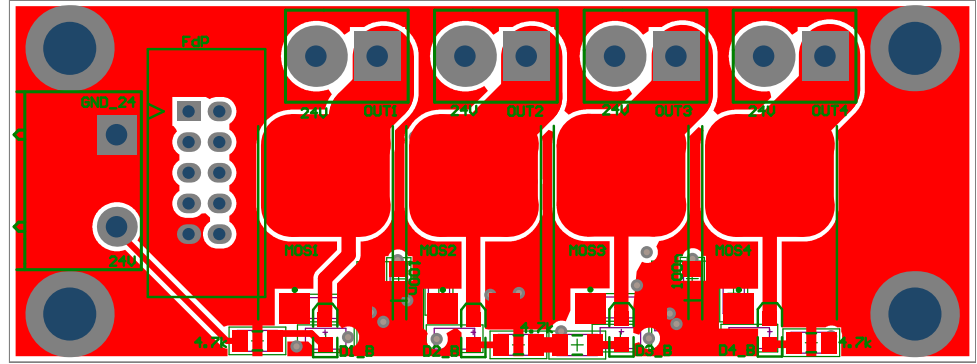
[picture p371: page 2]

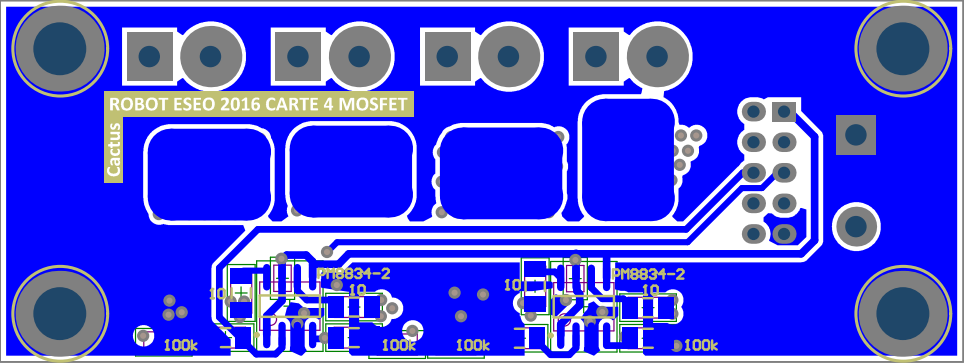
[picture p372: page 3]

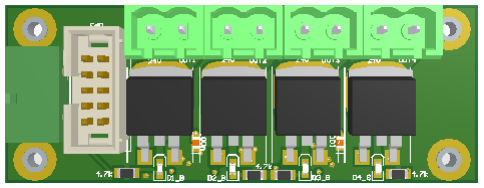
[picture p373: figure]

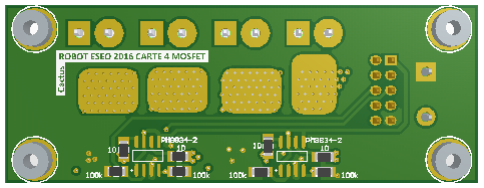
[picture p374: figure]
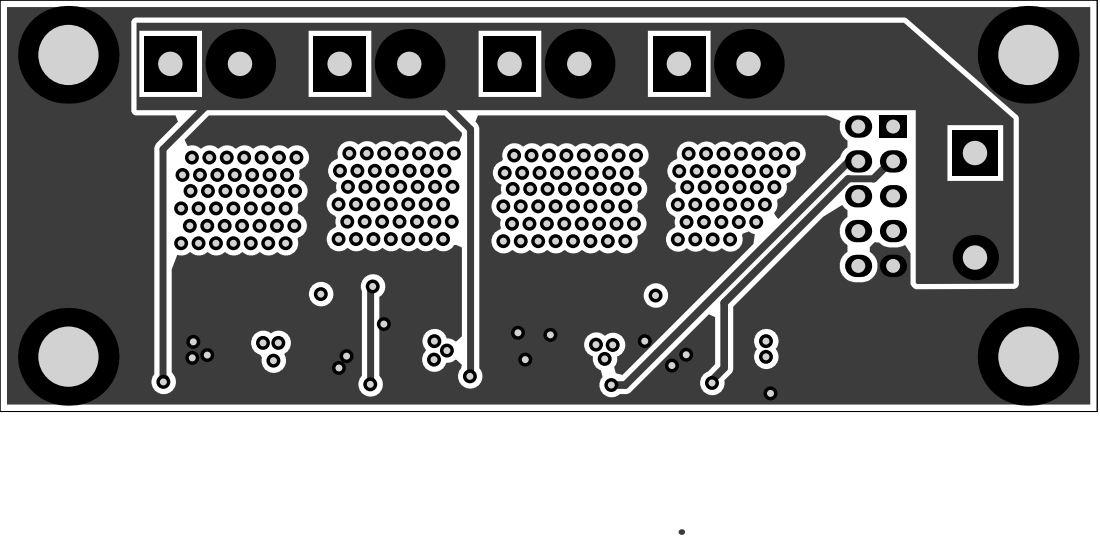
[picture p375: page 6]

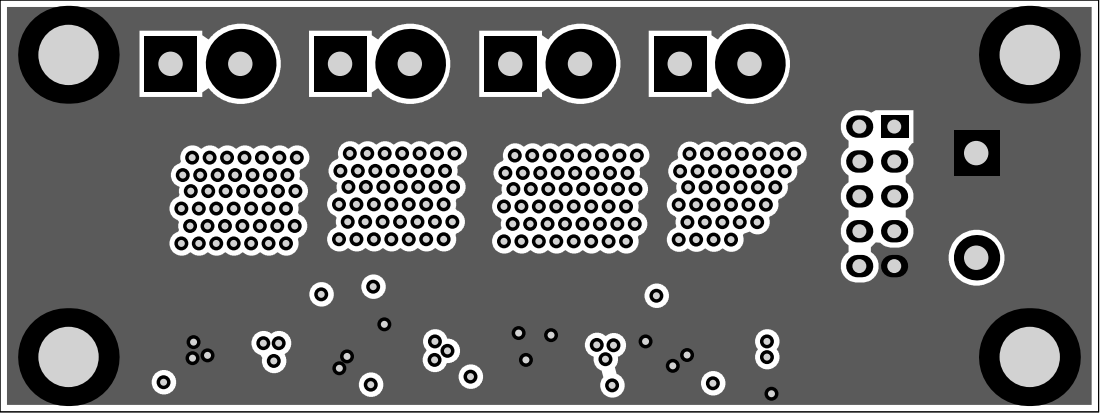
[picture p376: page 7]
