samuelpoiraud/robot/_Hard/2016_Carte_Batteries/2016_Carte_Batteries.PDF

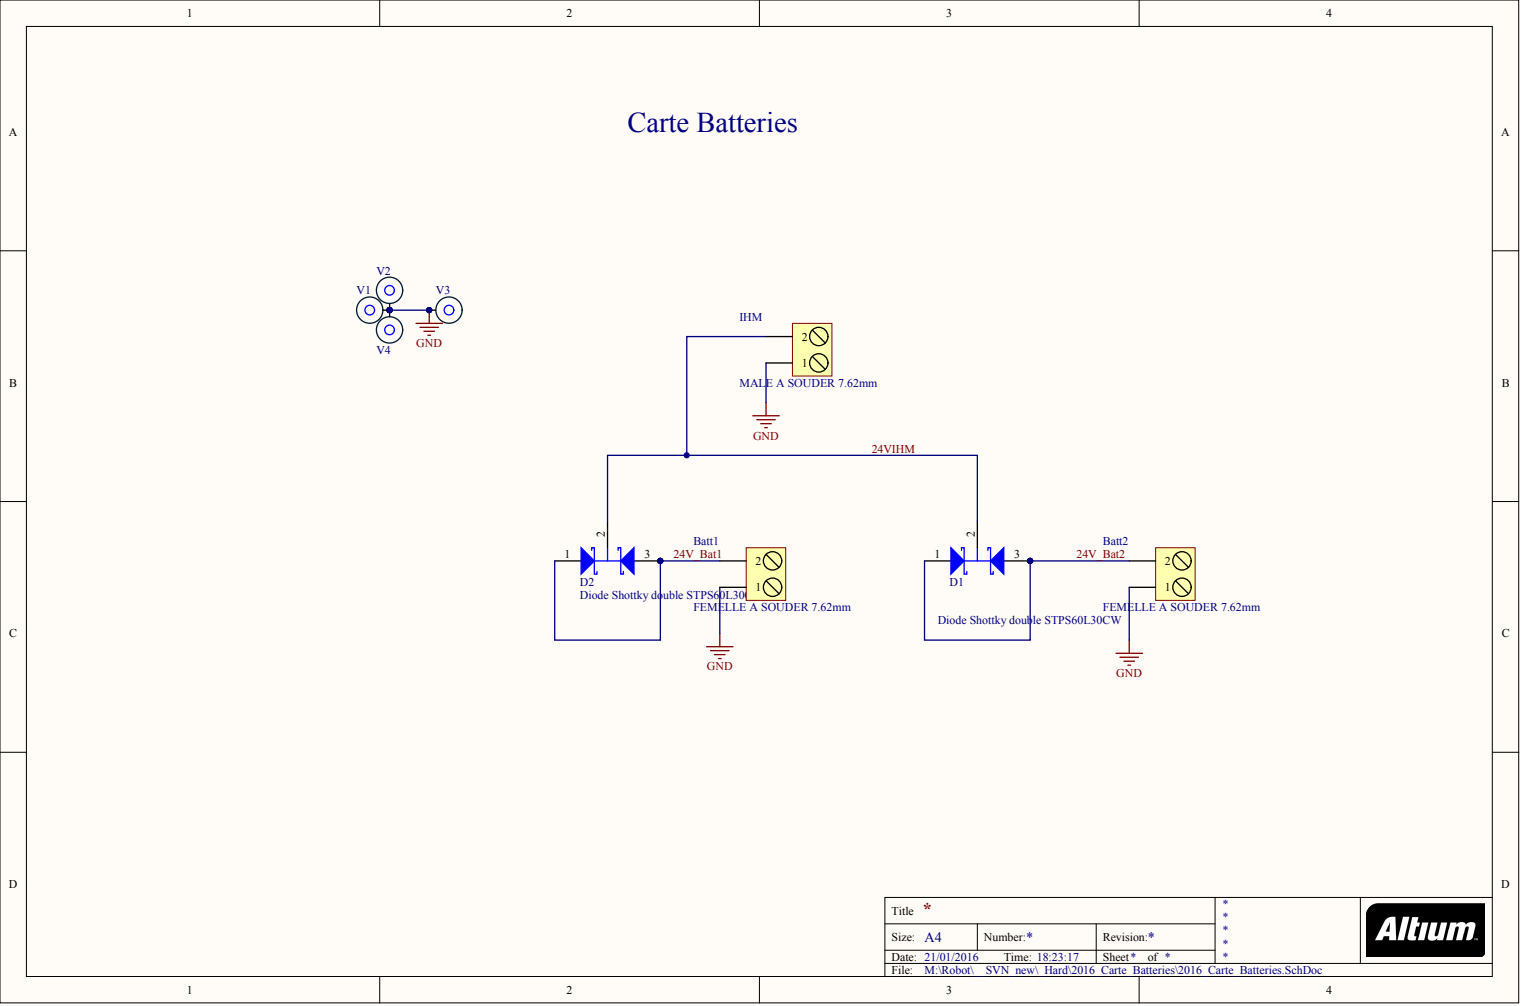
[picture p377: page 1]

Title * | * * * * *

Size: A4 | Number: * | Revision: *
Date: 21/01/2016 Time: 18:23:17 | | Sheet * of *

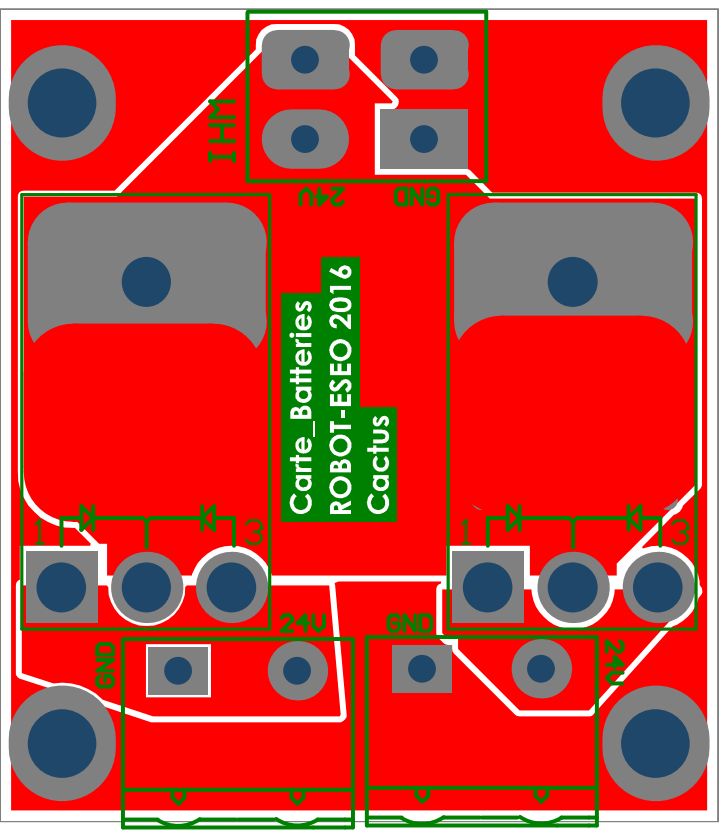
[picture p378: page 2]

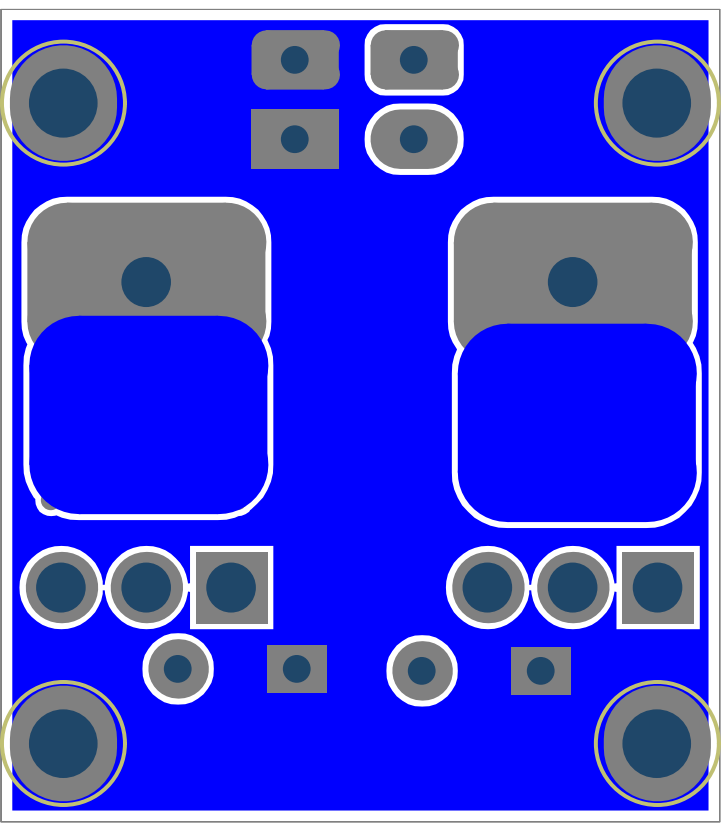
[picture p379: page 3]

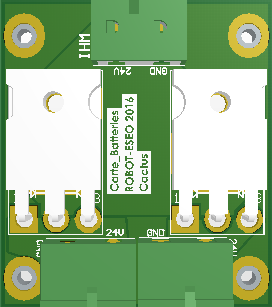
[picture p380: figure]

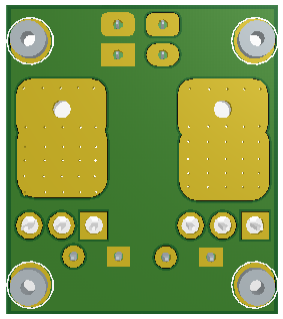
[picture p381: figure]
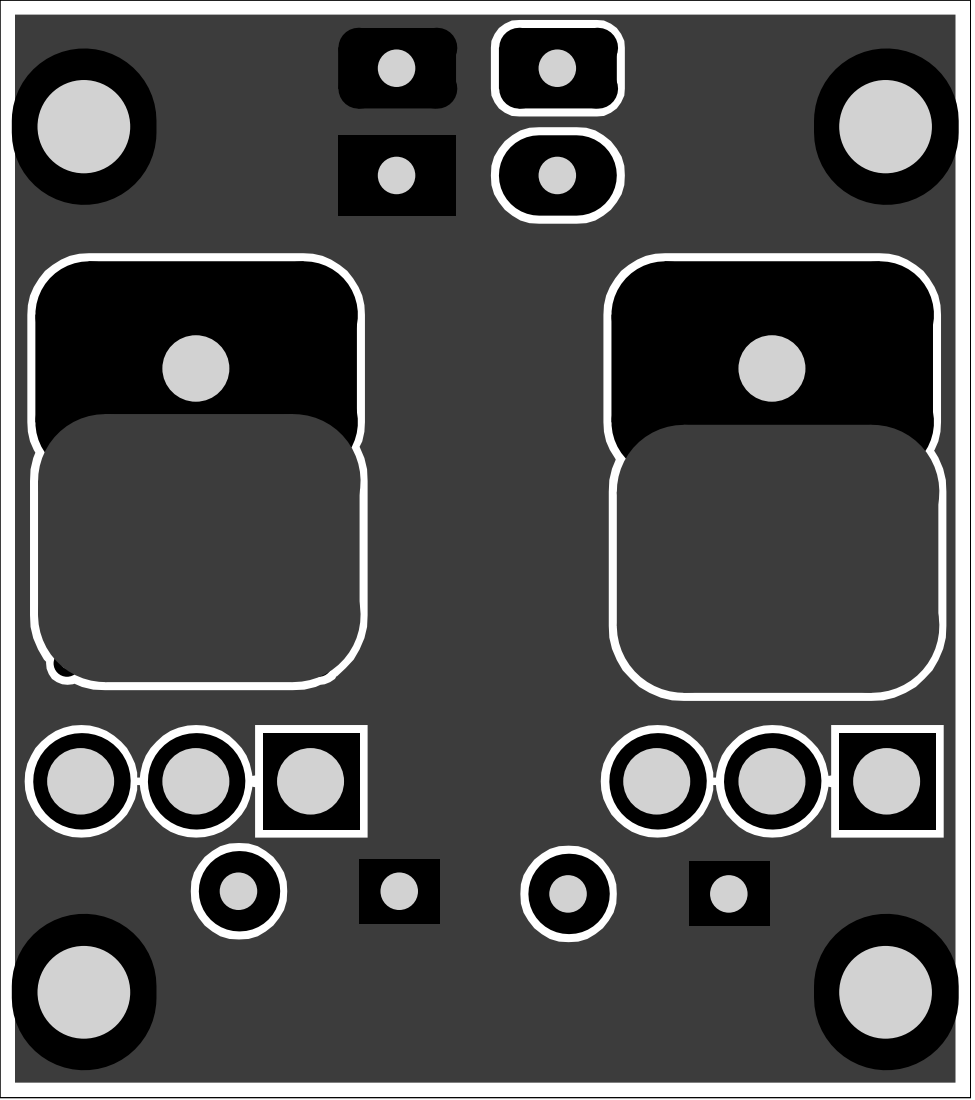
[picture p382: page 6]

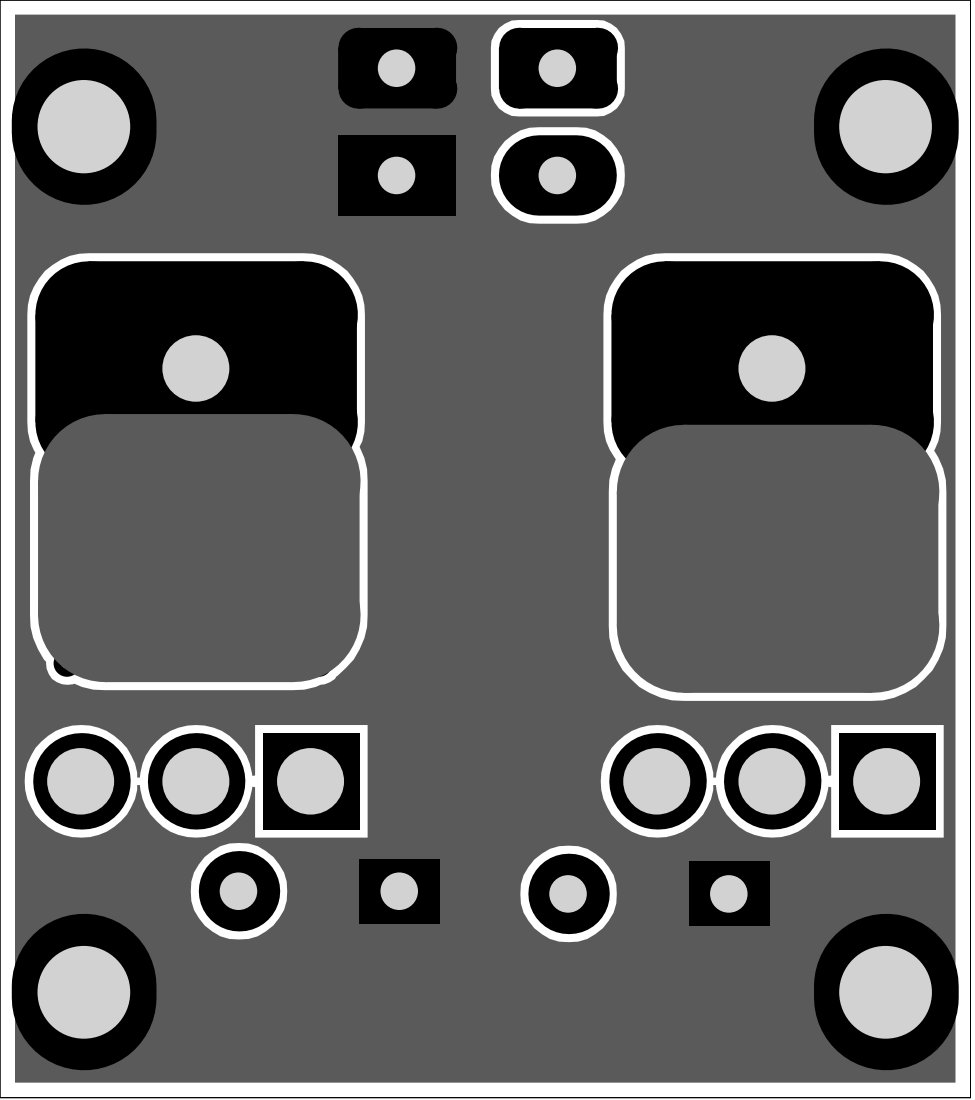
[picture p383: page 7]
