samuelpoiraud/robot/_Hard/2016_CARTE_MOFSET/2016_CARTE_MOFSET.PDF

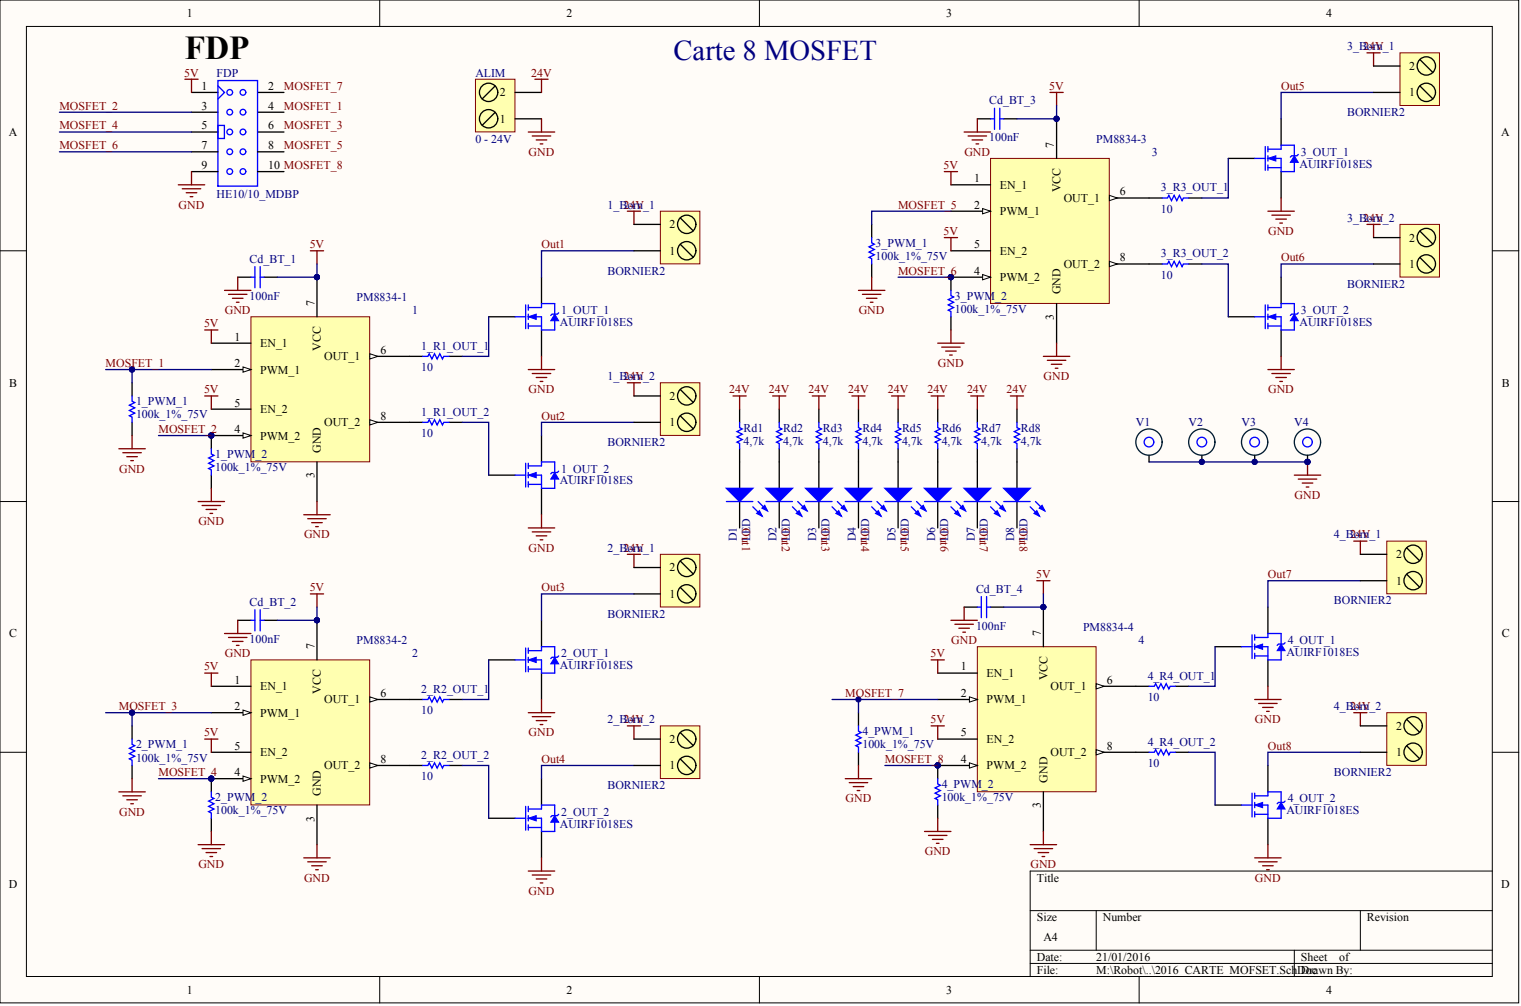
[picture p384: page 1]

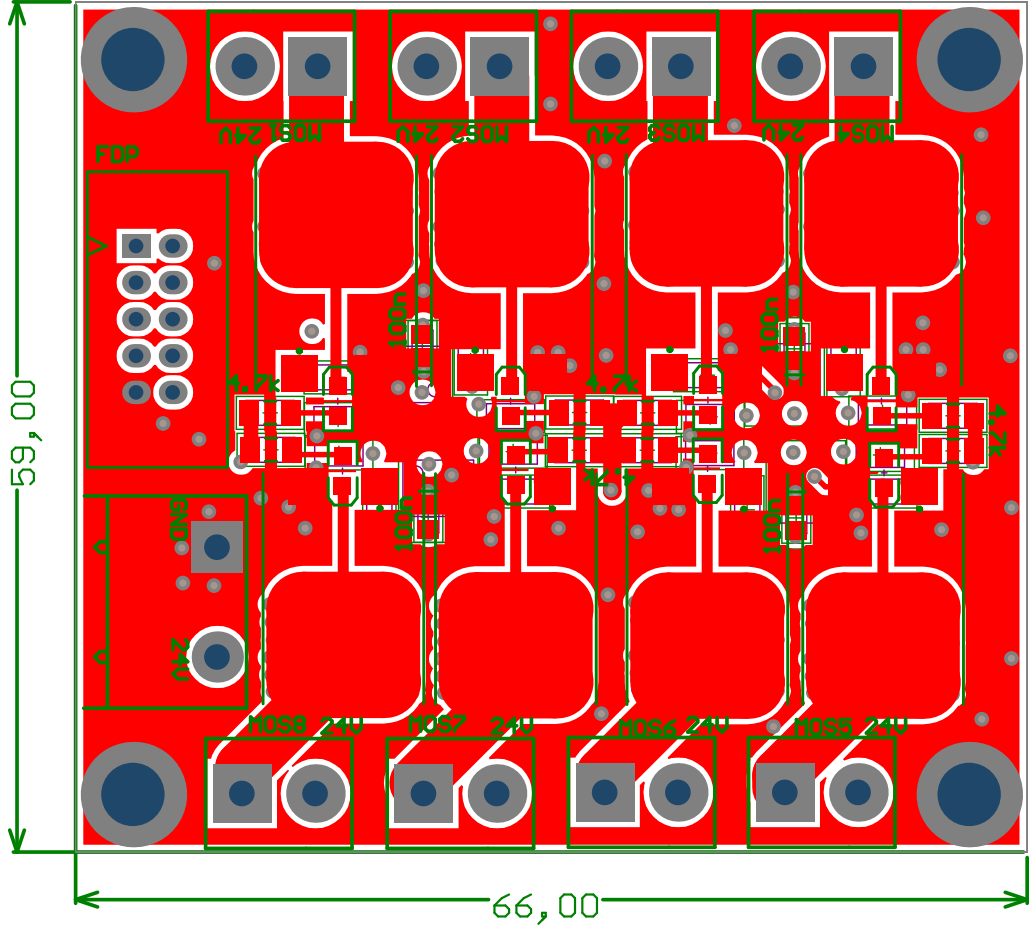
[picture p385: page 2]

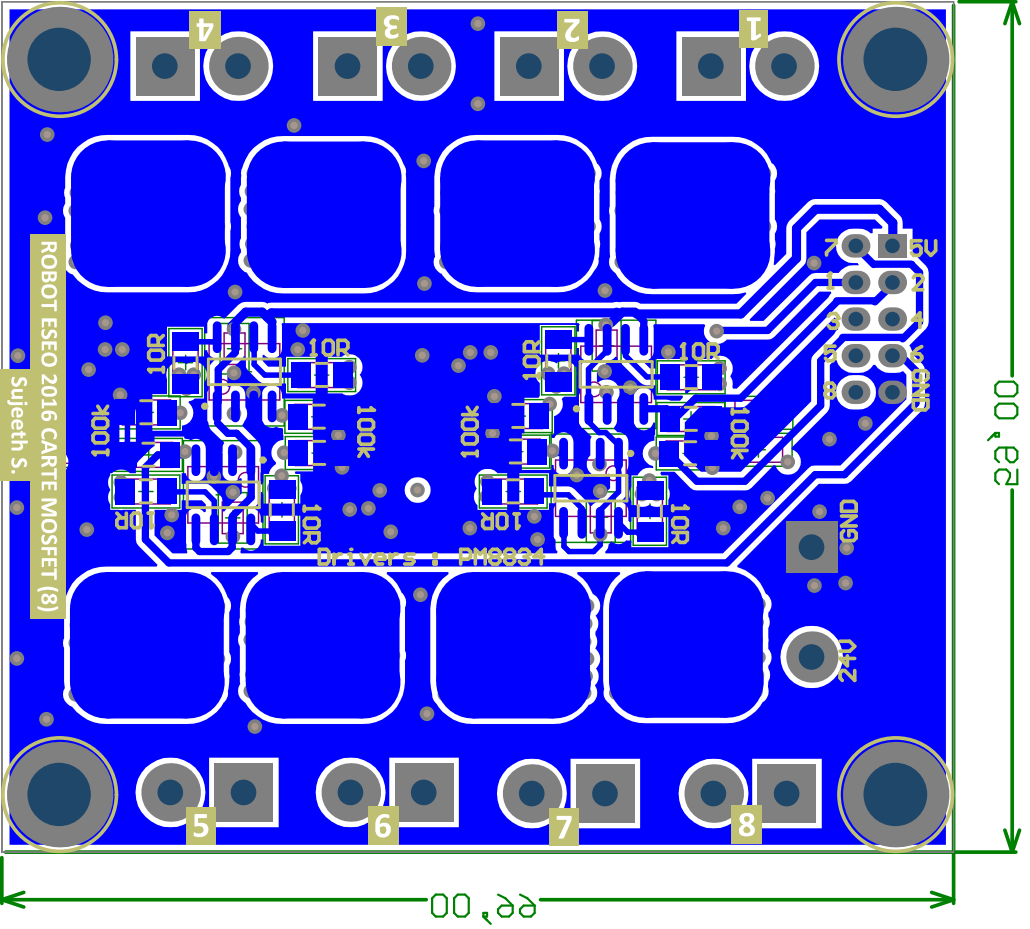
[picture p386: page 3]

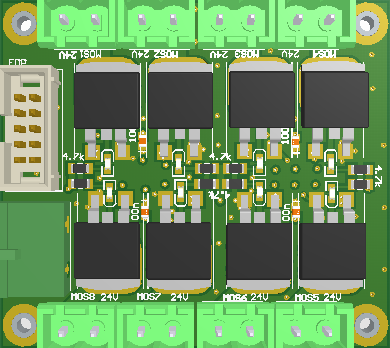
[picture p387: figure]

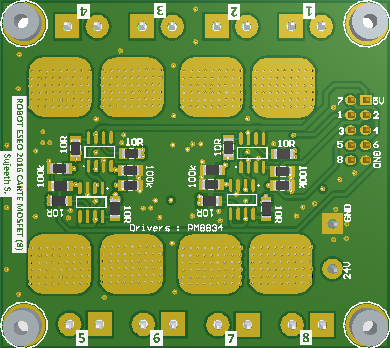
[picture p388: figure]
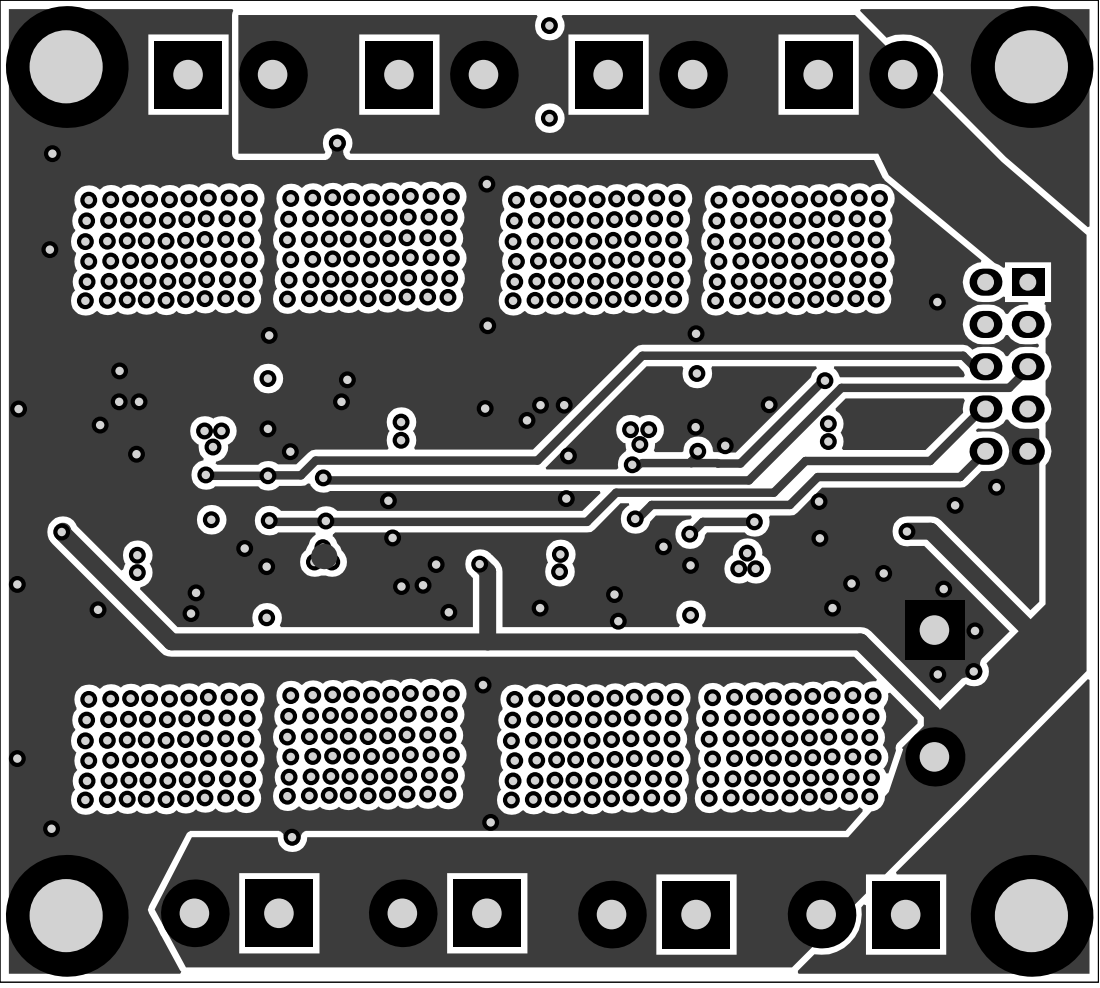
[picture p389: page 6]
