samuelpoiraud/robot/_Hard/2016_Matrice_LED/2016_Matrice_LED.PDF

Title * | **** *

Size: A4 | Number: * | Revision: *
Date: 21/01/2016 Time: 18:25:05 | | Sheet * of *
