samuelpoiraud/robot/_Hard/2016_Puissance/2016_CARTE_PUISSANCE.PDF

Condo Vref : possible de mettre 1uF.
