samuelpoiraud/robot/_Hard/2015_AdaptateurBluetooth/2015_AdaptateurBluetooth.PDF

* Title | **** *

Size: A4 | Number: * | Revision: *
Date: 26/10/2014 Time: 11:32:20 | | Sheet * of *
