samuelpoiraud/robot/_Hard/2015_BeaconEye/2015_BeaconEye.PDF

pullup dans le module

* Title | * * * * *

Size: A2 | Number: * | Revision: *
Date: 26/10/2014 Time: 12:14:20 | | Sheet * of *
