samuelpoiraud/robot/_Hard/2015_BeaconLed/2015_BeaconLed.PDF

* Title | * * * * *

Size: A4 | Number: * | Revision: *
Date: 26/10/2014 Time: 11:58:00 | | Sheet * of *
