samuelpoiraud/robot/_Hard/2015_CNC/2015_CNC.PDF

Capteurs fins de course

Sorties (ventilo / relais / moteurs)

9 | VBB 11

GND 12

Protection ESD / filtrage / tirages

Pull-up intégré dans ST1284

* Title | **** *

A3 Size: | * Number: | * Revision:
Date: 26/10/2014 Time: 11:58:18 | | Sheet * of *
