samuelpoiraud/robot/_Hard/2015_CONNECTEUR_BALISE/2015_CONNECTEUR_BALISE.PDF

* Title | * * * * *

Size: A4 | Number: * | Revision: *
Date: 26/10/2014 Time: 12:06:06 | | Sheet * of *
