samuelpoiraud/robot/_Hard/2014_YaourtPhone/2014_YaourtPhone.pdf

La carte YaourtPhone permet la communication entre nos robots ainsi qu'avec les balises.

pullup dans le module

Antenne : Plan de masse sous la piste qui rejoint l'antenne. Pas de plan de masse sous l'antenne

Fils soudés qui rejoignent la balise I

Le reset peut être rendu com

mun (xbee et RF) -> sur le fond de panier.
