samuelpoiraud/robot/_Hard/2014_carte_alim/2014_carte_alim.pdf

A modifier : réduire les empeintes des plots à souder ???
A modifier : réduire l'empeinte de Cd24VCDE

* Title | * * * * *

Size: A4 | Number: * | Revision: *

Date: 08/12/2013 Time: 19:30:51 | | Sheet * of *
