samuelpoiraud/robot/_Hard/2014_IHM/2014_IHM.pdf

* Title | * * * * *

Size: A4 | Number: * | Revision: *

Date: 08/12/2013 Time: 19:30:19 | | Sheet * of *
