samuelpoiraud/robot/_Hard/2014_MiniYaourtPhone/2014_MiniYaourtPhone.pdf

La carte YaourtPhone permet la communication entre nos robots ainsi qu'avec les balises.

pullup dans le module

Antenne :
Plan de masse sous la piste qui rejoint l'antenne.
Pas de plan de masse sous l'antenne
