samuelpoiraud/robot/_Hard/2014_YaourtPhone/OUT.PDF

La carte YaourtPhone permet la communication entre nos robots ainsi qu'avec les balises.

pullup dans le module

Antenne : Pas de plan de masse dessous

RIGOUREUSEMENT 16.4cm sans plan de masse en dessous

Fils soudés qui rejoignent la balise I

TODO : modifier emprunte en 2512

Le reset peut être rendu com

mun (xbee et RF) -> sur le fond de panier.
