samuelpoiraud/robot/_Hard/2013_carte_alim/2013_carte_alim.PDF

24VCMDp | JumperVcc

* Title | * * * * *

Size: A4 | Number: * | Revision: *

Date: 30/01/2013 Time: 17:18:11 | | Sheet * of *
