samuelpoiraud/robot/_Hard/2013_PerfXBee/2013_PerfXBee.PDF

Liaison entre 3V3OUT et VCCIO pour niveaux de sortie à 3V3.

pullup dans le module
