samuelpoiraud/robot/_Hard/2013_carte_alim/SCH_Dimensions.PDF

24VCMDp | JumperVcc

* Title | * * * * *

Size: A4 | Number: * | Revision: *

Date: 19/11/2011 Time: 01:36:41 | | Sheet * of *
