samuelpoiraud/robot/_Hard/2014_BallLauncher/simulation2.asc

C1: cap; 10µ
D2: diode
R1: res; 100
R2: res; 220k
R3: res; 100k
R4: res; 50k
R5: res; 100k
R6: res; 1000k
U1: LT1001
U2: LT1001
V1: voltage; 5v; Rser=0
V2: voltage; PWL(0 0 2 0 2.00001 3 6 3 6.00001 0)
Named nets: 0, 5V, 2V5
.tran 0 15s 0s 10ms
