samuelpoiraud/robot/_Hard/2014_BallLauncher/simulation.asc

C1: cap; 1µ
L1: ind; 1m
M1: nmos
M2: pmos
R2: res; 1k
R3: res; 5
R4: res; 100k
V1: voltage; 5V
V2: voltage; PULSE(0 3 0 100ns 100ns 8s 15s 3)
V3: voltage; 24V
Named nets: 0
.tran 30s
