samuelpoiraud/robot/(list of files, drawings)

Other design files:
_Hard/2011-2012/2012_Carte_Factorisee/2012_CARTE_FACTORISEE.PCBDOC
_Hard/2011-2012/2012_Carte_Factorisee/2012_CARTE_FACTORISEE.PRJPCB
_Hard/2011-2012/2012_Carte_Factorisee/2012_Carte_Factorisee.SchDoc
_Hard/2011-2012/2012_FDP/2012_FDP.PrjPcb
_Hard/2011-2012/2012_FDP/2012_FDP_Generic_Port_Act.SchDoc
_Hard/2011-2012/2012_FDP/2012_FDP_Generic_Port_Strat.SchDoc
_Hard/2011-2012/2012_FDP/2012_FDP_SCHEMA.SchDoc
_Hard/2011-2012/2012_Pannel.PcbDoc
_Hard/2011-2012/2012_PANNEL/Pannel.PrjPCB
_Hard/2011_Puissance/2011_CARTE_PUISSANCE.PCBDOC
_Hard/2011_Puissance/2011_CARTE_PUISSANCE.PRJPCB
_Hard/2011_Puissance/2011_CARTE_PUISSANCE.SchDoc
_Hard/2012-2013/extensionRaspberryPi/OriginalThibaut.PcbDoc
_Hard/2012-2013/extensionRaspberryPi/PCB2.PcbDoc
_Hard/2012-2013/extensionRaspberryPi/PCB_Project1.PrjPCB
_Hard/2012-2013/extensionRaspberryPi/Sheet1.SchDoc
_Hard/2012_Balise/2012_connectique_balise_fille/2012_BALISE_CONNECTIQUE_FILLE.PCBDOC
_Hard/2012_Balise/2012_connectique_balise_fille/2012_BALISE_CONNECTIQUE_FILLE.PRJPCB
_Hard/2012_Balise/2012_connectique_balise_fille/2012_BALISE_CONNECTIQUE_FILLE.SchDoc
_Hard/2012_Balise/2012_fdp_balise_mere/2012_fdp_balise_mere.PcbDoc
_Hard/2012_Balise/2012_fdp_balise_mere/2012_fdp_balise_mere.SchDoc
_Hard/2012_Balise/2012_fdp_balise_mere/2012_fdp_balise_mere_project.PrjPcb
_Hard/2012_Balise/2012_Recepteur_IR_balise_fille/recepteur.PcbDoc
_Hard/2012_Balise/2012_Recepteur_IR_balise_fille/recepteur.PrjPCB
_Hard/2012_Balise/2012_Recepteur_IR_balise_fille/recepteur.SchDoc
_Hard/2012_Balise/Emetteur_IR_et_US/2012_BALISE_CARTE_EMETTEUR.PCBDOC
_Hard/2012_Balise/Emetteur_IR_et_US/2012_BALISE_CARTE_EMETTEUR.SchDoc
_Hard/2012_Balise/Emetteur_IR_et_US/Recepteur_IR/2012_BALISE_CARTE_PRINCIPALE.PRJPCB
_Hard/2012_Balise/Emetteur_IR_et_US/Recepteur_IR/2012_BALISE_CARTE_PRINCIPALE.SchDoc
_Hard/2012_Balise/Recepteur_IR/2012_BALISE_CARTE_PRINCIPALE.PRJPCB
_Hard/2012_Balise/Recepteur_IR/2012_BALISE_CARTE_PRINCIPALE.SchDoc
_Hard/2012_Balise/Recepteur_US/2012_BALISE_CARTE_RECEPTEUR.PCBDOC
_Hard/2012_Balise/Recepteur_US/2012_BALISE_CARTE_RECEPTEUR.PRJPCB
_Hard/2012_Balise/Recepteur_US/2012_BALISE_CARTE_RECEPTEUR.SchDoc
_Hard/2012_Balise/Recepteur_US/PROTECTION_BUS_CAN.SchDoc
_Hard/2012_PerfUSB/2012_PerfUSB.PcbDoc
_Hard/2012_PerfUSB/2012_PerfUSB.PrjPCB
_Hard/2012_PerfUSB/2012_PerfUSB.SchDoc
_Hard/2012_PerfUSB/FTDI_PCB_Public.PcbLib
_Hard/2013_carte_alim/2012_carte_alim_SCHEMA.SchDoc
_Hard/2013_Carte_Factorisee/2013_CARTE_FACTORISEE.PCBDOC
_Hard/2013_Carte_Factorisee/2013_CARTE_FACTORISEE.PRJPCB
_Hard/2013_Carte_Factorisee/2013_Carte_Factorisee.SchDoc
_Hard/2013_fdp_banc_de_test/2013_fdp_banc_de_test.PcbDoc
_Hard/2013_fdp_banc_de_test/2013_fdp_banc_de_test.PrjPcb
_Hard/2013_fdp_banc_de_test/2013_fdp_banc_de_test.SchDoc
_Hard/2013_Pannel.PcbDoc
_Hard/2013_PANNEL/Pannel.PrjPCB
_Hard/2013_PerfXBee/2013_PerfXBee.PcbDoc
_Hard/2013_PerfXBee/2013_PerfXBee.PrjPCB
_Hard/2013_PerfXBee/2013_PerfXBee.SchDoc
_Hard/2013_Puissance_L203/2013_CARTE_PUISSANCE.PCBDOC
_Hard/2013_Puissance_L203/2013_CARTE_PUISSANCE.PRJPCB
_Hard/2013_Puissance_L203/2013_CARTE_PUISSANCE.SchDoc
_Hard/2014_AlimBeaconEye/2014_AlimBeaconEye.PCBDOC
_Hard/2014_AlimBeaconEye/2014_AlimBeaconEye.PRJPCB
_Hard/2014_AlimBeaconEye/2014_AlimBeaconEye.SchDoc
_Hard/2014_Balise/2014_BALISE_CARTE_EMETTEUR.PCBDOC
_Hard/2014_Balise/2014_BALISE_CARTE_EMETTEUR.PRJPCB
_Hard/2014_Balise/2014_BALISE_CARTE_EMETTEUR.SchDoc
_Hard/2014_BallLauncher/2014_BallLauncher.SchDoc
_Hard/2014_BeaconEye/2014_BeaconEye.PRJPCB
_Hard/2014_BeaconEye/2014_BeaconEye.SchDoc
_Hard/2014_carte_alim/2014_carte_alim.PcbDoc
_Hard/2014_carte_alim/2014_carte_alim.PrjPcb
_Hard/2014_carte_alim/2014_carte_alim.SchDoc
_Hard/2014_ConnecteurChargeur/2014_ConnecteurChargeur.PCBDOC
_Hard/2014_ConnecteurChargeur/2014_ConnecteurChargeur.PRJPCB
_Hard/2014_ConnecteurChargeur/2014_ConnecteurChargeur.SchDoc
_Hard/2014_FDP/2014_FDP.PrjPcb
_Hard/2014_FDP/2014_FDP_ACTIONNEUR.SchDoc
_Hard/2014_FDP/2014_FDP_PROPULSION.SchDoc
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
