samuelpoiraud/robot/3_Actionneur/CurrentSoftwareSTM32/config/config_small/config_pin.h

/*
 *  Club Robot ESEO 2013 - 2014
 *
 *  $Id$
 *
 *  Package : Carte Actionneur
 *  Description : Configuration des pins
 *  Auteur : Jacen, Alexis
 */

#ifndef SMALL_CONFIG_PIN_H
#define SMALL_CONFIG_PIN_H



////////////////////////////////////////////////////////////////////////////////////
//--------------------------------------PORT A------------------------------------//
////////////////////////////////////////////////////////////////////////////////////
	#define PORT_IO_A_0			PORT_IO_INPUT
	#define PORT_OPT_A_0		PORT_OPT_NO_PULL
		#define BUTTON0_PORT		GPIOA->IDR0

	#define PORT_IO_A_1			PORT_IO_INPUT
	#define PORT_OPT_A_1		PORT_OPT_NO_PULL
		//

	#define PORT_IO_A_2			PORT_IO_INPUT
	#define PORT_OPT_A_2		PORT_OPT_NO_PULL
		// AX12/U2TX

	#define PORT_IO_A_3			PORT_IO_INPUT
	#define PORT_OPT_A_3		PORT_OPT_NO_PULL
		// AX12/U2RX

	#define PORT_IO_A_4			PORT_IO_INPUT
	#define PORT_OPT_A_4		PORT_OPT_NO_PULL
		//

	#define PORT_IO_A_5			PORT_IO_OUTPUT
	#define PORT_OPT_A_5		PORT_OPT_NO_PULL
		#define RX24_DIRECTION_PORT_RX24 GPIOA,GPIO_Pin_5

	#define PORT_IO_A_6			PORT_IO_INPUT
	#define PORT_OPT_A_6		PORT_OPT_NO_PULL
		//

	#define PORT_IO_A_7			PORT_IO_INPUT
	#define PORT_OPT_A_7		PORT_OPT_NO_PULL
		//

	#define PORT_IO_A_8			PORT_IO_INPUT
	#define PORT_OPT_A_8		PORT_OPT_PULL_UP
		//

	#define PORT_IO_A_9			PORT_IO_INPUT
	#define PORT_OPT_A_9		PORT_OPT_NO_PULL
		// USB

	#define PORT_IO_A_10		PORT_IO_INPUT
	#define PORT_OPT_A_10		PORT_OPT_NO_PULL
		// USB

	#define PORT_IO_A_11		PORT_IO_INPUT
	#define PORT_OPT_A_11		PORT_OPT_NO_PULL
		// USB

	#define PORT_IO_A_12		PORT_IO_INPUT
	#define PORT_OPT_A_12		PORT_OPT_NO_PULL
		// USB

	#define PORT_IO_A_13		PORT_IO_INPUT
	#define PORT_OPT_A_13		PORT_OPT_NO_PULL
		// Programmation

	#define PORT_IO_A_14		PORT_IO_INPUT
	#define PORT_OPT_A_14		PORT_OPT_NO_PULL
		// Programmation

	#define PORT_IO_A_15		PORT_IO_INPUT
	#define PORT_OPT_A_15		PORT_OPT_NO_PULL

////////////////////////////////////////////////////////////////////////////////////
//--------------------------------------PORT B------------------------------------//
////////////////////////////////////////////////////////////////////////////////////
	#define PORT_IO_B_0			PORT_IO_INPUT
	#define PORT_OPT_B_0		PORT_OPT_NO_PULL

	#define PORT_IO_B_1			PORT_IO_INPUT
	#define PORT_OPT_B_1		PORT_OPT_NO_PULL

	#define PORT_IO_B_2			PORT_IO_INPUT
	#define PORT_OPT_B_2		PORT_OPT_NO_PULL
		//

	#define PORT_IO_B_3			PORT_IO_INPUT
	#define PORT_OPT_B_3		PORT_OPT_NO_PULL
		// Programmation

	#define PORT_IO_B_4			PORT_IO_OUTPUT
	#define PORT_OPT_B_4		PORT_OPT_PULL_DOWN
		#define CS_LASER_ELEVATOR_PORT	GPIOB
		#define CS_LASER_ELEVATOR_PIN	GPIO_Pin_4

	#define PORT_IO_B_5			PORT_IO_INPUT
	#define PORT_OPT_B_5		PORT_OPT_NO_PULL
		//

	#define PORT_IO_B_6			PORT_IO_INPUT
	#define PORT_OPT_B_6		PORT_OPT_NO_PULL
		// U1TX

	#define PORT_IO_B_7			PORT_IO_INPUT
	#define PORT_OPT_B_7		PORT_OPT_NO_PULL
		// U1RX

	#define PORT_IO_B_8			PORT_IO_OUTPUT
	#define PORT_OPT_B_8		PORT_OPT_NO_PULL
		#define I_AM_READY			GPIOB,GPIO_Pin_8

	#define PORT_IO_B_9			PORT_IO_OUTPUT
	#define PORT_OPT_B_9		PORT_OPT_NO_PULL
		#define MOSFET_1_PIN		GPIOB,GPIO_Pin_9

	#define PORT_IO_B_10		PORT_IO_INPUT
	#define PORT_OPT_B_10		PORT_OPT_NO_PULL
		//#define MOSFET_2_PIN		GPIOB,GPIO_Pin_9

	#define PORT_IO_B_11		PORT_IO_OUTPUT
	#define PORT_OPT_B_11		PORT_OPT_NO_PULL
		#define AX12_DIRECTION_PORT_AX12	GPIOB,GPIO_Pin_11

	#define PORT_IO_B_12		PORT_IO_INPUT
	#define PORT_OPT_B_12		PORT_OPT_NO_PULL
		//#define MOSFET_3_PIN		GPIOB,GPIO_Pin_9

	#define PORT_IO_B_13		PORT_IO_INPUT
	#define PORT_OPT_B_13		PORT_OPT_NO_PULL
		//#define MOSFET_4_PIN		GPIOB,GPIO_Pin_9

	#define PORT_IO_B_14		PORT_IO_INPUT
	#define PORT_OPT_B_14		PORT_OPT_NO_PULL
		//#define MOSFET_5_PIN		GPIOB,GPIO_Pin_9

	#define PORT_IO_B_15		PORT_IO_INPUT
	#define PORT_OPT_B_15		PORT_OPT_NO_PULL
		//#define MOSFET_6_PIN		GPIOB,GPIO_Pin_9


////////////////////////////////////////////////////////////////////////////////////
//--------------------------------------PORT C------------------------------------//
////////////////////////////////////////////////////////////////////////////////////
	#define PORT_IO_C_0			PORT_IO_INPUT
	#define PORT_OPT_C_0		PORT_OPT_NO_PULL
		//

	#define PORT_IO_C_1			PORT_IO_INPUT
	#define PORT_OPT_C_1		PORT_OPT_NO_PULL
		//

	#define PORT_IO_C_2			PORT_IO_INPUT
	#define PORT_OPT_C_2		PORT_OPT_NO_PULL
		//

	#define PORT_IO_C_3			PORT_IO_INPUT
	#define PORT_OPT_C_3		PORT_OPT_NO_PULL
		//

	#define PORT_IO_C_4			PORT_IO_INPUT
	#define PORT_OPT_C_4		PORT_OPT_NO_PULL
		//

	#define PORT_IO_C_5			PORT_IO_INPUT
	#define PORT_OPT_C_5		PORT_OPT_NO_PULL
		//

	#define PORT_IO_C_6			PORT_IO_INPUT
	#define PORT_OPT_C_6		PORT_OPT_NO_PULL
		//PWM1

	#define PORT_IO_C_7			PORT_IO_INPUT
	#define PORT_OPT_C_7		PORT_OPT_NO_PULL
		//PWM2

	#define PORT_IO_C_8			PORT_IO_INPUT
	#define PORT_OPT_C_8		PORT_OPT_NO_PULL
		//

	#define PORT_IO_C_9			PORT_IO_INPUT
	#define PORT_OPT_C_9		PORT_OPT_PULL_UP
		//

	#define PORT_IO_C_10		PORT_IO_OUTPUT
	#define PORT_OPT_C_10		PORT_OPT_NO_PULL
		#define SMALL_POMPE_DISPOSE_SENS	GPIOC,GPIO_Pin_10

	#define PORT_IO_C_11		PORT_IO_OUTPUT
	#define PORT_OPT_C_11		PORT_OPT_NO_PULL
		#define SMALL_POMPE_PRISE_SENS	GPIOC,GPIO_Pin_11

	#define PORT_IO_C_12		PORT_IO_OUTPUT
	#define PORT_OPT_C_12		PORT_OPT_NO_PULL
		#define SMALL_COLOR_I2C_ACTIVATE	GPIOC,GPIO_Pin_12

	#define PORT_IO_C_13		PORT_IO_INPUT
	#define PORT_OPT_C_13		PORT_OPT_NO_PULL
		#define PORT_ROBOT_ID  		GPIOC->IDR13

	#define PORT_IO_C_14		PORT_IO_INPUT
	#define PORT_OPT_C_14		PORT_OPT_NO_PULL
		// OSC32_in

	#define PORT_IO_C_15		PORT_IO_INPUT
	#define PORT_OPT_C_15		PORT_OPT_NO_PULL
		// OSC32_out

////////////////////////////////////////////////////////////////////////////////////
//--------------------------------------PORT D------------------------------------//
////////////////////////////////////////////////////////////////////////////////////
	#define PORT_IO_D_0			PORT_IO_INPUT
	#define PORT_OPT_D_0		PORT_OPT_NO_PULL
		// CAN_RX

	#define PORT_IO_D_1			PORT_IO_INPUT
	#define PORT_OPT_D_1		PORT_OPT_NO_PULL
		// CAN_TX

	#define PORT_IO_D_2			PORT_IO_INPUT
	#define PORT_OPT_D_2		PORT_OPT_NO_PULL


	#define PORT_IO_D_3			PORT_IO_INPUT
	#define PORT_OPT_D_3		PORT_OPT_NO_PULL
		//

	#define PORT_IO_D_4			PORT_IO_INPUT
	#define PORT_OPT_D_4		PORT_OPT_NO_PULL
		//

	#define PORT_IO_D_5			PORT_IO_INPUT
	#define PORT_OPT_D_5		PORT_OPT_NO_PULL
		// Usb LED red

	#define PORT_IO_D_6			PORT_IO_INPUT
	#define PORT_OPT_D_6		PORT_OPT_NO_PULL
		//

	#define PORT_IO_D_7			PORT_IO_INPUT
	#define PORT_OPT_D_7		PORT_OPT_NO_PULL
		//

	#define PORT_IO_D_8			PORT_IO_INPUT
	#define PORT_OPT_D_8		PORT_OPT_NO_PULL
		// U3TX

	#define PORT_IO_D_9			PORT_IO_INPUT
	#define PORT_OPT_D_9		PORT_OPT_NO_PULL
		// U3RX

	#define PORT_IO_D_10		PORT_IO_OUTPUT
	#define PORT_OPT_D_10		PORT_OPT_NO_PULL
		#define LED_ERROR 			GPIOD,GPIO_Pin_10

	#define PORT_IO_D_11		PORT_IO_OUTPUT
	#define PORT_OPT_D_11		PORT_OPT_NO_PULL
		#define LED_SELFTEST 		GPIOD,GPIO_Pin_11

	#define PORT_IO_D_12		PORT_IO_OUTPUT
	#define PORT_OPT_D_12		PORT_OPT_NO_PULL
		#define LED_RUN  			GPIOD,GPIO_Pin_12 // Led verte carte STM
		#define LED_GREEN 			LED_RUN

	#define PORT_IO_D_13		PORT_IO_OUTPUT
	#define PORT_OPT_D_13		PORT_OPT_NO_PULL
		#define LED_CAN  			GPIOD,GPIO_Pin_13 // Led orange carte STM
		#define LED_ORANGE			LED_CAN

	#define PORT_IO_D_14		PORT_IO_OUTPUT
	#define PORT_OPT_D_14		PORT_OPT_NO_PULL
		#define LED_UART 			GPIOD,GPIO_Pin_14 // Led rouge carte STM
		#define LED_ROUGE			LED_UART

	#define PORT_IO_D_15		PORT_IO_OUTPUT
	#define PORT_OPT_D_15		PORT_OPT_NO_PULL
		#define LED_USER 			GPIOD,GPIO_Pin_15 // Led bleue carte STM
		#define LED_BLEU			LED_USER


////////////////////////////////////////////////////////////////////////////////////
//--------------------------------------PORT E------------------------------------//
////////////////////////////////////////////////////////////////////////////////////
	#define PORT_IO_E_0			PORT_IO_INPUT
	#define PORT_OPT_E_0		PORT_OPT_NO_PULL
		//

	#define PORT_IO_E_1			PORT_IO_INPUT
	#define PORT_OPT_E_1		PORT_OPT_NO_PULL
		//

	#define PORT_IO_E_2			PORT_IO_INPUT
	#define PORT_OPT_E_2		PORT_OPT_NO_PULL
		// Programmation

	#define PORT_IO_E_3			PORT_IO_INPUT
	#define PORT_OPT_E_3		PORT_OPT_NO_PULL
		// Programmation

	#define PORT_IO_E_4			PORT_IO_INPUT
	#define PORT_OPT_E_4		PORT_OPT_NO_PULL
		// Programmation

	#define PORT_IO_E_5			PORT_IO_OUTPUT
	#define PORT_OPT_E_5		PORT_OPT_PULL_DOWN
		#define CS_LASER_FRONT_PORT	GPIOE
		#define CS_LASER_FRONT_PIN	GPIO_Pin_5
		// Programmation

	#define PORT_IO_E_6			PORT_IO_OUTPUT
	#define PORT_OPT_E_6		PORT_OPT_PULL_DOWN
		#define CS_LASER_LEFT_PORT	GPIOE
		#define CS_LASER_LEFT_PIN	GPIO_Pin_6
		// Programmation

	#define PORT_IO_E_7			PORT_IO_INPUT
	#define PORT_OPT_E_7		PORT_OPT_NO_PULL
		#define PORT_I_AM_STRAT		GPIOE,GPIO_Pin_7
		#define	READ_I_AM_STRAT		GPIOE->IDR7

	#define PORT_IO_E_8			PORT_IO_INPUT
	#define PORT_OPT_E_8		PORT_OPT_NO_PULL
		#define PORT_I_AM_ACT		GPIOE,GPIO_Pin_8
		#define	READ_I_AM_ACT		GPIOE->IDR8

	#define PORT_IO_E_9			PORT_IO_INPUT
	#define PORT_OPT_E_9		PORT_OPT_NO_PULL
		#define PORT_I_AM_PROP		GPIOE,GPIO_Pin_9
		#define	READ_I_AM_PROP		GPIOE->IDR9

	#define PORT_IO_E_10		PORT_IO_INPUT
	#define PORT_OPT_E_10		PORT_OPT_NO_PULL
		//#define MOSFET_7_PIN		GPIOE,GPIO_Pin_13

	#define PORT_IO_E_11		PORT_IO_INPUT
	#define PORT_OPT_E_11		PORT_OPT_NO_PULL
		//

	#define PORT_IO_E_12		PORT_IO_INPUT
	#define PORT_OPT_E_12		PORT_OPT_NO_PULL
		//

	#define PORT_IO_E_13		PORT_IO_INPUT
	#define PORT_OPT_E_13		PORT_OPT_NO_PULL
		//#define MOSFET_8_PIN		GPIOE,GPIO_Pin_13

	#define PORT_IO_E_14		PORT_IO_INPUT
	#define PORT_OPT_E_14		PORT_OPT_NO_PULL
		//

	#define PORT_IO_E_15		PORT_IO_INPUT
	#define PORT_OPT_E_15		PORT_OPT_NO_PULL
		//

//--------------------Configuration des ID des actionneurs-----------------------
// L'id doit être inférieur à 50
/* ID des différents AX12 */
#define SMALL_BALL_BACK_AX12_ID					62
#define SMALL_BALL_FRONT_LEFT_AX12_ID			63
#define SMALL_BALL_FRONT_RIGHT_AX12_ID			61
#define SMALL_CYLINDER_ARM_RX24_ID				43
#define SMALL_CYLINDER_COLOR_RX24_ID			41
#define SMALL_CYLINDER_ELEVATOR_RX24_ID			36
#define SMALL_CYLINDER_SLIDER_AX12_ID			60
#define SMALL_CYLINDER_BALANCER_AX12_ID			41
#define SMALL_CYLINDER_SLOPE_AX12_ID			42
#define SMALL_CYLINDER_DISPOSE_AX12_ID			40
#define SMALL_CYLINDER_MULTIFONCTION_AX12_ID	64
#define SMALL_MAGIC_ARM_RX24_ID					42
#define SMALL_MAGIC_COLOR_RX24_ID				46
#define SMALL_ORE_AX12_ID						65
#define SMALL_CYLINDER_POUSSIX_AX12_ID			66



#endif /* SMALL_CONFIG_PIN_H */
