samuelpoiraud/robot/3_Actionneur/CurrentSoftwareSTM32/Anne/small_cylinder/small_cylinder_arm/small_cylinder_arm.c

/*  Club Robot ESEO 2016 - 2017
*
*	Fichier : small_cylinder_arm.c
*	Package : Carte actionneur
*	Description : Gestion de l'actionneur RX24 SMALL_CYLINDER_ARM
*	Auteur :
*	Version 2017
*	Robot : BIG
*/

#include "small_cylinder_arm.h"


// SMALL_CYLINDER_ARM d'un actionneur standart avec RX24

// 1) Ajout l'actionneur dans QS_CANmsgList.h (tout à la fin du fichier)
// 2) Ajout d'une valeur dans l'énumération de la queue dans config_(big/small)/config_global_vars_types.h
//		Formatage : QUEUE_ACT_RX24_SMALL_CYLINDER_ARM
// 3) Ajout de la déclaration de l'actionneur dans ActManager dans le tableau actionneurs
// 4) Ajout de la verbosité dans le fichier act_queue_utils.c dans la fonction ACTQ_internal_printResult
// 5) Ajout du pilotage via terminal dans le fichier term_io.c dans le tableau terminal_motor du type : ACT_DECLARE(SMALL_CYLINDER_ARM)
// 6) Un #define SMALL_CYLINDER_ARM_RX24_ID doit avoir été ajouté au fichier config_big/config_pin.h ou config_small/config_pin.h
// 7) Ajout des postions dans QS_types.h dans l'énum ACT_order_e (avec "ACT_" et sans "_POS" à la fin)
// 8) Mise à jour de config/config_debug.h : mettre LOG_PRINT_On
// 9) Include le .h dans act_manager et dans termi_io
// 10) Enlever le #IF 0 qui se trouve quelques lignes


// Optionnel:
// Ajout du selftest dans le fichier selftest.c dans la fonction SELFTEST_done_test
// Ajout du selftest dans le fichier QS_CANmsgList (dans l'énumération SELFTEST)

// En stratégie
// 1) ajout d'une d'une valeur dans le tableau act_link_SID_Queue du fichier act_functions.c/h
// 2) ajout des fonctions actionneurs dans act_avoidance.c/h si l'actionneur modifie l'évitement du robot

// En stratégie Optionnel
// ajout du verbose du selftest dans Supervision/Selftest.c (tableau SELFTEST_getError_string, fonction SELFTEST_print_errors)
// ajout de la verbosité dans Supervision/Verbose_can_msg.c/h (fonction VERBOSE_CAN_MSG_sprint)

// If def à mettre si l'actionneur est seulement présent sur le petit robot (I_AM_ROBOT_SMALL) ou le gros (I_AM_ROBOT_BIG)
#ifdef I_AM_ROBOT_SMALL

// Les différents includes nécessaires...
#include "../QS/QS_CANmsgList.h"
#include "../QS/QS_rx24.h"
#include "../QS/QS_can.h"
#include "../act_queue_utils.h"
#include "../selftest.h"
#include "../ActManager.h"

#include "small_cylinder_arm_config.h"

// Les différents define pour le verbose sur uart
#define LOG_PREFIX "small_cylinder_arm.c : "
#define LOG_COMPONENT OUTPUT_LOG_COMPONENT_SMALL_CYLINDER_ARM
#include "../QS/QS_outputlog.h"

// Les fonctions internes au fonctionnement de l'actionneur
static void SMALL_CYLINDER_ARM_command_run(queue_id_t queueId);
static void SMALL_CYLINDER_ARM_initRX24();
static void SMALL_CYLINDER_ARM_command_init(queue_id_t queueId);
static void SMALL_CYLINDER_ARM_set_config(CAN_msg_t* msg);
static void SMALL_CYLINDER_ARM_get_position_config(ACT_order_e *pOrder, Uint16 *pPos);
static void SMALL_CYLINDER_ARM_get_config(CAN_msg_t *incoming_msg);
static void SMALL_CYLINDER_ARM_set_warner(CAN_msg_t *msg);
static void SMALL_CYLINDER_ARM_check_warner(Uint16 pos);

// Booléen contenant l'état actuel de l'initialisation du RX24 (Plusieurs booléens si plusieurs servo dans l'actionneur)
static bool_e rx24_is_initialized = FALSE;

// Warner de l'actionneur : Déclenche l'envoi d'un message CAN lorsqu'une certaine position est franchi
static act_warner_s warner;

// Flag qui permet d'annuler l'ordre en cours dans le cas où l'on vient de recevoir un ordre "run_now"
static bool_e run_now = FALSE;

// Fonction appellée au lancement de la carte (via ActManager)
void SMALL_CYLINDER_ARM_init() {
	static bool_e initialized = FALSE;

	if(initialized)
		return;
	initialized = TRUE;

	RX24_init();
    SMALL_CYLINDER_ARM_initRX24();
}

// Fonction appellée si la carte IHM a détecté une grosse chutte de la tension d'alimentation des servos
// Pour éviter les problèmes d'utilisation de servo non initialisé
void SMALL_CYLINDER_ARM_reset_config(){
	rx24_is_initialized = FALSE;
    SMALL_CYLINDER_ARM_initRX24();
}

//Initialise le RX24 s'il n'était pas alimenté lors d'initialisations précédentes, si déjà initialisé, ne fait rien
static void SMALL_CYLINDER_ARM_initRX24() {
    if(rx24_is_initialized == FALSE && RX24_is_ready(SMALL_CYLINDER_ARM_RX24_ID) == TRUE) {
		rx24_is_initialized = TRUE;
        RX24_config_set_lowest_voltage(SMALL_CYLINDER_ARM_RX24_ID, RX24_MIN_VOLTAGE);
        RX24_config_set_highest_voltage(SMALL_CYLINDER_ARM_RX24_ID, RX24_MAX_VOLTAGE);
        RX24_set_torque_limit(SMALL_CYLINDER_ARM_RX24_ID, SMALL_CYLINDER_ARM_RX24_MAX_TORQUE_PERCENT);
        RX24_config_set_temperature_limit(SMALL_CYLINDER_ARM_RX24_ID, SMALL_CYLINDER_ARM_RX24_MAX_TEMPERATURE);

        RX24_config_set_maximal_angle(SMALL_CYLINDER_ARM_RX24_ID, SMALL_CYLINDER_ARM_RX24_MAX_VALUE);
        RX24_config_set_minimal_angle(SMALL_CYLINDER_ARM_RX24_ID, SMALL_CYLINDER_ARM_RX24_MIN_VALUE);
        RX24_set_move_to_position_speed(SMALL_CYLINDER_ARM_RX24_ID, SMALL_CYLINDER_ARM_RX24_SPEED);

        RX24_config_set_error_before_led(SMALL_CYLINDER_ARM_RX24_ID, RX24_BEFORE_LED);
        RX24_config_set_error_before_shutdown(SMALL_CYLINDER_ARM_RX24_ID, RX24_BEFORE_SHUTDOWN);
		debug_printf("Init config DONE\n");
	}else if(rx24_is_initialized == FALSE)
		debug_printf("Init config FAIL\n");
}


// Fonction appellée pour la modification des configurations du rx24 telle que la vitesse et le couple (via ActManager)
// Dans le cas de multiple actionneur appartenant à un même actionneur, ajouter des defines dans QS_CANmsgList.h afin de pouvoir les choisirs facilement depuis la stratégie
void SMALL_CYLINDER_ARM_set_config(CAN_msg_t* msg){
	switch(msg->data.act_msg.act_data.act_config.sub_act_id){
		case DEFAULT_MONO_ACT : // Premier élement de l'actionneur
            ACTMGR_config_RX24(SMALL_CYLINDER_ARM_RX24_ID, msg);
			break;

		default :
			warn_printf("invalid CAN msg data[1]=%u (sous actionneur inexistant)!\n", msg->data.act_msg.act_data.act_config.sub_act_id);
	}
}

static void SMALL_CYLINDER_ARM_get_config(CAN_msg_t *incoming_msg){
	bool_e error = FALSE;
	Uint16 pos = 0;;
	ACT_order_e order = 0;
	CAN_msg_t msg;
	msg.sid = ACT_GET_CONFIG_ANSWER;
	msg.size = SIZE_ACT_GET_CONFIG_ANSWER;
	msg.data.act_get_config_answer.sid = 0xFF & ACT_SMALL_CYLINDER_ARM;
	msg.data.act_get_config_answer.config = incoming_msg->data.act_msg.act_data.config;

	switch(incoming_msg->data.act_msg.act_data.config){
		case POSITION_CONFIG:
			SMALL_CYLINDER_ARM_get_position_config(&order, &pos);
			msg.data.act_get_config_answer.act_get_config_data.act_get_config_pos_answer.order = order;
			msg.data.act_get_config_answer.act_get_config_data.act_get_config_pos_answer.pos = pos;
			break;
		case TORQUE_CONFIG:
			msg.data.act_get_config_answer.act_get_config_data.torque = RX24_get_speed_percentage(SMALL_CYLINDER_ARM_RX24_ID);
			break;
		case TEMPERATURE_CONFIG:
			msg.data.act_get_config_answer.act_get_config_data.temperature = RX24_get_temperature(SMALL_CYLINDER_ARM_RX24_ID);
			break;
		case LOAD_CONFIG:
			msg.data.act_get_config_answer.act_get_config_data.load = RX24_get_load_percentage(SMALL_CYLINDER_ARM_RX24_ID);
			break;
		default:
			error = TRUE;
			warn_printf("This config is not available \n");
	}

	if(!error){
		CAN_send(&msg); // Envoi du message CAN
	}
}

static void SMALL_CYLINDER_ARM_get_position_config(ACT_order_e *pOrder, Uint16 *pPos){
	ACT_order_e order = ACT_SMALL_CYLINDER_ARM_STOP;
	Uint16 position = RX24_get_position(SMALL_CYLINDER_ARM_RX24_ID);
	Uint16 epsilon = SMALL_CYLINDER_ARM_RX24_ASSER_POS_EPSILON;

	if(position > SMALL_CYLINDER_ARM_RX24_IN_POS - epsilon && position < SMALL_CYLINDER_ARM_RX24_IN_POS + epsilon){
		order = ACT_SMALL_CYLINDER_ARM_IN;
	}else if(position > SMALL_CYLINDER_ARM_RX24_PREPARE_TO_TAKE_POS - epsilon && position < SMALL_CYLINDER_ARM_RX24_PREPARE_TO_TAKE_POS + epsilon){
		order = ACT_SMALL_CYLINDER_ARM_PREPARE_TO_TAKE;
	}else if(position > SMALL_CYLINDER_ARM_RX24_TAKE_POS - epsilon && position < SMALL_CYLINDER_ARM_RX24_TAKE_POS + epsilon){
		order = ACT_SMALL_CYLINDER_ARM_TAKE;
	}else if(position > SMALL_CYLINDER_ARM_RX24_DISPOSE_POS - epsilon && position < SMALL_CYLINDER_ARM_RX24_DISPOSE_POS + epsilon){
		order = ACT_SMALL_CYLINDER_ARM_DISPOSE;
	}else if(position > SMALL_CYLINDER_ARM_RX24_OUT_POS - epsilon && position < SMALL_CYLINDER_ARM_RX24_OUT_POS + epsilon){
		order = ACT_SMALL_CYLINDER_ARM_OUT;
	}else if(position > SMALL_CYLINDER_ARM_RX24_PROTECT_FALL_POS - epsilon && position < SMALL_CYLINDER_ARM_RX24_PROTECT_FALL_POS + epsilon){
		order = ACT_SMALL_CYLINDER_ARM_PROTECT_FALL;
	}else if(position > SMALL_CYLINDER_ARM_RX24_PROTECT_WHEN_DISPOSE - epsilon && position < SMALL_CYLINDER_ARM_RX24_PROTECT_WHEN_DISPOSE + epsilon){
		order = ACT_SMALL_CYLINDER_ARM_PROTECT_WHEN_DISPOSE;
	}else if(position > SMALL_CYLINDER_ARM_RX24_IDLE_POS - epsilon && position < SMALL_CYLINDER_ARM_RX24_IDLE_POS + epsilon){
		order = ACT_SMALL_CYLINDER_ARM_IDLE;
	}

	if(pOrder != NULL)
		*pOrder = order;

	if(pPos != NULL)
		*pPos = position;
}

// Fonction appellée pour l'initialisation en position du rx24 dés l'arrivé de l'alimentation (via ActManager)
void SMALL_CYLINDER_ARM_init_pos(){
    SMALL_CYLINDER_ARM_initRX24();

	if(rx24_is_initialized == FALSE)
		return;

	debug_printf("Init pos : \n");
    if(!RX24_set_position(SMALL_CYLINDER_ARM_RX24_ID, SMALL_CYLINDER_ARM_RX24_INIT_POS))
        debug_printf("   Le RX24 n°%d n'est pas là\n", SMALL_CYLINDER_ARM_RX24_ID);
	else
        debug_printf("   Le RX24 n°%d a été initialisé en position\n", SMALL_CYLINDER_ARM_RX24_ID);
}

// Fonction appellée à la fin du match (via ActManager)
void SMALL_CYLINDER_ARM_stop(){
    RX24_set_torque_enabled(SMALL_CYLINDER_ARM_RX24_ID, FALSE); //Stopper l'asservissement du RX24
}

// fonction appellée à la réception d'un message CAN (via ActManager)
bool_e SMALL_CYLINDER_ARM_CAN_process_msg(CAN_msg_t* msg) {
    if(msg->sid == ACT_SMALL_CYLINDER_ARM){
        SMALL_CYLINDER_ARM_initRX24();
		switch(msg->data.act_msg.order) {
			// Listing de toutes les positions de l'actionneur possible
            case ACT_SMALL_CYLINDER_ARM_IDLE :
            case ACT_SMALL_CYLINDER_ARM_IN :
            case ACT_SMALL_CYLINDER_ARM_PREPARE_TO_TAKE :
            case ACT_SMALL_CYLINDER_ARM_TAKE :
            case ACT_SMALL_CYLINDER_ARM_DISPOSE :
            case ACT_SMALL_CYLINDER_ARM_OUT :
            case ACT_SMALL_CYLINDER_ARM_PROTECT_FALL:
            case ACT_SMALL_CYLINDER_ARM_PROTECT_WHEN_DISPOSE:
            case ACT_SMALL_CYLINDER_ARM_STOP :
            	run_now = msg->data.act_msg.act_data.act_order.run_now;
                ACTQ_push_operation_from_msg(msg, QUEUE_ACT_RX24_SMALL_CYLINDER_ARM, &SMALL_CYLINDER_ARM_run_command, 0,TRUE);
				break;

            case ACT_WARNER:
				SMALL_CYLINDER_ARM_set_warner(msg);
				break;

			case ACT_GET_CONFIG:
				SMALL_CYLINDER_ARM_get_config(msg);
				break;

			case ACT_SET_CONFIG :
                SMALL_CYLINDER_ARM_set_config(msg);
				break;


			default:
				component_printf(LOG_LEVEL_Warning, "invalid CAN msg data[0]=%u !\n", msg->data.act_msg.order);
		}
		return TRUE;
	}else if(msg->sid == ACT_DO_SELFTEST){

	}
	return FALSE;
}

// Fonction appellée par la queue pendant tout le temps de la commande en cours (le booléen init est à TRUE au premier lancement de la commande)
void SMALL_CYLINDER_ARM_run_command(queue_id_t queueId, bool_e init) {
	if(QUEUE_has_error(queueId)) {
		QUEUE_behead(queueId);
		return;
	}

    if(QUEUE_get_act(queueId) == QUEUE_ACT_RX24_SMALL_CYLINDER_ARM) {    // Gestion des mouvements de SMALL_CYLINDER_ARM
		if(init)
            SMALL_CYLINDER_ARM_command_init(queueId);
		else
            SMALL_CYLINDER_ARM_command_run(queueId);
	}
}

//Initialise une commande
static void SMALL_CYLINDER_ARM_command_init(queue_id_t queueId) {
	Uint8 command = QUEUE_get_arg(queueId)->canCommand;
	Sint16* rx24_goalPosition = &QUEUE_get_arg(queueId)->param;

	*rx24_goalPosition = 0xFFFF;
    SMALL_CYLINDER_ARM_initRX24();

	switch(command) {
		// Listing de toutes les positions de l'actionneur possible avec les valeurs de position associées
        case ACT_SMALL_CYLINDER_ARM_IDLE : *rx24_goalPosition = SMALL_CYLINDER_ARM_RX24_IDLE_POS; break;
        case ACT_SMALL_CYLINDER_ARM_IN : *rx24_goalPosition = SMALL_CYLINDER_ARM_RX24_IN_POS; break;
        case ACT_SMALL_CYLINDER_ARM_PREPARE_TO_TAKE : *rx24_goalPosition = SMALL_CYLINDER_ARM_RX24_PREPARE_TO_TAKE_POS; break;
        case ACT_SMALL_CYLINDER_ARM_TAKE : *rx24_goalPosition = SMALL_CYLINDER_ARM_RX24_TAKE_POS; break;
        case ACT_SMALL_CYLINDER_ARM_DISPOSE : *rx24_goalPosition = SMALL_CYLINDER_ARM_RX24_DISPOSE_POS; break;
        case ACT_SMALL_CYLINDER_ARM_OUT : *rx24_goalPosition = SMALL_CYLINDER_ARM_RX24_OUT_POS; break;
        case ACT_SMALL_CYLINDER_ARM_PROTECT_FALL : *rx24_goalPosition = SMALL_CYLINDER_ARM_RX24_PROTECT_FALL_POS; break;
        case ACT_SMALL_CYLINDER_ARM_PROTECT_WHEN_DISPOSE : *rx24_goalPosition = SMALL_CYLINDER_ARM_RX24_PROTECT_WHEN_DISPOSE; break;

        case ACT_SMALL_CYLINDER_ARM_STOP :
            RX24_set_torque_enabled(SMALL_CYLINDER_ARM_RX24_ID, FALSE); //Stopper l'asservissement du RX24
            QUEUE_next(queueId, ACT_SMALL_CYLINDER_ARM, ACT_RESULT_DONE, ACT_RESULT_ERROR_OK, __LINE__);
			return;

		default: {
            error_printf("Invalid SMALL_CYLINDER_ARM command: %u, code is broken !\n", command);
            QUEUE_next(queueId, ACT_SMALL_CYLINDER_ARM, ACT_RESULT_NOT_HANDLED, ACT_RESULT_ERROR_LOGIC, __LINE__);
			return;
		}
	}

	if(rx24_is_initialized == FALSE){
		error_printf("Impossible de mettre l'actionneur en position il n'est pas initialisé\n");
        QUEUE_next(queueId, ACT_SMALL_CYLINDER_ARM, ACT_RESULT_FAILED, ACT_RESULT_ERROR_NOT_HERE, __LINE__);
		return;
	}

	if(*rx24_goalPosition == 0xFFFF) {
		error_printf("Invalid rx24 position for command: %u, code is broken !\n", command);
        QUEUE_next(queueId, ACT_SMALL_CYLINDER_ARM, ACT_RESULT_NOT_HANDLED, ACT_RESULT_ERROR_LOGIC, __LINE__);
		return;
	}

    RX24_reset_last_error(SMALL_CYLINDER_ARM_RX24_ID); //Sécurité anti terroriste. Nous les parano on aime pas voir des erreurs là ou il n'y en a pas.
    if(!RX24_set_position(SMALL_CYLINDER_ARM_RX24_ID, *rx24_goalPosition)) {	//Si la commande n'a pas été envoyée correctement et/ou que le RX24 ne répond pas a cet envoi, on l'indique à la carte stratégie
        error_printf("RX24_set_position error: 0x%x\n", RX24_get_last_error(SMALL_CYLINDER_ARM_RX24_ID).error);
        QUEUE_next(queueId, ACT_SMALL_CYLINDER_ARM, ACT_RESULT_FAILED, ACT_RESULT_ERROR_NOT_HERE, __LINE__);
		return;
	}
	//La commande a été envoyée et le RX24 l'a bien reçu
    debug_printf("Move SMALL_CYLINDER_ARM rx24 to %d\n", *rx24_goalPosition);
}

//Gère les états pendant le mouvement du RX24
static void SMALL_CYLINDER_ARM_command_run(queue_id_t queueId) {
	Uint8 result, errorCode;
	Uint16 line;

	Uint16 pos = RX24_get_position(SMALL_CYLINDER_ARM_RX24_ID);

	if(!run_now){
		if(ACTQ_check_status_rx24(queueId, SMALL_CYLINDER_ARM_RX24_ID, QUEUE_get_arg(queueId)->param, pos, SMALL_CYLINDER_ARM_RX24_ASSER_POS_EPSILON, SMALL_CYLINDER_ARM_RX24_ASSER_TIMEOUT, SMALL_CYLINDER_ARM_RX24_ASSER_POS_LARGE_EPSILON, &result, &errorCode, &line))
			QUEUE_next(queueId, ACT_SMALL_CYLINDER_ARM, result, errorCode, line);
	}else{
		// Lorsqu'on vient de recevoir un run_now, on passe directement à l'ordre reçu.
		ACTQ_flush_queue_to_run_now(queueId, ACT_SMALL_CYLINDER_ARM);
		run_now = FALSE;
	}

    // On ne surveille le warner que si il est activé
	if(warner.activated)
		SMALL_CYLINDER_ARM_check_warner(pos);
}

static void SMALL_CYLINDER_ARM_set_warner(CAN_msg_t *msg){
	warner.activated = TRUE;
	warner.last_pos = RX24_get_position(SMALL_CYLINDER_ARM_RX24_ID);

	switch(msg->data.act_msg.act_data.warner_pos){
		/*case ACT_SMALL_CYLINDER_ARM_WARNER:
			warner.warner_pos = SMALL_CYLINDER_ARM_RX24_WARNER_POS;
			break;*/
		default:{
			warner.activated = FALSE;
			warn_printf("This position is not available for setting a warner\n");
		}
	}
}

static void SMALL_CYLINDER_ARM_check_warner(Uint16 pos){
	CAN_msg_t msg;

	if( (warner.last_pos < pos && warner.last_pos < warner.warner_pos && pos > warner.warner_pos)
     || (warner.last_pos > pos && warner.last_pos > warner.warner_pos && pos < warner.warner_pos)
	 || (warner.last_pos > RX24_MAX_WARNER && pos < RX24_MIN_WARNER	&& (warner.last_pos < warner.warner_pos || pos > warner.warner_pos))
	 || (warner.last_pos < RX24_MIN_WARNER && pos > RX24_MAX_WARNER	&& (warner.last_pos > warner.warner_pos || pos < warner.warner_pos))
	){
		// Envoi du message CAN pour prévenir la strat
		msg.sid = ACT_WARNER_ANSWER;
		msg.size = SIZE_ACT_WARNER_ANSWER;
		msg.data.act_warner_answer.sid = 0xFF & ACT_SMALL_CYLINDER_ARM;
		CAN_send(&msg);

		// Désactivation du warner
		warner.activated = FALSE;
	}

	warner.last_pos = pos;
}
#endif
