samuelpoiraud/robot/3_Actionneur/CurrentSoftwareSTM32/Harry/cylinder/cylinder_slider/cylinder_slider_left_config.h

/*  Club Robot ESEO 2016 - 2017
*
*	Fichier : CYLINDER_SLIDER_LEFT_rx24_config.c
*	Package : Carte actionneur
*	Description : Gestion de l'actionneur RX24 CYLINDER_SLIDER_LEFT
*	Auteur :
*	Version 2017
*	Robot : BIG
*/

#ifndef CYLINDER_SLIDER_LEFT_CONFIG_H
#define	CYLINDER_SLIDER_LEFT_CONFIG_H

//Config
    #define CYLINDER_SLIDER_LEFT_RX24_ASSER_TIMEOUT				2000	// Si le RX24 n'atteint pas la position demandée avant ce temps, on considère qu'il y a un problème. Temps en ms.
    #define CYLINDER_SLIDER_LEFT_RX24_ASSER_POS_EPSILON			6		// Lorsque le RX24 atteint sa position avec +/- POS_EPSILON degré d'écart max, on considère qu'il a atteint sa position. Angle en degré.
    #define CYLINDER_SLIDER_LEFT_RX24_ASSER_POS_LARGE_EPSILON	28		// Si le déplacement de le RX24 timeout mais que sa position est à +/- POS_LARGE_EPSILON degré d'écart max, on considère qu'il a atteint sa position. Angle en degré.
    #define CYLINDER_SLIDER_LEFT_RX24_MAX_TORQUE_PERCENT		50		// Couple maximum en pourcentage de le RX24. Utilisé pour limiter le courant dans le moteur. A mettre a une valeur correcte pour pincer assez fort sans risquer d'endommager le RX24.
    #define CYLINDER_SLIDER_LEFT_RX24_MAX_TEMPERATURE			60		// Température maximale en degré
	#define CYLINDER_SLIDER_LEFT_RX24_SPEED						60		// Vitesse par défaut du RX24

//Position
    #define CYLINDER_SLIDER_LEFT_RX24_IDLE_POS								278 //179
    #define CYLINDER_SLIDER_LEFT_RX24_IN_POS						     	292	//200	//en degré
	#define CYLINDER_SLIDER_LEFT_RX24_HARVEST_POS						    316 // (40 par rapport à IDLE_POS)
    #define CYLINDER_SLIDER_LEFT_RX24_OUT_POS								882	//905	//en degré (+590 par rapport à IN_POS)
    #define CYLINDER_SLIDER_LEFT_RX24_ALMOST_OUT_POS						654 //538	//en degré (+362 par rapport à IN_POS)
    #define CYLINDER_SLIDER_LEFT_RX24_ALMOST_OUT_WITH_CYLINDER_POS		 	442 //350	//en degré (+150 par rapport à IN_POS)
	#define CYLINDER_SLIDER_LEFT_RX24_WARNER_POS							442 //450


//Position initiale de l'RX24
    #define CYLINDER_SLIDER_LEFT_RX24_INIT_POS					CYLINDER_SLIDER_LEFT_RX24_IDLE_POS

//Extremum valeur
    #define CYLINDER_SLIDER_LEFT_RX24_MIN_VALUE					0
    #define CYLINDER_SLIDER_LEFT_RX24_MAX_VALUE					1024

#endif	/* CYLINDER_SLIDER_LEFT_CONFIG_H */
