samuelpoiraud/robot/3_Actionneur/CurrentSoftwareSTM32/Harry/cylinder/cylinder_arm/cylinder_arm_right.h

/*  Club Robot ESEO 2016 - 2017
*
*	Fichier : cylinder_arm_right.h
*	Package : Carte actionneur
*	Description : Gestion de l'actionneur RX24 CYLINDER_ARM_RIGHT
*	Auteur :
*	Version 2017
*	Robot : BIG
*/

#ifndef CYLINDER_ARM_RIGHT_H
    #define	CYLINDER_ARM_RIGHT_H

	#include "../QS/QS_all.h"
	#include "../QS/QS_CANmsgList.h"

	#include "../queue.h"

    /** Initialisation du gestionnaire de CYLINDER_ARM_RIGHT.
	 *
	 * Configure l'asservissement du RX24
	 */
    void CYLINDER_ARM_RIGHT_init();

    /** Initialisation en position du gestionnaire de CYLINDER_ARM_RIGHT.
	 *
	 * Initialise la position du RX24
	 */
    void CYLINDER_ARM_RIGHT_init_pos();

	/** Stoppe l'actionneur.
	 *
	 * Cette fonction est appelée en fin de match
	 */
    void CYLINDER_ARM_RIGHT_stop();

    /** Gère les messages CAN liés à la CYLINDER_ARM_RIGHT.
	 *
	 * Cette fonction s'occupe toute seule de gérer la queue et d'agir en conséquence.
	 * @param msg le message CAN
	 * @return TRUE si le message CAN a été géré par cet actionneur, FALSE sinon
	 */
    bool_e CYLINDER_ARM_RIGHT_CAN_process_msg(CAN_msg_t* msg);

	/** Gère les commandes demandées.
	 *
	 * Fonction à mettre sur la file pour demander une action.
	 */
    void CYLINDER_ARM_RIGHT_run_command(queue_id_t queueId, bool_e init);


	/**
	 * Réinitialise la configuration du RX24
	 */
    void CYLINDER_ARM_RIGHT_reset_config();

#endif	/* CYLINDER_ARM_RIGHT_H */
