samuelpoiraud/robot/2_Strategie/CurrentSoftwareSTM32/state_machine_helper.c

#include "state_machine_helper.h"
#include <stdarg.h>
#include "../act_functions.h"
#define LOG_COMPONENT OUTPUT_LOG_COMPONENT_STRAT_STATE_CHANGES
#include "../QS/QS_outputlog.h"
#include "Supervision/SD/SD.h"

void UTILS_LOG_state_changed(const char* sm_name, UTILS_state_machine_id_e sm_id, const char* old_state_name, Uint8 old_state_id, const char* new_state_name, Uint8 new_state_id) {
	info_printf("  # %s(0x%04X): %s(%d) -> %s(%d)\n",
			sm_name, sm_id,
			old_state_name, old_state_id,
			new_state_name, new_state_id);
}

Uint8 check_act_status(queue_id_e act_queue_id, Uint8 in_progress_state, Uint8 success_state, Uint8 failed_state) {
	ACT_function_result_e result = ACT_get_last_action_result(act_queue_id);
	switch(result) {
		case ACT_FUNCTION_InProgress:
			return in_progress_state;

		case ACT_FUNCTION_Done:
			return success_state;

		case ACT_FUNCTION_ActDisabled:
		case ACT_FUNCTION_RetryLater:
			return failed_state;

		default:
			debug_printf("/!\\ check_act_status:%d: in default case, result = %d\n", __LINE__, result);
			return failed_state;
	}
}

Uint8 check_sub_action_result(error_e sub_action, Uint8 in_progress_state, Uint8 success_state, Uint8 failed_state) {
	switch(sub_action) {
		case IN_PROGRESS:
			return in_progress_state;

		case END_OK:
			return success_state;

		case END_WITH_TIMEOUT:
		case FOE_IN_PATH:
		case NOT_HANDLED:
			return failed_state;

		default:
			debug_printf("/!\\ check_sub_action_result:%d: in default case, sub_action = %d\n", __LINE__, sub_action);
			return failed_state;
	}
}

void UTILS_LOG_init_state(const char* sm_name, UTILS_state_machine_id_e sm_id, const char* init_state_name, Uint8 init_state_val){
	info_printf("  # %s(0x%04X): %s\n",
			sm_name, sm_id,
			init_state_name);
}
