samuelpoiraud/robot/STM32/QS_branch/QS_Step_motor.h

/*
 *	Club Robot ESEO 2008 - 2009
 *	Archi-Tech'
 *
 *	Fichier : QS_Step_motor.h
 *	Package : Qualité Software
 *	Description : 	fonction de gestion du moteur pas à pas
 *	Auteur : Jacen
 *	Licence : CeCILL-C (voir LICENCE.txt)
 *	Version 20090220
 */
 
/** ----------------  Defines possibles  --------------------
 *	USE_STEP_MOTOR				: Activation de QS_Step_motor
 *	STEP_MOTOR_TIMER			: Numéro du timer choisi pour ce module
 *	STEP_MOTOR_USE_WATCHDOG		: Utiliser un watchdog pour gérer ce module
 *
 *	STEP_MOTOR1					: Mettre l'identifiant de la pin 1
 *	STEP_MOTOR2					: Mettre l'identifiant de la pin 2
 *	STEP_MOTOR3					: Mettre l'identifiant de la pin 3
 *	STEP_MOTOR4					: Mettre l'identifiant de la pin 4
 *
 * ----------------  Choses à savoir  --------------------
 * Il faut obligatoirement définir STEP_MOTOR_TIMER ou STEP_MOTOR_USE_WATCHDOG
 */

/*	Notes d'exploitation :
 *	Ce module a pour fonction de controler un moteur pas à pas
 *	En appliquant les niveaux de tension adéquats.
 *	On considère un moteur pas à pas à quatres accès nommés
 *	STEP_MOTOR1, STEP_MOTOR2, STEP_MOTOR3 et STEP_MOTOR4
 *	dans Global_config.
 *	Attribuez les pins de manières à ce que STEP_MOTOR1 soit
 *	l'entrée opposée de STEP_MOTOR3.
 *	Ce pilote ne vérifie pas que les pins utilisées sont bien
 *	configurées en sorties.
 *	Si vous utilisez un pont en H (exm: L298N), ce pilote n'active
 *	pas les ENABLE du pont.
 *
 *	Ce pilote travaille avec une consigne en demi-pas.
 */

#ifndef QS_STEP_MOTOR_H
	#define QS_STEP_MOTOR_H
	
	#include "QS_all.h"
	
	#ifdef USE_STEP_MOTOR
	
		void STEP_MOTOR_init();
		
		void STEP_MOTOR_add_steps(Sint8 nb_of_steps);

	#endif /* def USE_STEP_MOTOR */	
#endif /* ndef STEP_MOTOR_H */
