samuelpoiraud/robot/2_Strategie/CurrentSoftwareSTM32/astar.c

/*
 *	Club Robot ESEO 2015 - 2017
 *
 *
 *	Fichier : astar.c
 *	Package : Stratégie
 *	Description : 	Fonctions de génération des trajectoires
 *					par le biais d'un algo de type A*
 *	Auteurs : Valentin BESNARD
 *	Version 2
 */

#include "astar.h"
#include <stdlib.h>
#include <math.h>
#include "QS/QS_all.h"
#include "QS/QS_maths.h"
#include "QS/QS_stateMachineHelper.h"
#include "utils/actionChecker.h"
#include "Supervision/SD/SD.h"
#include "Generic_functions.h"

#ifdef _ASTAR_H_

#define LOG_PREFIX "astar: "
#define LOG_COMPONENT OUTPUT_LOG_COMPONENT_ASTAR
#include "QS/QS_outputlog.h"

//--------------------------------------------------------------------------------------------------------------------------------------
//--------------------------------------------------------------- Macros ---------------------------------------------------------------
//--------------------------------------------------------------------------------------------------------------------------------------

	// Macros pour les coûts
	#define MAX_COST (65535)		//Coût global maximal
	#define MAX_COST_ANGLE (0) //(200)	//Coût maximal pouvant être généré par un écart d'angle (Je m'autorise à faire une distance de MAX_COST_ANGLE supplémentaire au maximum pour avoir un meilleur angle)
	#define MAX_COST_FOES (600)     //Côût supplémentaire ajouté si on est trop près d'un adversaire

	// Macros pour les polygones
	#define NB_MAX_POLYGONS (5 + MAX_NB_FOES)	// Nombre maximal de polygones
	#define NB_MAX_NODES_IO (10)				// Nombre maximal de noeuds d'entrée/sortie
	#define NB_MAX_SUMMITS (10)					// Nombre maximal de sommets par polygone
	#define OBSTACLE_MARGIN (200)				// Marge du centre du robot avec un obstacle

	// Macros pour les hardlines
	#define NB_MAX_HARDLINES (15)				// Nombre maximale de hardlines (attention si vous ajoutez une protection, ca fait une hardline en plus
	#define HARDLINE_PROTECTION_LENGTH (200)	// Longeur de la protection d'une hardline

	//Distance à laquelle on accepte des noeuds comme voisins
	#define DISTANCE_NEIGHBOURHOOD (500)

	// Macros pour le traitement des listes
	#define ASTAR_IS_NODE_IN(nodeId, nodeList)	((nodeList) & ((1ULL) << nodeId))
	#define ASTAR_ADD_NODE_IN(nodeId, nodeList)	((nodeList) |= ((1ULL) << (nodeId)))
	#define ASTAR_CLR_NODE_IN(nodeId, nodeList)	((nodeList) &= ~((1ULL) << (nodeId)))

	// Rayon du polygone défini pour les robots adverses
	#define FOE_RADIUS (250)
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
