samuelpoiraud/robot/(commit log)

2013-02-03 Correction classeur ports : rôle des interrupteurs. + proposition pour codes similaires sur les deux robots (reconnaissance automatique par les cartes SUPER, STRATEGIE et PROPULSION).
    [_PORTS.xlsx]
2013-02-03 Ajout d'un module QS_who_am_i permettant à une carte de savoir sur quel robot elle est branchée en lisant l'état de branchement... cf _PORTS.xlsx
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2013-02-03 Changement du SID de ACT_AX12: correspondance avec le filtre de message de la carte actionneur: 0x300
2013-02-04 Ajout du support pour l'utilisation du watchdog (QS_watchdog) évitant d'avoir forcément un timer dédié à l'AX12
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2013-02-07 Suppression du dossier QS du projet TestAX12 (la version utilisée est obsolète et n'est pas la version courante)
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2013-02-07 Correction d'un bug inexistant: Si jamais la pile était pleine et que la fonction QUEUE_create était appelée, elle modifierait des valeurs hors de la taille du tableau queues[] (sauf que si on arrive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
    [queue.c]
2013-02-07 Ajout du bras long pour éteindre les bougies et de ses paramètres. Implémentation peut-être incomplète pour l'instant (mais compilable). Le projet de la carte actionneur doit inclure QS_DCMotor.h/c m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
2013-02-07 Mise en commentaire de tout le code d'envoi de message CAN lorsque le moteur à atteint sa position (DCM_sendCAN). Devoir définir le sid ACT_DCM_POS alors qu'il n'est pas utilisé par le CAN c'est embé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
2013-02-08 Ajout des messages et de la gestion des messages CAN pour LONGHAMMER. Ajout de l'actionneur LONGHAMMER dans queue.h.
2013-02-08 Creation des dossier Krusty et Tiny pour les différents codes de chaque robot. Déplacement du code de LongHammer
2013-02-09 Modification du mode de fonctionnement des sous dossiers Krusty & Tiny: - Ajout d'une lettre préfixe T pour Tiny et K pour Krusty à chaque fichier dans ces dossiers. - Ajout de #ifdef pour compiler q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
2013-02-09 Ajout du support pour la définition de plusieurs configuration en ajoutant des switch -DPREDEF_BUILD_TINY ou -DPREDEF_BUILD_KRUSTY a GCC lors de la compilation. Le changement de cible se fait donc pa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
2013-02-10 la fonction de grille donc il faut voir a avec les codeurs
2013-02-10 la nouvelle propulsion avec correction de bug
    [odometry.c, sequences.c]
2013-02-13 Propriété svn:ignore ajoutée pour ignorer les fichiers générés à la compilation et ne pas les commits
2013-02-13 Ajout de target Krusty et Tiny pour le projet actionneur (liste déroulante à gauche du marteau pour compiler). Rajout des messages CAN de BallLauncher et LongHammer + Commentaire des "zone" de messag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
2013-02-14 Modif code de test: Le test des UARTs echo tous les caractères tant que le mode (tester uart) n'est pas changé.
2013-02-14 Classeur qui rescence les avancements validations et problèmes de soudure des cartes 2013 Michaël
    [Validation HARD 2013.xlsx]
2013-02-14 Rint3 sur Super = 100R
    [_PORTS.xlsx]
2013-02-15 Ajout de possibilité de changement de la valeur d'une position sans reconfigurer et stopper un asservissement de moteur. La nouvelle valeur est directement prise en compte si la position est celle as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
2013-02-15 Correction d'un bug si un appel à une fonction de queue.c était fait lors de l'initialisation d'une fonction d'action (elle-même appelée par la fonction QUEUE_add). Ajout du support du changement de 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
    [queue.c]
2013-02-17 Changement de l'emplacement des définitions du nombre de cycle de timer par ms et usec dans le .H pour permettre la conaissance par d'autre modules des valeurs de timer exactes
2013-02-17 Changement du mode de captage: Utilisation du temps entre 2 passages d'aimants
2013-02-17 Correction de valeurs de résistances... carte facto
    [2013_CARTE_FACTORISEE.PCBDOC, 2013_Carte_Factorisee.SchDoc]
2013-02-17 Modification du code avec l'ajout d'une autre possibilité. Non vérifié en profondeur. Le code précédent doit être buggé, je suis emmêlé les pinceaux avec les usec, msec et temps timer ... le 32bits n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
2013-02-18 Test carte facto : reconception du code. Ordre des LEDs ok pr banc de test 2013
2013-02-18 Mise à jour du système de captage: utilisation d'une IT externe de haute priorité ou on calcule la vitesse a partir du temps écoulé entre 2 IT externe. La base de temps est prise du timer d'asserviss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
2013-02-18 Mise à jour du projet Actionneur: Changement de l'ordre des targets et correction des chemins aux fichiers QS pour utiliser le dossier (ou lien :) ) QS dans le projet
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2013-02-19 Finition de l'implémentation de DCMotor2 (version modifié de DCMotor mais n'est plus compatible, j'ai utilisé une version 2 pour ne pas casser le code existant en propulsion par exemple) Ajout de mes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
2013-02-19 Utilisation de DCMotor2 au lieu de DCMotor. DCMotor2 supporte le timeout pour éviter de cramer des moteurs inutilement (mais du coup on peut pas utiliser la fonctionnalité "cramer tous les moteurs" d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
2013-02-20 Suppression du bout de code en assembleur en utilisant __builtin_divsd pour le lanceur de balles
2013-02-20 Déplacement de l'enum QUEUE_act_e dans KGlobal_vars_types.h et mise à jour du code de changement de vitesse par rapport au nouvelle unités (plus d'asm maintenant)
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2013-02-21 Ajout du support pour le retour de résultat d'une action et la gestion du timeout Ajout de message CAN de résultat de actionnneur vers stratégie
2013-02-23 Correction QS_can_over_xbee (match_strated passé en global var). I_AM_MODULE et DESTINATION_MODULE sont maintenant des variables à définir en global. (cela permet de s'adapter au fait qu'un même code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
2013-02-23 Ajout gestion 2 robots. Ajout switch FDP_2013 Gestion de la COULEUR par SWITCH color (sur le FDP_2013) Ajout du QS_WHO_AM_I
2013-02-23 Ajout de fonction pour afficher sur l'uart les infos en fonction de leur importance (style: debug, info, warning, error, ...). Module actif que si OUTPUT_LOG est défini Modification de act_function.c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
    [act_functions.c]
2013-02-23 Changement des types de commentaire pour que mplab X puisse les intégrer et les affichers lors de l'auto-completion
2013-02-23 Les #include lié à brain.c sont dans brain.h (faudra m'expliquer sinon l'intéret de les mettre absolument dans brain.h avec un #define BRAIN_C, je trouve ça un peu inutile vu que ces includes n'ont p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
    [brain.c, brain.h]
2013-02-23 Petite modif: conversion de type qui donnait un warning si output_log était activé.
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2013-02-23 Détection des recouvrement d'IT... J'espère que ce cas ne se produit pas... sinon, il faudra sans doute repasser sur CPLD ...
2013-02-24 Ajout de la detection de buffer plein avec l'erreur TIMEOUT + RANGE en même temps. Correction d'un bug possible avec le pointeur isOk qui n'était pas vérifié Changement du format du message ACT_RESUL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
2013-02-24 queue.c/h: - Ajout de la possibilité de pouvoir lever un flag d'erreur et pouvoir agir en conséquence dans les fonctions suivante dans la file. - Changement des \r\n et \n\r en \n (mettre \r\n cause 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
2013-02-24 Factorisation du code dans act_function + gestion des erreurs plus fine (a finir)
2013-02-24 Ajout de XBEE_FILTER... Les messages autorisés à être envoyés par XBEE doivent commencer par 0x5A?
2013-02-24 Màj du rôle des switchs de la super.
    [_PORTS.xlsx]
2013-02-25 DCMotor: Un timeout ne necessitera plus de faire DCM_restart après pour prendre en compte les nouvelles commandes. Stopper l'asservissement met l'état à IDLE (on est sur que la commande est correcte 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
    [QS_DCMotor2.c]
2013-02-25 Global_config: ajout de OUTPUT_LOG pour activer les logs utilisant output_log.c (act_function.c) environment: Supression du ACT_RESULT_NotHandled car il est en fait NotHandled :) (on le met dans le m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
    [Global_config.h, act_functions.c, act_functions.h, environment.h]
2013-02-25 Ajout de TOUTDOUX (ou plus souvent appelé todo) pour KPlate et Long_Hammer: Long_Hammer: ajout d'un peu de code de gestion d'erreur, incomplet et non fonctionnel actuellement Plate: Ajout de QUEUE_se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
2013-02-25 Changement du niveau de log de output_log à Debug dans Global_config. (Ce module est utilisé que dans act_function.c actuellement, tous les messages commenceront par "act_f: ") Ajout des fonctions po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
2013-02-26 Ajout des fichiers output_log.c/h au projet mplab X de la carte actionneur
2013-02-26 Actionneur: ajout des fonctions d'init dans le main (à nettoyer) + modif et ajout de printf de debuggage Strategie: Modif printf debuggage dans act_function.c + ajout strat de test de balllauncher_run
2013-02-26 Réarrangement pour afficher correctement les messages de debuggage + ajout affichage resultat d'action dans la strat de test de lanceur de balle Factorisation de la gestion des messages CAN en action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
    [act_functions.c]
2013-02-27 Petits changement de commentaire de message CAN + ajout du mot clé volatile la ou il pouvait manquer (mais vu que 99% du temps on utilise pas d'optimisation du compilateur, on vera pas la différence)
2013-02-28 Ajout d'un module dans chaque robot: ActManager, les 2 fichiers contiennent les mêmes fonction et font l'interface entre le code global et le code spécifique à chaque robot au niveau initialisation e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
2013-02-28 Ajout de bug sur le ball_launcher
    [QS_DCMotor2.c]
2013-03-02 Suppression code de debuggage de la revision 95. Correction possible d'un bug: le flag d'IT timer est mis à 1 et déclenche une IT lorsque le compteur du timer est égal au registre période. On pouvais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
2013-03-05 Intégration des multiples strat et multiples calibrations. Testé et fonctionnel Le choix des strat se fait desormais dans brain.c -> any_match Le prototype de any_match est désormais: void any_match(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
2013-03-11 Changement du paramètre donné dans la queue (structure QUEUE_arg_t) + gestion du initial_time permettant de vérifier qu'une action ne dure pas trop longtemps. Ajout du code gérant le gonfleur pour Ti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
2013-03-11 Propagation messages XBee vers robot ami. Un message dont le SID commence par XBEE_FILTER sera propagé comme un STRAT_XBEE_FILTER. Modification des modules attribués à chaque robots... (coordinateur 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
2013-03-11 Mise a jour du projet pour rendre le code compilable avec les nouveautés Ajout de l'actionneur Hammer (bras pour les bougies du bas) Mise en commentaire du code faisant référence au BallInflater car 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
2013-03-11 Réorganisation des SID des messages CAN des actions + ajout des messages CAN pour le Hammer (bras tapant les bougies du bas). La commande en position sera envoyé avec le message (au lieu d'avoir des 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
2013-03-12 Ajout de code de récupération des valeurs de potentiomètre lors de l'appui sur le bouton 3 et de la rotation de la pince à assiette dans main.c Il n'y a pas d'attente de la fin du gonflage du ballon 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
2013-03-12 Ajout d'une precision sur le retour du message ACT_RESULT lors d'une commande de gonflage du ballon Mise en commentaire total de la fonction DCM_sendCAN car elle est static et non utilisé, évite un w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
2013-03-13 Modif des paramètres du potar de rotation assiette Ajout du code de gestion des ascenseurs + leur pince
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2013-03-13 calibration depuis le bord puis collé au bord en fin de calibration
2013-03-14 modif balise mère pour compatibilités modifs récentes du driver XBEE. + code utilisable sur balise.
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2013-03-14 Ajout config plate + petite modif + ajout plate prepare position dans act_functions Todo: gérer _OTHER
2013-03-14 Suppression des anciennes fonctions ball_grabber et hammer de act_function + mise a jour de action_tests avec les nouvelles fonctions. Les fonctions gérant le Hammer doivent passer en paramètre de po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
2013-03-15 COrrection désactivation tléémètres sur Strat. + merge.
    [detection.c, detection.h]
2013-03-15 Délay au démarrage de la super ++ pour l'attente des autres cartes.
2013-03-16 Ajout message CAN pour la gestion des cerises et de la detection de leur couleur
2013-03-16 Ajout de la gestion des cerises et de la detection de leur couleur (KBall_sorter) + modif de detection d'erreur dans une queue dans les autres actionneurs Projet MPLAB X mis à jour (ajouté KBall_sort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
2013-03-17 Ajout d'un Makefile - corrections diverses - ajout d'une vue de l'adversaire et de la consigne de gotopos.... A tester.
2013-03-17 Ajout message CAN de retour de detection des cerises et des bougies au lieu d'utiliser le message ACT_RESULT. Modifs dans le driver du capteur Tri Tronics CW-x + précision dans les commentaires
2013-03-17 Finition de l'actionneur Candle_color_sensor (capteur Tri-Tronics sur AX12) (ajout dans global_config de constante de description de couleur pour la detection analogique) Maj de TODO et Fixme -> FIXM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
2013-03-17 Ajout de plus de capteur lorsque on appui sur le bouton 4. Les boutons 1, 2 et 3 correspondent à la rotation d'assiette: vertical, oblique, horizontal
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2013-03-18 Resolution d'un bug dans check_result (act_functions.c) Maj texte debug non cohérent (push_plate*) Ajout ID AX12 de Krusty et Tiny
    [act_functions.c]
2013-03-18 Changement majeur dans la gestion des actionneurs coté strat: utilisation d'une file au lieu de la pile (queue.c/h) Ajouté queue.h/c au projet mplab X
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2013-03-20 Changement du niveau de debug d'un message de debuggage de Error à Debug (il indique quand on reçois un résultat Ok, ce n'est pas une erreur mais un message de debug seulement) (très mineur comme cha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
    [act_functions.c]
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2013-03-21 Suppression des restes de act_function utilisant la stack + maj config lift
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2013-03-21 correction mineure pour éviter le spam/.
    [debug.c, odometry.c]
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2013-03-23 Définition des angles limites au max (0-300°) dans l'init des ax12 Ajout de l'init de l'ADC dans hammer et long_hammer + dcm_stop pour long_hammer après la config Ajout de constante de config pour po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
2013-03-23 Ajout des dernières actions possibles faites par la carte actionneur dans act_function.c/h Rearrangement du coe dans act_function Propagation des renommages des fonctions dans act_function Déplacemen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
2013-03-23 Ajout du support de composant à output_log pour pouvoir afficher les printf que d'un (ou plusieurs) actionneurs sans mettre en commentaire ceux qu'on ne veux pas voir.
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2013-03-23 Ajout de la possibilité de desactiver temporairement un watchdog, dans le cas de section critique par exemple. Utilisé par le driver ax12
2013-03-23 la mise a jour du compteur de temps d'appui de QS_button est effectué par clock economisant 1 timer. clock et le driver ax12 utilisent maintenant QS_watchdog économisant 1 timer. Résultat: Timer 1 po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
2013-03-25 Maj anti bug + config
    [Global_config.h, clock.c, main.c]
2013-03-25 Ajout du support des interrupteurs (switch) pour permettre d'avoir plusieurs actions sur les boutons sans recompiler (switchs de la carte facto)
2013-03-26 Ajout d'une verif de l'ID de servo dans le paquet de retour (j'ai cru voir des 255 parfois, et le tableau derrière n'a pas 255 cases ...)
2013-03-26 Centralisation de l'envoi des messages de retours vers la strat, permettra de verifier le resultat pour le test des actionneurs et permet l'affichage (sur uart) d'info détaillées (incluant la plupart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
2013-03-26 Suppression des anciens enum ACT_STACK_* de Stack.h (comme ça pas d'utilisation sans le vouloir, act_function.h/c utilise la queue.h/c maintenant) Ajout du support pour l'enum de avoidance.h (IN_PROG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
    [act_functions.c, act_functions.h]
2013-03-27 Config Klift mauvais sens translation lift left + ax12 -> inversion des signes
2013-03-27 Ajout de tests dans AX12 + FIXME pour le bug de timing Preimplementation d'une version permettant de detecter les appui long sans avoir besoin de relacher le bouton (cette version est mise en comment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
2013-03-27 Ajout de fonction CAN_send et autre dans Can_msg_processing qui sont compilé lors USE_CAN n'est pas défini pour permettre la compilation sans erreur et sans boucler sur le CAN (qui ne répondra pas de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
2013-03-28 lanceur de balle avec angle ok ; il reste la vitesse du moteur à regler : bug avec l'ax12
2013-03-29 Ball_inflater utilise maintenant une PWM a 2.5kHz (5 %tage posibles: 0, 25, 50, 75, 100, temps minimal d'une pulse: 100us) pour demarrer le moteur plus doucement et eviter une trop grosse chute de te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
    [main.c]
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2013-04-03 Comportement de PING avant le début du match en stratégie : -> Envoi périodique (1 seconde) d'un PING vers l'autre carte stratégie jusqu'à ce que réception d'un PING ou d'un PONG. -> Envoi d'un PONG 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
    [brain.c, clock.c, environment.c, environment.h]
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2013-04-04 Séparation des configurations des actionneurs pour une compilation plus rapide lors de réglages (l'association port <-> actionneur reste dans le global_config ansi que les ID ou autre qui doivent êtr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
2013-04-04 correction envoi periodite asser
    [Global_config.h, avoidance.c]
2013-04-04 Changement de position de la pince a assiette suite au reserrage du potar
2013-04-04 Initialisation des variables contenant les infos textuelles des messages de retours. (J'ai vu un Trap address derrière le "error: " dans CAN_printResult, mais pourtant il y a un default dans tous les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
2013-04-05 Clean de code balllauncher + ajout plate ax12 en bouton de strat
2013-04-05 Reaugmentation de la stack à la valeur d'origine, l'asser s'en sert et il n'y a plus les actionneurs -> moins de mémoire prise par la stack
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2013-04-07 (voir mail du 7/4/13)
    -> en multipoint, le message permettant d'informer la stratégie que l'on change de point n'était pas le bon.
    * Dans le code propulsion, la réception d'un message de FREINAGE nous informe du changement de point. Il devient alors possible de savoir à quel point on est rendu lors d'une trajectoire multipoint... Bien que je pense qu'il soit plus intéressant pour paufiner vos décisions d'évitement haut niveau en fonction de la position plus qu'en fonction du point atteint.
    -> J'ai mis à jour la gestion des "avertisseurs" (warner) de la propulsion.
    Vous pouvez ainsi :
    * appeler les fonctions ASSER_WARNER_arm_x, y ou teta...
    * ces fonctions arment un avertisseur sur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
2013-04-07 Ajout infos cablage tritronics CW-2
    [_PORTS.xlsx]
2013-04-07 Ajout de fonction pour stoper les actionneurs sur un BROADCAST_STOP_ALL. Les actionneurs doivent arrêter leur action en cours. Dans tous les cas, Can_msg_processing vide la QUEUE et stoppe les asserv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
2013-04-07 Correction calibration / renommage FORWARD_OR_BACKWARD -> ANY_WAY pour conformité QS.
    [copilot.c, pilot.c, secretary.c, sequences.c, sequences.h]
2013-04-07 correction des positions de calage. (relatives et dépendantes du robot !)
    [sequences.c]
2013-04-07 Ajout de la séparation des composants pour l'affichage des messages avec OUTPUT_LOG Remplacement des debug_printf de queue.c par des OUTPUTLOG_printf (par l'intermédiaire COMPONENT_*)
2013-04-07 Restauration d'un trajectoire sans effet en fin de calibration pour déclencher l'aqcuittement. Correction du coef de callage pour TINY
    [_Propulsion_config.h, sequences.c]
2013-04-07 Stratégie qui compile pour TINY. (un premier pas...) ASSER_way_e -> way_e pour conformité QS. REAR devient BACKWARD (partout !) Correction des premières trajectoires des matchs.. pour Krusty (600 au 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
    [Pathfind.c, Pathfind.h, act_functions.c, act_functions.h, asser_types.h, avoidance.c, avoidance.h, brain.c]
2013-04-07 Main: le bouton 4 affiche l'angle du bras pour Tiny et non la valeur du potar (car inutile pour le message CAN, il nous faut les degrés) Output_log: ajout de l'include <stdarg.h> qui pouvait manquer 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
2013-04-07 Clean des #include QS_canmsglist.h dans les fichier de strat, ACTIONS_TEST_C n'est plus valide maintenant (et CAN_msg_t n'est pas utilisé dans les fichiers de strat .c)
2013-04-07 Ajout de position initiale pour les actionneurs, au démarrage on connait leur position. Non testé Factorisation de l'intialisation des ax12 des 2 ascensseurs (KLift) en une boucle for Le message CAN 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
2013-04-08 Baisse de la puissance du Hammer de Tiny pour eviter de forcer trop fort sur les engrenages
2013-04-08 Ajout de la possibilité de changer les coefs d'asservissement en fonctionnement (Kp, Ki et Kd) (Utilisé par KPlate qui doit avoir des coefs différents suivant le sens du mouvement) Précision du comme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
2013-04-08 Utilisation de coefs d'asservissement différents lorsque que l'on va vers la position horizontale de l'assiette, pour eviter de taper le sol trop fort, non testé
2013-04-08 Clean des TODOs Detection d'une erreur uniquement lorsque l'ax12 nous renvoie OVERHEATING ou OVERLOAD (sauf pour Lift et Plate ou l'overload est normal car il y a serrage), les autres ne devrait jama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
    [main.c]
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2013-04-09 Corrections diverses... ACT_hammer n'envoie pas de msg can ??
    [_Propulsion_config.h, environment.c, secretary.c, warner.c]
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2013-04-09 Le code de Tiny ne fonctionne pas encore très bien... mais ca avance...
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2013-04-09 Ball_sorter: si on timeout, on verifie si la position de l'ax12 est proche du but (avec une moins bonne précision que le epsilon normal qui joue sur le timing de l'arrivée au but) queue: changement d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
    [Global_config.h, main.c, queue.c]
2013-04-10 Ajout d'un argument pour les goto_pos qui précise si l'action se termine LORS DU FREINAGE ou LORS DE l'ARRIVEE... Voir ASSER_end_condition_e Codé non testé. Modification de tout les appels goto_pos
2013-04-10 Ajout de la gestion de l'octet de status envoyé par la propulsion à la stratégie (octet 7 des messages propulsion contenant la position)... Ajout sécurité sur le CAN si size > 8.
2013-04-10 Début de gestion de la dispo de U1TX sur IT. (pour carte SUPERVISION essentiellement...)
2013-04-10 Correction facheuse d'homogénéité... sur détection d'arrive en angle
    [copilot.c]
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2013-04-10 correction facheuse... suite... et fin (?)
    [copilot.c]
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2013-04-12 Correction de l'IT désactivée sur réception de position propulsion.
    [environment.c]
2013-04-12 Strat tiny à tester... Si elle ne fonctionne pas bien... pour la belgique, remplacer "state = SUB_WHITE_CANDLE;" par "state = DONE" dans le case GOTO_MIDLE_OF_AREA...
2013-04-15 Maj config coupe belgique + appui plus fort pour le bras de tiny pour les bougies
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2013-04-15 Changement du comportement du message CAN actionneur ACT_BALLSORTER_TAKE_NEXT_CHERRY: gère le lanceur de balle après la detection automatiquement si une vitesse sur 16 bits est donnée (sinon fonction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
2013-04-15 - Changement du comportement du message CAN actionneur ACT_BALLSORTER_TAKE_NEXT_CHERRY: gère le lanceur de balle après la detection automatiquement si une vitesse sur 16 bits est donnée (sinon foncti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
2013-04-15 Ball_sorter: la vérification de la taille du message CAN était incorrecte: une message CAN contenant une vitesse sur 16 bits doit faire au moins 3 octets de données et non 2
2013-04-15 > Ajout d'une fonction (ACT_ball_sorter_next_autoset_speed) pour ejecter une cerise et en prendre une autre. Fait automatiquement une demande d'ejection de la cerise prise à la bonne vitesse et en pr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
2013-04-16 try_going pour Tiny / correction angle de broadcast_position périodique / ajout d'une procédure de mesure de la durée de la tache de fond strat.
    [avoidance.c, main.c]
2013-04-16 correction try_going débug stratégie de test de l'évittement retrait de la fonctionnalité de recul en cas d'erreur asser débug fonctionnalité d'affichage de la durée de la boucle main.
    [avoidance.c, brain.c, environment.c, main.c]
2013-04-16 Distance d'évitement constante (dépend pas de la vitesse, à changer), define dans avoidance.c Ajout de variable dans environment.h pour avoir la vitesse du robot pour calculer une distance d'évitemen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
    [avoidance.c, environment.h]
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2013-04-17 Correction du bug qui fait qu'on se prend des NOT_HANDLED à chaque fin de trajectoire... pour toutes les trajs qui suivent une même et unique erreur timeout.
    [avoidance.c]
2013-04-17 Utilisation de la vitesse pour avoir une distance d'évitement. Coef non réglé (DETECTION_DIST_MIN_KRUSTY, DETECTION_DIST_MIN_TINY, DETECTION_DIST_SPEED_FACTOR_KRUSTY, DETECTION_DIST_SPEED_FACTOR_TINY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
2013-04-17 correction passage de vitesse rot et trans de prop vers strat.
    [brain.c, secretary.c]
2013-04-18 Support pour le sick capteur couleur pour les cerises (+ info sur docklight sur appui btn 4) Ajout de foe_in_path dans error_e, utilisé lors d'un evitement nécessaire pour bouger Changement TEST ENVO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
    [avoidance.c, avoidance.h, main.c]
2013-04-18 rb12 et rb13 + infos sick
    [_PORTS.xls]
2013-04-18 deplacement de try_going dans avoidance.c Implémentation de la fonction lacher verres
    [avoidance.c, avoidance.h]
2013-04-18 Clean strat, le merge précédent à foiré = tout le texte du fichier en double ... Support des niveau logique inversé Fin de l'ajout de foe_in_path dans avoidance.c Ajout strat de test de foe_in_path
    [avoidance.c, avoidance.h, brain.c, environment.c, main.c]
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2013-04-19 Correction bug Ball_sorter: la couleur prise n'était pas valide (variable mal initialisé) N'affiche plus <CR><LF> dans docklight en boucle quand verbose_mode est activé
    [Global_config.h, avoidance.c, environment.c, main.c]
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2013-04-19 Rajout du cooking du gato ! et modification de masse des strats pour tiny
2013-04-21 Ajout de l'action ACT_HAMMER_BLOW_CANDLE pour souffler une bougie suivant sa couleur (qui est gérée coté actionneur)
2013-04-21 Ajout d'un fichier act_queue_utils.h/c qui contient des fonctions liées à la gestion des actions niveau file et des résultats Factorisation de la gestion des erreurs des ax12 et moteur CC (DCMotor) a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
2013-04-21 Ajout des définitions des ports des canaux du tritronics (capteur couleur pour bougie) Ajout des fichiers act_queue_utils.h/c au svn ...
2013-04-21 Ajout de la fonction ACT_hammer_blow_candle qui souffle une bougie si sa couleur est bonne (blanche ou notre couleur). La gestion de la couleur est faite coté actionneur. Rearrangement des états des 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
2013-04-22 changement des strats de tiny , ajout du tableau pour les coordonnées du gateau... , des sous sous error_e et d'une sale boucle for.
2013-04-22 Correction bug jamais de timeout pour STACKS_wait_end_auto_pull Ajout d'une fonction wait_move_and_scan_foe2 sans gestion de vitesse/esquive Remise en place des actionneurs automatique après l'alim 2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
    [avoidance.c, queue.h]
2013-04-22 Tiny: rajout de l'argument "sens" afin de parcourir le gateau dans les 2 sens.
2013-04-22 Corrections et relecture de la strat générique pour les bougies.
2013-04-23 TINY : Petites modifs de strat afin de rendre le gato presque "parfait".
2013-04-23 Config hammer Changement strategie de timeout pour NO_DODGE_AND_WAIT, on ne compte que le temps passé arrêté
2013-04-23 Correction d'un bug possible si on utilisait NO_AVOIDANCE, on ne retournait pas IN_PROGRESS a la fin de la gestion du mouvement sans evitement (fin du IF)
    [avoidance.c]
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2013-04-24 ASSER_stop utilise la pile current_trajectory contient des bits informant si le robot fait une translation ou rotation Config distance evitement
2013-04-24 TINY : rajout des deux micro strats permettant de faire les cadeaux oubliés.
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2013-04-24 Correction bug de compilation bizarre: un point virgule manquant Suppression de global.env.asser.current_trajectory -> ajout de is_in_translation et is_in_rotation + maj des utilisations de ces varia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
    [Global_config.h, avoidance.c, environment.c, environment.h]
2013-04-24 Maj commentaire de message CAN venant de la carte propulsion (trajectoire qui devient info si robot en translation et/ou rotation)
2013-04-24 Ajout du message CAN pour gérer les pinces à verres de tiny
2013-04-24 Ajout de la gestion des bras de tiny pour prendre des verres en carte actionneur, non testé Ajout des 3 nouveaux fichiers au projet MPLAB X
2013-04-24 Ajout effectif des 3 nouveaux fichier au svn ... Ajout des nouvelles fonctionnalité des bras à verre dans TActManager
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2013-04-25 MODIF BALISE RECEPTRICE US !! But de la modif: parfois le bit de fiabilité ERREUR_PAS_DE_SYNCHRO passait à 1 et y restait pendant un match (après synchro), rendant les US non utilisé: - Utilisation d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
2013-04-25 Evitement: ajustement du temps d'arret des robots + utilisation du 32bit pour calculer la distance d'evitement Gestion du TROP_DE_SIGNAL des balises comme distance = 0, on considère que trop de signa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
2013-04-25 Nom de header dans les #includes changé pour respecter la casse (car linux aime pas ...) (genre QS_ADC.h -> QS_adc.h)
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2013-04-25 Balise receptrice US: Verification de l'amplitude du signal convolué pour savoir si on doit lever le flag SIGNAL_INSUFFISANT
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2013-04-26 correction facheuse dans un code qui sera de toute façon jamais appelé... mais c'est pour la gloire... je le retesterai...
2013-04-26 Affinement strat verre alexis + ajout try_relative_move même ordre d'idée que les autre try_* Config plate: ajustement de la position horizontale
2013-04-27 - Mise en commentaire de #warning lié a des debug_printf eux même en commentaire (trop de warning tue le warning) - Reutilisation des matchs 90sec au lieu de match infini (+ #warning associé en comme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
2013-04-27 - Suppression d'un code de debuggage pour afficher le signal convolué lorsque la distance détéctée <= 0 pour ne pas l'oublier à la coupe - Changement de la distance minimal de TAILLE_FENETRE+1 à TAIL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
2013-04-27 - Rétablissement de l'action "SORTIR" dans K_Strat_Coupe au démarrage. Ca avait été changé vendredi pour tester des strat complète, verre puis assiette - Mise en commentaire du code qui considérait l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
2013-04-28 - Clean des includes de output_log.h, c'était un peu n'importe quoi et ça loupait le fait qu'on voulait l'activer - Ajout strat d'assiette dans actions_cherries.c/h, partiellement vérifié, non testé 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
2013-04-28 Maj de commentaire pour ACT_NO_ERROR_HANDLING de act_functions et pour CUSTOM de l'enum ASSER_speed_e
2013-04-29 Simulateur EVE: Ajout de structure pour PORTB et PORTE Ajout de l'init des structure PORTB et PORTE pour utiliser la strat 1 et ne pas detecter de verres (normalement ...) Ajout de l'initialisation d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
2013-04-29 Simulateur EVE: Changement du moment ou on initialise EVE: au tout début, sinon risque de plantage si un module à besoin de la QS et que EVE n'est pas initialisé ...
2013-04-29 Amélioration des points du 2ème chemin pour la strat de verres: 3sec on est au milieu, ~14sec de strat entièrement (proche du chemin d'avant) Strat d'assiette de Alexis: Changement d'état ajouté + un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
2013-04-29 La config de TPlier n'est pas prête, désactivation de l'actionneur pour l'instant (evite de tout casser si la strat essaye de l'utiliser ..., la carte actionneur renverra toujours Ok et ne bougera pa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
2013-04-29 Les messages CAN ne sont plus envoyé à la carte qui envoie le message Ajout d'un header timer.h necessaire pour la carte prop qui à besoin de DisableTxInt et EnableTxInt Maj du Makefile: code des car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
2013-05-01 Ajout du support de END_AT_BREAK pour le multipoint et relative_move Ajout d'une variable global.env.pos.nb_points_reached qui contient le nombre de point atteint en multipoint. (Pour savoir ou on es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
2013-05-01 Correction commentaire pour la config d'odometrie en translation
    [_Propulsion_config.h]
2013-05-01 Augmentation de la taille du buffer de MAILBOX, quand on reçoit beaucoup de message CAN d'un coup (par exemple une trajectoire avec bcp de point) on peut les stocker tous. Changement de la casse d'un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
2013-05-02 Glasses: on se tourne droit avant de poser les verres, quand on reculera on les poussera pas en tournant si on était arrivé de travers Evitement: Début de correction de global.env.debug_force_foe, je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
    [avoidance.c]
2013-05-02 Correction du debug_force_foe quand NO_AVOIDANCE était utilisé. On force quand même la detection, car quand on veut forcer une detection, c'est qu'on est conscient qu'on force, donc on sait qu'on for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
    Testé en simulation et fonctionnel
    [avoidance.c]
2013-05-02 Avoidance : gestion des déclenchements manuels. Srat Tiny++
    [avoidance.c]
2013-05-02 Changement du type d'évitement pour le déplacement vers l'ennemi
    Ajout de la gestion des zones ou un seul robot ne doit pouvoir y être (la gestion n'est pas faite en strat par contre)
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2013-05-02 Maj mutex de zone: la gestion des messages CAN devrait marcher (en gros les bonnes fonctions sont bien appelée) + ajout de la possibiliter de libérer une zone avec ZONE_unlock
2013-05-02 Début de stratégie de vol chez l'adversaire. Pour l'instant, je fais des allers retours en permanence sur le segment prévu pour le SCAN...
2013-05-02 Si on ne peut pas déposer les verres dans la zone de départ a la fin de la strat verre, on le fera après Ajout d'une fonction pour récupérer l'état d'une zone
2013-05-02 Zone Mutex: ajout d'affichage de changement d'état pour debuggage Strat des verres: gestion de la zone de départ de Tiny Ok (testé avec simulateur)
2013-05-02 Maj de CANmsgList de la QSx86 Implémentation de la fonctionnalité d'injection de message CAN Makefile: affichage des warnings
2013-05-02 Zone mutex: - Reduction du timeout d'attente réponse de l'autre robot - Ajout de l'init dans le main Si les verres n'avait pas été déposé, on le fait a la fin
2013-05-03 Clean debug strat verres Correction de warnings 20sec avant la fin du match on va déposer les verres si on les avait gardés
    [zone_mutex.c]
2013-05-03 Stratégie de vol chez l'adversaire... Mérite des tests avant activation en production !
2013-05-03 Ajout de gestion de l'évitement lors des déplacements d'une assiette à une autre + maj dans l'environnement des assiettes faites. Pas fini, mais le cas nominal "a l'air" de marcher, test en simu a po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
2013-05-04 Boutons: 3: ouvre les pinces de Tiny, 4: ferme les pinces de Tiny Strat cerises Krusty: l'accès au assiette se fait sur une grille, en cas d'évitement on contourne l'obstacle. Si on ne peut pas, on e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
    [Global_config.h, button.c]
2013-05-04 Ajout de la possibilité de prendre une assiette par le coté au lieu de par haut dessus comme avant
2013-05-05 Déplacement de l'endroit ou on dépose les verres dans la case de Krusty: on les met plus du coté des cadeaux (pour laisser la place pour lacher l'assiette 3 en mode bleu) Coté bleu: assiette 3 et 4 f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
2013-05-05 Krusty: Utilisation de la strat des verres pour l'homologation avec gestion d'évitement pour tous les mouvements fait (on passe au point suivant de la trajectoire multipoint en cas d'evitement)
2013-05-05 Correction de la detection de arrived_rotation: on prenait la valeur absolue avant de faire le modulo pour savoir si l'angle était petit Suppression de l'include QS_type de global_config => ce n'est 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
    [Global_config.h, copilot.c]
2013-05-05 Nettoyage de code: - Krusty est toujours sur la même case => l'affectation "calibration = " est sortie du switch - Suppression d'includes redondant dans actions_tests_krusty.h
2013-05-05 Suppression des default vides dans les switchs, ajout du cas case FOE_IN_PATH qui fait pareil que NOT_HANDLED. La ou NOT_HANDLED ne faisait rien, j'ai mis le code qu'il y avait pour END_WITH_TIMEOUT
2013-05-06 Strat assiette: Modif des positions: elles étaient trop loin des assiettes Desactivation du verbose_mode
2013-05-06 Désactivation de printf en strat. Réglage de quelques constantes pour cadeau et gateau. Réglage odométrie rotation Tiny.
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2013-05-06 Ajout de fonction pour envoyer sur le CAN les changements d'états. STATECHANGED_log affiche sur l'uart si le niveau de debug est >= à LOG_LEVEL_Info, et envoie toujours sur le CAN avec le sid DEBUG_S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
2013-05-06 fin de strat de tiny à tester. (en cas de STEAL désactivé... attente au milieu de la zone adverse..)
2013-05-06 Ajout du message CAN DEBUG_STRAT_STATE_CHANGED, utilisé pour notifier les changements d'état en strat
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2013-05-08 Strat 4 cadeaux pr homologation... (switch 3) COrrection zone conflit à coté du gateau
    [brain.c]
2013-05-08 ajout try_going_slow corrections bugs forgotten candle
    [avoidance.c, avoidance.h]
2013-05-08 Correction de backward
2013-05-08 Correction du steal. Steal en strat 2.
    [Global_config.h, brain.c]
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2013-05-08 Correction angle evitement en backward
    [avoidance.c]
2013-05-08 Déplacement de la fonction 'void CAN_send_sid(Uint11 sid)' de can_utils.c/h de la carte strat vers la QS_can.c/h pour utilisation par toutes les cartes
2013-05-08 Petit oublie du commit précédent: suppression du prototype 'void CAN_send_sid(Uint11 sid)' de can_utils.h
2013-05-08 Config glasses & cherries Verif si on veut poser les verres dans la case de Tiny => verif zone Ajout USE_SPECIAL_CASE_PLATE_BLEU
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2013-05-08 Balise réceptrice US : quelques corrections / envois de msg toutes les 200ms /
    [avoidance.c]
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2013-05-09 Corrections de pb sur la synchro balises.
    [Global_config.h, brain.c, brain.h, main.c, secretary.c]
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2013-05-09 Bidouille config assiette: - Angle pour lacher les assiettes: 45° => 0° - Début du sérage de l'assiette plus tard (car le warner ne peut pas être préci) - Début du grab_plate plus loin de l'assiette,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
2013-05-09 Tiny: - state == ETAT; => state = ETAT; (voir diff si vous voulez savoir quelle fonction . switch / ligne :) - Ajout d'un argument dans ACT_ball_sorter_next_autoset_speed pour garder une cerise blanc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
2013-05-10 bug de merde avoidance !
    [avoidance.c, brain.c, main.c]
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2013-05-10 Modif vitesse fixe 2000tr/min pour les pourries
    [main.c]
2013-05-10 Zone timeout d'attente réponse = 0 (car pas de zigbee) Correction ACT_ball_sorter_next_autoset_speed pour keep_ball Correction ACT_ball_sorter_next_autoset_speed en parallèle des autres actions d'ass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
    [act_functions.c, zone_mutex.c]
2013-05-10 Pas de gestion de la couleur des cerises Si l'ultrason donne des distances différente de l'IR de plus de 1m => US pas fiable + envoi msg can Sur glasses: evitement WAIT 2sec
2013-05-10 Verres déposé plus loin du mur (évite de le toucher) x = 200
2013-05-10 c'est carrément mieux comme ca... + de rapidité... ajout d'un timeout sur gateau
2013-05-10 Ajout de la fonction pour déposer les verres a une position quelconque
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2013-05-11 Ajout strat match finales pour Krusty: verre dans dernière case Modif de d'autre fonctions de verres pour être partagée par les 2 strats Nouvelle strat en numéro 2
2013-05-11 Bras de Tiny: ouverture / fermeture en parallèle + fermeture auto a l'alim
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2013-05-11 Cherries: move_to tente d'aller direct a la cible, et utilise les points en cas d'évitement. Si pas d'adversaire, on accelère les mouvements
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2013-05-19 Ajout projet QS v2 STM32 basé a moitié sur la version d'avant et sur la QS du PIC actuelle Compilation Ok Jamais testé Toute la QS n'est pas présente
    [Global_config.h, main.c]
2013-05-20 STM32: Correction de bug et ajout de fichier QS (a partir de la QS actuelle)
    [Global_config.h, QS_DCMotor2.c, QS_DCMotor2.h, QS_servo.c, QS_servo.h]
2013-05-20 STM32: Ajout de d'autre implémentation de fichier QS + factorisation gestion du choix du timer pour tous les modules QS (avec QS_setTimerSource.h) Ajout champ de bit pour les GPIO dans le header stm3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
2013-05-20 STM32: Changement de fonction pour désactiver les IT temporairement, on évite de perdre une éventuelle IT pendant qu'elle est désactivée Ajout CAN Ajout gestion de timing de la FLASH dans QS_sys Chan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
2013-05-21 Evolution importante dans le code de propulsion. Asservissement en angle sans changement de trajectoire du point fictif dès qu'on est en ligne de mire. Les premiers tests sont sympa.. quelques instab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
2013-05-21 STM32: Acceleration des builds, includes la ou il faut (stm32f4xx_*) Programme de test timer + buttons
2013-05-22 STM32: Resolution de problème de detection de chemin include du compilateur pour le parser de eclipse Quand on change un .h, ça recompile correctement les .c qui l'utilise Les ports de programmation 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
    [Global_config.h]
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2013-05-26 STM32 - Renomage BaseProject Debug *.launch en Project Debug *.launch - Etat des tests de la QS dans info.txt - La libstm32f4xx contient le fichier startup et system_stm32f4xx.c - Ajout de QS_clocks_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
2013-05-26 STM32 Correction bug ADC Tests: CAN en loopback, Appui long sur bouton (1s), TIMER avec IT off (pour gérer les cas de préemption), PWM init mais pas run
    [main.c]
2013-05-27 STM32: Tests fait infos dans info.txt Timer: clear de l'IT causé par l'init des timers Correction typo pwm run_fine Ajout filtre vide pour la carte super (can) (il en faut au moins 1 pour autoriser l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
    [Global_config.h, main.c]
2013-05-28 STM32: entry point: Reset_Handler test a faire implémenté
    [Global_config.h, main.c]
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2013-05-30 STM32: ADC: en fait il n'y a pas de fonction de calibration ... ADC toujours en ref externe
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2013-05-31 Tableau utilisation des pin stm32 + pdf usb library
    [pin_usages.ods]
2013-05-31 STM32: Ajout de la gestion de certains port qui ne sont en fait pas utilisé par l'interface de programmation (stlink) Correction erreur dans pin_usages.ods info.txt avec fin de ligne windows pour etr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
    [pin_usages.ods]
2013-06-01 STM32: Pour tests: uart 1 et 2 @ 1 Mbps, envoi en boucle de "test\n" pour tester printf
2013-06-03 STM32: test dcmotor & qei + changement ports pour qei2
    [pin_usages.ods]
2013-06-03 Ajout de _LARGEARRAY et des macro PSV_* permettant la gestion des grand tableau sur dspic et stm32 de manière identique dans le code hors QS Ajout de la gestion des traps dans QS_trap_handler (car li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
2013-06-03 Prop: Clean espaces en fin de ligne (mais peut être pas tous) Modification du code lié au pic pour être portable sur d'autre micropro Déplacement du code gérant les traps dans QS_trap_handlers.c/h Aj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
2013-06-03 STM32: Ajout de _LARGEARRAY et des macro PSV_* permettant la gestion des grand tableau sur dspic et stm32 de manière identique dans le code hors QS Ajout de la gestion des traps dans QS_trap_handler 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
    Ajout de QS_who_am_i et de d'autre fichier QS manquant + QS_trap_handler qui affiche l'état du programme lors d'une erreur qui passe en trap
2013-06-03 STM32: activation du lancement d'un exception en cas de division par 0 Ajout d'un test division par 0 pour tester les trap_handlers
2013-06-04 prop: init de QS_WHO_AM_I même sans être sur FDP_2013, le cas du FDP_2013 ou pas est déjà géré dans cette QS. (et faut forcément l'initaliser sinon aura rien found et donc assert)
2013-06-04 prop: numéro des PWM des moteurs dans des paramètres (car pas les mêmes sur STM32)
2013-08-18 Corrections soft pour compilation sous STM32.
    [Pathfind.h, avoidance.c, avoidance.h]
2013-08-19 Portage du code de stratégie pour STM32. Rétrocompatibilité dsPIC OK (voir le define TARGET_xxx dans Global_config.h
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2013-08-23 PORTAGE STM32 + INTEGRATION DU CODE SUPERVISION DANS LE CODE DE STRATEGIE.
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2013-08-25 XBee : mise à jour du code stratégie. (les messages XBEE ne passent plus par le can...) Les ping/pong sont plus direct...
2013-08-28 XBEE ; correction du filtre. Passage à 160MHz. EEPROM : corrections diverses et portage vers STM32. EEPROM_CAN_MSG : amélioration des fonctions de test RTC : portage pour STM32
    [Global_config.h, environment.c]
2013-09-01 Intégration d'un module de gestion de la carte SD. Voir SD.c pour le TODOlist...
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2013-09-04 Ménage dans le code RTC : date sous la forme de structure... + on garde seulement le portage STM32.
2013-09-04 Utilisation de la carte SD... création du code permettant d'y stocker les matchs...
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2013-09-12 Changed \ to / in includes (button.c) Updated Makefile to use SuperStrat.files and SuperStrat.includes for files to compile and include directories (-I switch) - To open the project on QtCreator, ope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
    (out-of-source builds are not possible with just a makefile, but generated files are in svn:ignore)
2013-09-13 Nettoyage pour XBee -> partiellement validé SD : tentative infructueuse de DMA
2013-09-13 SD & DMA: *_BASE sont des adresses des registres, il ne faut pas le mettre (DMA1_Stream2 au lieu de DMA1_Stream2_BASE par ex)
    Maj de la config à compléter, utilisation de QS_adc.c pour exemple (qui marche)
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2013-09-15 Carte Puissance 2011, ajout des sources manquantes. Renommage carte puissance 2013 -> carte puissance L203 (carte développées mais non fabriquées) Mise à jour librairie altium
    [2011_CARTE_PUISSANCE.PCBDOC, 2011_CARTE_PUISSANCE.PRJPCB, 2011_CARTE_PUISSANCE.SchDoc, 2013_CARTE_PUISSANCE.PCBDOC, 2013_CARTE_PUISSANCE.PRJPCB, 2013_CARTE_PUISSANCE.SchDoc, _ROBOT.PcbLib, _ROBOT.SchLib]
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2013-09-15 Corrections potentielle de bug... à tester.
2013-09-15 Sécurité watchdog: ne pas utiliser un watchdog pour gerer les watchdog, sinon il y aura boucle récursive à l'init (ça ne devrait jamais arriver, mais on ne sait jamais ce qu'il y a dans les autres .h)
2013-09-15 Correction de warning à propos de variable non initialisées et verif de i lors de l'écriture dans msg.data, même les bugs improbable peuvent arriver.
2013-09-16 Gestion DMA du driver carte SD. Utilisation uniquement en transmission uc -> SD. Si le lecteur de carte retourne une erreur à la transmission, elle est ignoré (car on a déjà return de la fonction wri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
    Lors d'une transmission:
    - Une copie du buffer du secteur à écrire est copié par DMA dans dma_send_buffer.
    - DMA envoie avec SPI les 515 octets de dma_send_buffer avec 512 du secteur + 2 pour lire le CRC (non utilisé) et 1 pour lire le resultat de l'opération (ignoré)
    - On retourne de la fonction d'écriture dès que DMA est lancé pour copier dma_send_buffer vers le periph SPI
    - Dans quel cas le lecteur de carte refuse l'écriture ? (à part le cas ou il n'y a pas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
2013-09-16 Changement des constantes de commande pour des noms plus explicites que des nombres
2013-09-16 Modif de u1rxtocanmsg.. pour pouvoir utiliser le terminal en permanence ET la réception de msg can sur UART.
2013-09-16 Modif de u1rxtocanmsg.. pour pouvoir utiliser le terminal en permanence ET la réception de msg can sur UART. ATTENTION, la rétrocompatibilité des codes utilisant cette fonction est cassée, prendre mo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
2013-09-16 Modif de u1rxtocanmsg.. pour conformité avec modifs récentes. Rétrocompatibilité dsPIC30F non cassée...
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2013-09-16 Changement DISABLE en ENABLE, on attend le DMA que s'il est actif et qu'il n'a pas terminé.
2013-09-16 Ajout AX12 stm32 (+ modif TIMER_SRC_TIMER_DisableIT/TIMER_SRC_TIMER_EnableIT changé en macro-fonction) Pas testé (mais compile)
2013-09-16 Si UARTx_BAUDRATE n'est pas défini, le mettre par défaut à 1,2Mbauds (peut être à changer ?)
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2013-09-17 maj pin usage. + datasheets Hokuyo + datasheet SAFT batterie utilisée dans les robots + datasheet Ecran LCD 4x20 MIDAS
    [pin_usages.xls]
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2013-09-18 modif hokuyo (rs232 pas dispo ! -> usb !) + retrait des BP inutiles sur la prop
    [pin_usages.xls]
2013-09-19 Suppression du goto_pos_with_scan_foe dans les try_going_* Petite modification pour l'écran LCD non fonctionnelles correction du Demarrage carte P -> S Code compile
    [avoidance.c, main.c]
2013-09-19 Fonction de tuto/TP/TD et tout ce qui commence par un T: la strategie pour les nuls
2013-09-19 FDP 2014
    [2014_FDP.PrjPcb, 2014_FDP_Generic_Port_Act.SchDoc, 2014_FDP_Generic_Port_Strat.SchDoc, 2014_FDP_SCHEMA.SchDoc]
2013-09-19 maj fdp 2014
    [2014_FDP.PrjPcb, 2014_FDP_SCHEMA.SchDoc]
2013-09-20 Code a tester pour comprendre le bogue qui fait que les matchs ne semblent plus sauvegardés... (vérifier l'analyse de la taille du fichier du match précédent...)
2013-09-20 correction d'un bug sur la mesure de la taille du fichier du précédent match correction d'un bug sur la réception des caractères sur l'UART2 quand le XBEE est désactivé -> l'UART2 n'est PLUS utilisé 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
    [environment.c]
2013-09-20 maj 2014_fdp
    [2014_FDP.PrjPcb]
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2013-09-22 actions avec versionning... mise à jour des fonctions d'avoidance (try_going...)
    [avoidance.c, avoidance.h]
2013-09-22 Correction d'un détail empechant de régler la fréquence max valable.
2013-09-22 pin_usage, correction des directions pour l'USB
    [pin_usages.xls]
2013-09-23 pin usage, correction mineure
    [pin_usages.xls]
2013-09-24 ajout d'un buzzer...
    [pin_usages.xls]
2013-09-25 Ajout CMakeLists.txt et .cmake pour géré la cross compilation (générateur de makefile: Unix Makefile)
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2013-09-27 Ajout .ARM.exidx et .ARM.extab et remise en forme des espaces Déplacement du fichier cmake générique à tous les projets dans la QS
2013-09-27 Cmake: devrait être complet. Meilleure gestion des targets pour le .lst et .bin. Ajout de commentaire et ajout du support pour des fichiers assembleur Renomage des include de asser_functions.h (probl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
2013-09-27 mise à jour pinout
    [pin_usages.xls]
2013-09-27 Correction warnings et timerSourceTruc.h. Ajout du portage QS_CapteurCouleurCW.h sur stm32
    [QS_DCMotor2.c, QS_DCMotor2.h]
2013-09-27 PASSAGE SUR STM32. Pour avoir la version PIC, il faut recup le code de la version 580. Changement des ports et mise en commentaire de l'actionneur Ball launcher. Le code compile pour Tiny et Krusty. 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
2013-09-27 Ajout Cmake + svn:ignore + dossier vide mais important pour les ../ (comme pour SuperStrat) Suppression projet MPLABX
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2013-10-02 QS_uart -> ajout de UART2TXINTERRUPT... + quelques modifs mineures. Code testé. (UART1 et UART2)
    [pin_usages.xls]
2013-10-02 Global_config -> envois sur UART en IT TX ! + quelques mises à jour de ports. Selftest/Main -> désactivation temporaire à cause de 2 leds retirées (ces infos seront visibles à l'écran)
2013-10-02 Correction watchdog: init du compteur à 0 à la creation Test AX12: utilisation du watchdog
    [Global_config.h]
2013-10-02 Simplification de la declaration de COMPONENT_log (uniquement pour KPlate.c, pour test, peut être que l'inclusion d'un .h serait encore plus pratique et simple)
2013-10-03 Prop: Include avec QS/ dans supervision.c Ajout CmakeLists.txt (même que pour la strategie sauf le nom de projet)
2013-10-03 Ajout des noms Pierre et Guy parallèlement à Krusty et Tiny => Pierre = Krusty; Guy = Tiny
2013-10-03 Création des fichiers d'action de strategie 2014 avec les robots Pierre et Guy Modifications dans la supervision concernant le LCD (non fonctionnel)
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2013-10-04 Separation en 2 fichiers act_can et act_function (act_can indépendant des actionneurs sur le robot)
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2013-10-04 Bulldozer terminal phase 2: portage dans des fonctions partiellement fait (pour les commandes principales). A suivre dans le prochain épisode: clean, renomage en nom standard (genre fk -> mkdir) et c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
2013-10-05 Terminal: séparation des commandes dans le dossier commands Renomage de certaine commandes (comme fk -> mkdir) Implementation de help en utilisant la liste des commandes
2013-10-06 Séparation en 2 fichiers de actions_utils.c/h: aide au machine à états (log des changements d'états et check des subaction) déplacé dans state_machine_helper.h/c
2013-10-06 Ajout de CREATE_MAE_WITH_VERBOSE. Modification de K_STRAT_micro_move_to_plate() dans actions_cherries.c comme exemple. Pour tester le preprocesseur: arm-none-eabi-gcc -E -Iprovide_parent_dir -Istm32f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
2013-10-06 Modif CREATE_MAE_WITH_VERBOSE: le tableau des noms des états (state_str) est mis en flash plutot qu'en RAM) const char * state_str[] -> static const char * const state_str[]
2013-10-06 Utilisation de CREATE_MAE_WITH_VERBOSE dans tout les codes de la coupe de Krusty (actions_glasses et actions_cherries) Ajout DECLARE_STATES pour juste déclarer l'enum state_e et le tableau state_str 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
2013-10-06 Ajout fichier des priorités, à confirmé (ne reflète pas le code actuel)
2013-10-06 Mise en place des modifs terminal + log dans la carte SD par OUTPUTLOG_printf + modif SD_printf pour la taille du buffer
2013-10-07 Correction SD et activation DMA (fonctionnel), terminal et affichage ID de machine à états par CREATE_MAE_...
    [state_machine_helper.c]
2013-10-07 Ajout commande fill vide (oublié de commit ces fichiers du club ..., avec ce fichier vide, au moins ça compile)
2013-10-08 Premier jet de la carte BallLauncher - schéma + placement + simulation sous LTSpice IV +datasheet XBee pro series 2
    [2014_BallLauncher.PRJPCB]
2013-10-08 test svn
    [Copie de 2014_BallLauncher.SchDoc]
2013-10-08 pin usages -> ajout RF, ajout capteurs sur propulsion...
    [pin_usages.xls]
2013-10-08 Calculs bobine ball launcher...
    [Ball_Launcher_Calculs.xlsx]
2013-10-08 Fichier .MCH avec texte seulement (verbose mode, pas de binaire) Modif headers en évitant QS_all.h
2013-10-08 Ajout début de squelette de driver module RF ADC: N'inclu pas QS_all mais juste QS_types dans le header. Utilisation de void* pour PORTS_adc_init Clean espaces QS_qei
2013-10-10 Simu montage Ball Launcher protection...
    [2014_BallLauncher.PCBDOC, 2014_BallLauncher.SchDoc, Ball_Launcher_Calculs.xlsx]
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2013-10-10 Modif header des fichiers avec svn:keywords=Id: Plus besoin d'avoir le nom du fichier explicitement, suppression de "Version" devant $Id$ et déplacement de $Id$ devant la description et le paquage.
2013-10-10 Ajout support pour la nouvelle organisation des fichiers de config. Choisir entre #include "../Global_config.h" et #include "config_global.h" dans QS_all.h Optimisation mineures des includes en les p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
2013-10-10 Modif nouvelle config pour que ça compile Ajout ";" après un assert dans zone_mutex, ce manque causait un problème de compilation si VERBOSE_MODE n'était pas défini
2013-10-11 Possibilité de desactiver QS_who_am_i avec DISABLE_WHO_AM_I (comme avant) mais permet de le définir à KRUSTY ou TINY (ou autre) pour indiquer quel robot choisir (au lieu de TINY par defaut)
2013-10-11 Suppression #warning de test dans who am i Ajout de #include "config_pin.h" dans QS_all.h (si nouveau mode actif) car non inclus correctement en strat pour l'instant Support nouveau mode dans QS_glob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
2013-10-11 Strat: Ajout #include "config_use.h" là ou les defines était utilisé (même ceux en commentaire) Suppression #define du code barre Déplacement de #define de debug vers config_strat.h Déplacement de #d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
    Peut être que des includes de config_use.h manquent pour des options qui n'était pas dans global_config ! Dans ce cas, il faut juste ajouter #include "config_use.h" dan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
2013-10-12 Config check dans un .c (car il dépend de config_pin, ceci évite de l'inclure par tout le monde via QS_all.h) can_over_xbee dépend de config_pin
2013-10-12 Mise en place de la nouvelle organisation des fichiers de configuration: config_pin et renommage config_strat -> config_debug Voir Global_config.h pour des infos sur les fichiers config/config*_.h
2013-10-12 Clean dossier inclus du projet eclipse (stm32f4xx après config car sinon ça fait foirer les liens symbolique ... change rien sur windows) Ajout #include inutile (car déjà inclus via global_vars norma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
2013-10-14 pin_usages.xls -> corrections mineures
    [pin_usages.xls]
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2013-10-14 Ajout des fonctionnalitées goangle et gohome sur le terminal et optimisation de la fonction goto
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2013-10-14 Ajout support de QS_outputlog (non complet, si ça compile pas, voir version précédente: 909)
2013-10-15 Correction d'une erreur dans la fonction RTC_get_time
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2013-10-17 Support outputlog sur actionneur et propulsion. Retro copatibilité du debug_printf du dspic: fichier vide QS_outputlog.h pour le pic (donc les autres _printf ne sont pas dispo sous pic)
2013-10-17 Correction de problème d'appel en boucle de la fonction gohome, correction de la fonction goto et adaptation du terminal pour l'utilisation de la backspace avec putty
2013-10-17 modif calcul ball launcher
    [Ball_Launcher_Calculs.xlsx]
2013-10-17 suppression fichiers obsoletes
    [2014_FDP.PrjPcb, 2014_FDP_Generic_Port_Act.SchDoc, 2014_FDP_Generic_Port_Strat.SchDoc, 2014_FDP_SCHEMA.SchDoc]
2013-10-17 ajout pilotage LED IHM
    [pin_usages.xls]
2013-10-17 Surlignage jaune élements vers IHM (carte strat)
    [pin_usages.xls]
2013-10-17 Correction warning strat et include manquant actionneur
    [clock.c, queue.c]
2013-10-17 Schéma structurel 1er jet
    [2014_FDP.PrjPcb, 2014_FDP_Generic_Port_Act.SchDoc, 2014_FDP_Generic_Port_Strat.SchDoc, 2014_FDP_SCHEMA.SchDoc]
2013-10-17 Update schéma structurel
    [2014_FDP_SCHEMA.SchDoc]
2013-10-17 Inclure config_debug pour le choix de verbosité par défaut si on utilise le nouveau mode de config
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2013-10-18 Correction de inclusion config_debug.h pour QS_outputlog time_t -> clock_time_t dans actionneur (conflit avec le time_t standard) config_qs n'inclus plus config_debug
    [Global_config.h, queue.c, queue.h]
2013-10-18 Finission uart3, début de RF (envoi d'un msg CAN + structure des headers synchro + msg can) objdump & objcopy avec chemin absolu (via find_program)
2013-10-18 Config RF + UART3 en commentaire (pas encore tout implémenté pour RF) objdump & objcopy mis dans QS/toolchain-gcc-arm-embedded.cmake
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2013-10-21 YaourtPhone test commit
    [2014_YaourtPhone.PCBDOC, 2014_YaourtPhone.SchDoc]
2013-10-21 maj librairies altium : module RF, correction écran LCD, correction pinout MOSFET N SOT23, ajout buzzer
    [Connecteur.SchLib, _ROBOT.PcbLib, _ROBOT.SchLib]
2013-10-21 MiniYaourthPhone (pour balise adverse) - version à antenne à souder.
    [2014_MiniYaourtPhone.PCBDOC, 2014_MiniYaourtPhone.PRJPCB, 2014_MiniYaourtPhone.SchDoc]
2013-10-21 Implementation IT uart dans module RF (en utilisant les FIFO) + ajout fonction pour connaitre le nombre d'element dans un buffer FIFO
2013-10-25 QS_rf: ajout CRC 8bits, implementation de la gestion de la reception des paquets
2013-10-25 QS_rf: utilisation de l'uart3 sans passer par QS_uart (pour l'instant, il faut que QS_uart soit plus flexible pour l'utiliser directement)
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2013-10-26 Ajout implémentation QS_rf, QS_uart_impl et QS_buffer_fifo (QS_rf et QS_buffer_fifo sont identique à la version STM32 (du commit suivant))
2013-10-26 QS_rf: Ajout commentaire en début de fichier + clean commentaire & ajout #ifdef pour avoir un fichier identique a celui pour dspic30f
2013-10-26 QS_uart_impl_dspic30f: gestion enable/disable it uart2 et calculs intermédiaires pour le baudrate pour éviter les overflows
2013-10-27 QS dspic30f: suppression de "../QS" dans les includes: inutile et cause des problèmes avec les symlinks (remplacement par exemple de "../QS/QS_all.h" en "QS_all.h")
2013-10-27 Renommage toolchain-gcc-arm-embedded.cmake -> CMakeToolchain.cmake (indépendant du toolchain, si c'est la QS stm32 c'est le toolchain arm, si c'est QS dspic, c'est toolchain c30)
2013-10-28 correction mineure
    [pin_usages.xls]
2013-10-28 + Traco THN20 + bornier 8V 3.81mm + corrections...
    [Connecteur.PcbLib, Connecteur.SchLib, _ROBOT.PcbLib, _ROBOT.SchLib]
2013-10-28 Carte alim 2014 - proposition de schéma
    [2014_carte_alim.PcbDoc, 2014_carte_alim.PrjPcb, 2014_carte_alim.SchDoc]
2013-10-28 Alim 12V indépendante de la carte alim.
    [2014_carte_alim.PcbDoc, 2014_carte_alim.SchDoc]
2013-10-28 Correction bornier 3.81mm
    [Connecteur.PcbLib]
2013-10-29 Carte Alim ++...
    [2014_carte_alim.PcbDoc, 2014_carte_alim.PrjPcb, 2014_carte_alim.SchDoc]
2013-10-31 Fond de panier 2014 : schéma presque terminé. Relecture à faire.
    [2014_FDP.PrjPcb, 2014_FDP_ACTIONNEUR.SchDoc, 2014_FDP_PROPULSION.SchDoc, 2014_FDP_SCHEMA.SchDoc, 2014_FDP_STRATEGIE.SchDoc]
2013-10-31 ajout bornier 3V
    [Connecteur.PcbLib, Connecteur.SchLib]
2013-10-31 1er placement
    [2014_FDP_ACTIONNEUR.SchDoc, 2014_FDP_PROPULSION.SchDoc, 2014_FDP_SCHEMA.SchDoc, 2014_FDP_STRATEGIE.SchDoc]
2013-10-31 Connecteur micro sd
    [Connecteur.PcbLib, Connecteur.SchLib]
2013-10-31 Connecteur micro SD...
    [2014_FDP_PROPULSION.SchDoc, 2014_FDP_SCHEMA.SchDoc, 2014_FDP_STRATEGIE.SchDoc]
2013-11-01 ménage...
    [2014_FDP_Generic_Port_Act.SchDoc, 2014_FDP_Generic_Port_Strat.SchDoc]
2013-11-01 Modification bluetooth.. + placement++
    [2014_FDP.PrjPcb, 2014_FDP_ACTIONNEUR.SchDoc, 2014_FDP_PROPULSION.SchDoc, 2014_FDP_SCHEMA.SchDoc]
2013-11-04 Ajout phoenix_4_voies + fichiers STEP de connecteurs...
    [Connecteur.PcbLib, Connecteur.SchLib, MOLEX_miniSD_header_5027740891.stp, PHOENIX_2V_5.08_FEMALE_1757019.stp, PHOENIX_2V_5.08_MALE_1755736.stp, PHOENIX_3V_3.81_FEMALE_1803581.stp, PHOENIX_3V_3.81_MALE_1803439.stp, PHOENIX_4V_3.81_FEMALE_1803594.stp]
2013-11-04 corrections mineures
    [pin_usages.xls]
2013-11-04 Placement++ / corrections diverses sur schéma Mise à jour du schéma PDF
    [2014_FDP.PrjPcb, 2014_FDP_ACTIONNEUR.SchDoc, 2014_FDP_PROPULSION.SchDoc, 2014_FDP_SCHEMA.SchDoc, 2014_FDP_STRATEGIE.SchDoc]
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2013-11-06 corrections placement + max485 en 5V...
    [2014_FDP_ACTIONNEUR.SchDoc, 2014_FDP_SCHEMA.SchDoc]
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2013-11-08 QS_rf: Indication de la fonction à appeler quand un message est reçu dans RF_init
2013-11-08 Remise en forme de stm32f4xx_src/startup_stm32f40xx.S (espaces en fin de ligne et indentation)
2013-11-08 CMake dspic30f: objdump en mode elf (et pas coff) QS_rf dspic30f: Indication de la fonction à appeler quand un message est reçu dans RF_init
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2013-11-10 Strat: CREATE_MAE_WITH_VERBOSE: last_state garde l'ancien état même si entrance n'est pas TRUE (donc dans tous les cas, last_state vaut l'état avant l'état courant, sauf au départ ou il vaut l'état à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
2013-11-10 Correction de bug
2013-11-10 correction de bug plus qu débile
2013-11-10 Je sais plus mais c en rapport avec les bouttons est une fonctionnalité de l'écran
    Toutefois j'ai remarqué des crashs de la carte a confirmer si c'est just e ma carte ou le code
    [button.c]
2013-11-10 Correction de bug et test: Les crashs de la version précédente sont dû à un court circuit de la carte de test (crash lors de mouvement des connecteurs)
    [button.c]
2013-11-13 ajout pushbutton_led
    [_ROBOT.PcbLib, _ROBOT.SchLib]
2013-11-13 Carte IHM, 1er schéma, 1er placement à l'arrache pour voir...
    [2014_IHM.PcbDoc, 2014_IHM.PrjPcb, 2014_IHM.SchDoc]
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2013-11-14 Routage IHM
    [2014_IHM.PcbDoc, 2014_IHM.SchDoc]
2013-11-14 Correction pads des switchs / plans de masse / DRC ok
    [2014_IHM.PcbDoc]
2013-11-14 strat_reglage_odo_rotation(void) fini reste à la tester régler nb de tour à faire
2013-11-14 grossi certaines pistes Amélioré la ligne GND_5 Ajouté les plans et masses au GND_24 Ajouté des vias de masse un peu partout (cela améliore l'homogénéité de la masse). Ajouté l'empreinte 3D du connec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
    [2014_carte_alim.PcbDoc]
2013-11-14 Correction de bug ihm
    [button.c, config_pin.h, main.c]
2013-11-15 Tailles trous : ok Via GND : ok Plans de masse GND24 DRC : ok
    [2014_BallLauncher.PCBDOC]
2013-11-16 Carte alim / IHM / MiniYaourtPhone / YaourtPhone : - taille trous - plans de masse - DRC + corrections mineures...
    [2014_IHM.PcbDoc, 2014_IHM.SchDoc, 2014_MiniYaourtPhone.PCBDOC, 2014_MiniYaourtPhone.SchDoc, 2014_YaourtPhone.PCBDOC, 2014_YaourtPhone.SchDoc, 2014_carte_alim.PcbDoc]
2013-11-16 -> Ajout de la gestion de la 3ème couleur de led IHM (pour le futur...) -> Amélioration du placement pour simplification des routages des alims -> routage de la partie hardcore... : IHM / CAN / SD
    Correction ACT_5V -> 5V
    [2014_FDP_ACTIONNEUR.SchDoc, 2014_FDP_STRATEGIE.SchDoc]
2013-11-16 Ajout pin de pilotage de la led color Blue.
    [pin_usages.xls]
2013-11-21 Ajout du message CAN pour le scan de triangle dans la QS
2013-11-21 Ajout et modification du code propulsion, pour ajouter les fonctionnalitées du scan triangle
    (Ajout de l'acknowledege intern à la propulsion)
2013-11-21 Strat: déplacement warning "Je crois qu il y a une modif pour le bouton 2 il semble que ce soit désormais le bouton LCD_ok" dans button.c plutot que dans config_pin (moins de flood warnings) Mise en 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
2013-11-22 FDP DRC Ok !!!!!!!!!!!!!!!!!!!!!!!!!!!!!!!!!!!!!!!!!!!
    [2014_FDP.PrjPcb, 2014_FDP_ACTIONNEUR.SchDoc, 2014_FDP_PROPULSION.SchDoc]
2013-11-25 Ajout de filtres sur les signaux codeurs : à placer + router sur le TOP, au plus près du connecteur de la STM32F4. Inversion LED / résistance pour meilleur passage CEM du bus CAN -> Led à rerouter su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
    [2014_FDP_ACTIONNEUR.SchDoc, 2014_FDP_PROPULSION.SchDoc, 2014_FDP_STRATEGIE.SchDoc]
2013-11-26 Puissance 2014 avec pont en H à plat
    [2014_CARTE_PUISSANCE.PCBDOC, 2014_CARTE_PUISSANCE.PRJPCB, 2014_CARTE_PUISSANCE.SchDoc]
2013-11-26 Pannel 2014
    [2014_Pannel.PcbDoc, Pannel.PrjPCB]
2013-11-26 DRC ok. Matricage de Vias : ok. Ajout filtres sur les codeurs actionneur. ajout d'une vis entre connecteurs codeurs actionneur pour barre de fixation...
    [2014_FDP.PrjPcb, 2014_FDP_ACTIONNEUR.SchDoc, 2014_FDP_SCHEMA.SchDoc]
2013-11-29 Correction RTC -> 5V + update schema empreintes inters
    [2014_FDP.PrjPcb, 2014_FDP_ACTIONNEUR.SchDoc, 2014_FDP_PROPULSION.SchDoc, 2014_FDP_STRATEGIE.SchDoc]
2013-11-29 Yahourt Phone version antenne PCB, presque terminée...
    [2014_Pannel.PcbDoc, 2014_YaourtPhone_Antenne_PCB.PCBDOC, 2014_YaourtPhone_Antenne_PCB.PRJPCB, 2014_YaourtPhone_Antenne_PCB.SchDoc]
2013-11-29 Le second message CAN pour l'a des mofifie du coef pose probleme pour l'instant
2013-11-30 IHM : Corrections pr Meca
    [2014_IHM.PcbDoc, 2014_IHM.PrjPcb, 2014_IHM.SchDoc]
2013-12-01 Correction position fixation fils..
    [2014_IHM.PcbDoc]
2013-12-01 Balise émettrice 2014. DRC 100%. Reste à faire : matrice de via, sérigraphie, trous.
    [2014_BALISE_CARTE_EMETTEUR.PCBDOC, 2014_BALISE_CARTE_EMETTEUR.PRJPCB, 2014_BALISE_CARTE_EMETTEUR.SchDoc]
2013-12-01 balise 2014
    [2014_BALISE_CARTE_EMETTEUR.PCBDOC]
2013-12-01 Carte connecteur batterie
    [2014_ConnecteurChargeur.PCBDOC, 2014_ConnecteurChargeur.PRJPCB, 2014_ConnecteurChargeur.SchDoc]
2013-12-01 maj balise
    [2014_BALISE_CARTE_EMETTEUR.PRJPCB, 2014_BALISE_CARTE_EMETTEUR.SchDoc]
2013-12-02 Sérigraphie++
    [2014_BALISE_CARTE_EMETTEUR.PCBDOC]
2013-12-03 Step connecteurs Wurth/Phoenix
    [7.62_reverse_gender_691307400002.stp, PHOENIX_2V_7.62_FEMALE_691351400002.stp, PHOENIX_2V_7.62_FEMALE_FILS_691348400002.stp, PHOENIX_2V_7.62_MALE_1728853.stp]
2013-12-03 Correction empreinte capa
    [2014_BallLauncher.SchDoc]
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2013-12-06 Correction interrupteurs IHM FdP : sérigraphie ok.
    [2014_IHM.PcbDoc]
2013-12-07 Debug malloc (_sbrk): affichage de l'adresse précédente du heap, de la demand en mémoire et du pointeur de pile en cas de collision entre les 2
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2013-12-13 Désactivation LCD en cas d'erreur I2C & maj de la taille du tableau pathfind par rapport à ce qu'on y met
2013-12-16 Augmentation buffer U1TX à 1280 et reduction du buffer commun jamais utilisé pour le terminal de 4096 à 512 (buffer servant à faire des copie de données à la main)
    [main.c]
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2013-12-19 RX24: Compilation ok si pas de rx24, putc vers les AX12 et RX24
2013-12-19 Bug de printf pour le prog codeur
2013-12-20 RX24: manque: tests et gestion flag && vs || entre les flags AX12 et RX24 Actionneur: utilisation watchdog
2013-12-24 Liaison msg can ok. Ceci dit, il faudra mettre à jour la propulsion et la stratégie pour gérer ces nouveaux messages can... Test de positionnement des robots lors de messages recus sur UART : ok. Tes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
2013-12-24 Réactivation de certaines définitions de types, pour compilation du code de l'écran LCD... Si cela engendre un conflit, il faudra inclure manuellement ces définitions dans le code de l'écran.....
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2013-12-28 Pathfind : machine à état + nouvelle fonction PATHFIND_try_going() utilisable comme un try_going, gérant l'évitement... Stratégie de test du pathfind dans actions_both_2014.c Pour tester le pathfind 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
2014-01-07 Enregistrement d'un match sur SD en binaire seulement pour les msg can et les datations. Les messages verbeux de l'utilisateurs sont bien surs enregistrés en ascii...
2014-01-07 Intégration de l'écran LCD tactile de miniprojet (version d'Amaury modifiée) à la propulsion en mode robot virtuel parfait UNIQUEMENT. -> voir _Propulsion_config.h Correction de la pulsion suicidaire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
    [_Propulsion_config.h, debug.c, it.c, main.c, odometry.c, odometry.h, secretary.c, secretary.h]
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2014-01-08 Avancement projet touchpad Correction du bug des led sur l'écran
    [Global_config.h, secretary.c]
2014-01-08 Version fonctionnelle du robot virtuel farpait. + Correction de bugs d'affichage du projet lcdTouch
    [debug.c, it.c]
2014-01-08 junctions pr projet_lcd + maj pin_usages.xls
    [pin_usages.xls]
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2014-01-08 Pull up verbose à 10k (sinon il y a conflit possible avec l'accéléromètre)
    [2014_FDP_STRATEGIE.SchDoc]
2014-01-08 Utilisation snprintf dans Verbose_can_msg.c. Outputlog peut avoir une fonction appelée à chaque printf (pour ecrire dans la SD en strat)
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2014-01-09 Define SCAN_TRIANGLE ajouté au fichier propulsion_config afin de désactiver le code scan_triangle. Quelques modification apportées au code
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2014-01-10 Intégration du code hokuyo dans la propulsion. Activation par define (actuellement désactivé) Code qui compile...
2014-01-13 Bras: implementation gestion des commandes (déplacement et attente de déplacement du bras) + utilisation de qu'un seul moteur (rx24/ax12) Ajout ACT_ARM_STOP, ajout erreur ACT_RESULT_ERROR_INVALID_ARG
2014-01-13 Bras: correction diverses, ajout msg CAN Act main: ajout bouton 0 avec un demande de déplacement du bras
    [Arm.c, main.c]
2014-01-14 Hokuyo dans la prop : ménage, merge avec modifs récentes de Julien, code qui compile, non testé.
2014-01-14 Correction d'ordre des init
    [main.c]
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2014-01-14 Bras: Pret pour le test (avant de voir que ça marche pas)
2014-01-15 Avancement du miniprojet robot virtuel + écran + fichier docklight (pour le baudrate => chian de devoir toujours le remettre a 115200)
2014-01-15 dépilage : ajout d'un caractère de détection de fin de transmission uart
2014-01-15 AX12: ajotu fonction pour modifier l'ID de toutes les AX12/RX24 branchés Actionneurs: fonctionnement ok si pas de CAN (pas de USE_CAN) Bras: corrections: changement d'état correctement effectué à la 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
    [Arm.c, main.c]
2014-01-15 Pas de USBH_process avant l'init de l'USB, il est fait dans hokuyo_process_main (ou alors me dire pouquoi)
2014-01-16 Activation de la priorité sur le can tx... pour que les messages soient envoyés dans l'ordre !!!!!
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2014-01-16 HOKUYO : ménage... Code non testé. (ou très partiellement) Ca compile, l'hokuyo est correctement initialisé.
    Désormais, le mode SEND_CAN_OVER_UART est autorisé en match, car les Tx sont fait sur IT...
    [Global_config.h, _Propulsion_config.h, main.c]
2014-01-17 Réflexion autour du selftest et de ces fonctionnalités
    [pin_usages.xls]
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2014-01-17 Bras: Ajout nom de l'actionneur pour le bras + erreur invalid arg dans le message de résultat (ACTQ_printResult) + utilisation de l'actionneur dans le petit robot (tiny)
2014-01-17 Ajout de fonctions pour deposer la fresque soit au centre, à droite ou à gauche
2014-01-18 Correction de définition de type !!! erreur génante...
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2014-01-18 corrections warning. Ajout du ping/pong can
    [secretary.c]
2014-01-18 selftest lancable par message can. corrections du selftest...
    [environment.c]
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2014-01-18 Buzzer : fichiers ajoutés... ce n'est pas fini
    [environment.c]
2014-01-18 avancement selftest
    [pin_usages.xls]
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2014-01-20 Modif config du CAN pour retrouver la fréquence utilisée avec les dsPIC... Cette config va de pair avec un PCLK à 42MHz (qui correspond à SYSCLK de 168MHz qui correspond à une fréquence permettant d'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
2014-01-20 Ajout d'une fonction permettant de régler la fréquence des PWMs. Utile pour le buzzer.
2014-01-20 Module Buzzer ok. Testé à l'oscillo ok. Y'a plus qu'a buzzer !
    [clock.c]
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2014-01-20 Appel du buzzer lors du selftest - non testé - peu de risques
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2014-01-22 Fréquences du buzzer qui font + de bruit... (le buzzer a une bande passante assez short autour de 4kHz...)
2014-01-23 Selftest : gestion de la cohérence WHO_AM_I dans le message de PONG.
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2014-01-23 màj état de dev selftest
    [pin_usages.xls]
2014-01-23 Actionneur: config: ax12 sur uart2, desactivation AN2&3 (car utilise même pin que uart2) Tableau de act dans KActManager.c pour avoir un nombre de act toujours correct (pour selftest) Ajout enum self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
2014-01-23 activation des lancer de lance à la suite en fonction du nombre demandé
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2014-01-23 Rajout des pins du port C, pour les capteurs des deux fresques
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2014-01-23 gestion des msg can de position adverse et mise à jour de global.env.foe...
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2014-01-24 Gestion duoble uart pour ax12 marche ok (mais sans servo sur la 2ème uart)
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2014-01-24 filtrage des messages STRAT_ADVERSARIES_POSITION pour qu'ils ne soient ni affichés ni enregistrés..
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2014-01-24 Fruit_mouth: selftest implémenté Queue: ajout d'une fonction pour récupérer le nombre d'action encore dans la file Selftest actionneur: marquer un actionneur comme ayant terminé son selftest qu'a la 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
2014-01-24 debut de la strat_lannion_rouge, elle est capable de poser les fresques et de faire tomber les 6 triangles
2014-01-27 Inter présence filet sur PD6
    [pin_usages.xls]
2014-01-27 Correction offset angle hokuyo suite à correction de la position de l'hokuyo sur Krusty (l'angle mort doit être a gauche !)
2014-01-27 queue: ajout fonction pour récupérer les info de l'action suivante (pour savoir la fin d'un test dans selftest) + this -> thiss car mot clé spécial c++ pour qtcreator ... selftest: ajout fonction pou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
2014-01-27 Selftest actionneur: seulement les erreurs sont mises dans le msg can (et seulement les erreurs sont affichées via printf)
2014-01-28 Ajout strat_test_ramasser_fruit_arbre1_double ("elle passe dans les deux sens"), modif à faire dans un sens à un prôbléme Test de lancer une balle avec la strat : Réussi avec succés
2014-01-29 Fruitmouth: changement SID car collision avec ACT_DO_SELFTEST Traphandler: utilisation de stderr et pas de bufferisation sur stderr dans qs_uart
2014-01-29 outputlog: level passé à la callback + pas de log dans la carte SD si debug ou trace
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2014-01-30 enregistrement des 2 objets hokuyos les plus proches pour l'évitement. algo temporaire. non testé.
2014-01-30 Modification de la déclaration des strats: se fait désormais dans un define au debut + strat de test pour l'évitement en mode simu
2014-01-30 Corrections hokuyo détections ennemis
    [calculator.c, calculator.h, secretary.c]
2014-01-30 correction détection des ennemis les plus proches
    [detection.c]
2014-01-30 tentative de debogage de avoidance : pas fini
    [avoidance.c]
2014-01-30 Ajout de la strat_file_fruit qui gere la depose des fruits que l'on soit du côté jaune ou rouge Prend le chemin le plus rapide pour les deposer
2014-01-31 Gros ménage dans avoidance/environment/grille... Désactivation des stratégies 2013 NB_FOES -> MAX_NB_FOES..... pour gérer plus de deux adversaires partout dans le code.
    [Pathfind.c, Pathfind.h, avoidance.c, avoidance.h, brain.c, detection.c, environment.c]
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2014-01-31 Réglages avoidance... un peu violent... Il faut encore poursuivre le débogage.. le robot reprend sa trajectoire en présence d'un adversaire, c'est anormal.
    Délai au début du main strat -> pour attendre que les autre cartes (prop!) soient prêtes et prennent en compte le broadcast color !
    [avoidance.c, config_use.h, main.c]
2014-02-01 mise en conformité hokuyo des msg de positions du robot_virtuel_parfait sur LCD.c Corrections diverses... Simplification de secretary.c Correction de l'envoi de la vitesse en translation lorsqu'elle 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
    [_Propulsion_config.h, debug.c, secretary.c, secretary.h]
2014-02-01 Désactivation des printf de ping. SMALL_ROBOT et BIG_ROBOT remplacent KRUSTY, PIERRE.... de façon atemporelle
2014-02-01 Fast cos_sin Refactoring du foe_in_path Correction calcul de l'angle adverse
    PS:actions_pierre.c ne compile pas, son auteur a du oublier qch.
    [avoidance.c, config_use.h, detection.c, environment.c, environment.h]
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2014-02-01 Ajout d'un define dans _Propulsion_config.h pour l'activation de l'uart lors d'un scan de triangle pour la rendu sur logiciel Modification du script de détection de triangle avec optimisation soit 64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
2014-02-02 En mode_simulation, on ignore le texte brut reçu sur l'UART, pour ne considérer que les msg cans..
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2014-02-02 Je crois que j'ai trouvé pourquoi Tiny ne s'est pas arreté en phases finales à la fin du match... on ne demande pas à la propulsion de s'arrêter à la fin du match.... !!!
2014-02-02 correction pathfind... node_number = 24, et non 25..
    [Pathfind.c, Pathfind.h]
2014-02-02 Ajout d'un message CAN pour l'envoi des données des triangles de la propulsion vers la stratégie
2014-02-02 Ajout des fonctions d'envoi du message CAN des données des triangles vers la stratégie
2014-02-03 Arm: ajout commentaire + correction quelque bug
    [Arm.c]
2014-02-03 Modifiction et correction du scan de triangle, script en grande partie opérationnel
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2014-02-04 Modification du seuil de détection des triangles pour le cas des triangles cote à cote avec angle Ajout d'un script de concaténation/moyenne de centre de triangle proche/identique
2014-02-06 Lancelauncher: correction bug: pas de decrementation dans le timer si la var global déjà à 0
    [queue.c]
2014-02-06 LanceLauncher: QUEUE_behead à éviter: la strat n'aura pas de retour sur l'action demandée (et QUEUE_next permet d'afficher sur l'uart qu'il y a eu un problème) Rajout de printf dans les cas pas norma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
    Clock.h: unité entre crochets
2014-02-06 Utilisation d'un enum pour lister les SID des messages CAN actionneurs (pour pouvoir vérifier que tous les SID sont géré au retour à la compilation, pour le mapping SID <=> queue_id_e)
2014-02-07 Correction pr l'an prochain : résistances de pull up sur SPI SD..
    [2014_FDP_STRATEGIE.SchDoc]
2014-02-07 Ajout de assert pour trouver les cas d'overflow potentiels (autour de term_common_buffer)
2014-02-07 Modification des messages CAN envoyés de la propulsion vers la stratégie vis à vis des scan de triangle
2014-02-07 Ajout de la gestion des messages CAN du scan de triangle de la stratégie avec modification de la stratégie de Guy
    ps : cette stratégie rencontre un soucis de changement d'état sans raison...
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2014-02-10 Ajout d'un léger filtre sur les points x et y Correction légère
2014-02-10 CAN: si pas USE_CAN, alors les fonctions sont définie mais ne font rien (trop de chose dépend du can ...) RF & balise
2014-02-11 désactivation du DMA... temporaire... mais ca résouds - semble t-il - un facheux bogue..
2014-02-11 Correction copie DMA => BufferSize = 512 / (octets par transaction dma) Ajout test pour vérifier si la copie DMA overflow le buffer dma_send_buffer
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2014-02-12 Ajout de la fonctio hold_state qui va tenir l'etat du launcher pendant le temps souhaité
2014-02-12 Refonte de la gestion des SCAN Modification du traitement du message CAN
2014-02-12 Désactivation du pull_up sur la réception USART3 à cause de l'impédance de 100k en sortie du RC1240
2014-02-12 Ajout de la fonction "try_going_and_rotate_scan" dans elements.c pour ordonner au robot de se placer et d'effectuer un scan dans la zone ciblée
2014-02-13 Commentaires + considère qu'une balise est là même si son message ne nous est pas destiné + envoi des msg CAN à environnement.c
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2014-02-13 Ajout d'un message de timeout dans le cas d'une trajectoire trop longue correction fct try_going_and_rotate_scan
    [elements.c]
2014-02-13 Chaque bobine possede un temps de maintien differents va de 20ms ou 25ms pour certaine
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2014-02-13 CMake: simplification du CMakeLists.txt en plaçant les lignes redondantes dans QS/CMakeToolchain.cmake (STM32)
2014-02-13 CMake: simplification du CMakeLists.txt en plaçant les lignes redondantes dans QS/CMakeToolchain.cmake (DSPIC, oui on peut compiler du pic sur qtcreator :) )
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2014-02-14 Priorité uart module RF plus faible (équivalent de 5 sur dspic) + synchro des 2 fichiers entre QS dspic & stm32
2014-02-14 Ajustement unité base de temps + demande de synchro dans le main pour éviter les problèmes d'IT + maj svn:ignore + ajout fichier cmake
2014-02-15 Problème du reset resolut, plus besoin de rest la carte pour relancer les balles
2014-02-15 misa a jour de la carte actionneur (j'ai enlevé et déplacer les fichier de l'ancienne coupe )
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2014-02-15 Actionneur: changement du choix du robot pour des #define indépendant du robot (BIG/SMALL). Les anciens (...KRUSTY/TINY sont toujours défini par rapport à ce qui est défini entrre BIG et SMALL)
2014-02-16 BaliseEmettrice: Utilisation de static pour les variables globale si locale au fichier + renommage variable step pour les IR en step_ir Utilisation de DUREE_STEP au lieu de LOCAL_TIME_BASE IR: 4ms ou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
2014-02-16 Emission IR valide pour N balises Utilisation de define pour le numéro d'uart pour RF_UART (UART2_ID)
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2014-02-16 #include config_global dans les autres fichiers de config commun au 2 robots pour permettre l'analyse des #define et des #if correctement
    [config_pin.h]
2014-02-16 Synchro: utilisation du signal de synchro pour synchro la balise receptrice avec la strat + correction d'unités
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2014-02-17 Selftest : mesure du 24V OK ! XBee : OK ! ATTENTION : module "C" sur le BIG_ROBOT et module 1 sur le SMALL_ROBOT... !
2014-02-17 Ajout du nouveau module XBee. Attribution des modules... C : BIG_ROBOT 1 : Small_robot 2 : balise fixe 3 : backup/oreille autour du terrain..
2014-02-17 correction des stratégies d'odométrie
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2014-02-18 Implémentation partielle de la warner des triangles en propulsion Ainsi que quelques modifications légères
2014-02-18 Modification des coefficient d'odométrie en rotation et les coefficients d'accélération pour éviter les glissements du robot
2014-02-18 Balise: Mode double emetteur que si synchro ok (ie: reception d'une réponse) + code emission US désactivé LED_RUN indique les demandes (si la led clignote, des demandes de synchro sont envoyées, devr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
2014-02-19 Synchro balise/strat ok. demande de synchro en IT car timing pas fiable du tout si dans le main (même avec casi rien dans la boucle)
2014-02-19 Buzzer pendant évitement... non testé..
    [avoidance.c]
2014-02-19 modifs ports
    [pin_usages.xls]
2014-02-19 no pull up sur I2C pour pas trop tirer sur la ligne, sinon le lcd n'arrive pas a acquitter assez fort..
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2014-02-20 ajout infos filtres
    [pin_usages.xls]
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2014-02-20 Correction sens roue codeuse gauche... + ménage encoders.c
    [encoders.c]
2014-02-20 Ajout de la stratégie de test du lancer de filet Ajout de la fonction de gestion du réarmement
2014-02-20 Balise: synchro ok, bug attente RX=>TX 10ms balise corrigé Bug variés corrigés
    [Global_config.h, main.c]
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2014-02-20 Mise en place de USE_PWMx pour choisir précisément les PWM à utiliser
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2014-02-20 Utilisation des USE_PWMx en Actionneur (toutes les PWM sont activées pour les 2 robots)
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2014-02-20 Modification et ajout de la gestion des gaches de libération des ficelles retenant le filet
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2014-02-21 Déclenchement de la fonction lancement du filet à la fin du match
2014-02-21 présence filet -> PA7 actionneur
    [pin_usages.xls]
2014-02-21 Modification des managers des actionneurs pour la gestion d'une fonction de d'initialisation en position Modification de l'actionneur PFruit pour la compatibilité avec les modifications
2014-02-21 Ajout de la gestion du nom du robot dans QS_who_am_i il suffit d'appeler la fonction QS_WHO_AM_I_get_name() pour avoir le nom du robot Modification des main.c de chaque projet pour que cela fonctionn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
2014-02-22 Balise: affichage du temps de réponse de synchro RF sur uart, clean code, Desactivation mode 2 adversaires si pas de synchro depuis longtemps (20s), verif d'overflow potentiels de la base de temps st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
2014-02-22 Balise: condition corrigée pour les checks d'overflow step_it + vraie division
2014-02-22 Balise: correction verif d'overflow potentiels de la base de temps, utilisation de LED_BEACON_RED/GREEN pour montrer si on reçoit des demandes de synchro via rf GREEN clignote avec les receptions et 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
2014-02-22 Ajout actionneurs petit bras Ajout messages CAN actionneur petit bras Ajout des fonctions en stratégie pour l'actionneur petit bras Ajout d'une stratégie de test du petit bras et modif stratégie test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
2014-02-22 Strat: LED_BEACON: RED s'allume si le robot ne reçoit rien d'un des 3 autres modules (2 balises + l'autre robot) pendant 10sec GREEN clignote avec la réception de la synchro via rf dans le cas de GUY
2014-02-22 Ajout du message CAN BROADCAST_ALIM qui est émise par la stratégie lors d'un changement d'état de l'alimentation de puissance des cartes Ajout dans la variable global global de alim TRUE/FALSE et de 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
2014-02-22 Modification des managers actionneurs pour la prise en compte de la présence de l'alimentation
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2014-02-22 Nettoyage de plein de petites coquilles qui cosaient des warnings dans les actionneurs
2014-02-22 Ajouut message CAN STRAT_INFORM_FILET envoyé de l'actionneur qui stock l'état du filet Ajout de la fonction de détection d'état du filet avec envoi du message CAN Ajout de la reception de message CAN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
    [clock.c, environment.c]
2014-02-22 Ajout d'une protection (avertissement) en cas de programmation du code actionneur sur le mauvais robot + Quelque #ifdef pour les fonctions filets qu'il ne faut pas appeler si on est le petit robot
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2014-02-22 Queue: Remplacement de this en thisa pour que QtCreator évite de le confondre avec le this du c++
2014-02-22 Suppression de warning (pour resortir les plus importants) Arm: retour à l'état précédent en cas de fail Simplification code FRUIT_CAN_process_msg
    [Arm.c, queue.c]
2014-02-22 Actionneur: Ajout de ACTQ_check_timeout pour vérifier un timeout FruitMouth: 5sec de timeout pour la pompe, simplification FRUIT_CAN_process_msg, mise en forme et séparation des init labium/pompe, aj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
2014-02-22 Filet: envoi de msg can avec CAN_send (le USE_CAN est géré par cette fonction), pas de flush si QUEUE_create à fail (si ça fail, ya rien de créé), suppression de l'enum non utilisé FILET_command_stat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
    [main.c]
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2014-02-22 Strategie: Simplification du define de timeout d'actionneur + gestion des nouveaux code d'erreur + ajout message plus explicite quand une erreur ou un actionneur est inconnu pour savoir quoi faire
2014-02-22 Ajout d'avertisseur en cas d'impossibilité de création de watchdog pour lacher les ficelles et libérer la gache
2014-02-23 Actionneur : Affichage de "Cancelled" dans le cas d'une erreur "ACT_RESULT_ERROR_CANCELED" dans l'affichage de résultat
2014-02-23 Ajout selftest du petit bras Lors du selftest affichage des erreurs pour chaques actionneurs précis en stratégie Correction d'un warning
2014-02-23 QS: Clean debug + macro UNUSED_VAR pour ne pas avoir de warning quand des variables sont non utilisées (c'est le cas quand on utilise pas d'ADC)
2014-02-23 SmallArm: pas besoin de SMALL_ARM_command_state_e + simplification de SMALL_ARM_CAN_process_msg + si timeout déplacement et que l'ax12 est à plus de 10° de la position demandée (10° = arbitraire), re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
2014-02-23 LEDs : ok Corrections de warning...
    [Global_config.h, it.c, secretary.c, secretary.h]
2014-02-23 Plus de clock stop a la fin du match (sinon le selftest et la supervision plantent...) ajout d'un verbose des boutons, très pratique pour les tests USE LCD par défaut rétrécissement des printf de la 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
2014-02-23 Gestion des switchs et BP de la prop calibration (bouton vert sur le robot) selftest (bouton bleu de la carte) selftest intégrant l'hokuyo
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2014-02-23 avancement selftest++
    [pin_usages.xls]
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2014-02-24 Essai resolution de bug
    [main.c]
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2014-02-25 Modification de la stratégie du lancement de filet Ajout d'une stratégie de test de placement/lancement de filet en fin de jeu Modification des angles de l'ax12 pour le réhaussement du lanceur, modif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
2014-02-25 Déplacement capteur WT100 en stratégie pour gérer le code 'haut niveau du bras' directement en stratégie
    [pin_usages.xls]
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2014-02-26 Correction du port pilotage du sens pompe fruit mouth Ajout port/pwm pompe du bras
    [config_pin.h]
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2014-02-26 Mise a jour de l'écran LCD: Il affiche désormais la position des que possible et la position balise Correction inversion de bouton + et -
    [button.c]
2014-02-26 Correction du bug des switch de strat Cette version du LCD est fiable mais manque de tests sur cible
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2014-02-26 Suppression de printf ecran de débug qui fait chier tout le reste + Affichage du nombre d'erreurs du selftest à la fin
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2014-02-27 Balise: pas de watchdog car pas utilisé. Bug bizarre si LED_* = !global.is_synchronized mais n'affecte que les leds ...
2014-02-27 Fruit modif vitesse de l ax12 labium Lance Launcher possibilite maintenant de choisir l'ordre des balles à envoyer
2014-02-27 Ajout au message Can des lances launcher un sens pour envoyer les balles dans un ordre différent si nous sommes rouge ou jaune Modif des strat a fruit et lance launcher, strat lannion marque environ 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
2014-02-28 Simplification de l'utilisation des ADC maintenant il faudra faire ADC_getValue(ADC_x) avec x le numéro de l'ADC
    Modification des codes affectés par ce changement
2014-02-28 Correction bug gachette fin de match + détails
    [main.c]
2014-02-28 XBee : possibilité de demander des envois de msg avant que le module soit prêt... sans effet, mais pas gênant. CANmsgList : XBEE_MY_POS_IS
2014-02-28 pathfind : correction d'un warning selftest : ajout des la verbosité des message de la prop xbee : envoi périodique des messages de notre position (actuellement désactivé pour tester avant...)
    [Pathfind.c, clock.c]
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2014-02-28 Nouvelle strat qui peut se faire dans les deux sens ( ne fait pas tomber les 6 feux par contre )
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2014-03-01 Séparation AX12_DIRECTION_PORT en 2, un pour AX12 et l'autre pour RX24 (un paquet est toujours envoyé sur les 2 bus, pour le driver il n'y a pas de diff entre RX24 et AX12 et on pourrait inverser les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
2014-03-01 Utilisation d'un define pour l'enum des états du bras (pour pouvoir récupérer le nom des valeurs dans Arm.c)
2014-03-01 Suppression macro ARM_ACT_NUMBER pour ne pas avoir à la maintenir en parallèle du tableau ARM_MOTORS Test à l"init si les transitions d'états sont reversibles et printf d'une correction si pas le cas
    [Arm.c]
2014-03-02 Implementation de l'init du bras, pour avoir une position connue dans le code
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2014-03-02 Ajout fonction déplacement du bras en strat, correction de warnings (certains sont pertinents et sont à corriger, par exemple celui concernant la taille du tableau de noeuds du pathfind)
    [Pathfind.c, act_can.c, act_functions.c, act_functions.h, detection.c, environment.c, queue.h]
2014-03-02 Ajout du mode BEST_EFFORT... pour permettre un réglage des coefs de l'asservissement.
2014-03-02 Ajout du mode BEST_EFFORT... pour permettre un réglage des coefs de l'asservissement.
    XBee : on change, parce que montés comme ca sur les robots...
2014-03-02 Maj selftest STR_RF
    [pin_usages.xls]
2014-03-02 Selftest du bras (même déplacements que pour l'init de la position à un état connu)
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2014-03-03 void ASSER_set_position(Sint16 x, Sint16 y, Sint16 teta).. c'est plus pratique !
    Gestion du match_duration... directement dans le brain, en fonction de la stratégie choisie.
    Réduction du spam en MODE_SIMULATION
    Ajout d'une strat de réglage des coefs.
2014-03-03 strat_lannion en STRAT_0_GROS...
    by the way : actuellement en mode simu, comme les erreurs ne sont pas gérées, la strat plante suite à un actionneur non présent...
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2014-03-03 Modif de plusieurs noms(BIG/SMALL) Ajout de la nouvelle calibration (pas finie pour GUY)
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2014-03-04 Avoidance : réglage coefs accélération Trajectoire de test des coefs : en Propulsion... LCD : correction de la distance (le *2 est fait avant !)
    [avoidance.c, environment.c, environment.h]
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2014-03-05 Ajout carte BeaconEye...
    [2014_BeaconEye.PRJPCB, 2014_BeaconEye.SchDoc]
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2014-03-05 BeaconEye... ready for fab !
    [2014_BeaconEye.SchDoc]
2014-03-05 LCD_printf fonctionne amusez vous (il est sécurisé et testé: il s'utilise comme un printf avec comme premier argument la position sur l'écran)
2014-03-05 Bras testé, ajout printposition bras, clean retour a la lignes dans les printf
2014-03-05 Remplacement de AX12 par AX12/RX24 (AX12 et RX24 sont, pour le driver, la même chose)
2014-03-05 Orientation vers le mammouth le plus proche quoi qu'il arrive à la fin du match Placement pour lancer le filet en vitesse FAST
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2014-03-06 AlimBeaconEye et BeaconEye : envoyé en Fab.
    [2014_AlimBeaconEye.PCBDOC, 2014_AlimBeaconEye.PRJPCB, 2014_AlimBeaconEye.SchDoc, 2014_BeaconEye.SchDoc]
2014-03-06 Pathfind : Déplacement dans le pathfind sans collision avec le décors Avoidance : Ajout d'une structure displacement_curve_t qui permet de lister des déplacements et s'ils doivent se faire en courbe 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
    [Pathfind.c, Pathfind.h, avoidance.c, avoidance.h]
2014-03-06 Correction Inversion Rx Tx
    [2014_FDP_SCHEMA.SchDoc]
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2014-03-06 Modif pas mal de chose, strat_test_point2 fonctionne plutot bien, serait pas mal pour lannion si rien de mieux
2014-03-07 Ajout de l'affichage des erreurs de selftest: Pas encore testé mais compilable
2014-03-07 Correction d'un warning qui pouvait foutre la merde totale si mal gérée par le compilo
    [brain.c]
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2014-03-07 LCD_printf donne des warnings si les % ne correspondent pas au variables qu'on donne grâce à un attribut gcc
2014-03-07 Debut d'implémentation de la stratégie principale de pierre avec le nouvel algorithme de TAKE DECISION
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2014-03-08 Amélioration / Correction de la stratégie principale de pierre
2014-03-09 Ajout d'une macro (TYPEDEF_ENUM_WITH_STRING) qui crée une typedef enum de nom 'enum_name' et une tableau de chaine de caractère de nom 'string_name' contenant tous les autres paramètres
2014-03-09 Ajout de fonctionnalité à la stratégie principale de Pierre et quelques légères corrections
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2014-03-10 Ajout de la fonction 'STOP_REQUEST_IF_CHANGE', début de solution de la gestion des arrêts en cours d'action
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2014-03-10 Ajout du mutateur inc_sub_act_failed qui permet d'incrémenter le failed si possible et d'avertir en cas d'erreur Un warning est levé sur le switch s'il ne gère pas toutes les subactions Complétion de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
2014-03-10 Complétion des subactions Correction de quelques trucs
    [brain.c]
2014-03-11 Correction de logique de TAKE_DECISION Ajout d'une variable globale qui informe si la stratégie en cours est la principale
    [brain.c]
2014-03-12 Ajout de la gestion des GET_IN et GET_OUT de toutes les subactions (désactivable via le define 'USE_GET_IN_OUT'
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2014-03-13 Asservissement du verrin du fruit mouth Correction initialisation détails
    [main.c]
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2014-03-14 Ajout du message CAN pour la remontée en stratégie de l'état du verrin
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2014-03-14 Ajout de la gestion des actionneurs par les boutons Bouton 0 -> labium pompe Bouton 1 -> labium trappe Bouton 2 -> Lance launcher (ALL) Bouton 3 -> Filet
2014-03-14 Correction fonction d'attente du verrin
    [elements.c, elements.h]
2014-03-14 Robot virtuel : N'affiche pas l'angle et la tête de l'ennemi ne peut pas le connaitre (gain de tps)
2014-03-14 Correction fonction d'attente labium Correction strat_lannion (avec des defines à activer !) USE_WAIT_LABIUM USE_TRIANGLE_TORCHE USE_CORRECTION_TRIANGLE_2
    [elements.c]
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2014-03-15 offset balise : ok Par contre, en mode deux adversaire, la synchro semble ne pas avoir l'effet voulu... (détection adverse foireuse).
2014-03-15 Rush in the wall en mode simulation... Désactivation en mode LCD_TOUCH de la propulsion si l'on recoit un message BROADCAST_POSITION_ROBOT (c'est à dire lorsqu'une autre carte propulsion nous envoie 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
2014-03-16 Strategie utilisée (strat_test_point2) pour la coupe de lannion (marque environ 37), depose les fresques, tire les balles et le filet, prend 8 fruits et fait tomber les 6 feux.
2014-03-16 Ajout nouveau fichier Pfruit, prochainement nouvelle fonction dans Pfruit, recupera que les arbres souhaités
2014-03-16 LED_UART sur émetteur : allumée lorsque l'IR est actif, éteint du l'IR est inactif.
    Coté récepteur : gros ménage de printemps dans la synchro....
    On est désormais sur le fonctionnement suivant :
    - si la broche de synchro = 1 : on recoit l'ADVERSARY_1
    - sinon, on recoit l'ADVERSARY_2..
    C'est dont à la carte stratégie de respecter les 100ms.
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2014-03-18 Nouvelle gestion des boutons dans le menu stratégie. (SET pour sélectionner rotativement enable/priorité/t_begin/t_end et OK pour valider la modification) Correction gestion de l'allumage des leds da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
2014-03-18 Selftest des capteurs DT10 et DT50 en fonction du robot sur lequel nous sommes
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2014-03-18 Ajout Action de bouger une torche en ligne droite (Vitesse à modifié ne peut pas faire bouger la torche en FAST sinon il part en erreur)
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2014-03-19 Pour la balise fixe..
2014-03-19 Modification gestion de l'écran LCD vis à vis du menu de sélection de la stratégie
2014-03-19 Ménage divers...
    Zone_mutex : dommage collatéral.. renommage nécessaire de ZONE_NUMBER.
    Brain : nettoyages, et meilleur "début de match"
    environment.c : ménage
    LCD : détail
2014-03-19 Plus de lien à l'environnement de la strat dans un code XBee qui est censé aller aussi ailleurs...
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2014-03-19 Désactivation de l'affiche du menu de modification de la high_level_strat si nous ne l'utilisons pas. Car toutes les mises à jours de la l'ordre de la stratégie et autre nécessite l'utilisasions de l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
2014-03-19 Ajout commande "stop" qui a le même effet qu'une fin de match (ARU via uart)
2014-03-19 Module Fix_Beacon... pour dialogue avec la fix_beacon
    [environment.c, fix_beacon.c, fix_beacon.h, main.c]
2014-03-20 Nombre de "sauts" (hopes) xbee : 1... Désactivation des "retries" lorsque le message est "ping".
2014-03-20 réglage temps de reset... correction mineure
2014-03-20 Modif zone mutex demande une autorisation à l'autre si nous pouvons prendre une de ses zones Reste la fonction en high_level_strat à faire pour renvoyer l'autorisation soit true ou false
2014-03-20 Ajout d'un message CAN d'information si quoi que ce soit à été vue dans la zone du scan
2014-03-20 Ajout de la gestion du retour si lors d'un scan rien du tout n'a été vue Gestion DT10/DT50 en fonction des robots
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2014-03-21 fix_beacon : détail. LCD : meilleur affichage des adversaires vus : NON TESTE Detection : utilisation des données IR quand pas de données Hokuyo : Non testé...
    [avoidance.c, detection.c, environment.c, environment.h, fix_beacon.c, fix_beacon.h, main.c]
2014-03-21 Ajout fonction manage_fruit qui gere toute les strats de fruit ( Pas encore test ) Plus decalage de la fonction min_node_dist dans le pathfind
2014-03-21 Modif de nom de variable et possiblite de choisir de prendre ou ne pas prendre tous les arbres
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2014-03-22 Ajout de l'activation de la subaction DROP FRUIT si au moins un arbre à été fait
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2014-03-23 Correction ordre include (peut poser des problèmes à la compilation sinon)
2014-03-23 act_functions : Complétion d'une énumeration, changement d'un nom pour clareté actions_PFruit / actions_pierre : Utilisation de l'énumeration
2014-03-23 element : remake des fonctions dans elements.c, correction, commentaire environment : ajout des communications avec element et les messages CAN
    [elements.c, elements.h, environment.c]
2014-03-23 Ajout d'une fonction de sélection du node le plus proche en fonction du node final de la trajectoire (Fonction non terminé / non testé)
2014-03-24 Buzzer qui fait 'dring' sur timeout de l'une des stacks... Je ne sais pas si c'est une bonne idée... mais ca peut être pratique... !?
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2014-03-24 Ajout début de la strat sub_action_initiale, nouvelle fonction dans Pfruit get_presenceFruit qui dit si il y a des fruit dans le bac ou non
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2014-03-27 Ajout du terminal de controle du bras via UART avec le carte actionneur
2014-03-27 Correction à la con
    [main.c]
2014-03-27 Modif la sub_action_initiale, gere les cas d'erreur si il y a un triangle devant la fresque Sinon fait la strat en moins de 25s (~22s) si tout va bien
2014-03-27 Creation de la strat protected_fires qui fait des huit a l infini, voir pour l 'arreter dans la strat du dessus
2014-03-27 Ajout affichage de l'état du bras (avec formatage pour c/c dans le code) lors de l'appui sur 'p' / 'P'
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2014-03-31 Ajout de variable global dans l'actionneur (la position) Ajout gestion des messages BROADCAST_POSITION par la carte actionneur
2014-03-31 MAJ de la fonction terminal gohome Ajout de la fonction calibration au terminal
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2014-04-01 Modif de la strat sub_action_initiale et de quelque point dans les autres fonctions
2014-04-01 Apport terminal actionneur Ajout utilisations du convertiseurs analogique numérique pour le potard de la hauteur du bras
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2014-04-02 clock : modification de la vitesse de la clock de 100ms à 10ms filet : ajustement de l'it du FILET term : détails
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2014-04-02 Momantannée pour une bonne exécution (crash)
    [clock.c]
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2014-04-03 Demande de zone et acceptation, quelque problème à géré pour l'acceptation des zones
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2014-04-04 Modif sens backward forward pour les fruits, depose fruit et lancer de balles
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2014-04-05 Envoie un message can par xbee de la nouvelle position de la torche a l autre robot
2014-04-05 Mise à jours des configurations des actionneurs, pour un bon fonctionnement AX12/RX24 pour les deux robots
2014-04-05 Pas besoin de position MID pour la sortie du bras en fin de compte..
2014-04-05 Mise à jours des positions, des droits des états du bras Mise à jours des protections d'angle max et min Ajout d'une fonction pour bien géré le couple du moteur
2014-04-05 Correction d'une erreur dans les fonctions actionneurs du bras Correction clock actionneur Correction terminal actionneur
    [act_functions.c, clock.c]
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2014-04-05 Séparation des données du bras en fonction que l'on soit pierre ou guy
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2014-04-05 Initialisation en position du bras s'il n'est pas correctement placé au début Petit ajout le bras envoie un bon retour si on lui demande comme position celle ou il est
    [Arm.c, Arm.h]
2014-04-05 Augmentation de la taille des messages CAN actionneurs pour passer les données des triangles pour le bras
2014-04-05 Ajout des fonctions qui vont bien pour l'envoi de donnée de la position de prise du bras en actionneur Correction d'un warning (include)
    [act_can.c, act_can.h, act_functions.c, act_functions.h]
2014-04-05 Simplification des prises de decision dans la sub action initiale de pierre
2014-04-05 Modification/correction fonction actionneur bras Modification stratégie bras de guy
    [act_functions.c, act_functions.h]
2014-04-05 Ajout / Correction de la fonction de placement à une position XY avec le bras
    (Erreur persistante : problème de communication MSG_CAN, quelque correctif de valeur de servomoteurs à faire)
    [Arm.c]
2014-04-05 Modification des fonctions actionneurs pour l'envoie d'un message CAN actionneur de 8 octets
2014-04-06 Révision 2000, modification de l'attente à 2000 -> rien que pour le plaisir...
2014-04-06 Correction en mode virtuel parfait : envoi du CARTE_P_ROBOT_CALIBRE
    [sequences.c]
2014-04-06 Divers correction/ajout liée au bras du robot Différentiation rayon des deux robots Gestion du placement de l'avant bras à gauche ou à droite du bras Correction de calcul Correction de valeur des ser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
    Bug : bon placement du bras à l'exception d'un décallage en angle...
    [Arm.c]
2014-04-06 Correction bug d'initialisation du bras
    [Arm.c]
2014-04-06 positions de dépose fresques plus éloignées des borsd (Pierre est gros !) file_fresco : modification de l'algo de sortie en cas de rencontre adverse... Inspirez vous de cet algo pour les autres cas s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
2014-04-06 Modification des données du bras Correction des derniers bugs
    [Arm.c]
2014-04-06 Modification de la stratégie de test du bras de guy à titre d'exemple d'utilisation (version non final des fonctions haut niveau...)
2014-04-06 est_dans_carre : peu importe l'ordre des coordonnées... (ca permet d'appliquer cette fonction à des points calculés par COLOR_Y()) Pathfind : modification des points qui tangeantent le foyer central.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
    [Pathfind.c]
2014-04-06 Echappement des premiers points (jusqu'à l'arbre) Refactoring de protected_fires pour qu'elle rende la main à chaque point (permet de prendre d'autres décisions urgents plus régulièrement).... l'allu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
2014-04-06 Possible correction pour le placement en force de l'angle à la fin du match (à tester)
2014-04-06 Placement du bras en XY seulement, une autre fonction gérera la hauteur.
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2014-04-06 Changement complet de la manière de paramètré les droits entre les états, cela se fait maintenant via la fonction add_perm_transitions_table dans la fonction init_perm_transitions_table du fichier Ar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
2014-04-06 Modification terminal Ajout de protection dans le code du placement du bras Configuration des valeurs pour la suite d'état de retournement de triangle
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2014-04-07 Activation de file_fruit pour la strat high_level et sort de protected_fires des le flag stop_request est active
2014-04-08 Diminution accélération et vitesse en rotation pour Pierre.
    Sous quantification de l'algo de calcul des courbes à 0... (pas de sous quantification).
2014-04-08 Tentative de correction d'un bug facheux... Mais outre cette correction, je crois qu'on peut encore mieux faire. J'ai quelques idées....
    [Pathfind.c]
2014-04-08 Meilleur réglage des coefs : - odométrié rotation - Kv, Kp, Kd C'est pas encore ça... 1- la strat de réglage coef rotation ne fonctionne pas 2- on passe trop près des bordures pour le lancé et la dép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
2014-04-08 Tentative d'éloignement du bac pour les points de sorties des dépose fruit et lances. A confirmer dans la pratique. + dépose de la fresque sur une position par défaut dépendant de la couleur. (c'est 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
2014-04-08 A tester... le pathfind ignore le premier point s'il en est proche
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2014-04-08 Modif point de sorti des le debut Ne devrait plus retourner deposer les fruits e high strat level si il l a fait en sub_action_initiale
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2014-04-09 Ajout fonction display_float pour affichage rapide expression flottante Ajout d'une fonction pour avoir une chaine de caractère à partir d'un float
2014-04-09 Implantation de la gestion du moteur DC avec via la commande ACT_ARM_UPDOWN_GOTO Correction d'une redéfinition
    [Arm.c]
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2014-04-09 Completion de la stratégie de dépillage de torche Correction des fonctions liées à l'ARM
    PS : stratégie non compilable... enumération inconnue, variable globale inconnue... à corriger ou alors mettre tout en commentaire
2014-04-09 erreur de compile corrigée
    [act_functions.c]
2014-04-09 Hokuyo : envoi d'un message lorsque l'hokuyo fonctionne mais qu'on a pas vu d'adversaire sur le terrain...
    -----> ce qui permet de considérer en strat qu'il n'y a pas d'adversaire (on utilise pas la balise dans ce cas, préférant faire confiance à l'hokuyo même s'il n'a rien vu).
    + correction zone d'acceptation dépose fruit.
    + déclaration dès que la dépose des fruits est finie de la désactivation de la sub de dépose
    + modif zone d'acceptation position lancé... (à vérifier avec les valeurs de vitesse actuelle...)
    [detection.c]
2014-04-09 diverses correction : pathfind, moins de spam messages balise sur SD, + de spam pathind sur SD pour comprendre mieux les choix du robot.
    [Pathfind.c, Pathfind.h, avoidance.c, avoidance.h, brain.c, environment.c]
2014-04-09 Distance d'ignorance des points Hokuyo : 250 (sinon on semble s'éviter nous même dans les coins.....)
2014-04-09 Diverses corrections de la stratégie...
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2014-04-09 Probleme de lancer de balle quand pierre sort de la calibration Guy : modife fonction de la torche
2014-04-09 Modification ID, position des actionneurs de pierre Modification position bras Guy Ajout nouvelle actionneur pierre TORCH_LOCKER (pince à torche) Ajout des messages CAN qui vont bien avec l'ajout de 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
2014-04-10 Ajout d'une nouvelle queue pour le labium ne depend plus du verin des fruits
2014-04-10 Hokuyo : Marge avec avec le décord augmenter et enlevement de 5° au angle maximum de l'Hokuyo
2014-04-10 Strat de déplacement pour naive pour guy pour la belgique testée uniquement en simulation
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2014-04-10 Ajout actionneur torche locker et correction warning
    [avoidance.c]
2014-04-10 Ecrasement du foyer central lors d'un get_in de ramassage arbre... à cause d'un static manquant : corrigé.
2014-04-10 S'oriente et sort le bras au bon moment lors de la rammasse des fruits
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2014-04-10 Correction actionneur torch locker Modification verbosité de tous les actionneurs Complétion terminal
    [Arm.c]
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2014-04-11 Modification de la façon d'alimenter la pompe fruit mouth (PWM -> PIN out)
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2014-04-11 Ajout arrêt de la pompe quoi qu'il arrive à la fin du match Complétion implantation PIN I/O à la place de PWM
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2014-04-11 Agrandi la ligne droite d'un arbre en jaune et supprime une rotation qui servait pour la torche
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2014-04-13 Ajout fonction de test avant de lancer la trajectoire (non active !) Modification de la réinitialisation des l'updated des ennemies pour ne pas faire d'accoup (ou trés trés trés petit) Ajout fonction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
2014-04-14 Ajout du selftest de l'actionneur manquant, qui engendrai le TIMEOUT du selftest actionneur car moins de selftest que d'actionneur et engendrai l'erreur ACT_Missing_Test
2014-04-14 Ménage de printemps pour y voir (un peu) plus clair dans avoidance.c + mémorisation du dernier point visé... pour utilisation éventuelle par un GET_IN... mais je ne suis pas sur que cela suffise...
    [Pathfind.c, avoidance.c, avoidance.h, environment.c, environment.h]
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2014-04-14 Ajout du message CAN : DEBUG_PROPULSION_SET_ACCELERATION + data sur 16 bits... -> modification en live de l'accélération.
2014-04-14 Cette méthode de mémorisation de la destination ne me plait pas... il faudrait descendre au niveau stack.. mais c'est plus compliqué...
2014-04-14 Ajout d'un SELFTEST_AVOIDANCE, dans la séquence de selftest afin que pendant 5 secondes le robot fasse bip bip si un ennemie est situé à sa position + 500 en x
    Permet de tester le bon fonctionnement de l'évitement avant de lancer la match
2014-04-14 Modification de la zone testé lors du selftest_avoidance maintenant c'est devant le robot qu'on soit rouge ou jaune
2014-04-14 Réactivation du script de check_foe_in_zone avant de lancer un try_going Correction de warning floodant... (Ajout de "const" pour toutes les fonctions de déplacements, de toute façons on a pas le dro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
    [avoidance.c, avoidance.h]
2014-04-15 Revert for next fusion.
    [detection.c]
2014-04-15 Prise en compte des données balises dans l'angle mort Hokuyo. Correction de l'homogénéité dans le calcul des x et y adversaires balises.
    [detection.c]
2014-04-15 Quelque cast sur la fonction foe_in_zone qui fonctionne pas correctement
    [avoidance.c]
2014-04-16 Ajout strat d'extraction, pour le moment elle est implenté nul part (non testé) Ps : ne sait pas si on doit la gere comme une error_e ou non
    [avoidance.c, avoidance.h]
2014-04-16 Optimisation des positions des positions et de la vitesse pour la recuperation des fruits
2014-04-17 Quelque correction de foe in zone mais ne fonction pas encore pleinement
    [avoidance.c]
2014-04-17 Corrections / suggestions / modifications de extraction_of_foe() Anthony : ton avis ?
    [avoidance.c, avoidance.h, state_machine_helper.h]
2014-04-17 Correction d'angle de vision hokuyo
2014-04-17 Ajout distance minimum d'évitemment ET correction de la façons de réinitialisé les adversaires
    [avoidance.c, detection.c]
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2014-04-17 Nouvelle sequence de calibration commence par ce calé en y puis en x plus rapide
2014-04-17 Ajout des fonctions pour les pinces avant Debut de la strat de pierre avec possibilité de modifier des switchs pour lancer de balles et debut si on commence par deposé la fresque ou non Plus nettoyag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
2014-04-18 ! CODE NON TESTE........
    foe[].updated -> foe[].enable
    Du coup, correction de la façon d'afficher les adversaires à l'écran. (flag spécifique)
    BRAIN : désactivation des strats non commit (?)
    La gestion de la péremption des infos adversaires est désormais gerée directement par le module détection... Il suffit de consulter le bit enable pour chaque foe.....
    Autre modif importante : les adversaires balises sont rangés dans des cases à part (sinon on écrase les choses n'importe comment).
    Du coup, un adversaire balise dans l'angle mort hokuyo n'est plus écrasé à un instant hasardeux par d'autres adversaires hokuyo !!! (rien que ça...)
    [Pathfind.c, avoidance.c, brain.c, detection.c, detection.h, environment.c, environment.h]
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2014-04-18 Corrections de la fusion de données. Code testé.
    [detection.c, environment.c, environment.h]
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2014-04-24 Va a plus de point d'extraction si il y a qu un seul robot au pres de lui. Ex: Si un robot est pres devant notre robot, va pouvoir rejoindre un point qui se situe derriere lui. Par contre, si deux ro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
2014-04-25 Augmentation du seuil de détection de la non-présence des DT10s (Soucis dû à la vitesse de switch entre la lecture de chaque ADC, il y a un effet mémoire, et on est déjà à la fréquence de sampling la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
2014-04-25 effacer les données si elles ne sotn pas mise à jours par IR
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2014-04-26 Suppression du buzzer pendant l'extraction (5 buzzs de 1 seconde, c'est beaucoup) + correction de detection.c
    [avoidance.c, detection.c]
2014-04-28 Avec PWM_init, ca marche mieux. PWM passée à 30% (pour nouveau labium...)
2014-04-28 Ajout de fonction de modification de la valeur max des PWM du moteur DC
2014-04-28 Avancement bras... Fonction rush in the floor fonctionnelle Fonction de recherche du chemin le plus court entre les différents état du bras (codé, non testé/intégré) Divers modifications de position 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
2014-04-28 Corrections de l'initialisation des PWMs des actionneurs l'utilisant
    [Arm.c]
2014-04-28 Code non actif, à tester : coefs translation plus durs pendant les rotations.
2014-04-28 Désactivation de l'asservissement de Guy une fois calibré... pour que Pierre le pousse s'il démarre (et que Guy n'a pas démarré) Code NON testé !! Voir tasklist pour protocole de test. Du coup, il es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
    [environment.c, secretary.c]
2014-04-28 Accès en stratégie aux coefs de la propulsion... Pas de rupture de compatibilité avec les codes et docklight existants. Code non testé !
2014-04-28 Filtrage par moyennage des 3 dernières distances balises. (ou moins si des points invalides précèdent...) Code non testé.
2014-04-29 destination du premier ordre envoyé à la suite d'une désactivation des correcteurs .... écrasée par la réactivation des correcteurs. Problème solved.
    [copilot.c]
2014-04-29 Correction choix de match
    [brain.c]
2014-04-29 Ajout coefficient odom symétrique Nettement mieux avec pour faire les fruits adverse
2014-04-29 Modification code actionneur et stratégie pour faire passer des arguments avec le retour des résultats
2014-04-29 Ajout define PWM quand rush in floor Avancement bras fonction de path Nouvelle position small bras
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2014-04-29 Ajout vibration du verin a fruit pour la depose
    [act_functions.h]
2014-04-29 Correction pathfind du bras
    [Arm.c]
2014-04-29 Ajout de la commande print match en console -> print_match (non testé)
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2014-04-30 Selftest : correction mineure + affichge sur LCD...
    SD : correction du print_previous_match
2014-04-30 Modification de la fonction LCD_printf ajout d'un argument si nous voulons être redirigé sur le menu ou est afficher le printf
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2014-04-30 Ajout de un capteur pour la pose de la fresque fonctionne très bien
2014-05-01 Ajout d'un \n de plus dans l'affichage des résultats des actionneurs pour améliorer la lisibilité pendant le lecture de l'uart
2014-05-01 Nouveau coefficient PID du bras (réagis plutôt bien pour les trois utilisations demandées (vide, triangle, torche)
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2014-05-01 Ajout d'une position intermédiaire lors de la sortie du bras Ajout de fonction "moyen" niveau d'utilisation de rush in the floor en stratégie Modification de la stratégie de dépillage de torche (ça c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
    [Arm.c, act_functions.c, act_functions.h]
2014-05-01 Complétion de la verbosité des messages CAN Ajout de quelque détails sur messages CAN
2014-05-01 Ajout d'un GET_IN dans la subaction filet qui pali le problème de traversement de milieu
2014-05-07 Strat_initiale de guy... - chemin de démarrage choisi par les switchs 2 et 3. - do_torch remasterisé ... Attentions aux nombreuses préconditions. Mais ce n'est pas trop gênant étant donné que le do_t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
    TODO
    - points à perfectionner...
    - tester chaque combinaison de configuration
    - ajuster les points permettant le dépilement de la torche (arnaud ?)
    - poursuivre les subactions de Guy
    - meilleure gestion adverse au début de la sub initiale (changement de chemin... ?) cf code de tiny..
2014-05-09 Rangement de certaines fonction d'asser à leur place. Clignotement de la led couleur y compris pendant le match... et y compris si l'on désactive le XBEE avec le switch
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2014-05-09 Changement du démarrage pour Guy... on attend plus Pierre, c'est contre productif... Correction du bogue qui empechait d'aller redéposer les fruits suite à un cas d'échec Selftest : ajout de la vérif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
2014-05-09 Selftest : ajout de la vérif du lien XBee avec l'autre robot et de la position du switch XBee
2014-05-12 correction position calage Guy
    [_Propulsion_config.h]
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2014-05-12 act_can : Ajout d'un accesseur pour obtenir les paramétres du résultat d'un actionneur Mise sous commentaire d'une petite partie de code qui désactivait la gestion de multiples retour pour une action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
    act_functions :
    Déplacement des fonctions de gestion du bras dans act_function
    Modification des fonctions de gestion du bras
    element :
    Ajout d'une fonction d'attente sous forme de subaction
    actions_guy :
    Suppression des fonctions de gestion du bras
    Refonte de la subaction de dépilage de torche
    act_queue_utils :
    Correction d'envoie des parametres
    [act_can.c, act_can.h, act_functions.c, act_functions.h, elements.c, elements.h]
2014-05-12 Augmentation du seuil de la position fictive lors d'un rush in the floor du bras
2014-05-13 Ajout capteur laser torche Pierre
    [pin_usages.xls]
2014-05-13 element : Augmentation du timeout de la pompe
    Quelque correction
    arm_data :
    Modification des positions de retournement de triangle
    Ajout d'un état intermédiaire pour la prise d'un triangle retourné
    pompe :
    Modification sens pompe car les tuyauts on été mit dans l'autre sens
    small_arm_config :
    Modification des positions du small bras
    QS_can_msgList :
    Ajout d'étape intermédiaire pour la prise d'un triangle retourné
    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
    [Small_arm_config.h, elements.c]
2014-05-13 Ajout de la création du machine à état sans verbose Modification de RESET_MAE pour géré le cas d'initialisation pour l'entrance du premiière état
    [state_machine_helper.h]
2014-05-13 avoidance : Ajout d'un argument à la fonction foe_in_zone afin de pouvoir activer la prise en compte de l'ennemie dans toute la trajectoire ou seulement dans la distance d'évitement
    maths_home :
    Ajout de la macro SQUARE
    state_machine_helper :
    Ajout de protection pour la macro RESET_MAE si on l'utilise dans un if simple
    selftest :
    Modification des appels de la fonction foe_in_zone
    [avoidance.c, avoidance.h, state_machine_helper.h]
2014-05-13 ne devrait plus taper dans le bac, lors tire balle et sa tendance à tangenter le bac lors de la dépose
2014-05-13 Affichage de l'état des switchs sur le menu utilisateurs ligne 1 et 2
2014-05-14 localisation adverse Hokuyo qui redémarre après OFF/ON de son alim. Correction séquence guy : avance de 15cm au lieu de 10 pour VOIR si on rebondi moins (à tester)
    [sequences.c]
2014-05-14 Modif de l'accélération au démarrage de Guy. + diverses corrections...
    [Pathfind.c]
2014-05-14 clock : Modification de type de variable de temps
    Pfruit :
    Ajout d'un timeout sur l'asservisement du moteur du labium
2014-05-14 arm_data : Ajout de la succession de position pour verrouillage torche
    Ajout du mot clé 'const' pour avoir moins de warning et ça n'impacte pas le code
    QS_CANmsgList :
    Ajout des états pour le verrouillage torche
    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
2014-05-14 Modification de l'ordre des actions pour le selftest du labium sortir -> ouverture/fermeture trappe -> rentrer. Car pouvait rester bloqué pendant le selftest
2014-05-15 button : Ajout de la fresque 3 et modification fresque 1/2
    config_pin :
    Modif nom fresque 2
    config_qs :
    Ajout utilisation AN12
    Ajout de la fonction get_fresco qui renvoie l'état d'une fresque
    Modification du selftest en rapport avec les fresques
    pin_usages :
    Ajout modification port fresque 2/3
    Ajout error sefltest fresque 3
    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
    [pin_usages.xls]
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2014-05-15 Ajout de la position ACT_ARM_POS_TAKE_ON_ROAD pour la prise d'un triangle lors d'un déplacement
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2014-05-16 Modification de l'affichage de l'avertissement du changement de batterie, il reste affiche jusqu'a ce qu'on appuie sur le bouton OK, et reprends le refresh de la tension Affichage du numéro du match 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
2014-05-16 act_queue_utils : Ajout des noms des actionneurs pour le débug sur terminal
    PTorch_locker :
    Correction du problème d'asservisement (Il partait juste en erreur dû à des mauvaises positions checké)
2014-05-16 Légère correction switch save guy
    [button.c]
2014-05-16 Ajout envoie message XBEE, qui dit à pierre si ce dernier a fait les triangles ou non + Pierre fait les triangles si il ne reçoit pas ce message
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2014-05-16 Si action de TORCH_LOCKER echoue, on recommence sa derniere action au bout de 3 sec
    ACTQ_push_operation_from_msg : choix maintenant d'envoyer ou non, le message vers les autres cartes
2014-05-16 Correction position et ordre, pour les lancers de balles
    [avoidance.c]
2014-05-16 Strat homologation pierre, elle fait juste les balles, le filet et quelques feux
2014-05-17 - Couleur du robot virtuel. - Taille du robot virtuel (réglage de who am i avec PC13)
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2014-05-17 Modification strat homologation, la strat filet ne coupe plus la strat protected_fires lors d'un deplacement
2014-05-17 Action_pierre : gestion des DODGE là ou c'est pertinent. + quelques modifs de conditions et de gestion d'erreur.
2014-05-17 Codé non testé.
    Gestion des erreurs un peu partout.
    L'extraction dispose d'un argument speed.
    Activation de l'évitement sur Pierre dans les 5 premières secondes de match si Guy indique qu'il est bloqué au nord.
    Filet : extraction manuelle en FAST
2014-05-18 Refus de backward en propulsion à cause d'un problème de limite. + meilleure sécurité sur le atan2(0,0) impossible !
2014-05-18 Détail pour utilisation du robot virtuel parfait et éviter le flood...
    Attention, on considère que seule la stratégie est à l'origine d'un BROADCAST !!! Donc ils ne seront pas retransmis sur le busCAN s'ils viennent de l'extérieur.
    (ca n'a pas de sens d'envoyer le BROADCAST_COLOR ou le BROADCAST_START de l'extérieur...)
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2014-05-20 Ajout de sub_wait dans actions_both. =0 pour forcer l'état initial des MAE à être l'état 0...
2014-05-20 Correction selftest batterie, nouveau filtrage qui bip si on le fait à l'ARU mais pas pour les rush in the wall etc
2014-05-20 Ajout de la gestion du couloir d'évitement pour guy pour le foe_in_zone codé non testé
2014-05-20 Modification pour pour les capteurs des fresques on peut utiliser la fonction ou les define afin que ça soit rétro compatible
    [pin_usages.xls]
2014-05-20 Ajout de la machine à état de dépillage de torche de pierre codé non testé
2014-05-20 Ajout d'une fonction de reset manuel du bus I2C, avec l'appel de celle-ci sur le bouton OK du menu principal codé non testé
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2014-05-20 extraction_of_foe s'extrait que si la rotation est possible ou bien que l'angle soit de sortie soit inférieure a 10°
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2014-05-21 Simplification de l'algo, et traitement du cas où le point choisi n'était pas à 0° de notre position et où il nous est en fait possible de s'extraire sans tourner.
2014-05-21 get_fresco renvoit maintenant TRUE si la fresque est là. (Parce que ca me saoulait...)
2014-05-21 Modification des pins des moteurs
    [pin_usages.xls]
2014-05-21 maj pin usage
    [pin_usages.xls]
2014-05-22 Jusqu'ici, on considérait que le labium était vide lorsqu'on le fermait. Ce qui fait qu'en cas d'évitement avant la fermeture normale, on ne le considérait pas vide...
    Amélioration : on considère le labium vide au bout de 500ms après l'ouverture. (réglable par define...)
    Si on a rencontré l'adversaire lors de la dépose, on ira redéposer ailleurs que si le labium a été ouvert moins de 500ms, ou n'a pas été ouvert !
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2014-05-22 Correction ordre de close du labium bien prit en compte
2014-05-22 Ajout try_advance qui avance ou recule selon le sens du robot que nous lui donnons.
    Guy se met correctement en position sur le foyer rouge
    [avoidance.c, avoidance.h, elements.c]
2014-05-23 Correction PWM labium : PWM2 Ascenseur Bras : PWM1
    [pin_usages.xls]
2014-05-23 Inversion relevé des capteurs fresques. Le capacitif (PC1) renvoie 0 si fresque présente. Les inductifs (PC2 et PB1) renvoie 1 si fresque présente.
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2014-05-25 Amélioration de la précision du bras Correction QS_AX12
    [Arm.c]
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2014-05-25 act_can : Correction des dernier paramètre recut Réintroduction de la protection des messages CAN actionneurs indésirable
    Correction d'une condition pour un meilleur fonctionnement
    arm :
    Correction envoie de message durant un déplacement du bras dans son pathfind, envoie d'erreur s'il y en a une, envoie de DONE qu'à la dernière action
    Correction placement du bras quelque soit le placement de la torche par rapport au robot, quelque soit l'angle du robot
    Correction du rush_in_the_floor
    Différentiation AX12/RX24 dans l'enum
    arm_config
    Modification de paramètre
    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
    [Arm.c, act_can.c, act_functions.c]
2014-05-25 Ajout de quelque pause pour la stabilisation, dépille une torche quelque soit l'angle du robot et de la torche (testé sur bureau à testé sur terrain)
2014-05-25 Ajout de la fonction return_on_edge qui permet de retourné un triangle sur le bord du terrain
    Correction de la gestion d'erreur des fonctions du bras (le triangle qui reste dans le robot quand on erreur)
    TODO : GET_IN / GET_OUT sur les fonctions return on edge et take_on_edge
    Factorisation des fonctions pour prendre une fonction ou l'autre en fonction de la couleur
    Possible factorisation du GET_IN et GET_OUT
    Je dis TODO car je passe sur pierre un peu et je le ferrai plus tard ou si quelqu'un veut le faire
2014-05-25 Correction taille minimum d'un match sur la SD
2014-05-25 Correction point d'échappement des arbres
2014-05-25 Correction selftest fresque Ajout selftest laser de la torche Etalonnage du laser de la torche
    [elements.c]
2014-05-25 Correction selftest laser torch que pour pierre Correction selftest torch locker incompréhensible... Optimisation des boutons actionneurs le bouton 0 gère l'intégralité du labium
    [main.c]
2014-05-25 Modification de la vitesse de calibration afin d'éviter de rebondir contre le bord A tester
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2014-05-25 Code du bras de pierre ajouté Amélioration rush in the floor et ajout pour le bras de pierre Amélioration terminal Ajout selftest bras pierre (cependant pose problème avec le labium...) Augmentation 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
    Maj pin usages
    [pin_usages.xls]
2014-05-26 Ajout position take_on_road_mamouth pour la prise du triangle devant le mamouth avec le bras Correction position AX12 poignet du bras de pierre
    [Arm.c]
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2014-05-26 Selftest le bras sort pour ne pas géné le labium Correction compatibilité pierre/guy init queue dans le main...
    [main.c]
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2014-05-26 Arrêt de la propulsion à la fin du match (codé testé mais pas lors d'un match)
2014-05-27 Dépillage de torche pour pierre, codé non relu/non testé (tard + doit pas faire de bruit...)
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2014-05-27 Correction déssaservissement fin de match
    [_Propulsion_config.h, copilot.c, main.c, secretary.c, supervisor.c]
2014-05-27 Correction de la position de la torche
    + Mise en commentaires du flood "offset"
    [elements.c]
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2014-05-28 Distance balise : +20%. ERROR 4 (Tache trop grande) considérée comme un robot adverse à une distance "proche" de 25cm.
    [detection.c]
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2014-05-28 Deplacement de la fonction strat_tourne_en_rond en action commune sert pour le calage en symétrie
2014-05-28 Dépillage torche pierre Correction position / rush_in_the_floor Correction terminal/term_io.c Ajout message CAN bras
    [Arm.c, Small_arm_config.h]
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2014-05-29 Creation de la fonction prise du triangle verticale, pour pierre dans la zone de départ Ajout new position de bras
2014-05-29 Possibilité de régler en strat le seuil d'erreur de la propulsion translation.
2014-05-29 tentative de correction de l'odométrie... on atteint sans doute les limites méca... et nos coefs empirent le comportement.
    [_Propulsion_config.h, copilot.c]
2014-05-29 Modif sequence de calibration de guy, ne fait plus de rotation a la fin
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2014-05-29 Correction V_triangle Correction Arm Ajout message CAN pour le bras Modification des coeffcients d'asservissement du moteur
    [environment.h]
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2014-05-29 calibration Pierre : un poil plus de force. Corrections diverse de la sub de recalage. + Manchot
    [_Propulsion_config.h, environment.c, environment.h]
2014-05-29 On vire GOTO_HEARTH... en cas d'échec de dépose torche, on va vers l'arbre 2...
2014-05-29 Corrections diverses. Calage, Sub manchot de GUY : 4 feux...
    [secretary.c, sequences.c, sequences.h]
2014-05-29 - Correction gestion d'erreur sur dépose fresques - Info 'B' ou 'H' lorsque foe in path
    [avoidance.c]
2014-05-29 correction.. + modif de la strat manchot de guy (poussé des feux seulement en forward)
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2014-05-29 Ajout position take on road et pour la depose de notre torche sur le foyer centrale
2014-05-30 Correction contraceptive pour pas que les deux robots s'embrassent au démarrage.
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2014-05-30 Modif eloignement du labium par rapport au arbre et ne sort plus le bras en début de match pour le premier triangle
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2014-05-30 Ajout de la fonction error_e put_fire_down(void) qui dans un premier temps va simplement poser un feu sur le foyer de bord de terrain de notre couleur. Suite à venir.
    [state_machine_helper.h]
2014-05-30 Ajout de la poussée du triangle sur la fresque lorsque le define n'est pas commenté
2014-05-31 Modif odo sym pierre ajout action de bras pour les phases de qualification modif strat start triangle pierre Et nouvelle position bras de guy
2014-05-31 Avancement bras, ça dépille bien en rouge, il faut mieux pas posé la torche sur le foyer. En jaune ça dépille aussi avec plus de difficulté car on est décallé.
2014-06-01 Fond de panier 2015.
    [2015_FDP.PrjPcb, 2015_FDP_ACTIONNEUR.SchDoc, 2015_FDP_PROPULSION.SchDoc, 2015_FDP_SCHEMA.SchDoc, 2015_FDP_STRATEGIE.SchDoc]
2014-06-01 pin_usages.xls pour 2015 / premières réflexions
    [pin_usages.xls]
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2014-06-01 Correction du reset du LCD lors de l'appui sur OK, l'erreur passait initialized a FALSE et on ne pouvait plus rien faire il faut juste réinit la variable aussi.
    TODO : Vérifié si l'erreur est provoqué par un timeout ou par le manque de watchdog
2014-06-03 Pour la gloire : correction du bogue qui nous aurait fait passer en quart de finale.
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2014-06-28 Finition du fichier des it externe Faire attention plante facilement la carte
2014-06-28 Gyro : mise à jour datasheet. Gyro : Récupération de la vitesse en rotation OK. Non prise en compte pour l'instant dans l'odométrie. L'utilisation du define USE_GYROSCOPE n'a pas d'impact néfaste sur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
2014-06-29 Première étape : récup des infos de détection en Propulsion. (il manque encore le renommage du SID balise en un message broadcast pour pas qu'il soit filtré par la propulsion).
2014-06-29 (0x251) BEACON_ADVERSARY_POSITION_IR -> 0x006) BROADCAST_BEACON_ADVERSARY_POSITION_IR Y compris sur le récepteur IR dsPIC !!! WARNING : Donc sans reprogrammation du récepteur, les balises ne fonction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
2014-06-29 2015_IHM - schéma bien avancé...
    [2015_FDP_SCHEMA.SchDoc, 2015_IHM.PcbDoc, 2015_IHM.PrjPcb, 2015_IHM.SchDoc]
2014-06-29 Modif IHM (non portées sur le schéma...) : ajout port SPI RFU.
    [pin_usages.xls]
2014-06-30 diverses corrections
    [2015_IHM.SchDoc]
2014-07-02 Ajout de Steps + mise à jour librairie / Ihm++
    [2015_IHM.SchDoc, WURTH_BORNIER_VIS_2V_5.08.stp, WURTH_RJ12_0°_615006144121.stp, WURTH_RJ12_HalfShieldedTabDown_615006143421.stp]
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2014-07-07 et c'est parti pour le routage...
    [2015_IHM.PrjPcb, 2015_IHM.SchDoc]
2014-07-12 Réinitialisation des configurations des AX12 lors d'une instabilité ou un arrêt de l'alimentation
2014-07-12 Ajout de la configuration de la vitesse / couple à partir de la stratégie Nouveau manager qui remplace les managers différent pour chaque robot
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2014-07-22 step inter
    [switch SPDT - 11x6x5.STEP]
2014-07-23 steps 3D
    [Fourche Optique Biroute OPB815WZ.STEP, WURTH_5V_3.5mm_691321100005.stp, WURTH_5V_femelle_cable_0_691361100005.stp, WURTH_5V_femelle_cable_90_691363110005.stp]
2014-07-31 Routage. TODO : ajouter les capas pour les pads de l'écran...
    [2015_BeaconEye.SchDoc]
2014-08-09 IHM sérigraphie.
    [2015_IHM.SchDoc]
2014-08-11 Ajout de deux entrées ADC.... en cas de besoin.
    [2015_BeaconEye.SchDoc]
2014-08-26 2015_beaconLed... + datasheet pour carte CNC
    [2015_BeaconLed.PcbDoc, 2015_BeaconLed.PrjPcb, 2015_BeaconLed.SchDoc]
2014-08-26 maj beacon_led pour empreinte 3D
    [2015_BeaconLed.PcbDoc, 2015_BeaconLed.SchDoc]
2014-08-28 fdp++ cnc : draft2
    [2015_FDP.PrjPcb]
2014-08-29 début schéma struct
    [2015_CNC.PrjPcb, 2015_CNC.SchDoc]
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2014-09-04 Lib : ajout protection ESD ST1284 + QSOP28 CNC : schéma++ FdP : détails
    [2015_CNC.SchDoc, 2015_FDP_ACTIONNEUR.SchDoc, 2015_FDP_PROPULSION.SchDoc, 2015_FDP_STRATEGIE.SchDoc, Circuit intégré.SchLib]
2014-09-04 Modif NMOS sleep -> PMOS
    [2015_CNC.SchDoc]
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2014-09-07 Correction fonction _write dans QS_uart.c Correction problème d'overflow appel de fonction SUPERVISOR_set_treshold_error_translation(
    [supervisor.c]
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2014-09-11 Robot focntionne que sur le gyro pour les rotations (plus de roue codeuses sur les corrections en rotation)
    [odometry.c]
2014-09-11 Ajout de brain.c au archive strats_2014 Modification faite sur le test Servo Ajout de l'enumeration avoidance_e dans la QS pour préparer le déportage de l'évitement en propulsion
    [brain.c, config_pin.h]
2014-09-11 Correction casse de nom de fichier #include "selftest.h" => #include "Selftest.h" (causait une erreur de compil sur linux)
2014-09-12 Bug de tabulation
2014-09-12 Nettoyage des fonctions bas niveau de propulsion Ajout d'un argument avoidance au fonctions bas niveau de propulsion Transmission de l'argument avoidance via message CAN de déplacement vers la propul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
    [avoidance.c, pathChecker.h, prop_functions.c, prop_functions.h, roadmap.c, roadmap.h, secretary.c, sequences.c]
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2014-09-14 Modification de la QS - Ajout de QS_maths afin de ne plus re-créer les mêmes fonctions partout et de tout centraliser - Ajout de quelques mesure dans QS_measure nécessaire pour l'évitement - Ajout du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
2014-09-14 Ajout d'une base de gestion de l'évitement par la stratégie (en cours)
2014-09-14 Ajout d'une base de gestion de l'évitement par la propulsion en stratégie* (en cours)
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2014-09-17 Réorganisation, rafraichissement, nettoyage (principalement avoidance.c/h)
    [avoidance.c, avoidance.h, state_machine_helper.h]
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2014-09-18 Correction try_rush Nettoyage, réorganisation stack et prop_functions Ajout de l'affichage du time de TIMEOUT que subit la stack
    [avoidance.c, prop_functions.c, prop_functions.h]
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2014-09-19 Correction gestion wait complémentaire
    [prop_functions.c]
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2014-09-20 IHM : modif connecteur SPI
    [2015_IHM.SchDoc, 2015_Pannel.PcbDoc, Pannel.PrjPCB]
2014-09-20 Ajout des mesures 24Vperm et 24Vpsce...
    [pin_usages.xls]
2014-09-21 pin_usages.xls.. ajout servos sur actionneur + capteurs TOR sur strat.
    [pin_usages.xls]
2014-09-21 pull-up I/O servos AX + de connecteurs servos 5V ajoutés sérigraphie connecteurs 3V, 4V, 5V -> 3.5mm connecteur gyro -> 6V_3.5mm modifs empreintes 3D diverses...
    [2015_FDP_ACTIONNEUR.SchDoc, 2015_FDP_PROPULSION.SchDoc, 2015_FDP_SCHEMA.SchDoc, 2015_FDP_STRATEGIE.SchDoc, 2015_IHM.PrjPcb, Connecteur.SchLib, USB3105-30-A_revE.STEP, USB_micro_coudé.STEP]
2014-09-21 GYRO... -> Changement de la période de l'IT propulsion... uniquement pour la lecture GYRO... (l'IT est lancée toutes les ms... mais le code de prop est appelé toutes les 5ms, comme avant...)
    Odometry... gestion du gyro : filtrage de la déviation sur 20 secondes.
    Résultat : nettement plus stable lorsque le robot ne bouge pas... Donnée semble correcte sur mouvements légers...
    TODO : a tester sur des mouvements + rapide... / en match.
    + ajout de doc ...
    [_Propulsion_config.h, gyroscope.c, gyroscope.h, it.c, odometry.c]
2014-09-22 ajout 3v3 sur RJ12 uart pour alim du bluetooth....
    [2015_BeaconEye.SchDoc]
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2014-09-24 Relecture schéma CNC Création fichier PCB (composants non importés...)
    [2015_CNC.PcbDoc, 2015_CNC.PrjPcb, 2015_CNC.SchDoc]
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2014-09-24 Ajout de la possibilité d'utiliser le buzzer sur toutes les cartes via le bus CAN (pour du débug)
    [environment.c]
2014-09-25 je ne sais plus trop...
    [2015_FDP_ACTIONNEUR.SchDoc, 2015_FDP_SCHEMA.SchDoc]
2014-09-25 Imports composants Pcbdoc.
    [2015_CNC.PcbDoc, 2015_CNC.PrjPcb, 2015_CNC.SchDoc]
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2014-09-27 MAJ placement composants
    [2015_CNC.PcbDoc, 2015_CNC.SchDoc]
2014-09-29 Quelques composants pour la carte CNC. +Tentative de compression du placement... pour permettre un choix de boitier.
    [2015_CNC.PcbDoc, 2015_CNC.SchDoc, _ROBOT.SchLib]
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2014-10-01 Modif placement carte CNC pour aligner drivers
    [2015_CNC.PcbDoc, 2015_CNC.SchDoc]
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2014-10-02 Suppression fusible + pad alims Remplacement LED CMS par 3mm
    [2015_CNC.PcbDoc, 2015_CNC.SchDoc]
2014-10-02 Commencement routage
    [2015_CNC.PcbDoc]
2014-10-02 Correction timer gyro
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2014-10-02 Ajout de ifdef pour triangulation (sinon problème de compilation) Ajout de d'une nouvelle gestion de l'accélération en rotation lors de la détection d'un point non accessible (code inactif à tester) 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
    [_Propulsion_config.h, pilot.c, pilot.h]
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2014-10-03 Correction calcul du rectangle de freinage en propulsion (utilisation d'une seule fonction pour la détection d'adversaire, à l'arrêt ou en mouvement)
    [avoidance.c]
2014-10-03 Quelques déplacements pour faciliter le routage. + quelques vias.
    [2015_CNC.PcbDoc]
2014-10-03 Rx24Duplicator - création projet pour Sujeeth.
    [2015_Rx24Duplicator.PcbDoc, 2015_Rx24Duplicator.PrjPcb, 2015_Rx24Duplicator.SchDoc]
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2014-10-03 Petite correction à la réception de l'ordre go_position en propulsion (traitement du mode courbe)
    [secretary.c]
2014-10-04 IHM : ajout mesure du 12V... sur IHM_PA4... Anthony, tu peux ajouter la gestion dans le code... (attention, cette broche, comme la broche PA5 est configurée comme sortie dans les autres codes... et j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
    [2015_IHM.SchDoc, pin_usages.xls]
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2014-10-04 Nettoyage plus profond de la stratégie Correction warning
    [Pathfind.c, config_pin.h, config_use.h, elements.c, elements.h, environment.c]
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2014-10-04 Demande de position de la stratégie vers la propulsion si la position stratégie n'est pas initialisé (cas ou la carte stratégie a été reset aprés lancement du FDP)
    [environment.c, environment.h]
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2014-10-04 Mutualisation du fichier d'export altium. Controle des diamètres de percages sur cartes 2015. Sérigraphie... DRC...
    [2015_BeaconEye.PrjPcb, 2015_BeaconLed.PcbDoc, 2015_BeaconLed.PrjPcb, 2015_CNC.PcbDoc, 2015_CNC.PrjPcb, 2015_FDP.PrjPcb, 2015_IHM.PrjPcb, 2015_Rx24Duplicator.PrjPcb]
2014-10-04 Correction des fonctions de filtrage dans QS_maths (test fait, fonction prêt à l'emploi)
2014-10-05 IHM : correction mesure voltage
2014-10-05 Sch : Correction alias incorrect Pcb : Maj routage
    [2015_CNC.PcbDoc, 2015_CNC.PrjPcb, 2015_CNC.SchDoc]
2014-10-05 Ajout affichage du rectangle d'évitement sur le LCD tactile Correction de quelque warning
    [avoidance.c, avoidance.h, detection.c]
2014-10-05 Commit schéma alim servos hitec
    [2015_ALIM_HITEC.PrjPcb, 2015_ALIM_HITEC.SchDoc]
2014-10-06 DRC OK.
    [2015_CNC.PcbDoc, 2015_CNC.PrjPcb, 2015_CNC.SchDoc]
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2014-10-07 modifs tailles trous...
    [2015_ALIM_HITEC.PcbDoc, 2015_ALIM_HITEC.SchDoc]
2014-10-07 projet sans les liens vers les librairies..
    [2015_ALIM_HITEC.PrjPcb]
2014-10-07 Placement OK Verif seriegraphie
    [2015_ALIM_HITEC.PcbDoc, 2015_ALIM_HITEC.PrjPcb]
2014-10-07 Correction erreur évitement propulsion
    [avoidance.c, avoidance.h, copilot.c]
2014-10-07 Ajout d'un message CAN DEBUG_AVOIDANCE_POLY pour envoyer les polygones d'évitement à la simulation Ajout d'une macro AROUND_UP qui permet d'avoir l'arrondie supérieur Quelques corrections dans l'évit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
    [avoidance.c]
2014-10-07 Vias + plans masses + seriegraphie OK
    [2015_ALIM_HITEC.PcbDoc, 2015_ALIM_HITEC.PrjPcb]
2014-10-07 Connecteur Sensors sur CNC... 8V * 3.5mm !
    [2015_CNC.PcbDoc, 2015_CNC.SchDoc, 2015_FDP_PROPULSION.SchDoc, Connecteur.SchLib, Pannel.PrjPCB, WURTH_8V_femelle_3.5mm_691363110008.stp, WURTH_8V_male_3.5mm_691321100008.stp, WURTH_8V_male_3.5mm_coude_691322110008.stp]
2014-10-08 Puissance 2014->2015 - Borniers a vis moteurs -> embase + femelle - Diametres percages LMD18200T : 40->50 mils - Vis -> Entretoises Wurths
    IHM
    - diametre percages switchs chinois : 40 -> 50 mils
    ALIM HITEC
    - ajout résistances de TRIM en cas de besoin
    - diametres de percages
    FdP
    - transil sur 5V (pour protéger... environ 10A tirés à 7V...)
    - 5V perm sur connecteurs UARTS
    - led 5V perm (pour bien voir qu'il y a du jus, même sans module bluetooth)
    - pads RFU sur prop...
    - sérigraphie++
    [2014_CARTE_PUISSANCE.PCBDOC, 2014_CARTE_PUISSANCE.PRJPCB, 2014_CARTE_PUISSANCE.SchDoc, 2015_ALIM_HITEC.PcbDoc, 2015_ALIM_HITEC.SchDoc, 2015_FDP_ACTIONNEUR.SchDoc, 2015_FDP_PROPULSION.SchDoc, 2015_FDP_SCHEMA.SchDoc]
2014-10-09 Connecteur HE10 balise
    [2015_CONNECTEUR_BALISE.PcbDoc, 2015_CONNECTEUR_BALISE.PrjPcb, 2015_CONNECTEUR_BALISE.SchDoc]
2014-10-09 Plans masse + seriegraphie
    [2015_CONNECTEUR_BALISE.PcbDoc, 2015_CONNECTEUR_BALISE.SchDoc]
2014-10-09 Rajout vias
    [2015_CONNECTEUR_BALISE.PcbDoc, 2015_CONNECTEUR_BALISE.PrjPcb]
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2014-10-10 Seriegraphie + diamétre perçage
    [2015_AdaptateurBluetooth.PcbDoc]
2014-10-10 Seriagraphie + diamétres percage
    [2015_CONNECTEUR_BALISE.PcbDoc]
2014-10-10 Nettoyage Actionneur & QS Correction verbose stratégie Sauvegarde de l'ancien code actionneur
    [Arm.c, Arm.h, Global_config.h, Small_arm_config.h, act_avoidance.c, act_avoidance.h, act_can.c, act_functions.c]
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2014-10-11 Correction de l'initialisation de la couleur en stratégie (Pas de message de fausse couleur envoyé)
    [button.c, environment.c, environment.h]
2014-10-12 Ajout d'une fonction pour l'utilisation des vitesses custom plus facilement Correction calcul de vitesse évitement
    [avoidance.c, prop_functions.c, prop_functions.h]
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2014-10-12 Ajout liaison I_AM_READY entre les cartes... - liaison PROP PB8 -> STRAT PE8 - liaison ACT PB8 -> STRAT PE9 - liaison IHM PB8 -> STRAT PE10
    + correction keepoutlayer sur IHM.
    [2015_ALIM_HITEC.PrjPcb, 2015_FDP_ACTIONNEUR.SchDoc, 2015_FDP_PROPULSION.SchDoc, 2015_FDP_SCHEMA.SchDoc, 2015_FDP_STRATEGIE.SchDoc, 2015_IHM.PrjPcb, 2015_IHM.SchDoc, pin_usages.xls]
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2014-10-12 Validation PCB. DRC OK. Holes OK. Sérigraphie OK. Suppression empreintes 3D des points de test.
    [2015_CONNECTEUR_BALISE.PcbDoc, 2015_CONNECTEUR_BALISE.PrjPcb]
2014-10-12 Correction de la gestion du timeout sur un trajectoire multipoint Ajout d'une fonction Stack_wait sans auto pull pour ne pas lancer la suite des trajectoires alors qu'elle ne peuvent plus être exécut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
    [avoidance.c]
2014-10-12 Validation PCB. DRC OK. Holes OK. Sérigraphie OK.
    [2015_AdaptateurBluetooth.PcbDoc, 2015_AdaptateurBluetooth.PrjPcb]
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2014-10-12 (carte servo moteur)
    [2015_Rx24Duplicator.SchDoc]
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2014-10-13 Revue de schéma ok. Import PCB. Correction diamètres perçages. Validation empreintes.
    [2015_Rx24Duplicator.PcbDoc, 2015_Rx24Duplicator.SchDoc]
2014-10-13 Correction diamètres perçages.
    [2012_PerfUSB.PcbDoc, 2014_CARTE_PUISSANCE.PCBDOC, 2015_AdaptateurBluetooth.PcbDoc, 2015_CNC.PcbDoc, 2015_Pannel.PcbDoc, 2015_Rx24Duplicator.PcbDoc]
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2014-10-14 Perf Servos. DRC ok Holes ok Sérigraphie ok.
    [2015_PerfServos.PcbDoc, 2015_PerfServos.PrjPCB, 2015_PerfServos.SchDoc]
2014-10-14 Correction empreinte connecteurs 12V et 5V...
    [2015_ALIM_HITEC.PcbDoc, 2015_Pannel.PcbDoc, 2015_PerfServos.PcbDoc, 2015_Rx24Duplicator.PcbDoc]
2014-10-14 Corrections diverses.
    [2015_ALIM_HITEC.PcbDoc, 2015_AX12DUPLICATOR.PcbDoc, 2015_AX12DUPLICATOR.PrjPcb, 2015_AX12DUPLICATOR.SchDoc, 2015_Pannel.PcbDoc, 2015_PerfServos.PcbDoc, 2015_Rx24Duplicator.PcbDoc, 2015_Rx24Duplicator.SchDoc]
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2014-10-16 Seriegraphie + replacement jumpers
    [2015_CNC.PcbDoc]
2014-10-16 Routage terminé.
    [2015_Rx24Duplicator.PcbDoc, 2015_Rx24Duplicator.PrjPcb]
2014-10-16 Ajout sch
    [2015_Rx24Duplicator.SchDoc]
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2014-10-16 Correction sérigraphie FDP.
    [2015_CNC.PcbDoc]
2014-10-16 Sérigraphie Rx24 Duplicator + re-correction du schéma...
    [2015_Rx24Duplicator.PcbDoc, 2015_Rx24Duplicator.SchDoc]
2014-10-16 maj pannel...
    [2015_Pannel.PcbDoc]
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2014-10-16 Servo : Amélioration mais bugue à certain moment quand on le visualise à l'oscilo
    [QS_servo.c]
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2014-10-17 Rajout schema oublié
    [2015_AdaptateurBluetooth.PrjPcb, 2015_AdaptateurBluetooth.SchDoc]
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2014-10-26 Correction piste hors PCB sur Alim Hitec. Edition des PDF pour chaque PCB.
    [2015_ALIM_HITEC.PcbDoc, 2015_AdaptateurBluetooth.PrjPcb, 2015_CNC.PcbDoc]
2014-10-27 Correction warnings + renommage.
    [environment.c]
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2014-11-01 Correction configuration pin
2014-11-02 SD : Protection contre écriture avec tension d'alim trop faible. Verbose : ajout des messages BROADCAST_I_AM_READY / BROADCAST_FDP_READY / BROADCAST_RESET + quelques corrections mineures...
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2014-11-07 Correction synchro stratégie doit être plus longue
    [main.c]
2014-11-13 Correction temporaire de QS_AX12 avec l'ancienne configuration des ports
    [config_pin.h]
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2014-11-18 Correction terminal + ajout de commentaire
2014-11-18 QS_AX12, fonctionne avec les set et reset de pin
    [config_pin.h]
2014-11-18 Actionneur : renomage + correction pin avec BIG_ROBOT
    [config_pin.h, config_use.h]
2014-11-25 QS_servo : petite correction a l'init
    [QS_servo.c]
2014-11-25 QS_servo : les vitesses fonctionnent, ajout de vitesse supplèmentaire Correction pin des ax12 collect et drop, sinon on retrouve l'assert de l'ax12 > 50
    [QS_servo.c, QS_servo.h, config_pin.h]
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2014-11-28 Prop : Quelque modification configurations Correction d'inibition de TIMER Supression de quelque débug printf
    [_Propulsion_config.h, config_use.h, detection.c, secretary.c]
2014-11-28 Correction include + projet.
    [motor.c]
2014-11-28 Correction code balise overflow reception TSOP
    [brain.c]
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2014-12-01 correction position hokuyo par rapport au robot (ajout d'offset) Ajout du filtrage des points pour l'année 2014
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2014-12-04 Correction compilation scan_cup - oubli commit QS - oubli commit #ifdef
    [secretary.c]
2014-12-04 Correction fonction changement d'ID dans la QS_AX12
2014-12-05 Correction pathfind sélection node le plus proche avec prise en compte de la direction final
    [Pathfind.c]
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2014-12-05 Correction de l'arrêt des timers pour le secretary il arretait les mauvais timer Idem warner Correction de l'envoi de message de position adversaire à la stratégie envoyé depuis la simu
    [secretary.c, warner.c]
2014-12-05 Correction bug d'affichage du rectangle d'évitemment en propulsion
    [avoidance.c]
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2014-12-08 IHM : ajout la gestion du bouton RESET_LCD et ajout dans le code prop et strat la recption des msg CAN de l'IHM
    [config_pin.h, environment.c, secretary.c]
2014-12-09 IHM : correction à droite, à gauche
    [main.c]
2014-12-10 move on hardware google spreadsheet
    [pin_usages.xls]
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2014-12-10 Mauvaise manip de commit + fin correction LCD
    [main.c]
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2014-12-13 correction led warning
2014-12-18 correction I2C notée..
    [2015_BeaconEye.SchDoc]
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2014-12-18 Nettoyage + correction d'une trajectoire pathfind disgracieuse
    [Pathfind.c]
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2014-12-27 Ajout de remarques et notes liées au cablage 2015.
    [2015_FDP_SCHEMA.SchDoc, 2015_FDP_STRATEGIE.SchDoc, 2015_IHM.SchDoc]
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2015-01-09 Retour en arrière... la correction ne me semble pas être la bonne... En l'état on a un flood de broadcast_position_robot... mais il faut le résoudre autrement.
2015-01-09 Petite correction de la fonction corrector Ajout du pullUp pour le switchAsser dans le cas d'un FDP non entièrement soudé Correction define actionneur
    [corrector.c, main.c]
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2015-01-12 Ajout Id machine à état middle feet gathering Déwarnage Correction code non compilable sans define VERBOSE_MODE
    [state_machine_helper.h]
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2015-01-16 Correction longueur des marches geogebra
2015-01-16 Correction emplacement point, réaffichage point pour les objets
2015-01-17 Correction du define VERBOSE_MODE qui faisait planté la code stratégie s'il était désactivé
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2015-01-23 3000 !!!!!!!!!!!!
    Correction du nombre de queue actionneur qui n'étais pas suffisant
    [queue.h]
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2015-01-28 Correction verbosité machine à état
    [state_machine_helper.c, state_machine_helper.h]
2015-01-29 Complétion IHM bouton pour que l'écran réagisse au long_push Ajout de la tracabilité en printf du buzzer_Play Correction flood I2C écran Ajout d'affichage d'erreur pour fonction RTC terminal Optimisa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
    [button.c, prop_functions.c]
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2015-01-30 Correction switch asser Supression printf inutile Correction verbose
    [environment.c]
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2015-02-16 Correction : PAS DE MODIFICATION DE QS POUR UN CAS PARTICULIER ! La QS est partagée avec toutes les cartes ! Supression vieux define
    [config_use.h]
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2015-02-20 Correction de la perte de données hokuyo
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2015-02-21 Modification du paramètre de la queue pour le rendre signé pour gérer facilement un moteur DCM qui peut avoir une destination négative... Correction de printf... ^^
    [queue.h]
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2015-02-22 Complétion du selftest Correction d'un define par défaut... Correction d'un warning
    [config_use.h]
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2015-02-25 Supression pince devant, correction ordre msg CAN act...
    [act_can.c, act_functions.c, act_functions.h, clock.c]
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2015-02-26 Ajout de la PWM "5" pour la gestion de la pompe gauche ELLE N'EST ACTIVE QUAND DESACTIVANT LE DEFINE FDP_2014 !
    Ne pas désactiver ce define sur un FDP 2014 au risque de cramer des ports
    + Quelque correction d'inclusions dans le code...
    [clock.c, config_pin.h, config_use.h]
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2015-03-04 Correction placement capteur recallage + Ajout capteur laser estrade en stratégie Correction / Complétion selftest Correction / Complétion test temps réel capteur via IHM
    [config_pin.h, config_use.h, main.c, secretary.c]
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2015-03-10 Correction erreur de compilation
    [config_pin.h]
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2015-03-26 Correction ID servo-moteur
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2015-03-27 Correction du soucis de la biroute qui déclenche le match dès l'alim... -> (intelligence biroute dans l'IHM)
2015-03-27 Correction du soucis de la biroute qui déclenche le match dès l'alim... -> (intelligence biroute dans l'IHM) + Amélioration verbose messages IHM.
2015-03-27 Pour fonctionnement correct de la détection de biroute forgotten
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2015-03-29 Code final de la balise !
    [Linearisation.xlsx]
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2015-04-01 Correction de warning
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2015-04-04 correction théorique des coefs d'holly (odométrie seulement pour l'instant)
    [_Propulsion_config.h]
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2015-04-10 Correction selftest temps réel des capteurs
    [config_pin.h, main.c]
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2015-04-13 Correction QS_DCMotor2 Ajout position carpet pour chargement Correction fonction pour mettre le torque
    [QS_DCMotor2.c, QS_DCMotor2.h]
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2015-04-13 Ajout verbosité message can IHM Correcion enum act_function Correction compile
    [act_functions.h, config_use.h]
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2015-04-14 Modification du couple maximum des servo qui bloquent Ignorage de l'erreur -> désactivation de fallback Correction initialisation ascenseseur Correction selftest Correction position carpet
    [act_can.c, config_pin.h, queue.c]
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2015-04-14 Ajout de define pur la gestion de alarm shutdown alarm led et limitation tension Correction warning
    [main.c]
2015-04-14 Bug servo wood corrigé
2015-04-14 Correction selftest Correction position ascensseur
    [queue.c]
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2015-04-14 Correction couple servo tapis
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2015-04-15 Correction MAE Correction évitement actionneur
    [act_avoidance.c, act_functions.c, state_machine_helper.h]
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2015-04-16 Petit buzzer en fin de match
    [brain.c]
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2015-04-18 Correction de l'offset de la balise du gros robot
    [config_use.h, detection.c]
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2015-04-19 correction limitation en négatif
    [motors.c]
2015-04-22 PWM : correction pour le principe et la beauté du geste. Aucun impact sur le code balise. RF : ajout (sur DSPIC) de la PWM du moteur de la balise dans le message de demande de synchro...
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2015-04-28 LED verte pilotée en IT au rythme de la synchro quand elle existe. Correction filtre duty..
    [Global_config.h, motor.c]
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2015-04-28 Correction hokuyo en simu
    [detection.c]
2015-04-29 Maj limite pwm prop Ajout limitation pwm actionneur moteur Correction position actionneur
    [QS_DCMotor2.c, motors.c]
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2015-05-04 Rotation à la fin de la calibration -> gestion par la strat... + possibilité de demander une absence d'acquittement lors d'une demande d'ordre en prop. + correction d'un bogue : un déplacement en REL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
    [brain.c, elements.c, elements.h, environment.c, main.c, secretary.c, secretary.h, sequences.c]
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2015-05-07 Correction DCM desactivable Ajout d'un large epsilon pour détecter un blocage proche de la prosition (cf ascenseur spot) Correction position / asser des RX24 et tout les codes DCM
    [QS_DCMotor2.c, QS_DCMotor2.h]
2015-05-09 Le define INVERSE_BIG_ROBOT concernant l'inversion des angles sur la balise IR n'était pas traité correctement... L'angle était modifié APRES le calcul du x/y !!! -> STRAT : mauvaises décisions sur u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
    D'où d'éventuels soucis de réflexions de notre propre hokuyo vers la balise dans l'angle vivant ?????
    Je pense l'avoir corrigé, mais j'ai pas de quoi tester.
    _________
    J'ai également fait la correction de l'angle de l'hokuyo....
    (l'angl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
    [config_use.h, detection.c]
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2015-05-11 Ajout de l'actionneru clap sur Wood Ajout des switch compatible IHM 2015 pour wood Correction pin du gpio surr wood
    [config_pin.h, main.c]
2015-05-11 Meilleur lisibilité du code et correction priorité des opérations dans le scan gobelet
    [elements.c, secretary.c]
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2015-05-12 Correction actionneur clap Wood Correction selftest Correction test temps réel capteurs
    [config_pin.h, main.c]
2015-05-12 Accélération Wood 48->80 ! Attention, en cas de revert, il faut mettre à jour également les vitesses pour avoir des multiples de l'accélération.
    [_Propulsion_config.h]
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2015-05-13 Ajout d'une position pour la prise du gobelet avec l'actionneur clap de wood Correction selftest temps réel des capteurs
    [act_functions.h, main.c]
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2015-05-14 Correction réinitialisation de l'intégrateur actionneur
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2015-05-14 Correction code actionneur pincemi et stock Correction du bouton d'activation des spot/pincemi
    [main.c]
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2015-05-15 CORRECTION QUI CASSE LES COUILLLLLES !
    [environment.c]
2015-05-15 Correction MAE spotix pour la prise d'un seul côté
    [act_functions.c]
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2015-05-17 Mise en commentaire de la détection de bug hokuyo qui flood le bus CAN
2015-05-19 evitement correction des bugs, balise inversé et hokuyo désactivé
    [detection.c]
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2015-05-22 Les corrections à deux balles de la coupe d'europe : asservissement du clap...
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2015-05-23 tentative de correction du driver hokuyo...... avec ou sans effet de bord... tel est le grand mystère !!
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2015-05-23 Correction d'urgence ! Désactivation de la désactivation du couple en cas d'une mise en position trop longue
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2015-05-26 premières réflexions sur la carte balise 2016...
    [2016_BeaconIR_YahourtPhone.PRJPCB, 2016_BeaconIR_YahourtPhone.SchDoc, WURTH_DB25_femelle_618025231121.stp, WURTH_DB25_male_618025231221.stp, WURTH_LED_side_view_WL-SMSW_1204.stp]
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2015-05-31 placement leds
    [2016_BeaconIR_YahourtPhone.SchDoc]
2015-06-02 début de routage...
    [2016_BeaconIR_YahourtPhone.SchDoc]
2015-06-04 DRC 100% OK !
    [2016_BeaconIR_YahourtPhone.SchDoc]
2015-06-04 maj design balise réceptrice.
    [TSOP.STEP]
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2015-06-13 Amélioration de l'agencement des types d'environement Correction de warning !!
    [act_can.h, act_functions.c, detection.c, detection.h, elements.c, environment.h]
2015-06-14 Correction compilation actionneur pour le SMALL
    [config_pin.h]
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2015-06-15 et voilà
    [Antenne_433MHz.STEP, Caps.STEP, WURTH_entretoises_cms_10mm_9774100360.stp]
2015-06-17 BeaconAdv -> Placement en cours....
    [2016_AdvBeacon.PRJPCB, 2016_AdvBeacon.SchDoc, Pack 7.2V - 800mAh.STEP]
2015-06-18 AdvBeacon : placement++ Librairie : ajout 3D du Radiocrafts_433MHz
    [2016_AdvBeacon.SchDoc, Radiocrafts_433MHz.STEP]
2015-06-18 Puissance 2016 TODO
    [2016_CARTE_PUISSANCE.PCBDOC, 2016_CARTE_PUISSANCE.PRJPCB, 2016_CARTE_PUISSANCE.SchDoc]
2015-06-19 Oups mauvaise manip !
    [2016_CARTE_PUISSANCE.PCBDOC, 2016_CARTE_PUISSANCE.PRJPCB, 2016_CARTE_PUISSANCE.SchDoc]
2015-06-19 FdP : ajout d'un port par carte pour reconnaissance du slot. AdvBeacon : maj placement...
    [2016_AdvBeacon.SchDoc, 2016_FDP.PrjPcb, 2016_FDP_ACTIONNEUR.SchDoc, 2016_FDP_PROPULSION.SchDoc, 2016_FDP_SCHEMA.SchDoc, 2016_FDP_STRATEGIE.SchDoc]
2015-06-20 possibilité de piloter le XBee à partir de la strat (au choix, en soudant 3 gouttes)
    [2016_BeaconIR_YahourtPhone.SchDoc]
2015-06-20 Correction fonction message CAN Ajout du numéro du match et de la date dans le broadcast_start
    [brain.c]
2015-06-21 Routage (DRC 100%) Sérigraphie à terminer, plans à mettre
    [2016_AdvBeacon.PCBDOC]
2015-06-21 ménage
    [2016_CARTE_PUISSANCEtemp.PCBDOC, 2016_CARTE_PUISSANCEtemp.PRJPCB, 2016_CARTE_PUISSANCEtemp.SchDoc]
2015-06-22 quelques déplacements de pistes. + ajout de quelques vias.
    [2016_AdvBeacon.PCBDOC]
2015-06-22 corrections schéma
    [2016_CARTE_PUISSANCE.PCBDOC, 2016_CARTE_PUISSANCE.SchDoc]
2015-06-23 trous moteurs + vias GND + plans de masse OK. DRC 100%.
    [2016_AdvBeacon.PCBDOC, 2016_AdvBeacon.SchDoc]
2015-06-23 correction position moteur
    [2016_AdvBeacon.PCBDOC]
2015-06-26 Correction I2C.
    [2016_BeaconEye.PrjPcb, 2016_BeaconEye.SchDoc]
2015-06-26 Connecteur balllauncher renommé. 1 connecteur RX + AX sur le TOP inversion positions cod1, cod2, mot12, mot34 broche carré pour le GND de l'USB en prop. (attention, ce n'est toujours pas relié au GND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
    [2016_FDP_ACTIONNEUR.SchDoc]
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2015-07-07 corrections global.flags au lieu de global
    [debug.c]
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2015-07-09 Correction flag uart... non testé.
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2015-07-30 Correction erreur de commentaire QS_rf
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2015-07-30 Suppression de vieille modélisation non utile de la balise
    [11plaque2mm.SLDPRT, 1plaque7mm.SLDPRT, 2plaque2mm.SLDPRT, 4plaque2mm.SLDPRT, 5plaque2mm.SLDPRT, 7tasseau - Copie.SLDPRT, 7tasseau.SLDPRT, 8plaque2mm.SLDPRT]
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2015-08-06 Correction des ifdef de Astar.h Ajout d'un USE_ASTAR
    [astar.h, config_use.h]
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2015-08-06 Correction compilation ajout bouton suspend_resume_match..... (Vive eclipse qui ne voit pas les erreurs...)
    [button.c, main.c]
2015-08-06 Fin de correction...
2015-08-07 Routage + MAJ schéma
    [2016_CARTE_PUISSANCE.PCBDOC, 2016_CARTE_PUISSANCE.PRJPCB, 2016_CARTE_PUISSANCE.SchDoc]
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2015-08-11 Correction d'une erreur d'un commit ancien...
    [act_functions.c]
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2015-08-18 empreinte du support de pile WURTH sur le FDP_2016.
    [2016_FDP_STRATEGIE.SchDoc]
2015-08-18 résistance LED IR -> 500 Ohm.
    [2016_AdvBeacon.PCBDOC, 2016_AdvBeacon.SchDoc]
2015-08-18 Quelques petites modifs Correction de quelques fautes d'orthographe qui crèvent les yeux Verbose du WARN_DISTANCE
    [queue.h]
2015-08-22 Ajout pad pour entretoise Wurth
    [2016_CARTE_PUISSANCE.PCBDOC, 2016_CARTE_PUISSANCE.SchDoc]
2015-08-23 Quelques retouches effectuées : - arrondi la taille de la carte en mm - placé quelques dimensions utiles - arrangé les choses pour que les 4 entretoises passent (déplacement de quelques composants + 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
    [2016_CARTE_PUISSANCE.PCBDOC]
2015-08-24 sérigraphies Beacon réceptrice et émettrice
    [2016_AdvBeacon.PCBDOC]
2015-09-05 Correction d'une erreur de commit je pense...
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2015-09-18 Bug actionneur résolu. Activation des pins UART pour AX_12 et RX_24
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2015-09-21 Modifications suite aux bugs survenu - actionneur: le bug était du à un mauvais stockage dans la queue. Maintenant l'identifiant est correct est ca marche - propulsion : TIMEOUT sur PROP_GO_ANGLE: pr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
    [act_can.c, act_functions.c, secretary.c]
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2015-10-18 FDP 2016 - replacement des vis pour compatibilité avec support 2015 sur le petit robot.
    [2016_FDP_ACTIONNEUR.SchDoc, 2016_FDP_SCHEMA.SchDoc]
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2015-10-19 Deux ports de plus sur le connecteur CARTE MOSFET... pour piloter jusqu'à 8 MOS (si une nouvelle carte remplace la carte BallLauucher...)
    [2016_FDP_ACTIONNEUR.SchDoc, 2016_FDP_SCHEMA.SchDoc]
2015-10-22 Schématisation Matrice à LED + début placement composants (manque l'empreinte de la résistance CMS: 10k 1206)
    [2016_CARTE_MATRICE_LED.PcbDoc, 2016_CARTE_MATRICE_LED.PrjPCB, 2016_CARTE_MATRICE_LED.SchDoc]
2015-10-28 modifications: condos, changement de projet (reprise BeaconLED), rajout de l'empreinte de la résistance 10k CMS. (je n'arrive pas à modifier la taille de la carte pour placer les composants sur le PC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
    [2016_Matrice_LED.PcbDoc, 2016_Matrice_LED.PrjPcb, 2016_Matrice_LED.SchDoc]
2015-10-28 Création dossier pour la réalisation Carte MOSFET
    [2016_Carte_Mosfet.PCBDOC, 2016_Carte_Mosfet.PRJPCB, 2016_Carte_Mosfet.SchDoc]
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2015-10-29 Placement des composants sur le PCB (écart broches matrice : 25,4mm +/- 0,15mm
    [2016_Carte_Mosfet.SchDoc, 2016_Matrice_LED.PcbDoc]
2015-10-30 routage PCB: test N°2
    [2016_Matrice_LED.PcbDoc]
2015-10-30 routage PCB: test N°2 : modif
    [2016_Matrice_LED.PcbDoc]
2015-10-30 Empreinte capa
    [2016_Matrice_LED.SchDoc]
2015-10-30 pcbdoc et schdoc dans le projet
    [2016_Carte_Mosfet.PRJPCB]
2015-11-04 Ajout de Diode Shottky double STPS60L30CW
    [_ROBOT.SchLib]
2015-11-04 quelques corrections diverses. ajout de deux entretoises pour la fixation. dimensions de la carte "rondes" en mm. (carré de 33mm)
    [2016_Matrice_LED.PcbDoc, 2016_Matrice_LED.SchDoc]
2015-11-04 correction dimensions...
    [2016_Matrice_LED.PcbDoc]
2015-11-04 Ajout du "Transistor MOSFET-N AUIRF1018ES"
    [_ROBOT.SchLib]
2015-11-04 Equation du gyroscope et affichage de la temperature sur docklight, ne pas oublier de de-commenter USE_GYROSCOPE dans config use
    Aussi, quelques corrections sur le code de la detection de choc (valentin)
    [detection_choc.c, gyroscope.c, it.c, odometry.c]
2015-11-07 SchDoc: modification: placement bornier/liaison PcbDoc: modification: carte, placement des composants, pistes, ajout emplacement entretoises(4,4mm),plan de masse sur GND(à vérifier)
    [2016_Carte_Batteries.PcbDoc, 2016_Carte_Batteries.SchDoc]
2015-11-09 ajout composant PM8834
    [_ROBOT.SchLib]
2015-11-09 Modification configuration plan de masse
    [2016_Carte_Batteries.PcbDoc]
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2015-11-12 Ajout d'un second connecteur pour carte 8 MOSFET sur la carte stratégie.
    [2016_FDP_ACTIONNEUR.SchDoc, 2016_FDP_SCHEMA.SchDoc, 2016_FDP_STRATEGIE.SchDoc]
2015-11-12 Coucou !
    J'ai effectué les modifications relatives aux points suivants:
    - 4 entretoises Wurth.
    - les borniers au pas de 7.62mm, modèle "coudé".
    Par contre je suis pas totalement sûr d'avoir choisi les bons modèles,
    j'ai fait des copier-collés de l'IHM...
    [2016_Carte_Batteries.PcbDoc, 2016_Carte_Batteries.SchDoc]
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2015-11-16 Connecteur bornier coudé femelle horizontal
    [Connecteur.SchLib]
2015-11-16 Revue carte batterie :
    J'ai réduis un peu la taille de la carte. (et arrondi au mm)
    (j'ai hésité à réduire plus en plaçant les entretoises sous les connecteurs... mais je préfère conserver de la souplesse.. et avoir la possibilité de fixer la carte avec des vis par le dessus...)
    Elle est encore assez grande... mais tant mieux pour la dissipation...
    Les entretoises n'étaient pas dans le schéma (tout composant ajouté directement au routage disparait lors de la synchro avec le schéma).
    Vu les courant en jeu, j'ai plutôt relié les potentiels par des gros plans.
    Pour les contraintes thermiques, un plan sur le TOP de 24V_IHM, avec un peu de vergni-épargne placé sous les diodes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
    [2016_Carte_Batteries.PcbDoc, 2016_Carte_Batteries.SchDoc]
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2015-11-17 ajout de vias, ajout sérigraphie
    [2016_Matrice_LED.PcbDoc]
2015-11-18 schématisation carte MOSFET(manque les signaux sur les entrées PWM)
    [2016_CARTE_MOFSET.PCBDOC, 2016_CARTE_MOFSET.PRJPCB, 2016_CARTE_MOFSET.SchDoc]
2015-11-18 corrections mineures sur le schéma : - Ajout connecteur FdP - Net 5V à la place de VCC (nom de net en doublons) - Ajout connecteur 24V
    [2016_CARTE_MOFSET.SchDoc]
2015-11-19 ajout des LEDs, borniers 3=>2, nom des composants changés
    [2016_CARTE_MOFSET.SchDoc]
2015-11-19 carte 4 mosfet
    [2016_CARTE_4_MOFSET.PCBDOC, 2016_CARTE_4_MOFSET.PRJPCB, 2016_CARTE_4_MOFSET.SchDoc, 2016_CARTE_MOFSET.SchDoc]
2015-11-19 supression dossier
    [2016_Carte_Mosfet.PCBDOC, 2016_Carte_Mosfet.PRJPCB, 2016_Carte_Mosfet.SchDoc]
2015-11-19 modification, ajout LED
    [2016_CARTE_MOFSET.SchDoc]
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2015-11-20 Coucou !
    Voici la carte batterie, avec une partie du routage de fait (j'ai pas encore routé le GND)
    Il restera sans doute des choses à faire...
    [2016_CARTE_4_MOFSET.PCBDOC, 2016_CARTE_4_MOFSET.SchDoc, 2016_CARTE_MOFSET.SchDoc]
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2015-11-26 Coucou !
    Voici la carte 4 MOSFET, qui n'est pas encore terminée mais bien avancée...
    Par contre, j'ai bien galéré avec la couche signal et le 24 V, ça s'est terminé avec des vias partout, et des zigzags bien dégeu T_T.
    D'ailleurs, j'ai peut-être été un peu bourrin sur le diamètre des pistes...
    Il reste encore le 5V à faire, en plus de deux-trois trucs...
    Bonne soirée :).
    [2016_CARTE_4_MOFSET.PCBDOC]
2015-11-27 Mise à jour carte 4 mosfets.
    [2016_CARTE_4_MOFSET.PCBDOC]
2015-11-27 Fichier ASTAR présentant les polygones
    [PolygonesASTAR.xlsx]
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2015-12-03 La carte 4 MOSFET avec la sérigraphie...
    [2016_CARTE_4_MOFSET.PCBDOC]
2015-12-03 en cours..
    [2016_CARTE_MOFSET.PCBDOC]
2015-12-05 Coucou !
    Voici la carte 4 MOSFET avec la sérigraphie mise à jour,
    les textes sont agrandis et la couleur des LEDs est indiquée.
    J'avais effectivement vu la légende utilisée au club, notamment sur la carte IHM,
    mais je me suis dit que vu le peu de composants qu'on utilise sur la 4 MOSFET,
    on pouvait tout caser sans recourir à une légende...
    Mais si y a besoin, je l'utiliserai ^^.
    D'ailleurs grâce à la fonctionnalité "Find similar objects", ça serait facile,
    même pour les LEDs, vu qu'Altium peut utiliser quelques expressions régulières,
    j'ai testé avec Find similar objects: Text with String="D*": same, et ça a marché !
    Pratique pour le fainéant que je suis...
    Sinon c'est tou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
    [2016_CARTE_4_MOFSET.PCBDOC]
2015-12-06 Nouveau placement de composants, carte rétrécit
    [2016_CARTE_MOFSET.PCBDOC]
2015-12-06 Placement de vias.
    [2016_CARTE_MOFSET.PCBDOC]
2015-12-07 à vérifier: il y'a un petit soucis au niveau du routage (quand je clique sur "design rule check", ça m'affiche une erreur. Pourtant j'ai bien vérifié les liaisons..
    [2016_CARTE_MOFSET.PCBDOC]
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2015-12-10 - via -> passer les trous à 20 mils au lieu de 28 (pour faire comme sur les autres cartes) : OK
    - grossir la piste de 24V et la passer en couche 2, notamment en passant à gauche du connecteur FdP pour monter vers les connecteurs du haut... et fournir le 24 "en peigne" pour chaque connecteur : OK
    - grossis les pistes entre les connecteurs des pompes et les drain des MOSFET (100mils mini...) : OK
    - sur le bottom, un PAD peut être placé.... aux mêmes dimensions que les pads TOP des drains des MOSFET. : OK
    j'ai toujours une petite erreur quand je fais rule check, je ne vois pas l'erreur ..?
    [2016_CARTE_MOFSET.PCBDOC]
2015-12-10 Erreur enlevée.
    [2016_CARTE_MOFSET.PCBDOC]
2015-12-12 schématisation : ok placement composants : ok routage : ok Sérigraphie : ok
    Est ce que je rajoute des vias pour la dissipation (un peu partout sur la carte ?)
    [2016_CARTE_MOFSET.PCBDOC]
2015-12-16 revue carte mosfet. DRC OK Serigraphie OK
    [2016_CARTE_MOFSET.PCBDOC]
2015-12-17 Correction synchro schéma.
    [2016_CARTE_MOFSET.PCBDOC]
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2016-01-07 déplacement sérigraphie pour pas déborder. réduction d'un pad pour pas gêner l'antenne avec de la feraille (trou à perçer manuellement ensuite en explosant le petit pad)
    [2016_AdvBeacon.PCBDOC]
2016-01-07 Premier test pour la pannel'
    [2015_Pannel.PcbDoc]
2016-01-07 Version avec normes (7mm pour le contour et environ 2mm d'écart entre les cartes)
    [2015_Pannel.PcbDoc]
2016-01-08 2015_Pannel -> 2016_Pannel...
    [2015_Pannel.PcbDoc, Pannel.PrjPCB]
2016-01-08 Pannel correction diverses.
    [2015_Pannel.PcbDoc, 2016_AdvBeacon.PCBDOC, 2016_CARTE_PUISSANCE.PCBDOC, 2016_Pannel.PcbDoc, Pannel.PrjPCB]
2016-01-08 Correction suite à PCB_Visualizer (Eurocircuit)
    [2016_CARTE_MOFSET.PCBDOC, 2016_CARTE_PUISSANCE.PCBDOC]
2016-01-08 modification sérigraphie
    [2016_Matrice_LED.PcbDoc]
2016-01-09 DRC 100% Sérig 100% Hole OK Gerber vérifiés avec PCB Visualizer (Eurocircuits)
    [2016_AdvBeacon.PCBDOC, 2016_AdvBeacon.PRJPCB, 2016_AdvBeacon.SchDoc, 2016_BeaconIR_YahourtPhone.PRJPCB, 2016_CARTE_4_MOFSET.PCBDOC, 2016_CARTE_4_MOFSET.PRJPCB, 2016_CARTE_4_MOFSET.SchDoc, 2016_CARTE_MOFSET.PCBDOC]
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2016-01-26 PDF hard..
    [2016_FDP_SCHEMA.SchDoc]
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2016-02-03 Mise à jour polygones ASTAR
    [PolygonesASTAR.xlsx]
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2016-02-04 Ajout capteur Correction machine à état mosfets
    [act_can.c, config_use.h, main.c]
2016-02-04 Correction erreur de commit
    [main.c]
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2016-02-19 Notation d'une erreur hard ! (potentiellement grave... corrigée sur la carte batterie en question)
    [2016_Carte_Batteries.SchDoc]
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2016-03-09 correction scan en it
    [it.c]
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2016-03-20 Correction du problème de rotation de la propulsion (problème résolu de la manière la moins violente, une réécriture du copilot sera fait après coupe, plus proprement)
    [copilot.c]
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2016-03-25 Modification des boutons + test du check_act_status => ok (ca marche sans qu'on ait rien eu besoin de faire) Parasol en position ouverte au départ du match pour le protéger car sinon il va prendre ch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
    [Recap_ports_mosfets.xlsx]
2016-03-26 Correction d'un bug de compilation en Actionneur Correction lié au démarrage sécurisé des cartes sur les FDP 2016 (total fonctionnel)
    [main.c]
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2016-04-07 Petite correction de sécurité d'une macro en QS
2016-04-13 Bug actionneur : on laisse les printf... pourquoi ca marche comme ca, on sait pas....
2016-04-14 Mise en commentaire de USE_DCMOTOR2 à l'origine du bug actionneur.
    [QS_DCMotor2.c, config_use.h]
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2016-04-22 correction try_go_angle... pour qu'il réagisse bien en cas d'erreur prop.
    [avoidance.c]
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2016-04-24 Correction de la position de l'adversaire pour l'IR
    [detection.c]
2016-04-25 Correction problème AX12 / RX24 (écriture aléatoire dans la mémoire au démarrage ou lors des broadcast AX12/RX24)
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2016-04-28 Petite correction de commentaire
2016-04-28 suj: création fichier cnc 2016
    [2016_CNC_v2.PcbDoc, 2016_CNC_v2.PrjPcb, 2016_CNC_v2.SchDoc]
2016-04-28 dossier => fichiers sch; pcb
    [2016_CNC_v2.SchDoc]
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2016-04-29 Poissons Pearl Correction bug de commit
2016-04-29 Correction LED_ERROR de l'IHM
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2016-05-01 (tanguy) CNC 2016 taille trous, ref/sleep
    [2016_CNC_v2.PcbDoc, 2016_CNC_v2.PrjPcb, 2016_CNC_v2.SchDoc]
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2016-05-05 Correction d'un Uint8 en enum (inutile mais faut que ça soit propre)
    [act_functions.c, act_functions.h]
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2016-05-12 (tanguy) carte CNC 2016: 24v pour ventilateur trous pour moteurs capa découplage 36V 1 potar pour chaque moteur
    [2016_CNC_v2.PcbDoc, 2016_CNC_v2.SchDoc, Circuit intégré.SchLib]
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2016-05-17 Ajout d'un excel avec les courbes retiré des données de Corentin si jamais ça peut servir à quelqu'un
    [rush complet.xlsx]
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2016-05-21 Correction CAN verbose Augmentation de la taille du coefficient accélération et vitesse
    [prop_functions.c, prop_functions.h]
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2016-05-21 Correction des unitées et mise à jours des valeurs maximal de vitesse Déplacement de la taille du buffer dans config_use
    [_Propulsion_config.h, config_use.h]
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2016-05-21 Correction copilot / pilot / corrector
    [copilot.c, copilot.h, corrector.c, pilot.c, pilot.h]
2016-05-21 Modification de l'évittement pour la nouvelle propulsion (évitement fixer avec une accélération de 160 et 228 pendant le rush)
    [avoidance.c, pilot.c]
2016-05-22 Ajout d'un excel bien sympahique pour savoir ce qu'on fait avec les accélérations / vitesses en propulsion Suppression matlab useless
    [Convertisseur d'unité de propulsion.xlsx]
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2016-05-25 correction de l'angle aveugle de l'hokuyo pour ne pas détecter de faux robots (support alu / angle mort capteur ?) + un peu de ménage.. (et il reste de la poussière !) PS : il est dégeu ce code hokuy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
2016-05-26 Correction rush in the wall
    [sequences.c]
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2016-05-29 Ajout d'un fichier pour faire la courbe d'accélération du rush
    [Courbe accélération rush.xlsx]
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2016-05-31 Correction freinage évitement rush et freinage évitement big / small
    [_Propulsion_config.h, avoidance.c, pilot.c]
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2016-06-01 voilà une courbe qui se rapproche un peu plus de ce que je pensais
    [Courbe accélération rush.xlsx]
2016-06-01 startup_stm32f40xx.S était dans la librairie de base, recompilation de la librarie sans le startup_stm32f40xx.S et correction du CMake de la stratégie pour compilé l'assembleur (les autres projets co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
2016-06-02 Log en carte SD des assert de la librairie Correction pour toujours bien afficher les assert de notre code s'il se produise en IT
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2016-06-04 Correction erreur de return Déwarnage des projets
    [copilot.c, it.c, main.c]
2016-06-07 Correction check color début de match
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2016-06-08 Correction temps avant supervision de la batterie
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2016-06-08 Correction propulsion gros robot
    [motors.c]
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2016-06-10 Correction bug d'évitement................... ><
    [avoidance.c]
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2016-06-10 Correction mauvais fonctionnement du coefficient intégrateur pendant la prise de la dune
    [corrector.c]
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2016-06-11 Correction de l'erreur d'affichage d'angle de détection pour beacon IR
    [detection.c]
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2016-06-11 Correction limitation de vitesse
    [_Propulsion_config.h]
2016-06-12 Correction du coeff odometry translation
    [_Propulsion_config.h]
2016-06-13 Correction remplissage tableau de lecture de tension batterie
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2016-06-17 corrections schéma CNC V2. Chantier en cours pour le placement...
    [2016_CNC_v2.PcbDoc, 2016_CNC_v2.SchDoc]
2016-06-17 CNC V2 _ placement...
    [2016_CNC_v2.PcbDoc, 2016_CNC_v2.SchDoc]
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2016-06-28 HAL : Corrections de quelques fautes
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2016-07-17 rajout du correcteur centrifuge avec les bonnes unités
    [odometry.c]
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2016-09-12 IHM 2017 First step
    [2017_IHM.PrjPcb, 2017_IHM.SchDoc]
2016-09-12 IHM 2017 - 2.4 TFT step
    [2.4_TFT_TOUCH.STEP]
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2016-09-14 Ajout de QS_DAC et QS_SSI (si jamais un jour ^^)
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2016-09-14 Relecture QS_HAL et correction de quelques erreurs
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2016-09-19 IHM 2017... - Ecran 2.4 Tactile - 4 boutons retirés sous l'écran - UART3 Strat reliable à l'UART3 de l'IHM (gouttes !)
    [2017_IHM.SchDoc, _ROBOT.SchLib]
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2016-09-22 Correction de la fusion IHM_POWER et BROADCAST_ALIM
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2016-09-27 Modif du A* (mise au propre du fichier, tests, correction de bug)
    [astar.c]
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2016-10-02 Correction bug de ralentissement lorsqu'on choisie de ne pas éviter d'adversaire
    [avoidance.h, copilot.c]
2016-10-03 Rename de fichier avoidance -> movement et foe_analyser -> avoidance
    [act_avoidance.h, act_can.h, astar.h, avoidance.c, avoidance.h, brain.c, button.h, elements.h]
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2016-10-03 Nettoyage du projet Propulsion Changement de la led color Correction mineure dans QS_mosfet suite aux changements d'Arnaud Nettoyage du XBEE et de ELEMENTS en stratégie
    [act_functions.c, config_use.h, elements.c, elements.h, environment.c, it.c, main.c]
2016-10-03 Petite correction sur la led color
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2016-10-12 Correction d'asservissement actionneur en fonction du BROADCAST_ALIM
    [main.c]
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2016-10-28 Correction commentaire dans odométrie Correction erreur condition copilot Correction erreur buffer
    [buffer.c, copilot.c, odometry.c]
2016-10-28 (Tanguy) Correction cartes MOSFET et 4 MOSFET Modifications CNC Librairie: correction boutons push IHM, Driver Mosfet
    [2016_CNC_v2.PcbDoc, 2016_CNC_v2.SchDoc, 2017_CARTE_4_MOFSET.PCBDOC, 2017_CARTE_4_MOFSET.PRJPCB, 2017_CARTE_4_MOFSET.SchDoc, 2017_CARTE_MOFSET.PCBDOC, 2017_CARTE_MOFSET.PRJPCB, 2017_CARTE_MOFSET.SchDoc]
2016-10-28 (Tanguy) Ajout Carte 8 MOSFET avec mesure de courant
    [2017_CARTE_MOFSET.PCBDOC, 2017_CARTE_MOFSET.PRJPCB, 2017_CARTE_MOFSET.SchDoc]
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2016-11-07 correction erreur pilot de la propulsion
    [pilot.c]
2016-11-08 Correction d'un bug d'odométrie en simulation (bug invisible ne vous inquiétez pas... ^^)
    [odometry.c]
2016-11-09 Résilution d'un bug sur le SPI1 (Je crois que j'ai trouvé ton bug de matrice à led Corentin)
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2016-11-09 Astar résolution d'un bug de hardline Nécéssité de rajouter + OBSTACLE_MARGIN aux dimensions des polygones pour que ca marche bien
    [astar.c]
2016-11-09 Correction DMA SPI Ajout affichage d'image avec transparence Modification affichage d'image normale
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2016-11-13 Test du module scan (scan.c et scan.h) maintenant opérationnel Définition des objets dans Qs_objects Modif du astar: en cas de fail du pathfind, on réagit différent ie on bouge un peu mais plus jusqu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
    [astar.c, brain.c]
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2016-11-14 Bug SPI1 : il y a eu un oubli de définition des pins => J'ai mis les pins par défaut mais attention le hard n'est pas toujours défini en fonction
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2016-11-17 guillaume, correction point pathfind
    [astar.c]
2016-11-20 Routage carte Mosfet 2017 avec micro
    [2017_CARTE_MOFSET.PCBDOC, 2017_CARTE_MOFSET.SchDoc]
2016-11-22 Carte 8 Mosfet avec mesure de courant sans erreurs
    [2017_CARTE_MOFSET.PCBDOC, 2017_CARTE_MOFSET.SchDoc]
2016-11-23 écran TFT en 3V !!!
    [2017_IHM.SchDoc]
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2016-11-25 Carte MOSFET avec mesure de courant -> ajout de connecteurs pour capteurs Modélisation step AX12Duplicator
    [2015_AX12DUPLICATOR.step, 2017_CARTE_MOFSET.PCBDOC, 2017_CARTE_MOFSET.PRJPCB, 2017_CARTE_MOFSET.SchDoc]
2016-11-25 Entretoises sur BOT
    [2015_AX12DUPLICATOR.PcbDoc, 2015_AX12DUPLICATOR.step]
2016-11-27 FDP 2017 carte prop : ajout du mosfet pour éteindre les capteurs dans le schématique mais j'ai un pb avec l'importation dans le PCB
    [2017_FDP.PrjPcb, 2017_FDP_ACTIONNEUR.SchDoc, 2017_FDP_PROPULSION.SchDoc, 2017_FDP_SCHEMA.SchDoc, 2017_FDP_STRATEGIE.SchDoc]
2016-11-27 Carte Rush -> Dimensions du condo à vérifier
    [2017_Carte_RUSH.PcbDoc, 2017_Carte_RUSH.PrjPcb, 2017_Carte_RUSH.SchDoc]
2016-11-27 Idée de pannel -> 2 IHM et 1 FDP ça passe pas!!! Corrections de petites erreurs sur CNC
    [2016_CNC_v2.PcbDoc, 2017_Pannel.PcbDoc, Pannel.PrjPCB]
2016-11-29 correction lien fichiers 2017. R pull up Import PCBdoc
    [2017_FDP.PrjPcb, 2017_FDP_PROPULSION.SchDoc, 2017_FDP_SCHEMA.SchDoc]
2016-11-29 - Ajout de cartes LED_Beacon - On attend une réponse d'All Circuits pour la taille du PCB... mais il faut sans doute viser 1 grand panneau plutôt que 2 petits
    [2017_Pannel.PcbDoc]
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2016-11-30 PLacement du mosfet
    [2017_FDP.PrjPcb, 2017_FDP_PROPULSION.SchDoc, 2017_FDP_SCHEMA.SchDoc]
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2016-12-07 (Tanguy) Step plaque dessus big
    [Dessus Gros Robot.STEP]
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2016-12-09 Carte RUSH correction d'erreurs et changement condensateur
    [2017_Carte_RUSH.PcbDoc, 2017_Carte_RUSH.SchDoc]
2016-12-09 HIM 2017: - Changement des BP - Ajout du connecteur pour LEDs sur schématique (il y pas l'empreinte dans la librairie connecteurs)
    [2017_IHM.PrjPcb, 2017_IHM.SchDoc, Dessus Gros Robot.STEP]
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2016-12-11 Ajout de la gestion de l'environnement Ajout du buzzer
    [config_use.h, environment.c, environment.h, it.c, main.c]
2016-12-13 IHM: changement des empreintes des BP Ajout du connecteur carte Check up led
    création carte CHECK UP LED
    [2017_CHECK UP LED.PcbDoc, 2017_CHECK UP LED.PrjPcb, 2017_CHECK UP LED.SchDoc, 2017_CHECK UP LED.step, 2017_IHM.SchDoc, 2017_Pannel.PcbDoc]
2016-12-15 CHECK UP LED: mise a jour des dimensions
    [2017_CHECK UP LED.PcbDoc, 2017_CHECK UP LED.step]
2016-12-19 Revue routage générale.
    [2017_CARTE_MOFSET.PCBDOC, 2017_CHECK UP LED.PcbDoc, 2017_Carte_RUSH.PcbDoc, 2017_Carte_RUSH.SchDoc, 2017_Pannel.PcbDoc]
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2017-01-04 Correction du commit de corentin qui aime tout cassé :p
    [config_use.h, debug.c]
2017-01-04 Ajout (enfin) nouvelle QS_I2C Correction de warning générale
    [avoidance.c]
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2017-01-05 Corrections strat inutile et modifs actionneurs
    wata
    [cylinder_elevator_left_config.h, cylinder_slider_left_config.h]
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2017-01-06 Desactivation temporaire de la CCMRAM en attente de correction du bug du checksum
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2017-01-06 Ajout de la gestion du sens de rotation dans la Propulsion, testé et fonctionnel Correction d'une erreur dans le copilot
    [copilot.c, secretary.c]
2017-01-10 Ajout du pont en H (VNH5180A-E) dans la librairie
    [Circuit intégré.SchLib, PontEnH_VNH5180A-E.STEP]
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2017-01-12 correction du delais d'affichage des logs... xD
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2017-01-12 Carte puissance: schema a verifier (PCB non termine)
    [2017_CARTE_PUISSANCE.PCBDOC, 2017_CARTE_PUISSANCE.PRJPCB, 2017_CARTE_PUISSANCE.SchDoc]
2017-01-12 Modifs Carte CNC -> schema à verifier (vérifications des empreintes pas faite)
    [2016_CNC_v2.PcbDoc, 2016_CNC_v2.SchDoc]
2017-01-12 CARTES: MOSFET, CHECK UP LED, RUCH: modifs serigraphie, empreintes condo ...
    [2017_CARTE_MOFSET.PCBDOC, 2017_CARTE_MOFSET.PRJPCB, 2017_CARTE_MOFSET.SchDoc, 2017_CHECK UP LED.PcbDoc, 2017_CHECK UP LED.PrjPcb, 2017_CHECK UP LED.SchDoc, 2017_Carte_RUSH.PcbDoc, 2017_Carte_RUSH.PrjPcb]
2017-01-12 MAJ libraires -> traco tsrn 1-24120 -> pont en H: vnh5180A-E
    [Circuit intégré.SchLib, IPC.PcbLib, _ROBOT.SchLib]
2017-01-13 Carte Puissance PCB termine !! :)
    [2017_CARTE_PUISSANCE.PCBDOC, 2017_CARTE_PUISSANCE.SchDoc]
2017-01-13 Modif empreinte TSRN-1-24120
    [2015_CNC.PcbDoc, 2016_CNC_v2.PcbDoc, 2016_CNC_v2.SchDoc]
2017-01-17 Correction d'une erreur de commit
    [config_use.h]
2017-01-17 Ajout d'un warning pour montrer un bug probable
    [astar.c]
2017-01-17 Correction supervision de tension balise émetrice Ajout de la gestion buzzer / UART de la balise émetrice
    [config_pin.h, main.c]
2017-01-17 Correction d'un problème d'overflow sur le ASTAR => passage des 2 variables de distance en 32 bits
    [astar.c]
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2017-01-18 Corrections carte Puissance 2017 Mise a jour du pannel Correction routage carte 4 mosfet Mise a jour sérigraphie sur cartes (2017)
    [2012_PerfUSB.PcbDoc, 2016_CNC_v2.PcbDoc, 2017_CARTE_4_MOFSET.PCBDOC, 2017_CARTE_PUISSANCE.PCBDOC, 2017_CARTE_PUISSANCE.SchDoc, 2017_Carte_RUSH.PcbDoc, 2017_Carte_RUSH.SchDoc, 2017_FDP.PrjPcb]
2017-01-19 (Tanguy) Pannel
    [2016_CNC_v2.PcbDoc, 2017_CARTE_MOFSET.PCBDOC, 2017_CARTE_MOFSET.PRJPCB, 2017_CARTE_MOFSET.SchDoc, 2017_CARTE_PUISSANCE.PCBDOC, 2017_CARTE_PUISSANCE.PRJPCB, 2017_CHECK UP LED.PcbDoc, 2017_FDP.PrjPcb]
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2017-01-19 MAJ empreinte traco 12V TSR-1-24120
    [2016_CNC_v2.PcbDoc]
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2017-01-30 Correction asservissement balise émettrice
    [motor.c]
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2017-01-30 Correction fonction buzzer / uart et test
    [main.c]
2017-01-30 Ajout de la gestion de l'évitement serré à la demande avec des fonctions dans avoidance
    [avoidance.c, secretary.c]
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2017-02-01 maillard guillaume correction sub prise minerais et ajout de "i_am_in_square" sans COLOR_Y
    [generic_functions.c, generic_functions.h]
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2017-02-03 code qui bug le tableau de laser_right[index].ADCvalue est instable
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2017-02-09 Correction du bug de non détection de timeout
    [prop_functions.c]
2017-02-09 Correction rotation infinie du try go angle
    [copilot.c]
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2017-02-13 Quelques corrections de warnings et erreurs
2017-02-13 Réarmonisation et correction de bugs dans éléments.c et sur les flags de QS_types
    [elements.c, elements.h]
2017-02-14 Correction de la QS it externe
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2017-02-14 Ajout du module terminal pour afficher du texte en mode terminal sur l'écran tactile Affichage de la nouvelle couleur dans le terminal Correction de la couleur (inversion TOP et BOT)
    [environment.c, main.c]
2017-02-14 Mise à jour du buzzer
    [environment.c]
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2017-02-15 Finition de la QS_ads1118 Correction QS_SPI
2017-02-15 Correction de merde xD
2017-02-15 Ajout de plusieurs flags dans la strat Relecture de code : ajout de #warning (attention il y a une boucle récursive infinie Ajout de define pour le capteur couleur Résolution du bug de boucle infinie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
    [config_use.h]
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2017-02-17 Correction partielle de l'affichage des adv sur l'écran
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2017-02-17 Correction de la QS_XBEE V2
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2017-02-17 Correction de l'affichage des adv sur le LCD
    [button.c, hokuyo_config.h]
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2017-02-19 Correction QS_DCMotorSpeed et Position
    [QS_DCMotor2.c, QS_DCMotorSpeed.c, QS_DCMotorSpeed.h]
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2017-02-21 Ajout des logs d'ID de trajectoire pour un meilleur débug Correction de problème de compilation
    [act_functions.c]
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2017-02-22 Avancement sur les zones, l'envoi vers les robot est désactivé pour le moment (testé pour chaque couleur et pour les zones fixes)
    [environment.c, main.c]
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2017-02-24 version qui déclenche le heap and stack collision
    [config_use.h]
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2017-02-25 Correction de warnings
2017-02-25 Subactions de prise des modules unicouleur nord et sud (codé et testé) Correction de quelques warnings
    [QS_stateMachineHelper.h, elements.c]
2017-02-27 avancée du scan bordure
    correction du bug heap and stack collision (%f)
    correction d'un effet de bord de la saturation des télémetres
    implémentation d'une nouvelle méthode de calcul pour les bordures sud et nord (je viens de me rendre compte que c'était vraiment inévitable)
    [config_use.h]
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2017-03-03 Grosse avancée sur le scan (j'en suis à proposer une correction)
    code le plus affreux que je n'ai jamais commit, c'est un carnage. HELP ME.
    [it.c, it.h, main.c]
2017-03-04 mise à jour code de scan rectification des premiers bug trouvés suite à des tests (mais ça ne fonctionne pas plus pour autant)
2017-03-04 scan suite j'ai trouvé un bug (il m'avait bien fait chier alors qu'il est assez bête :) )
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2017-03-07 mise à jour du scan
    correction d'erreurs du à un manque de précision (passage en double)
    correction de problèmes obscurs sur une division
    affichage de la bonne valeur après utilisation de atan4096
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2017-03-13 sauvegarde d'un code de scan buggué
    [main.c]
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2017-03-14 mise à jour scan (je continue de me tirer des balles notamment dans le pied) passage du Sint16 au Sint32 pour les positions des points moyennés correction d'un bug sur une protection (en obsolescence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
    [main.c]
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2017-03-16 Ajout SPI_setCPHA à QS_SPI Ajout d'une vérification de configuration automatique du capteur ads 1118 Correction QS_ads1118 Ajout du scan via capteur ADS 1118 pour le laser droite à la demande
    [config_pin.h, config_use.h]
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2017-03-21 Correction capteur ADC Correction warning scan
    [main.c, secretary.c]
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2017-03-22 Correction d'un bug actionneur qui laissant passer les messages CAN en broadcast dans le ActManager Ajout de la sub actionneur de préparation d'un cylindre pour la dépose
    [QS_stateMachineHelper.h]
2017-03-23 Ajout de quelques appels d'act / bug de compil sur dernier commit
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2017-03-23 Correction de quelques warnings
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2017-03-27 Correction de bug pour servomoteur en rotation continue => problème résolu
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2017-04-03 Correction bug prop
2017-04-03 petit bug printf
2017-04-04 maj de Selftest_Actionneur
    ajout pompe id selftest
    correction bug Selftest.c
2017-04-04 Correction port d'utilisation actionnneur
    [motor_roller_foam_config.h, motor_turn_trihole_config.h]
2017-04-05 Correction drivers LCD Correction QS_spi Correction QS_xbee Dewarnage
    [config_use.h, main.c]
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2017-04-05 Correction de l'erreur de stack overflow qui apparaissait en début de match.
    [elements.c]
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2017-04-05 Correction gpio actionneur Correction nombre de capteur de vitesse
    [QS_rpm_sensor.h, config_pin.h, config_use.h]
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2017-04-06 Correction et désactivation HARDFLAG
    [config_use.h, elements.c, elements.h, environment.c]
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2017-04-06 sauvegarde scan utilisation de l'adc externe rectification de nombreux petits bugs
    [config_use.h]
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2017-04-06 Correction code actionneur Changement d'ordre mosfet
    [mosfetBoard.c]
2017-04-06 Ajout d'un temps de dépose des balles + correction stratégie
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2017-04-08 Revert, commit précédent raté
    [brain.c, config_use.h]
2017-04-08 bretagne error case
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2017-04-10 Correction de l'affichage de la distance d'un adv (QT se fait plaisir en mettant au propre les tabulations)
2017-04-10 Correction pin I_AM_READY Correction config pin Avancement LCD
    [config_pin.h, main.c]
2017-04-10 sauvegarde scan
    correction de côté de la roue porteuse pour le passage d'un cratère
    début de création d'actionner (arm, balancer, color, dispose, elevator, slider, slope) sur le petit.
    [config_pin.h]
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2017-04-10 Correction bug actionneur Anne
    [act_avoidance.c, small_cylinder_arm.c, small_cylinder_arm.h, small_cylinder_arm_config.h, small_cylinder_balancer.c, small_cylinder_balancer_config.h, small_cylinder_color.c, small_cylinder_color_config.h]
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2017-04-10 Ajout du selftest actionneur et quelques corrections sur l'évitement actionneur
    [act_avoidance.c, act_avoidance.h]
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2017-04-12 Quelque correction sur la communication uart du LCD
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2017-04-12 Correction des derniers bugs de réentrance et affichage propre (création d'une nouvelle macro CREATE_MAE_ACT
    [QS_stateMachineHelper.h]
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2017-04-12 Correction spam capteur hall Correction PIN moteur Correction QS_DCMotorSpeed
    [main.c, motor_roller_foam_config.h, motor_turn_trihole.c, motor_turn_trihole_config.h]
2017-04-13 correction des get_in minerais + get_in fusées
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2017-04-13 Changement de quelques positions servo Correction d'un bug de sens pour l'asservissement moteur => Il faut désormais régler le PID
    [QS_DCMotorSpeed.c, cylinder_arm_left_config.h, cylinder_arm_right_config.h, motor_roller_foam_config.h, ore_roller_arm_config.h]
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2017-04-16 Résolution problème de timeout des balancer => la durée de timeout est désormais de 3 secondes car le balancer fait de long déplacements Résolution problème de timeout des servos color => l'assservis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
    [cylinder_balancer_left_config.h, cylinder_balancer_right_config.h, small_cylinder_balancer_config.h, small_cylinder_color.c]
2017-04-16 Arret du moteur FOAM ok + correction de quelques fautes d'orthographe
    [main.c, motor_roller_foam.c, motor_turn_trihole.c]
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2017-04-20 Correction compilation Correction interface de l'écran LCD
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2017-04-20 bouton passage de bascule pour Pearl et correction pour prise modules Harry
    [button.c]
2017-04-20 correction nom de position small cylinder slider
    [small_cylinder_slider.c, small_cylinder_slider_config.h]
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2017-04-22 correction position de Anne tentative de calibration Anne correction bascule correction des dimensions de Anne
    [_Propulsion_config.h, sequences.c]
2017-04-22 Correction détection, modifs position actionneurs
    [cylinder_pusher_right_config.h, cylinder_slider_left_config.h, cylinder_slider_right_config.h]
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2017-04-25 Résolution du bug servo en wheel mode
    [cylinder_color_left_config.h]
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2017-04-27 Correction prototypes
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2017-05-02 Correction rushInTheWall avec traj de 4096...
    [sequences.c]
2017-05-02 Ajout fonction reset coef
    [copilot.c, corrector.c, corrector.h, gyroscope.c, gyroscope.h, odometry.c, odometry.h, prop_functions.c]
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2017-05-03 amélioration pour passer la bascule correction du massacre de la belgique sur les mouvement pour aller déposer
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2017-05-03 Correction calibration petit
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2017-05-04 Ajout réglage vitesse rushInTheWall depuis la strat et de l'identifiant de trajectoire Correction strat / prop relative au rushInTheWall
    [copilot.c, prop_functions.c, prop_functions.h, secretary.c, sequences.c, sequences.h]
2017-05-04 correction symetrie et distance à la bordure
    [_Propulsion_config.h]
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2017-05-04 Accélération de prise de fusée Harry (gain de 8 secondes et demi) Relecture sub de prise de fusée Anne Correction des servo qui forcent sur Anne Correction d'un assert actionneur Ajout de positions d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
    [act_functions.c, cylinder_slider_left_config.h, cylinder_slider_right_config.h, main.c, small_cylinder_elevator_config.h, small_cylinder_multifonction_config.h, small_cylinder_slider.c, small_cylinder_slider_config.h]
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2017-05-05 Flush des queues actionneur avant chaque ordre Correction warning
    [act_functions.c, main.c]
2017-05-08 Correction distance hokuyo Activation du LCD de l'IHM via le switch
    [config_use.h, detection.c]
2017-05-09 Supression d'une mauvaise correction
    [act_functions.c]
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2017-05-09 strat de retournement des modules amélioration passage de la bascule correction de position actionneur
    [QS_stateMachineHelper.h, small_ball_front_right_config.h, small_cylinder_slider_config.h]
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2017-05-09 correction de calibration
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2017-05-11 Correction debug prop
2017-05-11 Ajout capteur couleur I2C en stratégie TODO : Faire la fonction de compute des couleurs Correction message CAN taille
    [colorSensor.c, colorSensor.h, config_use.h, main.c]
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2017-05-12 Correction carte mosfet
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2017-05-12 Correction communication carte mosfet
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2017-05-14 Ajout I2C3 à la QS Déplacement capteur couleur en actionneur Ajout du code de compute Correction GPIO TODO : Remonter info par CAN
    [colorSensor.c, colorSensor.h, config_pin.h, config_use.h, main.c]
2017-05-15 Correction bug RTC, on n'a pas la HAL
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2017-05-16 Correction d'un problème de réentrance sur les subactions actionneurs parallèle
2017-05-16 désactivation du pathfind --> ASTAR Ajout de la fonction sub_anne_depose_modules_centre() qui dépose des modules dans les zones centrales. L'ossature des déplacement est testée pour les 6 possibilité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
2017-05-17 Correction compilation Correction sub prise de module sur SMALL
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2017-05-17 Correction du ACT_push_order Réduction des optionnal_data en actionneur à 2
    [act_functions.c]
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2017-05-17 Correction réentrance Ajout vacuostat à un endroit
    [act_functions.c, act_functions.h]
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2017-05-18 corrections mineures...
    tempooraire : déclaration de prise fusée au module element...
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2017-05-18 Harry: correction sur la dépose
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2017-05-20 Début d'ajout du VL53L0X, c'est un première approche mais à finir... Correction capteur couleur I2C
    [QS_vl53l0x.c, config_use.h, main.c, vl53l0x_api_calibration.h, vl53l0x_def.h, vl53l0x_interrupt_threshold_settings.h]
2017-05-21 Réglage retournement de couleur sur Harry Correction des timeout sur GET_CONFIG actionneur Correction de quelques problèmes de réentrance Intégration des vacuostat sur la dépose (non fonctionnel pour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
    [act_functions.c, cylinder_color_left_config.h, elements.c, elements.h, main.c]
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2017-05-21 Quelques corrections de warnings
    [astar.c]
2017-05-22 Correction position du bras de dépose Correction stratégie module
    [small_cylinder_dispose_config.h]
2017-05-22 Correction I_AM_READY propulsion / actionneur Correction I2C de la RTC en stratégie Correction lib écran LCD Correction des menues LCD en strat
    [main.c]
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2017-05-22 Correction de spam IHM LED pendant le match
    [act_functions.c]
2017-05-22 Ajout de la fonction PROP_stayPosition avec modification du correcteur pour la prise de module avec le gros
    [corrector.h, prop_functions.c, prop_functions.h, secretary.c]
2017-05-22 Suppression corrector translation pour la prise module
2017-05-22 Correction verbose pour plus de lisibilité des vacuostats
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2017-05-22 Suppression de code inutile dans la dépose et correction d'une erreur pour changer de zone de dépose
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2017-05-23 Optimisation prise et stockage Correction prise et stockage Correction anti spam mosfet
    [brain.c]
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2017-05-23 switchs 2017
    [switchs2017excel.xlsx]
2017-05-23 Correction dégeu pour la distance de freinage de Anne pour l'évitement balise
    [_Propulsion_config.h, avoidance.c]
2017-05-23 Update switchs 2017
    [switchs2017excel.xlsx]
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2017-05-23 Harry : Correction pour la dépose sans module dominant
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2017-05-23 Correction dépose ajout d'un flag intermédiaire pour l'attente de la chute Correction ID MAE Correction BROADCAST_START Correction timeout pusher
    [cylinder_pusher_left_config.h, cylinder_pusher_right_config.h]
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2017-05-24 Ajout de pin des télémètres laser I2C Correction QS_port Refonte du driver VL53L0X
    [QS_vl53l0x.c, config_pin.h, config_use.h]
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2017-05-24 Correction mode debug des capteurs distances
    [QS_vl53l0x.c]
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2017-05-24 changement police de caractere switch small
    [switchs2017excel.xlsx]
2017-05-24 Correction vacuostat sur la dépose
2017-05-24 ACT_check_position_config_right renvoie END_OK #ifdef ROBOT_VIRTUEL_PARFAIT diverses corrections sur les protections de strats de prises et de déposes.
    [act_functions.c]
2017-05-24 correction de l'extraction pour prendre plus d'angle quand on revient vers l'intérieur.
2017-05-24 modif du mode small avoidance, je préfère qu'on évite un adversaire plus petit plutôt que pas d'adversaire du tout ^^
    [avoidance.c]
2017-05-24 correction sub de prise...
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2017-05-24 Correction affichage message CAN PROP_SET_CORRECTOR Correction gestion d'erreur prise fusée Ajout gestion d'erreur fin de store avec vacuostat
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2017-05-24 Préparation de la couleur en début de dépose Léger recule avant de baisser le pusher Correction get_out depose
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2017-05-24 correction recalage angle après bascule décalage de la prise fusée de 10mm pour mieux centrer la ventouse
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2017-05-25 Ajout d'un define pour l'attente du module qui tombe sur la position de dépose Quelques correction sur les subactions actionneur du petit (et réactivation du if de Samuel)
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2017-05-25 debug->error printf pour SD log !
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2017-05-25 correction sens de poussix
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2017-05-25 Correction des stratégies de réglage odométrie translation / rotation / symétrie Correction coefficient odométrie BIG et SMALL (Grosse modification sur le petit enfin il est bon !)
    [_Propulsion_config.h]
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2017-05-25 Reset mae actionneur en cas de default case
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2017-05-25 Correction message d'erreur inutile pour la gestion d'acquittement actionneur
    [act_can.c]
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2017-05-25 Correction gestion d'acquittement actionneur
    [act_can.c, queue.c, queue.h]
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2017-05-25 correction position elevator small ajout nouvelles position aux boutons
    [main.c, small_cylinder_elevator_config.h]
2017-05-25 Correction spam XBEE dans les logs
    [environment.c]
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2017-05-25 Correction warning & error
    [act_can.c, act_can.h]
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2017-05-25 Correction erreur queue ordre de début de match
    [act_can.c, environment.c, queue.c]
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2017-05-25 Correction de spamage d'ordre si l'actionneur n'acquitte jamais
    [act_can.c, queue.c, queue.h]
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2017-05-26 Correction spam acknowledge en cas de boucle main trop longue
    [act_can.c]
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2017-05-26 Correction retour d'erreur des servos
2017-05-26 ajout gestion capteur correction fin de prise en parrallele
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2017-05-26 astar - correction dodge extraction que si adv proche astar - pas de wait au delà du premier essai dépose : get in from our rocket un poil plus chiadé... j'espère que ca va plus aider que gêner... ma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
    [astar.c]
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2017-05-26 Correction du stockage et de la dépose.
    Wataaaaaaaaaaa
2017-05-26 Correction position actionneur petit
    [small_ball_back_config.h, small_cylinder_arm_config.h, small_cylinder_elevator_config.h, small_magic_arm_config.h]
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2017-05-26 Correction position actionneur big
    [cylinder_arm_left_config.h, cylinder_arm_right_config.h, cylinder_slider_left_config.h]
2017-05-26 Correction acknowledge actuator JESPERE LE DERNIER BORDEL DE MERDE
    [act_can.c, queue.c]
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2017-05-26 Correction copilot Préparation du débug d'évitement de samuel
    [copilot.c]
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2017-05-26 Correction préparation débug samuel
    [copilot.c]
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2017-05-26 Revert speed actionneur Harry
    [cylinder_arm_left_config.h, cylinder_arm_right_config.h, cylinder_elevator_left_config.h, cylinder_elevator_right_config.h, cylinder_slider_left_config.h, cylinder_slider_right_config.h, cylinder_slope_left_config.h]
2017-05-26 Unicolor south même en cas d'erreur pour la fusée Correction gestion d'erreur de la fusée
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2017-05-26 correction a deux balles
    [copilot.c]
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2017-05-26 Correction actuator now en stratégie Correction verbose actuator
    [act_can.c, act_functions.c]
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2017-05-27 Correction du scan on shot pour le small
    [QS_vl53l0x.c, config_pin.h]
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2017-05-27 Correction du décalage de dépose side sur Harry
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2017-05-27 fusée multicolore, corrections de pos. désactivation du scan
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2017-05-27 Ajout d'un décalage suivant le nombre de modules stockés et correction pusher
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2017-05-27 Quelques corrections sur la dépose
2017-05-27 Correction rangement actionneur fin de sub Augmentation du seuil du sensor slider
2017-05-27 Revert de certaines modif pour la prise de fusée
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2017-05-28 A moi le premier commit de la coupe 2018 ! Correction selftest actionneur pour l'annee 2018 (donc c'est meme pas qu'un espace)
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2017-06-01 ménage... correction dernier match ^^
    [config_use.h, main.c]
